v1proxy/RedTower/docs/booklets/README.md

# The assembly booklets

<!-- generated by greenhouse/booklet/make_gallery.py: do not edit -->

Every page of the five assembly booklets, 121 pages in build order. Click a page to read it full size in its booklet's page-by-page view; each booklet's PDF is the one to print.

| | booklet | what it builds | pages |
|---|---|---|---|
| 1 | [Frame Rev A](#1--frame-rev-a) | The cabinet: 4040 extrusion, the trays, the base pan and the drains. | 26 pages, 21 steps |
| 2 | [Gantry Rev E](#2--gantry-rev-e) | The X/Z gantry on the bench, its wiring, then into the cabinet with the arm. | 33 pages, 27 steps |
| 3 | [Enclosure Rev A](#3--enclosure-rev-a) | Polycarbonate panels, the fans and the four doors, on the finished cabinet. | 26 pages, 18 steps |
| 4 | [Harvest Rev B](#4--harvest-rev-b) | Where the cuts go: the dead-leaf tray in the base and the feeder on the right panel. | 18 pages, 11 steps |
| 5 | [Herb Snip Rev A](#5--herb-snip-rev-a) | The arm's printed cut-and-hold tool: print it, build it, put it on the arm. | 18 pages, 12 steps |

## 1 · Frame Rev A

The cabinet: 4040 extrusion, the trays, the base pan and the drains. 26 pages, 21 steps.

[Page by page](frame.md) · [PDF](../../greenhouse/frame/Maag_Frame_Assembly_Instructions_RevA.pdf) · [Guide](../../greenhouse/frame/FRAME_ASSEMBLY.md)

<table>
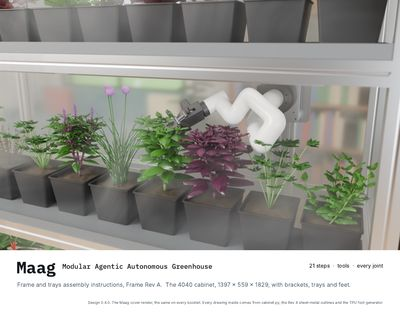
[picture p27: docs/booklets/frame/t01.jpg]
Frame Rev A, page 1: Cover
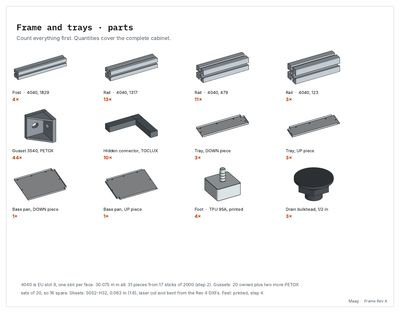
[picture p28: docs/booklets/frame/t02.jpg]
Frame Rev A, page 2: Frame and trays · parts
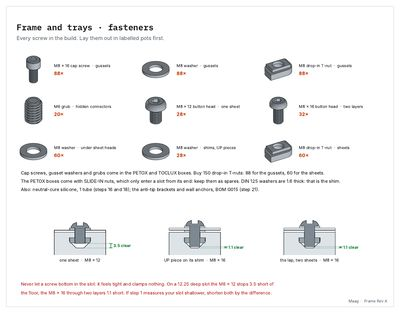
[picture p29: docs/booklets/frame/t03.jpg]
Frame Rev A, page 3: Frame and trays · fasteners
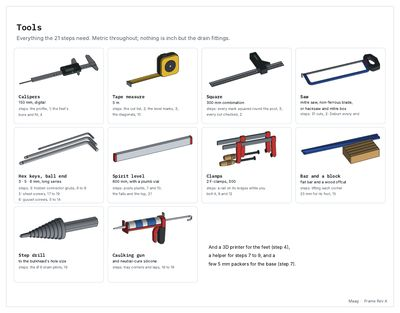
[picture p30: docs/booklets/frame/t04.jpg]
Frame Rev A, page 4: Tools
<tr><td align="center" valign="top"><br><sub>1 · Cover</sub></td><td align="center" valign="top"><br><sub>2 · Frame and trays · parts</sub></td><td align="center" valign="top"><br><sub>3 · Frame and trays · fasteners</sub></td><td align="center" valign="top"><br><sub>4 · Tools</sub></td></tr>
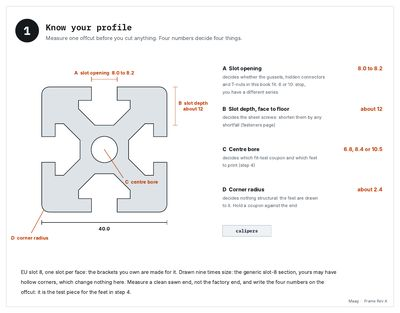
[picture p31: docs/booklets/frame/t06.jpg]
Frame Rev A, page 6: Know your profile
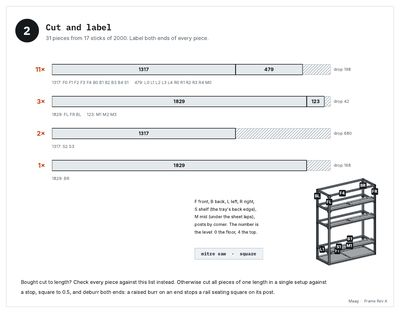
[picture p32: docs/booklets/frame/t07.jpg]
Frame Rev A, page 7: Cut and label
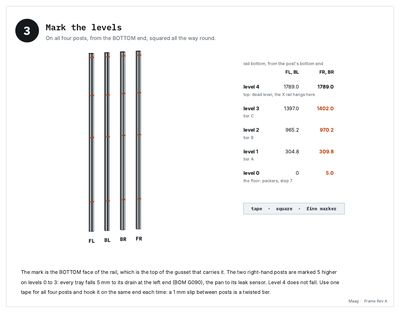
[picture p33: docs/booklets/frame/t08.jpg]
Frame Rev A, page 8: Mark the levels
<tr><td align="center" valign="top"><a href="frame.md#5--every-joint-and-what-holds-it">Frame Rev A, page 5: Every joint, and what holds it</a><br><sub>5 · Every joint, and what holds it</sub></td><td align="center" valign="top"><br><sub>6 · step 1: Know your profile</sub></td><td align="center" valign="top"><br><sub>7 · step 2: Cut and label</sub></td><td align="center" valign="top"><br><sub>8 · step 3: Mark the levels</sub></td></tr>
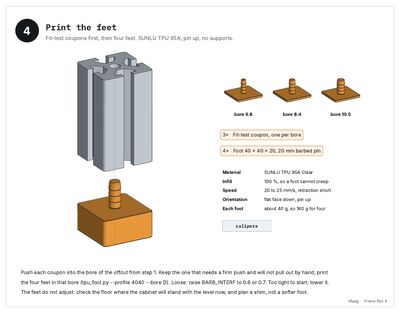
[picture p34: docs/booklets/frame/t09.jpg]
Frame Rev A, page 9: Print the feet
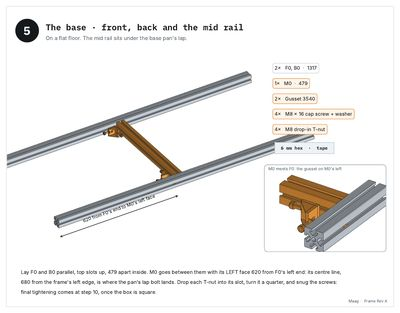
[picture p35: docs/booklets/frame/t10.jpg]
Frame Rev A, page 10: The base · front, back and the mid rail
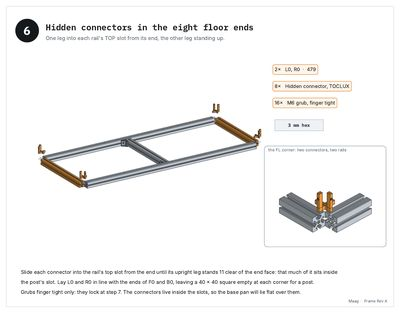
[picture p36: docs/booklets/frame/t11.jpg]
Frame Rev A, page 11: Hidden connectors in the eight floor ends
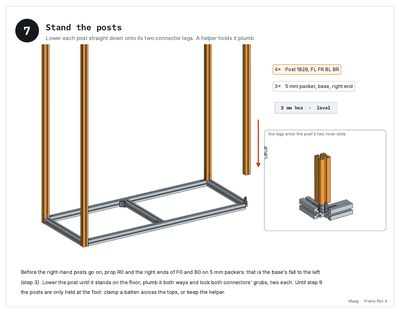
[picture p37: docs/booklets/frame/t12.jpg]
Frame Rev A, page 12: Stand the posts
<tr><td align="center" valign="top"><br><sub>9 · step 4: Print the feet</sub></td><td align="center" valign="top"><br><sub>10 · step 5: The base · front, back and the mid rail</sub></td><td align="center" valign="top"><br><sub>11 · step 6: Hidden connectors in the eight floor ends</sub></td><td align="center" valign="top"><br><sub>12 · step 7: Stand the posts</sub></td></tr>
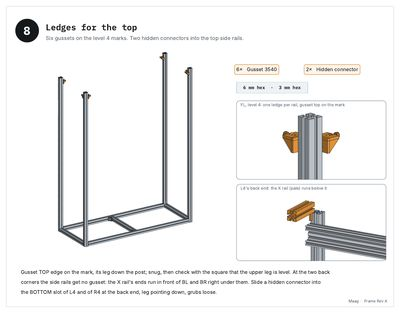
[picture p38: docs/booklets/frame/t13.jpg]
Frame Rev A, page 13: Ledges for the top
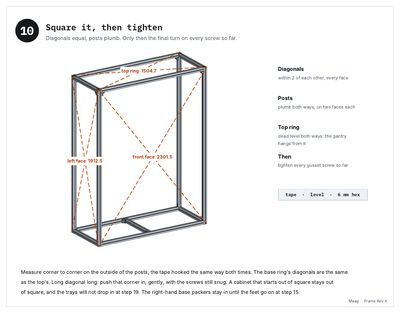
[picture p39: docs/booklets/frame/t15.jpg]
Frame Rev A, page 15: Square it, then tighten
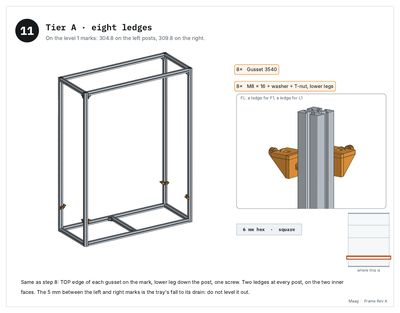
[picture p40: docs/booklets/frame/t16.jpg]
Frame Rev A, page 16: Tier A · eight ledges
<tr><td align="center" valign="top"><br><sub>13 · step 8: Ledges for the top</sub></td><td align="center" valign="top"><a href="frame.md#14--step-9--the-top-ring">Frame Rev A, page 14: The top ring</a><br><sub>14 · step 9: The top ring</sub></td><td align="center" valign="top"><br><sub>15 · step 10: Square it, then tighten</sub></td><td align="center" valign="top"><br><sub>16 · step 11: Tier A · eight ledges</sub></td></tr>
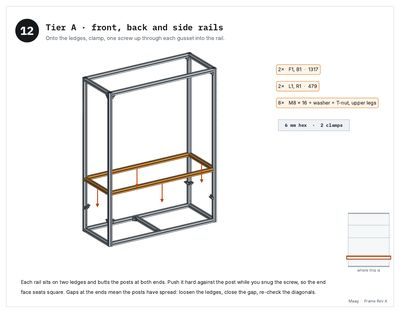
[picture p41: docs/booklets/frame/t17.jpg]
Frame Rev A, page 17: Tier A · front, back and side rails
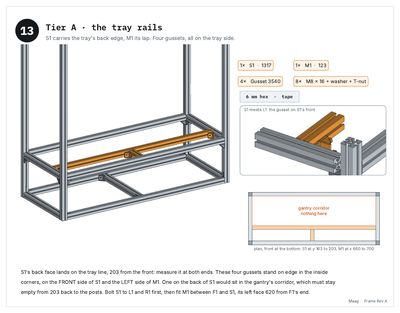
[picture p42: docs/booklets/frame/t18.jpg]
Frame Rev A, page 18: Tier A · the tray rails
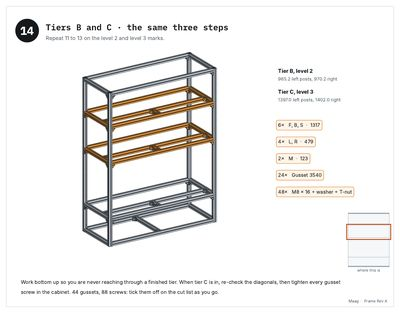
[picture p43: docs/booklets/frame/t19.jpg]
Frame Rev A, page 19: Tiers B and C · the same three steps
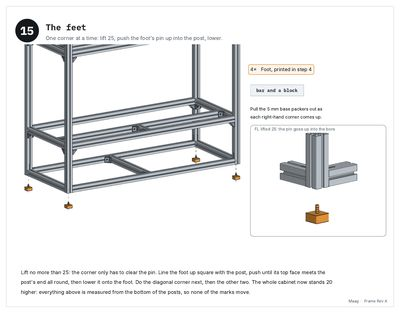
[picture p44: docs/booklets/frame/t20.jpg]
Frame Rev A, page 20: The feet
<tr><td align="center" valign="top"><br><sub>17 · step 12: Tier A · front, back and side rails</sub></td><td align="center" valign="top"><br><sub>18 · step 13: Tier A · the tray rails</sub></td><td align="center" valign="top"><br><sub>19 · step 14: Tiers B and C · the same three steps</sub></td><td align="center" valign="top"><br><sub>20 · step 15: The feet</sub></td></tr>
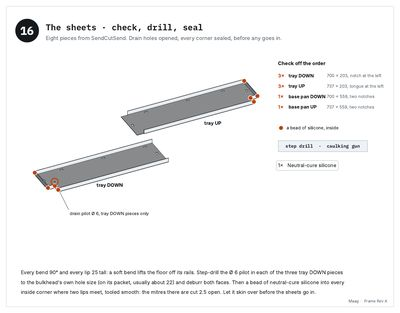
[picture p45: docs/booklets/frame/t21.jpg]
Frame Rev A, page 21: The sheets · check, drill, seal
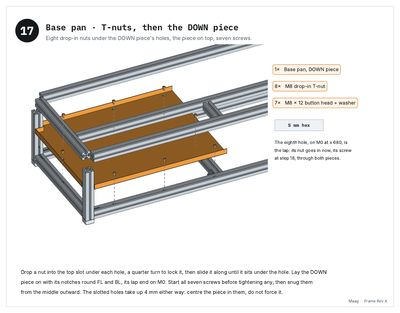
[picture p46: docs/booklets/frame/t22.jpg]
Frame Rev A, page 22: Base pan · T-nuts, then the DOWN piece
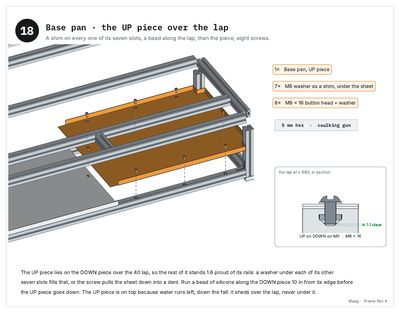
[picture p47: docs/booklets/frame/t23.jpg]
Frame Rev A, page 23: Base pan · the UP piece over the lap
<tr><td align="center" valign="top"><br><sub>21 · step 16: The sheets · check, drill, seal</sub></td><td align="center" valign="top"><br><sub>22 · step 17: Base pan · T-nuts, then the DOWN piece</sub></td><td align="center" valign="top"><br><sub>23 · step 18: Base pan · the UP piece over the lap</sub></td><td align="center" valign="top"><a href="frame.md#24--step-19--trays--the-same-three-times">Frame Rev A, page 24: Trays · the same, three times</a><br><sub>24 · step 19: Trays · the same, three times</sub></td></tr>
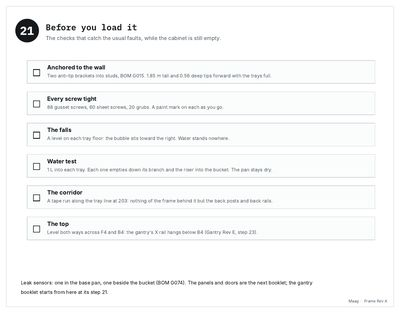
[picture p48: docs/booklets/frame/t26.jpg]
Frame Rev A, page 26: Before you load it
<tr><td align="center" valign="top"><a href="frame.md#25--step-20--drains--one-riser-on-the-fl-post">Frame Rev A, page 25: Drains · one riser on the FL post</a><br><sub>25 · step 20: Drains · one riser on the FL post</sub></td><td align="center" valign="top"><br><sub>26 · step 21: Before you load it</sub></td></tr>
</table>

## 2 · Gantry Rev E

The X/Z gantry on the bench, its wiring, then into the cabinet with the arm. 33 pages, 27 steps.

[Page by page](gantry.md) · [PDF](../../greenhouse/gantry/Gantry_Assembly_Instructions_RevE.pdf) · [Guide](../../greenhouse/gantry/GANTRY_ASSEMBLY.md)

<table>
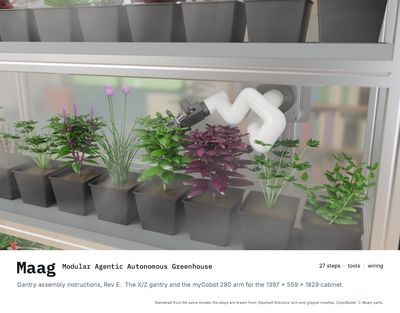
[picture p49: docs/booklets/gantry/t01.jpg]
Gantry Rev E, page 1: Cover
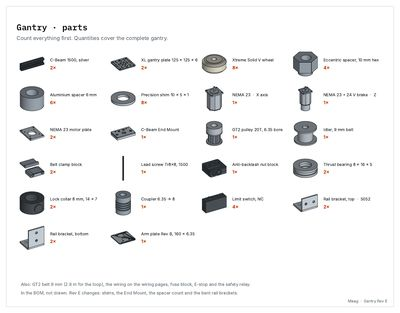
[picture p50: docs/booklets/gantry/t02.jpg]
Gantry Rev E, page 2: Gantry · parts
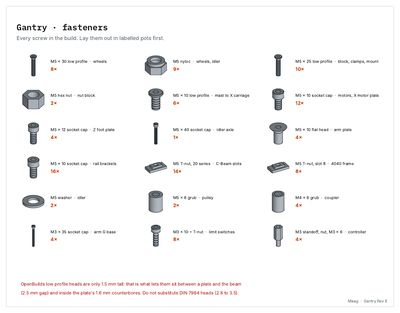
[picture p51: docs/booklets/gantry/t03.jpg]
Gantry Rev E, page 3: Gantry · fasteners
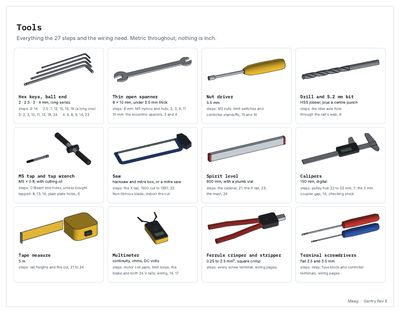
[picture p52: docs/booklets/gantry/t04.jpg]
Gantry Rev E, page 4: Tools
<tr><td align="center" valign="top"><br><sub>1 · Cover</sub></td><td align="center" valign="top"><br><sub>2 · Gantry · parts</sub></td><td align="center" valign="top"><br><sub>3 · Gantry · fasteners</sub></td><td align="center" valign="top"><br><sub>4 · Tools</sub></td></tr>
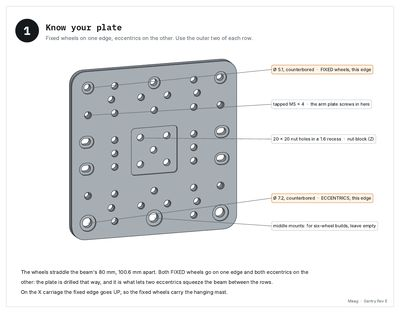
[picture p53: docs/booklets/gantry/t05.jpg]
Gantry Rev E, page 5: Know your plate
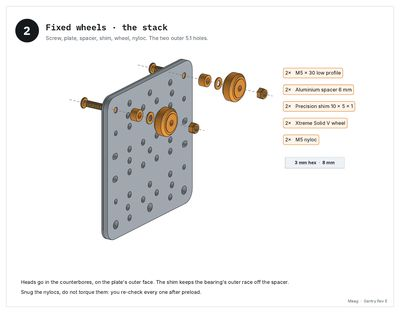
[picture p54: docs/booklets/gantry/t06.jpg]
Gantry Rev E, page 6: Fixed wheels · the stack
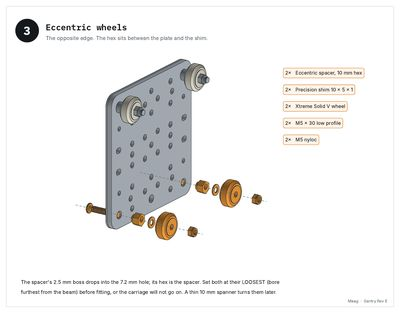
[picture p55: docs/booklets/gantry/t07.jpg]
Gantry Rev E, page 7: Eccentric wheels
<tr><td align="center" valign="top"><br><sub>5 · step 1: Know your plate</sub></td><td align="center" valign="top"><br><sub>6 · step 2: Fixed wheels · the stack</sub></td><td align="center" valign="top"><br><sub>7 · step 3: Eccentric wheels</sub></td><td align="center" valign="top"><a href="gantry.md#8--step-4--onto-the-rail-then-set-the-preload">Gantry Rev E, page 8: Onto the rail, then set the preload</a><br><sub>8 · step 4: Onto the rail, then set the preload</sub></td></tr>
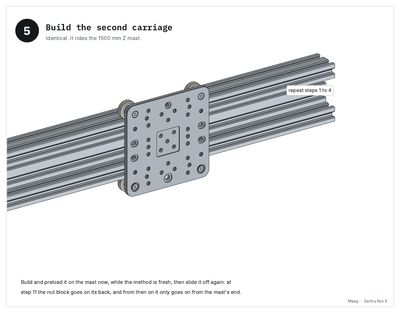
[picture p56: docs/booklets/gantry/t09.jpg]
Gantry Rev E, page 9: Build the second carriage
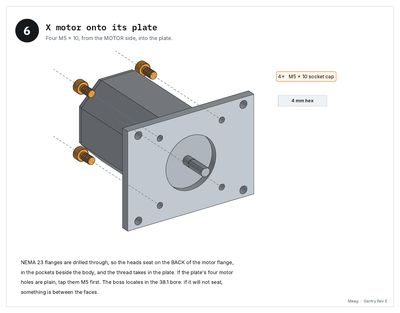
[picture p57: docs/booklets/gantry/t10.jpg]
Gantry Rev E, page 10: X motor onto its plate
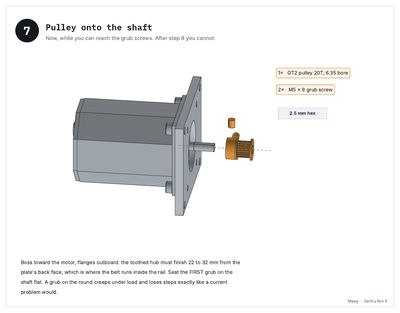
[picture p58: docs/booklets/gantry/t11.jpg]
Gantry Rev E, page 11: Pulley onto the shaft
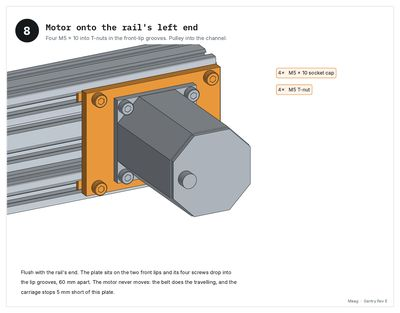
[picture p59: docs/booklets/gantry/t12.jpg]
Gantry Rev E, page 12: Motor onto the rail's left end
<tr><td align="center" valign="top"><br><sub>9 · step 5: Build the second carriage</sub></td><td align="center" valign="top"><br><sub>10 · step 6: X motor onto its plate</sub></td><td align="center" valign="top"><br><sub>11 · step 7: Pulley onto the shaft</sub></td><td align="center" valign="top"><br><sub>12 · step 8: Motor onto the rail's left end</sub></td></tr>
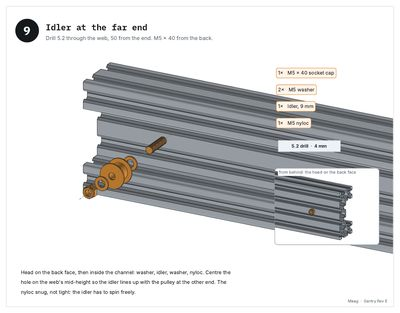
[picture p60: docs/booklets/gantry/t13.jpg]
Gantry Rev E, page 13: Idler at the far end
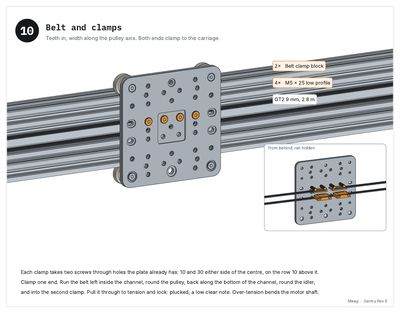
[picture p61: docs/booklets/gantry/t14.jpg]
Gantry Rev E, page 14: Belt and clamps
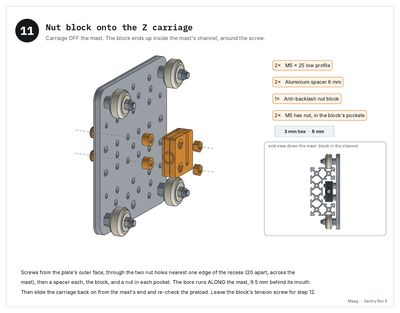
[picture p62: docs/booklets/gantry/t15.jpg]
Gantry Rev E, page 15: Nut block onto the Z carriage
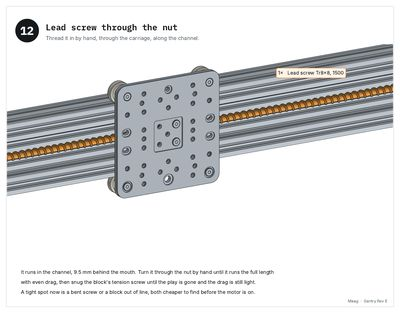
[picture p63: docs/booklets/gantry/t16.jpg]
Gantry Rev E, page 16: Lead screw through the nut
<tr><td align="center" valign="top"><br><sub>13 · step 9: Idler at the far end</sub></td><td align="center" valign="top"><br><sub>14 · step 10: Belt and clamps</sub></td><td align="center" valign="top"><br><sub>15 · step 11: Nut block onto the Z carriage</sub></td><td align="center" valign="top"><br><sub>16 · step 12: Lead screw through the nut</sub></td></tr>
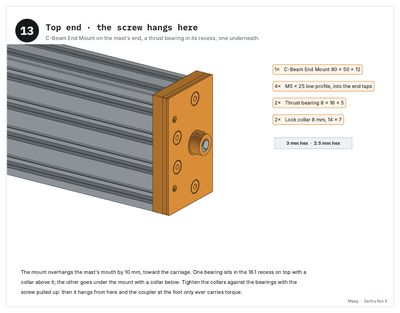
[picture p64: docs/booklets/gantry/t17.jpg]
Gantry Rev E, page 17: Top end · the screw hangs here
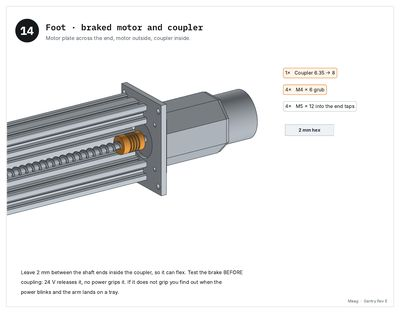
[picture p65: docs/booklets/gantry/t18.jpg]
Gantry Rev E, page 18: Foot · braked motor and coupler
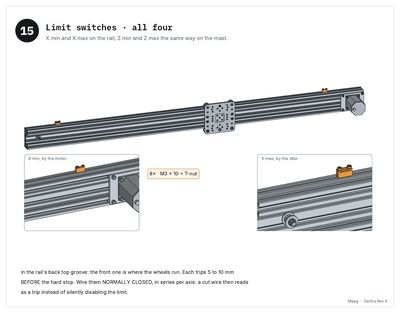
[picture p66: docs/booklets/gantry/t19.jpg]
Gantry Rev E, page 19: Limit switches · all four
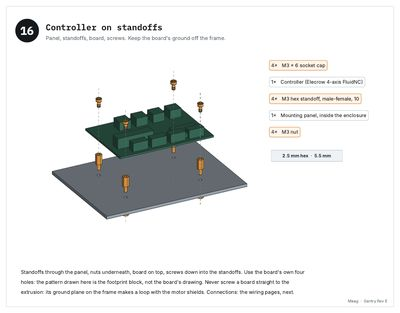
[picture p67: docs/booklets/gantry/t20.jpg]
Gantry Rev E, page 20: Controller on standoffs
<tr><td align="center" valign="top"><br><sub>17 · step 13: Top end · the screw hangs here</sub></td><td align="center" valign="top"><br><sub>18 · step 14: Foot · braked motor and coupler</sub></td><td align="center" valign="top"><br><sub>19 · step 15: Limit switches · all four</sub></td><td align="center" valign="top"><br><sub>20 · step 16: Controller on standoffs</sub></td></tr>
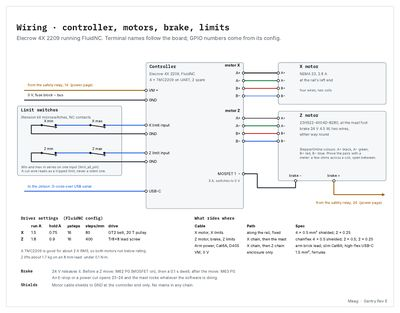
[picture p68: docs/booklets/gantry/t22.jpg]
Gantry Rev E, page 22: Wiring · controller, motors, brake, limits
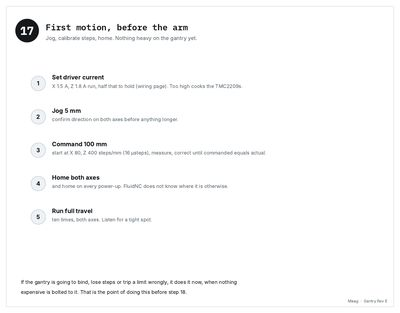
[picture p69: docs/booklets/gantry/t23.jpg]
Gantry Rev E, page 23: First motion, before the arm
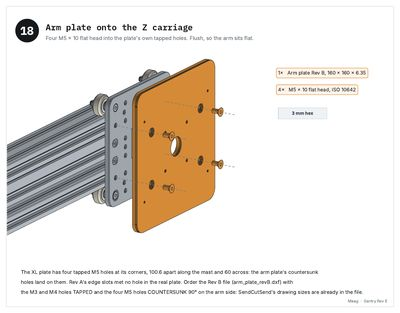
[picture p70: docs/booklets/gantry/t24.jpg]
Gantry Rev E, page 24: Arm plate onto the Z carriage
<tr><td align="center" valign="top"><a href="gantry.md#21--wiring--power-and-the-safety-relay">Gantry Rev E, page 21: Wiring · power and the safety relay</a><br><sub>21 · Wiring · power and the safety relay</sub></td><td align="center" valign="top"><br><sub>22 · Wiring · controller, motors, brake, limits</sub></td><td align="center" valign="top"><br><sub>23 · step 17: First motion, before the arm</sub></td><td align="center" valign="top"><br><sub>24 · step 18: Arm plate onto the Z carriage</sub></td></tr>
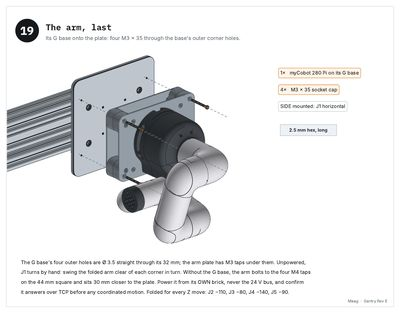
[picture p71: docs/booklets/gantry/t25.jpg]
Gantry Rev E, page 25: The arm, last
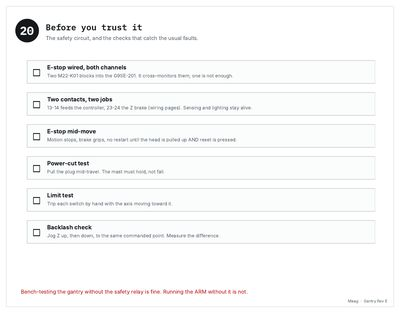
[picture p72: docs/booklets/gantry/t26.jpg]
Gantry Rev E, page 26: Before you trust it
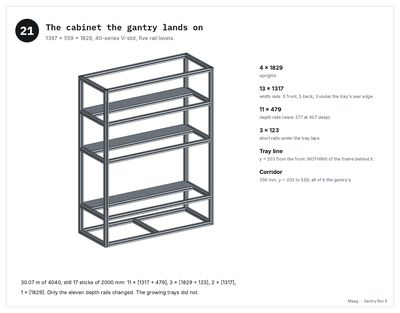
[picture p73: docs/booklets/gantry/t27.jpg]
Gantry Rev E, page 27: The cabinet the gantry lands on
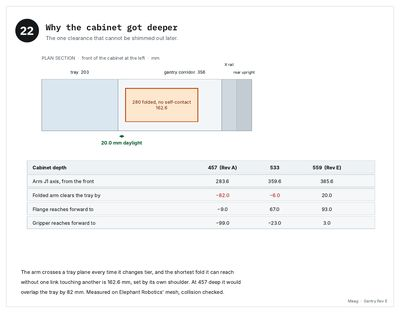
[picture p74: docs/booklets/gantry/t28.jpg]
Gantry Rev E, page 28: Why the cabinet got deeper
<tr><td align="center" valign="top"><br><sub>25 · step 19: The arm, last</sub></td><td align="center" valign="top"><br><sub>26 · step 20: Before you trust it</sub></td><td align="center" valign="top"><br><sub>27 · step 21: The cabinet the gantry lands on</sub></td><td align="center" valign="top"><br><sub>28 · step 22: Why the cabinet got deeper</sub></td></tr>
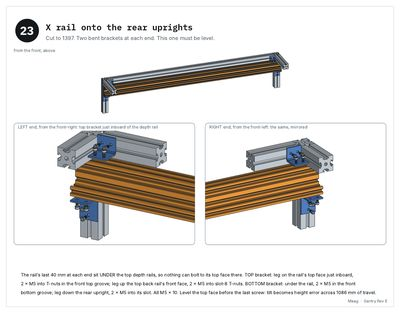
[picture p75: docs/booklets/gantry/t29.jpg]
Gantry Rev E, page 29: X rail onto the rear uprights
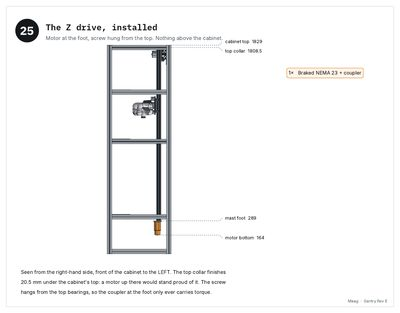
[picture p76: docs/booklets/gantry/t31.jpg]
Gantry Rev E, page 31: The Z drive, installed
<tr><td align="center" valign="top"><br><sub>29 · step 23: X rail onto the rear uprights</sub></td><td align="center" valign="top"><a href="gantry.md#30--step-24--hang-the-z-mast">Gantry Rev E, page 30: Hang the Z mast</a><br><sub>30 · step 24: Hang the Z mast</sub></td><td align="center" valign="top"><br><sub>31 · step 25: The Z drive, installed</sub></td><td align="center" valign="top"><a href="gantry.md#32--step-26--z-carriage-arm-plate-arm">Gantry Rev E, page 32: Z carriage, arm plate, arm</a><br><sub>32 · step 26: Z carriage, arm plate, arm</sub></td></tr>
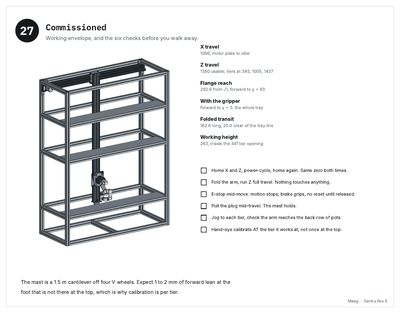
[picture p77: docs/booklets/gantry/t33.jpg]
Gantry Rev E, page 33: Commissioned
<tr><td align="center" valign="top"><br><sub>33 · step 27: Commissioned</sub></td></tr>
</table>

## 3 · Enclosure Rev A

Polycarbonate panels, the fans and the four doors, on the finished cabinet. 26 pages, 18 steps.

[Page by page](enclosure.md) · [PDF](../../greenhouse/enclosure/Maag_Enclosure_Assembly_Instructions_RevA.pdf) · [Guide](../../greenhouse/enclosure/ENCLOSURE.md)

<table>
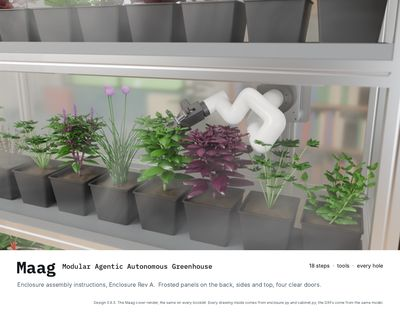
[picture p78: docs/booklets/enclosure/t01.jpg]
Enclosure Rev A, page 1: Cover
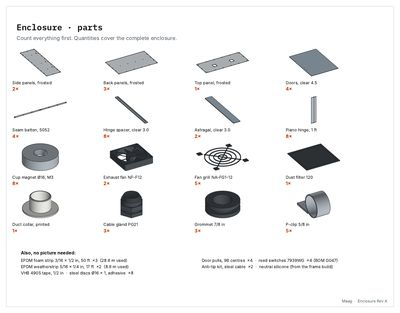
[picture p79: docs/booklets/enclosure/t03.jpg]
Enclosure Rev A, page 3: Enclosure · parts
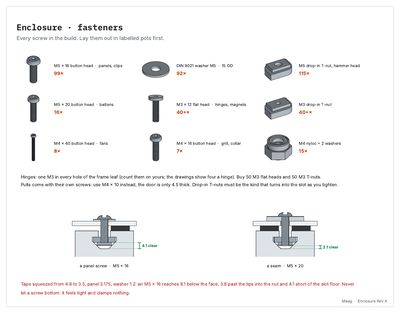
[picture p80: docs/booklets/enclosure/t04.jpg]
Enclosure Rev A, page 4: Enclosure · fasteners
<tr><td align="center" valign="top"><br><sub>1 · Cover</sub></td><td align="center" valign="top"><a href="enclosure.md#2--the-enclosure--what-goes-where">Enclosure Rev A, page 2: The enclosure · what goes where</a><br><sub>2 · The enclosure · what goes where</sub></td><td align="center" valign="top"><br><sub>3 · Enclosure · parts</sub></td><td align="center" valign="top"><br><sub>4 · Enclosure · fasteners</sub></td></tr>
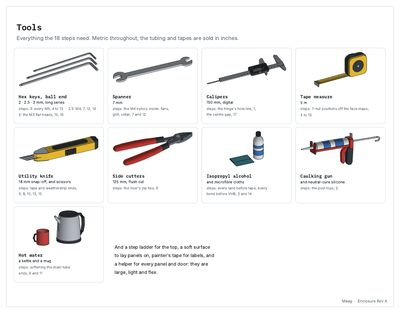
[picture p81: docs/booklets/enclosure/t05.jpg]
Enclosure Rev A, page 5: Tools
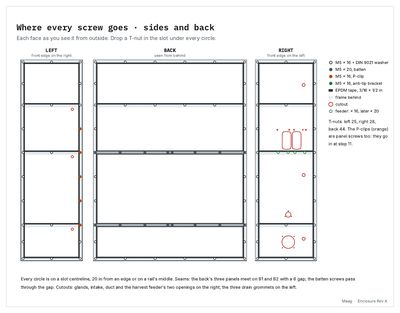
[picture p82: docs/booklets/enclosure/t06.jpg]
Enclosure Rev A, page 6: Where every screw goes · sides and back
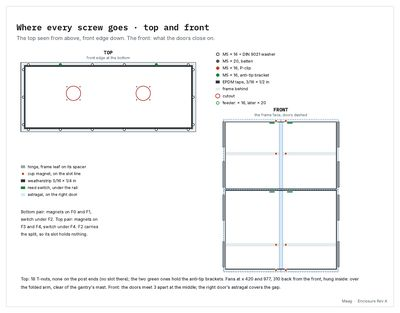
[picture p83: docs/booklets/enclosure/t07.jpg]
Enclosure Rev A, page 7: Where every screw goes · top and front
<tr><td align="center" valign="top"><br><sub>5 · Tools</sub></td><td align="center" valign="top"><br><sub>6 · Where every screw goes · sides and back</sub></td><td align="center" valign="top"><br><sub>7 · Where every screw goes · top and front</sub></td><td align="center" valign="top"><a href="enclosure.md#8--how-it-closes--the-door-in-section">Enclosure Rev A, page 8: How it closes · the door, in section</a><br><sub>8 · How it closes · the door, in section</sub></td></tr>
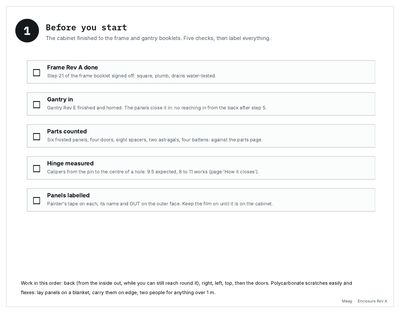
[picture p84: docs/booklets/enclosure/t09.jpg]
Enclosure Rev A, page 9: Before you start
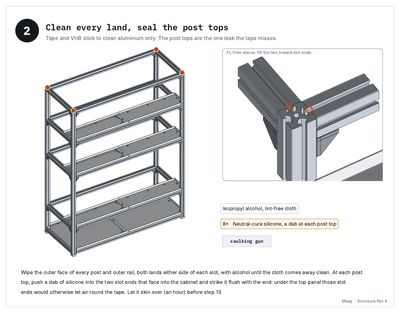
[picture p85: docs/booklets/enclosure/t10.jpg]
Enclosure Rev A, page 10: Clean every land, seal the post tops
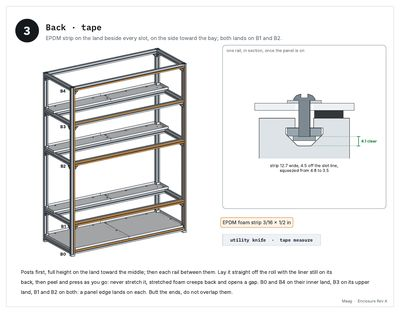
[picture p86: docs/booklets/enclosure/t11.jpg]
Enclosure Rev A, page 11: Back · tape
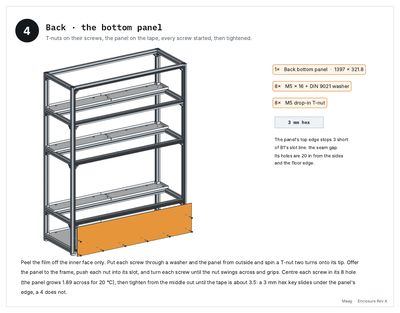
[picture p87: docs/booklets/enclosure/t12.jpg]
Enclosure Rev A, page 12: Back · the bottom panel
<tr><td align="center" valign="top"><br><sub>9 · step 1: Before you start</sub></td><td align="center" valign="top"><br><sub>10 · step 2: Clean every land, seal the post tops</sub></td><td align="center" valign="top"><br><sub>11 · step 3: Back · tape</sub></td><td align="center" valign="top"><br><sub>12 · step 4: Back · the bottom panel</sub></td></tr>
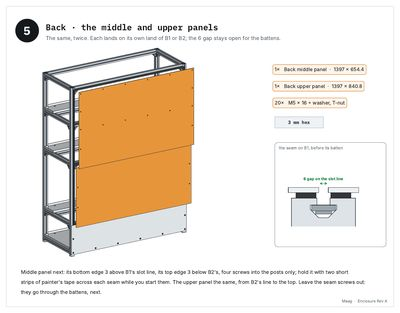
[picture p88: docs/booklets/enclosure/t13.jpg]
Enclosure Rev A, page 13: Back · the middle and upper panels
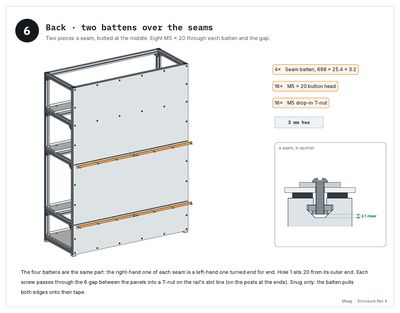
[picture p89: docs/booklets/enclosure/t14.jpg]
Enclosure Rev A, page 14: Back · two battens over the seams
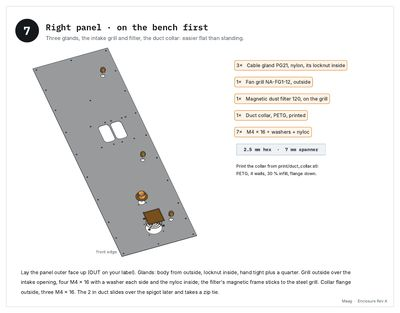
[picture p90: docs/booklets/enclosure/t15.jpg]
Enclosure Rev A, page 15: Right panel · on the bench first
<tr><td align="center" valign="top"><br><sub>13 · step 5: Back · the middle and upper panels</sub></td><td align="center" valign="top"><br><sub>14 · step 6: Back · two battens over the seams</sub></td><td align="center" valign="top"><br><sub>15 · step 7: Right panel · on the bench first</sub></td><td align="center" valign="top"><a href="enclosure.md#16--step-8--right-panel--tape-then-the-panel">Enclosure Rev A, page 16: Right panel · tape, then the panel</a><br><sub>16 · step 8: Right panel · tape, then the panel</sub></td></tr>
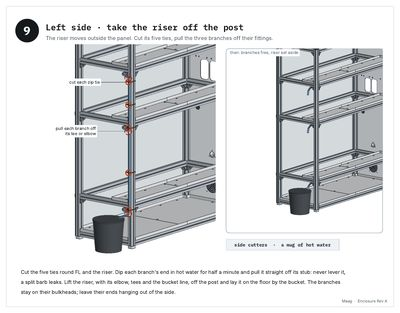
[picture p91: docs/booklets/enclosure/t17.jpg]
Enclosure Rev A, page 17: Left side · take the riser off the post
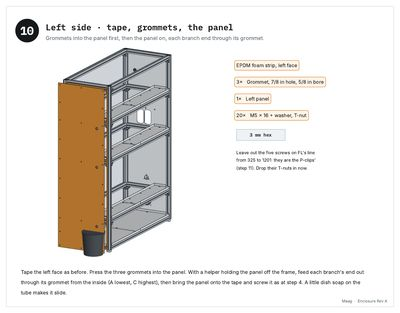
[picture p92: docs/booklets/enclosure/t18.jpg]
Enclosure Rev A, page 18: Left side · tape, grommets, the panel
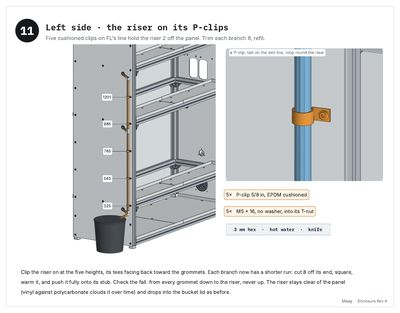
[picture p93: docs/booklets/enclosure/t19.jpg]
Enclosure Rev A, page 19: Left side · the riser on its P-clips
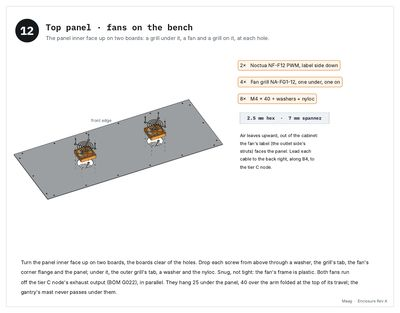
[picture p94: docs/booklets/enclosure/t20.jpg]
Enclosure Rev A, page 20: Top panel · fans on the bench
<tr><td align="center" valign="top"><br><sub>17 · step 9: Left side · take the riser off the post</sub></td><td align="center" valign="top"><br><sub>18 · step 10: Left side · tape, grommets, the panel</sub></td><td align="center" valign="top"><br><sub>19 · step 11: Left side · the riser on its P-clips</sub></td><td align="center" valign="top"><br><sub>20 · step 12: Top panel · fans on the bench</sub></td></tr>
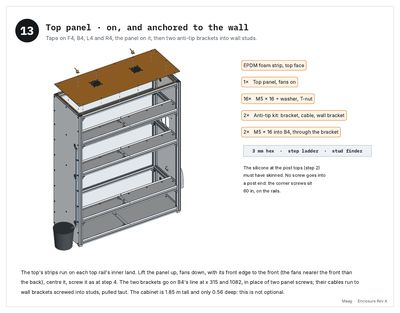
[picture p95: docs/booklets/enclosure/t21.jpg]
Enclosure Rev A, page 21: Top panel · on, and anchored to the wall
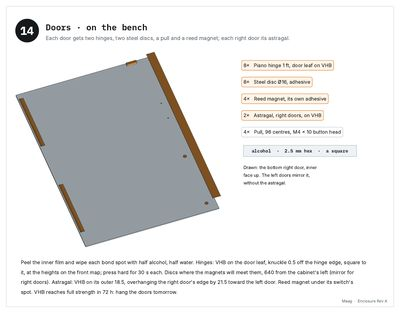
[picture p96: docs/booklets/enclosure/t22.jpg]
Enclosure Rev A, page 22: Doors · on the bench
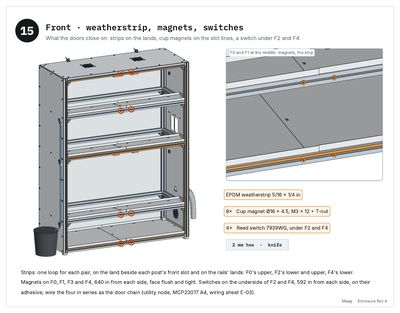
[picture p97: docs/booklets/enclosure/t23.jpg]
Enclosure Rev A, page 23: Front · weatherstrip, magnets, switches
<tr><td align="center" valign="top"><br><sub>21 · step 13: Top panel · on, and anchored to the wall</sub></td><td align="center" valign="top"><br><sub>22 · step 14: Doors · on the bench</sub></td><td align="center" valign="top"><br><sub>23 · step 15: Front · weatherstrip, magnets, switches</sub></td><td align="center" valign="top"><a href="enclosure.md#24--step-16--front--hang-the-doors">Enclosure Rev A, page 24: Front · hang the doors</a><br><sub>24 · step 16: Front · hang the doors</sub></td></tr>
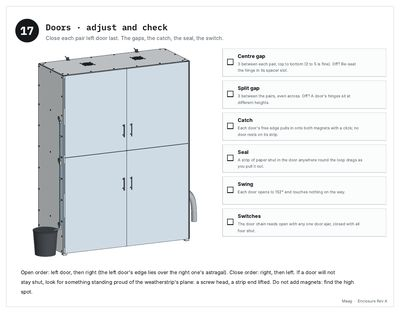
[picture p98: docs/booklets/enclosure/t25.jpg]
Enclosure Rev A, page 25: Doors · adjust and check
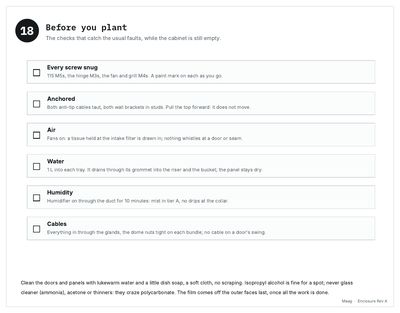
[picture p99: docs/booklets/enclosure/t26.jpg]
Enclosure Rev A, page 26: Before you plant
<tr><td align="center" valign="top"><br><sub>25 · step 17: Doors · adjust and check</sub></td><td align="center" valign="top"><br><sub>26 · step 18: Before you plant</sub></td></tr>
</table>

## 4 · Harvest Rev B

Where the cuts go: the dead-leaf tray in the base and the feeder on the right panel. 18 pages, 11 steps.

[Page by page](harvest.md) · [PDF](../../greenhouse/harvest/Maag_Harvest_Assembly_Instructions_RevB.pdf) · [Guide](../../greenhouse/harvest/HARVEST.md)

<table>
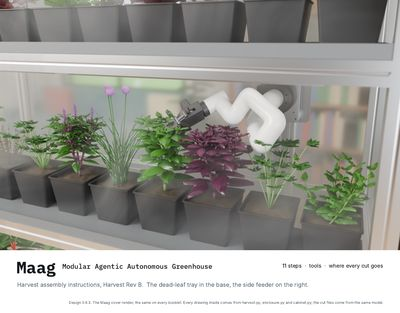
[picture p100: docs/booklets/harvest/t01.jpg]
Harvest Rev B, page 1: Cover
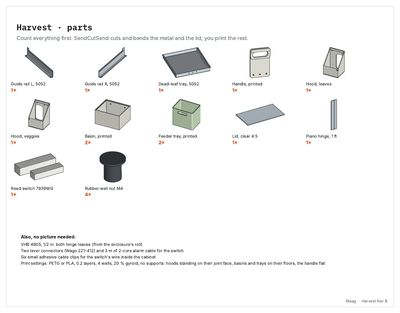
[picture p101: docs/booklets/harvest/t04.jpg]
Harvest Rev B, page 4: Harvest · parts
<tr><td align="center" valign="top"><br><sub>1 · Cover</sub></td><td align="center" valign="top"><a href="harvest.md#2--harvest--where-every-cut-goes">Harvest Rev B, page 2: Harvest · where every cut goes</a><br><sub>2 · Harvest · where every cut goes</sub></td><td align="center" valign="top"><a href="harvest.md#3--how-the-arm-drops">Harvest Rev B, page 3: How the arm drops</a><br><sub>3 · How the arm drops</sub></td><td align="center" valign="top"><br><sub>4 · Harvest · parts</sub></td></tr>
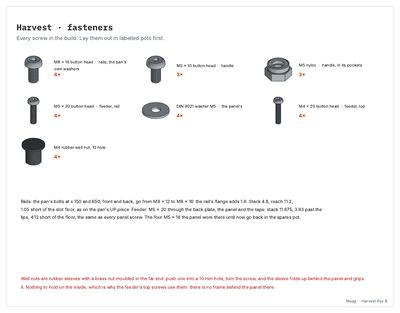
[picture p102: docs/booklets/harvest/t05.jpg]
Harvest Rev B, page 5: Harvest · fasteners
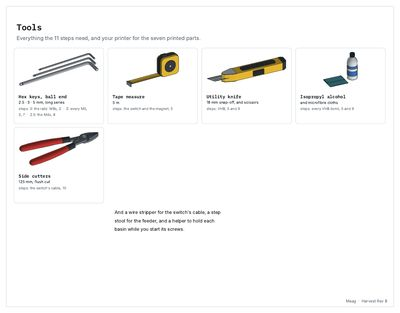
[picture p103: docs/booklets/harvest/t06.jpg]
Harvest Rev B, page 6: Tools
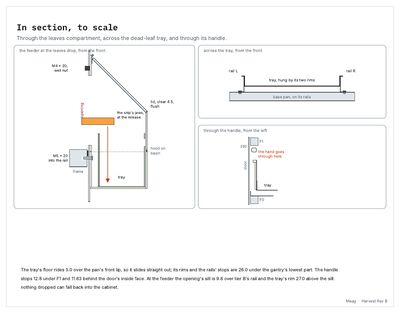
[picture p104: docs/booklets/harvest/t07.jpg]
Harvest Rev B, page 7: In section, to scale
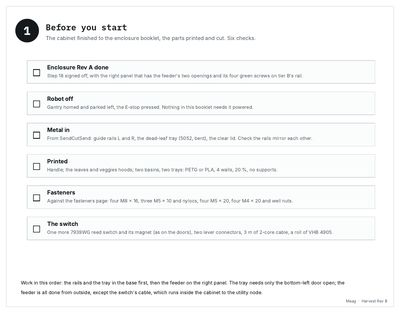
[picture p105: docs/booklets/harvest/t08.jpg]
Harvest Rev B, page 8: Before you start
<tr><td align="center" valign="top"><br><sub>5 · Harvest · fasteners</sub></td><td align="center" valign="top"><br><sub>6 · Tools</sub></td><td align="center" valign="top"><br><sub>7 · In section, to scale</sub></td><td align="center" valign="top"><br><sub>8 · step 1: Before you start</sub></td></tr>
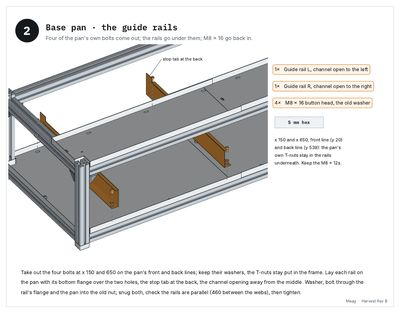
[picture p106: docs/booklets/harvest/t09.jpg]
Harvest Rev B, page 9: Base pan · the guide rails
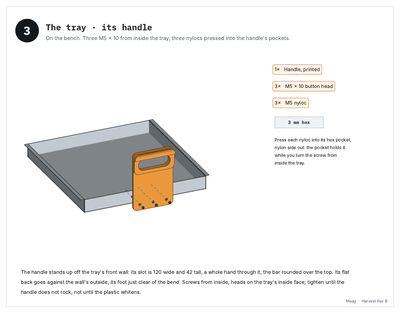
[picture p107: docs/booklets/harvest/t10.jpg]
Harvest Rev B, page 10: The tray · its handle
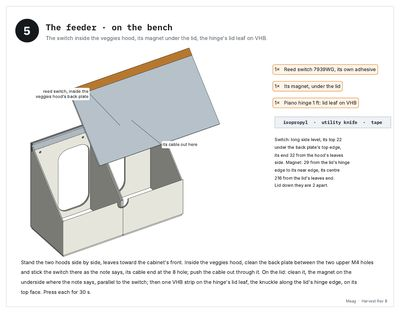
[picture p108: docs/booklets/harvest/t12.jpg]
Harvest Rev B, page 12: The feeder · on the bench
<tr><td align="center" valign="top"><br><sub>9 · step 2: Base pan · the guide rails</sub></td><td align="center" valign="top"><br><sub>10 · step 3: The tray · its handle</sub></td><td align="center" valign="top"><a href="harvest.md#11--step-4--the-tray--slide-it-in">Harvest Rev B, page 11: The tray · slide it in</a><br><sub>11 · step 4: The tray · slide it in</sub></td><td align="center" valign="top"><br><sub>12 · step 5: The feeder · on the bench</sub></td></tr>
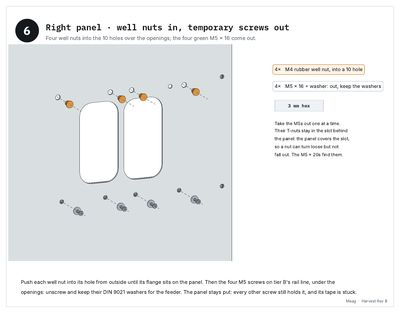
[picture p109: docs/booklets/harvest/t13.jpg]
Harvest Rev B, page 13: Right panel · well nuts in, temporary screws out
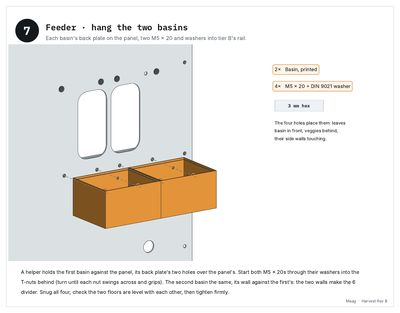
[picture p110: docs/booklets/harvest/t14.jpg]
Harvest Rev B, page 14: Feeder · hang the two basins
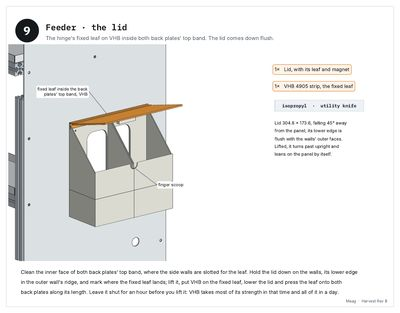
[picture p111: docs/booklets/harvest/t16.jpg]
Harvest Rev B, page 16: Feeder · the lid
<tr><td align="center" valign="top"><br><sub>13 · step 6: Right panel · well nuts in, temporary screws out</sub></td><td align="center" valign="top"><br><sub>14 · step 7: Feeder · hang the two basins</sub></td><td align="center" valign="top"><a href="harvest.md#15--step-8--feeder--the-two-hoods">Harvest Rev B, page 15: Feeder · the two hoods</a><br><sub>15 · step 8: Feeder · the two hoods</sub></td><td align="center" valign="top"><br><sub>16 · step 9: Feeder · the lid</sub></td></tr>
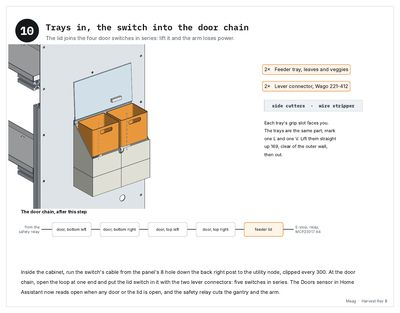
[picture p112: docs/booklets/harvest/t17.jpg]
Harvest Rev B, page 17: Trays in, the switch into the door chain
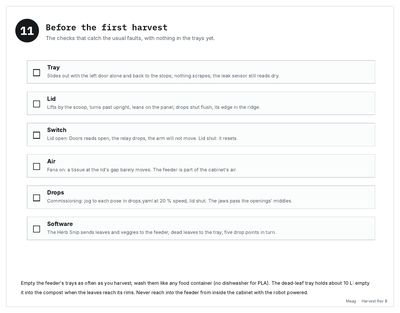
[picture p113: docs/booklets/harvest/t18.jpg]
Harvest Rev B, page 18: Before the first harvest
<tr><td align="center" valign="top"><br><sub>17 · step 10: Trays in, the switch into the door chain</sub></td><td align="center" valign="top"><br><sub>18 · step 11: Before the first harvest</sub></td></tr>
</table>

## 5 · Herb Snip Rev A

The arm's printed cut-and-hold tool: print it, build it, put it on the arm. 18 pages, 12 steps.

[Page by page](snip.md) · [PDF](../../greenhouse/snip/Maag_Herb_Snip_Assembly_Instructions_RevA.pdf) · [Guide](../../greenhouse/snip/HERB_SNIP.md)

<table>
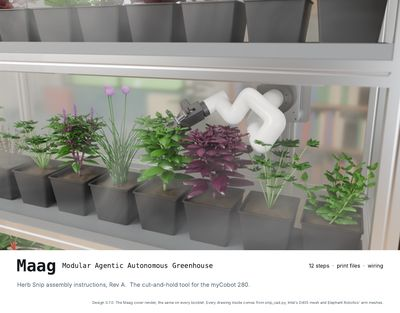
[picture p114: docs/booklets/snip/t01.jpg]
Herb Snip Rev A, page 1: Cover
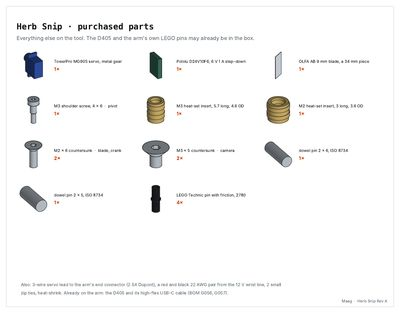
[picture p115: docs/booklets/snip/t04.jpg]
Herb Snip Rev A, page 4: Herb Snip · purchased parts
<tr><td align="center" valign="top"><br><sub>1 · Cover</sub></td><td align="center" valign="top"><a href="snip.md#2--how-the-herb-snip-works">Herb Snip Rev A, page 2: How the Herb Snip works</a><br><sub>2 · How the Herb Snip works</sub></td><td align="center" valign="top"><a href="snip.md#3--herb-snip--printed-parts">Herb Snip Rev A, page 3: Herb Snip · printed parts</a><br><sub>3 · Herb Snip · printed parts</sub></td><td align="center" valign="top"><br><sub>4 · Herb Snip · purchased parts</sub></td></tr>
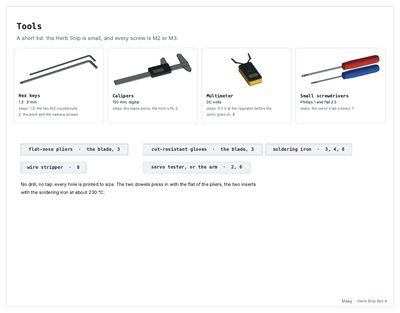
[picture p116: docs/booklets/snip/t05.jpg]
Herb Snip Rev A, page 5: Tools
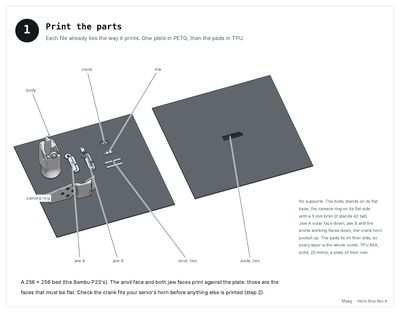
[picture p117: docs/booklets/snip/t06.jpg]
Herb Snip Rev A, page 6: Print the parts
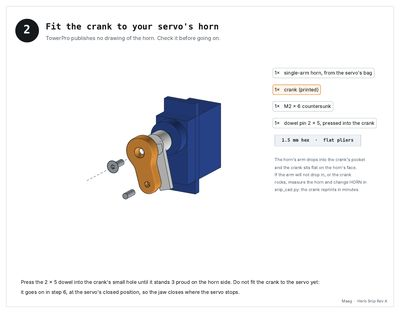
[picture p118: docs/booklets/snip/t07.jpg]
Herb Snip Rev A, page 7: Fit the crank to your servo's horn
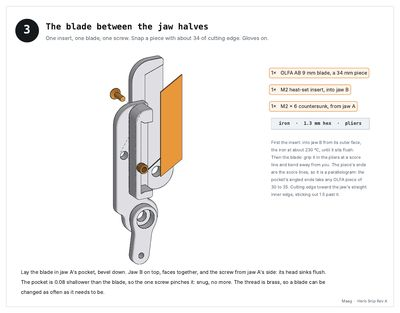
[picture p119: docs/booklets/snip/t08.jpg]
Herb Snip Rev A, page 8: The blade between the jaw halves
<tr><td align="center" valign="top"><br><sub>5 · Tools</sub></td><td align="center" valign="top"><br><sub>6 · step 1: Print the parts</sub></td><td align="center" valign="top"><br><sub>7 · step 2: Fit the crank to your servo's horn</sub></td><td align="center" valign="top"><br><sub>8 · step 3: The blade between the jaw halves</sub></td></tr>
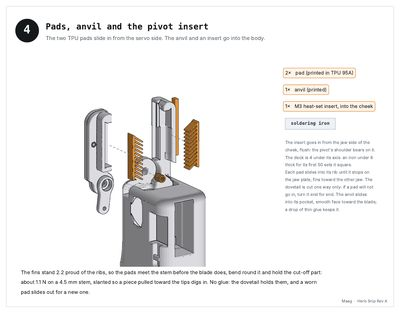
[picture p120: docs/booklets/snip/t09.jpg]
Herb Snip Rev A, page 9: Pads, anvil and the pivot insert
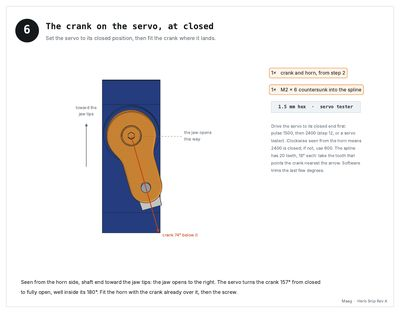
[picture p121: docs/booklets/snip/t11.jpg]
Herb Snip Rev A, page 11: The crank on the servo, at closed
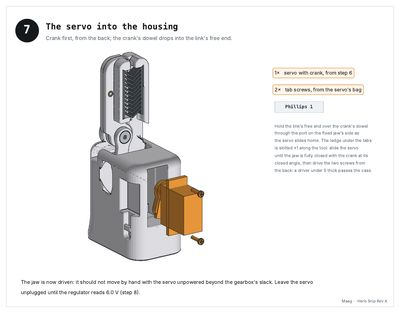
[picture p122: docs/booklets/snip/t12.jpg]
Herb Snip Rev A, page 12: The servo into the housing
<tr><td align="center" valign="top"><br><sub>9 · step 4: Pads, anvil and the pivot insert</sub></td><td align="center" valign="top"><a href="snip.md#10--step-5--the-jaw-on-its-pivot-and-the-link">Herb Snip Rev A, page 10: The jaw on its pivot, and the link</a><br><sub>10 · step 5: The jaw on its pivot, and the link</sub></td><td align="center" valign="top"><br><sub>11 · step 6: The crank on the servo, at closed</sub></td><td align="center" valign="top"><br><sub>12 · step 7: The servo into the housing</sub></td></tr>
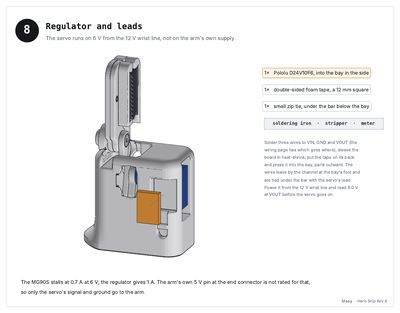
[picture p123: docs/booklets/snip/t13.jpg]
Herb Snip Rev A, page 13: Regulator and leads
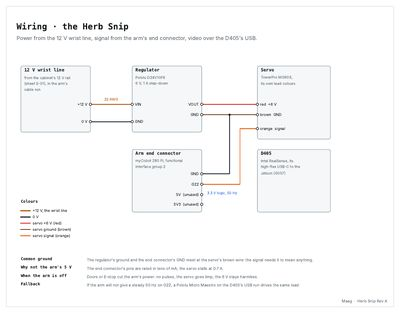
[picture p124: docs/booklets/snip/t14.jpg]
Herb Snip Rev A, page 14: Wiring · the Herb Snip
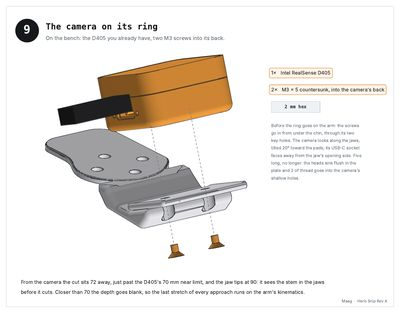
[picture p125: docs/booklets/snip/t15.jpg]
Herb Snip Rev A, page 15: The camera on its ring
<tr><td align="center" valign="top"><br><sub>13 · step 8: Regulator and leads</sub></td><td align="center" valign="top"><br><sub>14 · Wiring · the Herb Snip</sub></td><td align="center" valign="top"><br><sub>15 · step 9: The camera on its ring</sub></td><td align="center" valign="top"><a href="snip.md#16--step-10--onto-the-arm">Herb Snip Rev A, page 16: Onto the arm</a><br><sub>16 · step 10: Onto the arm</sub></td></tr>
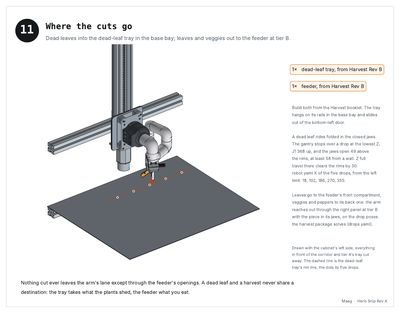
[picture p126: docs/booklets/snip/t17.jpg]
Herb Snip Rev A, page 17: Where the cuts go
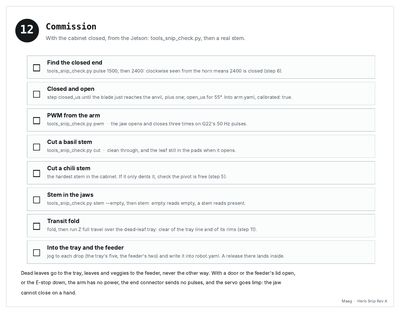
[picture p127: docs/booklets/snip/t18.jpg]
Herb Snip Rev A, page 18: Commission
<tr><td align="center" valign="top"><br><sub>17 · step 11: Where the cuts go</sub></td><td align="center" valign="top"><br><sub>18 · step 12: Commission</sub></td></tr>
</table>
