v1proxy/RedTower/docs/07-home-assistant.md

# Home Assistant: the interface and the controls

The whole greenhouse is driven from one view inside Home Assistant: the Greenhouse panel.
It shows every module, sensor and plant. Every button on it that moves something is a
request to the same safety governor an agent has to ask; the others set the authority, the
kill switch, which modules run, and the plant records. This chapter explains that control
system, then the interface section by section, then how to install it.

The Greenhouse panel at desktop width, on simulated data

*The panel at 1320 px, running on its own simulated data (`demo: true`). Click for the full page.*

**Download:** [the latest release](https://github.com/v1proxy/RedTower/releases/latest) carries
`maag-homeassistant-<version>.zip` (the card, both packages, the view, the broker files) and
`greenhouse-panel.js` on its own. To look before you build anything, [try it with simulated
data](#try-it-with-simulated-data): one file and a dashboard view, five minutes.

Contents

1. [The control system](#the-control-system)
2. [The interface, section by section](#the-interface-section-by-section)
3. [What every control sends](#what-every-control-sends)
4. [What the panel reads](#what-the-panel-reads)
5. [Install](#install)
6. [Check it](#check-it)
7. [Known issues and what is not verified](#known-issues-and-what-is-not-verified)
8. [Regenerating the pictures and the bundle](#regenerating-the-pictures-and-the-bundle)

---

## The control system

The control system: who asks, what the safety governor checks, the three verdicts, and who acts

Three machines, one broker:

| | runs | does |
|---|---|---|
| **Home Assistant** (a Yellow on the reference build) | the panel, two packages, the Mosquitto broker | shows everything, takes your requests, mirrors the ESPHome nodes to MQTT, turns approved commands into ESPHome actions, watches the agents |
| **Jetson Orin Nano Super** | the module stack in Docker: core, drivers, services, agents | decides. The safety governor is the only module that publishes an actuator command |
| **Four ESP32 nodes** (three tiers and a utility node) | ESPHome | measures, switches, and refuses on its own: the pump and valves are not on the API at all |

### One path to every actuator

Anything that wants something to move, you included, sends a request, and only the safety
governor (`greenhouse/jetson/gh/core/safety.py`) publishes under `greenhouse/actuator/`. Once the
broker's access list is installed, no driver, service or agent can publish there even if its
code tried; only the four core services and Home Assistant can.

- **You** ask on `greenhouse/safety/request/ui`. With the access list, only the interface may
  write that topic, so the governor knows a request is yours from the topic, never from what
  the message claims.
- **Services** (climate, irrigation, motion) and **agents** (the environment agent, the plant
  tender) ask on `greenhouse/safety/request`, and each may only ask for the actuators its
  manifest lists.

One exception, kept for when the Jetson is down: Home Assistant's own watering rule in
`greenhouse.yaml` calls the utility node directly. The node's own refusals still apply to it.
See the [watering fallback](#around-the-path) and its [known issue](#known-issues-and-what-is-not-verified).

The governor checks, in the order the code runs, and stops at the first failure:

1. **Defined.** The action must have a limit in
   [`limits.yaml`](../greenhouse/jetson/config/limits.yaml). One without is always denied.
2. **Who.** A module must be enabled and allowed this actuator in its manifest.
3. **Kill switch.** On: every agent request is denied.
4. **Authority ceiling.** See the table below.
5. **Approval policy.** Per action: `never`, `agent` (an agent's request waits for you unless
   the ceiling is Agent autonomous) or `always` (any module's request waits, at every level).
   Your own requests never wait.
6. **Tend grant.** The arm's approach, cut and release, asked by a module, need a live
   approved tend task for that plant.
7. **Limits.** Minimum, maximum and the total per rolling hour.
8. **Interlocks.** Door, E-stop, water, arm stowed, gantry still. `UNKNOWN` is not `OK`. Only
   checked for what would run now: a proposal meets them when you approve it.
9. **Plant record.** Work at a plant needs a type you confirmed, and a plant not marked dead.

Then one of three verdicts, each logged and shown in the panel:

- **Approved:** published on `greenhouse/actuator/<name>/set` and counted against its hourly limit.
- **Proposed:** waits in the panel's approval queue, with a phone notification. Approve, and it
  goes back through every check as your own request, because the door may have opened since.
  Reject it, or leave it 24 hours, and it is denied. The queue is held in the governor's
  memory: a restart of the Jetson's core empties it without a verdict, and the agent asks again.
- **Denied:** nothing moves. The reason shows as the panel's **Last request** line.

Who acts on an approved command depends on what it is. Lights, fans, the humidifier and
watering go to Home Assistant's actuator bridge (an automation in `greenhouse_jetson.yaml`),
which calls the ESPHome action on the node. The node still refuses water with a wet tray, the
reservoir float down, the leak lockout latched or the E-stop open, and its valves are normally
closed, so a dead node waters nothing. The gantry and the arm are driven by their own drivers
on the Jetson, and each refuses to move unless the other is safe: the gantry never travels with
the arm out, the arm never moves on a moving carriage.

### The authority ceiling

One selector, five levels, owned by the supervisor and kept across restarts. A module can sit
below the ceiling (disabled), never above it.

| level | services (climate, irrigation, motion) | agents | your buttons |
|---|---|---|---|
| **Off** | stopped, with the drivers | stopped | only turning things off |
| **Manual** | running, but every request they make is denied except turning things off | paused | allowed, inside the limits |
| **Auto** | run the greenhouse | paused | allowed |
| **Agent proposes** | run | run. Watering, light level and photoperiod, fan duty, exhaust, humidifier and the VPD target wait for your approval | allowed |
| **Agent autonomous** | run | act inside the limits without asking | allowed |

At every level a cut waits for you: `robot.tend` is `approval: always`. An approved tend task
grants exactly one approach, one cut and one release at that plant, for 15 minutes.

Turning the lights off, stopping the water and switching the humidifier off (`safe_off` in
`limits.yaml`) work at every level, Off included: they go to Home Assistant's actuator bridge.
At Off the drivers are stopped with everything else above the core, so the gantry and the arm
are already still. The ESPHome failsafes hold whatever the ceiling is.

### The kill switch

`switch.greenhouse_kill`. On, the supervisor stops every agent container and the governor
denies any agent request still in flight. The deterministic services keep running the
greenhouse. It is one entity: the panel's button, the supervisor and the watchdog all read the
same one.

It stops agents, not you. A proposal that was already in the queue can still be approved, and
approving it runs it as your own request; a tend task approved that way is carried out by the
motion service. Reject what is in the queue if you want nothing to happen.

### Around the path

- **Supervisor.** Owns the enable state of every module, the authority and the kill switch;
  starts and stops containers to match; publishes one status per module. A module whose
  dependency is down reads Degraded with what it is waiting on.
- **HA bridge.** Announces about 220 entities by MQTT discovery, under the device Greenhouse.
  A new module appears without editing a dashboard.
- **Mirror.** Home Assistant copies every node state to `greenhouse/ha/<entity>/state`, and
  resyncs every five minutes. The Jetson's ESPHome link turns those into the interlocks.
- **Watchdog.** Runs in Home Assistant, so it still fires when the Jetson itself is dead. At
  Agent proposes or autonomous, with the kill switch off, an enabled agent or LLM gateway that
  is not running, faulted, offline or degraded, or an environment agent with no cycle in 45
  minutes, raises `binary_sensor.greenhouse_agent_problem` after two minutes. You get one
  notification naming the cause, another at seven minutes past every hour while it lasts, and
  one when it has been clear for two minutes. The LLM gateway reads faulted when it cannot
  reach the Claude API, has no key, or has used its daily token budget. Disabling a module an
  agent depends on makes that agent degraded, and that does raise an alert.
- **Watering fallback.** If the irrigation module is down for 10 minutes while it is enabled
  and the ceiling is Auto or above, Home Assistant turns on its own threshold rule
  (`input_boolean.gh_auto_water`) and tells you. It turns it off again once irrigation has
  read Running for two minutes. That rule calls the node directly, not through the governor.

---

## The interface, section by section

One custom card, `custom:greenhouse-panel`, shown as a panel view. No build step, no
dependencies, no network calls of its own. It renders the mockup's palette (dark ground,
green accent) at four target sizes, and when a part of the system does not exist yet, it says
so in place rather than hiding.

### Header and kill switch

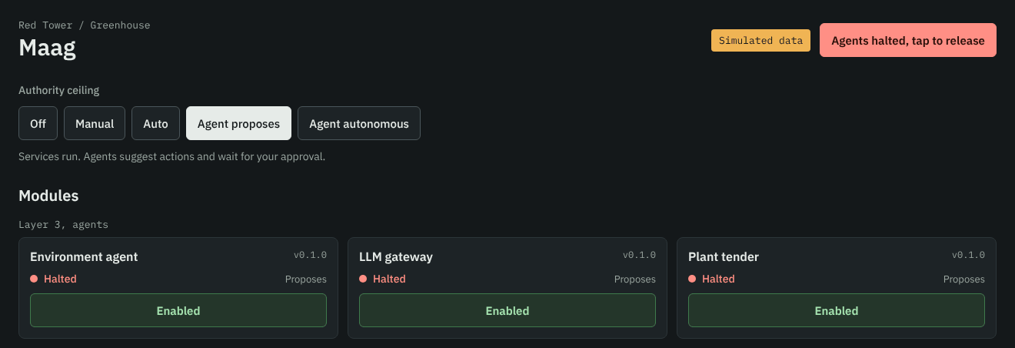
[picture p128: docs/interface/panel-kill.png]
The kill switch on: every agent halted


The kill switch sits top right, red-outlined. Tapped, it fills red and reads **Agents halted,
tap to release**; the three agent tiles turn to Halted at once. If the Jetson stops answering,
a red banner under the header says so and every module reads Offline; the ESPHome
nodes keep the lights, fans and their own limits running.

### Authority ceiling

Five buttons, the current level filled. The line under them says what that level means in one
sentence. The level is `select.greenhouse_authority`, so it can also be set from an automation.

### Modules

One tile per module, grouped by layer: agents, services, drivers, core. Each tile shows its
status, its mode (Off, Manual, Auto, Proposes, Autonomous, Paused), a one-line detail (the VPD
against target, today's token count, what a degraded module waits on) and, except on the
core, its version.

| status | colour | means |
|---|---|---|
| Running | green | up and doing its job |
| Stub, no hardware | blue | running on its simulated backend, counted as present by its dependents |
| Degraded | amber | running, but a dependency is down: the detail names it |
| Disabled | red tile | switched off by you |
| Halted | red | an agent, stopped by the kill switch |
| Fault, Offline | red | reported a fault, or no heartbeat for 30 s |
| Paused | grey | an agent below Agent proposes |
| Stopped | grey | authority is Off |
| Not built yet | grey | defined, not installed |

The button under each tile enables or disables that module (`switch.greenhouse_<module>_enabled`).
The core four have no switch: they read **Always on**.

### Environment

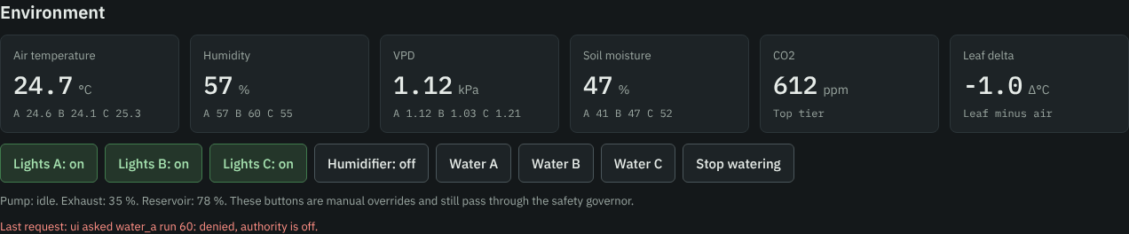
[picture p129: docs/interface/panel-denied.png]
The environment section, with a watering request the governor denied at authority Off


Air temperature, humidity, VPD and soil moisture as the mean of the three tiers with each
tier underneath, CO2 from the top tier, and the leaf delta (canopy minus air, from the IR
sensors). Below them, the manual overrides: lights per tier, humidifier, watering per zone and
stop. They are requests like any other and pass the governor; the line under them shows the
latest decision. Above, at authority Off, a watering request was denied with its reason.

### Power

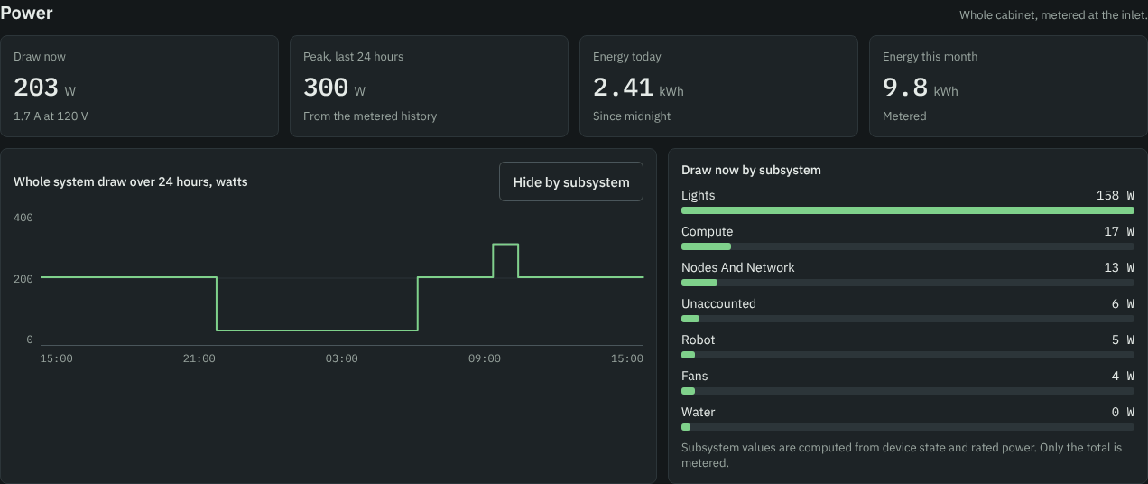
[picture p130: docs/interface/panel-power.png]
Power: draw now, 24 hour peak, energy today and this month, and the 24 hour line with the subsystem breakdown open


Draw now and the 24 hour peak from the PZEM-004T meter at the cabinet inlet, energy today and
this month from utility meters on that meter's energy count. The single green line is the last
24 hours of metered draw at full width. **Show by subsystem** opens the breakdown beside it;
those values are computed from device state times rated power, only the total is metered, and
an **unaccounted** line shows the difference. The Energy dashboard reads the same meter.

### Plants and the plant card

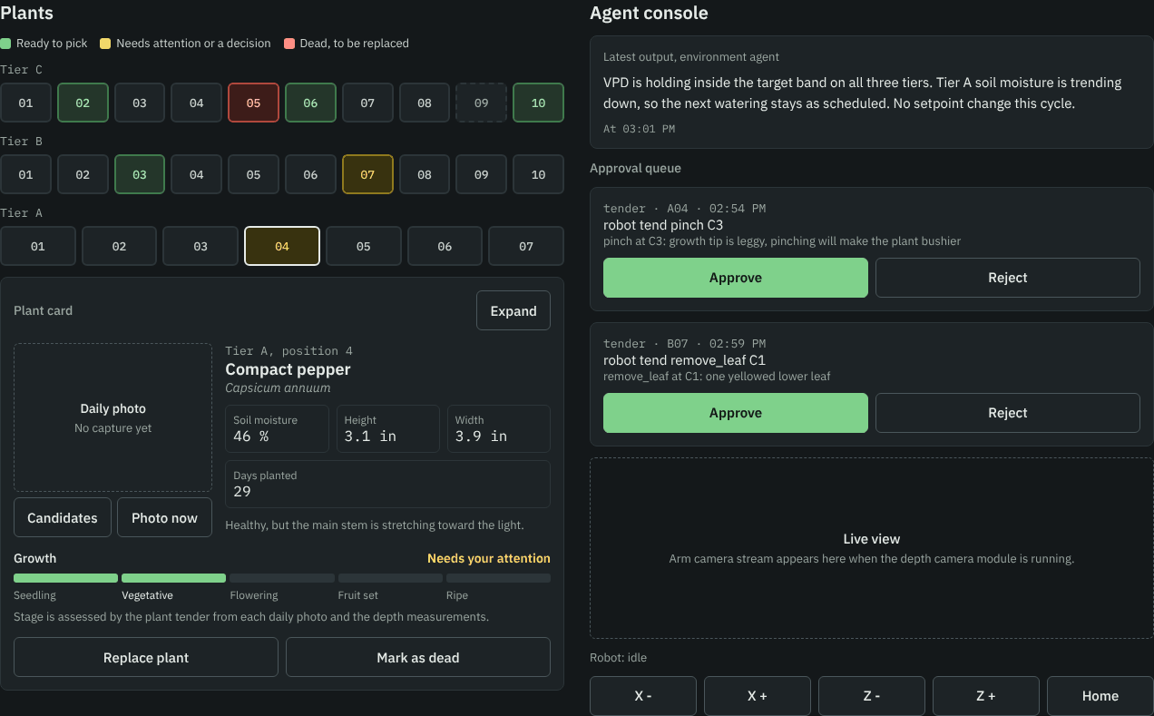
[picture p131: docs/interface/panel-plants-console.png]
The plants grid with tier A position 4 selected, and the agent console with two proposals waiting


27 positions in three tiers, top tier first: green is ready to pick, yellow needs your
attention or a decision, red is dead and to be replaced, a dashed cell is empty. Tap a cell to
open its card: the daily photo from the arm camera (or its candidate overlay), common and
scientific name, soil moisture, height and width from the depth camera (inches or centimetres
following your Home Assistant unit system), days planted, and the milestone growth bar the
plant tender assesses from each day's photo.

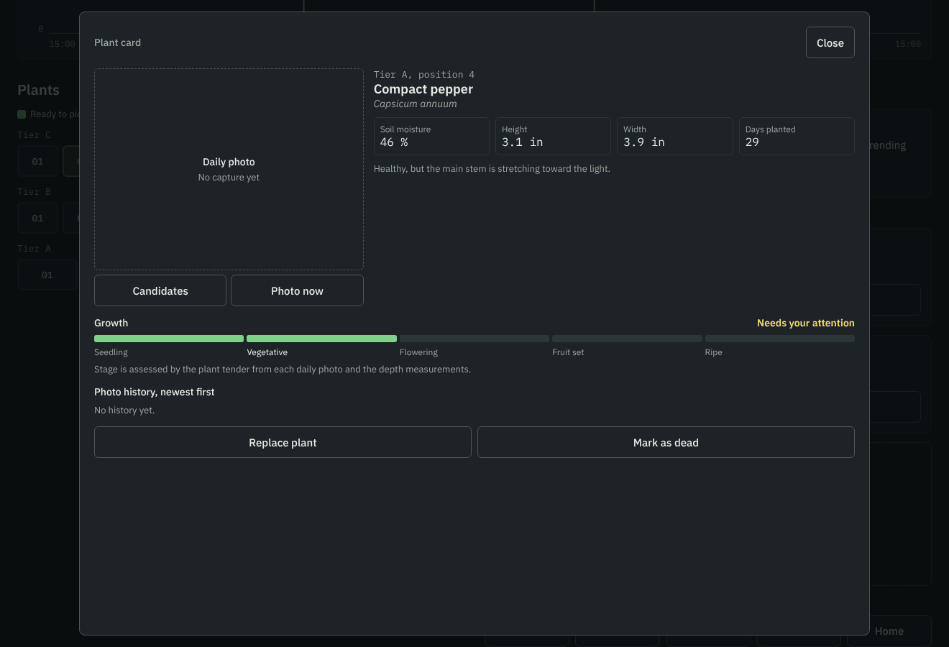
[picture p132: docs/interface/panel-plant-overlay.png]
The plant card expanded to near full screen


**Expand** opens the card nearly full screen with the photo history. **Replace plant** asks for
the new type: your entry is the record, the camera only ever suggests one, and the tender
will not work on a position without a type you confirmed. **Mark as dead** turns the cell red.
**Photo now** asks the motion service for a fresh photo of that plant; motion then asks the
governor for every move as a service, so it works at Auto and above, and only for a living
plant with a confirmed type while the robot is idle.

### Agent console

The environment agent's latest output in plain words with the actions it took and their
verdicts, then the approval queue: each proposal with who asked, which plant, what and why,
and **Approve** or **Reject**. Below, the arm camera's live view, and the gantry's jog and
**Home** buttons. Home goes through the governor and its interlocks (door, E-stop, arm
stowed). The jog buttons are drawn but the gantry driver does not carry out jogs yet: see
[known issues](#known-issues-and-what-is-not-verified).

### Four sizes

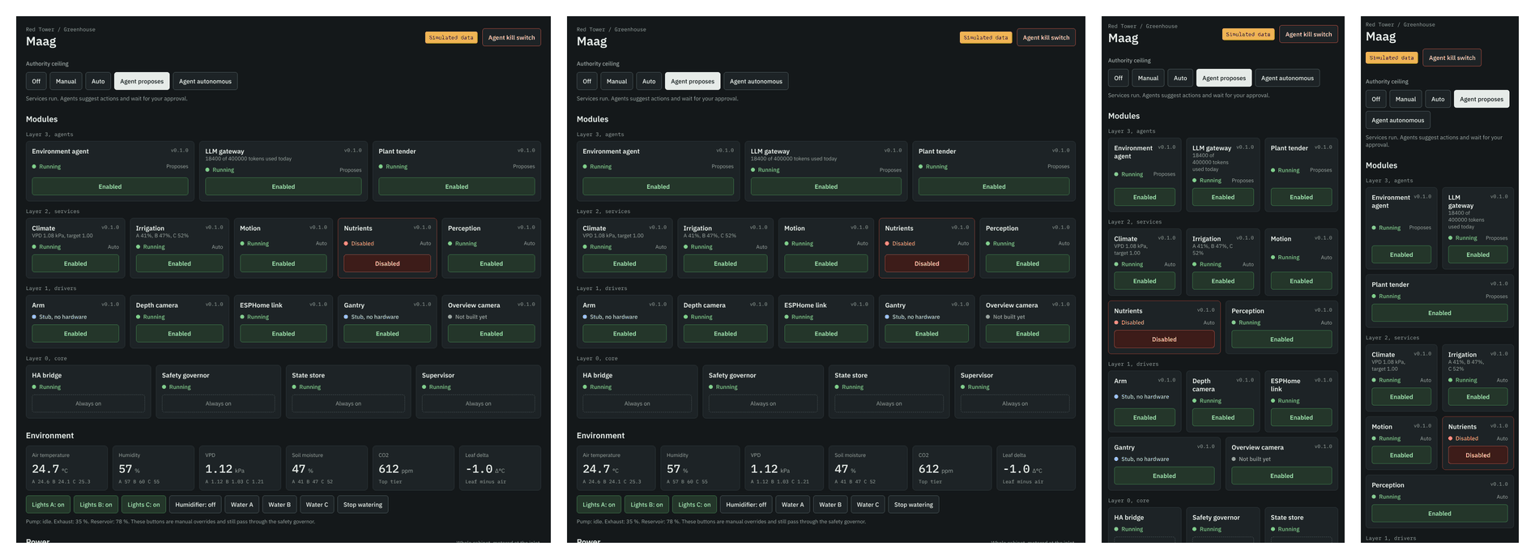
[picture p133: docs/interface/panel-sizes.png]
The panel at 1320, 1280, 600 and 390 px


Desktop 1320, a 10 in tablet at 1280 landscape, a 7 in tablet at 600 portrait, a phone at 390.
Full pages: [1320](interface/panel-desktop-1320.png) · [1280](interface/panel-tablet-1280.png) ·
[600](interface/panel-tablet-600.png) · [390](interface/panel-mobile-390.png). Every control is
at least 44 px tall, so it can be hit with a thumb.

---

## What every control sends

The panel never calls an ESPHome service and never publishes an actuator topic.

| control | sends | who decides |
|---|---|---|
| Kill switch | `switch.toggle` on `switch.greenhouse_kill` | supervisor |
| Authority buttons | `select.select_option` on `select.greenhouse_authority` | supervisor |
| Module Enabled / Disabled | `switch.toggle` on `switch.greenhouse_<module>_enabled` | supervisor |
| Lights A, B, C | `greenhouse/safety/request/ui`: `light_<tier>` `off` or `schedule_on` | governor |
| Humidifier | `humidifier` `on` for 5 min, or `off` | governor |
| Water A, B, C | `water_<tier>` `run` for `input_number.gh_run_<tier>` seconds (60 if missing) | governor, then the node |
| Stop watering | `water` `stop` | governor (always allowed) |
| Home | `gantry` `home` | governor, then the gantry driver |
| Jog X, Z | `gantry` `jog_x` or `jog_z` by 20 mm | governor; the driver does not jog yet |
| Approve / Reject | `greenhouse/proposal/<id>/decision`: `approve` or `reject` | governor checks again |
| Replace plant / Mark as dead | `greenhouse/store/cmd/ui`: `replace_plant` or `mark` | state store |
| Photo now | `greenhouse/motion/cmd`: `visit` the position | motion, which asks the governor for every move |
| Plant cell, Expand, Candidates, Show by subsystem | nothing: view only | |

---

## What the panel reads

From the Jetson's MQTT discovery, from the ESPHome nodes, and from the two packages (the
energy and subsystem sensors, the watering run times). Anything missing renders as `--` or as
an empty placeholder, never as an error.

| section | entities |
|---|---|
| header, authority, modules | `binary_sensor.greenhouse_supervisor_alive`, `select.greenhouse_authority`, `switch.greenhouse_kill`, every `sensor.greenhouse_<module>_status` and `switch.greenhouse_<module>_enabled` |
| environment | `sensor.greenhouse_tier_<a,b,c>_{air_temperature, air_humidity, vpd, median_moisture, canopy_temperature}`, `sensor.greenhouse_tier_c_co2`, `light.greenhouse_tier_<t>_grow_light`, `switch.greenhouse_utility_humidifier`, `binary_sensor.greenhouse_utility_watering_active`, `fan.greenhouse_tier_c_exhaust_fans`, `sensor.greenhouse_utility_reservoir_level`, `sensor.greenhouse_last_decision`, `input_number.gh_run_<tier>` |
| power | `sensor.greenhouse_utility_cabinet_{power, current, voltage}`, `sensor.greenhouse_energy_today`, `sensor.greenhouse_energy_this_month`, every `sensor.greenhouse_power_<subsystem>`, and the history of the cabinet power |
| plants | `sensor.greenhouse_plant_<position>`, `sensor.greenhouse_observation_<position>`, `sensor.greenhouse_tier_<t>_<position>_moisture`, `camera.greenhouse_{photo, annotated, history}_<position>`, `sensor.greenhouse_tender_output` |
| console | `sensor.greenhouse_envagent_output`, `sensor.greenhouse_proposals`, `camera.greenhouse_live_d405`, `binary_sensor.greenhouse_robot_busy` |

Module tiles come from whatever `sensor.greenhouse_<module>_status` entities exist, so a module
you add to the Jetson appears in the panel by itself, as long as its name is lowercase letters
and digits only: the card does not match a name with an underscore.

---

## Install

You need Home Assistant 2024.8 or newer (the packages use the `action:` key). For live data you
also need the MQTT integration on a Mosquitto broker, the Jetson stack
([Jetson bring-up](08-arm.md#jetson-bring-up)) and the ESPHome nodes ([firmware](06-firmware.md)).
For a look, you need none of that.

### Try it with simulated data

1. Copy `greenhouse-panel.js` into `config/www/greenhouse/` (create the folder).
2. Settings, Dashboards, the three dots, **Resources**, **Add resource**:
   `/local/greenhouse/greenhouse-panel.js?v=0.10.1`, type **JavaScript module**.
3. Open any dashboard, **Edit**, the three dots, **Raw configuration editor**, and paste
   [`dashboard_view.yaml`](../greenhouse/ha/dashboard_view.yaml) under `views:`. Save.

The view opens with an amber **Simulated data** tag. Every button works: switch the authority,
pull the kill switch, approve a proposal, replace a plant. Nothing leaves the browser.

### From HACS (the card only)

HACS, the three dots, **Custom repositories**: `https://github.com/v1proxy/RedTower`,
type **Dashboard**. Install **Maag greenhouse panel**. HACS downloads the card from
[`dist/`](../dist/greenhouse-panel.js) and adds the resource for you; then paste the view as
above. HACS installs only the card: the packages below are copied by hand.

### The whole Home Assistant side

From the release, unzip `maag-homeassistant-<version>.zip`. Its `config/` folder mirrors
Home Assistant's own.

1. In `configuration.yaml`, if it is not there yet:

   ```yaml
   homeassistant:
     packages: !include_dir_named packages
   ```

2. Copy `config/packages/greenhouse.yaml` and `config/packages/greenhouse_jetson.yaml` into
   your `packages/` folder. Both are needed: `greenhouse.yaml` holds the thresholds, the run
   times the Water buttons use, the fallback watering rule, the script that switches the
   humidifier off after its minutes, and the node alerts; `greenhouse_jetson.yaml` holds the
   mirror, the actuator bridge, the watchdog, the energy sensors and the agent alerts. Do not
   trim `greenhouse.yaml`: without `script.gh_humidifier_off_after` a humidifier run lasts
   until the node's own 30 minute cap.
3. In both files replace `notify.notify` with your phone's notify service, for example
   `notify.mobile_app_<phone>`.
4. Copy `config/www/greenhouse/greenhouse-panel.js` and add the resource as above, or install
   the card from HACS.
5. Broker: create the two Jetson logins (`broker/mosquitto-setup.md`). The access list
   (`broker/mosquitto-acl.sample`) is what keeps every non-core module off the actuator topics;
   install it before the arm is live. **It has no entry for Home Assistant's own login**: add
   one first, or Home Assistant is cut off from MQTT. The bench check appends exactly this,
   for the user Home Assistant's MQTT integration logs in with (`homeassistant` on the
   Mosquitto app):

   ```
   user homeassistant
   topic readwrite #
   ```

6. Restart Home Assistant. Once the Jetson's bridge has announced itself, the device
   **Greenhouse** appears under the MQTT integration with its entities.
7. Paste the view, then delete its `demo: true` line.
8. Energy dashboard: add `sensor.greenhouse_utility_cabinet_energy` as an individual device
   and call it Greenhouse. The six `sensor.greenhouse_energy_<subsystem>` sensors are
   computed, not metered: add them only as devices whose upstream device is Greenhouse, if your
   Home Assistant offers that setting, so nothing is counted twice.

### Updating

Copy the new files over the old ones and raise `?v=` on the resource to the new version, so
every browser and the companion app load the new card. HACS does the card for you.

---

## Check it

- **On real hardware:** [`COMMISSIONING.md`](../greenhouse/COMMISSIONING.md), step 3. Pass: the
  Greenhouse view shows every module with its status and Supervisor reads Running.
- **On a bench, no hardware:** `greenhouse/jetson/tools_ha_check.py` starts the Home Assistant
  Docker image with `greenhouse_jetson.yaml`, a private Mosquitto with the access list and the
  whole stack, then checks that the configuration is valid, that every entity the package and
  the panel use exists, that an approved watering reaches the right ESPHome action, that the
  package logs no errors, and that the panel renders the real module states in headless
  Chromium. CI runs it on every push that touches `greenhouse/`, against the current stable
  Home Assistant.
- **The bundle:** `python greenhouse/ha/make_bundle.py --check` confirms the card's version, that
  `dist/` matches the source, and that every file the zip carries exists.

---

## Known issues and what is not verified

- **Two things can water after a Home Assistant restart.** `input_boolean.gh_auto_water` starts
  on at every restart (`initial: true` in `greenhouse.yaml`), and the handover that turns it off
  only fires when irrigation changes to Running. If irrigation was already running, Home
  Assistant's threshold rule and the Jetson's irrigation can both water the same zone, at most
  once an hour each, until you turn `gh_auto_water` off. The node's own refusals still hold.
  Fixing the start state and the handover is open.
- **The jog buttons do nothing yet.** The governor approves a jog from the panel, so Last
  request reads approved, but the gantry driver does not carry out `jog_x` or `jog_z`. Home
  works.
- **First-generation helpers in `greenhouse.yaml`.** The package still defines
  `input_select.gh_authority`, `input_boolean.gh_kill`, `input_boolean.gh_claude_autonomy`,
  `input_text.gh_proposal_plant` and `gh_proposal_action`, and the scripts `gh_robot_task` and
  `gh_tender_approve`, from the prototype tending scripts in `jetson/prototype/`. The stack does
  not read them and the panel does not show them. They still appear in Home Assistant's entity
  list: do not put them on a dashboard. The kill switch and the authority that count are
  `switch.greenhouse_kill` and `select.greenhouse_authority`. Taking them out is open; keep the
  rest of the package.
- **The reference build still runs the first-generation card** (the one in
  `greenhouse/homeassistant/www/`, which drives those helpers). Installing this card, step 3 of
  commissioning, is what makes the panel's kill switch the supervisor's.
- **Tested combinations.** The bench check loads `greenhouse_jetson.yaml` alone, on the current
  stable Home Assistant. Both packages together, and Home Assistant 2024.8, are not tested.
- **Tablet and phone layouts are verified in a browser at their widths** (the pictures above),
  not yet on the devices.
- **The access list is a sample.** It has run against a bench Mosquitto, not on the reference
  build's broker, and it needs the Home Assistant entry above.
- **The live view** waits on the depth camera module. Until then it shows its placeholder.
- **Fonts.** The card asks for IBM Plex Sans and IBM Plex Mono and uses the system font where
  they are not installed. The pictures were rendered with Plex installed.

---

## Regenerating the pictures and the bundle

Every picture in this chapter is generated, like the rest of the repository:

```
python greenhouse/ha/make_shots.py --fonts <folder of IBM Plex woff2>    # docs/interface/panel-*.png
python greenhouse/ha/make_control_diagram.py --fonts <Maag fonts>       # docs/interface/control-system.*
python greenhouse/ha/make_bundle.py                                     # dist/ and the release zip
```

`make_shots.py` loads the real card in headless Chromium with `demo: true`, so the pictures
are the card, not a mockup of it. The zip and `dist/greenhouse-panel.js` are attached to each
release by hand.
