v1proxy/RedTower/docs/08-gantry.md

# Module — gantry

The gantry's booklet, Gantry Rev E, can be read [page by page](booklets/gantry.md); its
guide is [`greenhouse/gantry/GANTRY_ASSEMBLY.md`](../greenhouse/gantry/GANTRY_ASSEMBLY.md).

*Chapter not yet written for the parametric design (0.1.0).*

The reference `m` build is fully documented in the generators and configs:
see `greenhouse/` and `CHANGELOG.md` for what is and is not yet derived from
`design/`. This chapter is written as part of the 0.2.0 work, when the
generators are driven by the solver rather than by their own constants.
