v1proxy/RedTower/docs/booklets/enclosure.md

# Enclosure Rev A, page by page

<!-- generated by greenhouse/booklet/make_gallery.py from greenhouse/enclosure/Maag_Enclosure_Assembly_Instructions_RevA.pdf: do not edit -->

Polycarbonate panels, the fans and the four doors, on the finished cabinet. 26 pages, 18 steps. Each page below is the PDF's own page as an image; click one for full size.

[PDF](../../greenhouse/enclosure/Maag_Enclosure_Assembly_Instructions_RevA.pdf) · [Guide](../../greenhouse/enclosure/ENCLOSURE.md) · [All booklets](README.md) · previous: [Gantry Rev E](gantry.md) · next: [Harvest Rev B](harvest.md)

<details><summary><b>Contents</b>, 26 pages</summary>

- [1 · Cover](#1--cover)
- [2 · The enclosure · what goes where](#2--the-enclosure--what-goes-where)
- [3 · Enclosure · parts](#3--enclosure--parts)
- [4 · Enclosure · fasteners](#4--enclosure--fasteners)
- [5 · Tools](#5--tools)
- [6 · Where every screw goes · sides and back](#6--where-every-screw-goes--sides-and-back)
- [7 · Where every screw goes · top and front](#7--where-every-screw-goes--top-and-front)
- [8 · How it closes · the door, in section](#8--how-it-closes--the-door-in-section)
- [9 · Step 1 · Before you start](#9--step-1--before-you-start)
- [10 · Step 2 · Clean every land, seal the post tops](#10--step-2--clean-every-land-seal-the-post-tops)
- [11 · Step 3 · Back · tape](#11--step-3--back--tape)
- [12 · Step 4 · Back · the bottom panel](#12--step-4--back--the-bottom-panel)
- [13 · Step 5 · Back · the middle and upper panels](#13--step-5--back--the-middle-and-upper-panels)
- [14 · Step 6 · Back · two battens over the seams](#14--step-6--back--two-battens-over-the-seams)
- [15 · Step 7 · Right panel · on the bench first](#15--step-7--right-panel--on-the-bench-first)
- [16 · Step 8 · Right panel · tape, then the panel](#16--step-8--right-panel--tape-then-the-panel)
- [17 · Step 9 · Left side · take the riser off the post](#17--step-9--left-side--take-the-riser-off-the-post)
- [18 · Step 10 · Left side · tape, grommets, the panel](#18--step-10--left-side--tape-grommets-the-panel)
- [19 · Step 11 · Left side · the riser on its P-clips](#19--step-11--left-side--the-riser-on-its-p-clips)
- [20 · Step 12 · Top panel · fans on the bench](#20--step-12--top-panel--fans-on-the-bench)
- [21 · Step 13 · Top panel · on, and anchored to the wall](#21--step-13--top-panel--on-and-anchored-to-the-wall)
- [22 · Step 14 · Doors · on the bench](#22--step-14--doors--on-the-bench)
- [23 · Step 15 · Front · weatherstrip, magnets, switches](#23--step-15--front--weatherstrip-magnets-switches)
- [24 · Step 16 · Front · hang the doors](#24--step-16--front--hang-the-doors)
- [25 · Step 17 · Doors · adjust and check](#25--step-17--doors--adjust-and-check)
- [26 · Step 18 · Before you plant](#26--step-18--before-you-plant)

</details>

---

### 1 · Cover

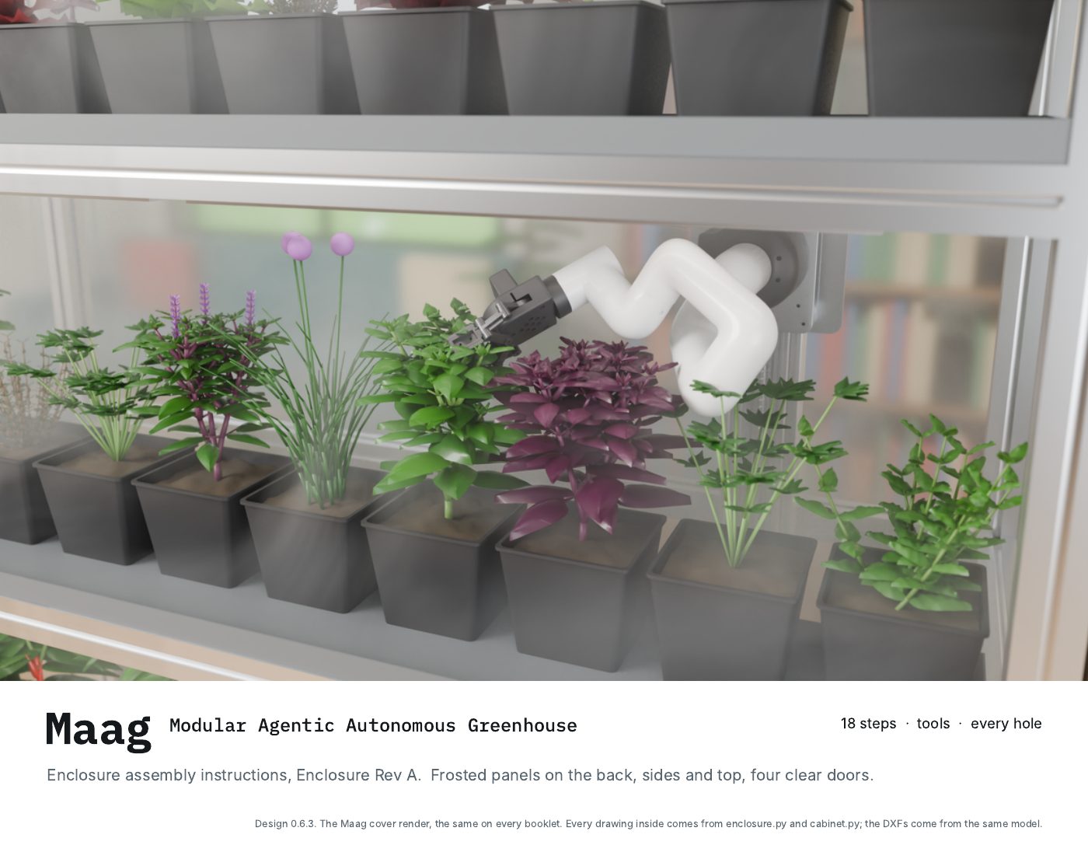
[picture p134: docs/booklets/enclosure/p01.jpg]
Enclosure Rev A, page 1: Cover


### 2 · The enclosure · what goes where

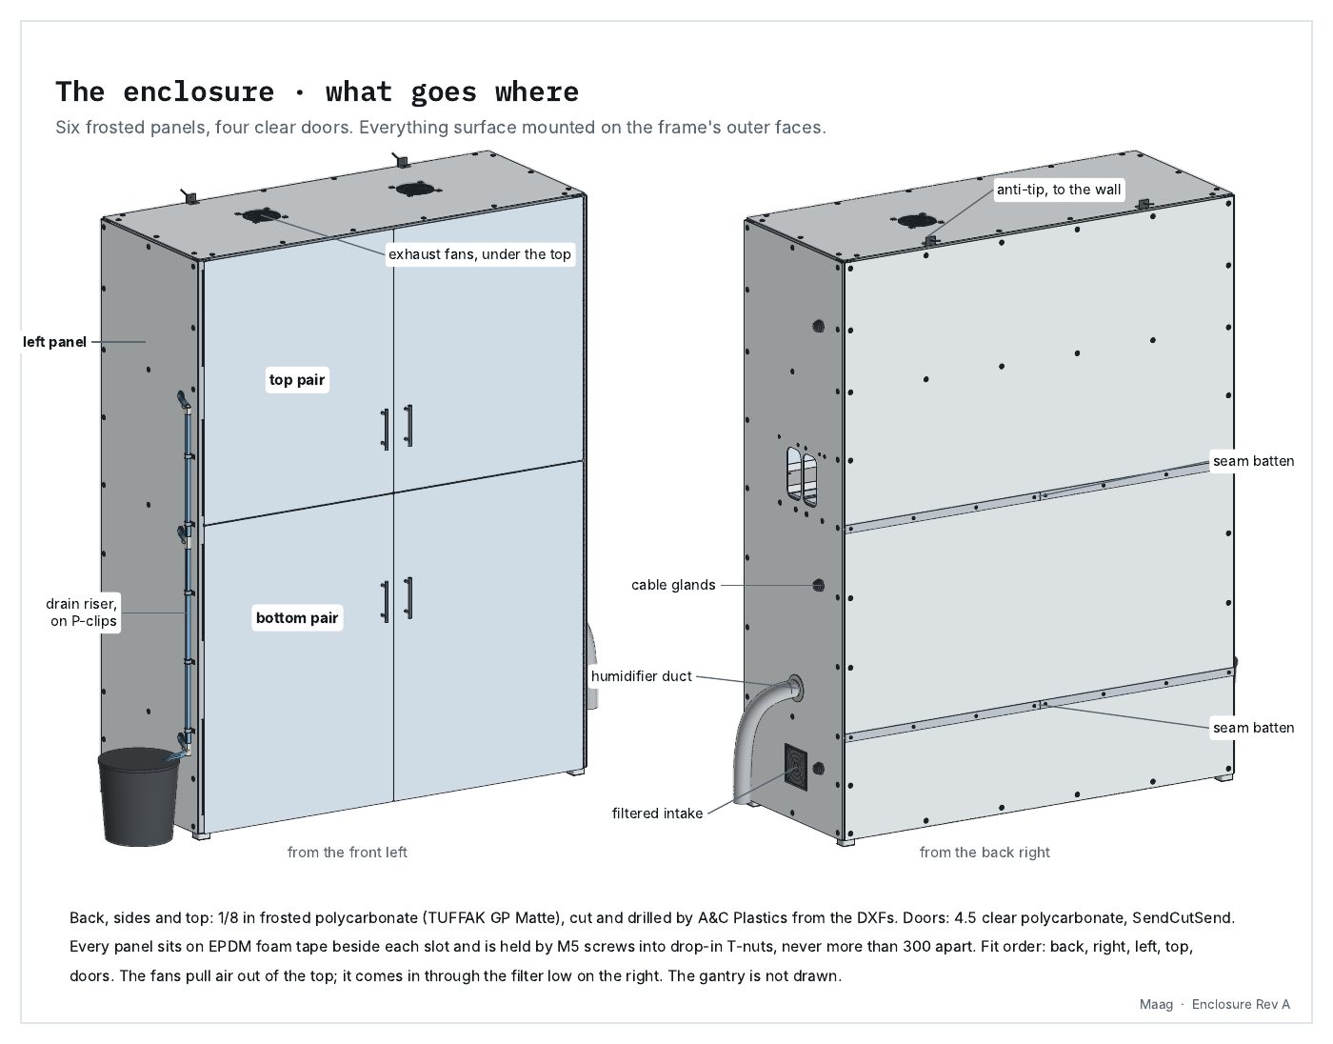
[picture p135: docs/booklets/enclosure/p02.jpg]
Enclosure Rev A, page 2: The enclosure · what goes where


### 3 · Enclosure · parts

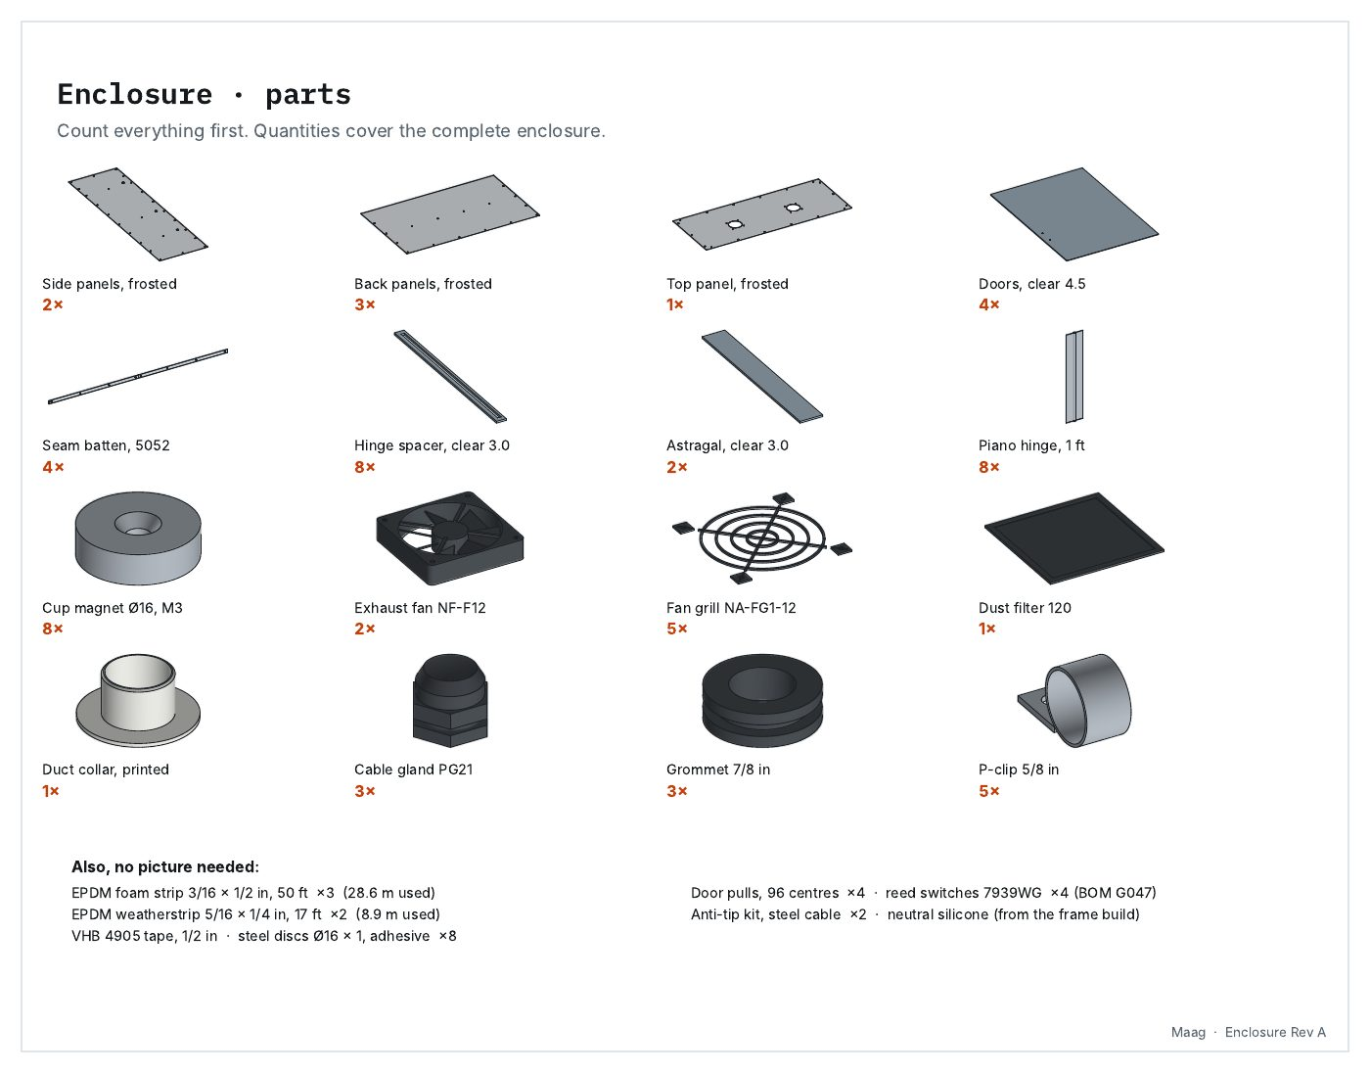
[picture p136: docs/booklets/enclosure/p03.jpg]
Enclosure Rev A, page 3: Enclosure · parts


### 4 · Enclosure · fasteners

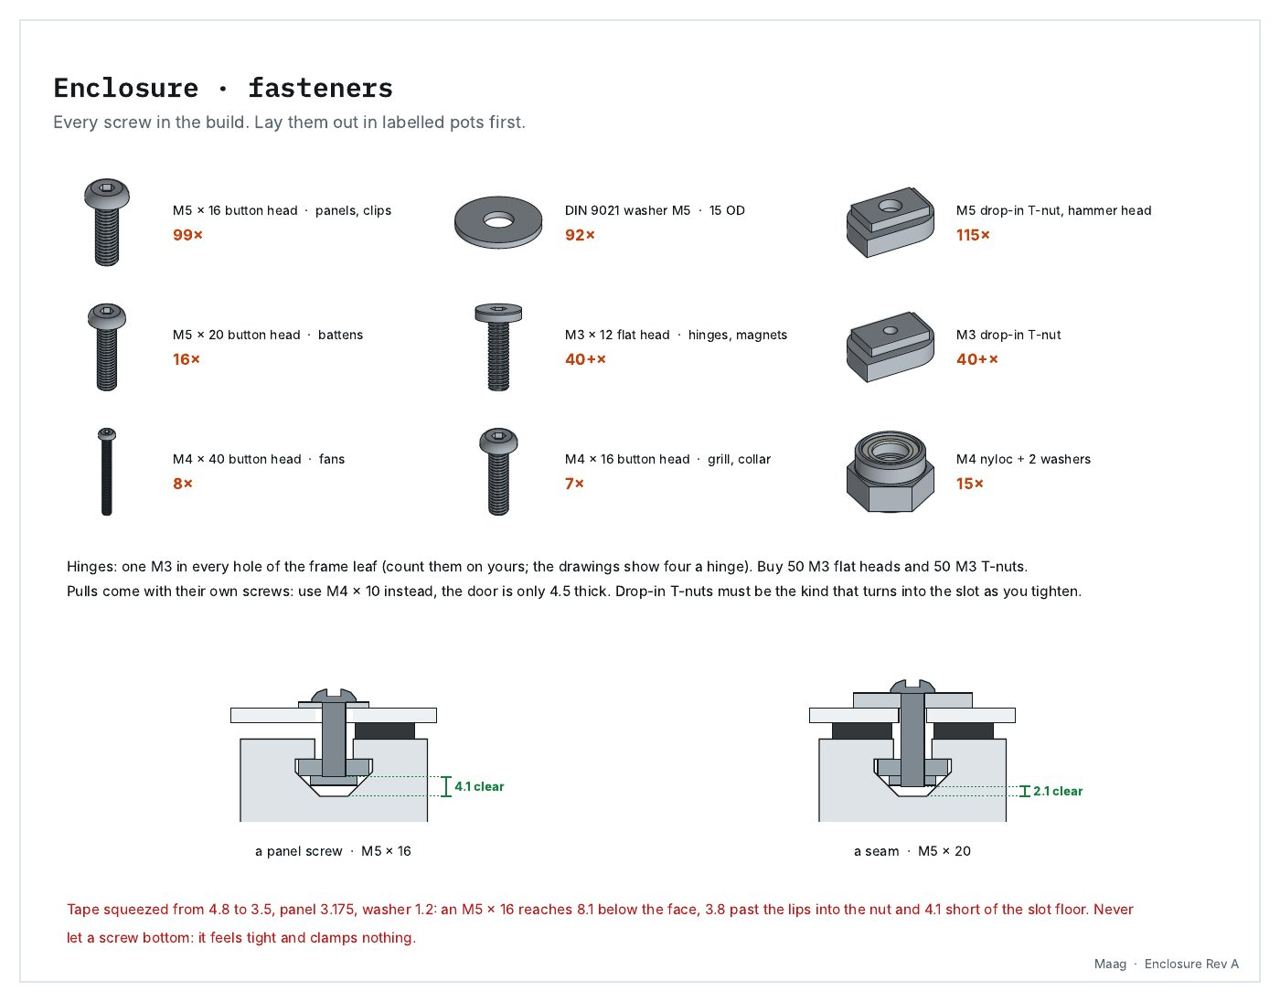
[picture p137: docs/booklets/enclosure/p04.jpg]
Enclosure Rev A, page 4: Enclosure · fasteners


### 5 · Tools

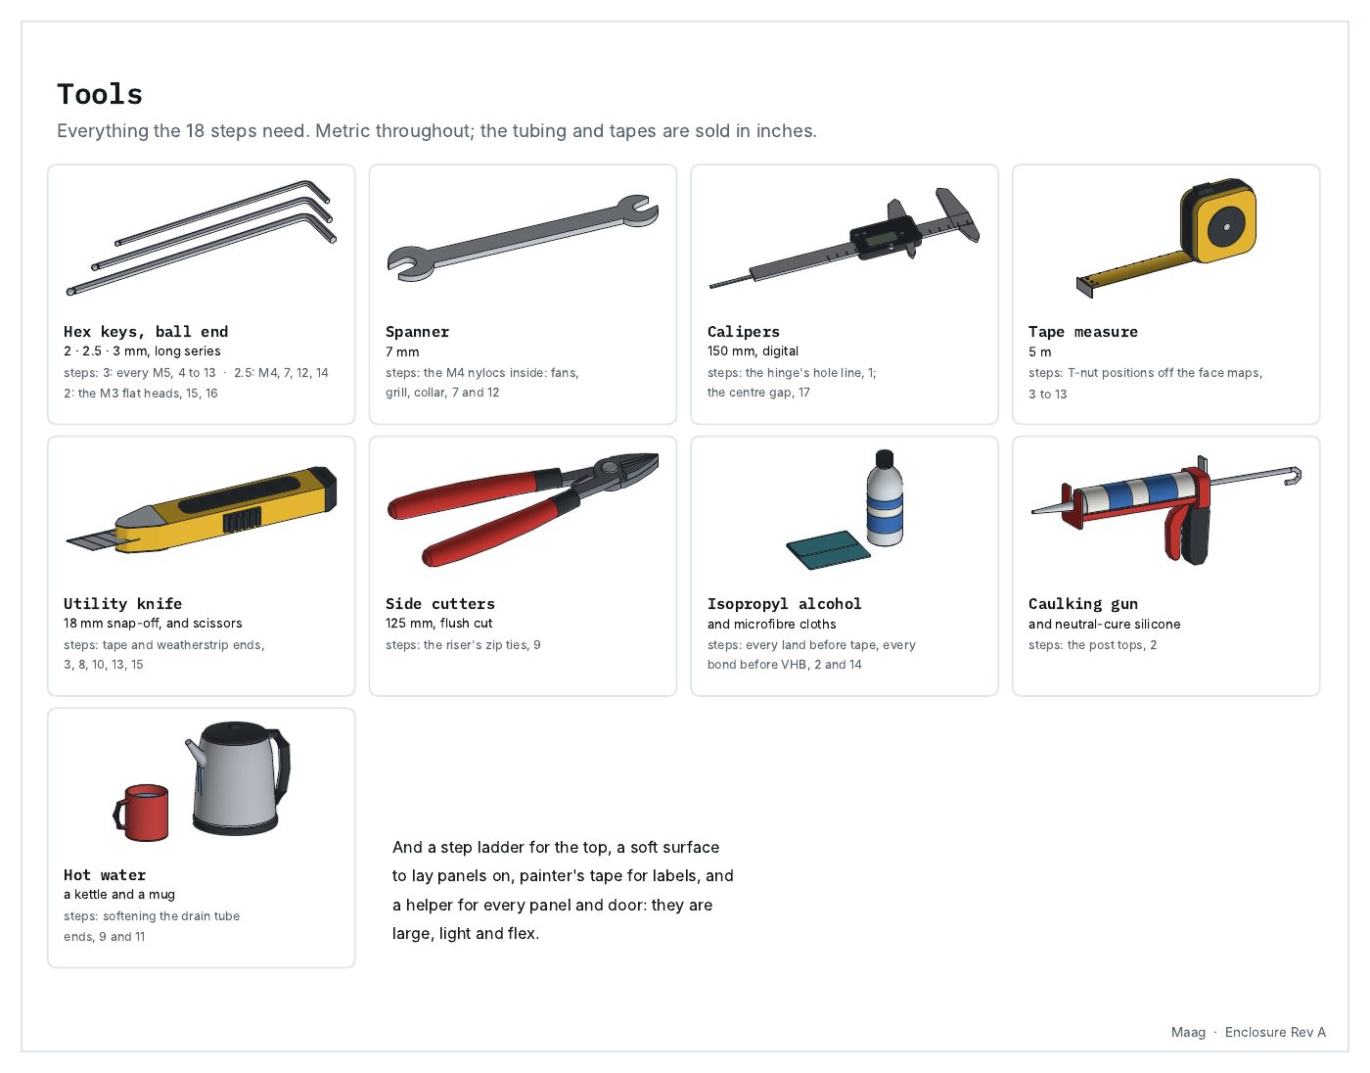
[picture p138: docs/booklets/enclosure/p05.jpg]
Enclosure Rev A, page 5: Tools


### 6 · Where every screw goes · sides and back

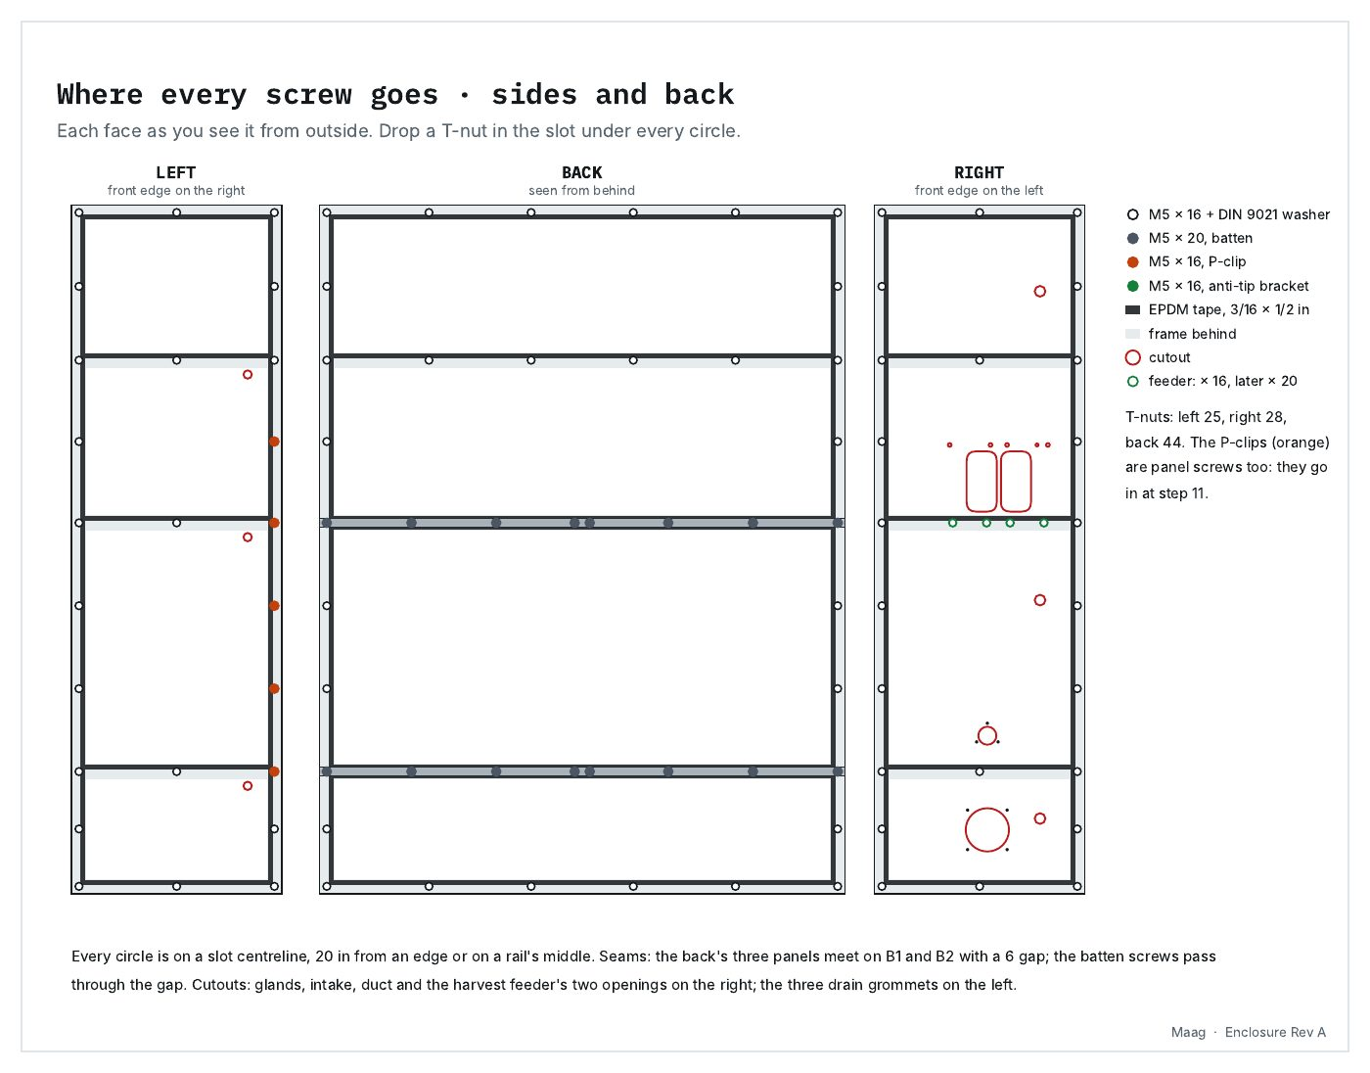
[picture p139: docs/booklets/enclosure/p06.jpg]
Enclosure Rev A, page 6: Where every screw goes · sides and back


### 7 · Where every screw goes · top and front

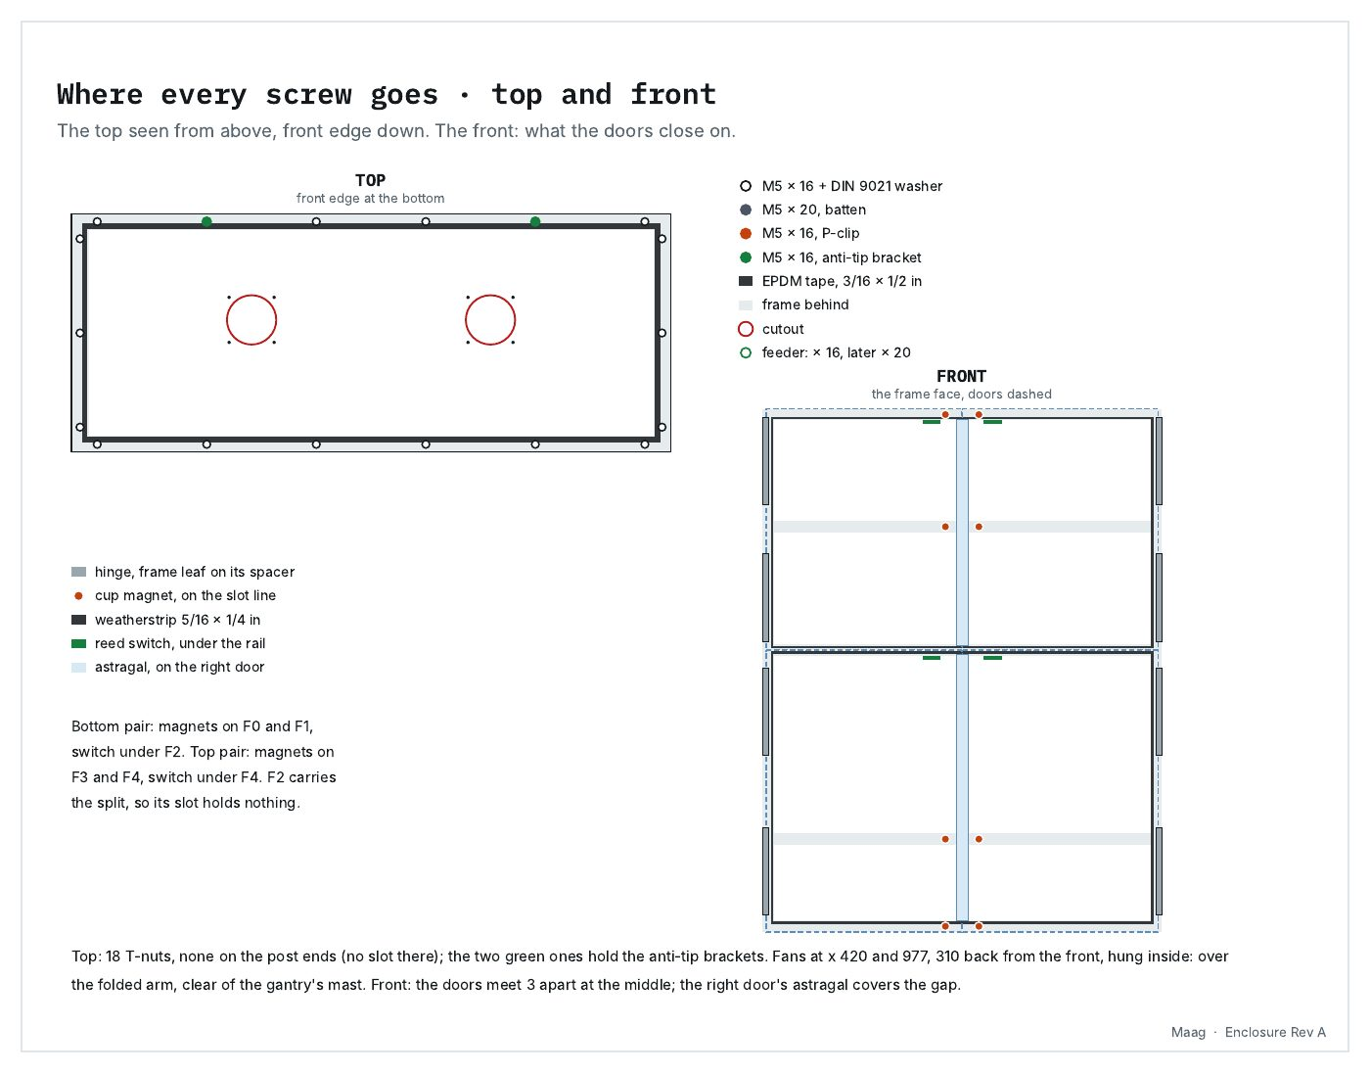
[picture p140: docs/booklets/enclosure/p07.jpg]
Enclosure Rev A, page 7: Where every screw goes · top and front


### 8 · How it closes · the door, in section

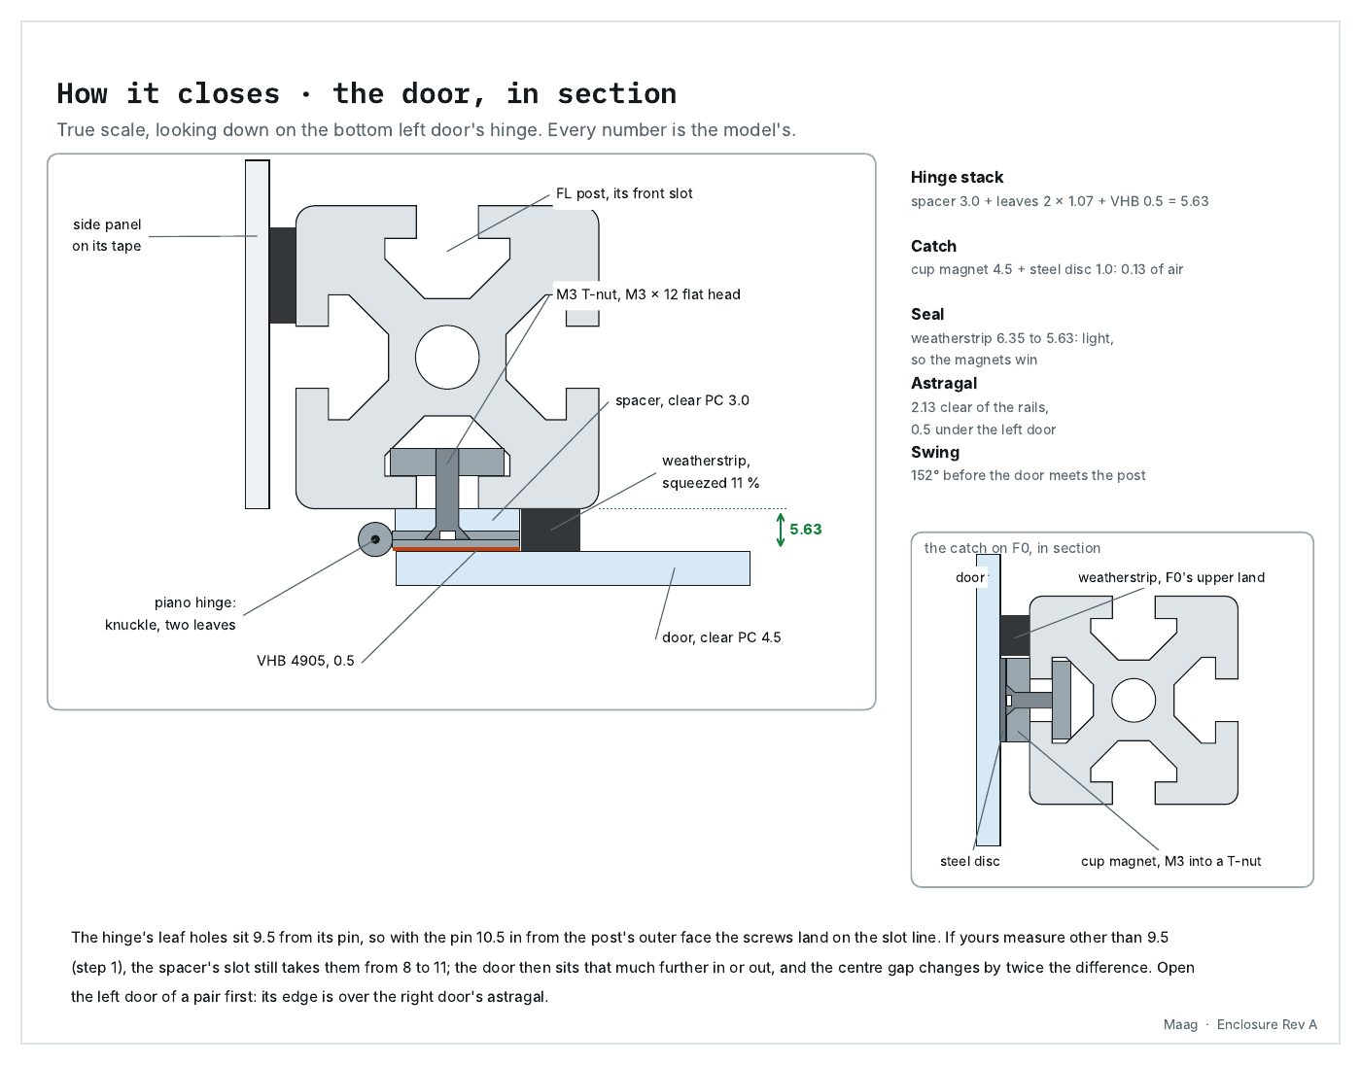
[picture p141: docs/booklets/enclosure/p08.jpg]
Enclosure Rev A, page 8: How it closes · the door, in section


### 9 · Step 1 · Before you start

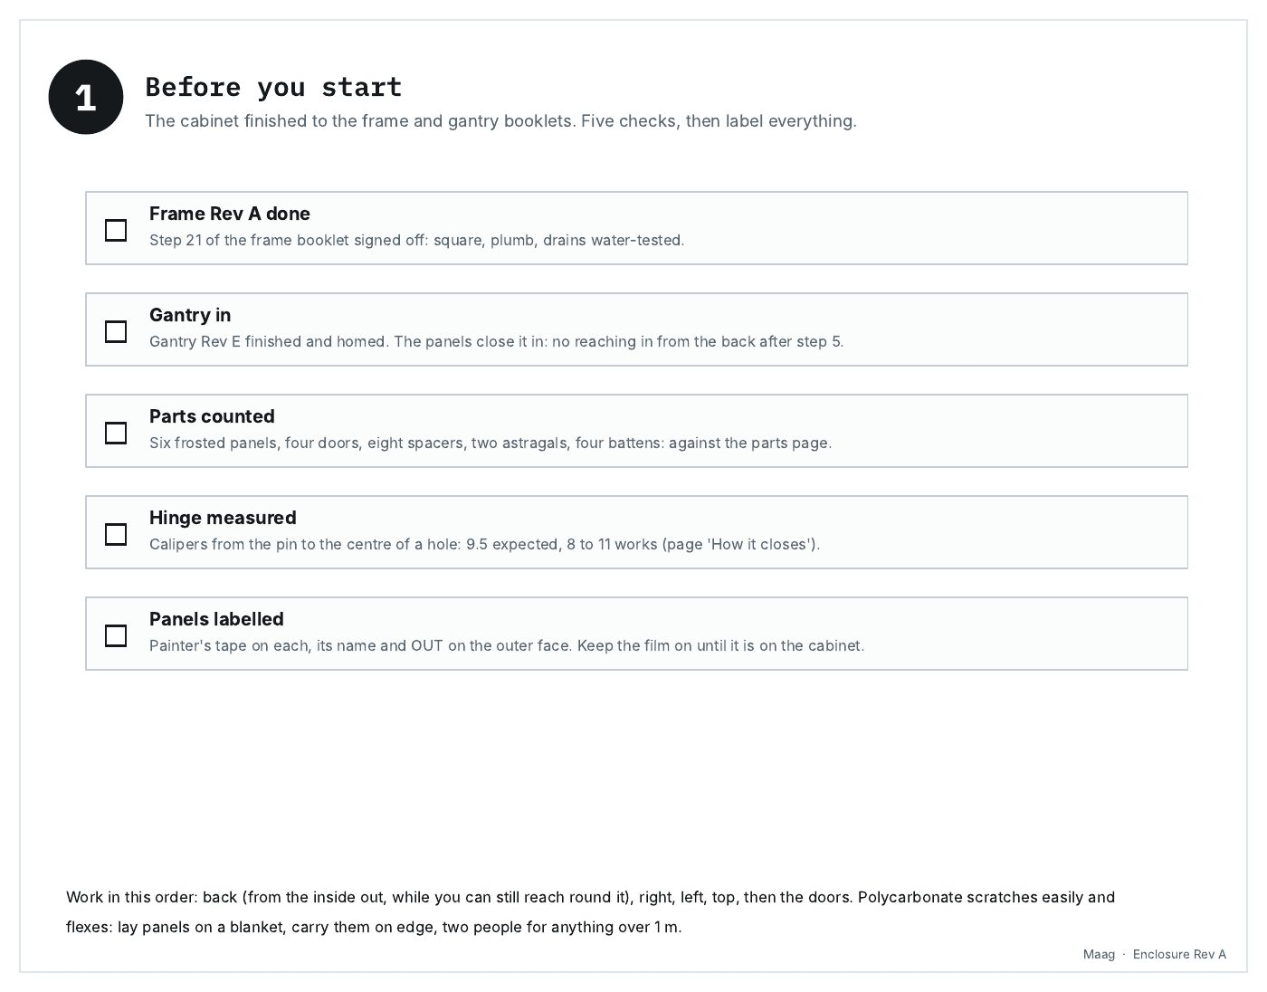
[picture p142: docs/booklets/enclosure/p09.jpg]
Enclosure Rev A, page 9: Before you start


### 10 · Step 2 · Clean every land, seal the post tops

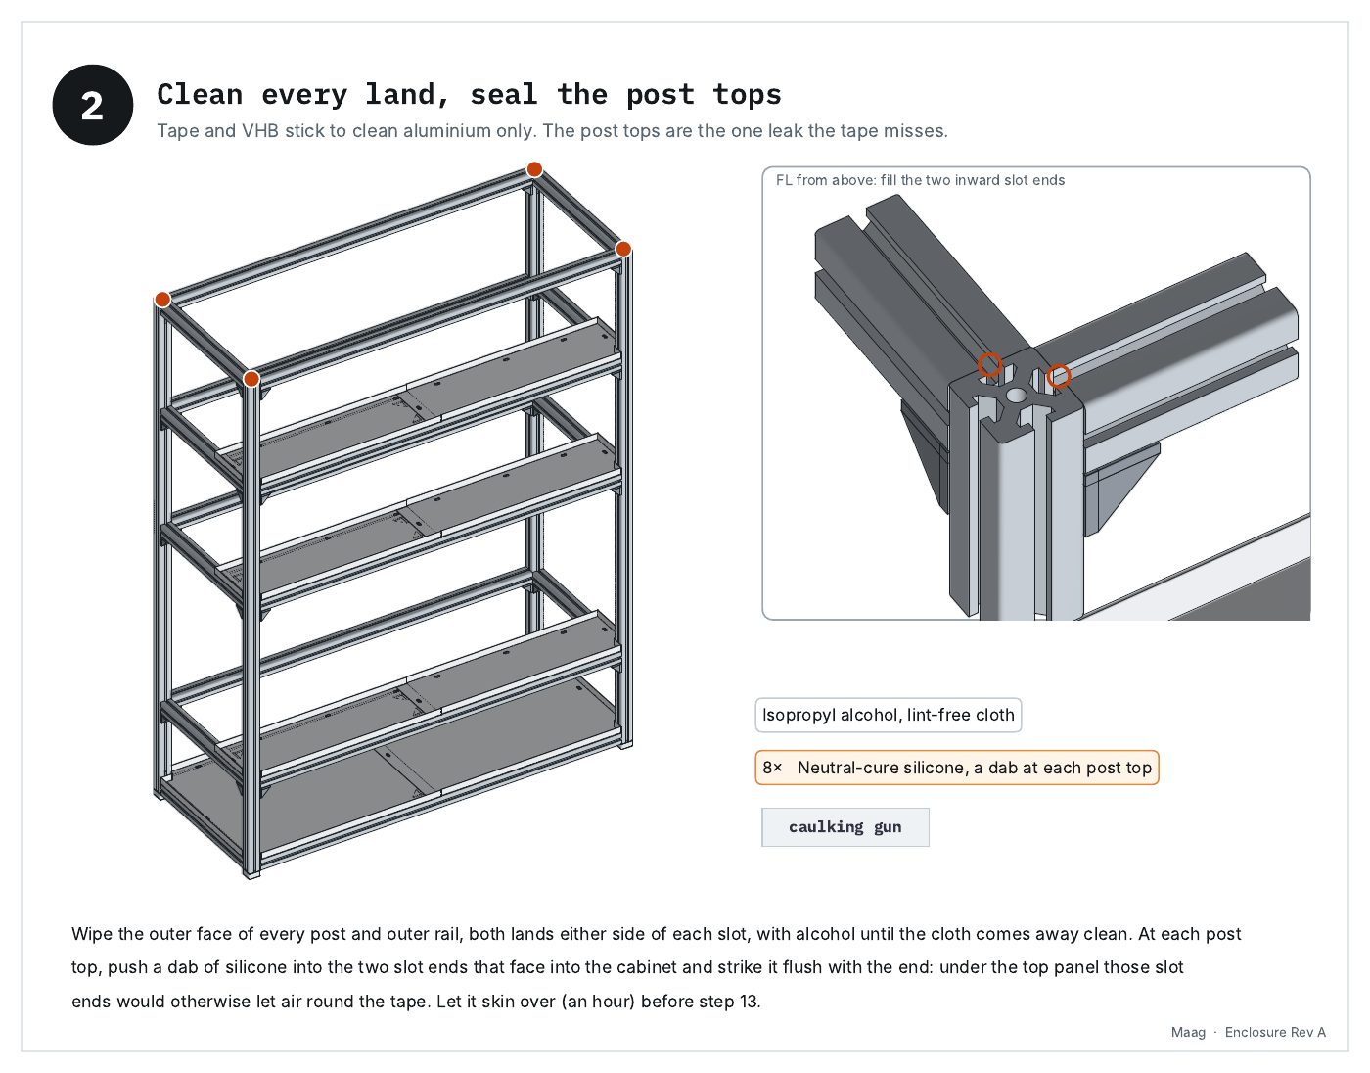
[picture p143: docs/booklets/enclosure/p10.jpg]
Enclosure Rev A, page 10: Clean every land, seal the post tops


### 11 · Step 3 · Back · tape

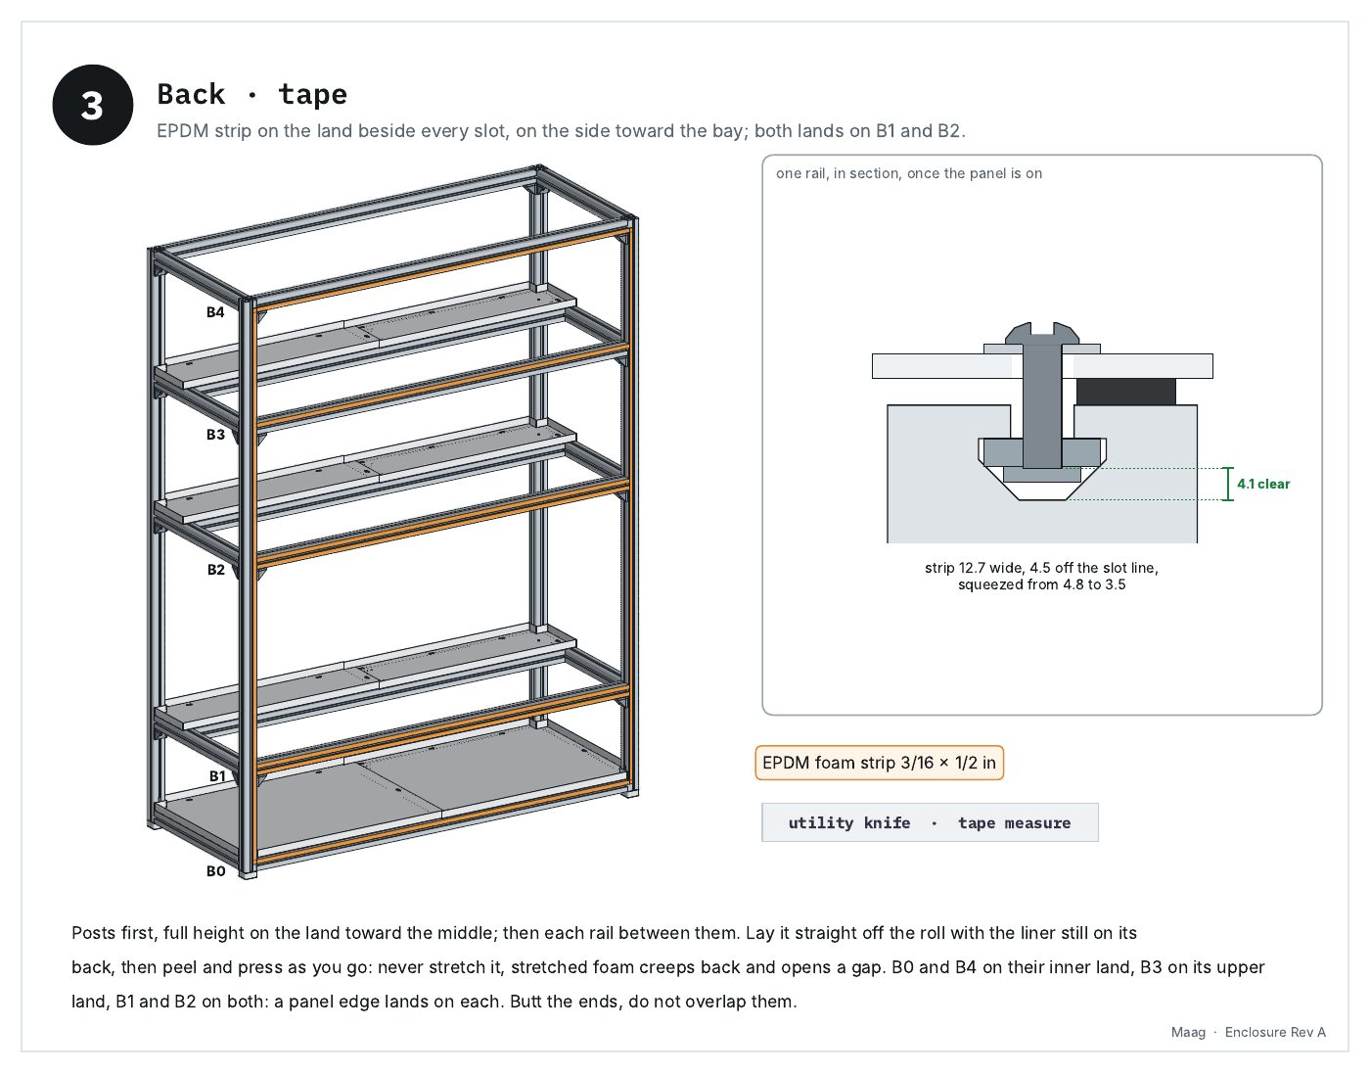
[picture p144: docs/booklets/enclosure/p11.jpg]
Enclosure Rev A, page 11: Back · tape


### 12 · Step 4 · Back · the bottom panel

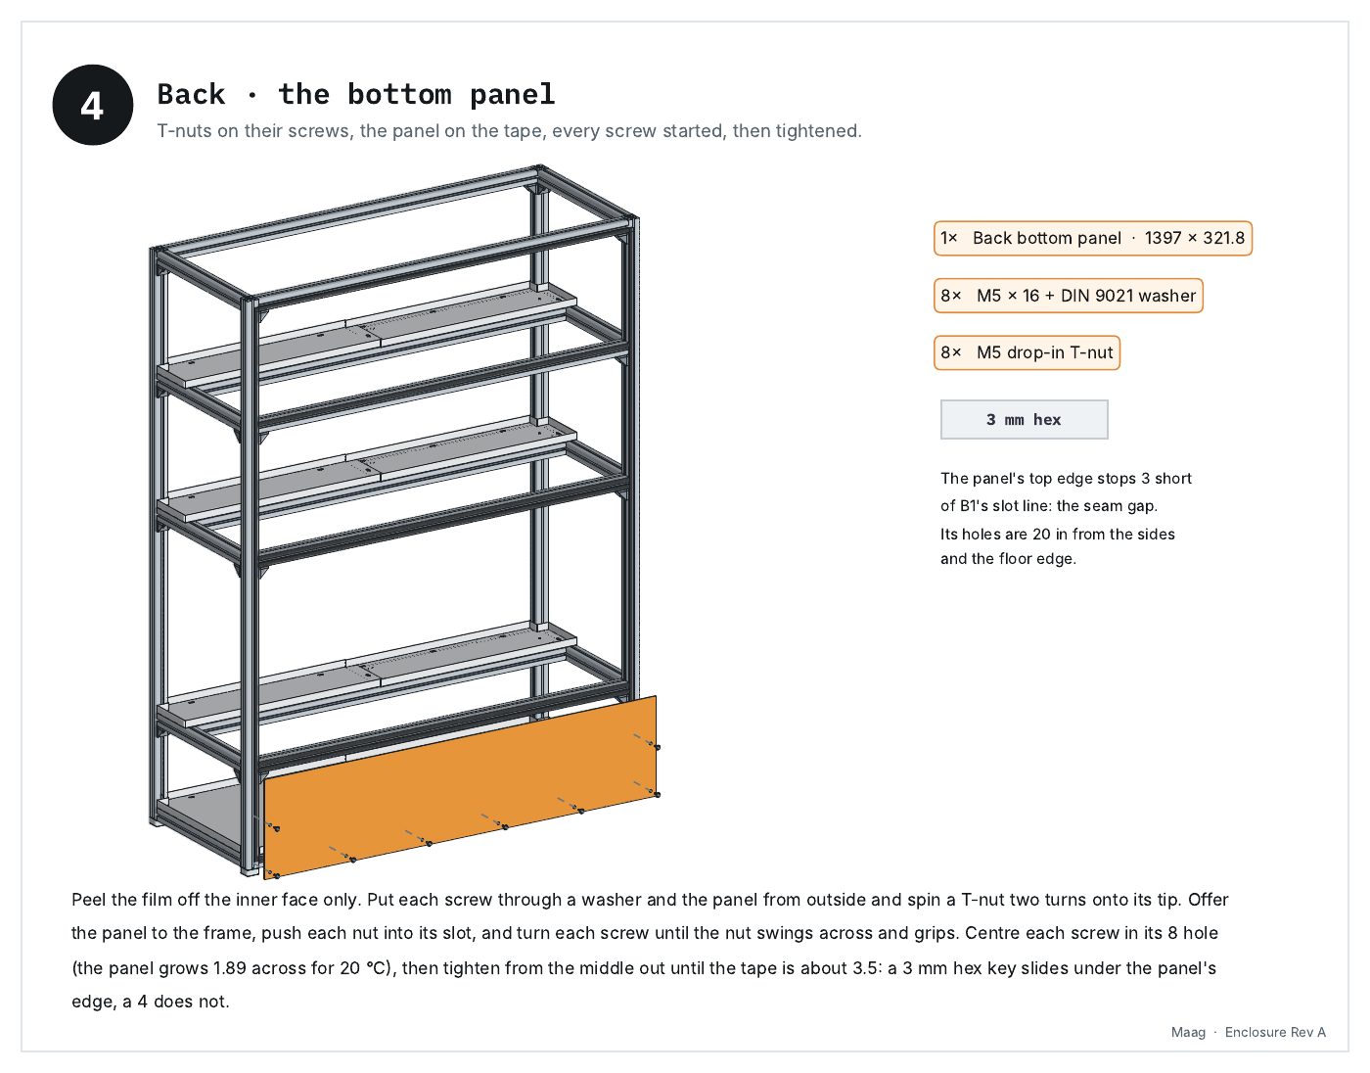
[picture p145: docs/booklets/enclosure/p12.jpg]
Enclosure Rev A, page 12: Back · the bottom panel


### 13 · Step 5 · Back · the middle and upper panels

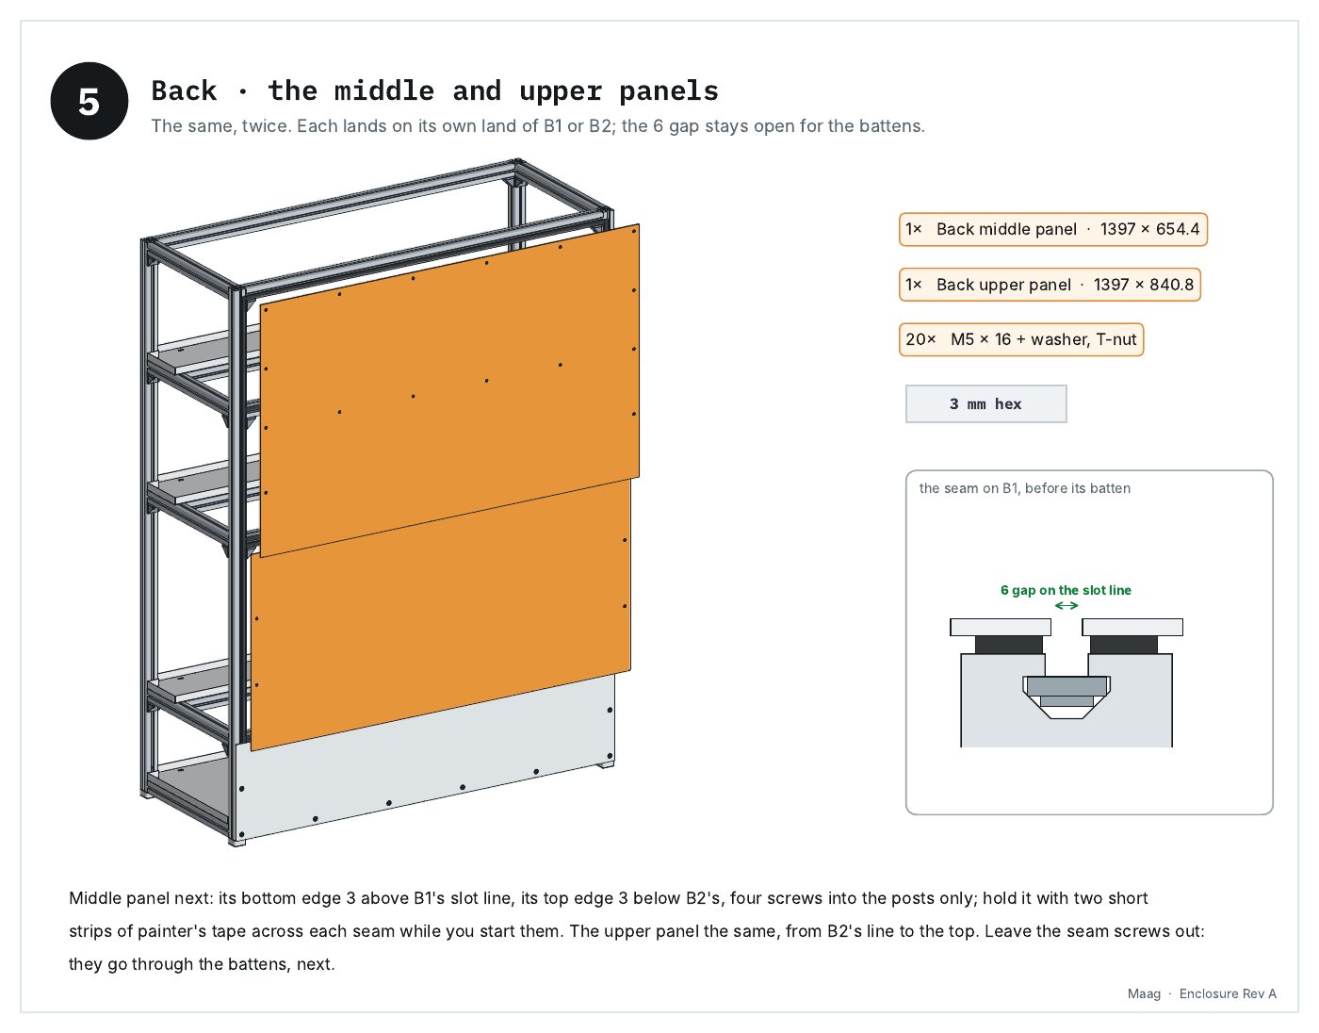
[picture p146: docs/booklets/enclosure/p13.jpg]
Enclosure Rev A, page 13: Back · the middle and upper panels


### 14 · Step 6 · Back · two battens over the seams

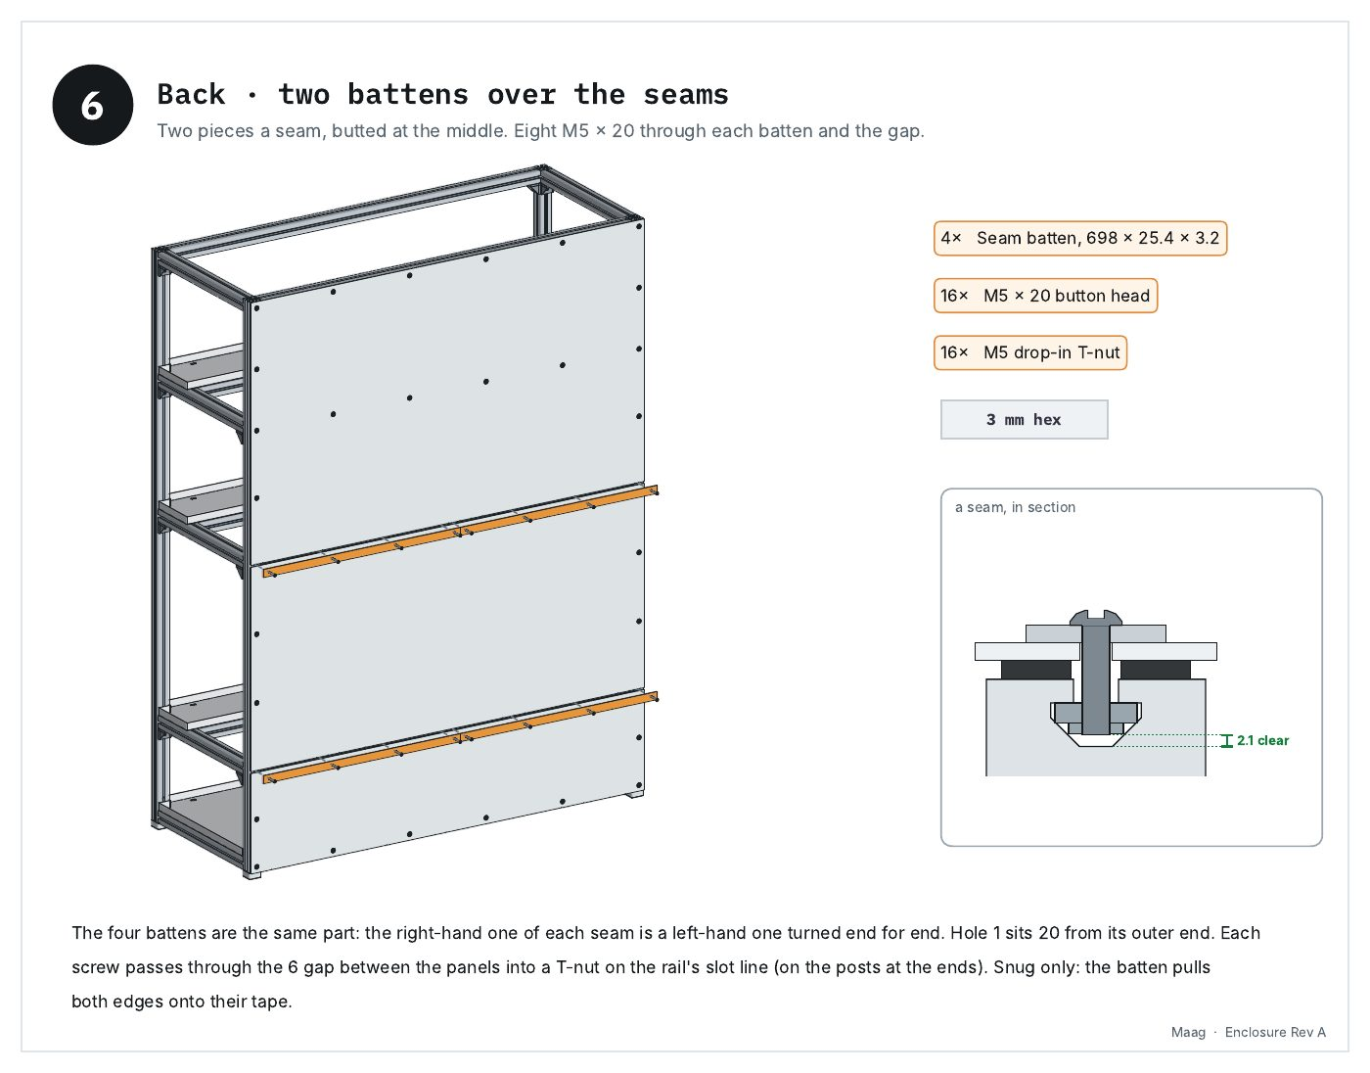
[picture p147: docs/booklets/enclosure/p14.jpg]
Enclosure Rev A, page 14: Back · two battens over the seams


### 15 · Step 7 · Right panel · on the bench first

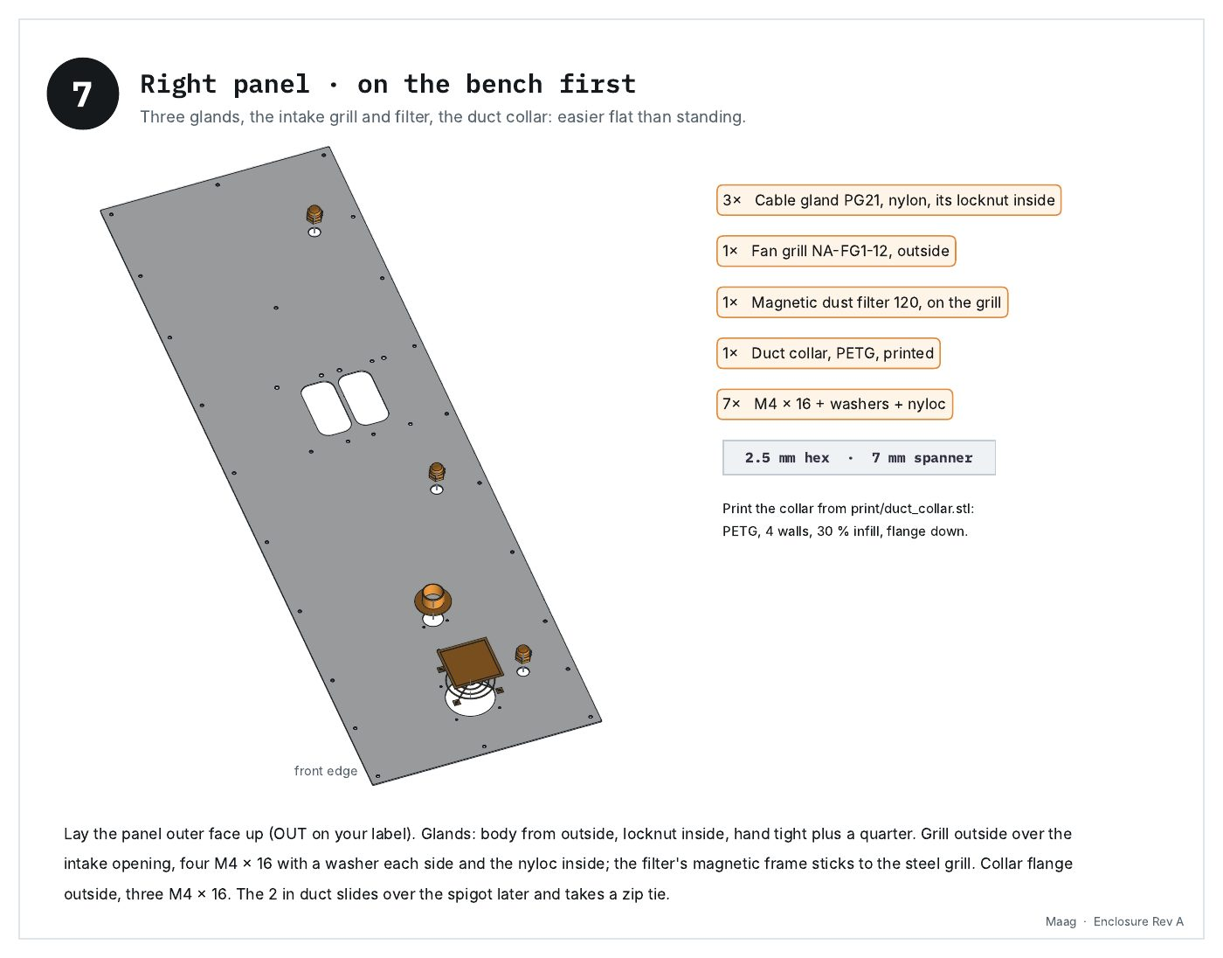
[picture p148: docs/booklets/enclosure/p15.jpg]
Enclosure Rev A, page 15: Right panel · on the bench first


### 16 · Step 8 · Right panel · tape, then the panel

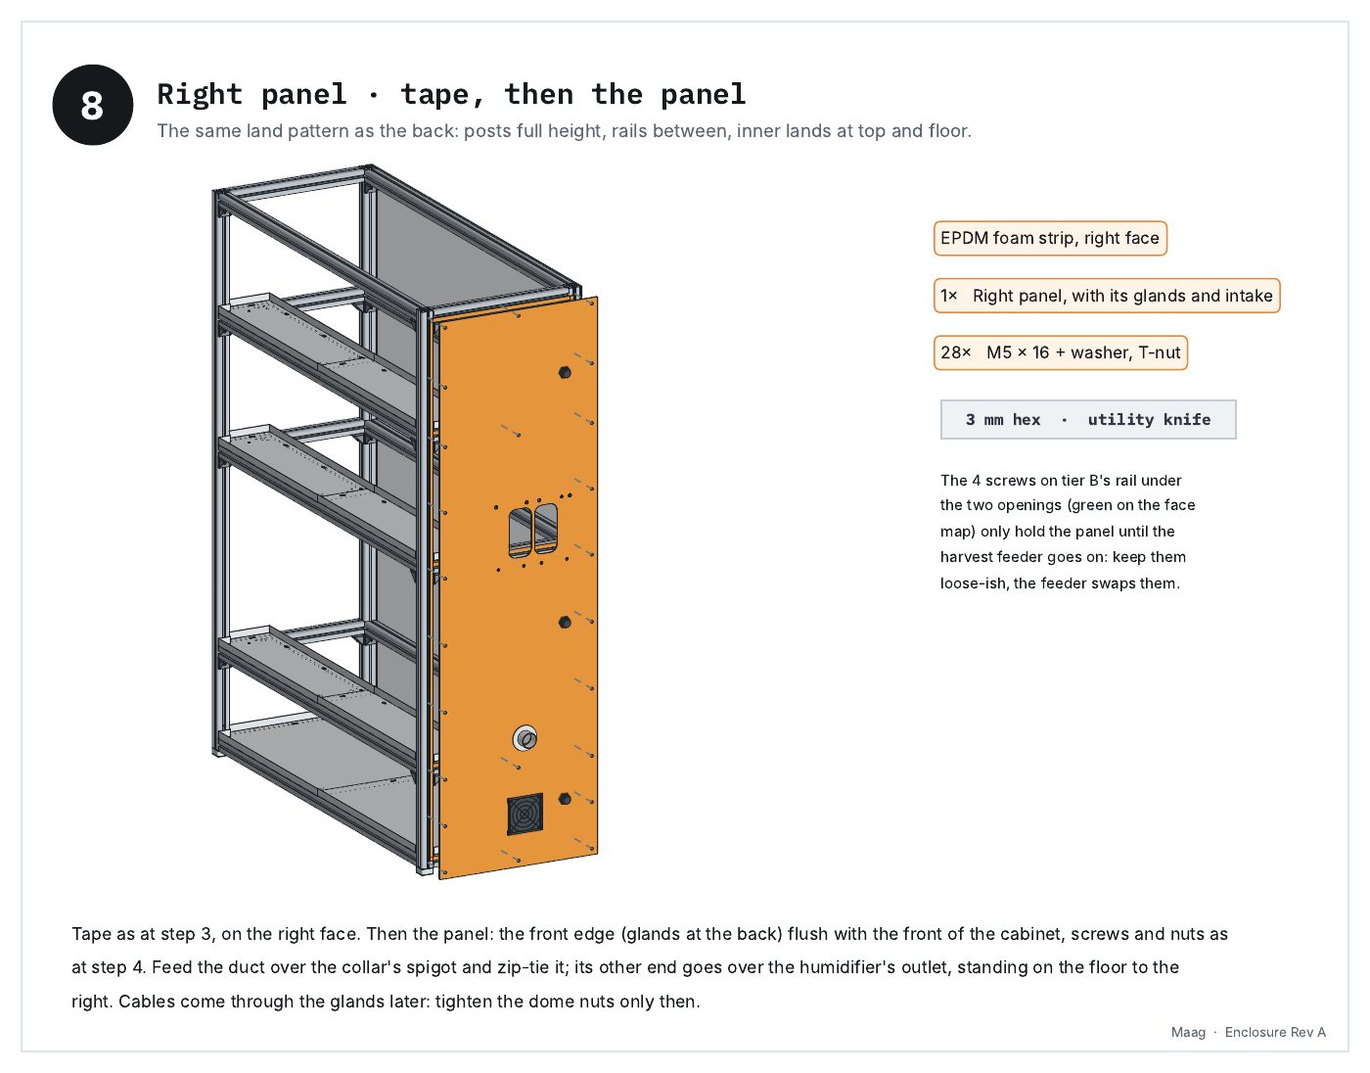
[picture p149: docs/booklets/enclosure/p16.jpg]
Enclosure Rev A, page 16: Right panel · tape, then the panel


### 17 · Step 9 · Left side · take the riser off the post

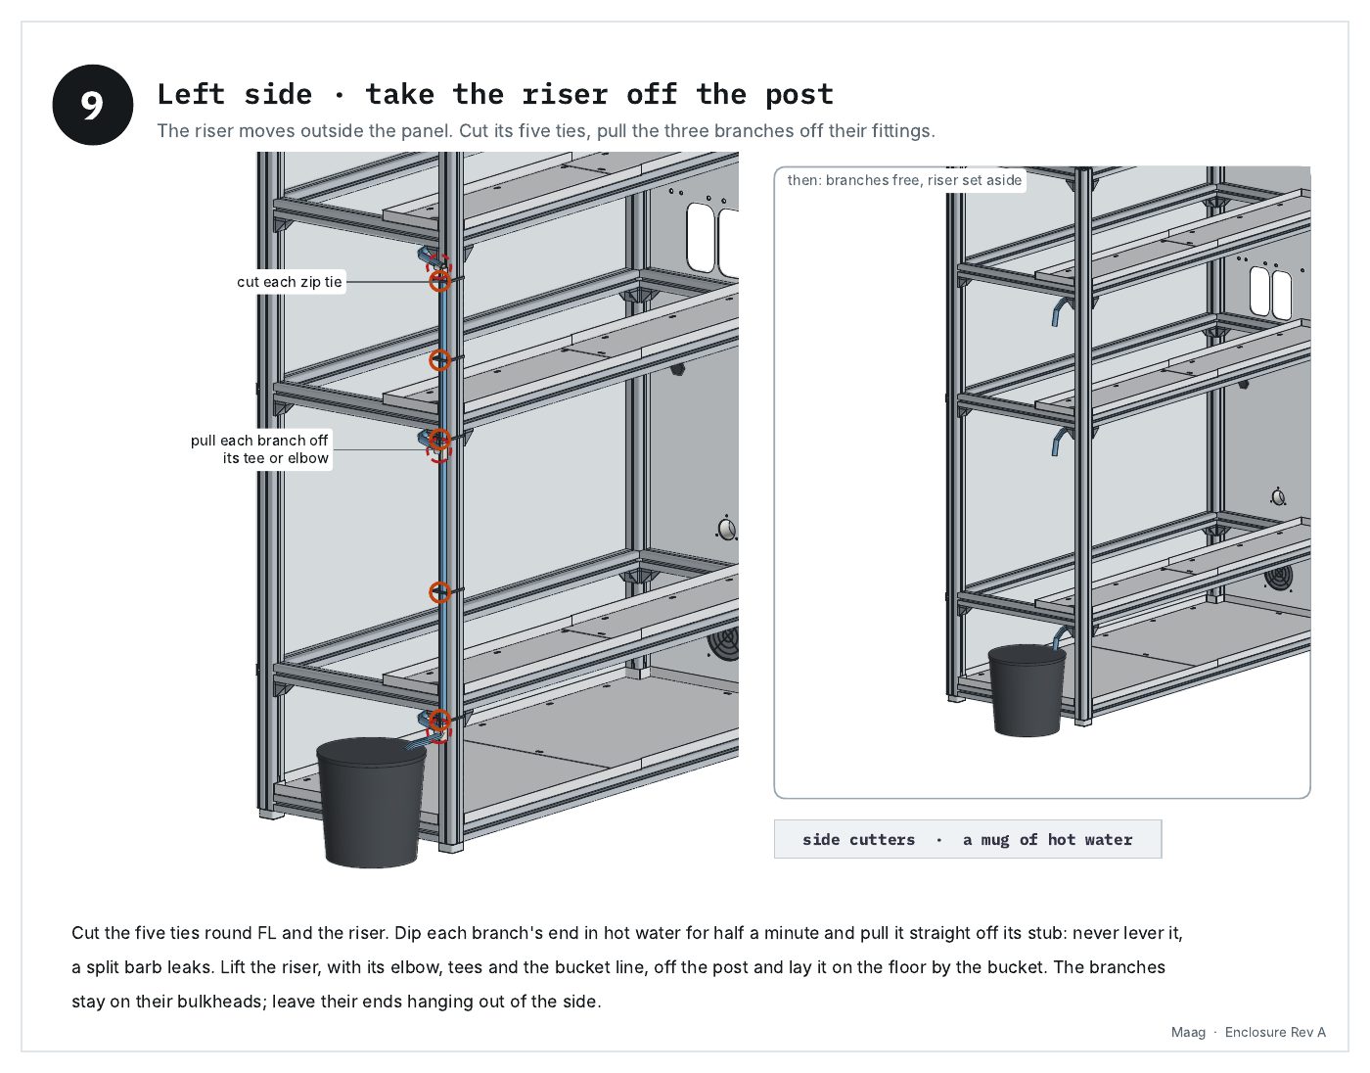
[picture p150: docs/booklets/enclosure/p17.jpg]
Enclosure Rev A, page 17: Left side · take the riser off the post


### 18 · Step 10 · Left side · tape, grommets, the panel

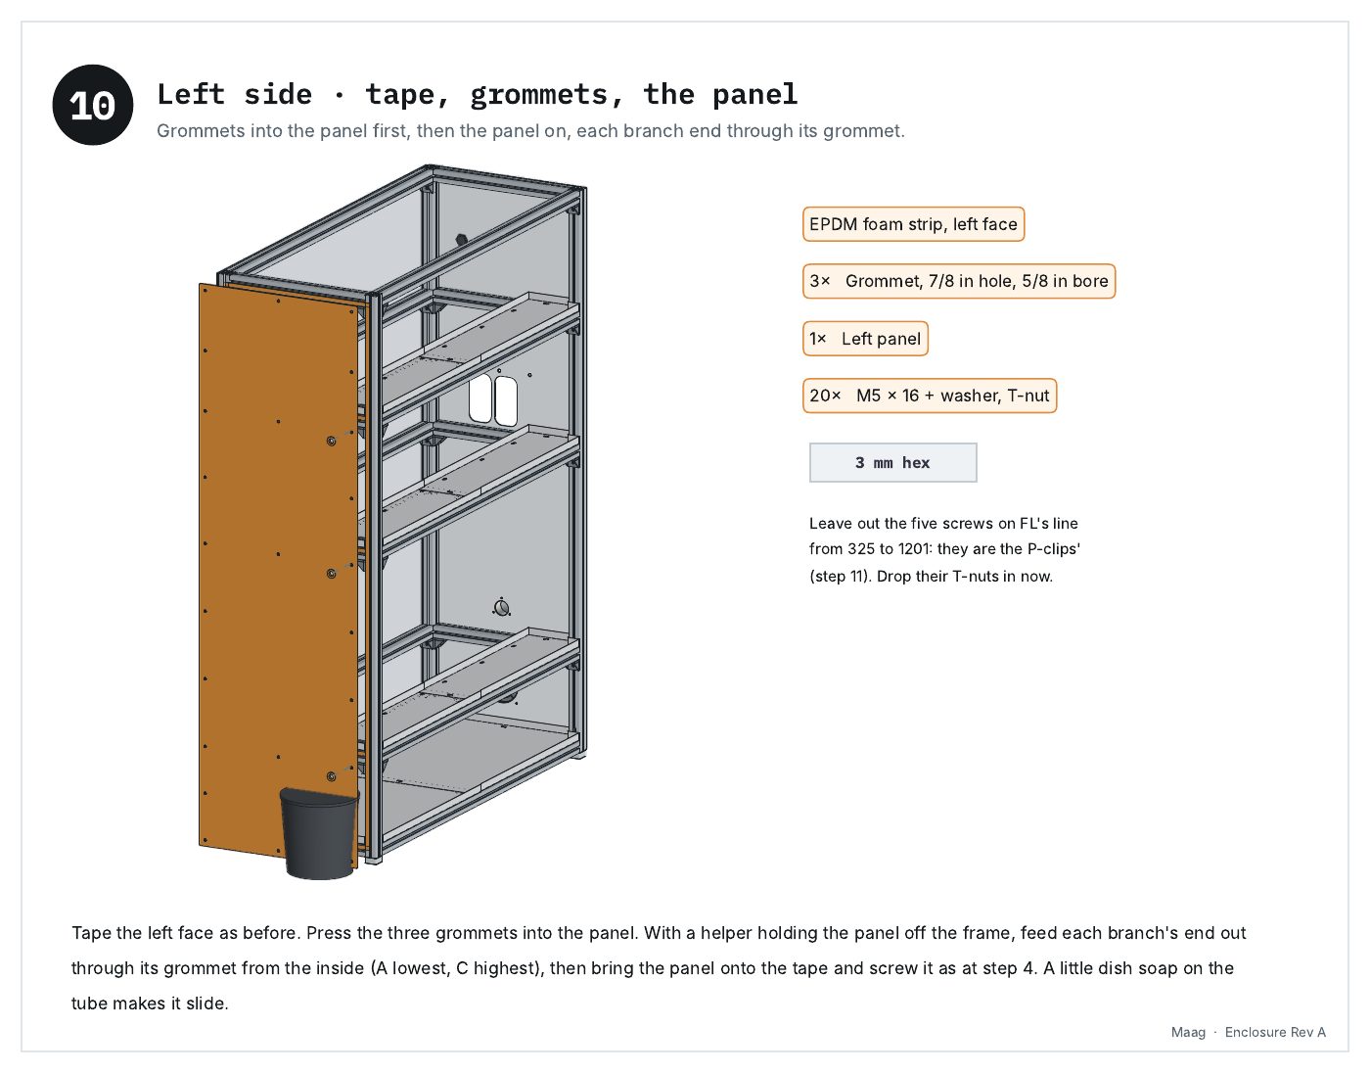
[picture p151: docs/booklets/enclosure/p18.jpg]
Enclosure Rev A, page 18: Left side · tape, grommets, the panel


### 19 · Step 11 · Left side · the riser on its P-clips

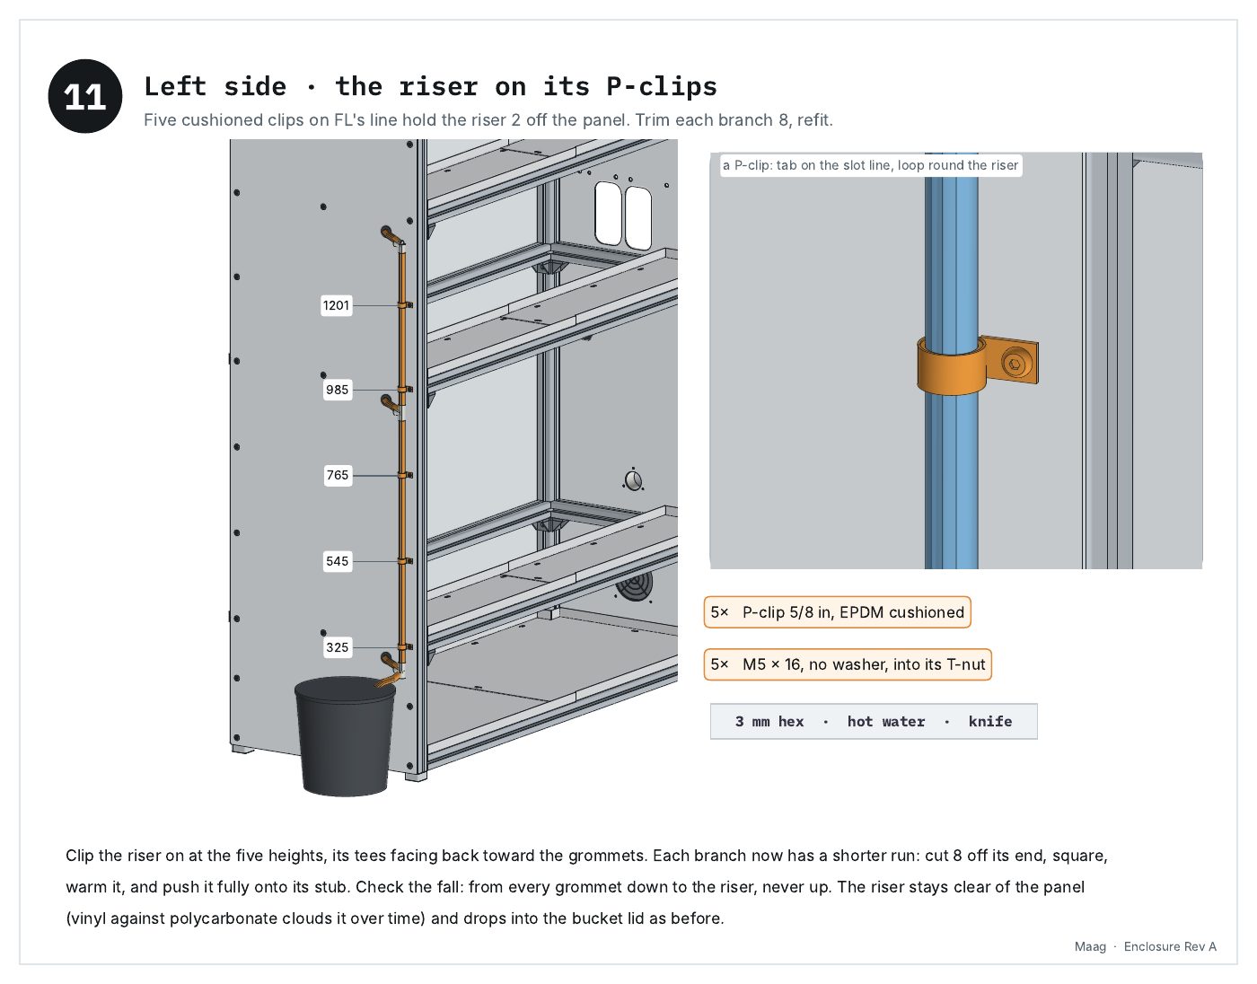
[picture p152: docs/booklets/enclosure/p19.jpg]
Enclosure Rev A, page 19: Left side · the riser on its P-clips


### 20 · Step 12 · Top panel · fans on the bench

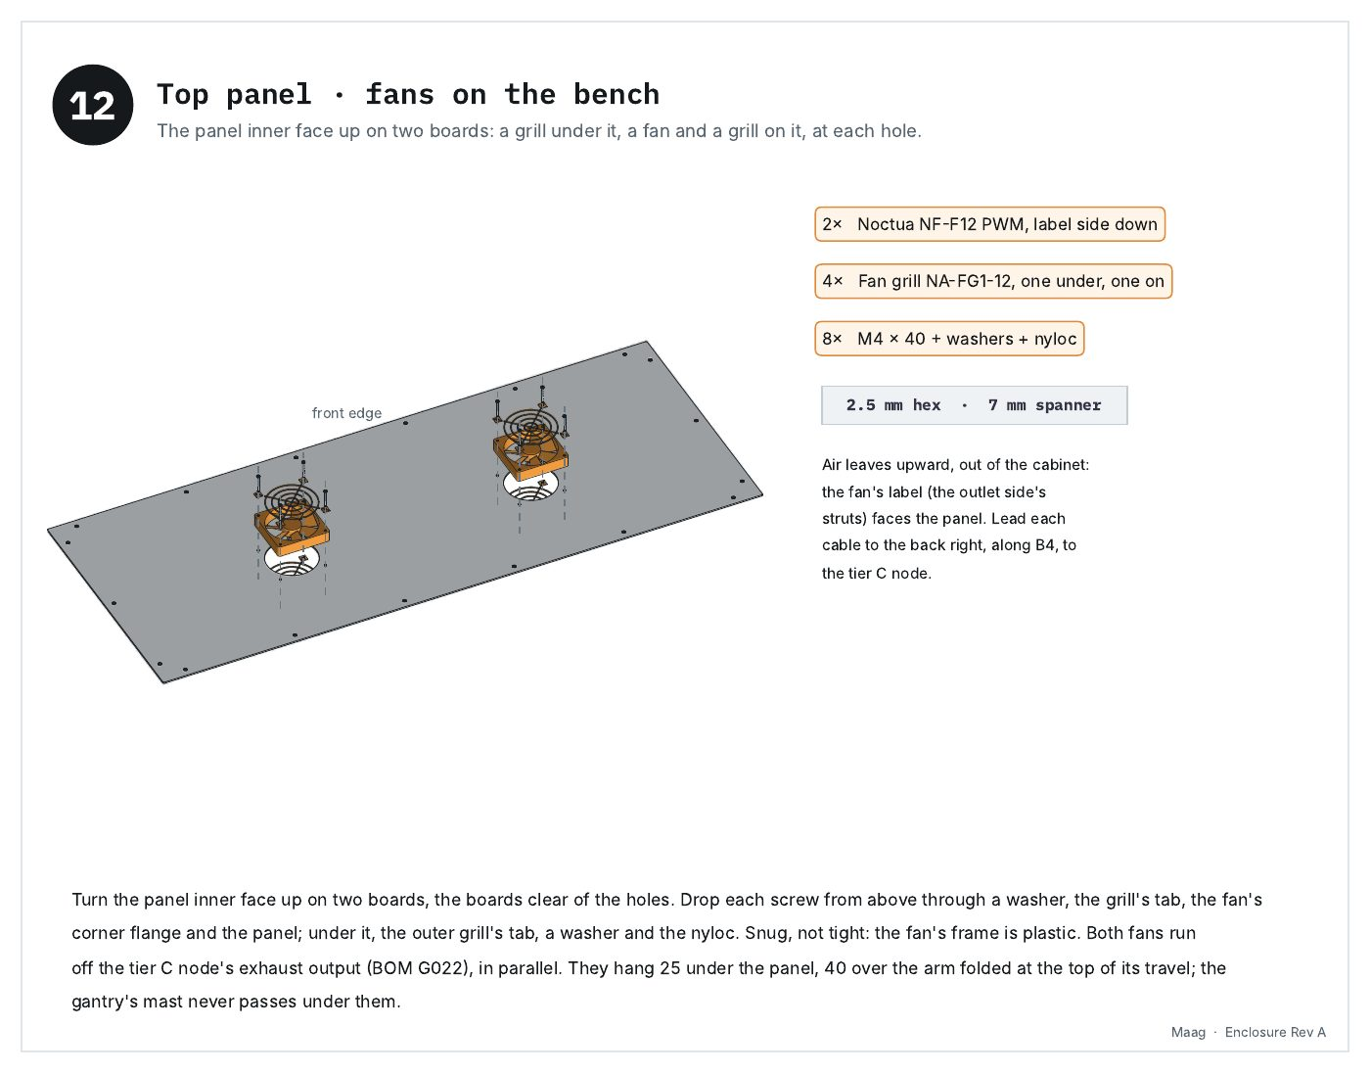
[picture p153: docs/booklets/enclosure/p20.jpg]
Enclosure Rev A, page 20: Top panel · fans on the bench


### 21 · Step 13 · Top panel · on, and anchored to the wall

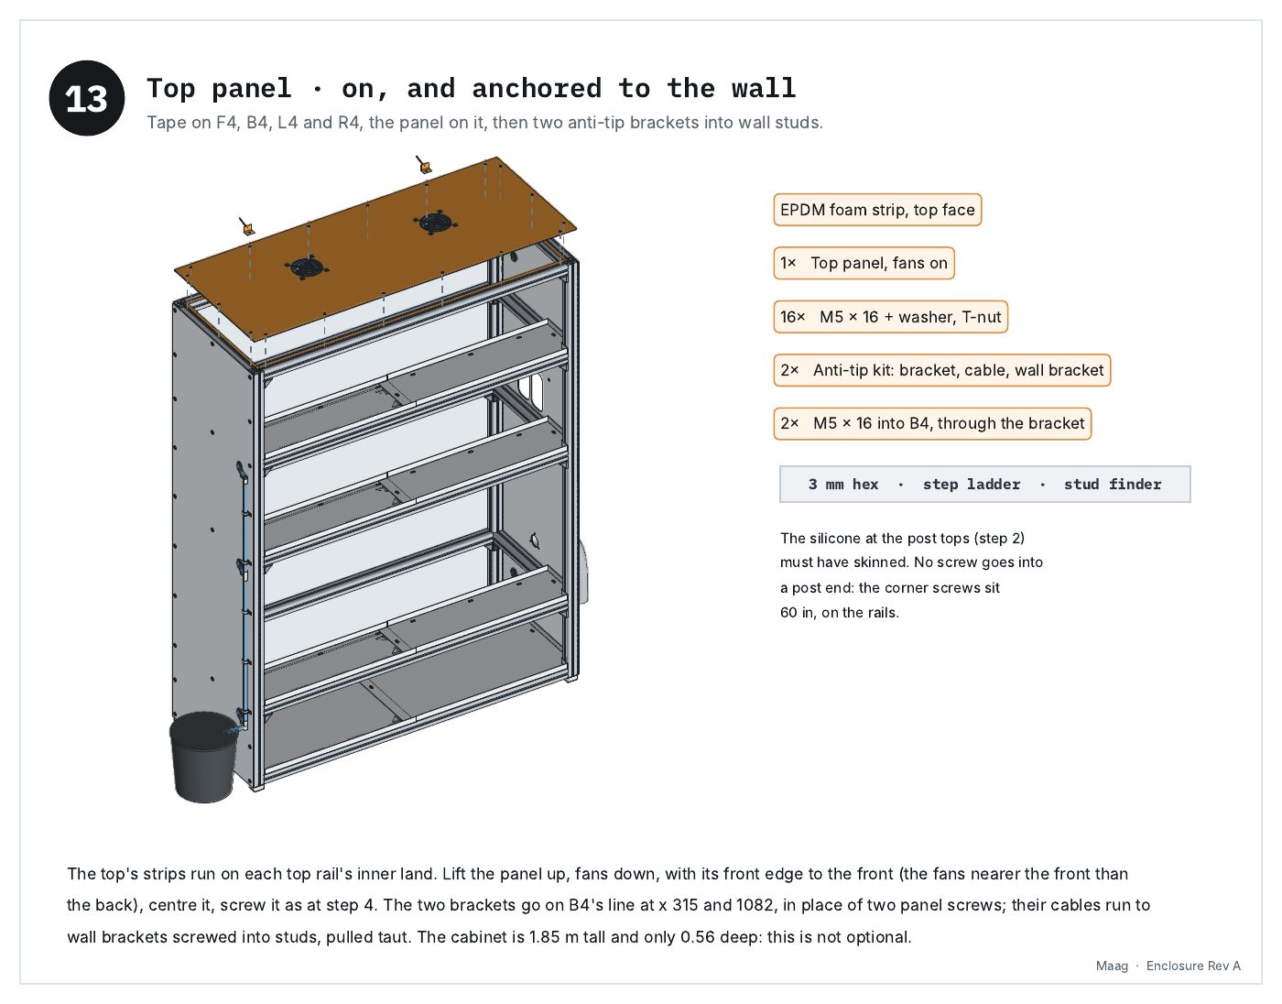
[picture p154: docs/booklets/enclosure/p21.jpg]
Enclosure Rev A, page 21: Top panel · on, and anchored to the wall


### 22 · Step 14 · Doors · on the bench

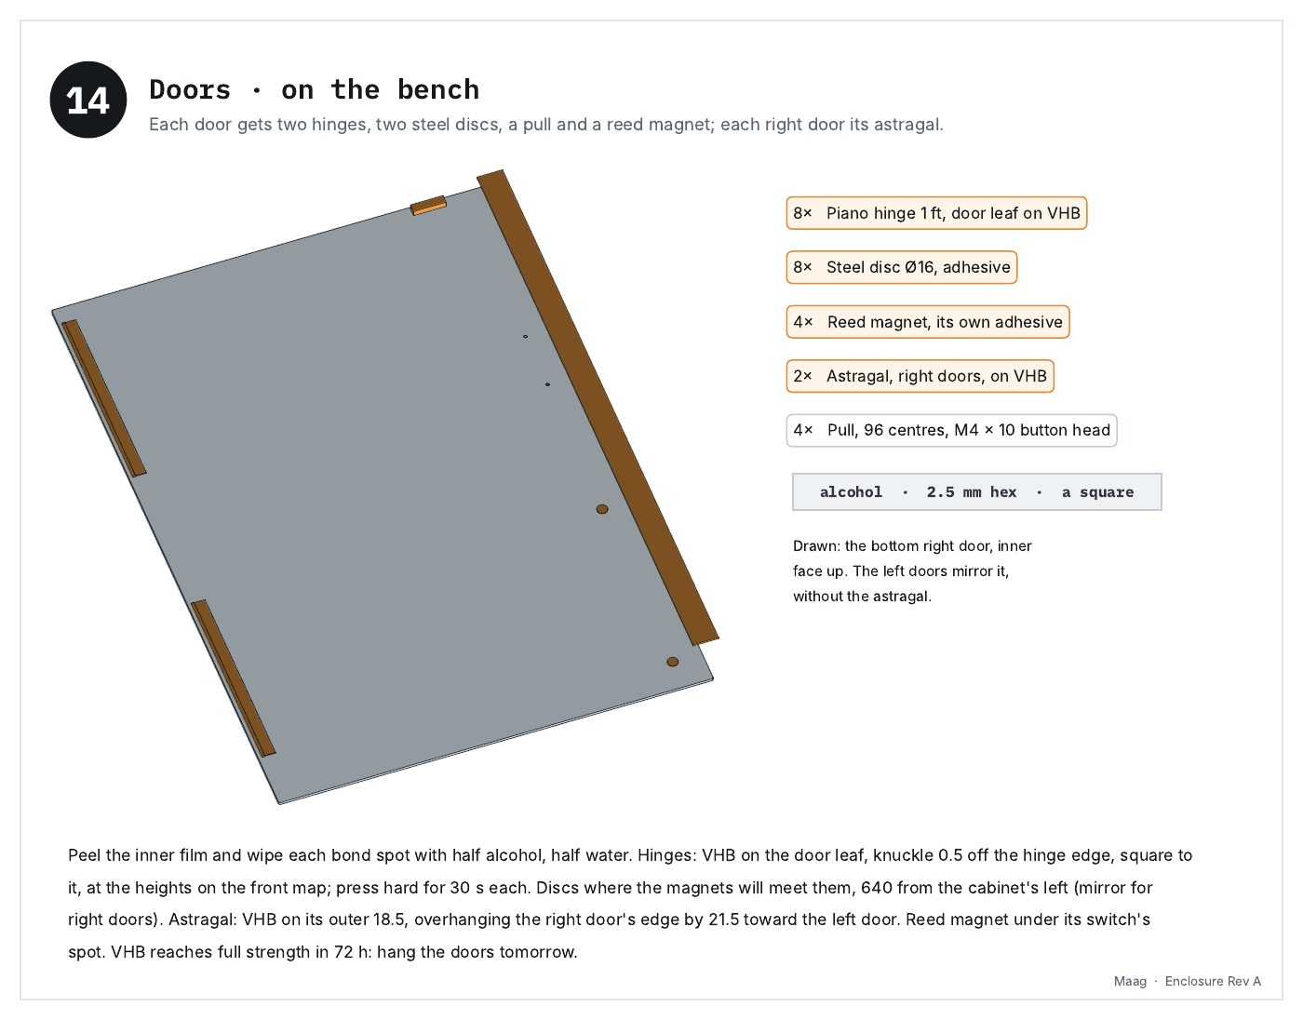
[picture p155: docs/booklets/enclosure/p22.jpg]
Enclosure Rev A, page 22: Doors · on the bench


### 23 · Step 15 · Front · weatherstrip, magnets, switches

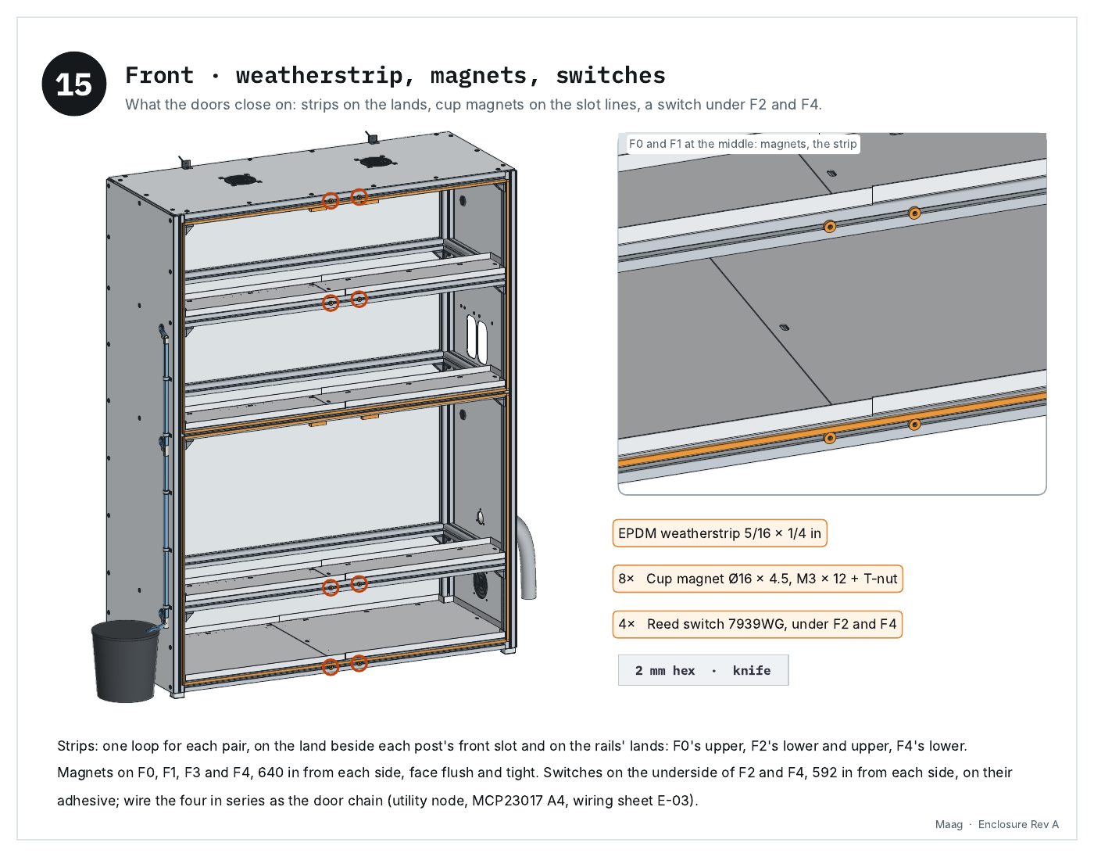
[picture p156: docs/booklets/enclosure/p23.jpg]
Enclosure Rev A, page 23: Front · weatherstrip, magnets, switches


### 24 · Step 16 · Front · hang the doors

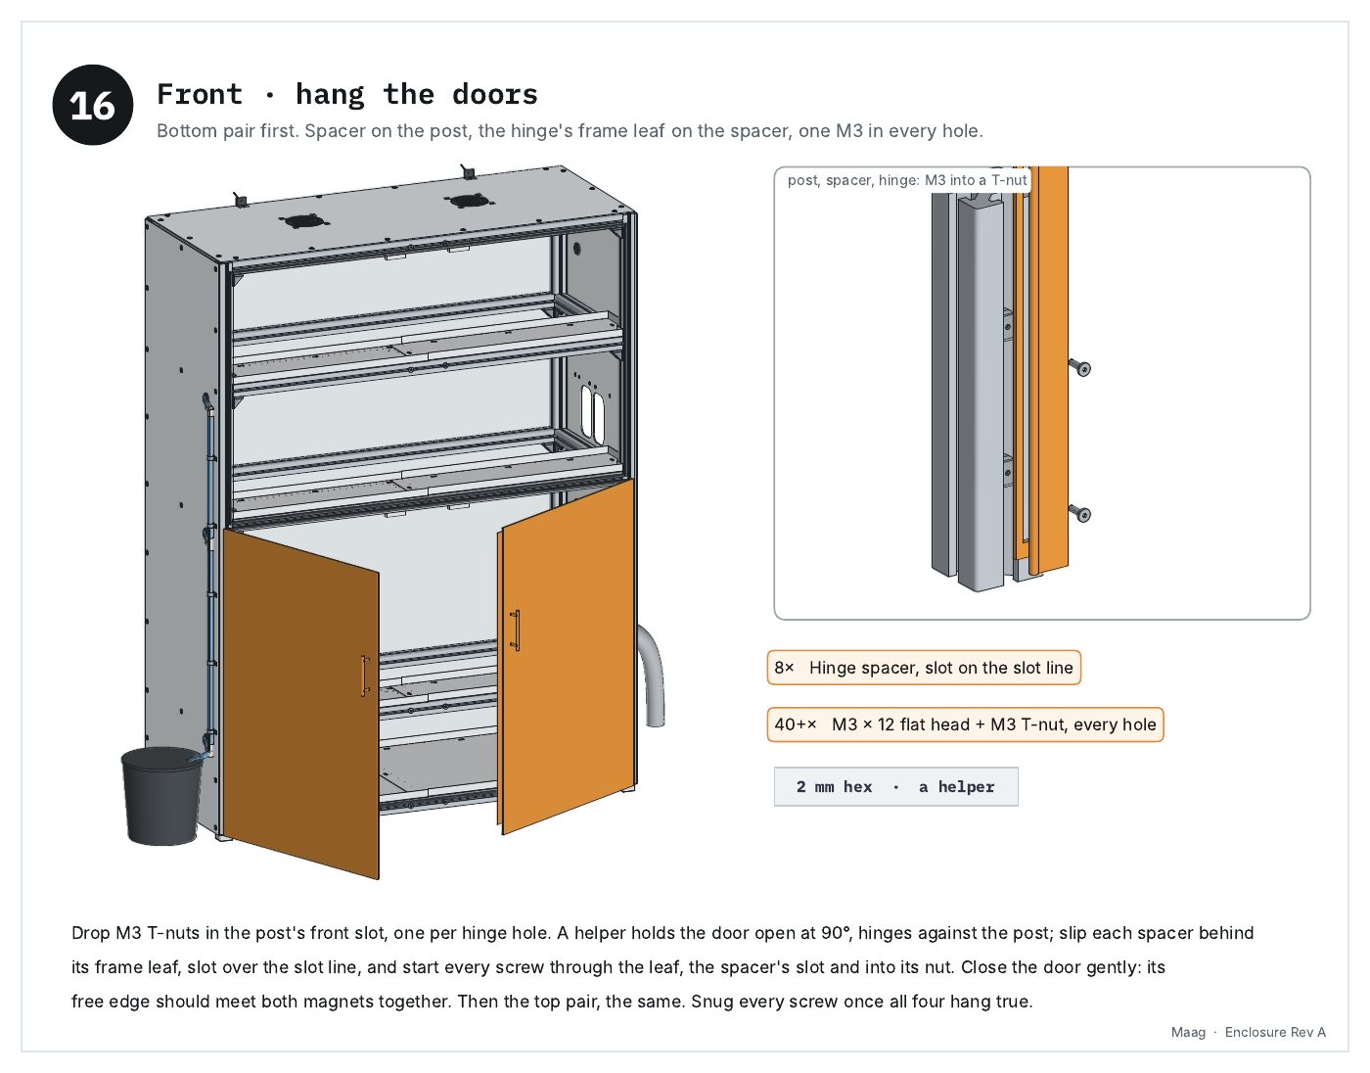
[picture p157: docs/booklets/enclosure/p24.jpg]
Enclosure Rev A, page 24: Front · hang the doors


### 25 · Step 17 · Doors · adjust and check

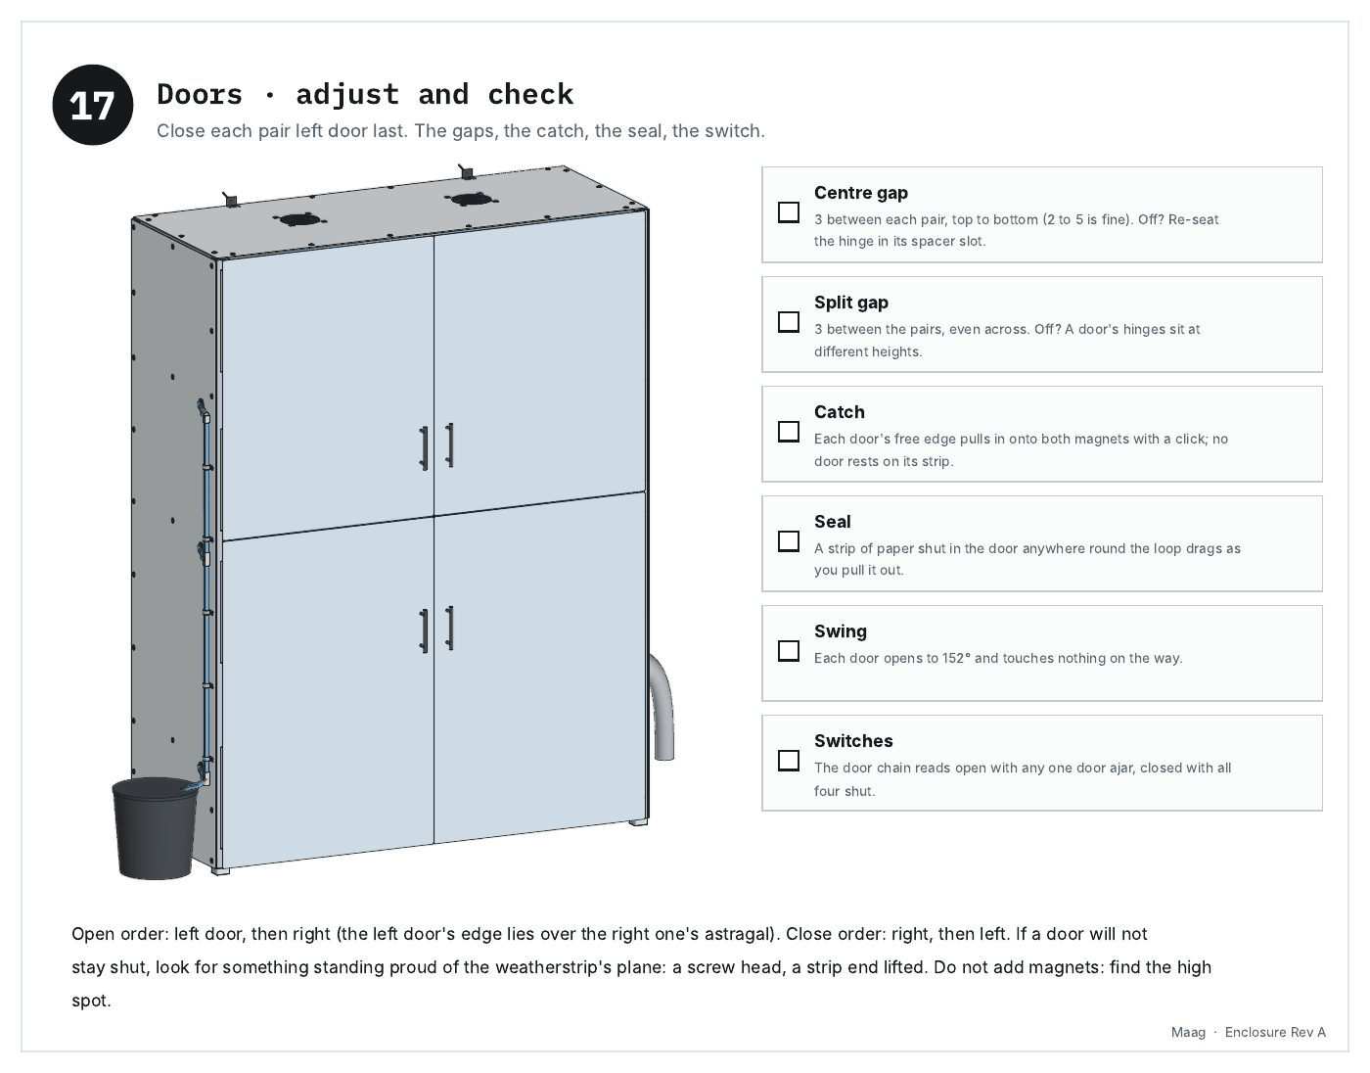
[picture p158: docs/booklets/enclosure/p25.jpg]
Enclosure Rev A, page 25: Doors · adjust and check


### 26 · Step 18 · Before you plant

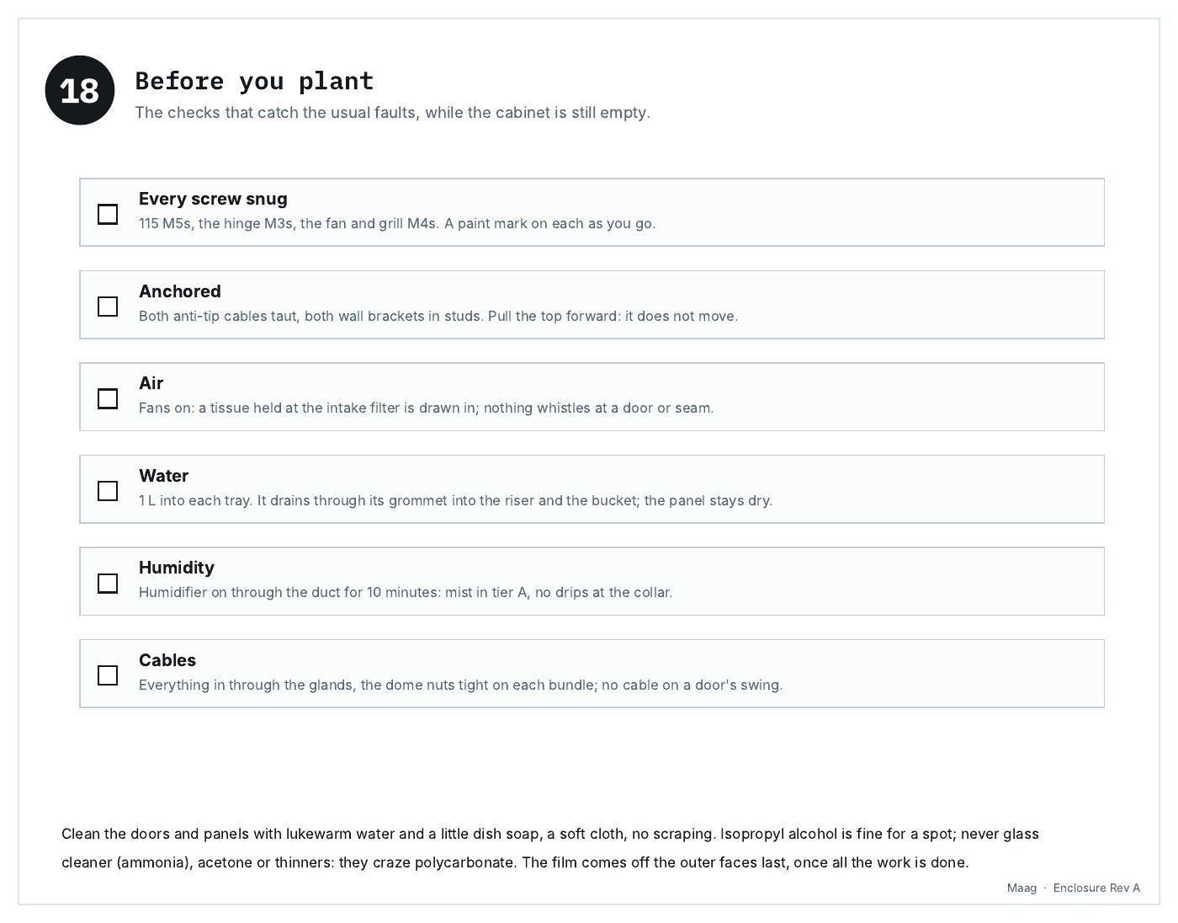
[picture p159: docs/booklets/enclosure/p26.jpg]
Enclosure Rev A, page 26: Before you plant


---

[All booklets](README.md) · previous: [Gantry Rev E](gantry.md) · next: [Harvest Rev B](harvest.md)
