v1proxy/RedTower/docs/booklets/frame.md

# Frame Rev A, page by page

<!-- generated by greenhouse/booklet/make_gallery.py from greenhouse/frame/Maag_Frame_Assembly_Instructions_RevA.pdf: do not edit -->

The cabinet: 4040 extrusion, the trays, the base pan and the drains. 26 pages, 21 steps. Each page below is the PDF's own page as an image; click one for full size.

[PDF](../../greenhouse/frame/Maag_Frame_Assembly_Instructions_RevA.pdf) · [Guide](../../greenhouse/frame/FRAME_ASSEMBLY.md) · [All booklets](README.md) · next: [Gantry Rev E](gantry.md)

<details><summary><b>Contents</b>, 26 pages</summary>

- [1 · Cover](#1--cover)
- [2 · Frame and trays · parts](#2--frame-and-trays--parts)
- [3 · Frame and trays · fasteners](#3--frame-and-trays--fasteners)
- [4 · Tools](#4--tools)
- [5 · Every joint, and what holds it](#5--every-joint-and-what-holds-it)
- [6 · Step 1 · Know your profile](#6--step-1--know-your-profile)
- [7 · Step 2 · Cut and label](#7--step-2--cut-and-label)
- [8 · Step 3 · Mark the levels](#8--step-3--mark-the-levels)
- [9 · Step 4 · Print the feet](#9--step-4--print-the-feet)
- [10 · Step 5 · The base · front, back and the mid rail](#10--step-5--the-base--front-back-and-the-mid-rail)
- [11 · Step 6 · Hidden connectors in the eight floor ends](#11--step-6--hidden-connectors-in-the-eight-floor-ends)
- [12 · Step 7 · Stand the posts](#12--step-7--stand-the-posts)
- [13 · Step 8 · Ledges for the top](#13--step-8--ledges-for-the-top)
- [14 · Step 9 · The top ring](#14--step-9--the-top-ring)
- [15 · Step 10 · Square it, then tighten](#15--step-10--square-it-then-tighten)
- [16 · Step 11 · Tier A · eight ledges](#16--step-11--tier-a--eight-ledges)
- [17 · Step 12 · Tier A · front, back and side rails](#17--step-12--tier-a--front-back-and-side-rails)
- [18 · Step 13 · Tier A · the tray rails](#18--step-13--tier-a--the-tray-rails)
- [19 · Step 14 · Tiers B and C · the same three steps](#19--step-14--tiers-b-and-c--the-same-three-steps)
- [20 · Step 15 · The feet](#20--step-15--the-feet)
- [21 · Step 16 · The sheets · check, drill, seal](#21--step-16--the-sheets--check-drill-seal)
- [22 · Step 17 · Base pan · T-nuts, then the DOWN piece](#22--step-17--base-pan--t-nuts-then-the-down-piece)
- [23 · Step 18 · Base pan · the UP piece over the lap](#23--step-18--base-pan--the-up-piece-over-the-lap)
- [24 · Step 19 · Trays · the same, three times](#24--step-19--trays--the-same-three-times)
- [25 · Step 20 · Drains · one riser on the FL post](#25--step-20--drains--one-riser-on-the-fl-post)
- [26 · Step 21 · Before you load it](#26--step-21--before-you-load-it)

</details>

---

### 1 · Cover

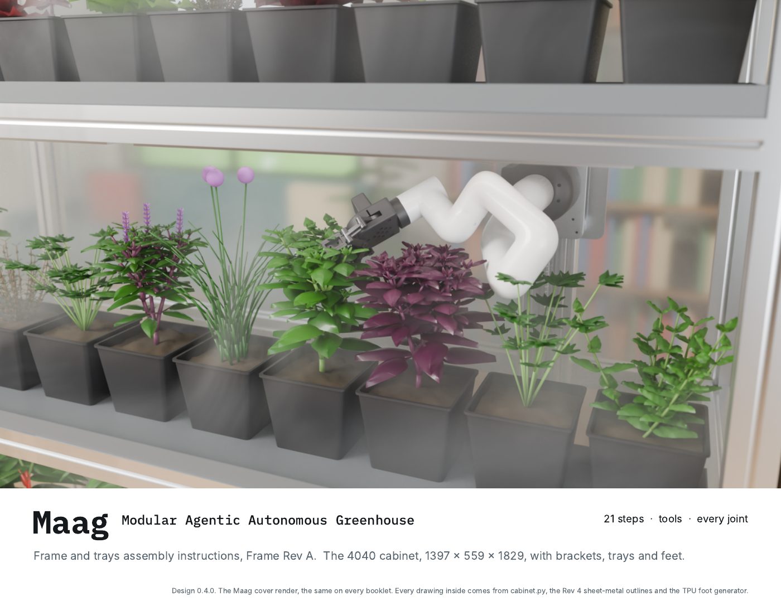
[picture p160: docs/booklets/frame/p01.jpg]
Frame Rev A, page 1: Cover


### 2 · Frame and trays · parts

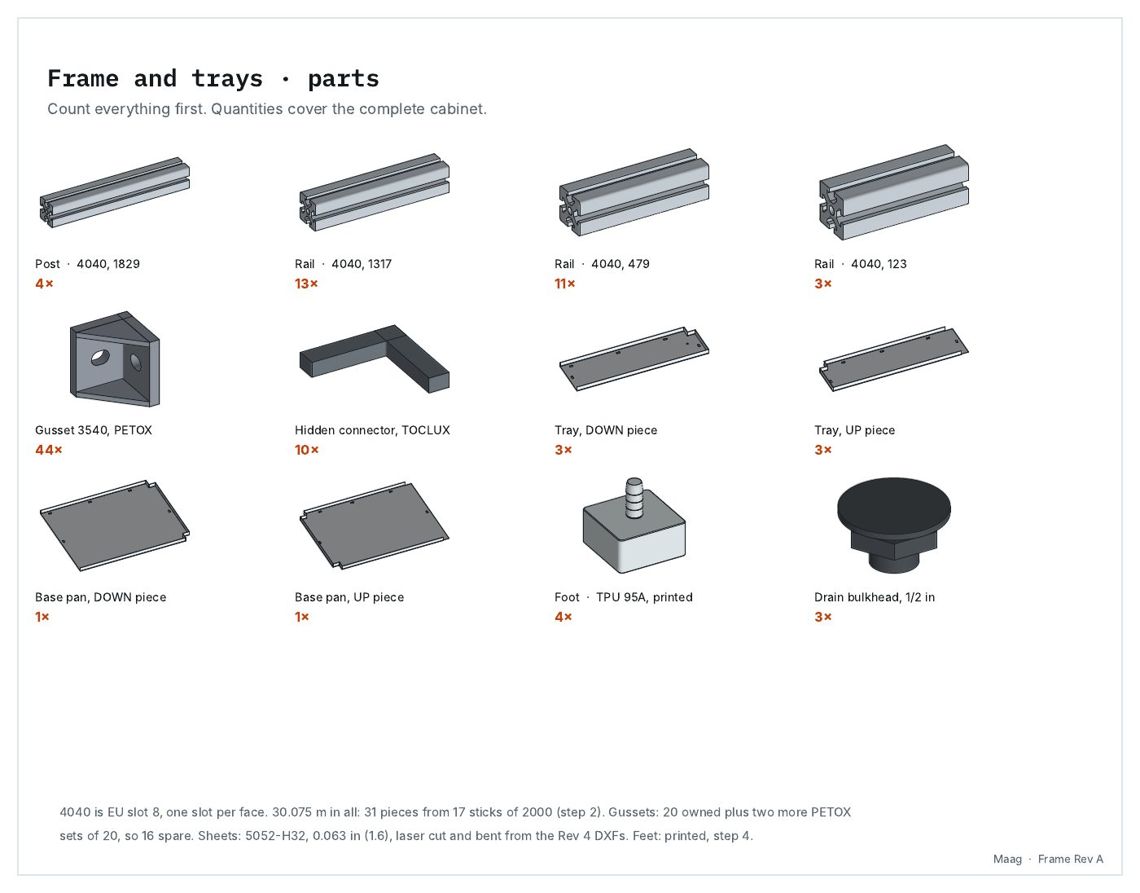
[picture p161: docs/booklets/frame/p02.jpg]
Frame Rev A, page 2: Frame and trays · parts


### 3 · Frame and trays · fasteners

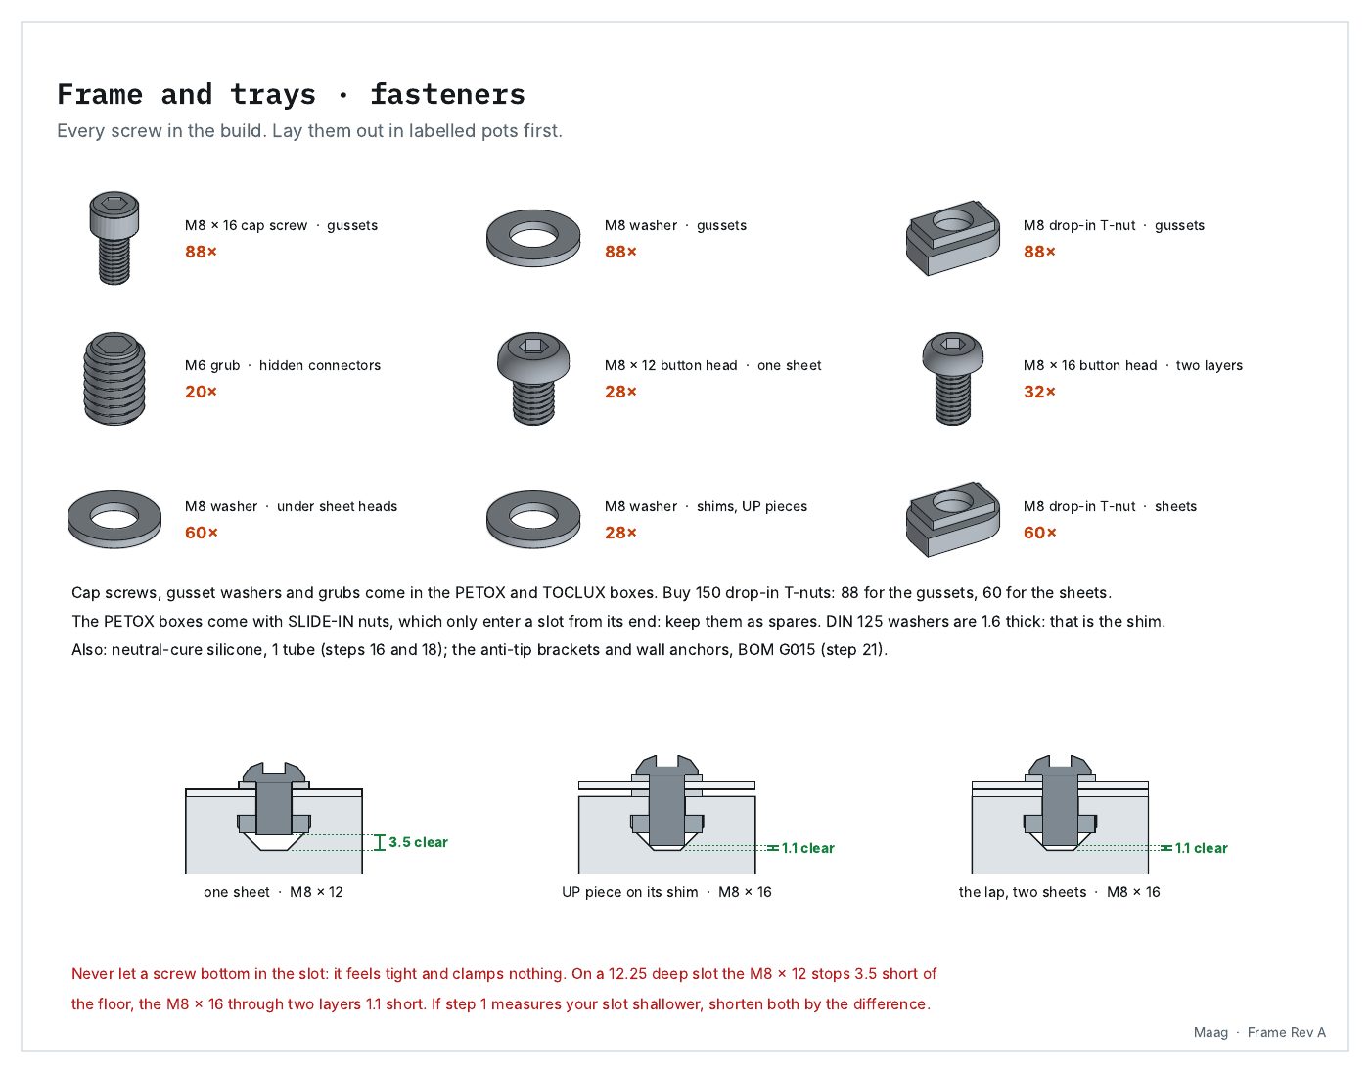
[picture p162: docs/booklets/frame/p03.jpg]
Frame Rev A, page 3: Frame and trays · fasteners


### 4 · Tools

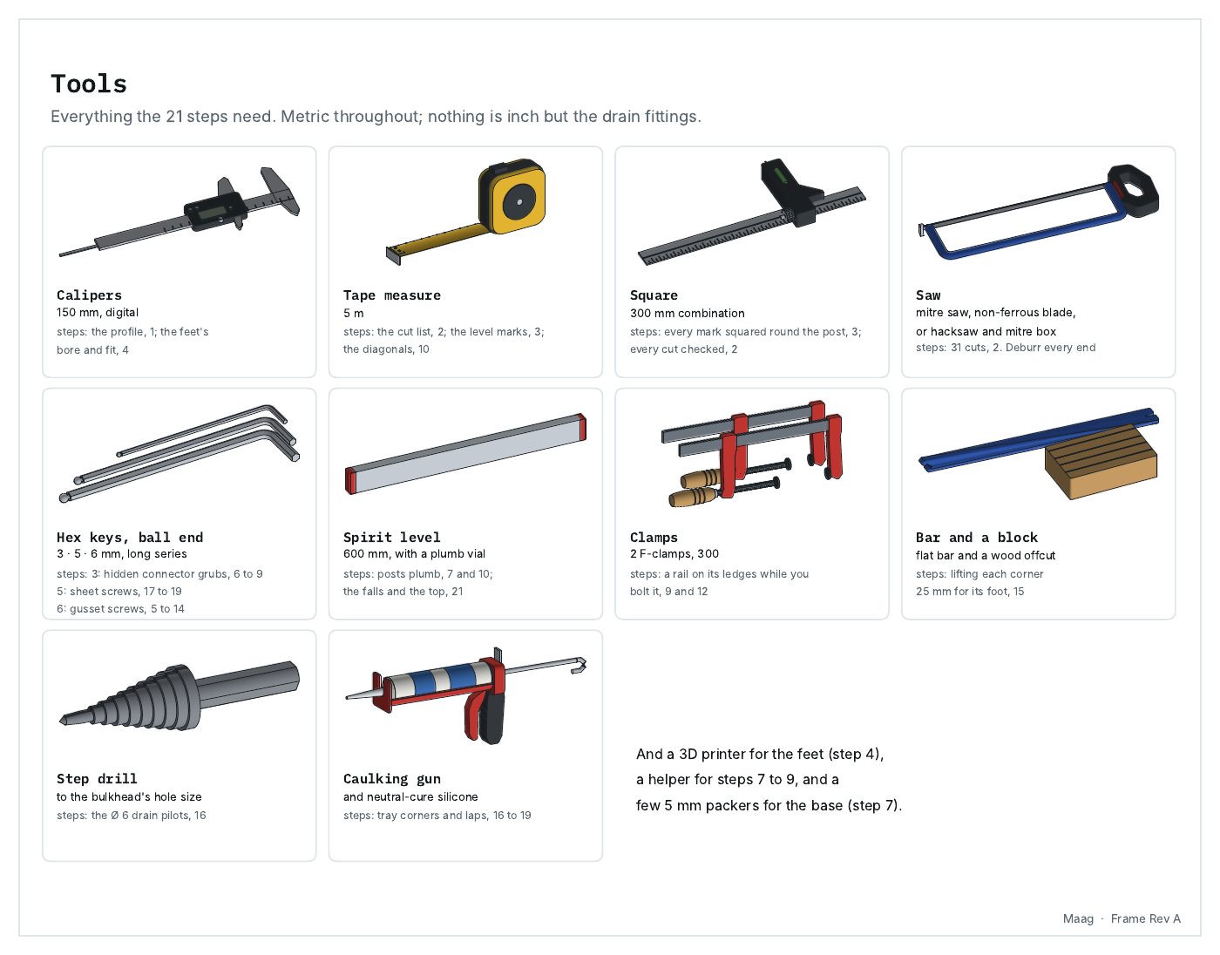
[picture p163: docs/booklets/frame/p04.jpg]
Frame Rev A, page 4: Tools


### 5 · Every joint, and what holds it

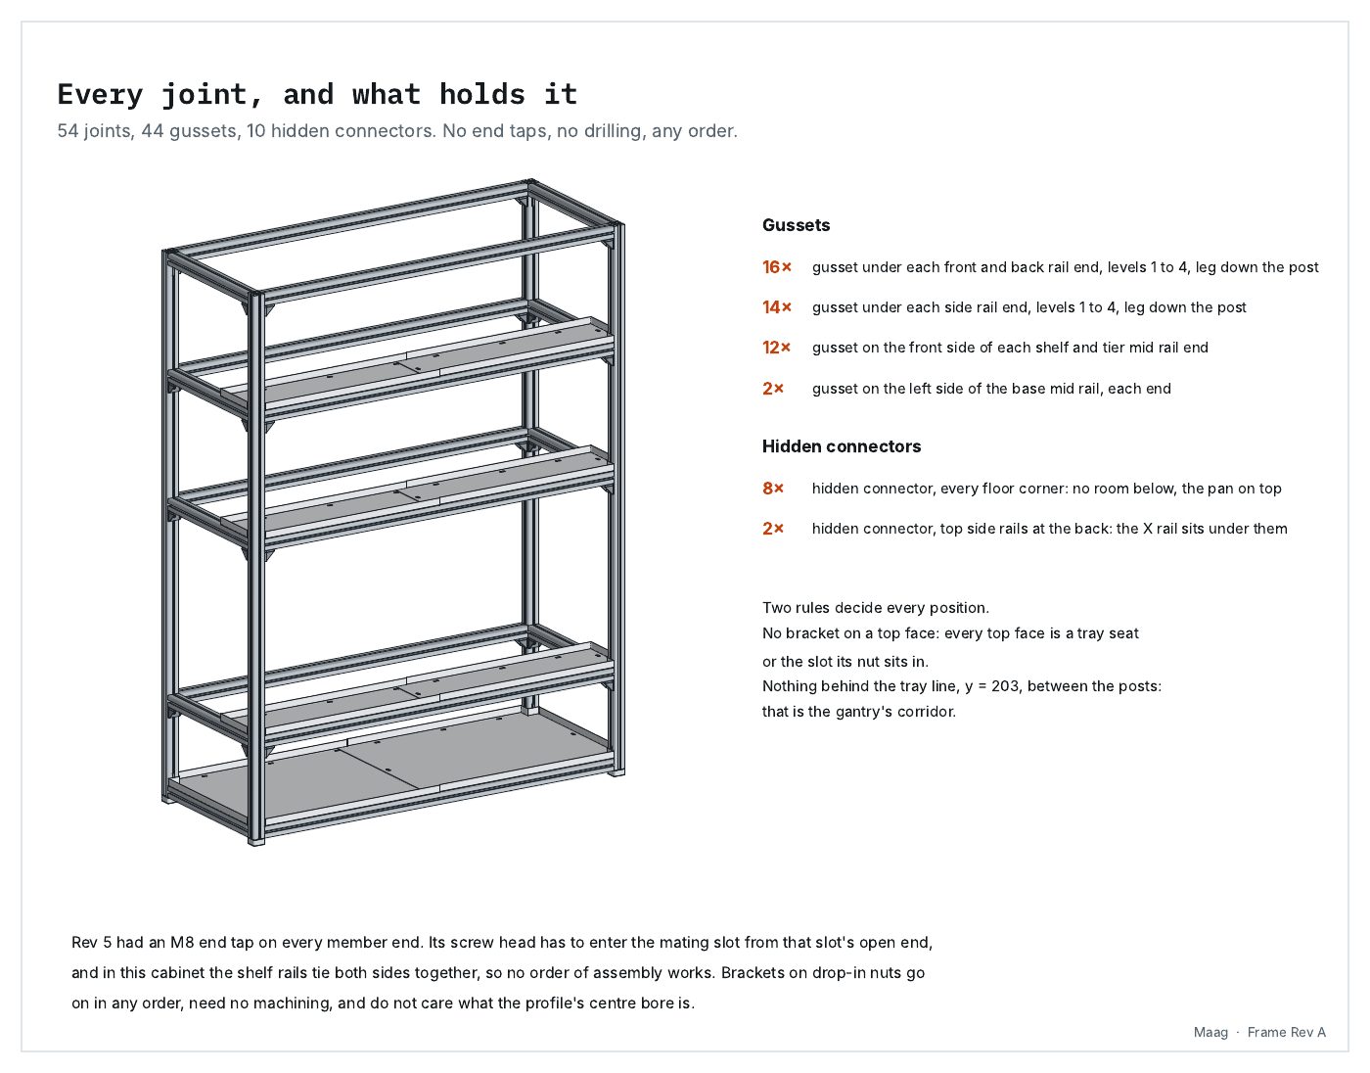
[picture p164: docs/booklets/frame/p05.jpg]
Frame Rev A, page 5: Every joint, and what holds it


### 6 · Step 1 · Know your profile

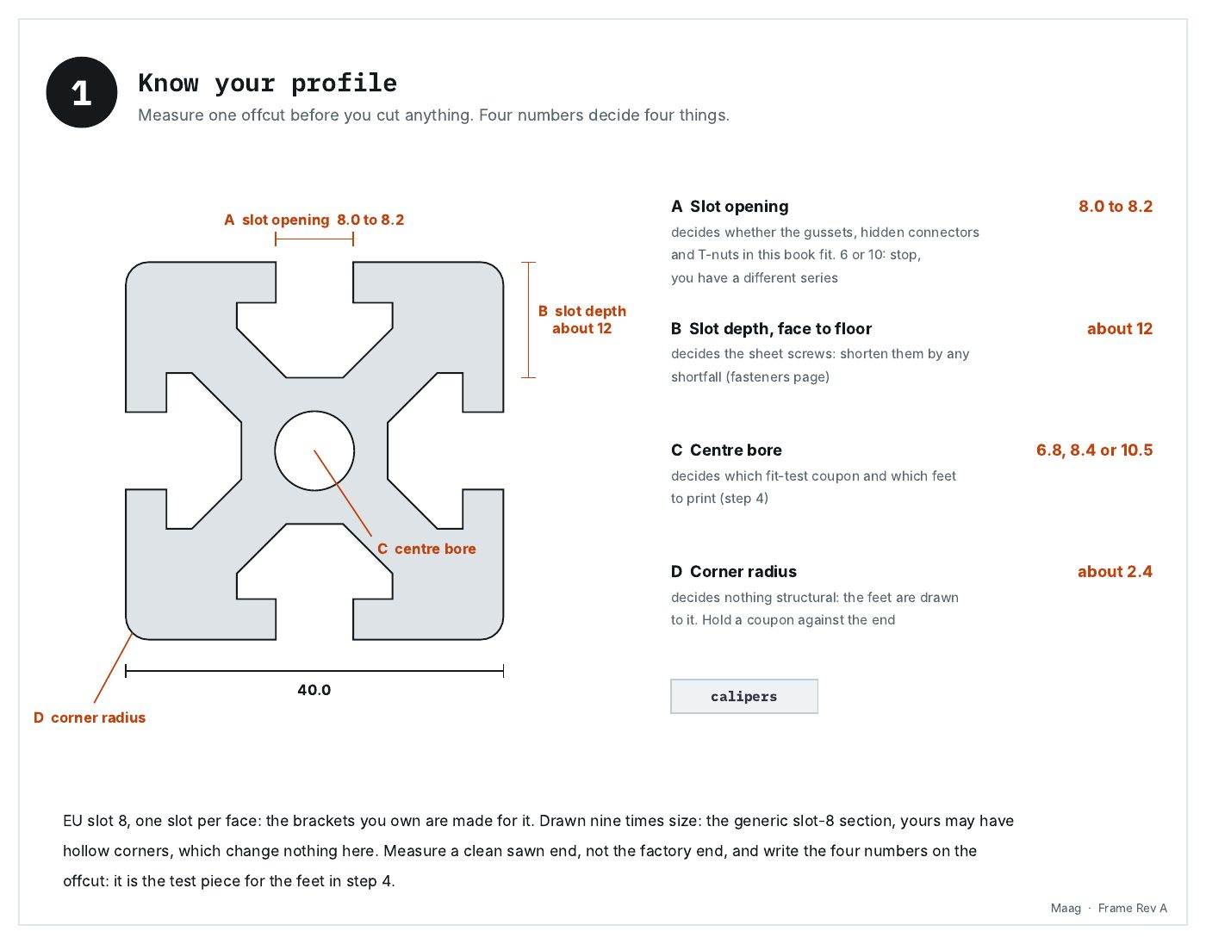
[picture p165: docs/booklets/frame/p06.jpg]
Frame Rev A, page 6: Know your profile


### 7 · Step 2 · Cut and label

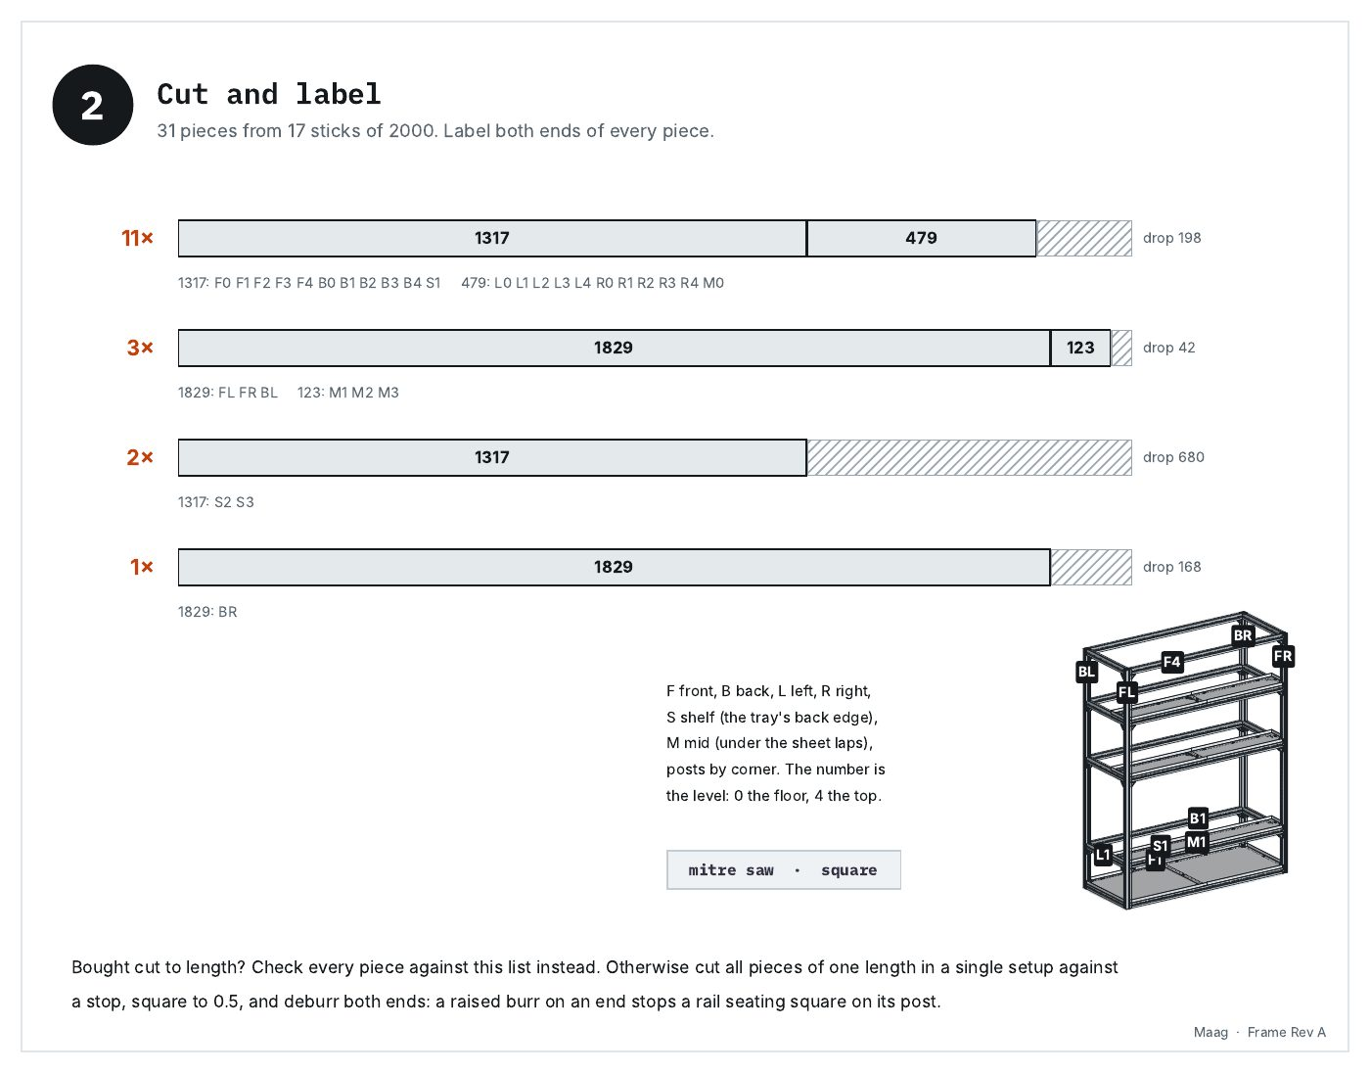
[picture p166: docs/booklets/frame/p07.jpg]
Frame Rev A, page 7: Cut and label


### 8 · Step 3 · Mark the levels

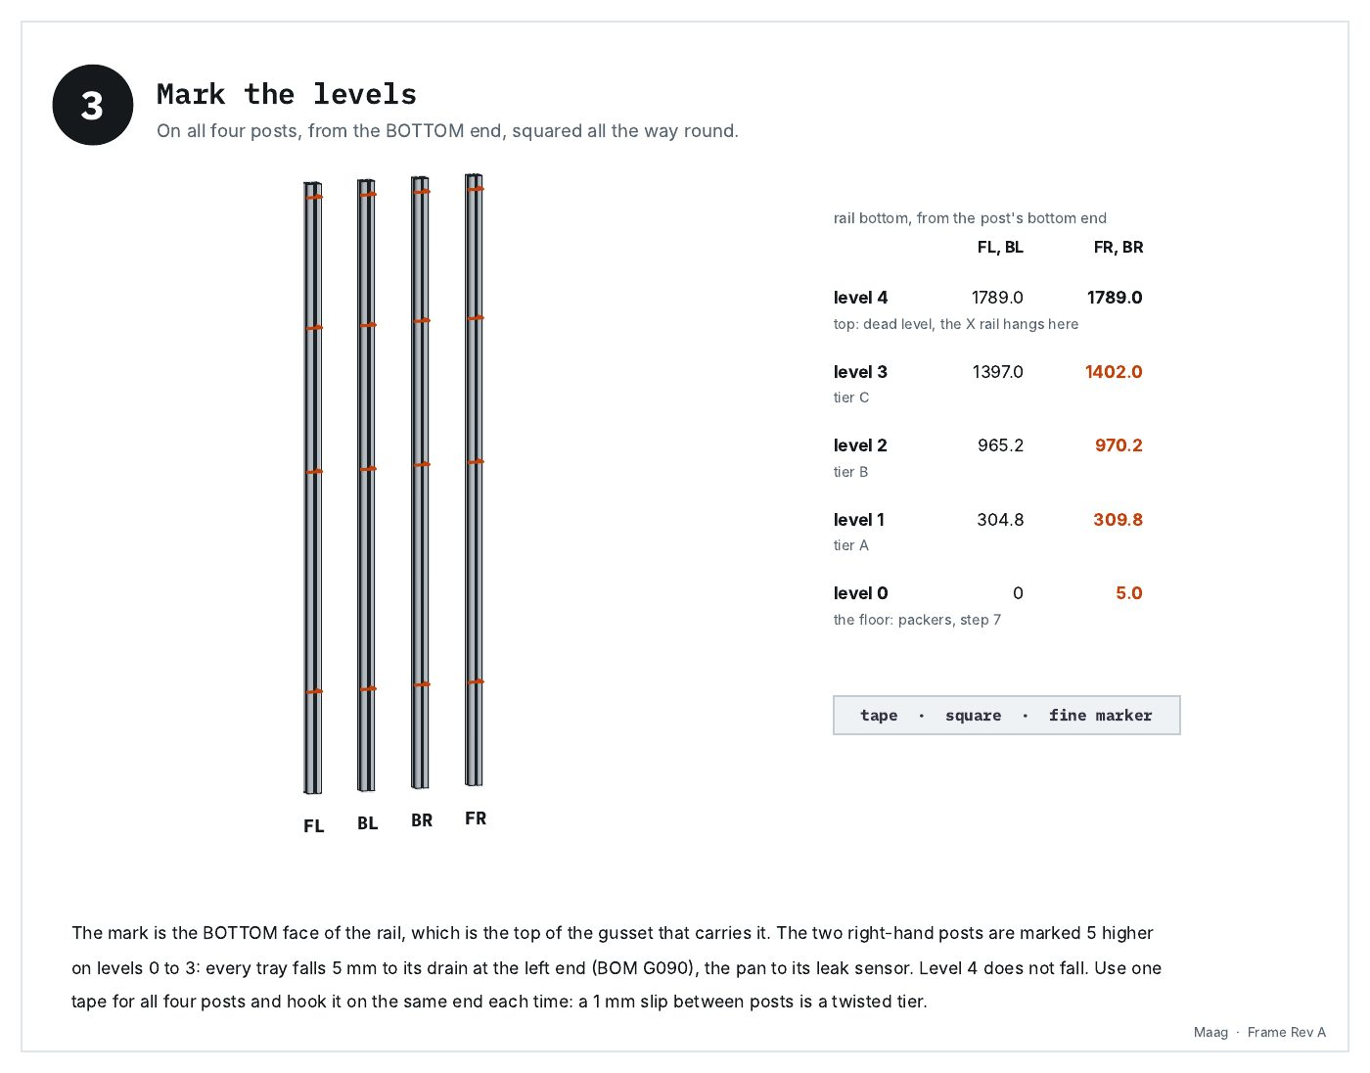
[picture p167: docs/booklets/frame/p08.jpg]
Frame Rev A, page 8: Mark the levels


### 9 · Step 4 · Print the feet

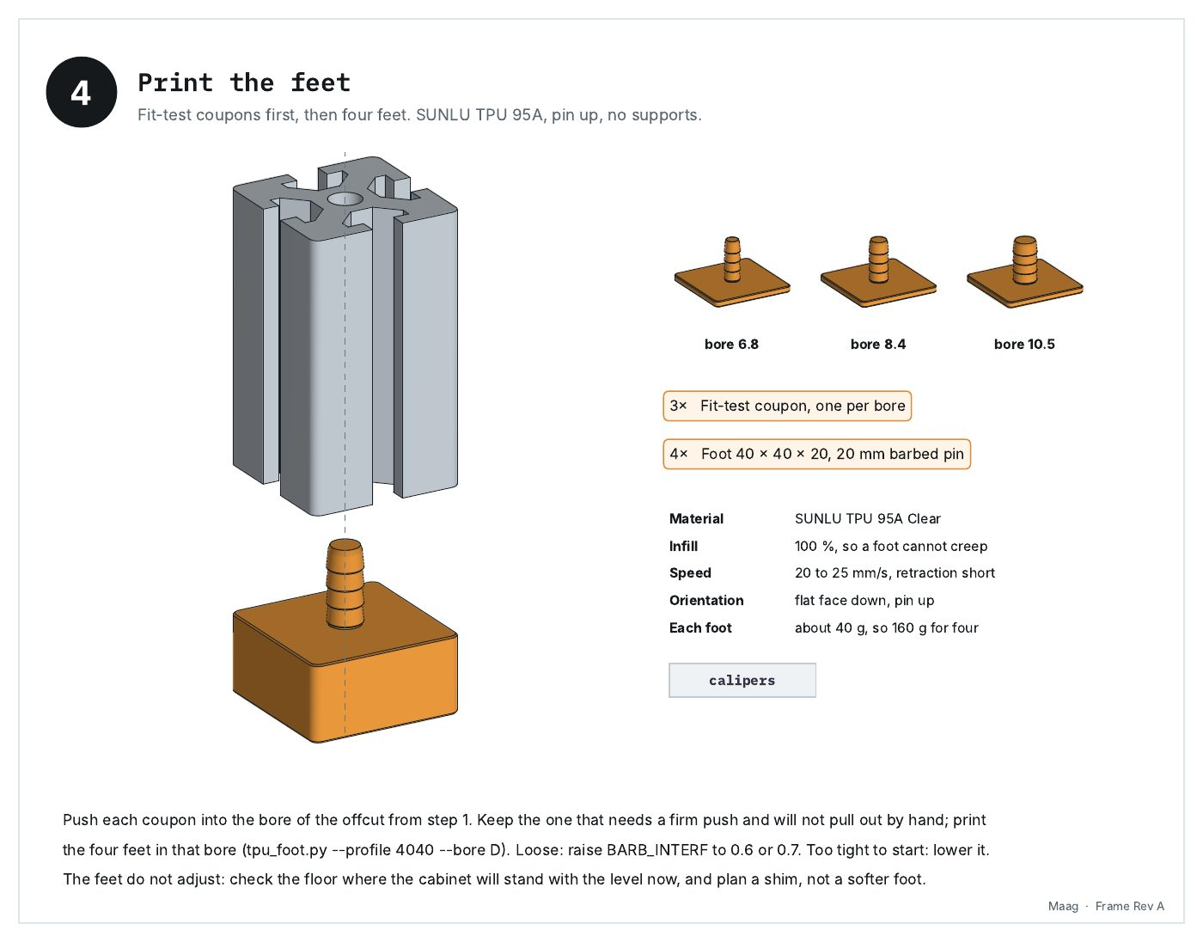
[picture p168: docs/booklets/frame/p09.jpg]
Frame Rev A, page 9: Print the feet


### 10 · Step 5 · The base · front, back and the mid rail

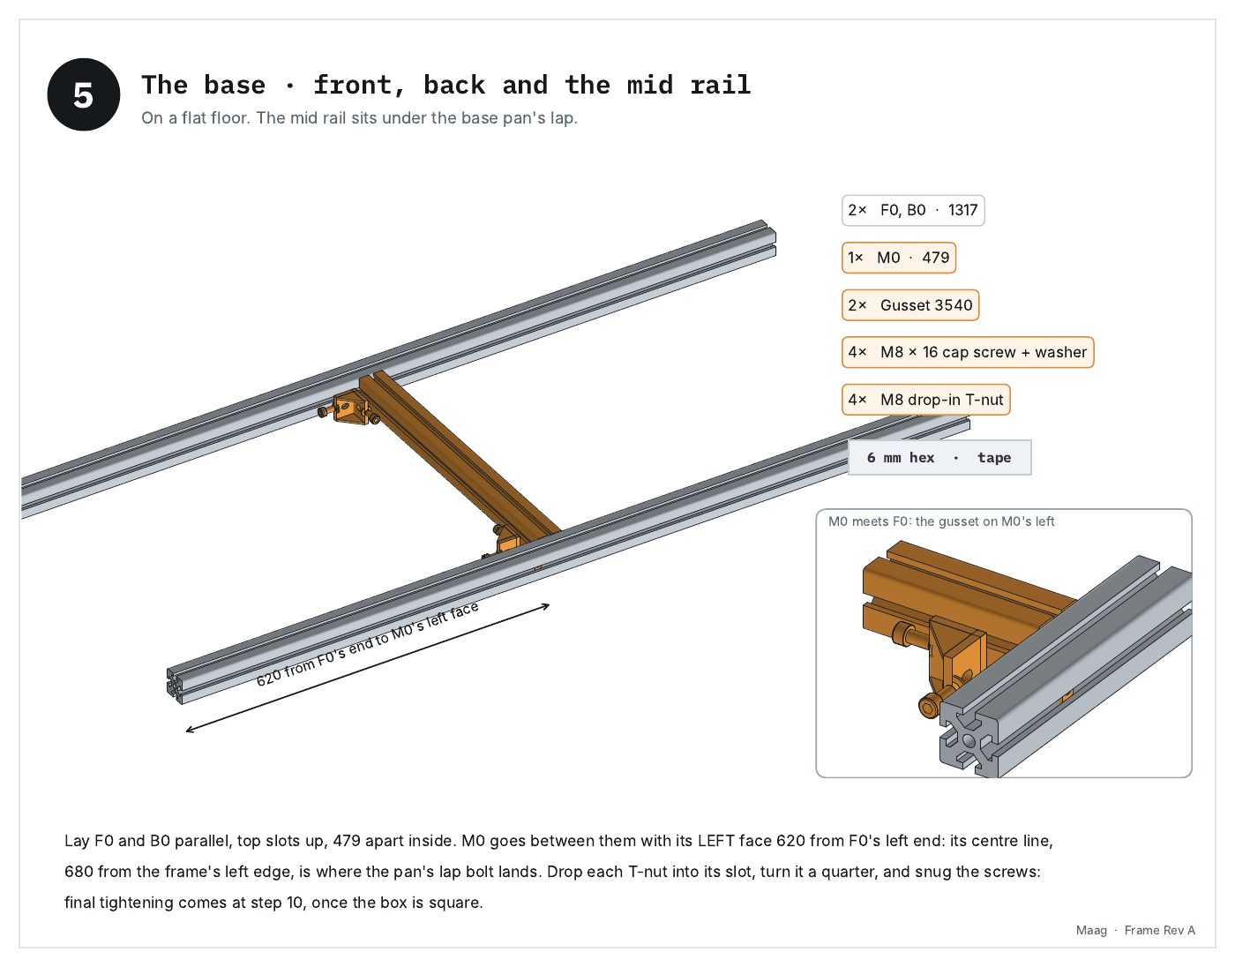
[picture p169: docs/booklets/frame/p10.jpg]
Frame Rev A, page 10: The base · front, back and the mid rail


### 11 · Step 6 · Hidden connectors in the eight floor ends

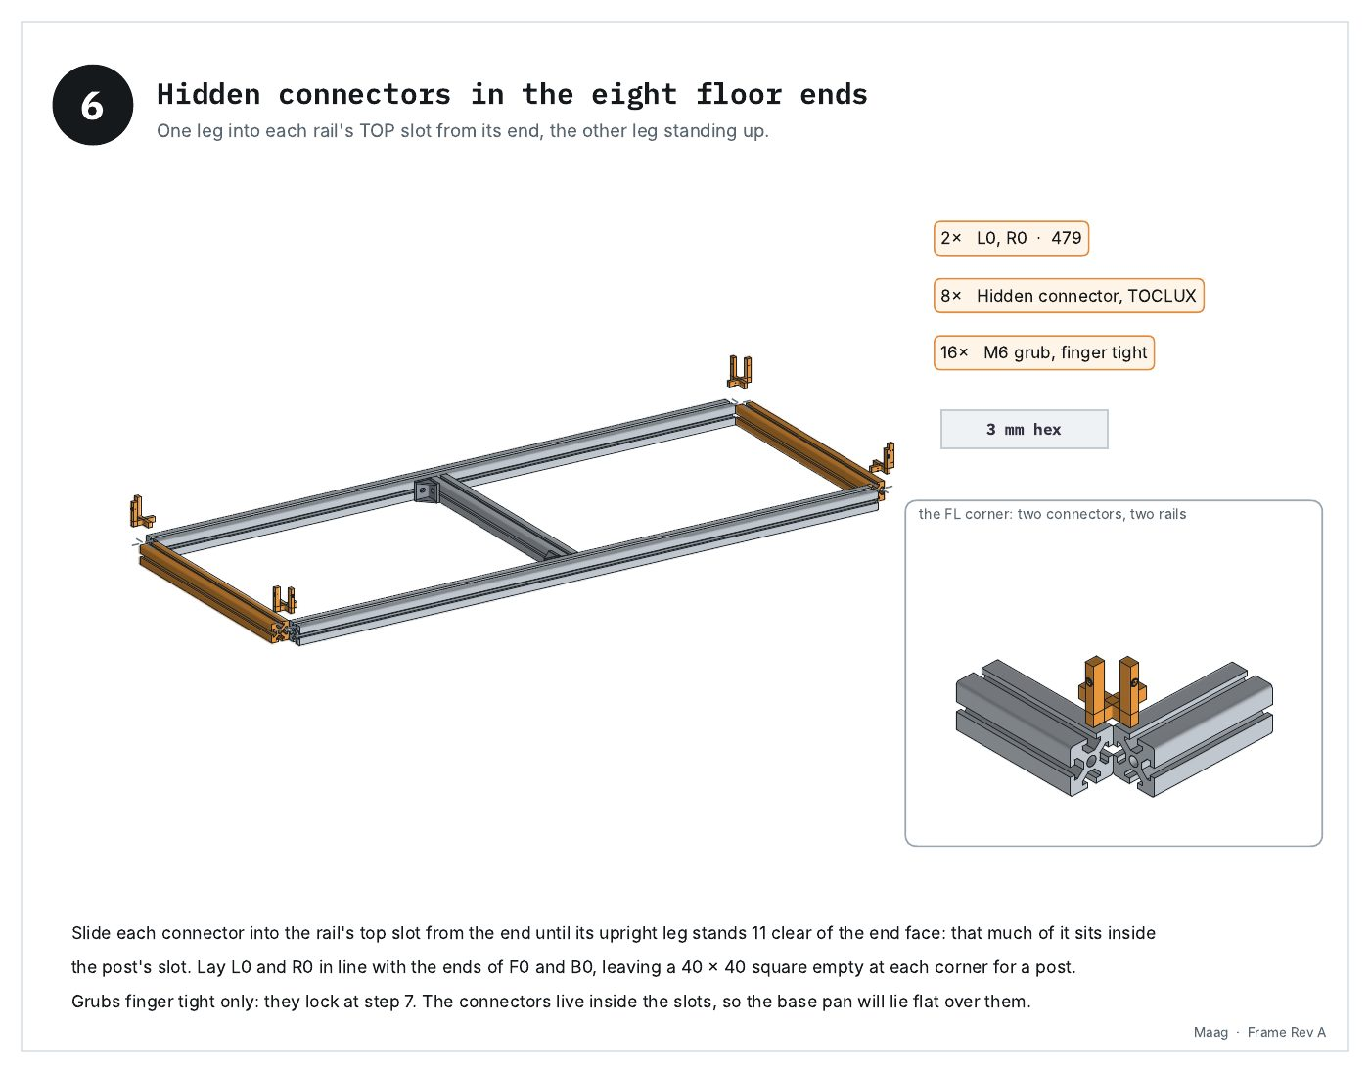
[picture p170: docs/booklets/frame/p11.jpg]
Frame Rev A, page 11: Hidden connectors in the eight floor ends


### 12 · Step 7 · Stand the posts

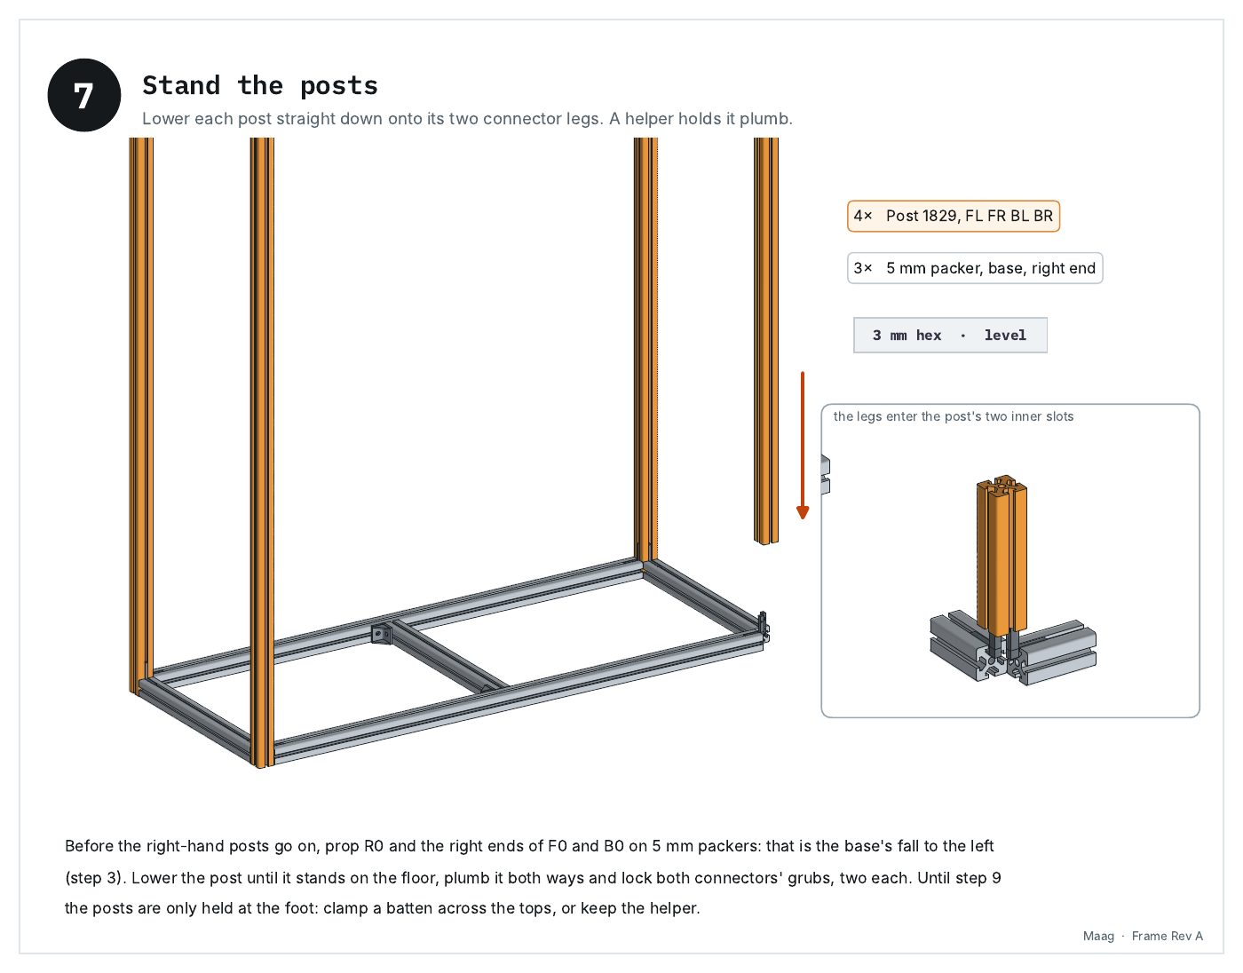
[picture p171: docs/booklets/frame/p12.jpg]
Frame Rev A, page 12: Stand the posts


### 13 · Step 8 · Ledges for the top

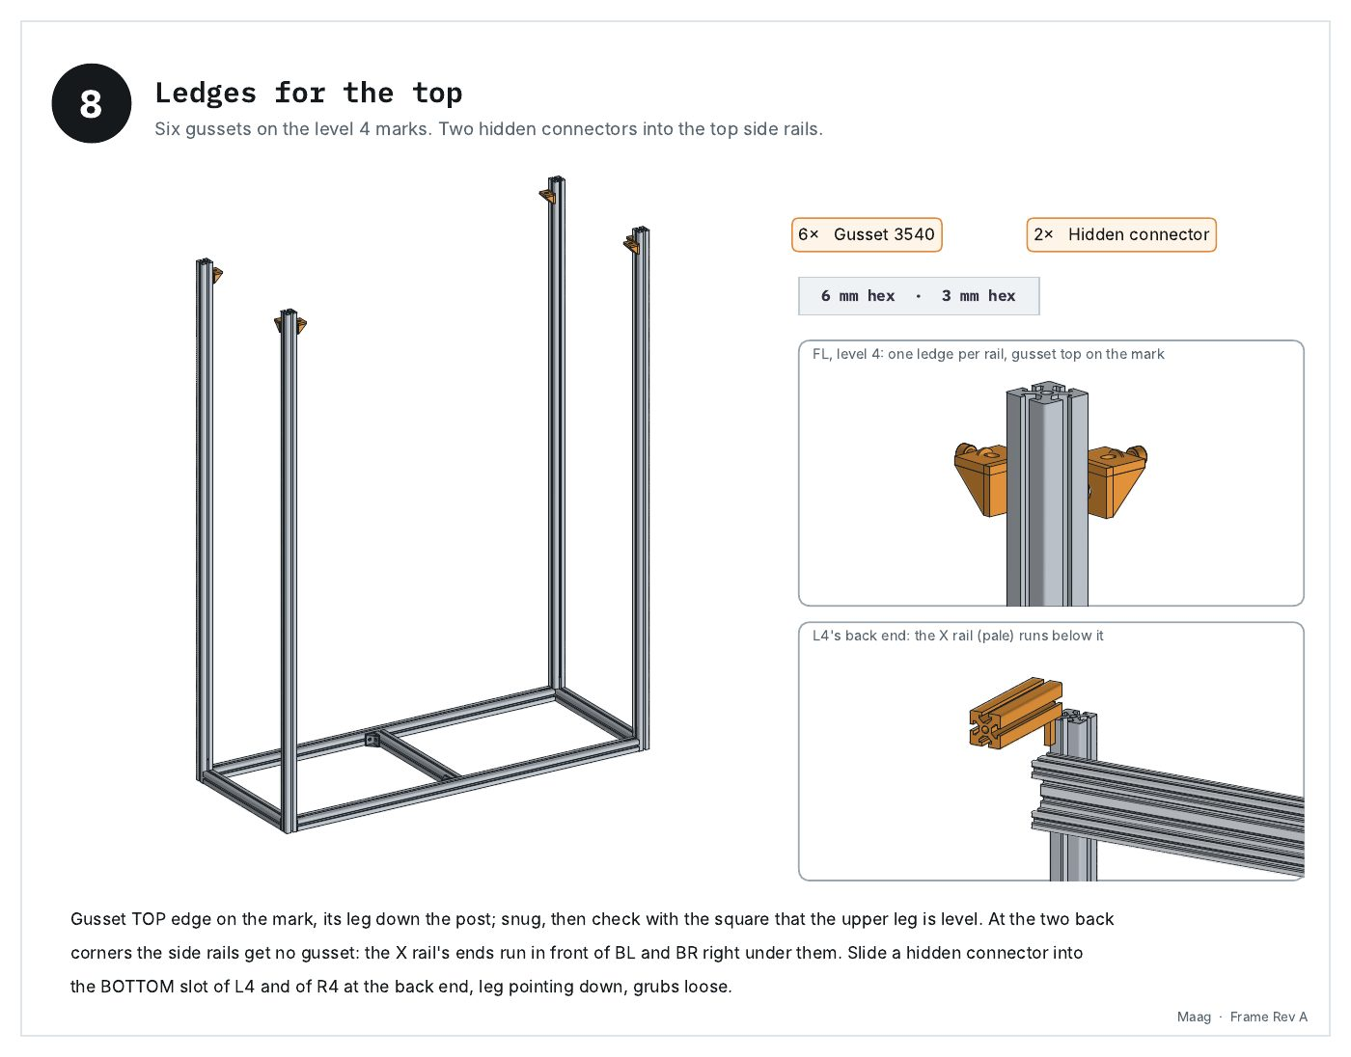
[picture p172: docs/booklets/frame/p13.jpg]
Frame Rev A, page 13: Ledges for the top


### 14 · Step 9 · The top ring

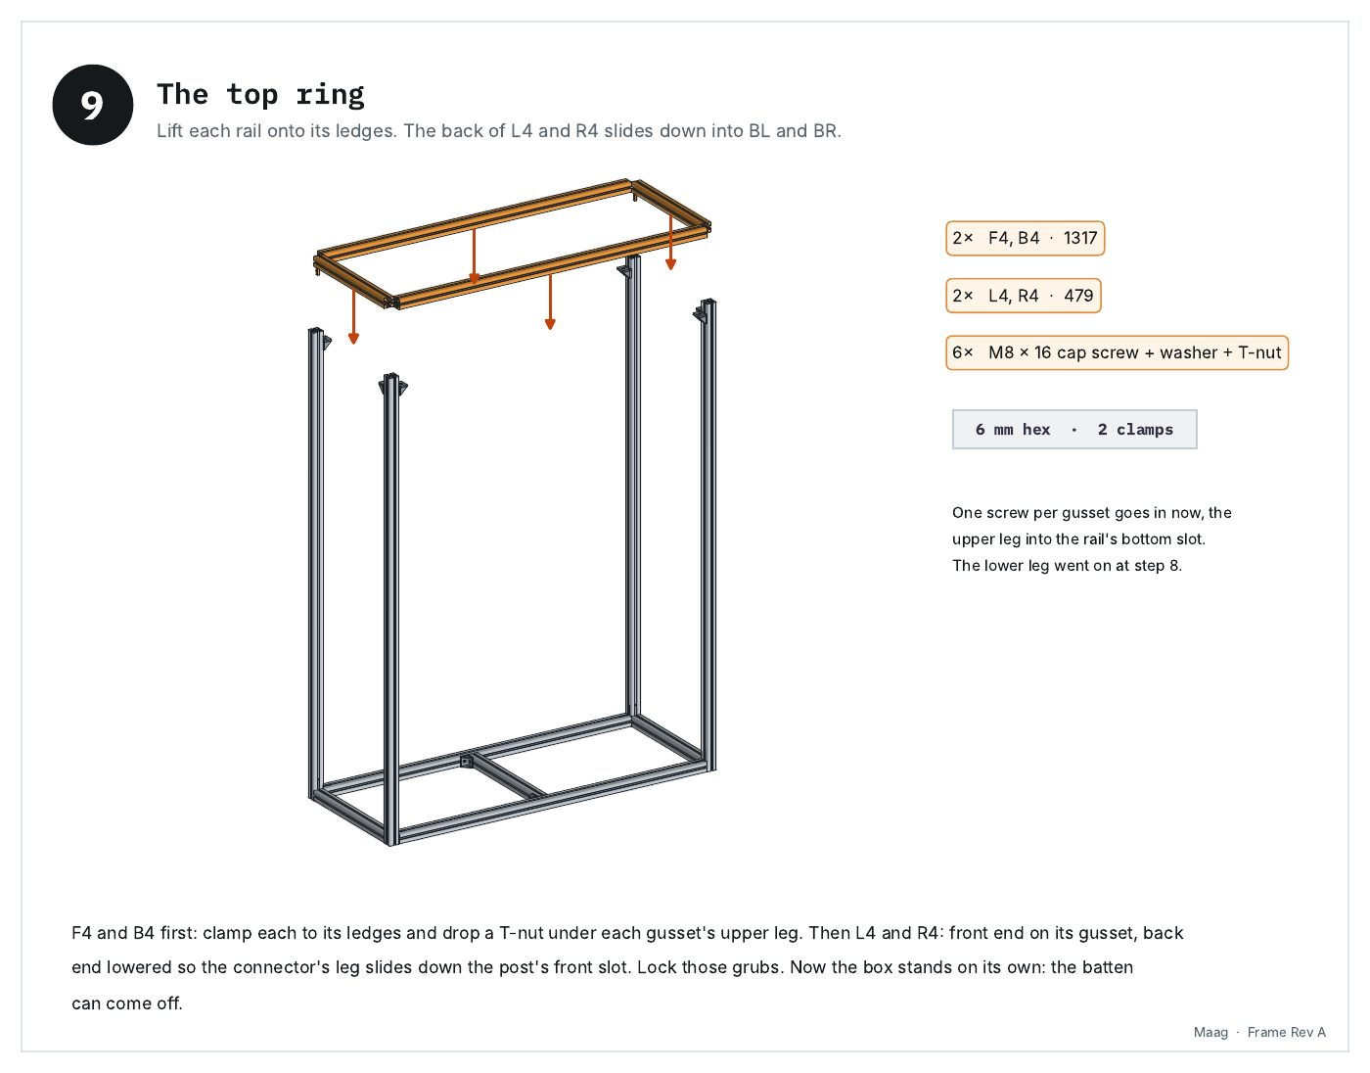
[picture p173: docs/booklets/frame/p14.jpg]
Frame Rev A, page 14: The top ring


### 15 · Step 10 · Square it, then tighten

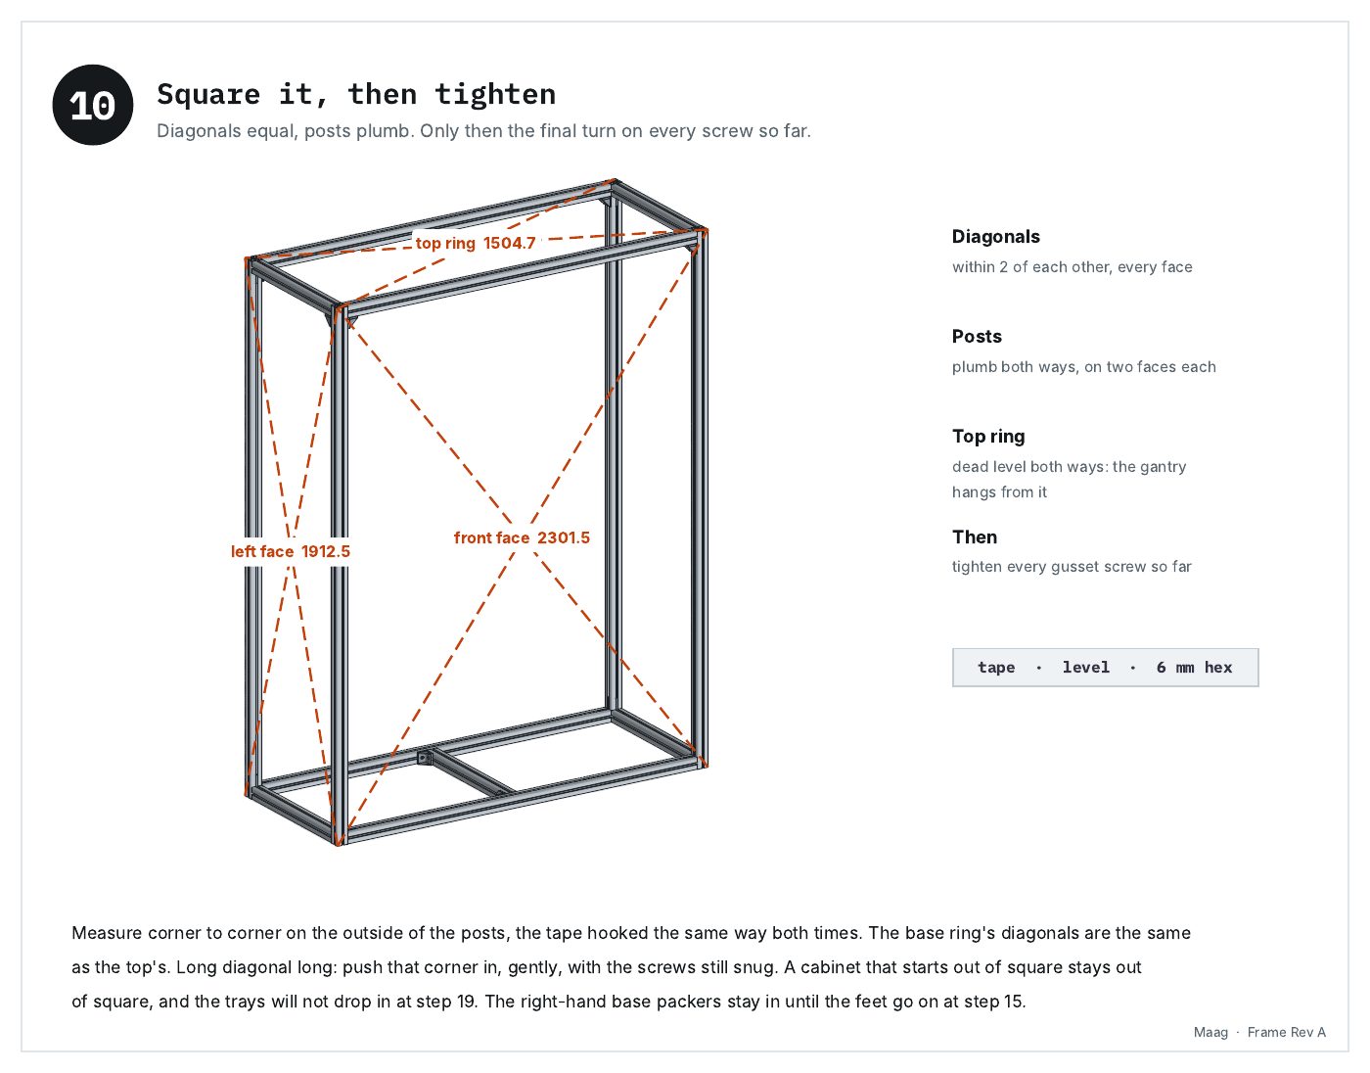
[picture p174: docs/booklets/frame/p15.jpg]
Frame Rev A, page 15: Square it, then tighten


### 16 · Step 11 · Tier A · eight ledges

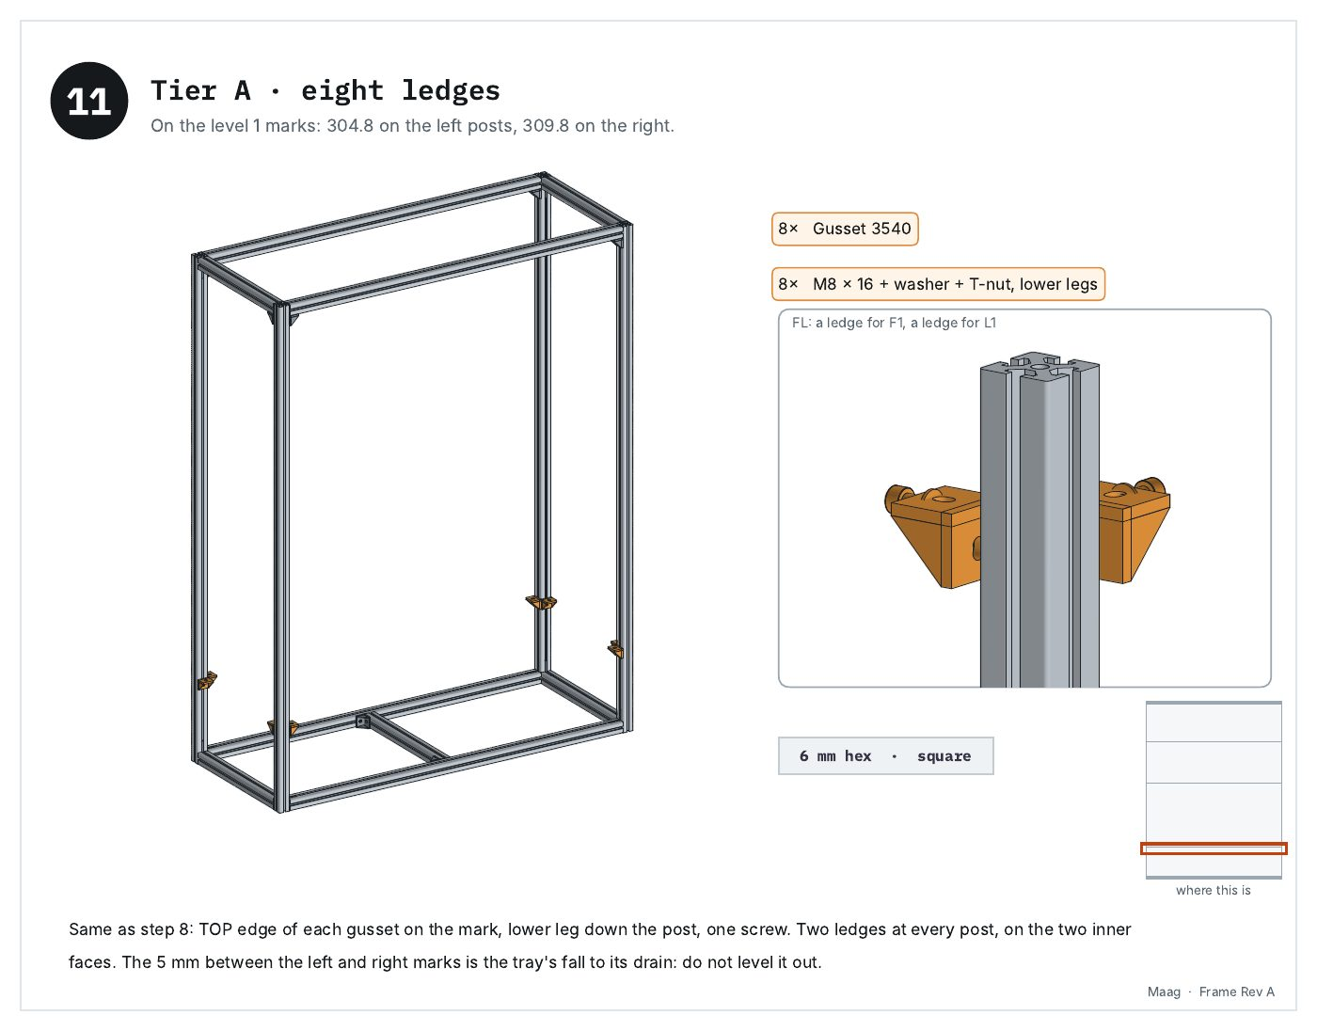
[picture p175: docs/booklets/frame/p16.jpg]
Frame Rev A, page 16: Tier A · eight ledges


### 17 · Step 12 · Tier A · front, back and side rails

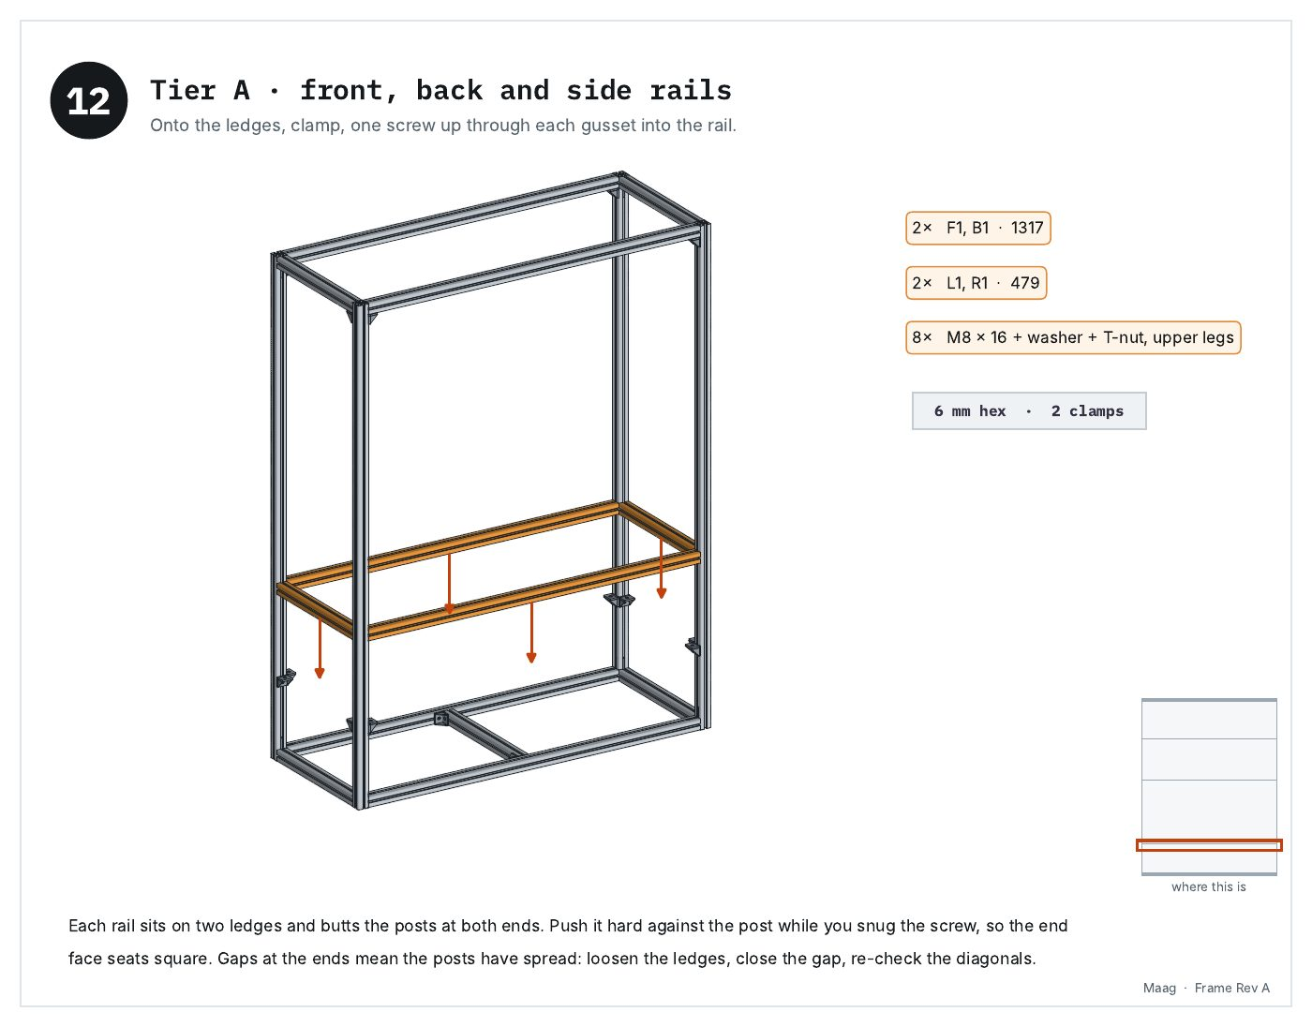
[picture p176: docs/booklets/frame/p17.jpg]
Frame Rev A, page 17: Tier A · front, back and side rails


### 18 · Step 13 · Tier A · the tray rails

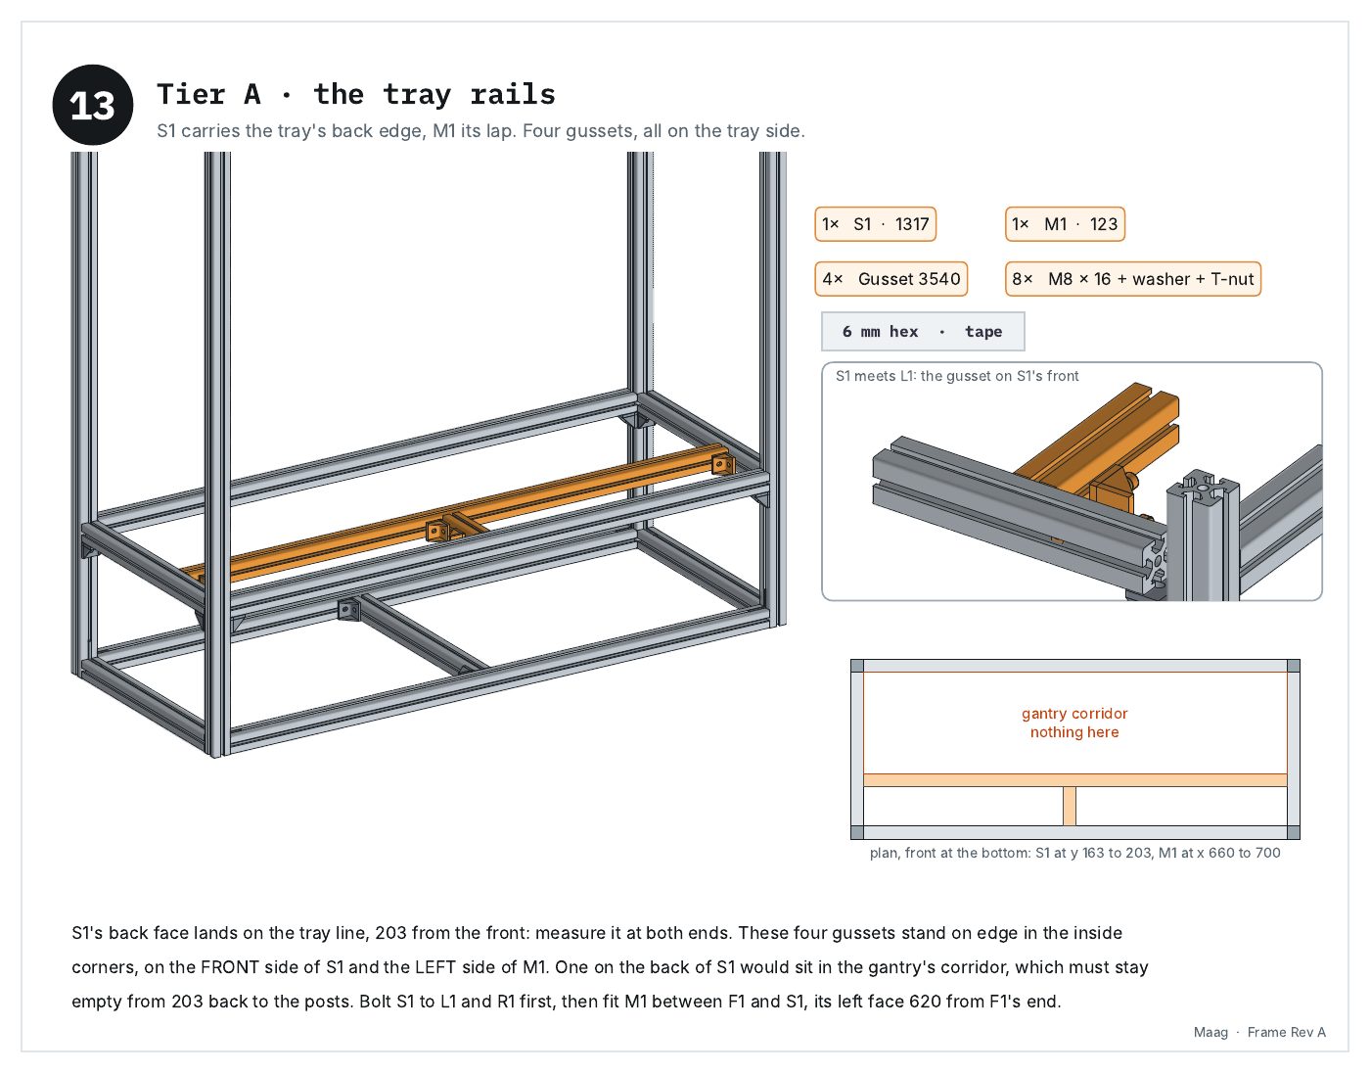
[picture p177: docs/booklets/frame/p18.jpg]
Frame Rev A, page 18: Tier A · the tray rails


### 19 · Step 14 · Tiers B and C · the same three steps

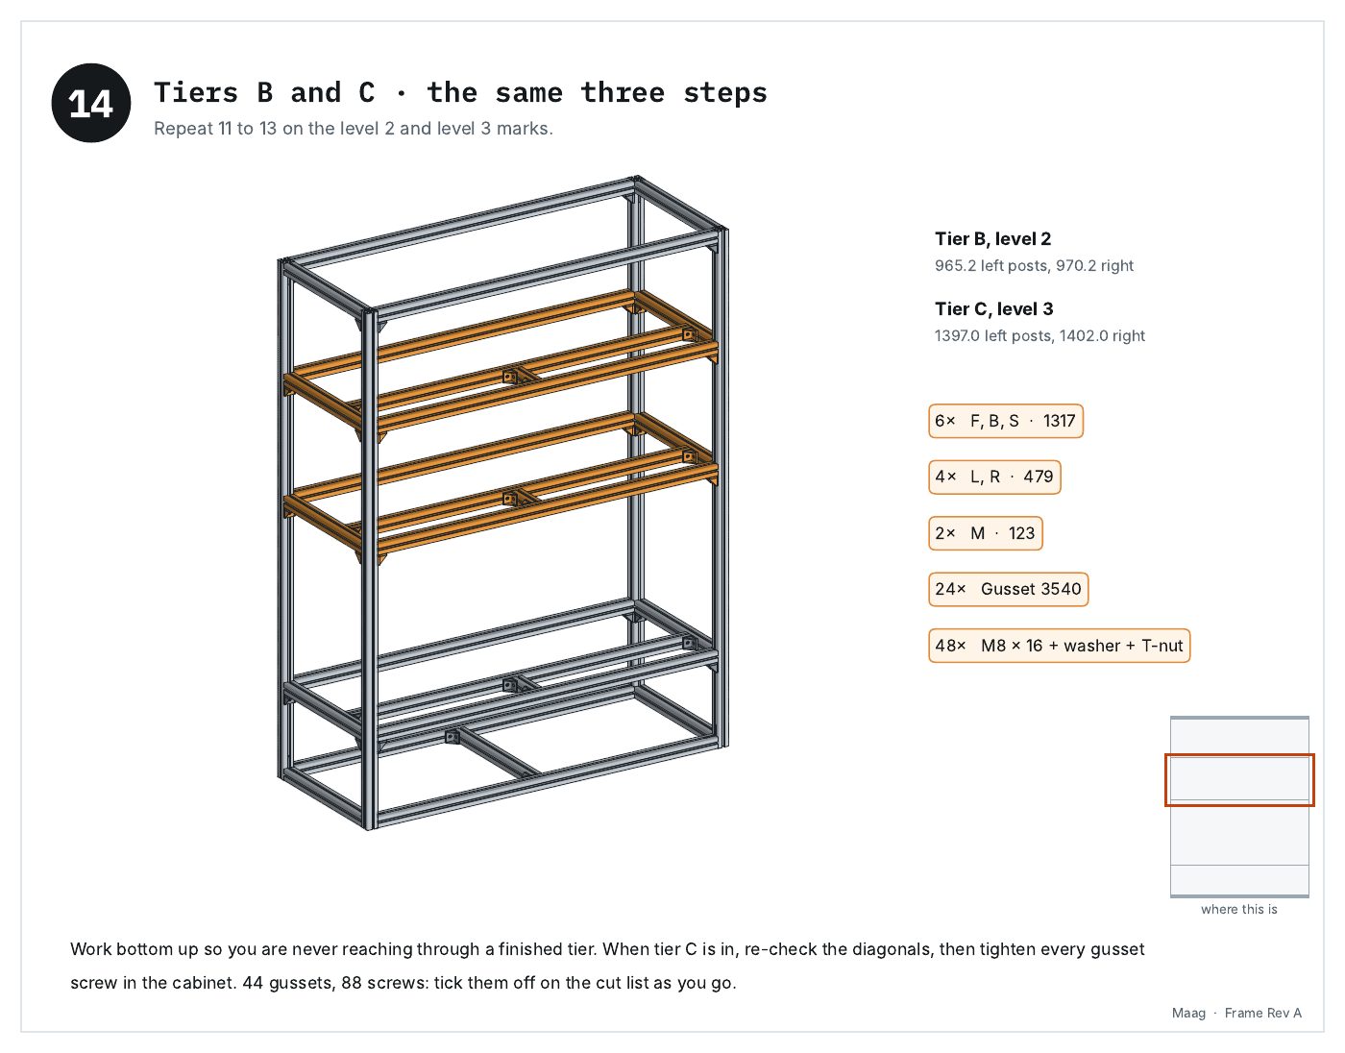
[picture p178: docs/booklets/frame/p19.jpg]
Frame Rev A, page 19: Tiers B and C · the same three steps


### 20 · Step 15 · The feet

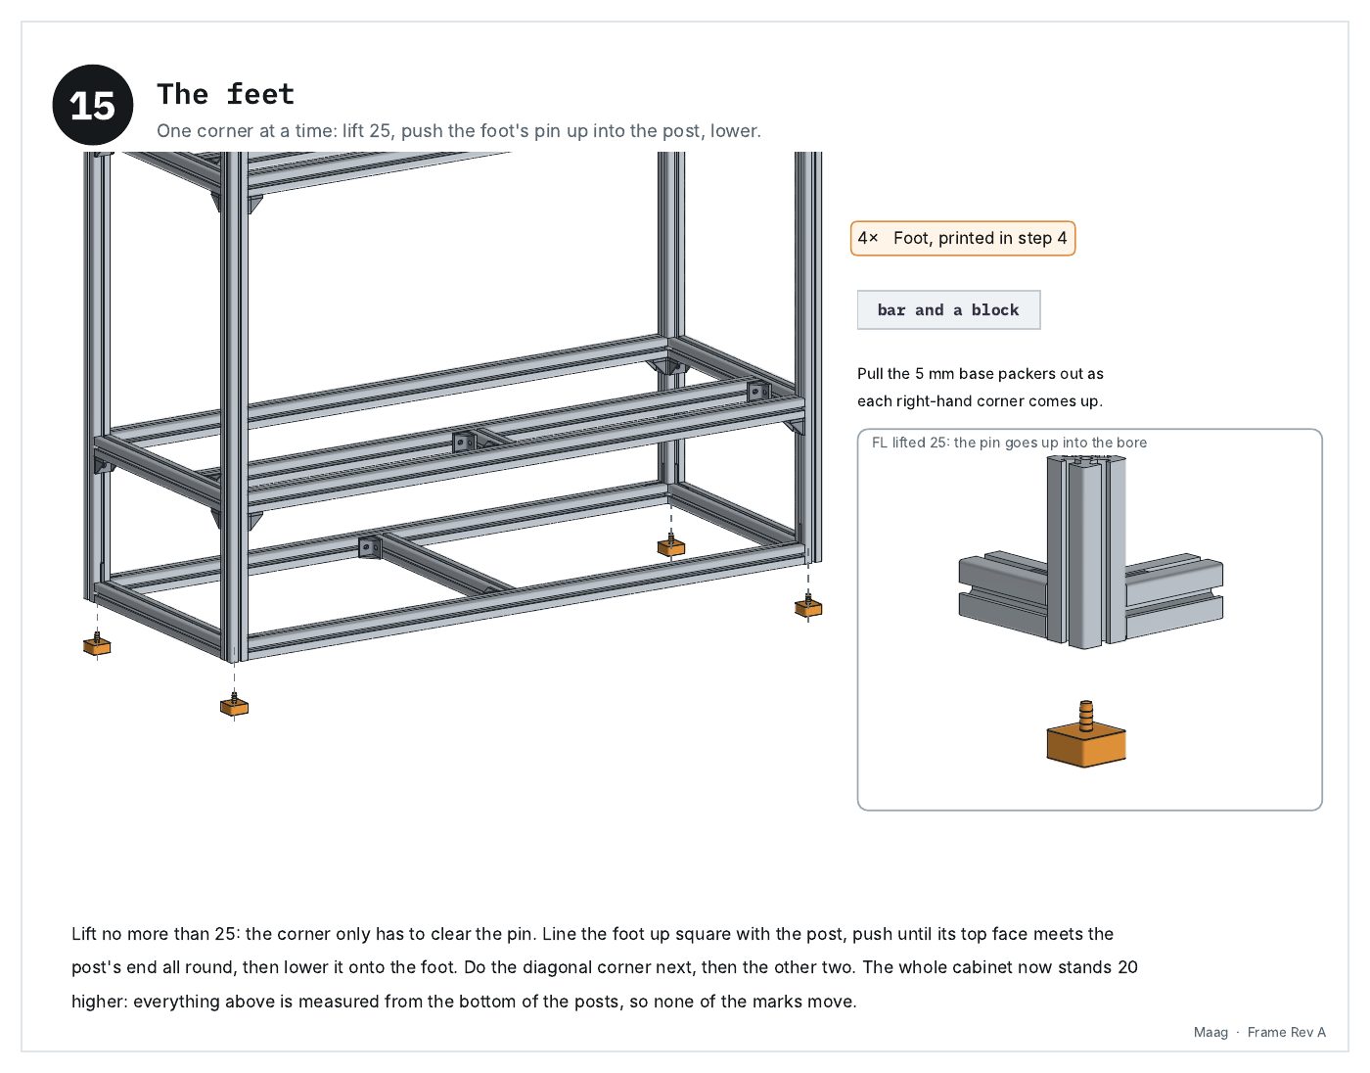
[picture p179: docs/booklets/frame/p20.jpg]
Frame Rev A, page 20: The feet


### 21 · Step 16 · The sheets · check, drill, seal

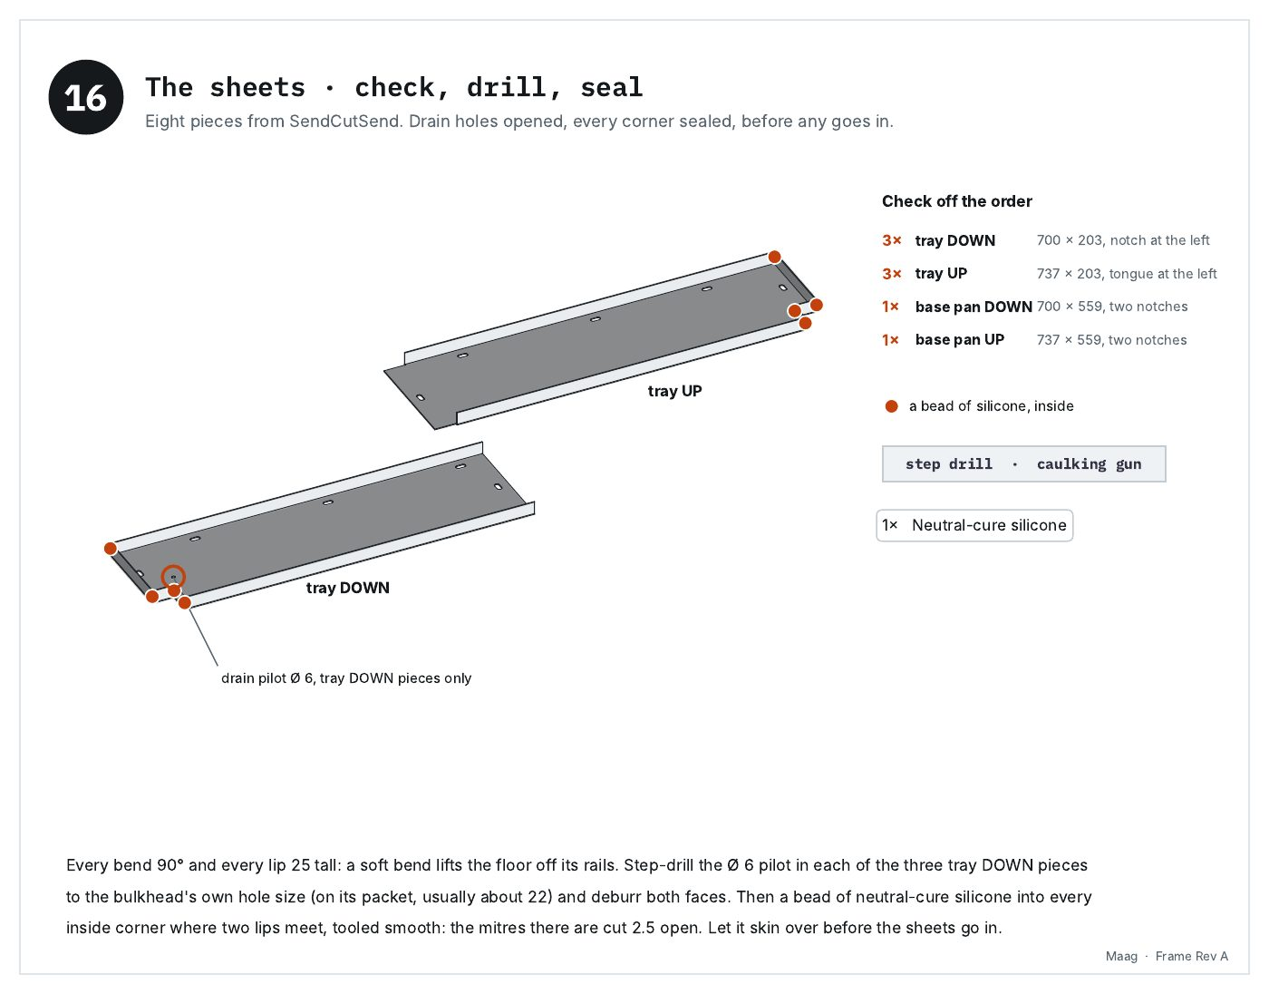
[picture p180: docs/booklets/frame/p21.jpg]
Frame Rev A, page 21: The sheets · check, drill, seal


### 22 · Step 17 · Base pan · T-nuts, then the DOWN piece

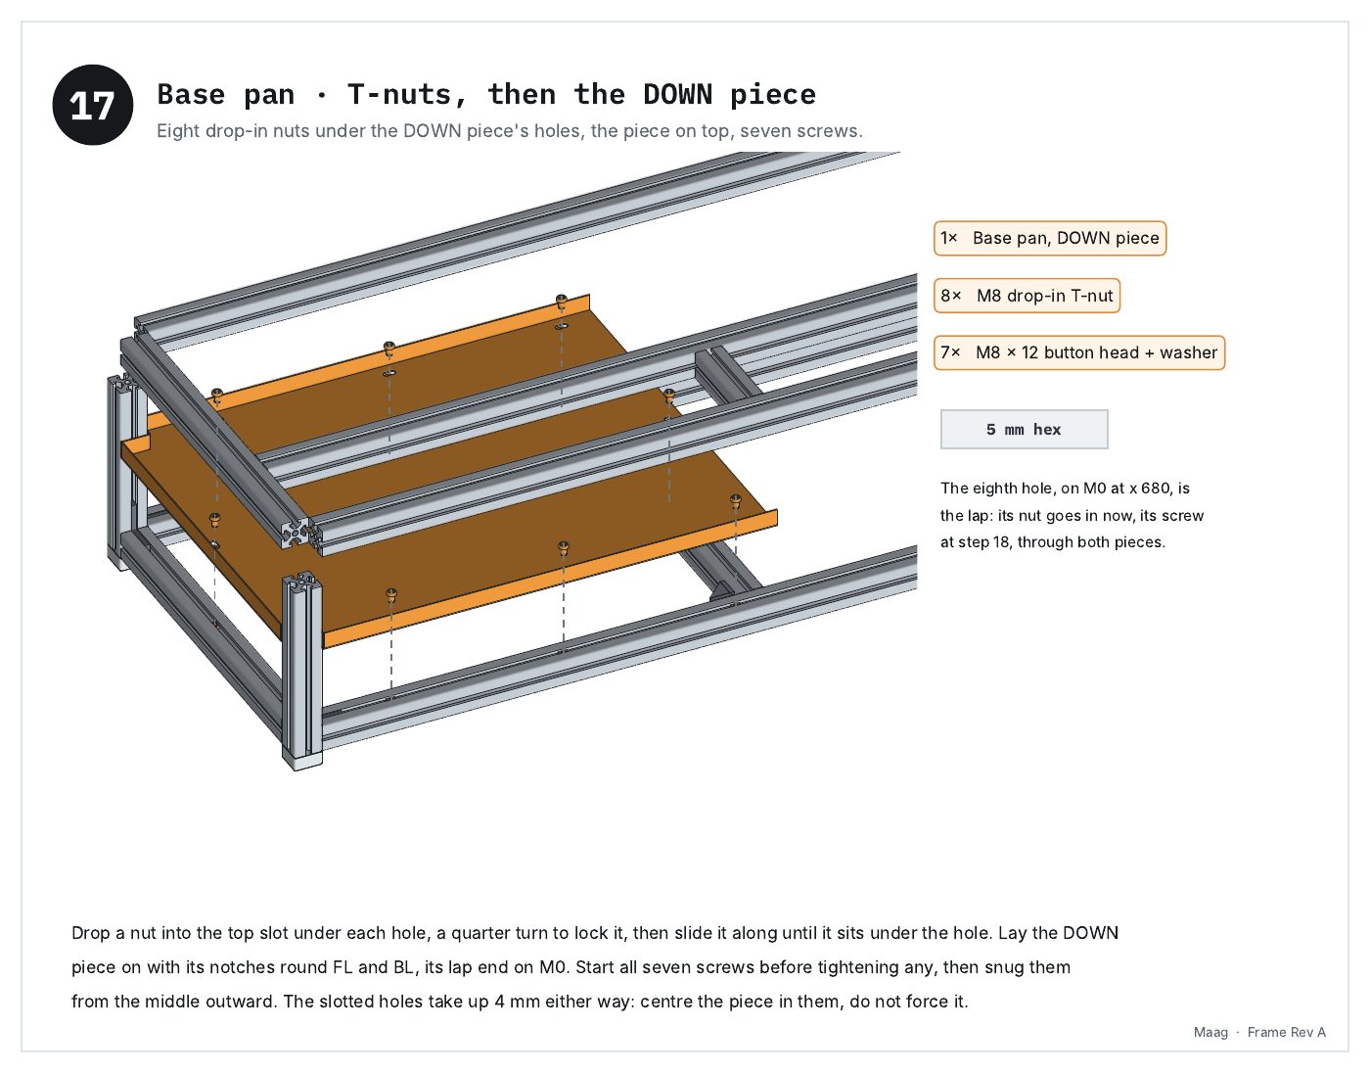
[picture p181: docs/booklets/frame/p22.jpg]
Frame Rev A, page 22: Base pan · T-nuts, then the DOWN piece


### 23 · Step 18 · Base pan · the UP piece over the lap

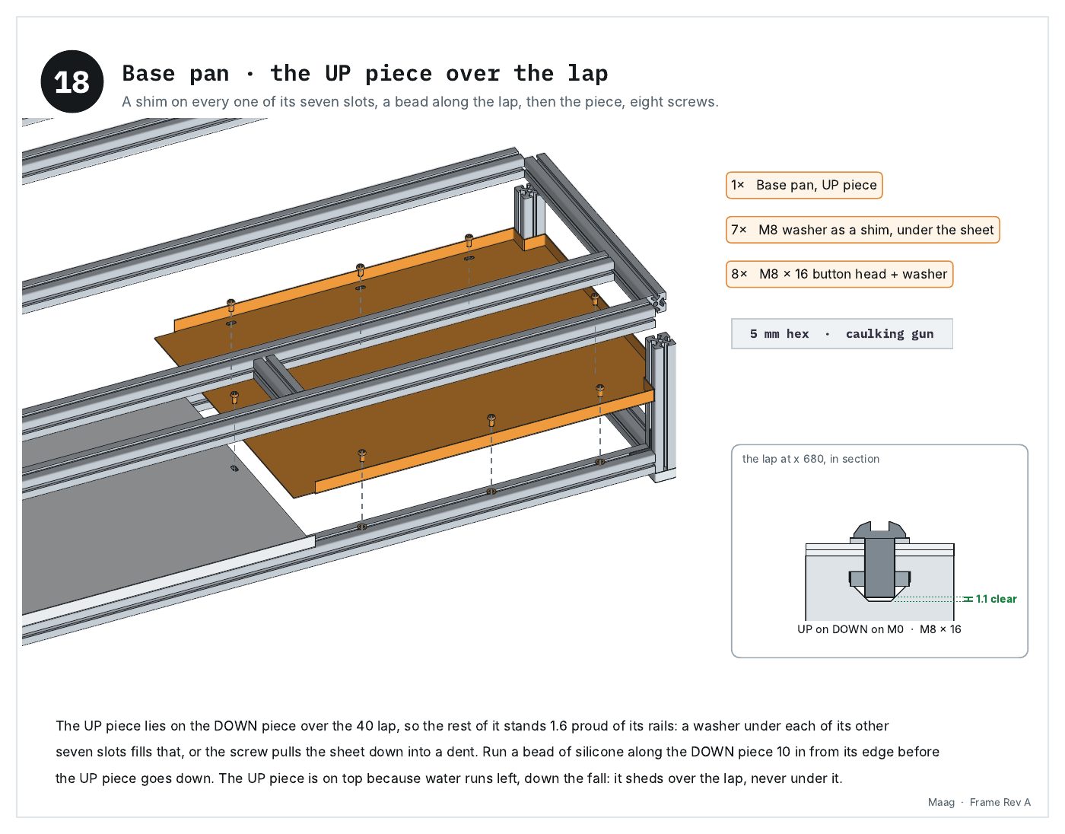
[picture p182: docs/booklets/frame/p23.jpg]
Frame Rev A, page 23: Base pan · the UP piece over the lap


### 24 · Step 19 · Trays · the same, three times

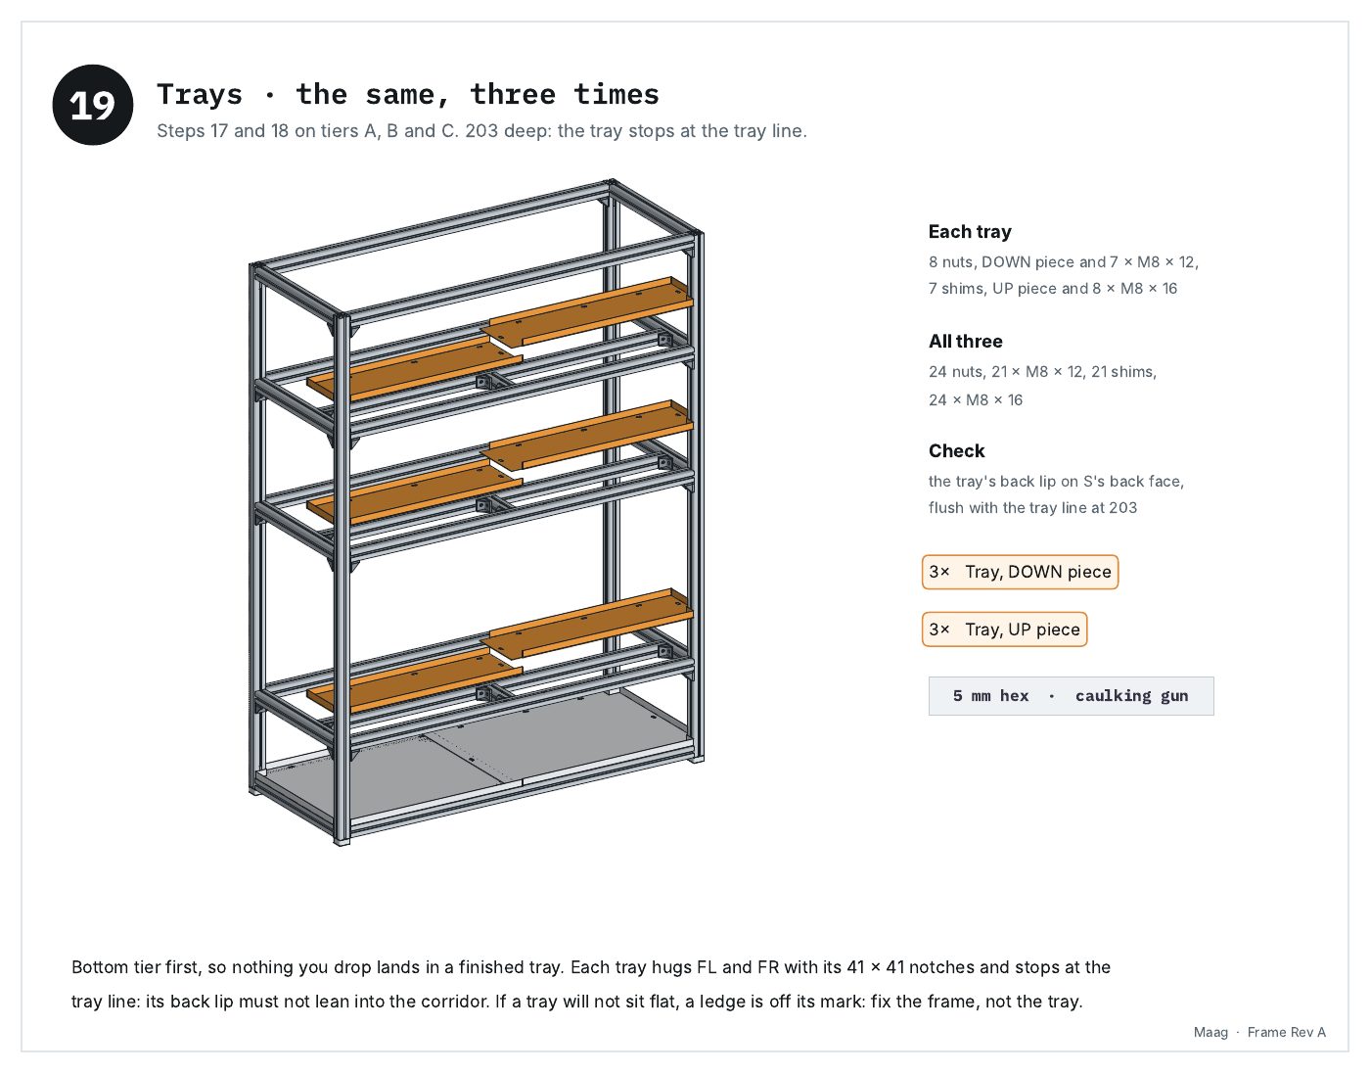
[picture p183: docs/booklets/frame/p24.jpg]
Frame Rev A, page 24: Trays · the same, three times


### 25 · Step 20 · Drains · one riser on the FL post

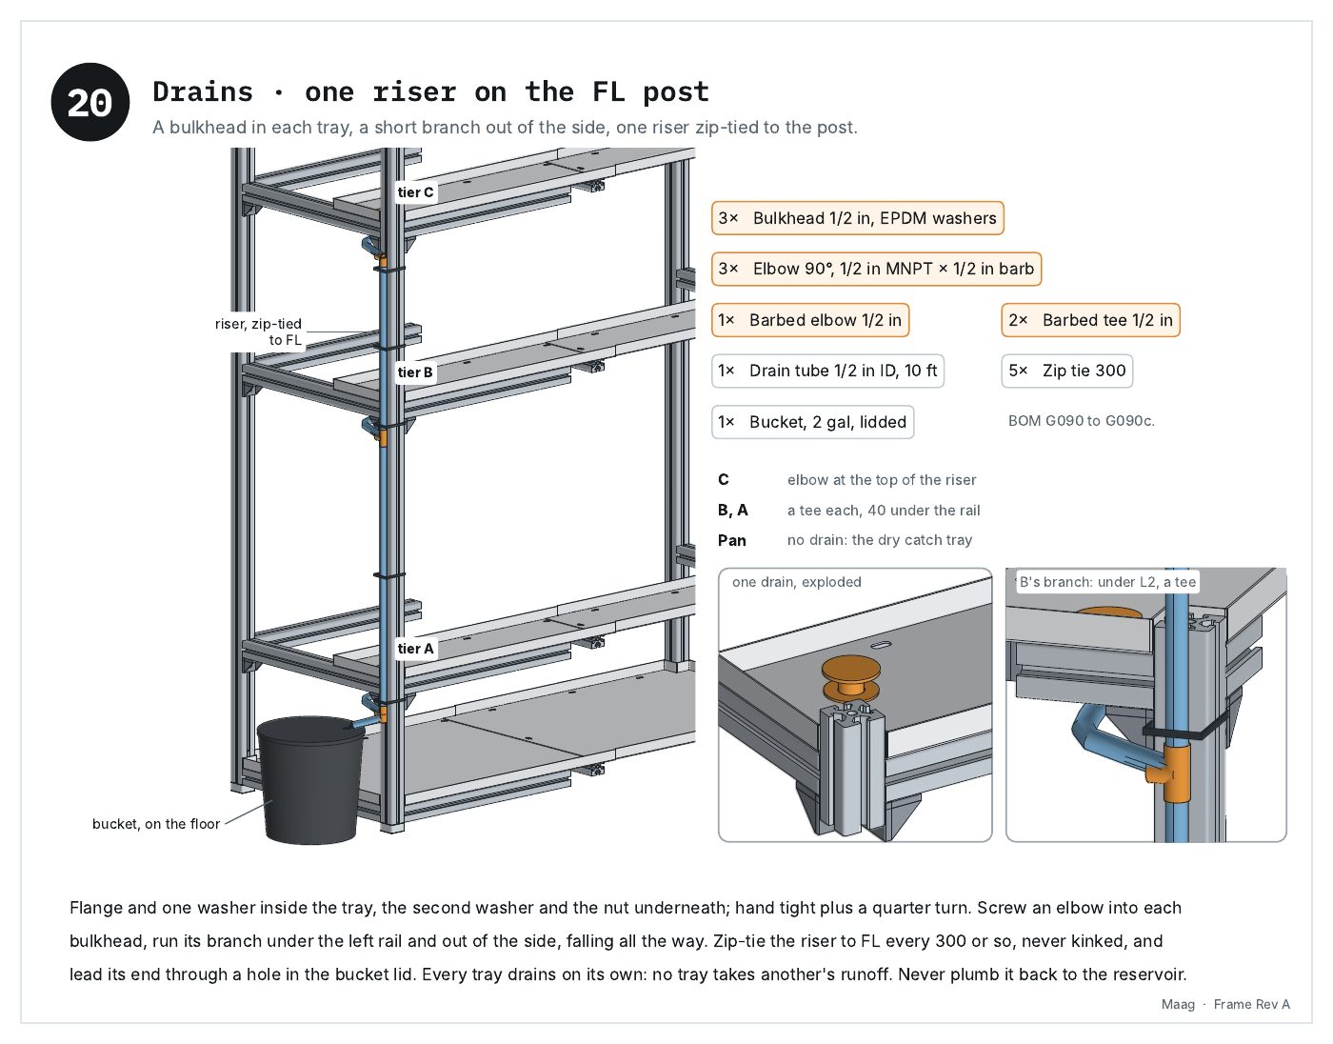
[picture p184: docs/booklets/frame/p25.jpg]
Frame Rev A, page 25: Drains · one riser on the FL post


### 26 · Step 21 · Before you load it

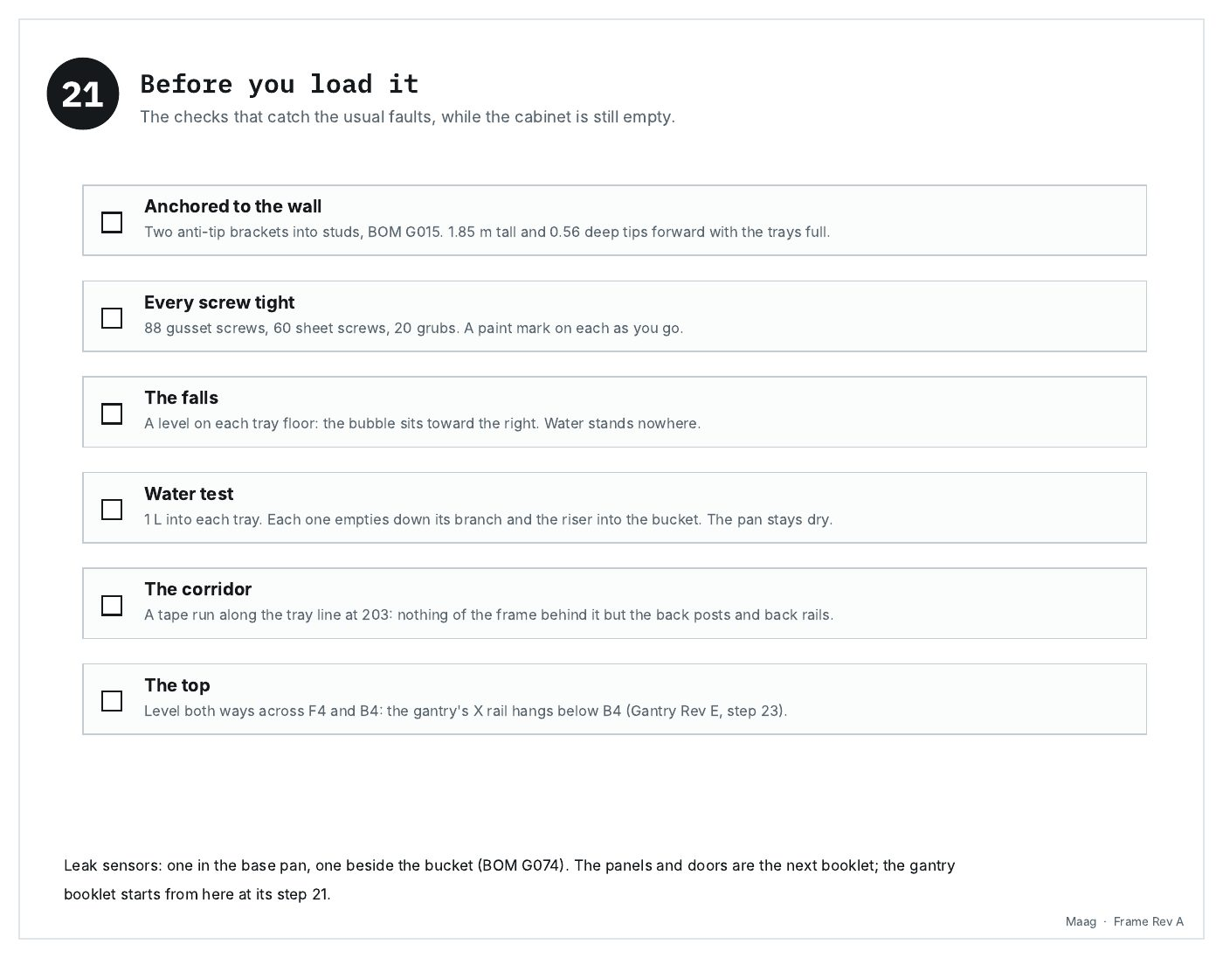
[picture p185: docs/booklets/frame/p26.jpg]
Frame Rev A, page 26: Before you load it


---

[All booklets](README.md) · next: [Gantry Rev E](gantry.md)
