v1proxy/RedTower/docs/booklets/gantry.md

# Gantry Rev E, page by page

<!-- generated by greenhouse/booklet/make_gallery.py from greenhouse/gantry/Gantry_Assembly_Instructions_RevE.pdf: do not edit -->

The X/Z gantry on the bench, its wiring, then into the cabinet with the arm. 33 pages, 27 steps. Each page below is the PDF's own page as an image; click one for full size.

[PDF](../../greenhouse/gantry/Gantry_Assembly_Instructions_RevE.pdf) · [Guide](../../greenhouse/gantry/GANTRY_ASSEMBLY.md) · [All booklets](README.md) · previous: [Frame Rev A](frame.md) · next: [Enclosure Rev A](enclosure.md)

<details><summary><b>Contents</b>, 33 pages</summary>

- [1 · Cover](#1--cover)
- [2 · Gantry · parts](#2--gantry--parts)
- [3 · Gantry · fasteners](#3--gantry--fasteners)
- [4 · Tools](#4--tools)
- [5 · Step 1 · Know your plate](#5--step-1--know-your-plate)
- [6 · Step 2 · Fixed wheels · the stack](#6--step-2--fixed-wheels--the-stack)
- [7 · Step 3 · Eccentric wheels](#7--step-3--eccentric-wheels)
- [8 · Step 4 · Onto the rail, then set the preload](#8--step-4--onto-the-rail-then-set-the-preload)
- [9 · Step 5 · Build the second carriage](#9--step-5--build-the-second-carriage)
- [10 · Step 6 · X motor onto its plate](#10--step-6--x-motor-onto-its-plate)
- [11 · Step 7 · Pulley onto the shaft](#11--step-7--pulley-onto-the-shaft)
- [12 · Step 8 · Motor onto the rail's left end](#12--step-8--motor-onto-the-rails-left-end)
- [13 · Step 9 · Idler at the far end](#13--step-9--idler-at-the-far-end)
- [14 · Step 10 · Belt and clamps](#14--step-10--belt-and-clamps)
- [15 · Step 11 · Nut block onto the Z carriage](#15--step-11--nut-block-onto-the-z-carriage)
- [16 · Step 12 · Lead screw through the nut](#16--step-12--lead-screw-through-the-nut)
- [17 · Step 13 · Top end · the screw hangs here](#17--step-13--top-end--the-screw-hangs-here)
- [18 · Step 14 · Foot · braked motor and coupler](#18--step-14--foot--braked-motor-and-coupler)
- [19 · Step 15 · Limit switches · all four](#19--step-15--limit-switches--all-four)
- [20 · Step 16 · Controller on standoffs](#20--step-16--controller-on-standoffs)
- [21 · Wiring · power and the safety relay](#21--wiring--power-and-the-safety-relay)
- [22 · Wiring · controller, motors, brake, limits](#22--wiring--controller-motors-brake-limits)
- [23 · Step 17 · First motion, before the arm](#23--step-17--first-motion-before-the-arm)
- [24 · Step 18 · Arm plate onto the Z carriage](#24--step-18--arm-plate-onto-the-z-carriage)
- [25 · Step 19 · The arm, last](#25--step-19--the-arm-last)
- [26 · Step 20 · Before you trust it](#26--step-20--before-you-trust-it)
- [27 · Step 21 · The cabinet the gantry lands on](#27--step-21--the-cabinet-the-gantry-lands-on)
- [28 · Step 22 · Why the cabinet got deeper](#28--step-22--why-the-cabinet-got-deeper)
- [29 · Step 23 · X rail onto the rear uprights](#29--step-23--x-rail-onto-the-rear-uprights)
- [30 · Step 24 · Hang the Z mast](#30--step-24--hang-the-z-mast)
- [31 · Step 25 · The Z drive, installed](#31--step-25--the-z-drive-installed)
- [32 · Step 26 · Z carriage, arm plate, arm](#32--step-26--z-carriage-arm-plate-arm)
- [33 · Step 27 · Commissioned](#33--step-27--commissioned)

</details>

---

### 1 · Cover

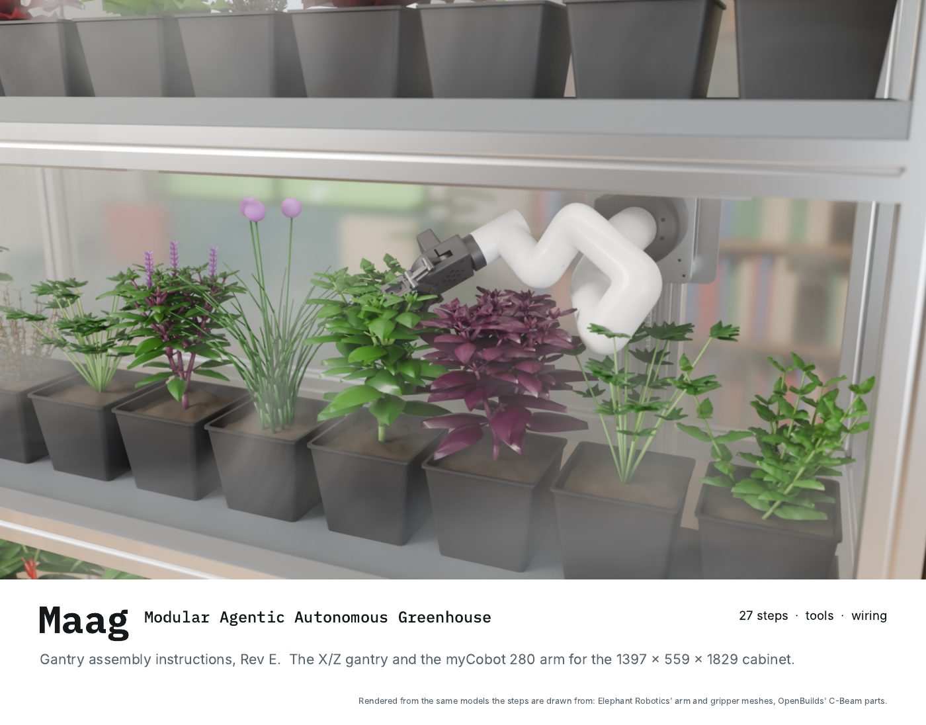
[picture p186: docs/booklets/gantry/p01.jpg]
Gantry Rev E, page 1: Cover


### 2 · Gantry · parts

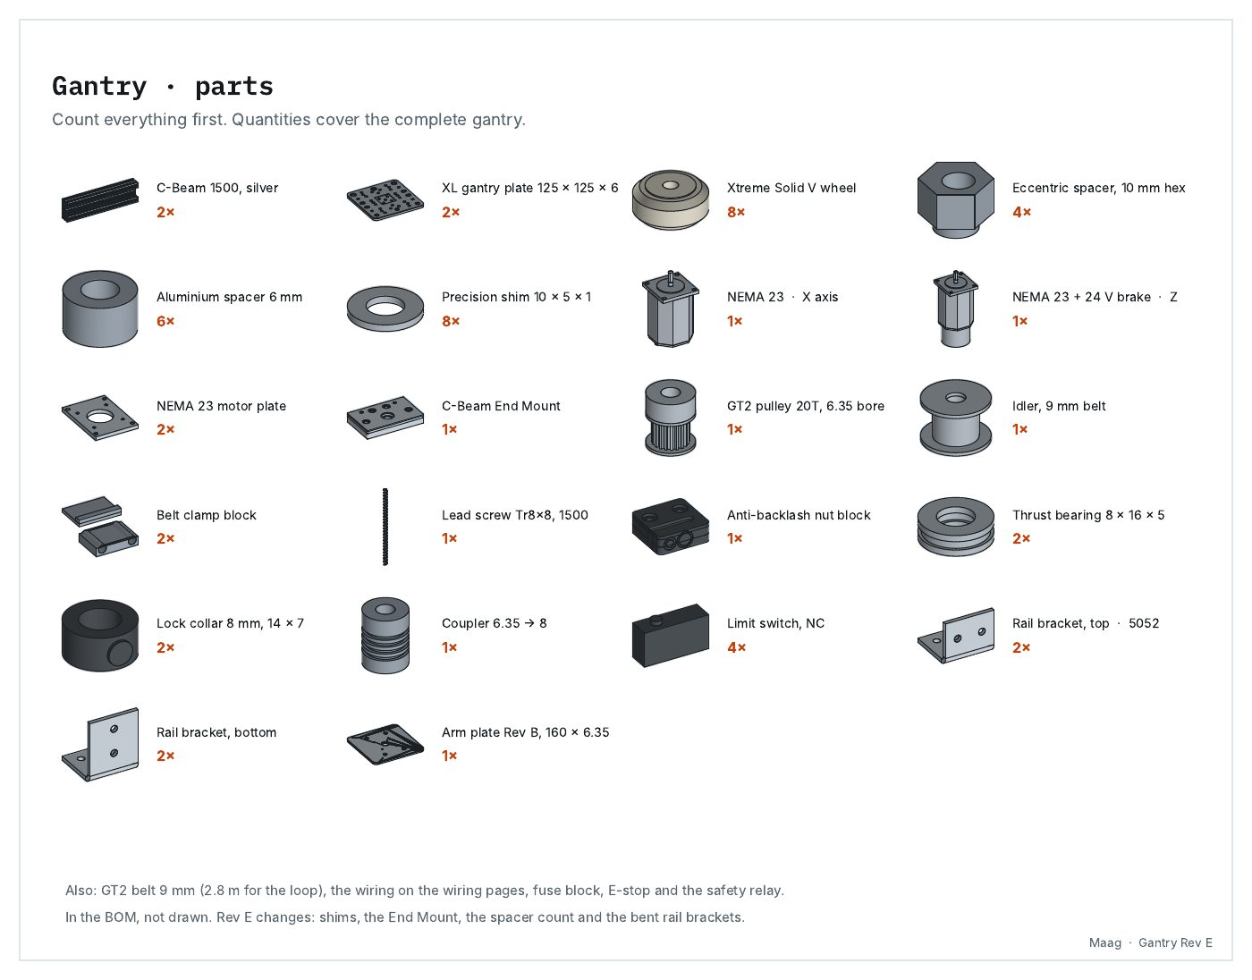
[picture p187: docs/booklets/gantry/p02.jpg]
Gantry Rev E, page 2: Gantry · parts


### 3 · Gantry · fasteners

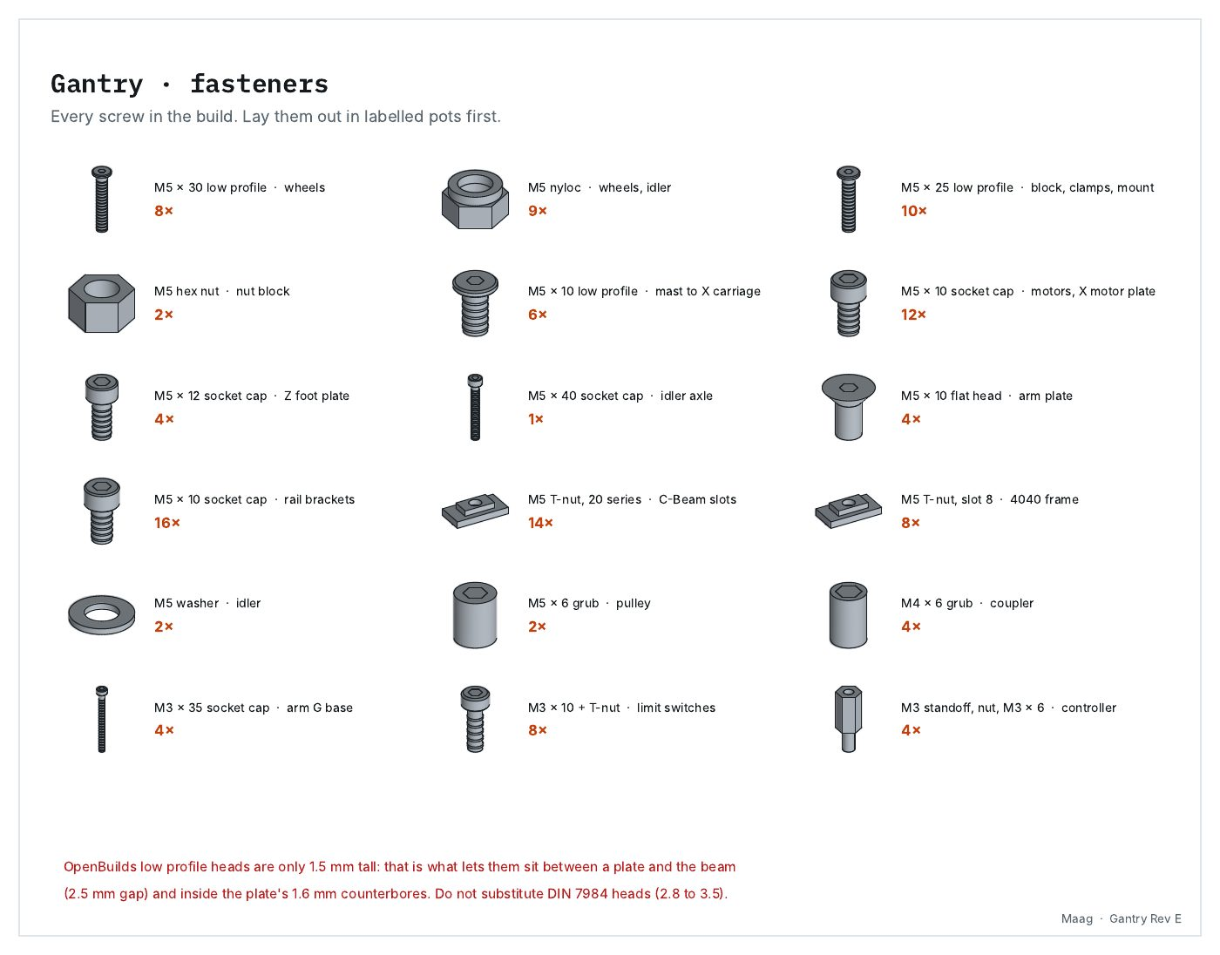
[picture p188: docs/booklets/gantry/p03.jpg]
Gantry Rev E, page 3: Gantry · fasteners


### 4 · Tools

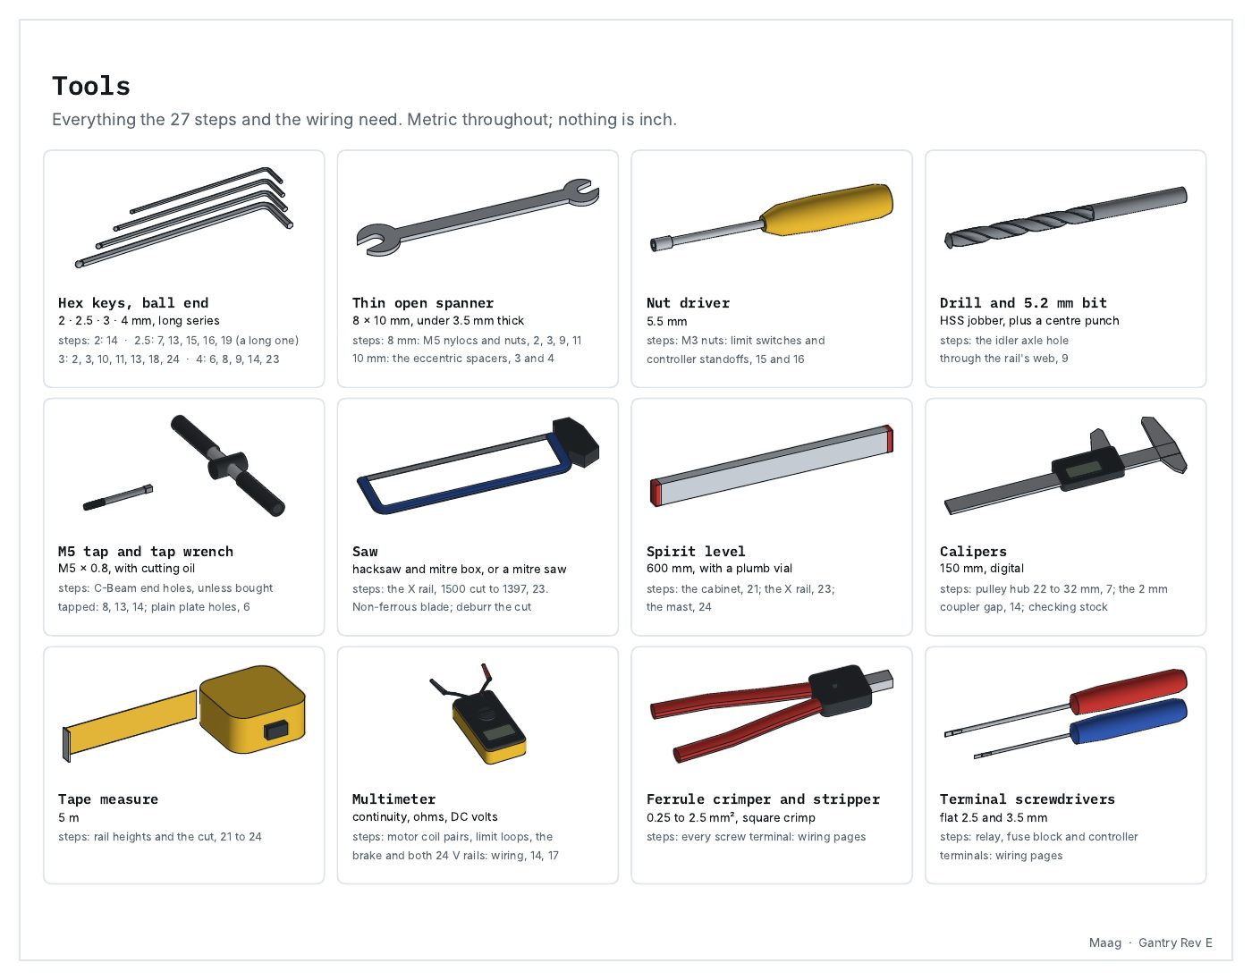
[picture p189: docs/booklets/gantry/p04.jpg]
Gantry Rev E, page 4: Tools


### 5 · Step 1 · Know your plate

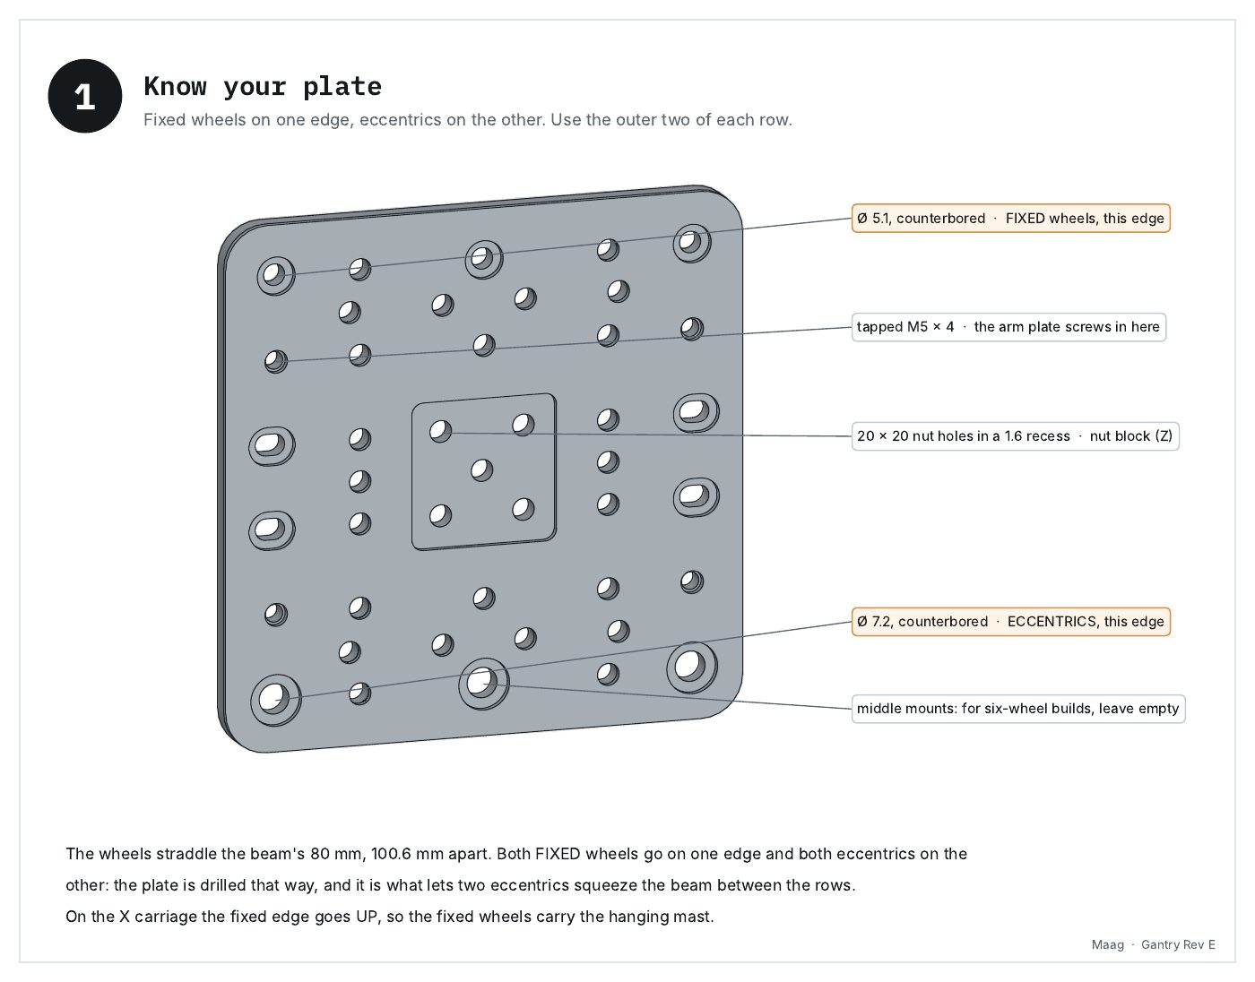
[picture p190: docs/booklets/gantry/p05.jpg]
Gantry Rev E, page 5: Know your plate


### 6 · Step 2 · Fixed wheels · the stack

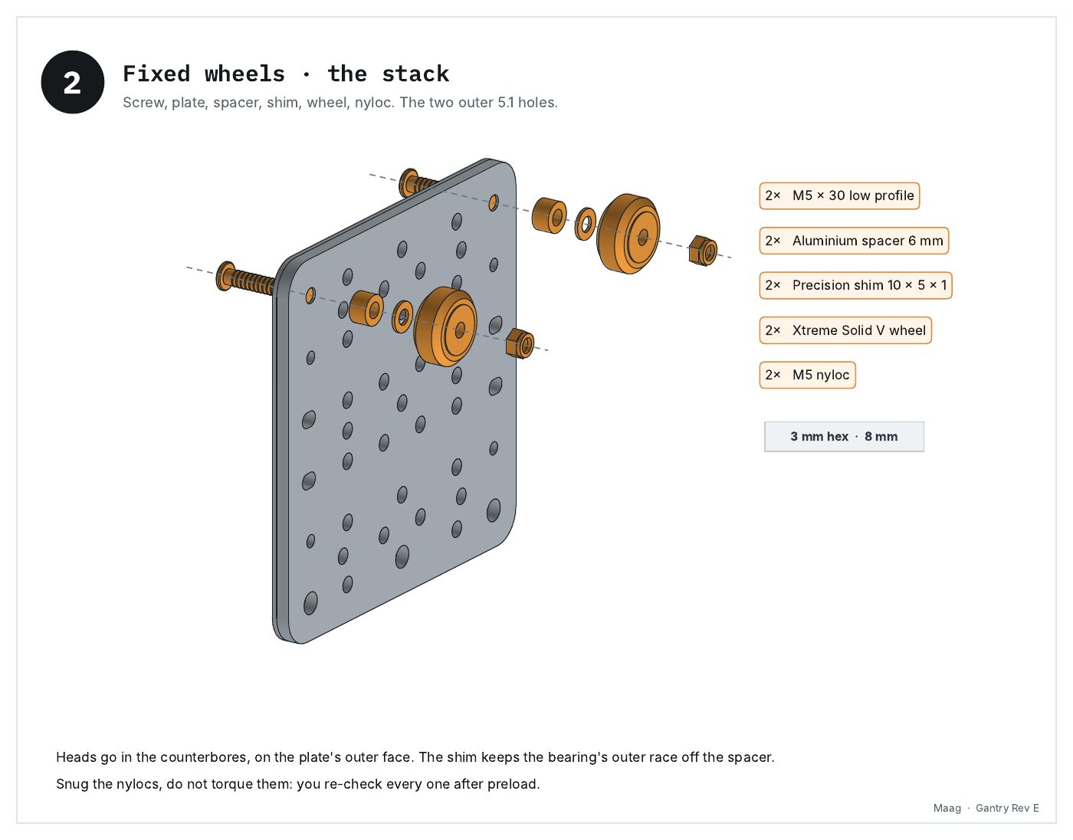
[picture p191: docs/booklets/gantry/p06.jpg]
Gantry Rev E, page 6: Fixed wheels · the stack


### 7 · Step 3 · Eccentric wheels

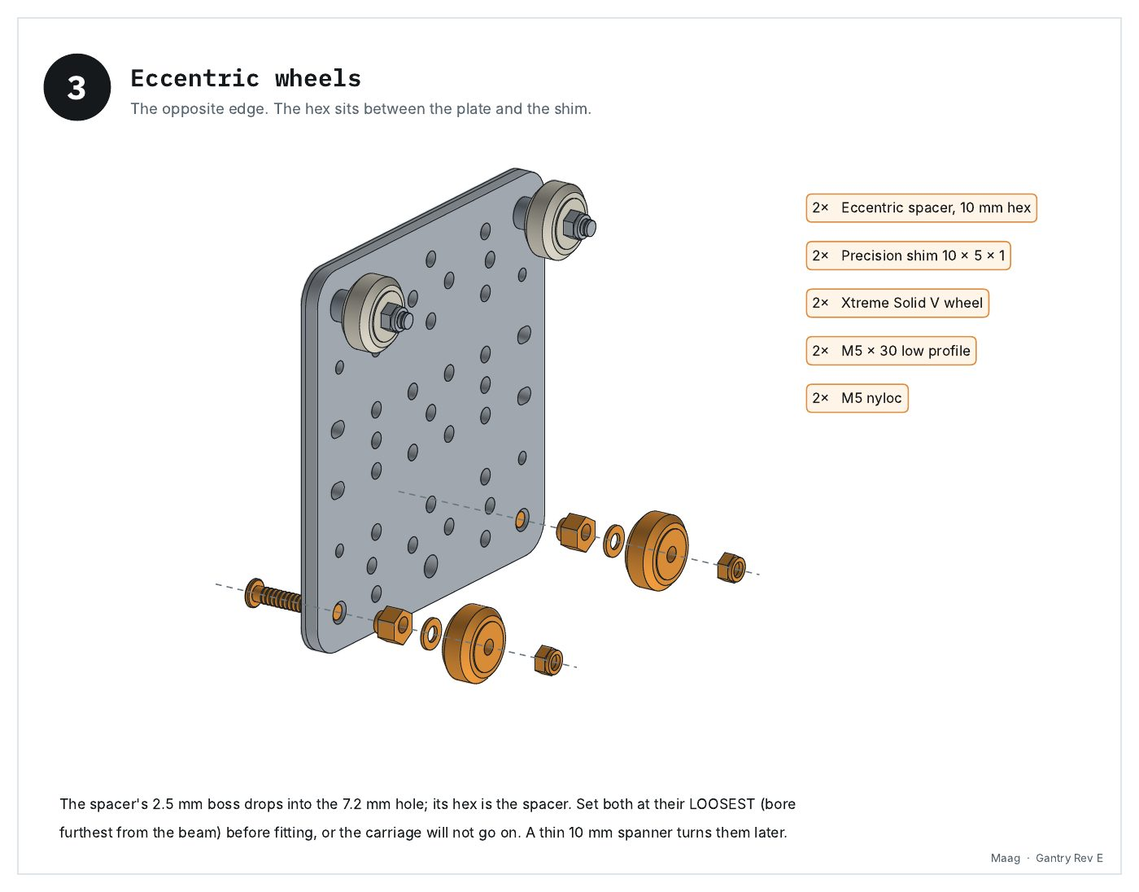
[picture p192: docs/booklets/gantry/p07.jpg]
Gantry Rev E, page 7: Eccentric wheels


### 8 · Step 4 · Onto the rail, then set the preload

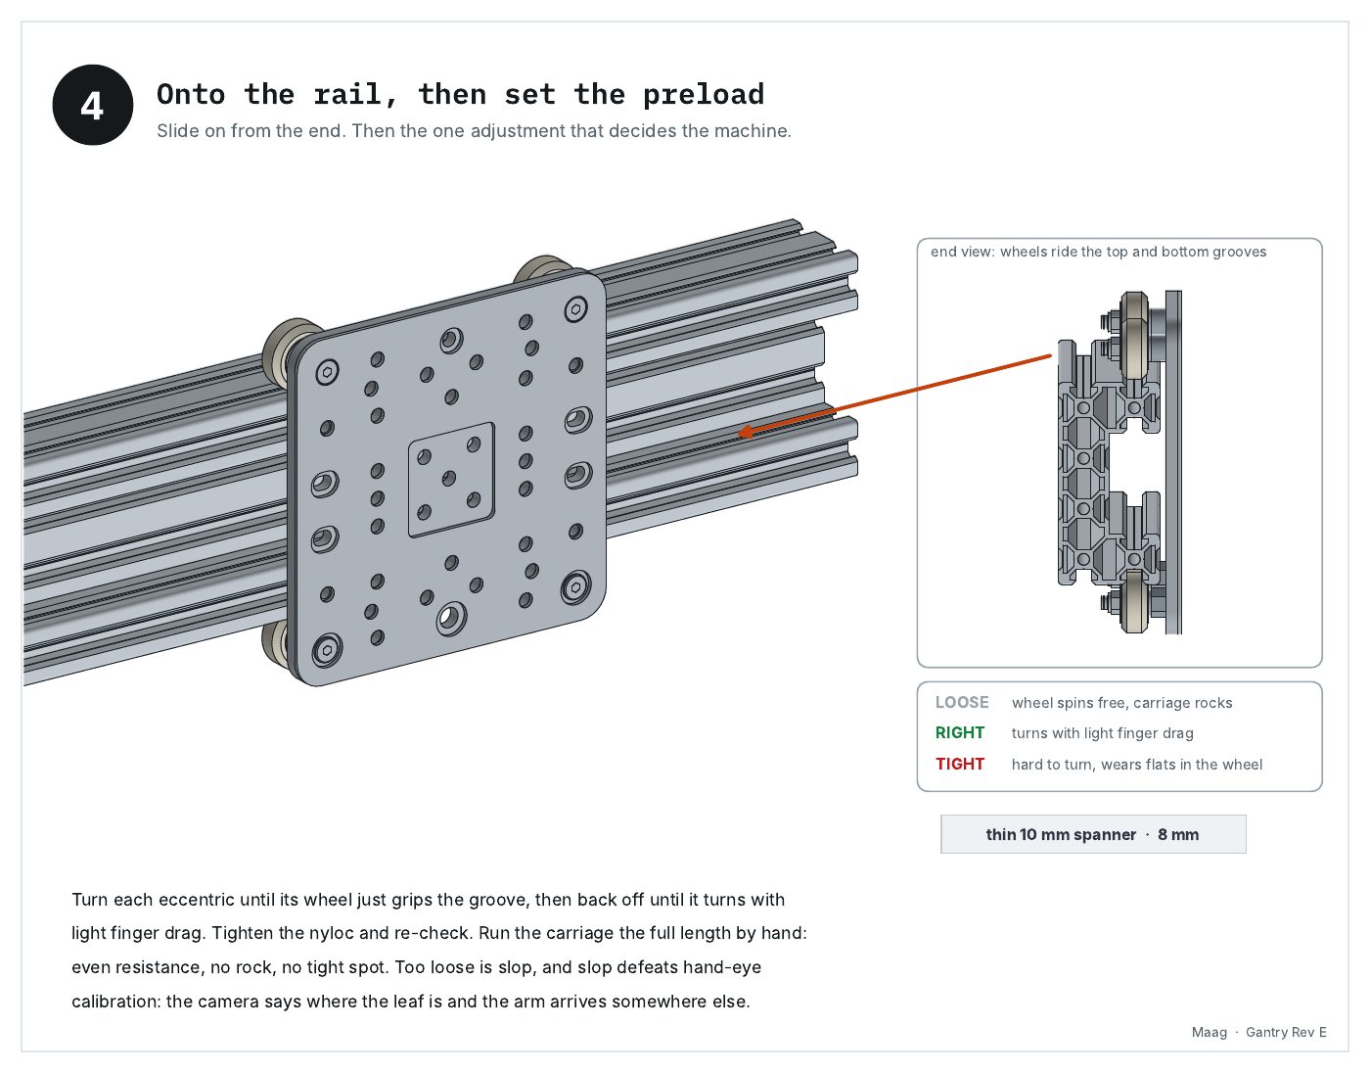
[picture p193: docs/booklets/gantry/p08.jpg]
Gantry Rev E, page 8: Onto the rail, then set the preload


### 9 · Step 5 · Build the second carriage

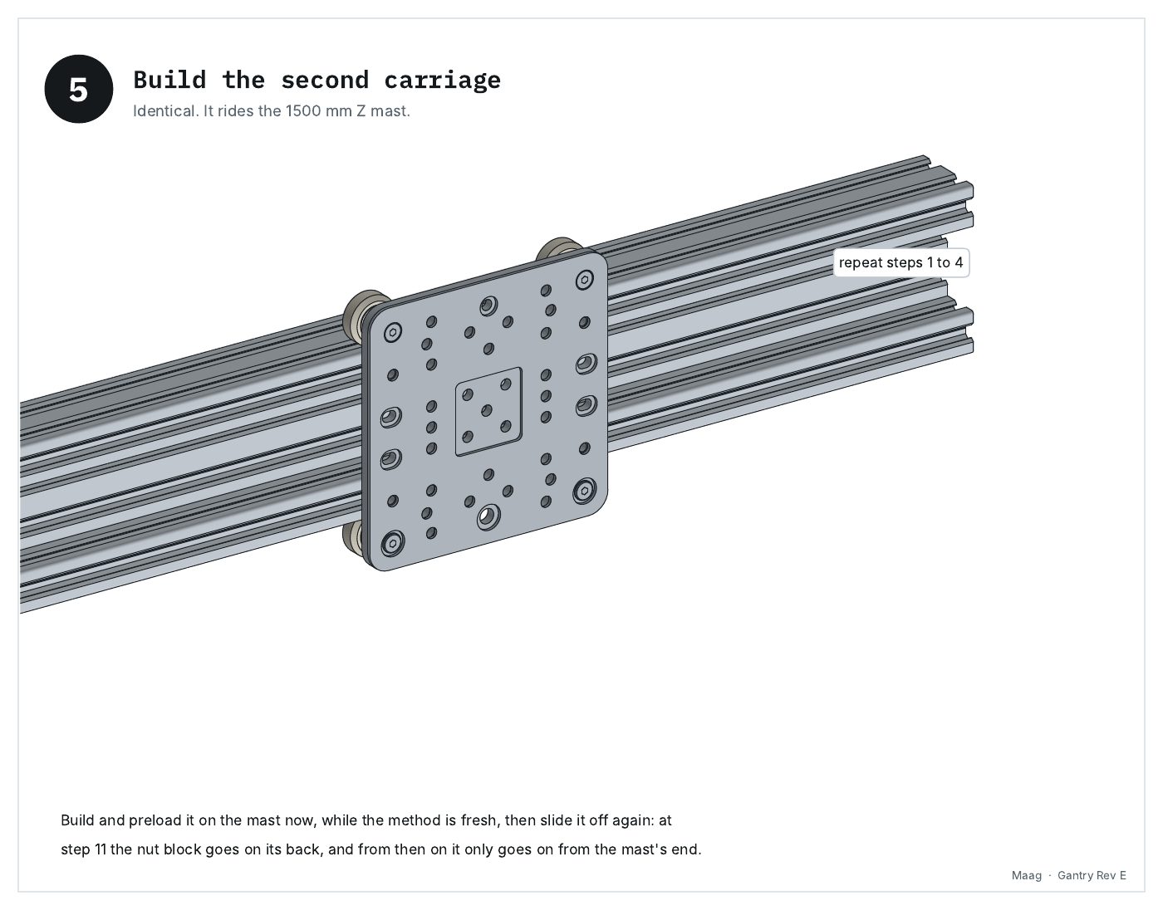
[picture p194: docs/booklets/gantry/p09.jpg]
Gantry Rev E, page 9: Build the second carriage


### 10 · Step 6 · X motor onto its plate

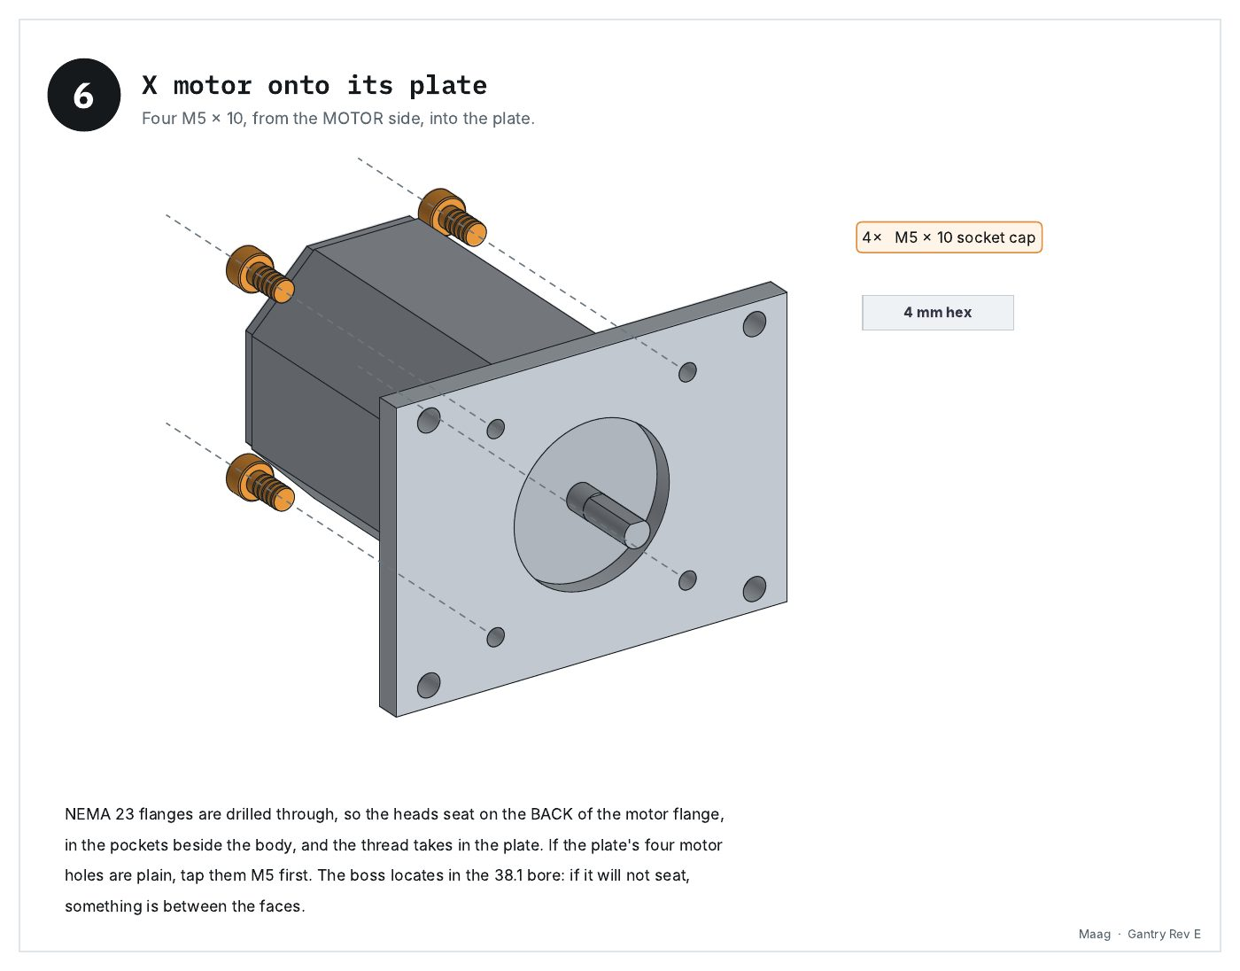
[picture p195: docs/booklets/gantry/p10.jpg]
Gantry Rev E, page 10: X motor onto its plate


### 11 · Step 7 · Pulley onto the shaft

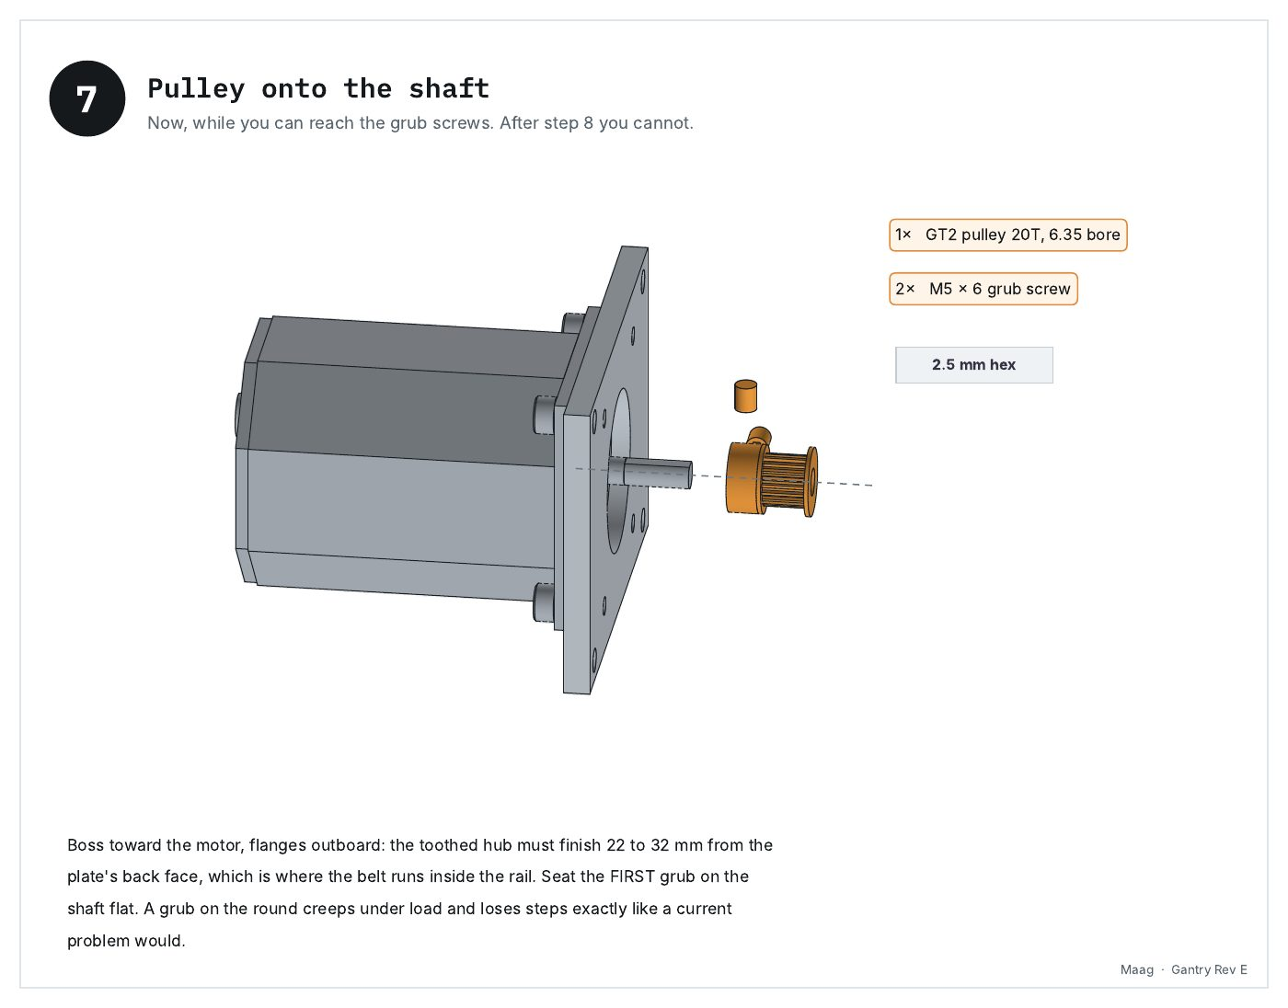
[picture p196: docs/booklets/gantry/p11.jpg]
Gantry Rev E, page 11: Pulley onto the shaft


### 12 · Step 8 · Motor onto the rail's left end

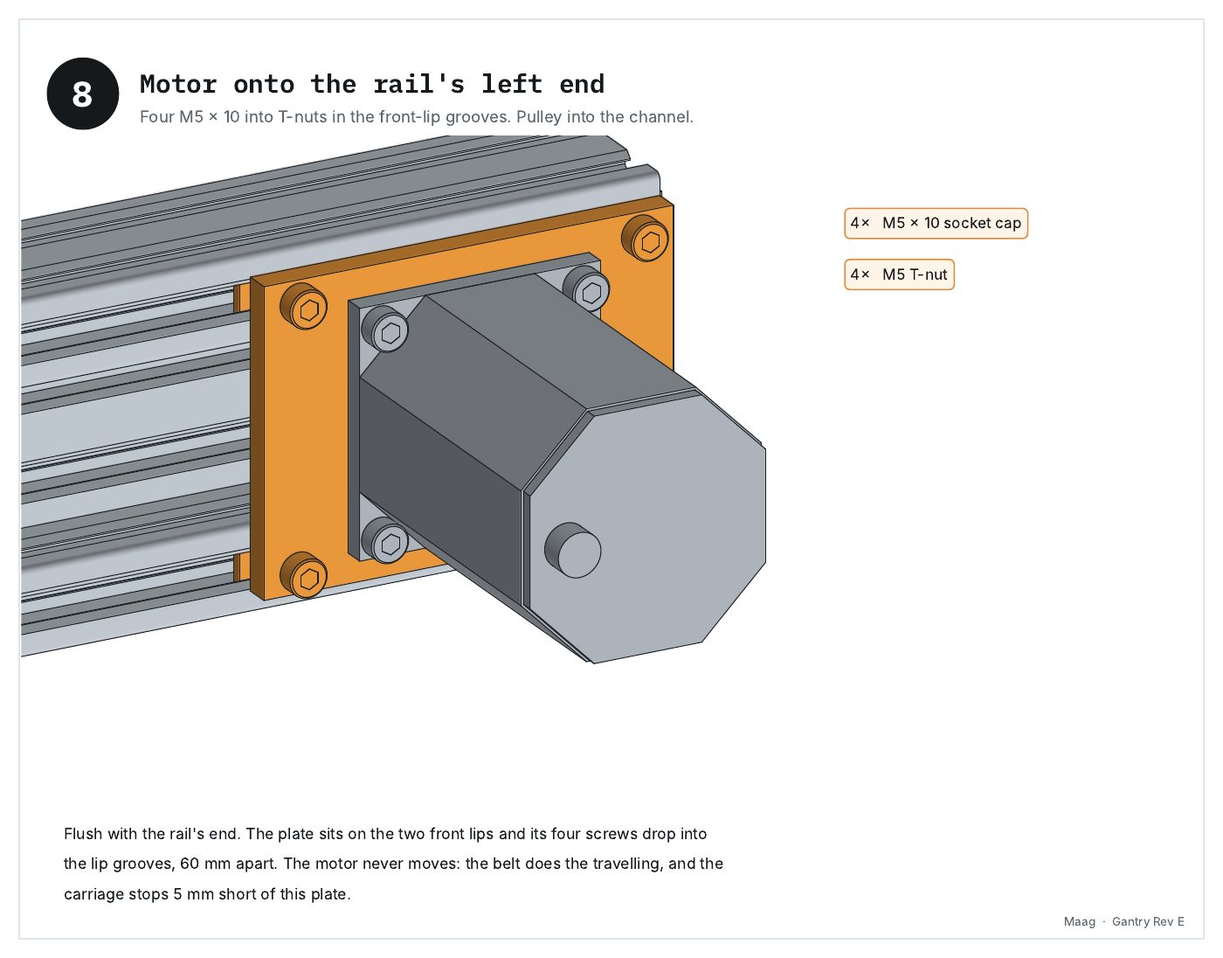
[picture p197: docs/booklets/gantry/p12.jpg]
Gantry Rev E, page 12: Motor onto the rail's left end


### 13 · Step 9 · Idler at the far end

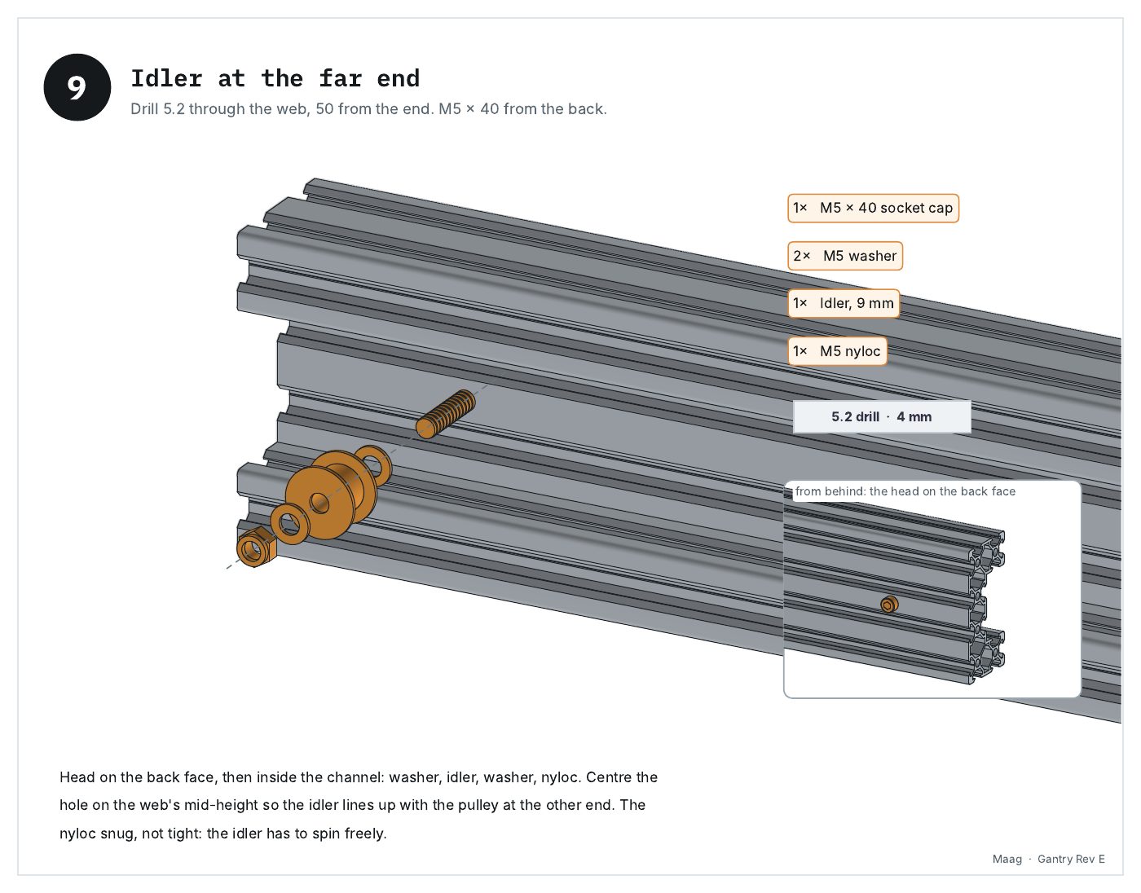
[picture p198: docs/booklets/gantry/p13.jpg]
Gantry Rev E, page 13: Idler at the far end


### 14 · Step 10 · Belt and clamps

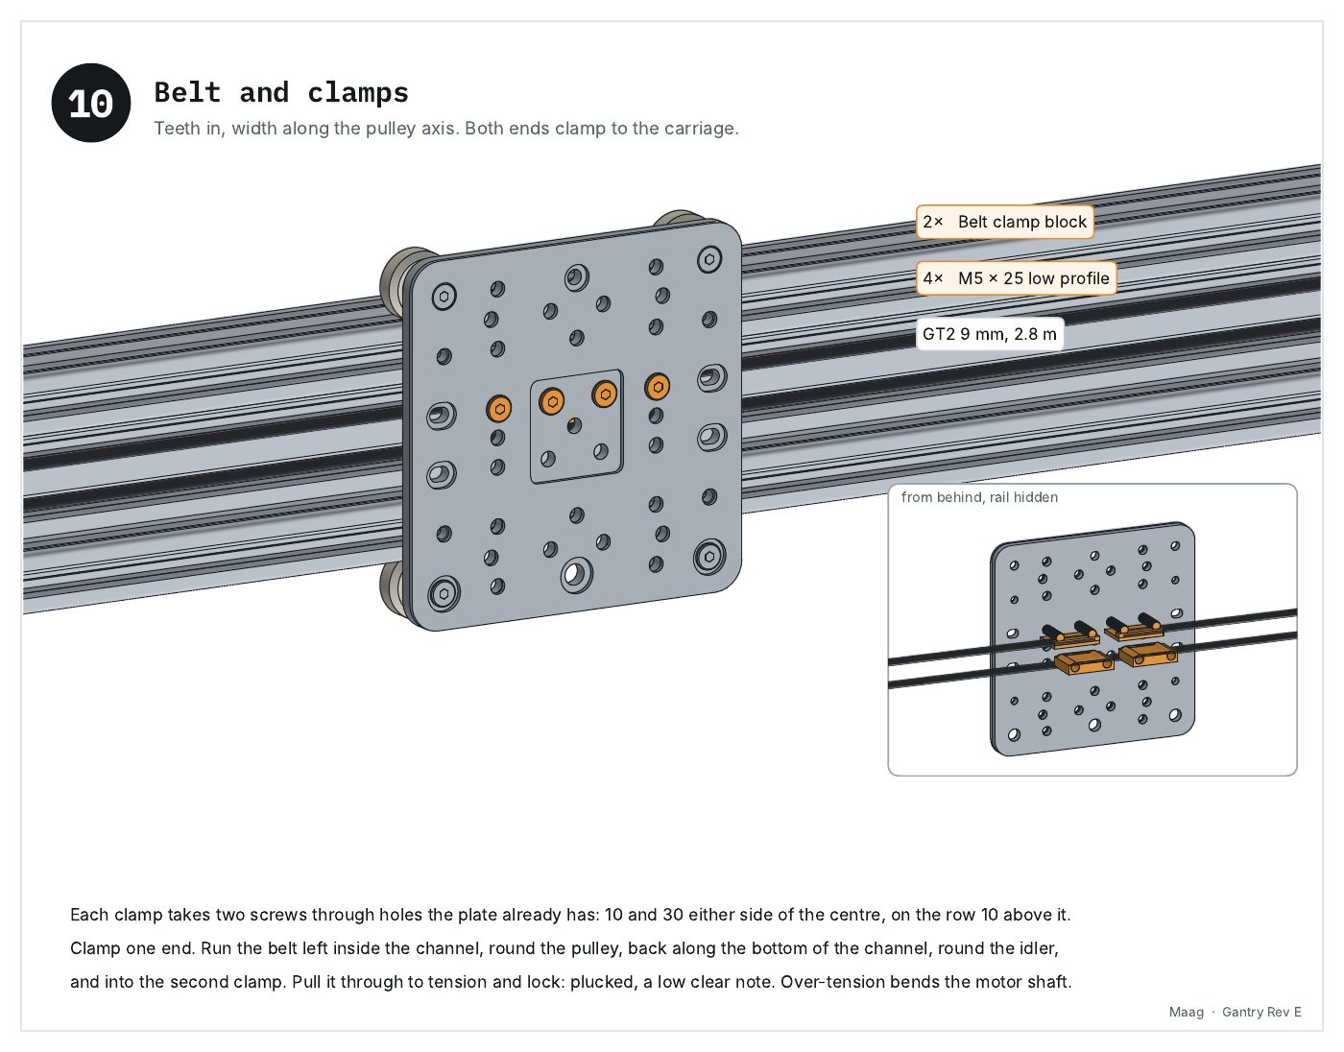
[picture p199: docs/booklets/gantry/p14.jpg]
Gantry Rev E, page 14: Belt and clamps


### 15 · Step 11 · Nut block onto the Z carriage

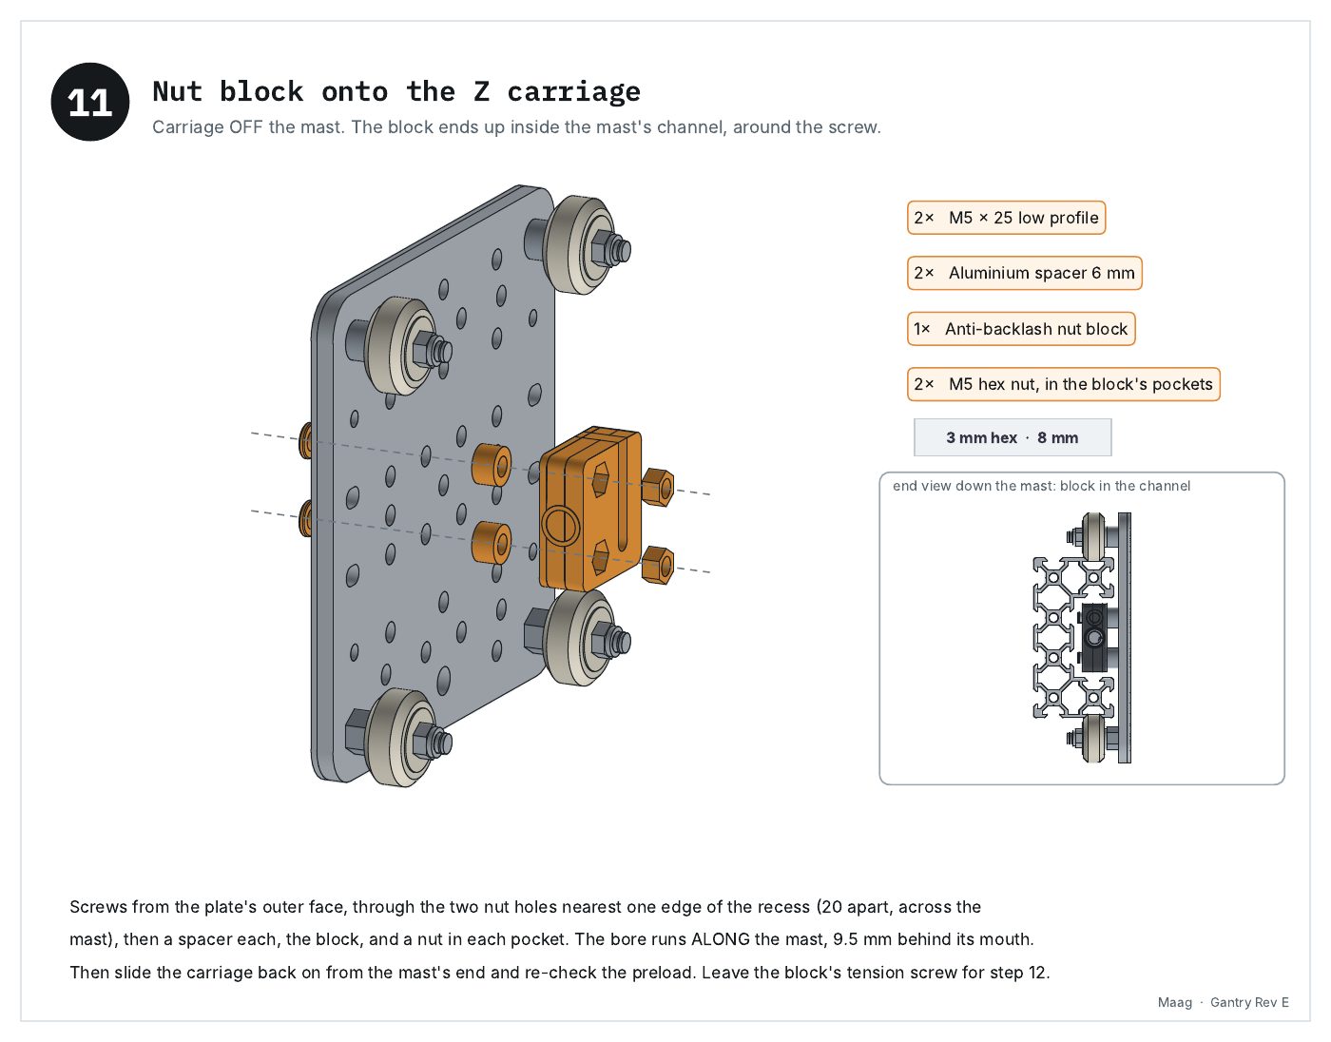
[picture p200: docs/booklets/gantry/p15.jpg]
Gantry Rev E, page 15: Nut block onto the Z carriage


### 16 · Step 12 · Lead screw through the nut

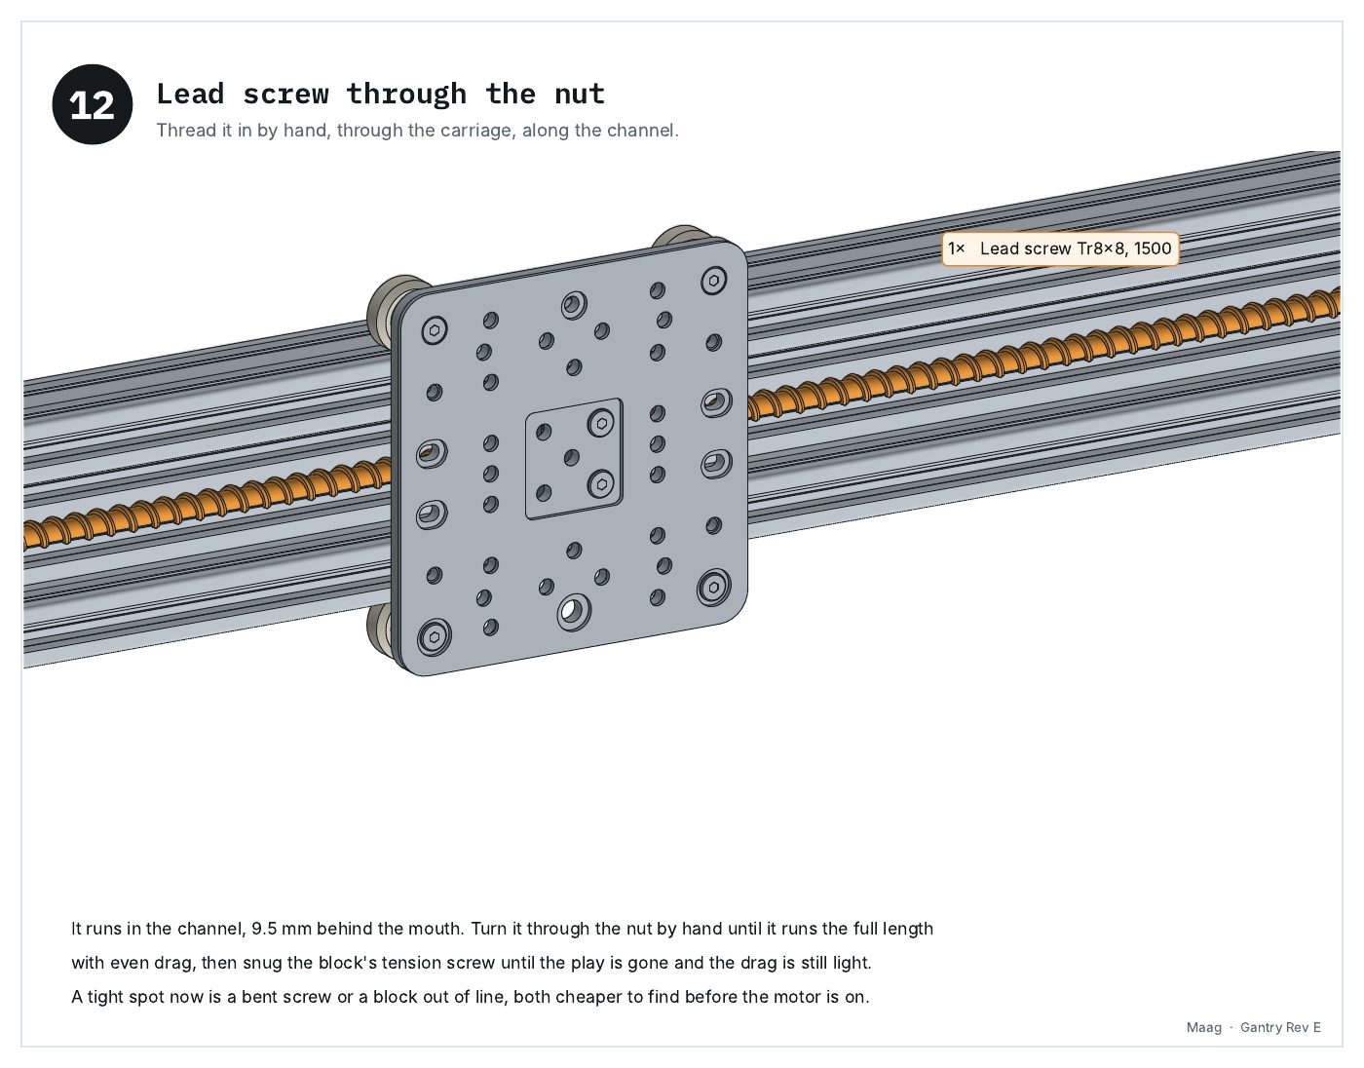
[picture p201: docs/booklets/gantry/p16.jpg]
Gantry Rev E, page 16: Lead screw through the nut


### 17 · Step 13 · Top end · the screw hangs here

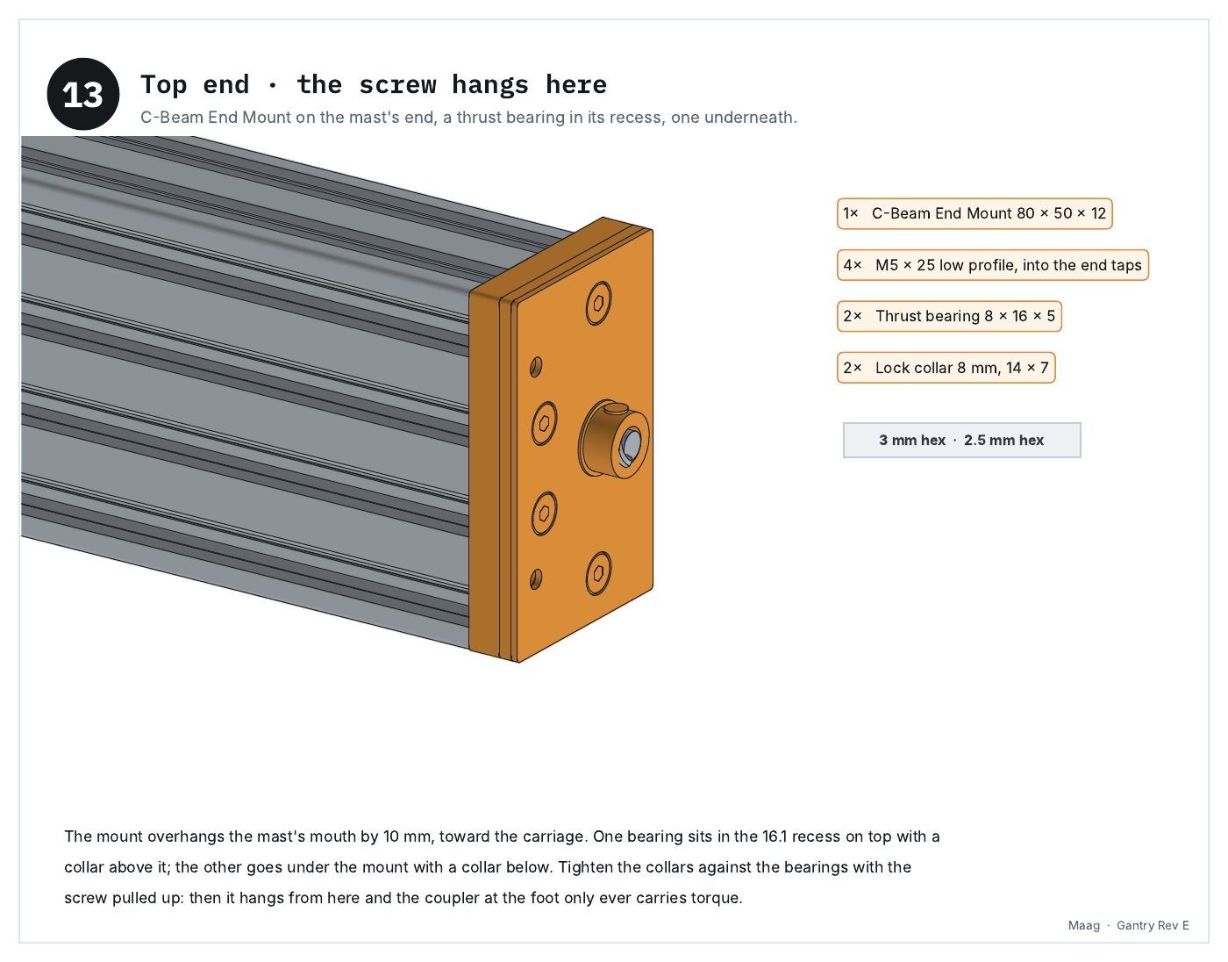
[picture p202: docs/booklets/gantry/p17.jpg]
Gantry Rev E, page 17: Top end · the screw hangs here


### 18 · Step 14 · Foot · braked motor and coupler

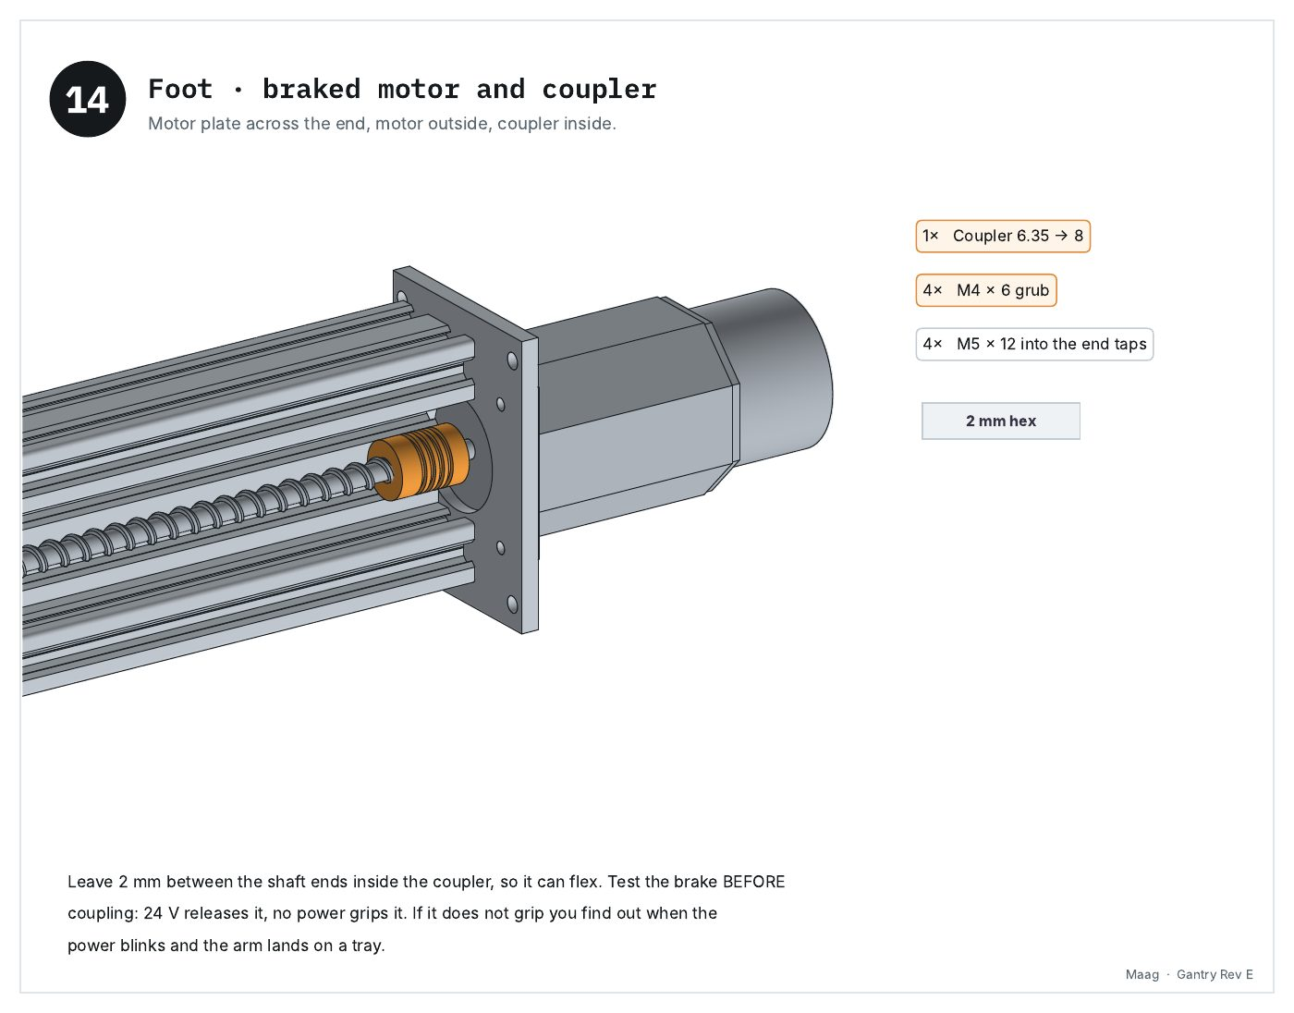
[picture p203: docs/booklets/gantry/p18.jpg]
Gantry Rev E, page 18: Foot · braked motor and coupler


### 19 · Step 15 · Limit switches · all four

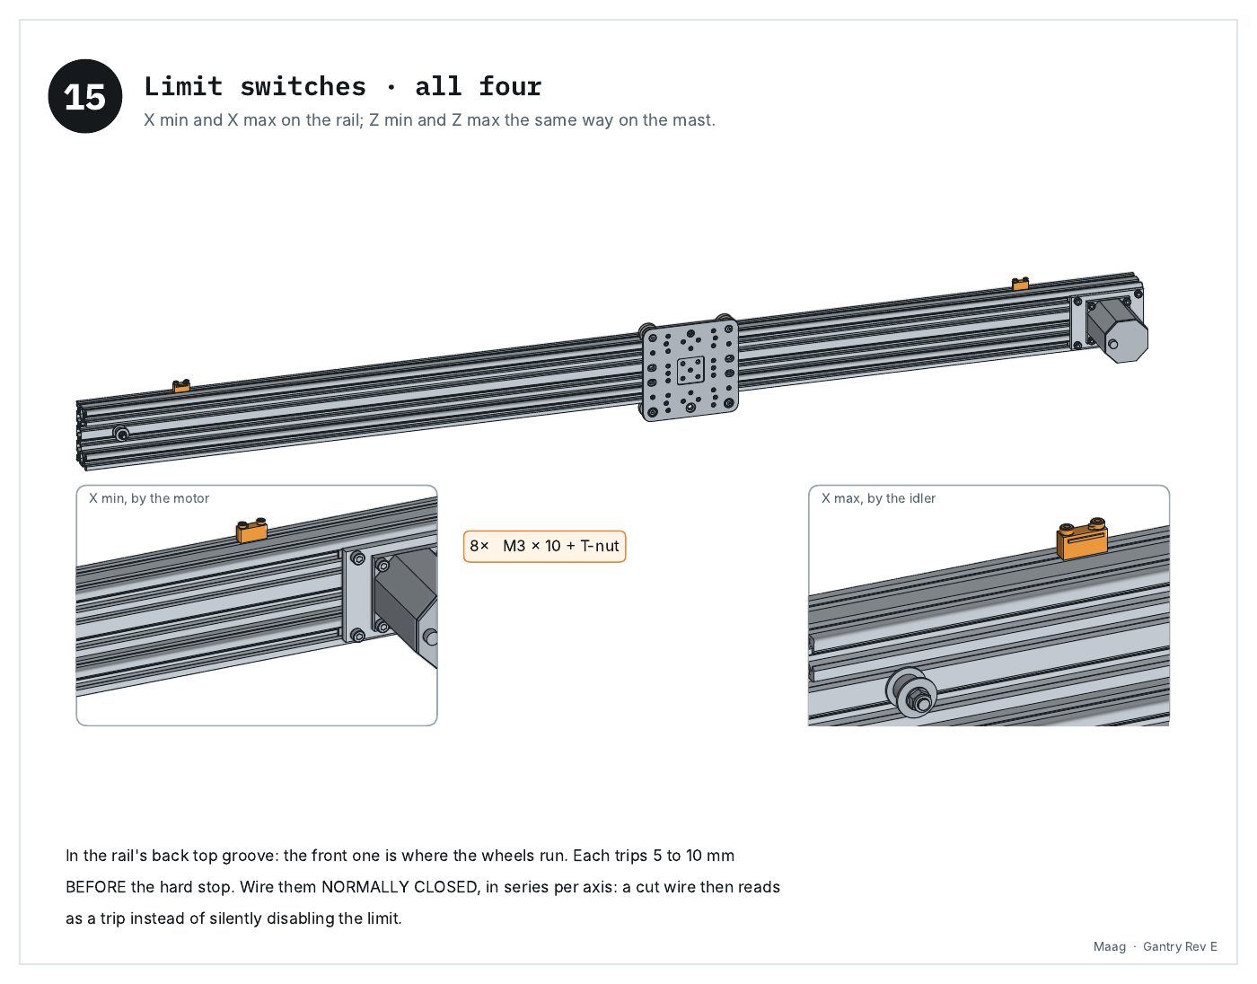
[picture p204: docs/booklets/gantry/p19.jpg]
Gantry Rev E, page 19: Limit switches · all four


### 20 · Step 16 · Controller on standoffs

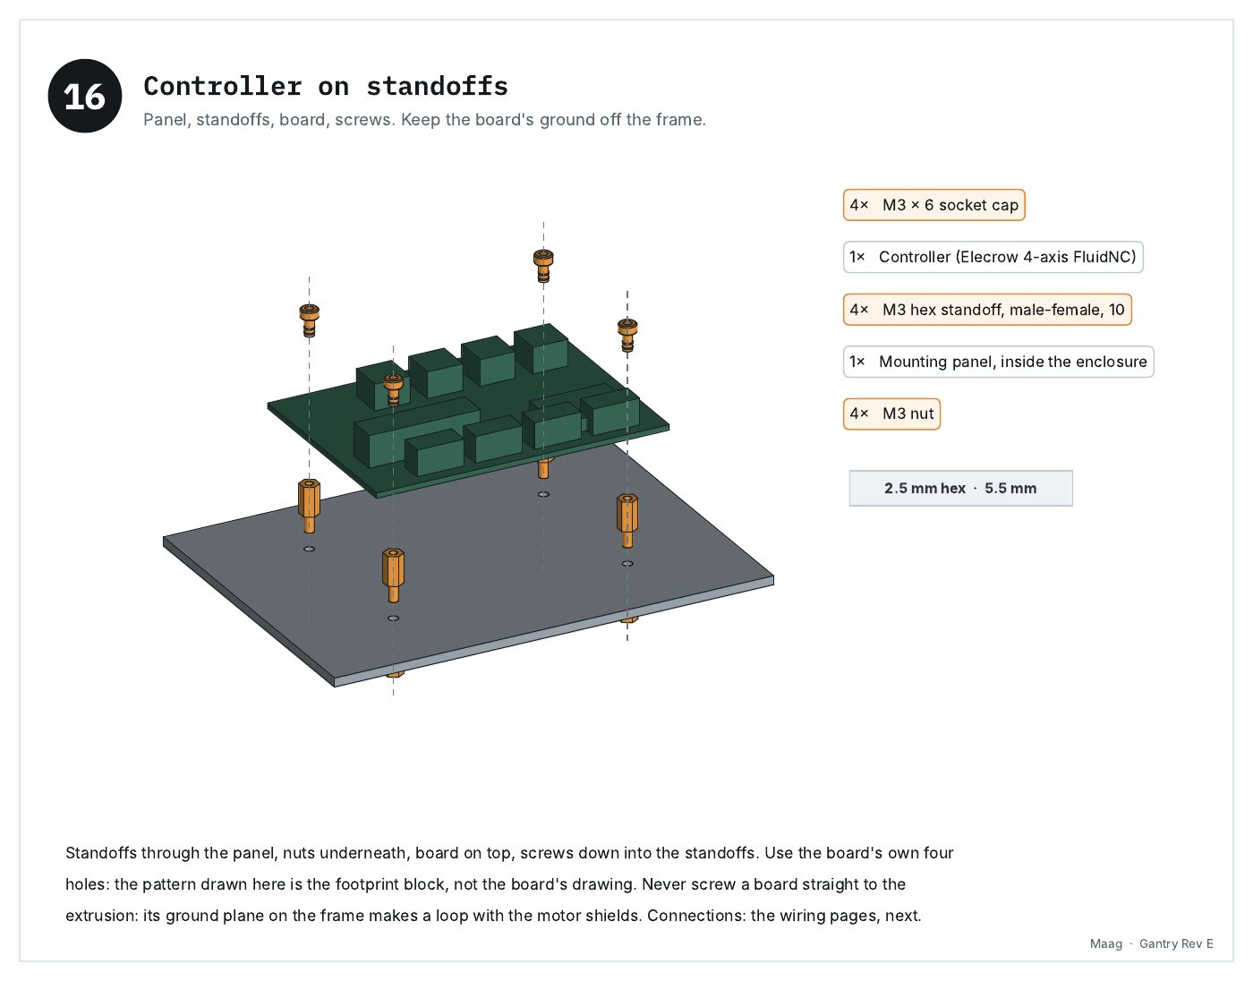
[picture p205: docs/booklets/gantry/p20.jpg]
Gantry Rev E, page 20: Controller on standoffs


### 21 · Wiring · power and the safety relay

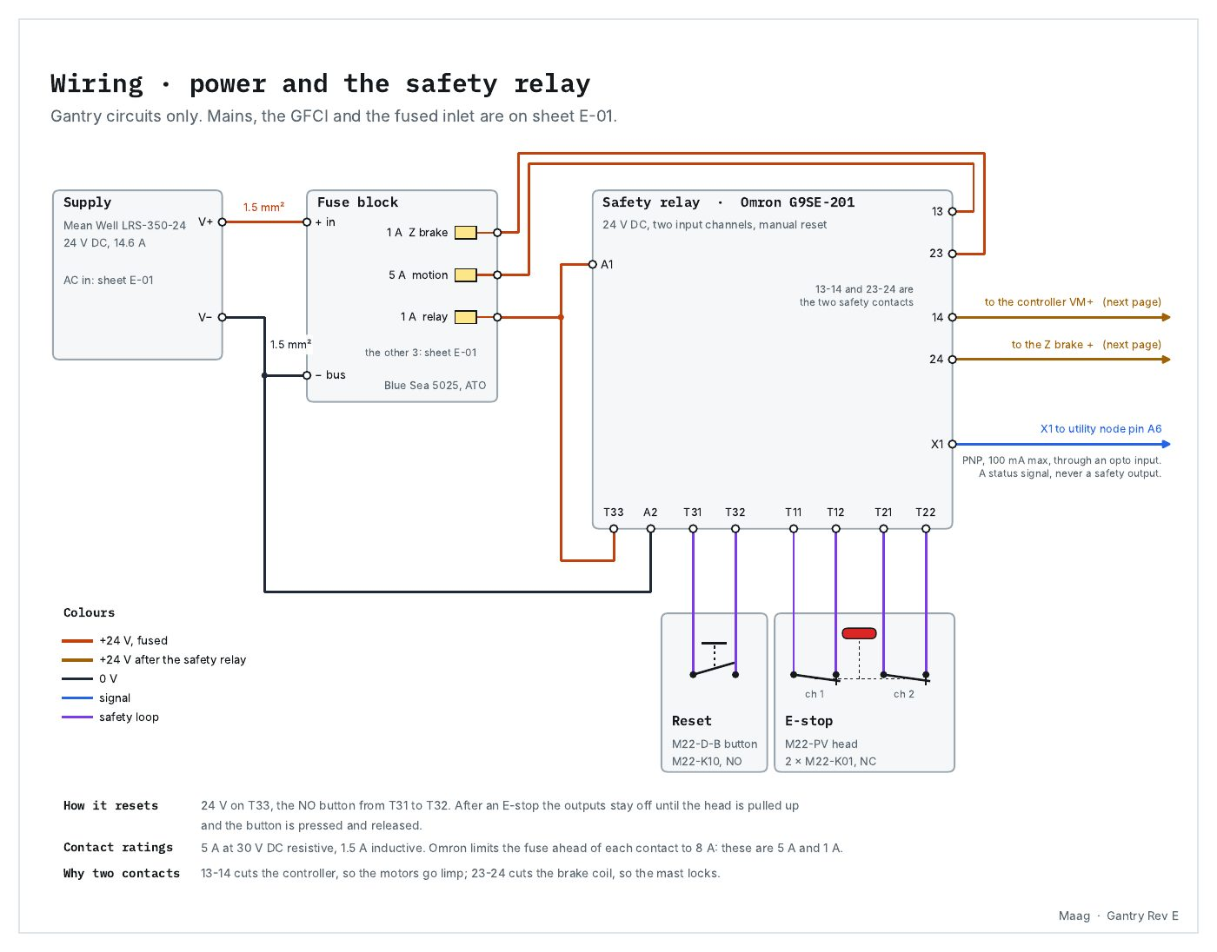
[picture p206: docs/booklets/gantry/p21.jpg]
Gantry Rev E, page 21: Wiring · power and the safety relay


### 22 · Wiring · controller, motors, brake, limits

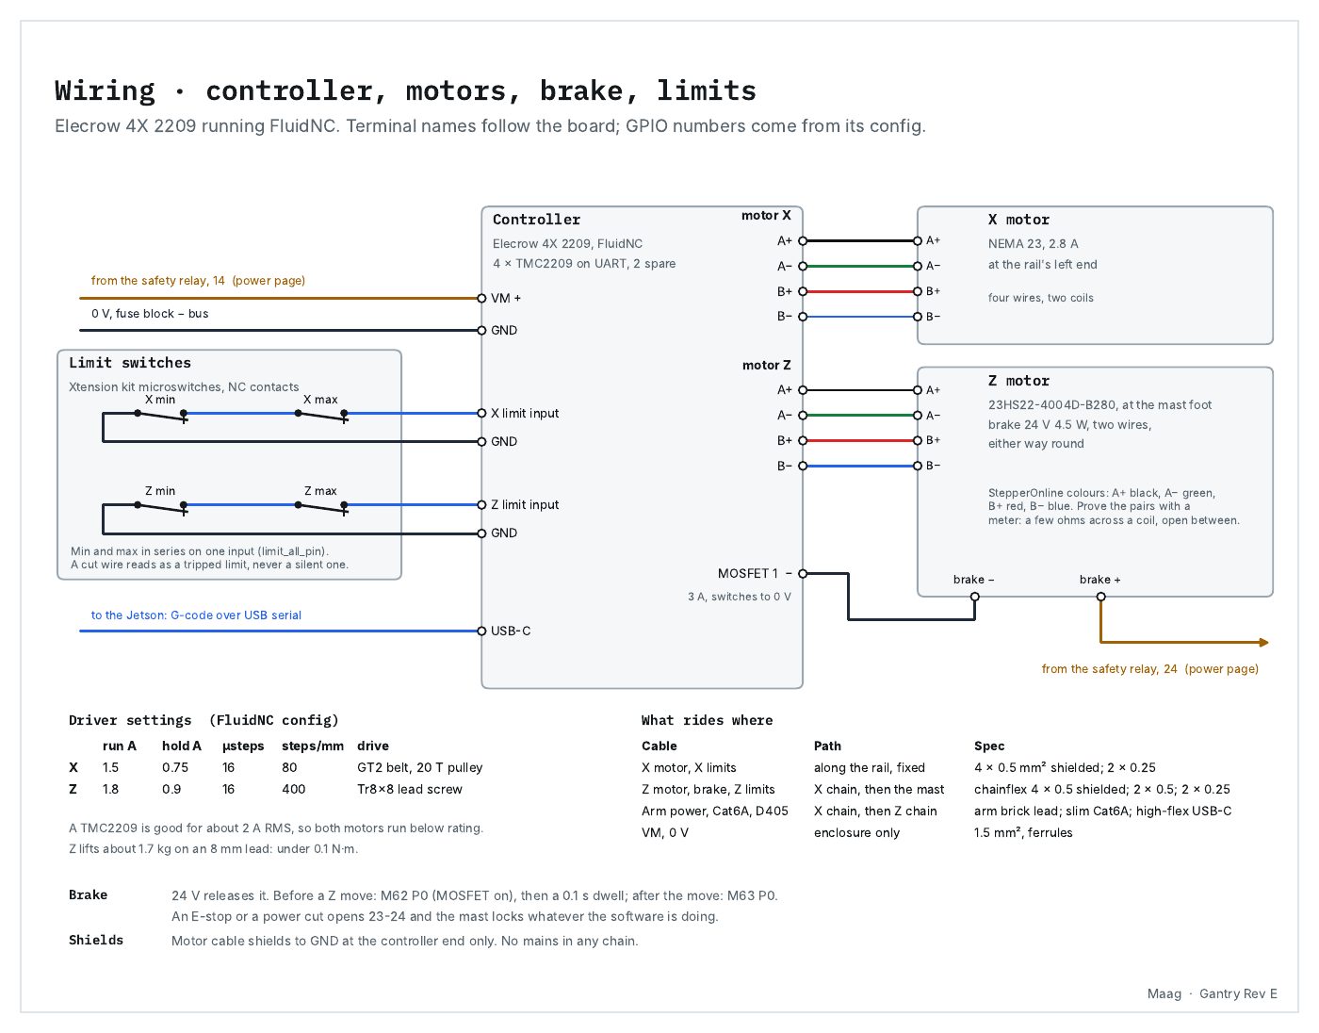
[picture p207: docs/booklets/gantry/p22.jpg]
Gantry Rev E, page 22: Wiring · controller, motors, brake, limits


### 23 · Step 17 · First motion, before the arm

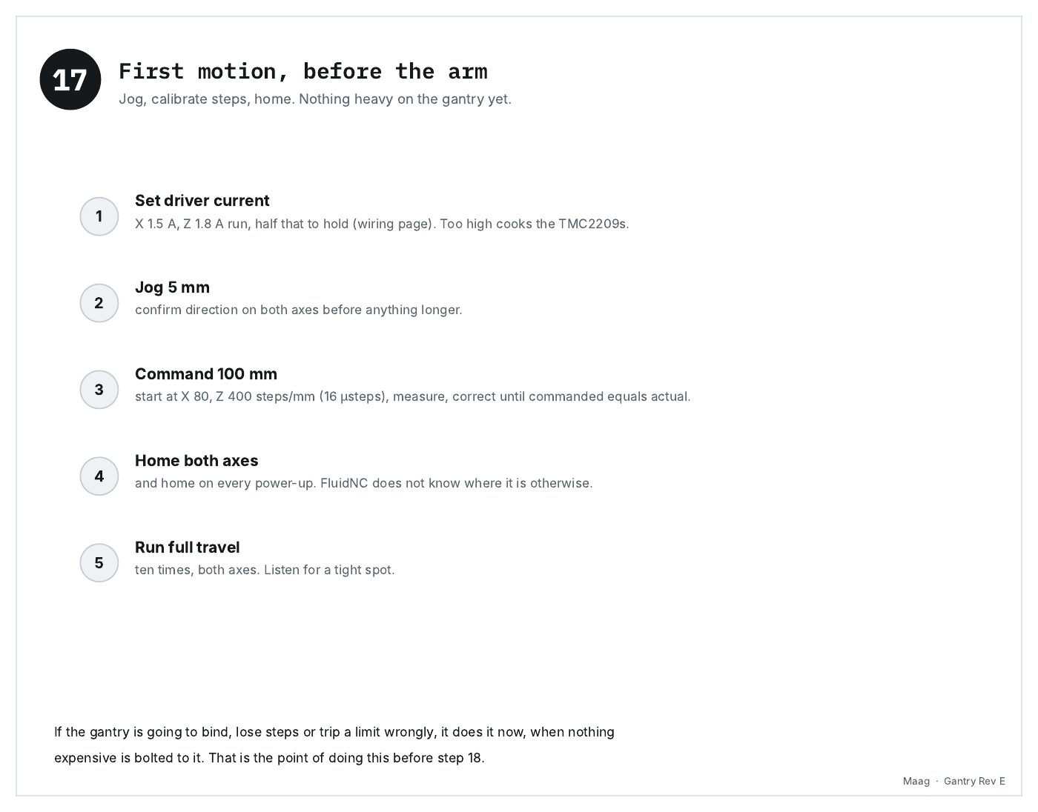
[picture p208: docs/booklets/gantry/p23.jpg]
Gantry Rev E, page 23: First motion, before the arm


### 24 · Step 18 · Arm plate onto the Z carriage

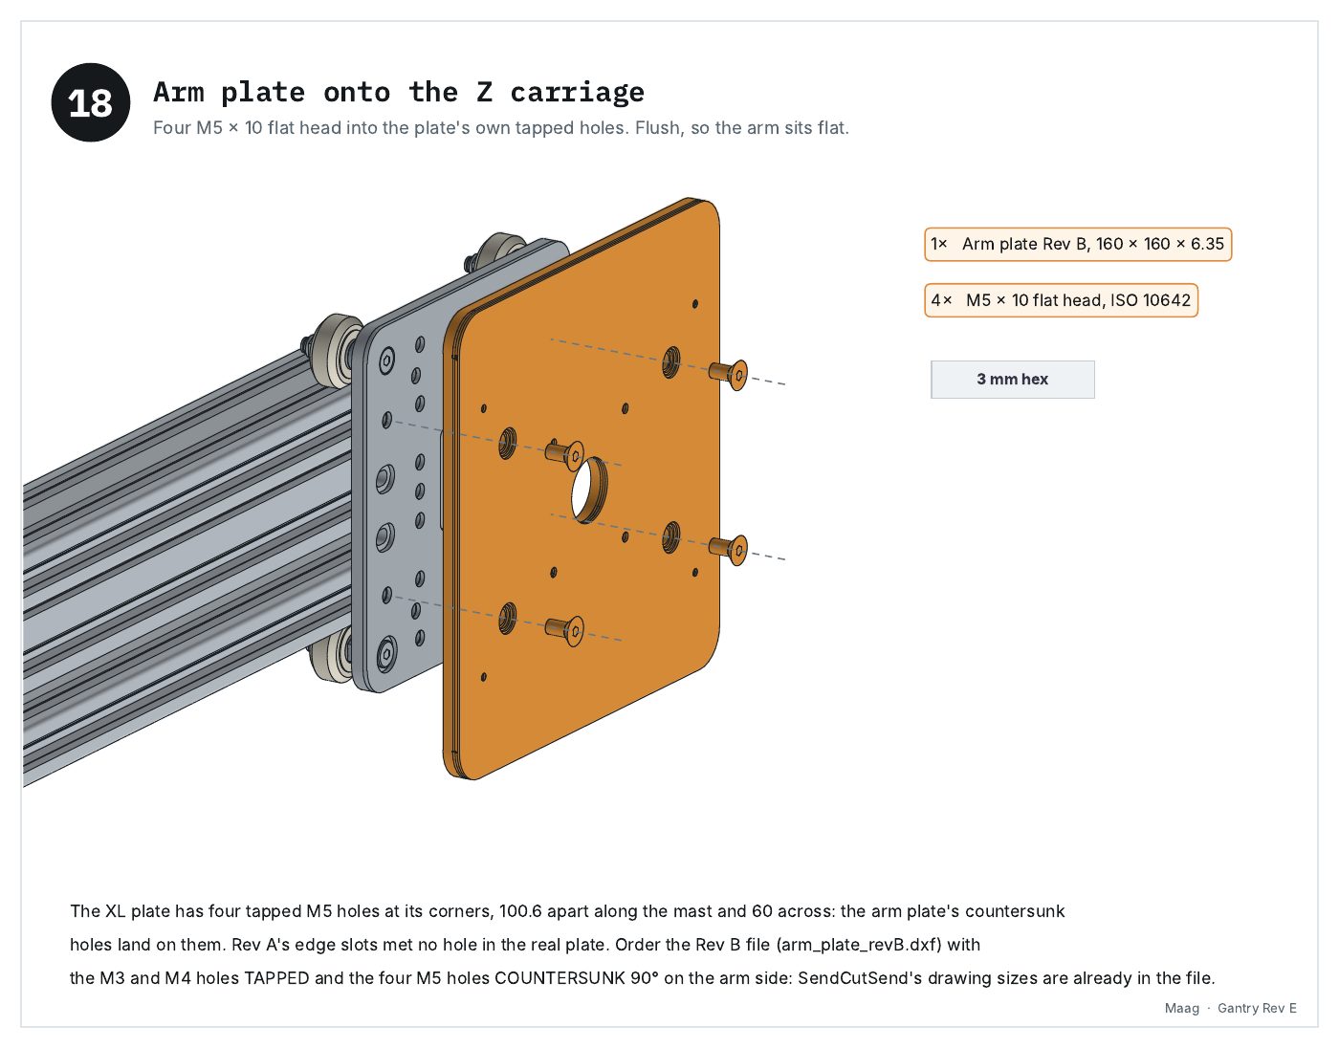
[picture p209: docs/booklets/gantry/p24.jpg]
Gantry Rev E, page 24: Arm plate onto the Z carriage


### 25 · Step 19 · The arm, last

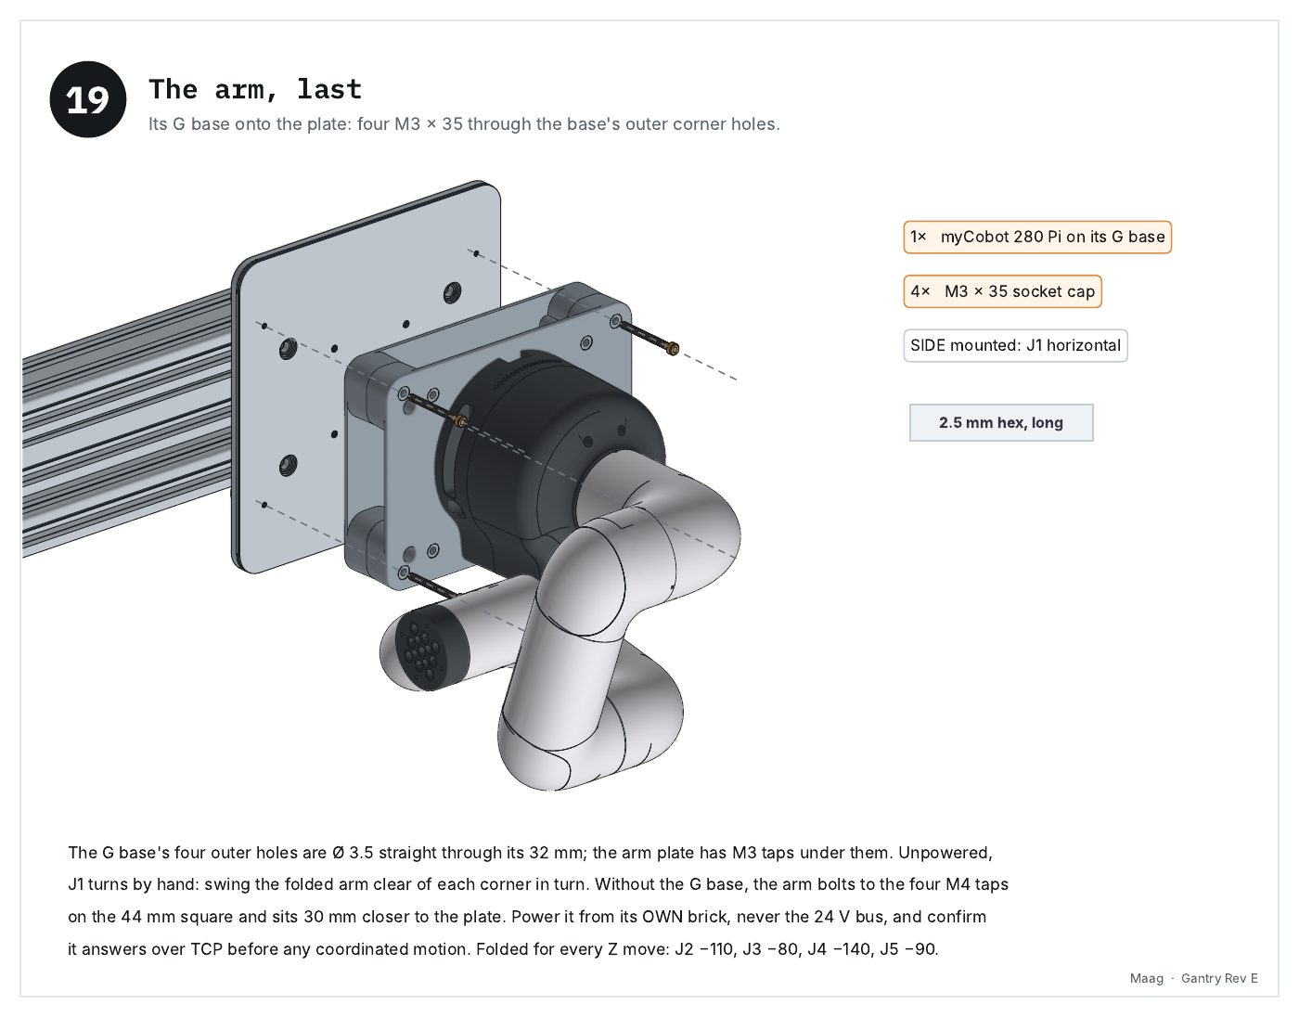
[picture p210: docs/booklets/gantry/p25.jpg]
Gantry Rev E, page 25: The arm, last


### 26 · Step 20 · Before you trust it

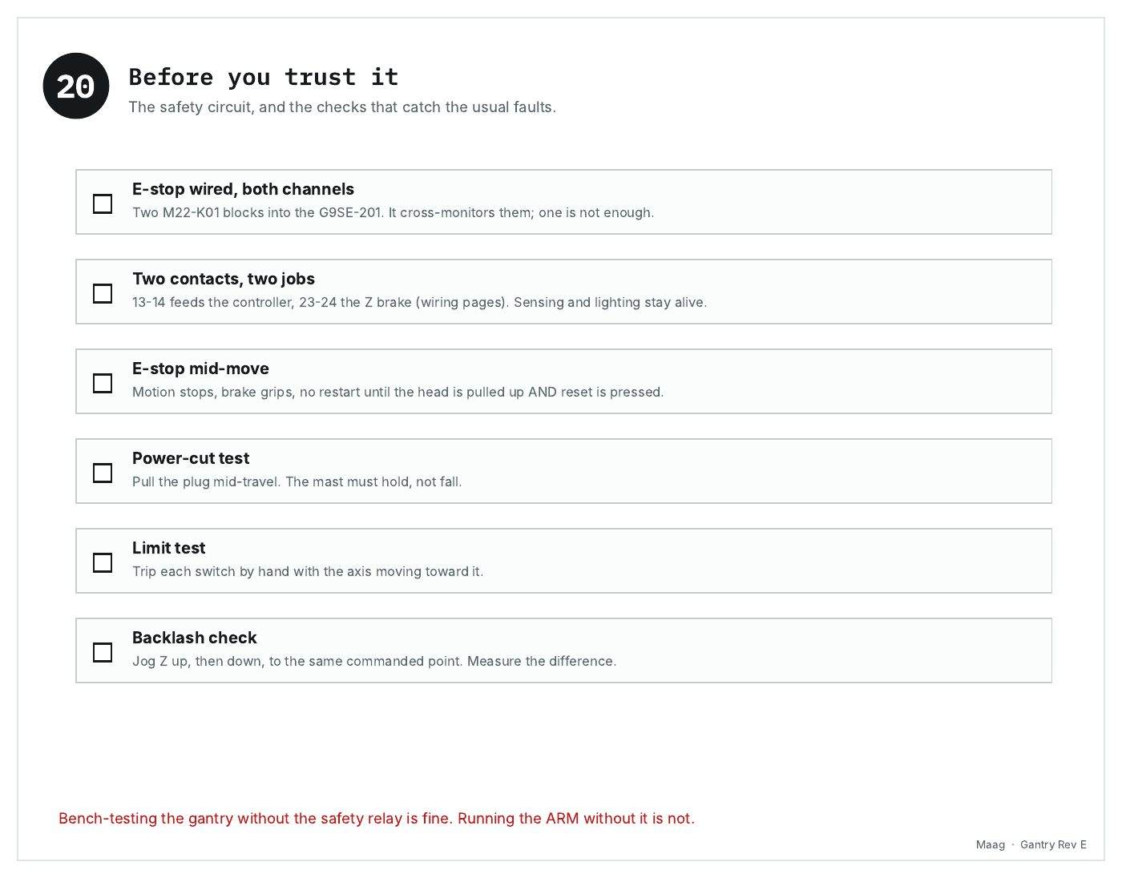
[picture p211: docs/booklets/gantry/p26.jpg]
Gantry Rev E, page 26: Before you trust it


### 27 · Step 21 · The cabinet the gantry lands on

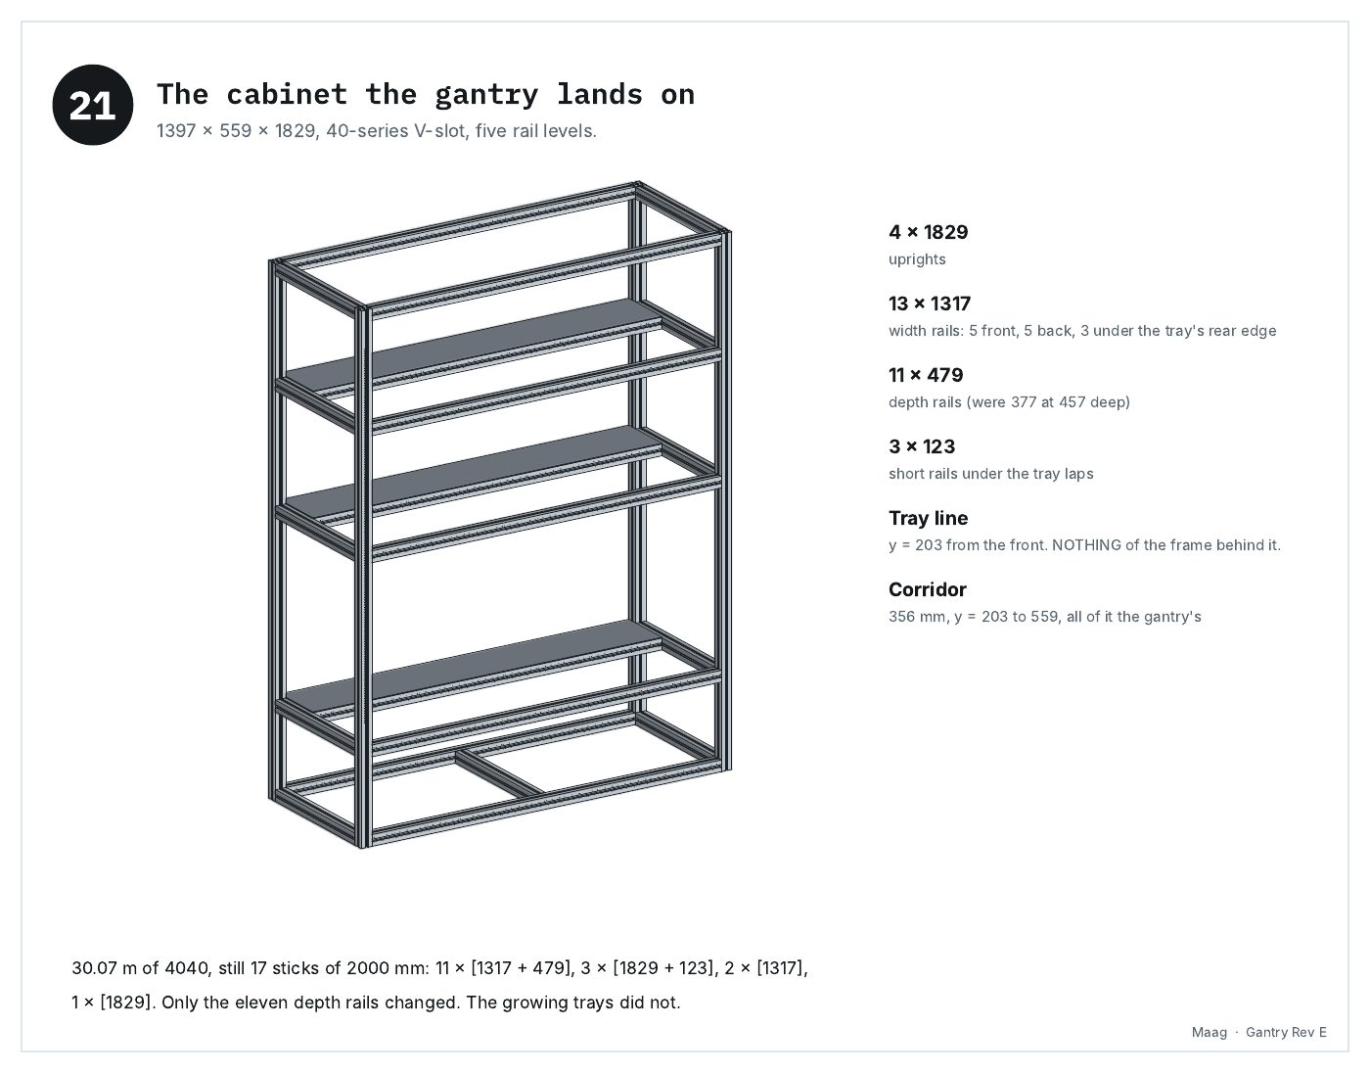
[picture p212: docs/booklets/gantry/p27.jpg]
Gantry Rev E, page 27: The cabinet the gantry lands on


### 28 · Step 22 · Why the cabinet got deeper

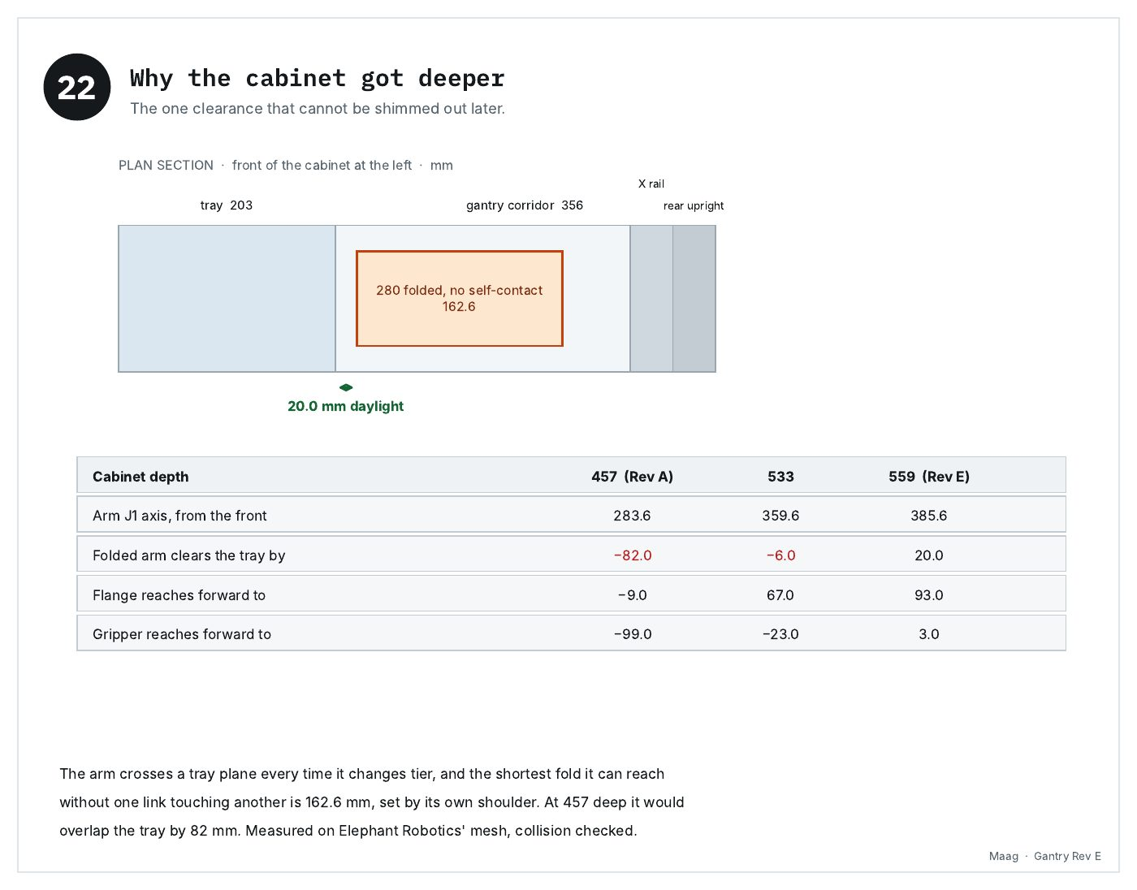
[picture p213: docs/booklets/gantry/p28.jpg]
Gantry Rev E, page 28: Why the cabinet got deeper


### 29 · Step 23 · X rail onto the rear uprights

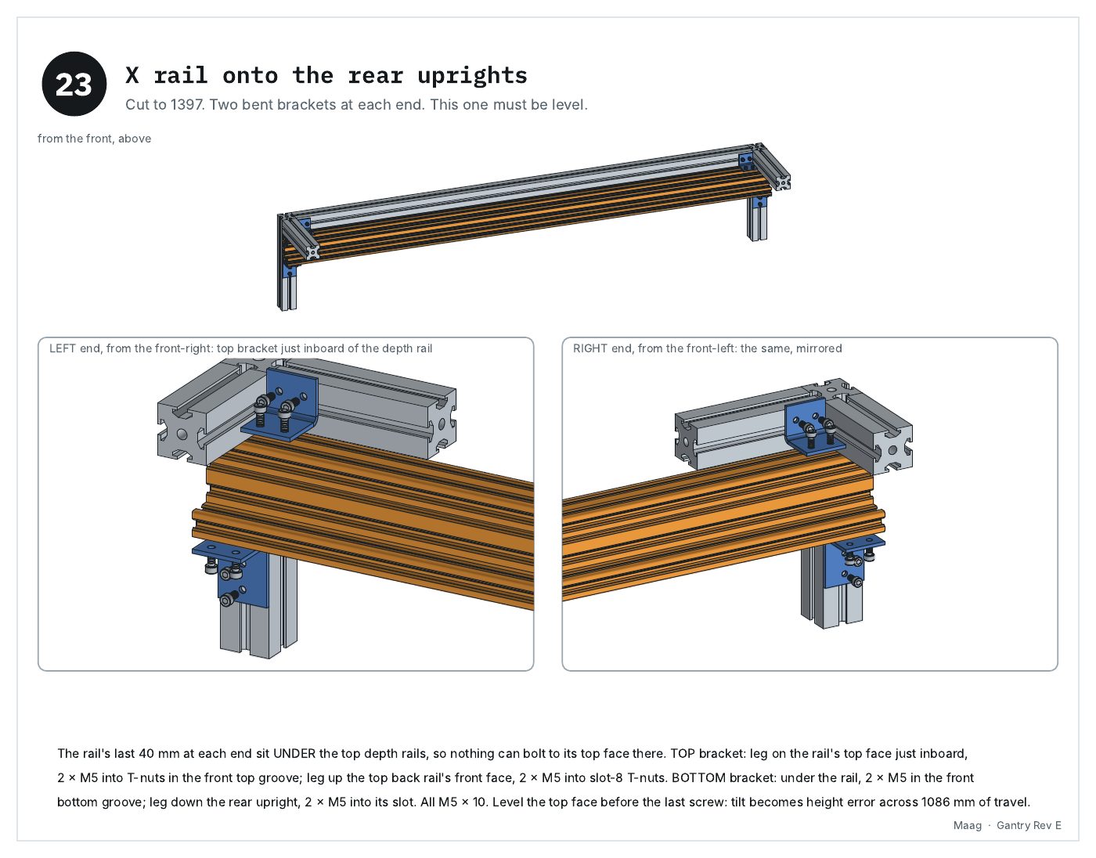
[picture p214: docs/booklets/gantry/p29.jpg]
Gantry Rev E, page 29: X rail onto the rear uprights


### 30 · Step 24 · Hang the Z mast

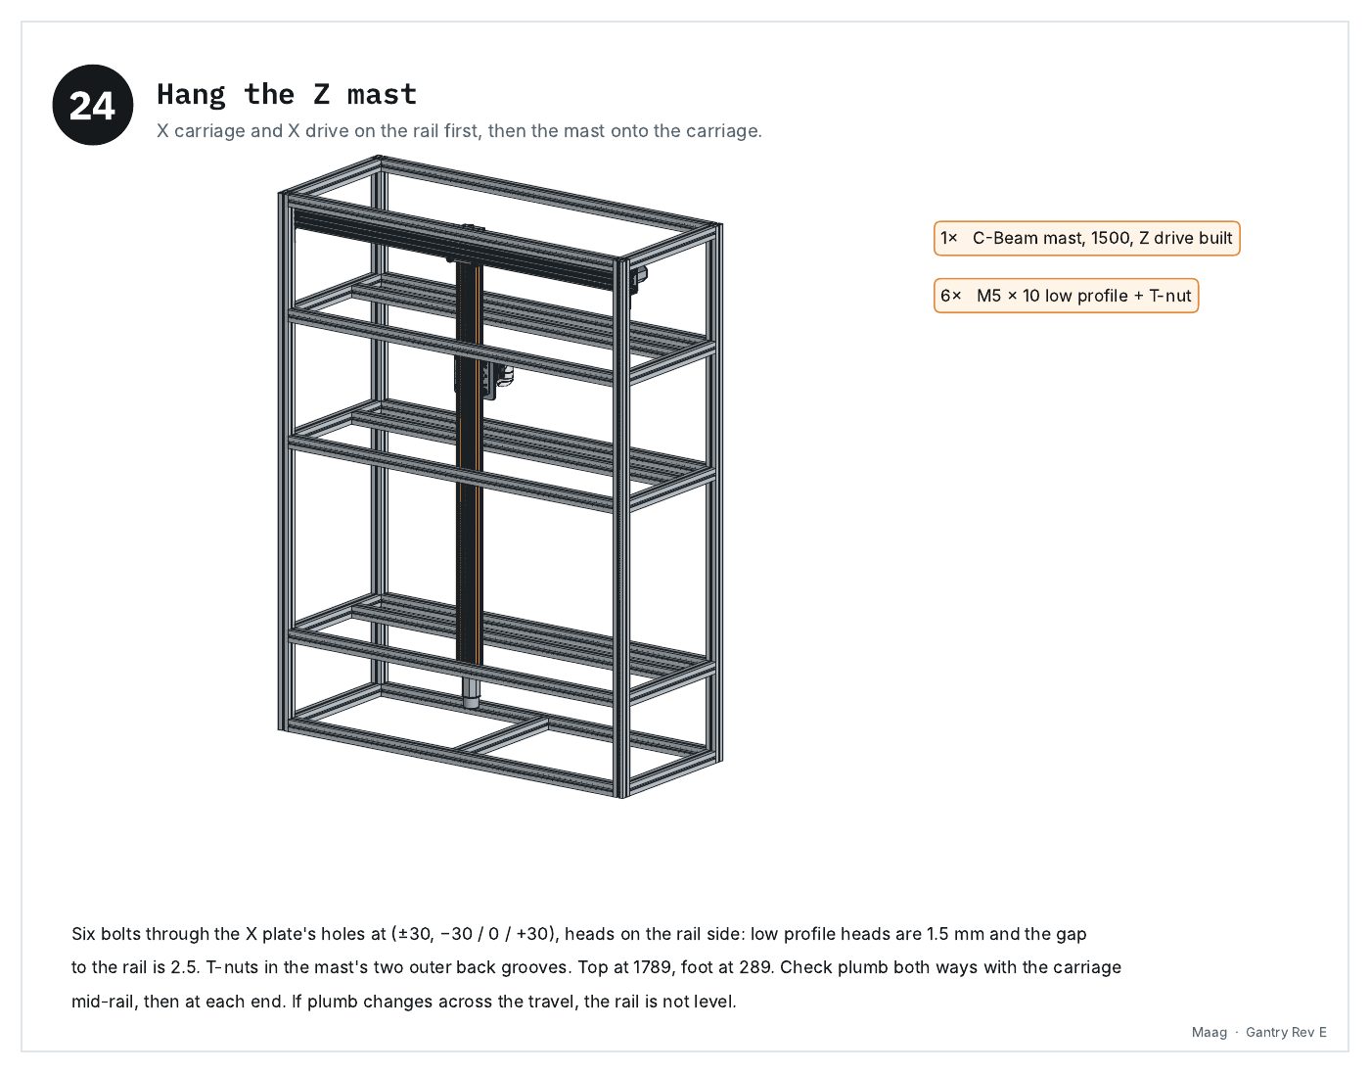
[picture p215: docs/booklets/gantry/p30.jpg]
Gantry Rev E, page 30: Hang the Z mast


### 31 · Step 25 · The Z drive, installed

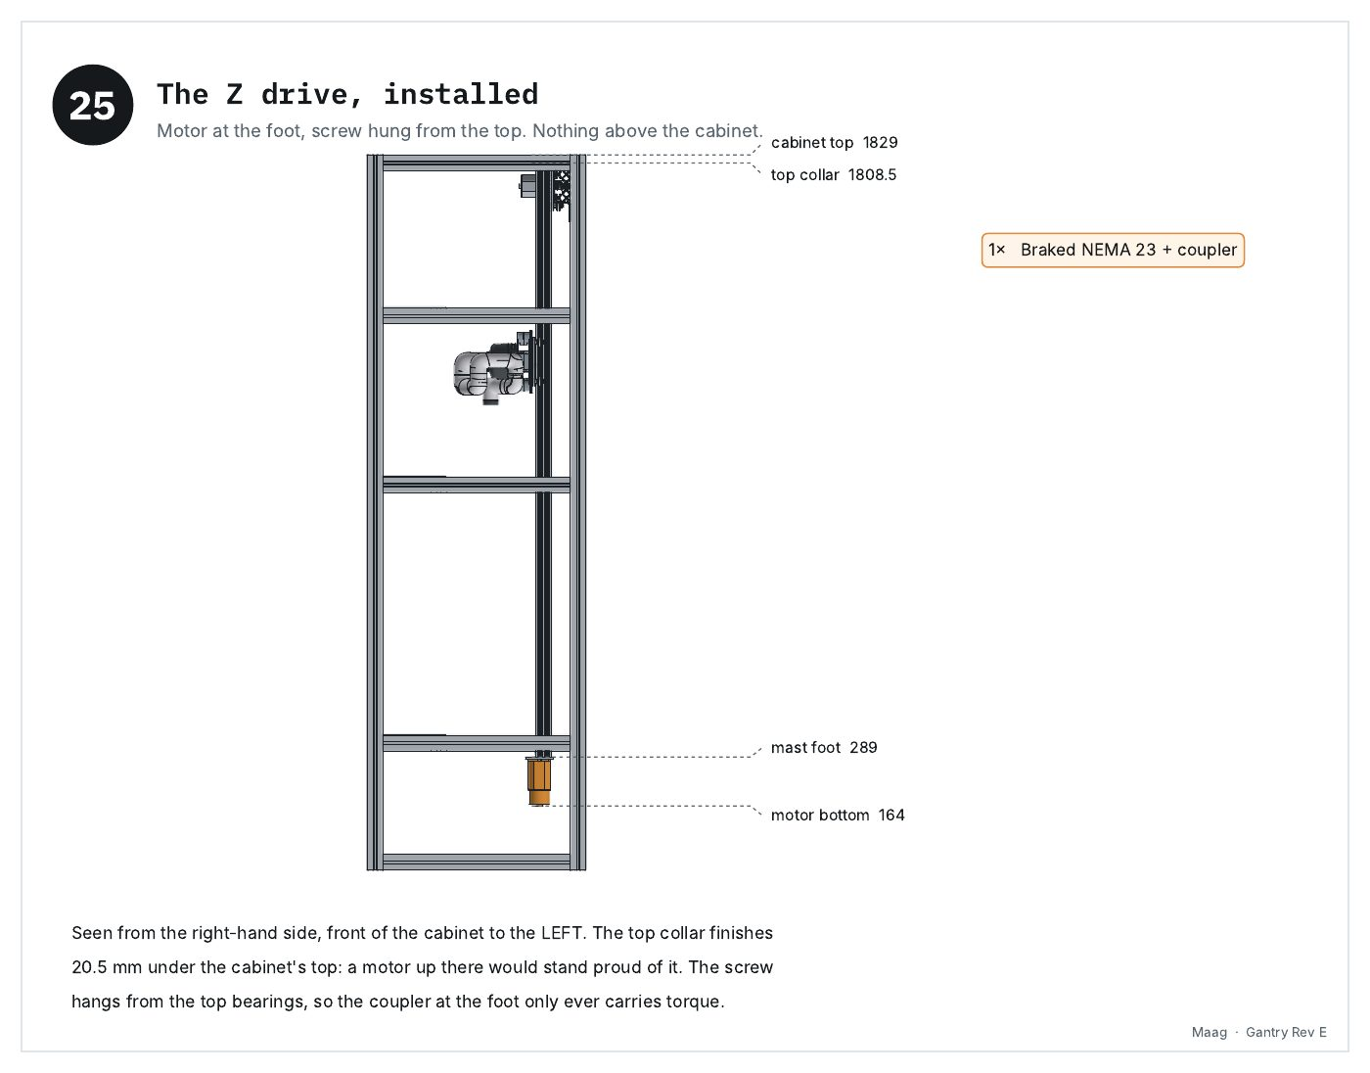
[picture p216: docs/booklets/gantry/p31.jpg]
Gantry Rev E, page 31: The Z drive, installed


### 32 · Step 26 · Z carriage, arm plate, arm

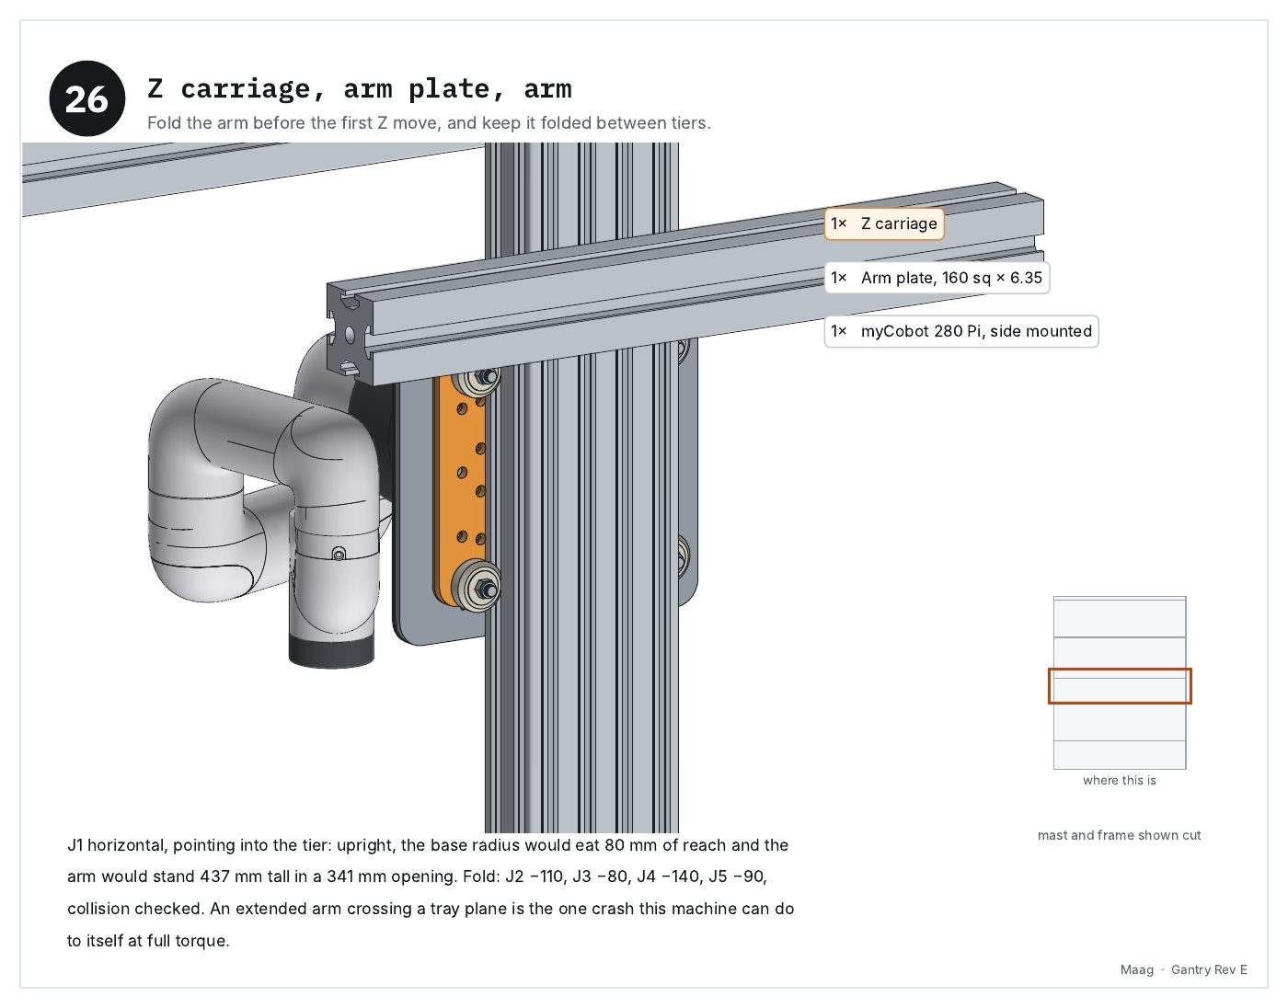
[picture p217: docs/booklets/gantry/p32.jpg]
Gantry Rev E, page 32: Z carriage, arm plate, arm


### 33 · Step 27 · Commissioned

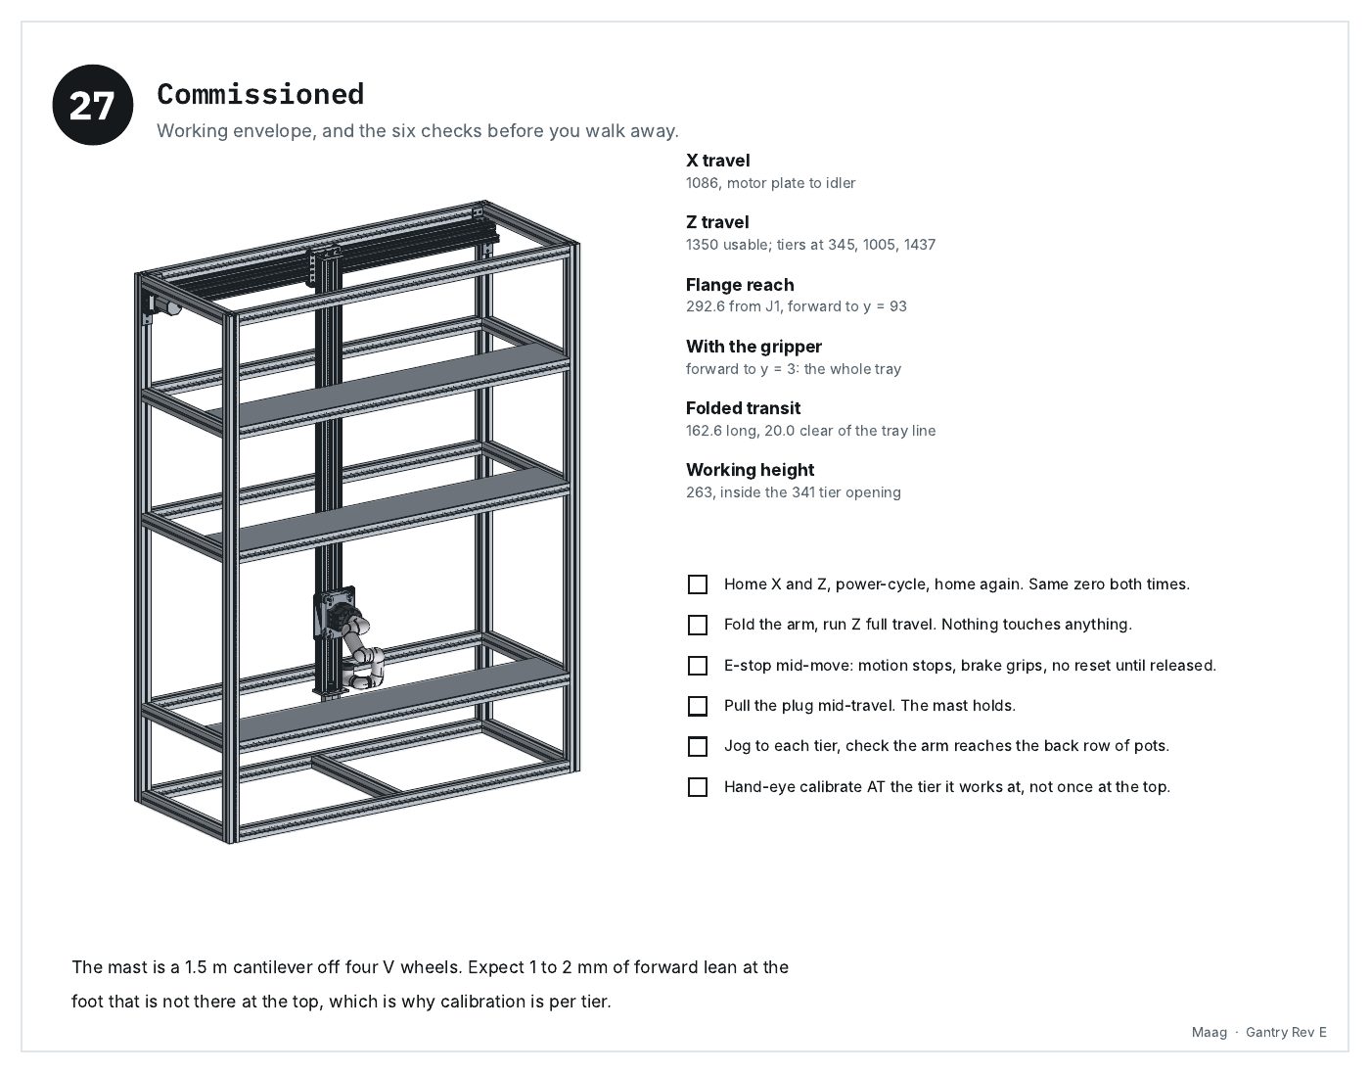
[picture p218: docs/booklets/gantry/p33.jpg]
Gantry Rev E, page 33: Commissioned


---

[All booklets](README.md) · previous: [Frame Rev A](frame.md) · next: [Enclosure Rev A](enclosure.md)
