v1proxy/RedTower/docs/booklets/harvest.md

# Harvest Rev B, page by page

<!-- generated by greenhouse/booklet/make_gallery.py from greenhouse/harvest/Maag_Harvest_Assembly_Instructions_RevB.pdf: do not edit -->

Where the cuts go: the dead-leaf tray in the base and the feeder on the right panel. 18 pages, 11 steps. Each page below is the PDF's own page as an image; click one for full size.

[PDF](../../greenhouse/harvest/Maag_Harvest_Assembly_Instructions_RevB.pdf) · [Guide](../../greenhouse/harvest/HARVEST.md) · [All booklets](README.md) · previous: [Enclosure Rev A](enclosure.md) · next: [Herb Snip Rev A](snip.md)

<details><summary><b>Contents</b>, 18 pages</summary>

- [1 · Cover](#1--cover)
- [2 · Harvest · where every cut goes](#2--harvest--where-every-cut-goes)
- [3 · How the arm drops](#3--how-the-arm-drops)
- [4 · Harvest · parts](#4--harvest--parts)
- [5 · Harvest · fasteners](#5--harvest--fasteners)
- [6 · Tools](#6--tools)
- [7 · In section, to scale](#7--in-section-to-scale)
- [8 · Step 1 · Before you start](#8--step-1--before-you-start)
- [9 · Step 2 · Base pan · the guide rails](#9--step-2--base-pan--the-guide-rails)
- [10 · Step 3 · The tray · its handle](#10--step-3--the-tray--its-handle)
- [11 · Step 4 · The tray · slide it in](#11--step-4--the-tray--slide-it-in)
- [12 · Step 5 · The feeder · on the bench](#12--step-5--the-feeder--on-the-bench)
- [13 · Step 6 · Right panel · well nuts in, temporary screws out](#13--step-6--right-panel--well-nuts-in-temporary-screws-out)
- [14 · Step 7 · Feeder · hang the two basins](#14--step-7--feeder--hang-the-two-basins)
- [15 · Step 8 · Feeder · the two hoods](#15--step-8--feeder--the-two-hoods)
- [16 · Step 9 · Feeder · the lid](#16--step-9--feeder--the-lid)
- [17 · Step 10 · Trays in, the switch into the door chain](#17--step-10--trays-in-the-switch-into-the-door-chain)
- [18 · Step 11 · Before the first harvest](#18--step-11--before-the-first-harvest)

</details>

---

### 1 · Cover

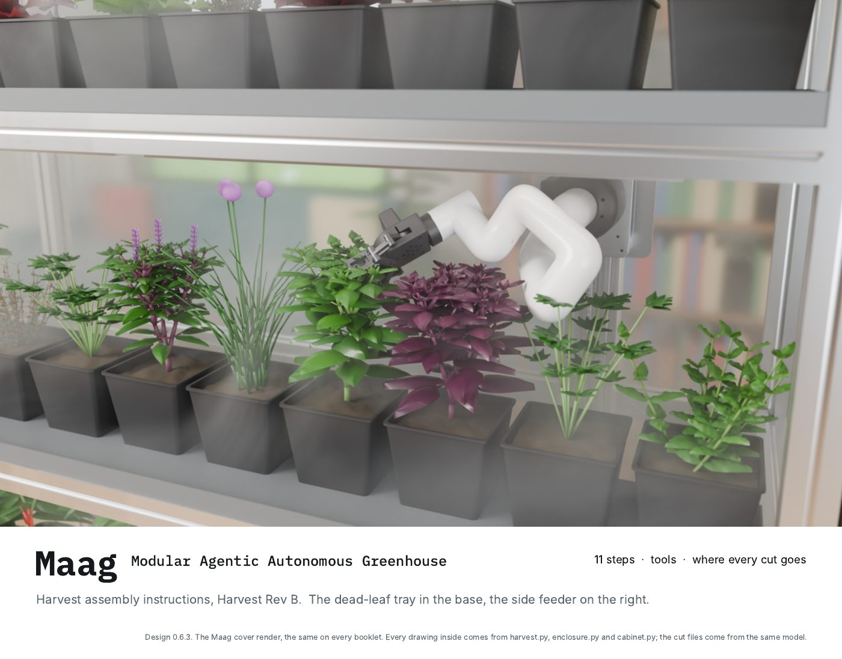
[picture p219: docs/booklets/harvest/p01.jpg]
Harvest Rev B, page 1: Cover


### 2 · Harvest · where every cut goes

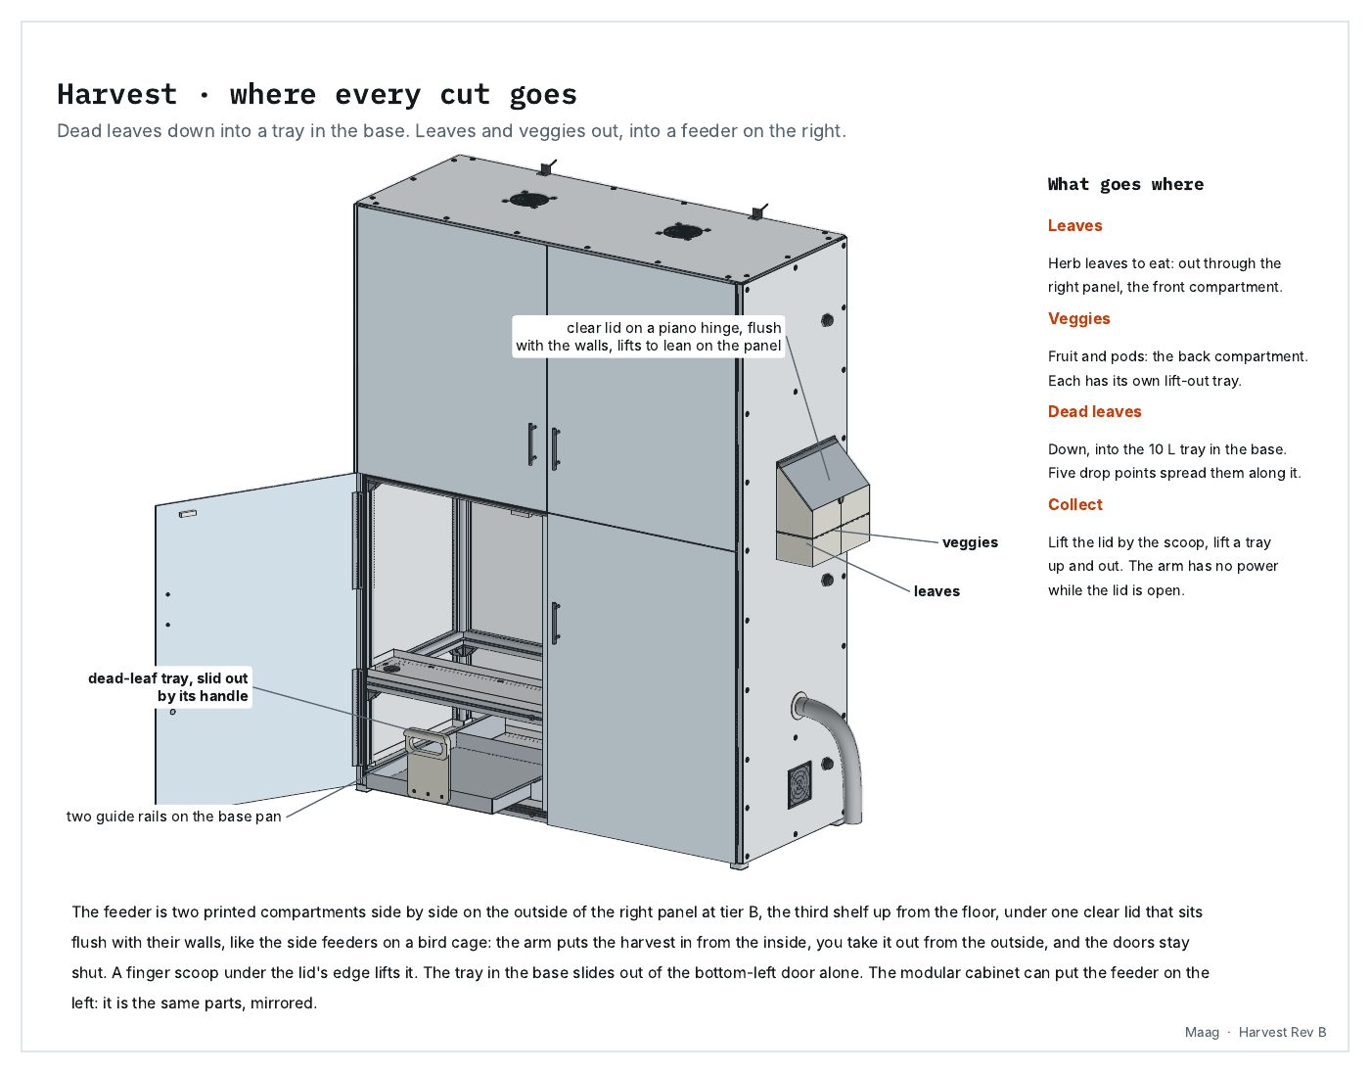
[picture p220: docs/booklets/harvest/p02.jpg]
Harvest Rev B, page 2: Harvest · where every cut goes


### 3 · How the arm drops

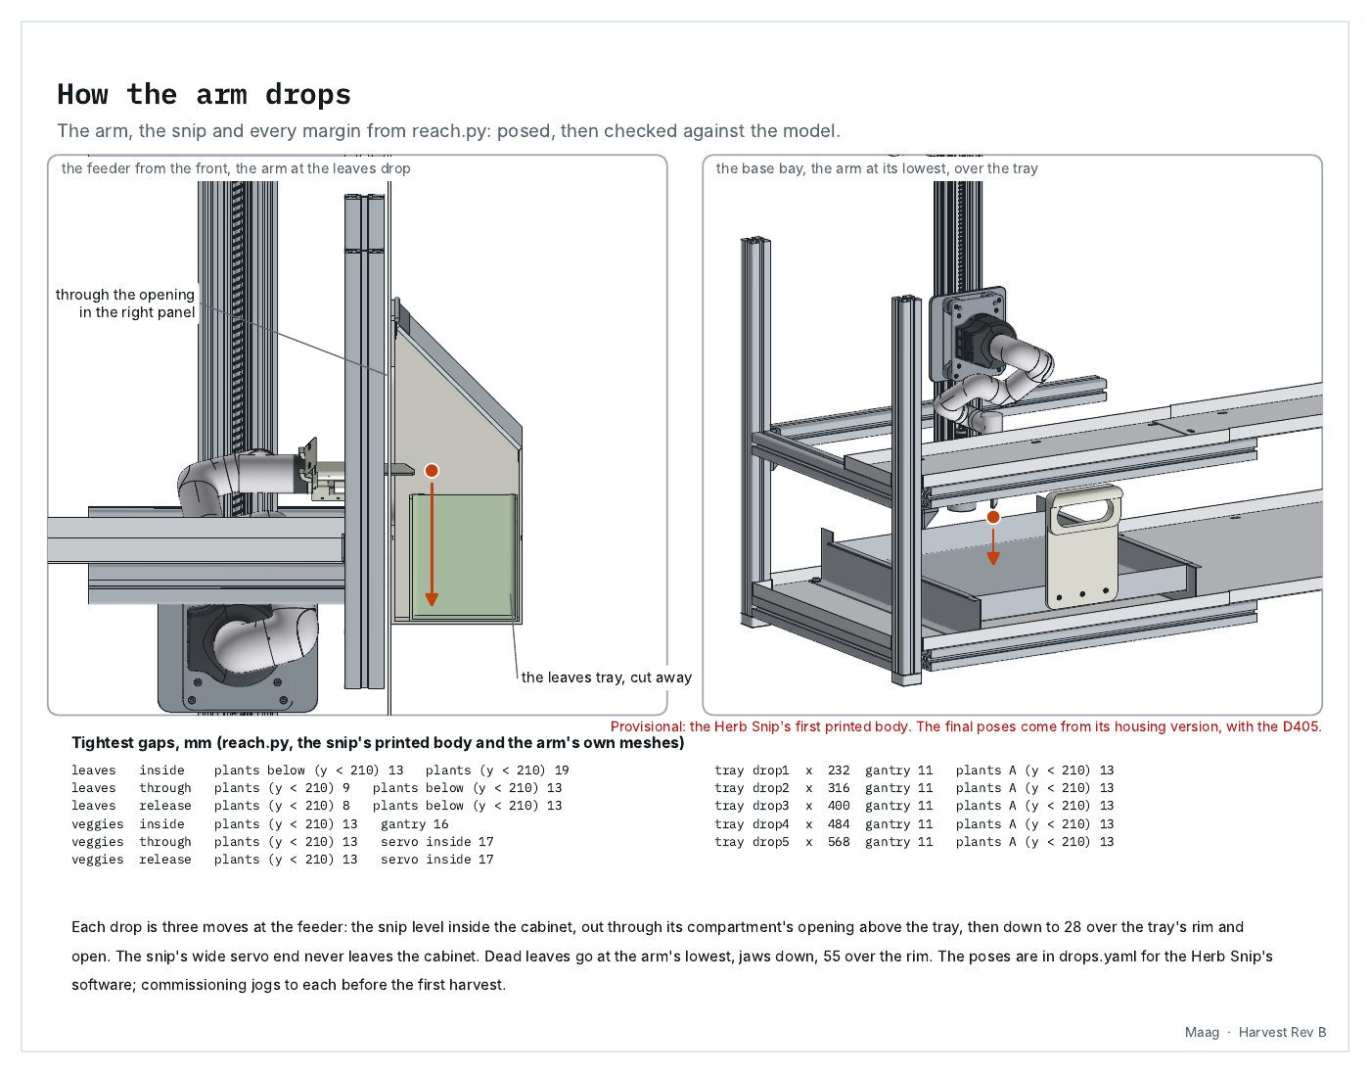
[picture p221: docs/booklets/harvest/p03.jpg]
Harvest Rev B, page 3: How the arm drops


### 4 · Harvest · parts

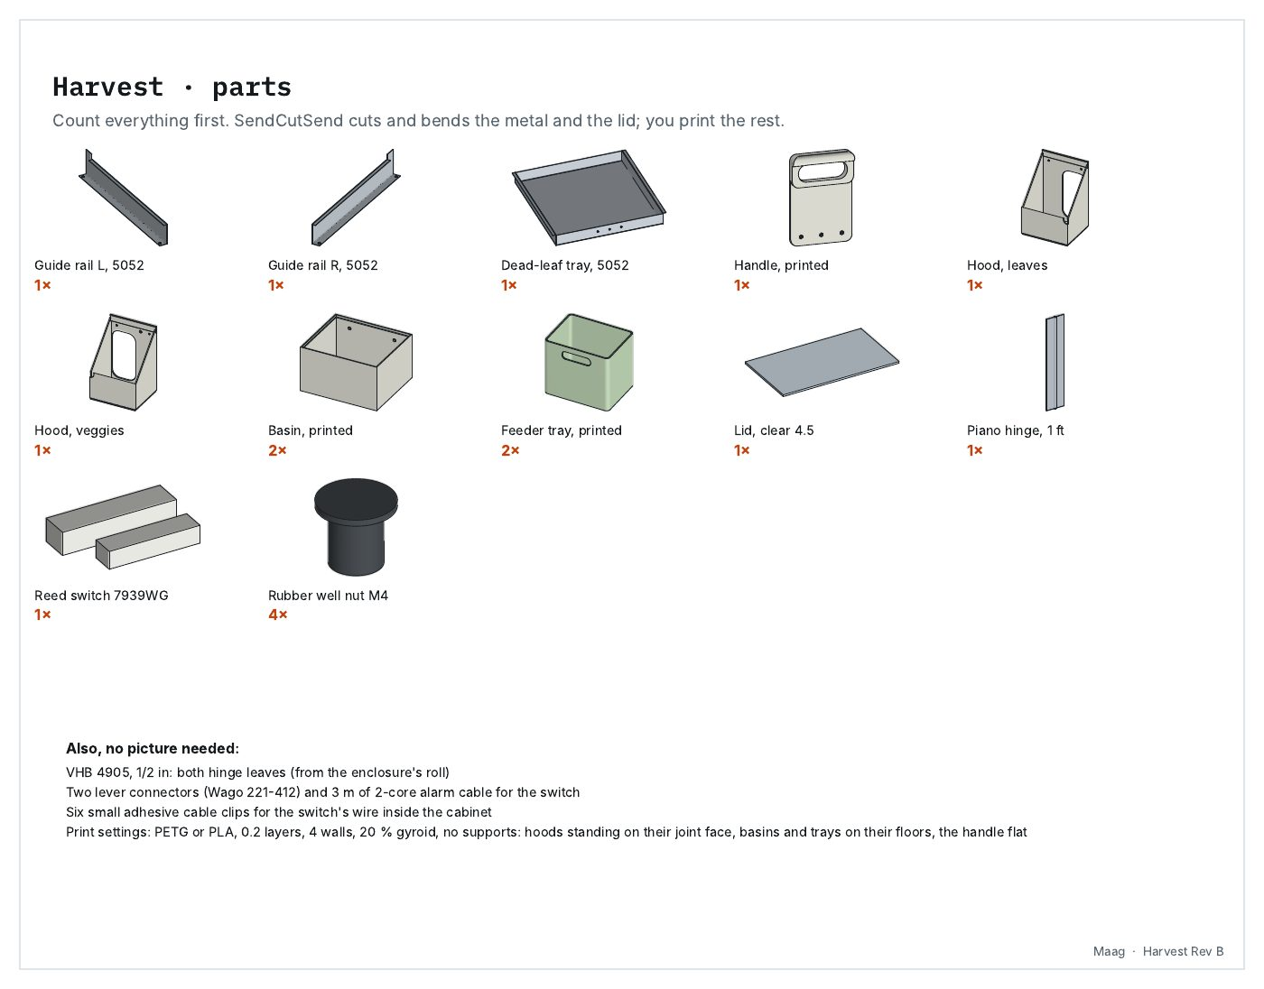
[picture p222: docs/booklets/harvest/p04.jpg]
Harvest Rev B, page 4: Harvest · parts


### 5 · Harvest · fasteners

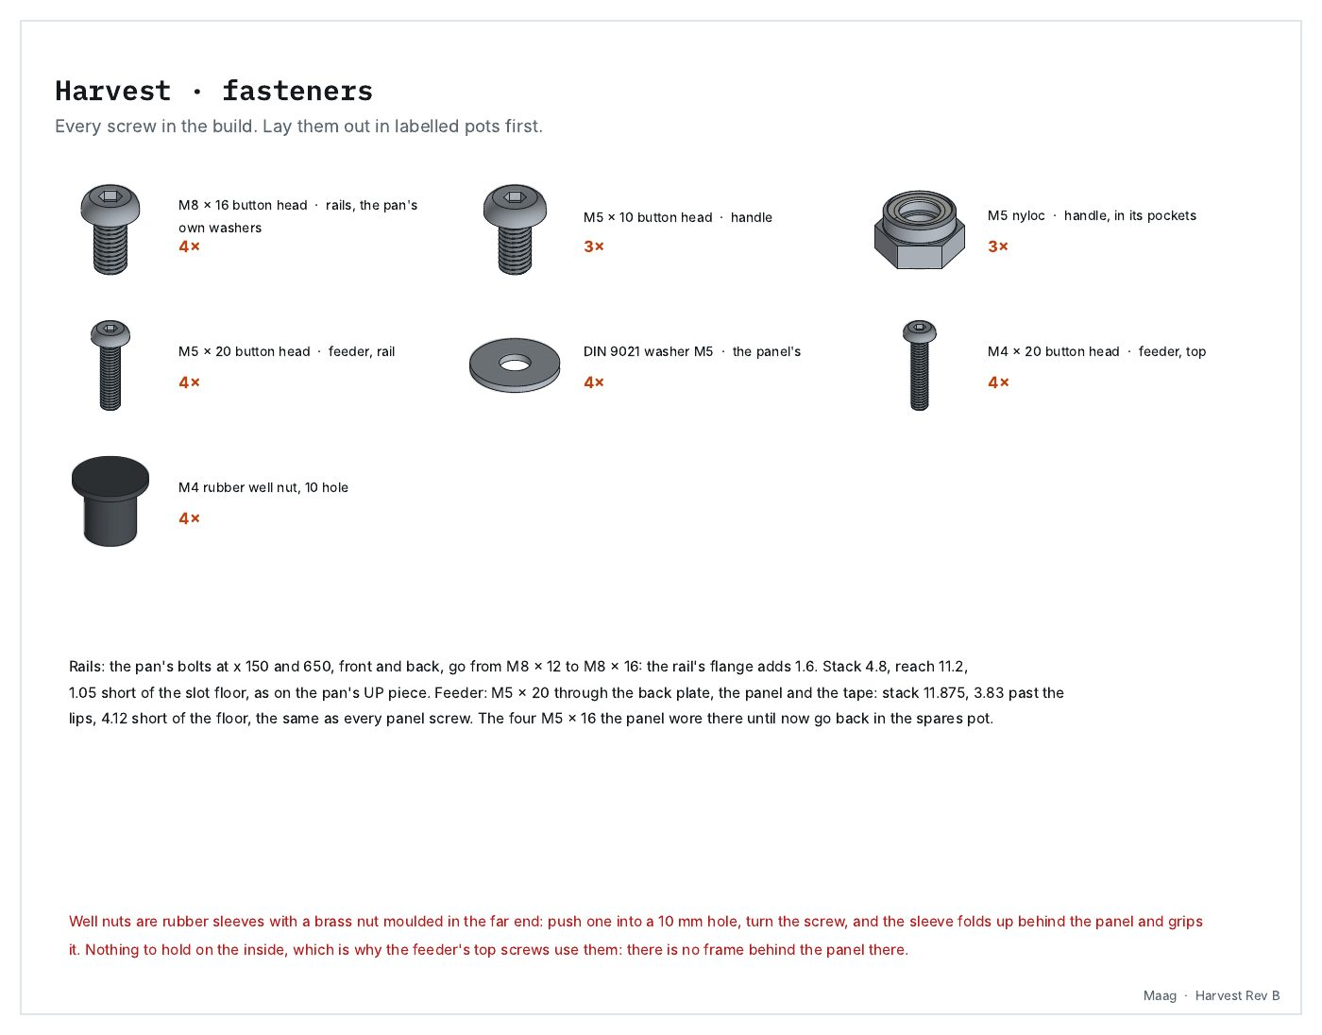
[picture p223: docs/booklets/harvest/p05.jpg]
Harvest Rev B, page 5: Harvest · fasteners


### 6 · Tools

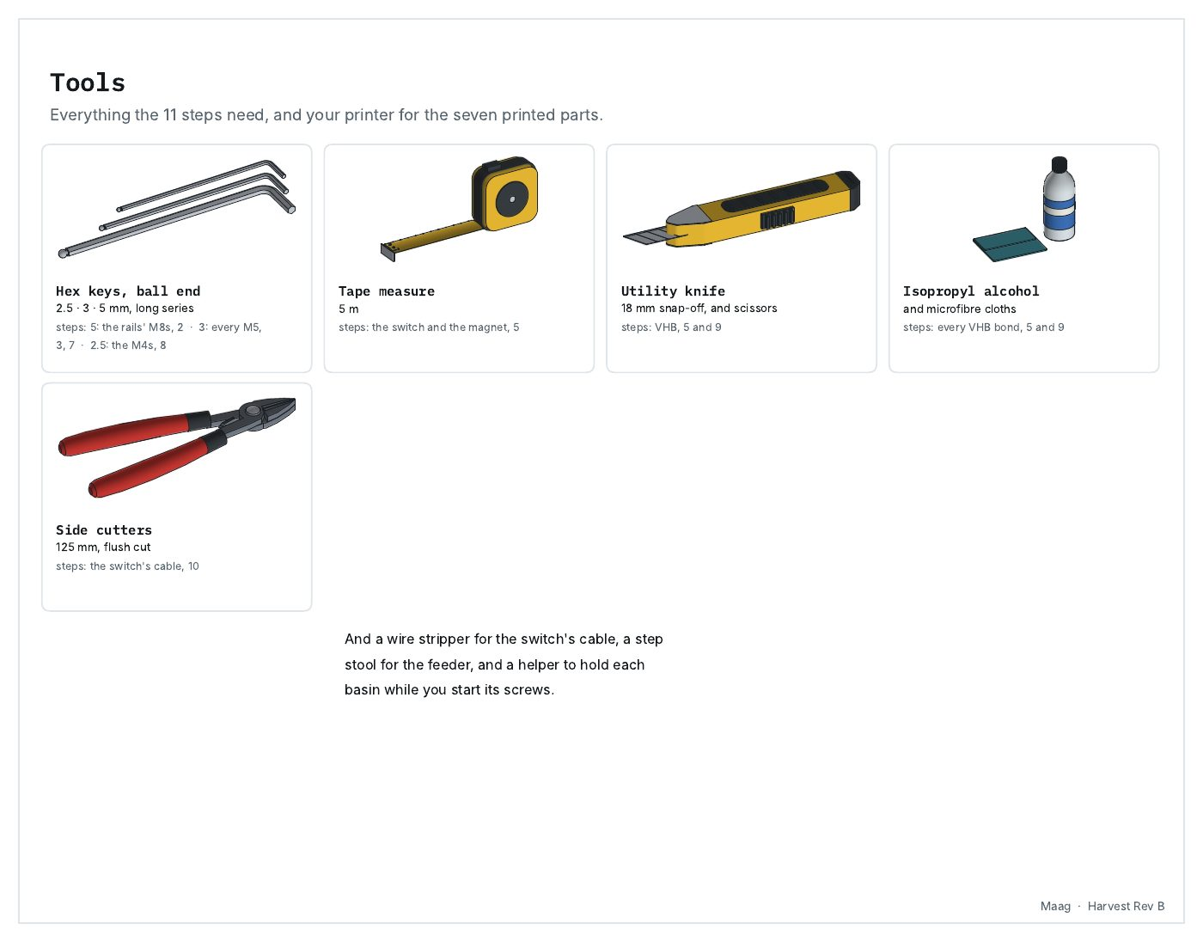
[picture p224: docs/booklets/harvest/p06.jpg]
Harvest Rev B, page 6: Tools


### 7 · In section, to scale

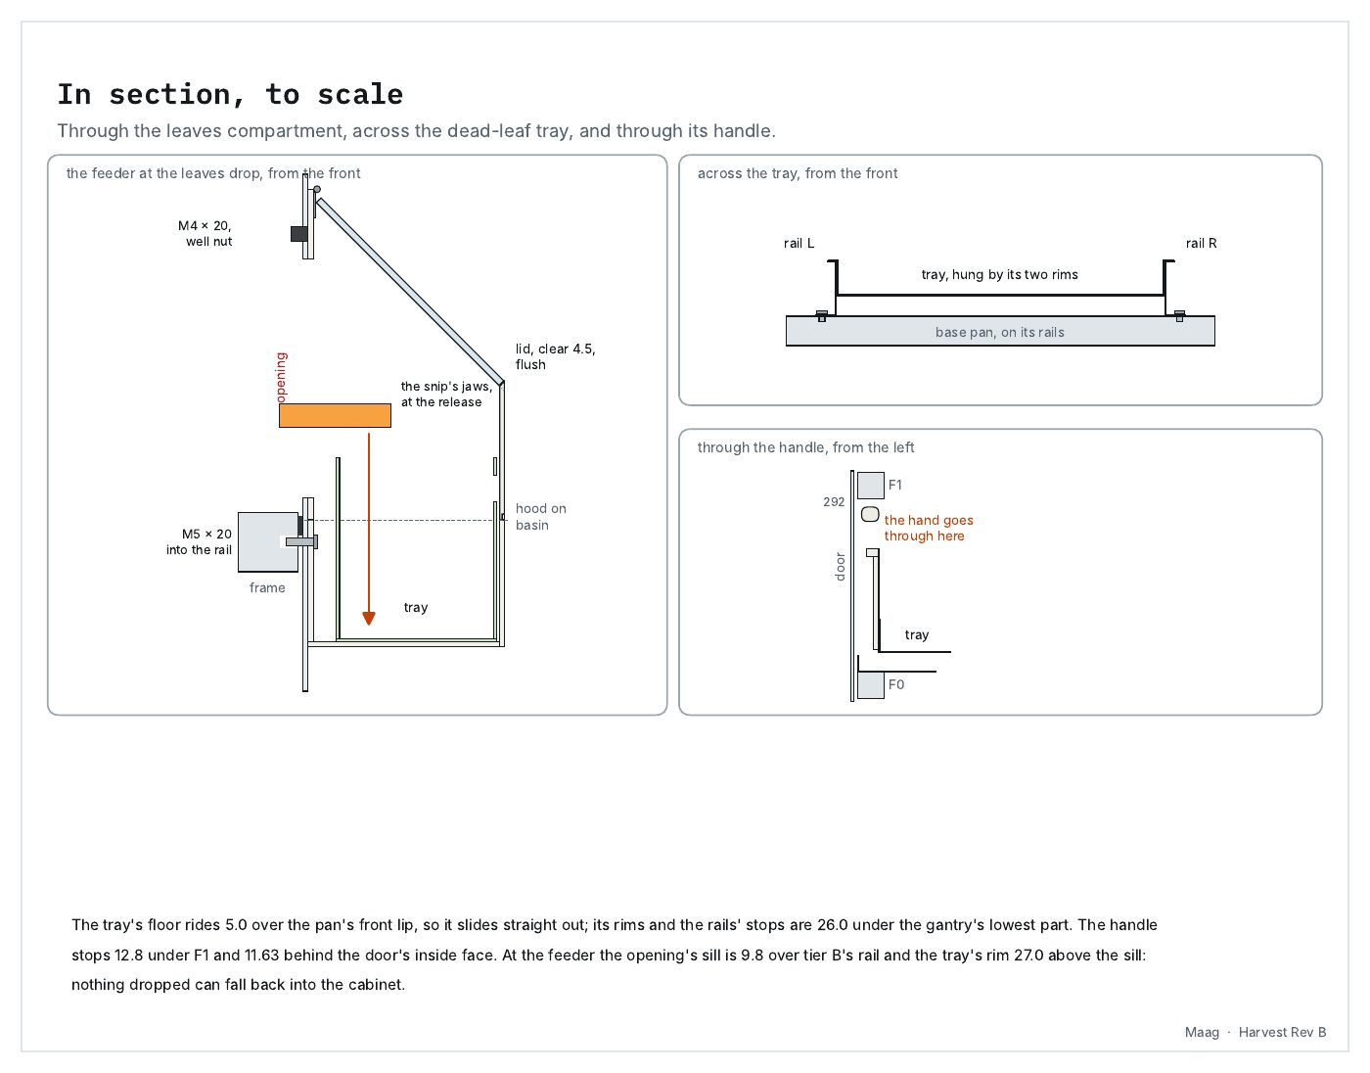
[picture p225: docs/booklets/harvest/p07.jpg]
Harvest Rev B, page 7: In section, to scale


### 8 · Step 1 · Before you start

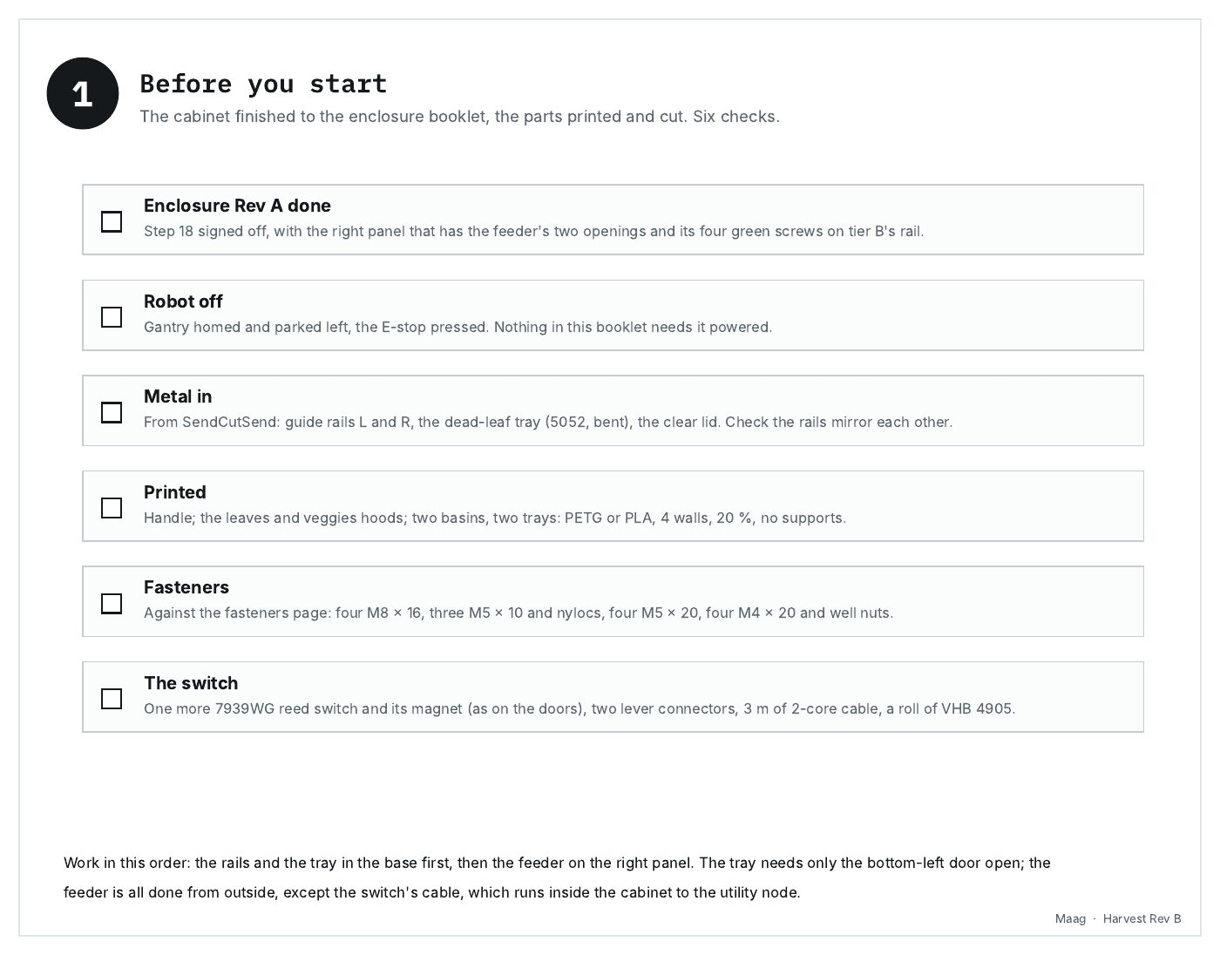
[picture p226: docs/booklets/harvest/p08.jpg]
Harvest Rev B, page 8: Before you start


### 9 · Step 2 · Base pan · the guide rails

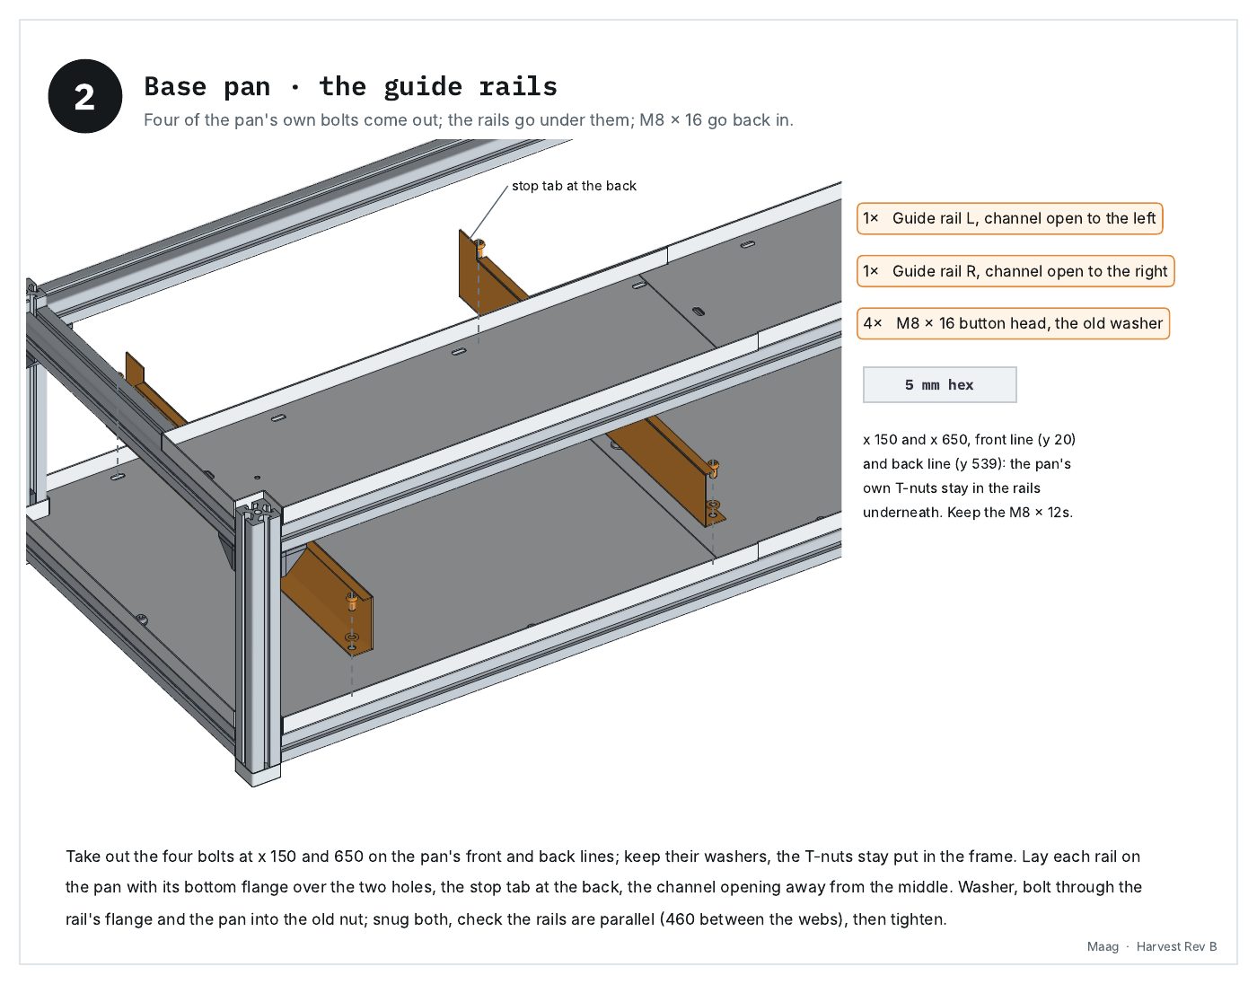
[picture p227: docs/booklets/harvest/p09.jpg]
Harvest Rev B, page 9: Base pan · the guide rails


### 10 · Step 3 · The tray · its handle

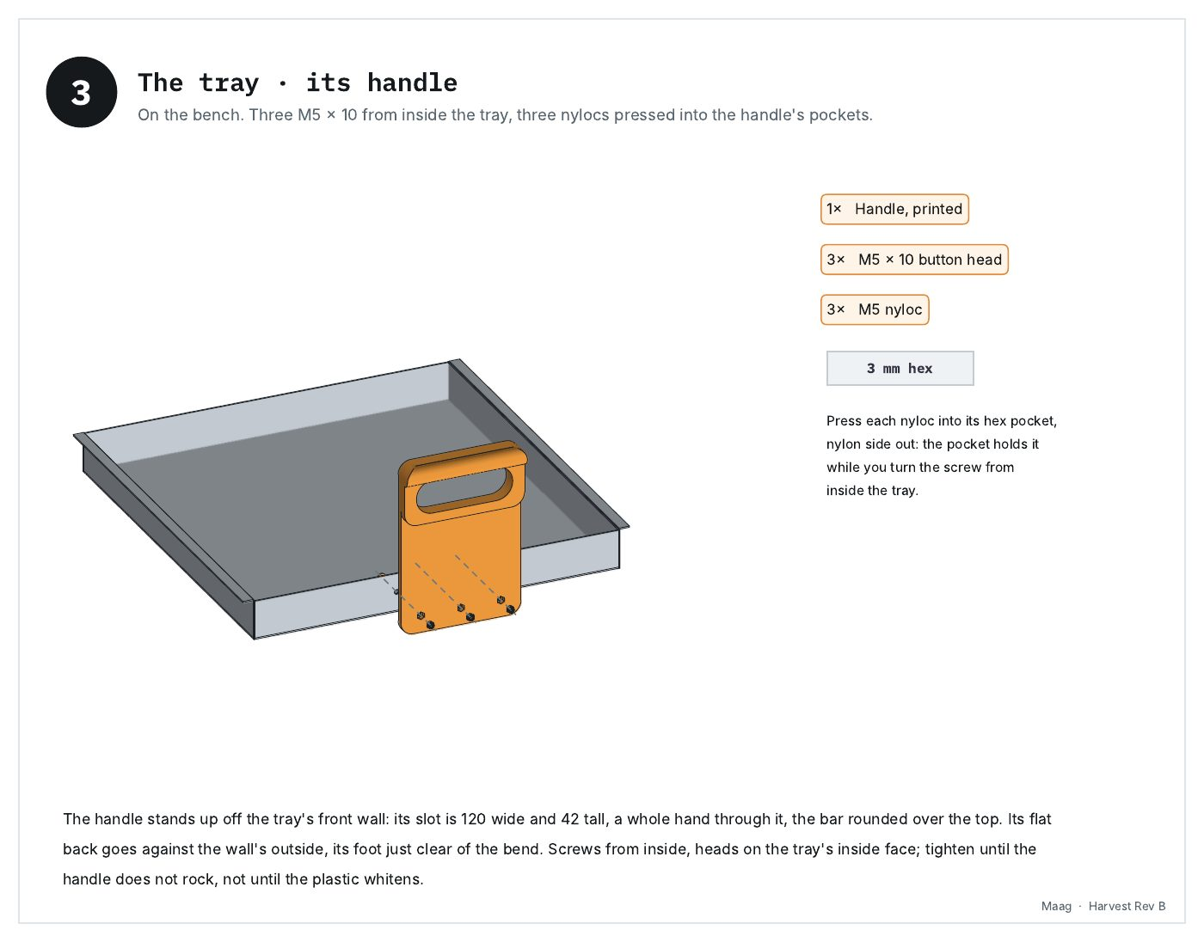
[picture p228: docs/booklets/harvest/p10.jpg]
Harvest Rev B, page 10: The tray · its handle


### 11 · Step 4 · The tray · slide it in

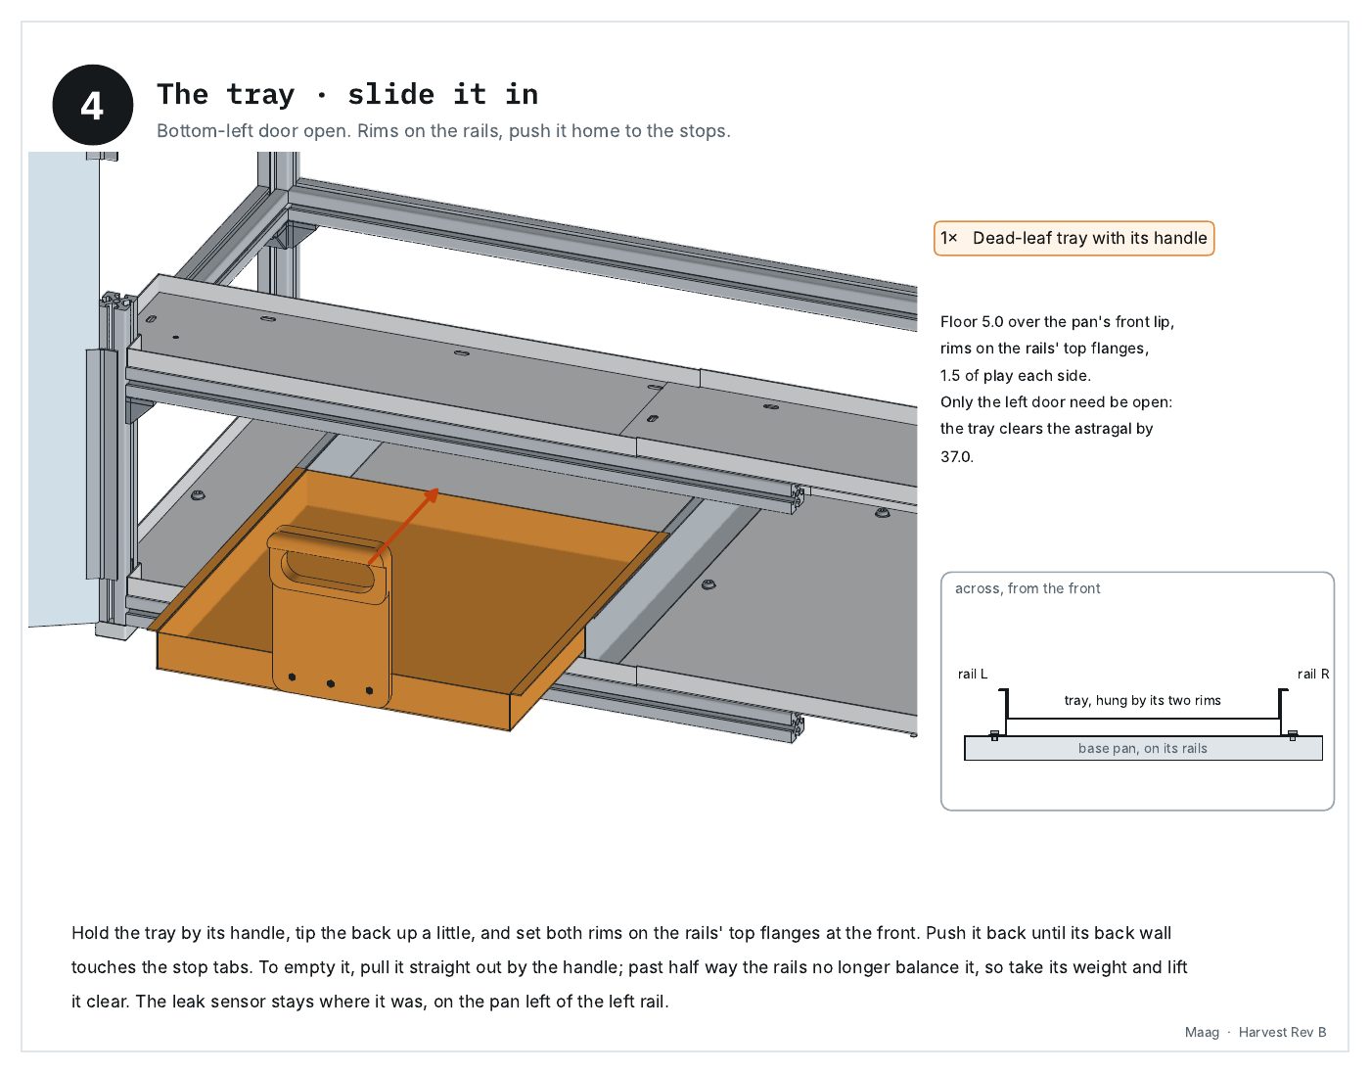
[picture p229: docs/booklets/harvest/p11.jpg]
Harvest Rev B, page 11: The tray · slide it in


### 12 · Step 5 · The feeder · on the bench

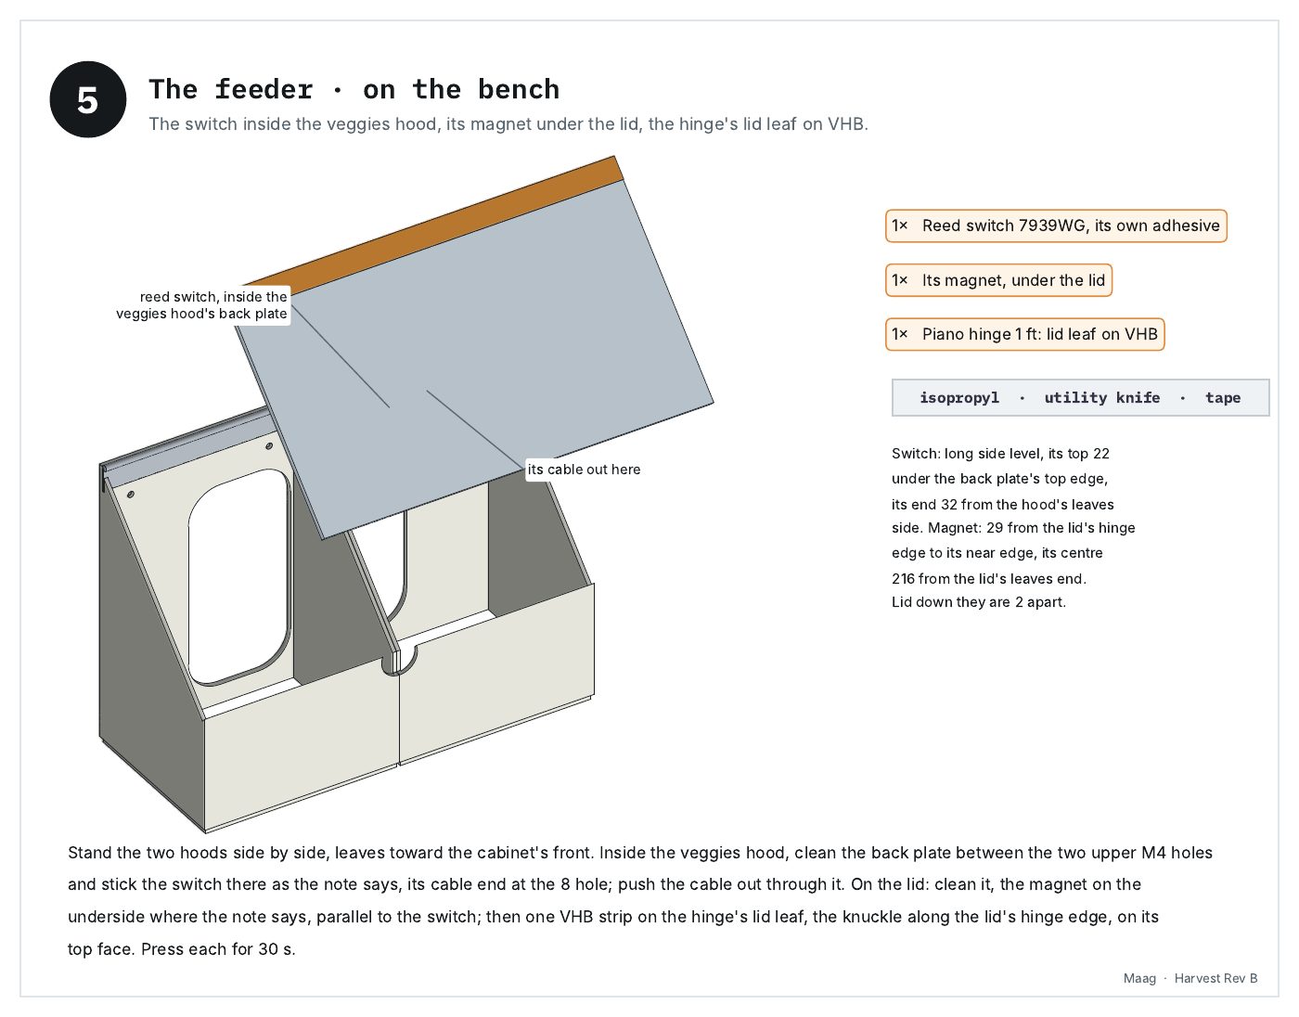
[picture p230: docs/booklets/harvest/p12.jpg]
Harvest Rev B, page 12: The feeder · on the bench


### 13 · Step 6 · Right panel · well nuts in, temporary screws out

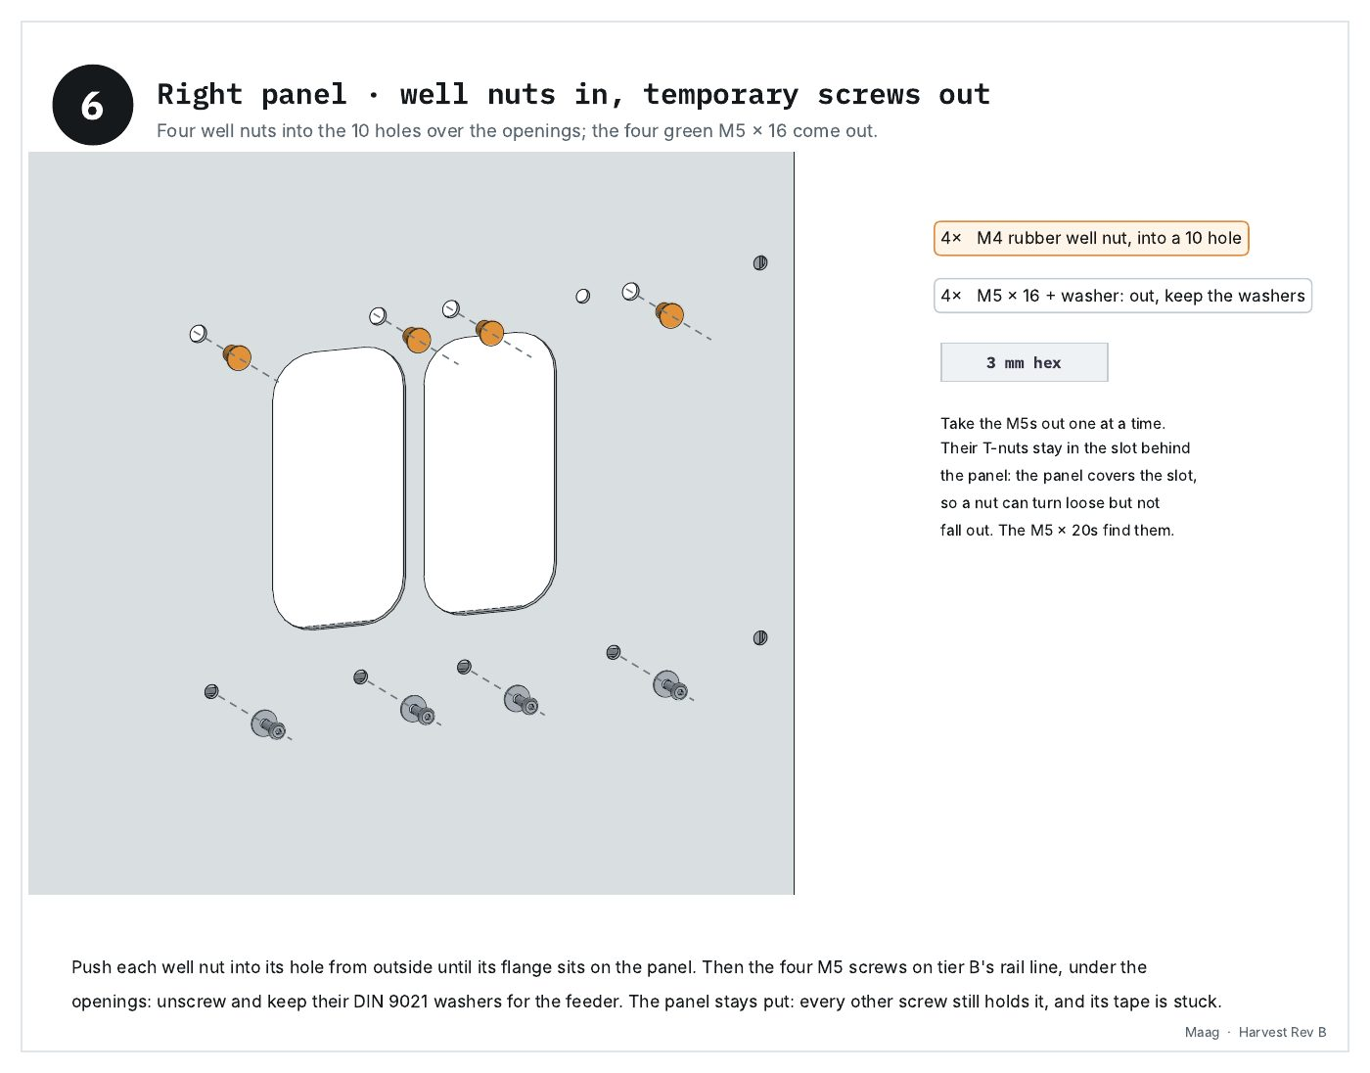
[picture p231: docs/booklets/harvest/p13.jpg]
Harvest Rev B, page 13: Right panel · well nuts in, temporary screws out


### 14 · Step 7 · Feeder · hang the two basins

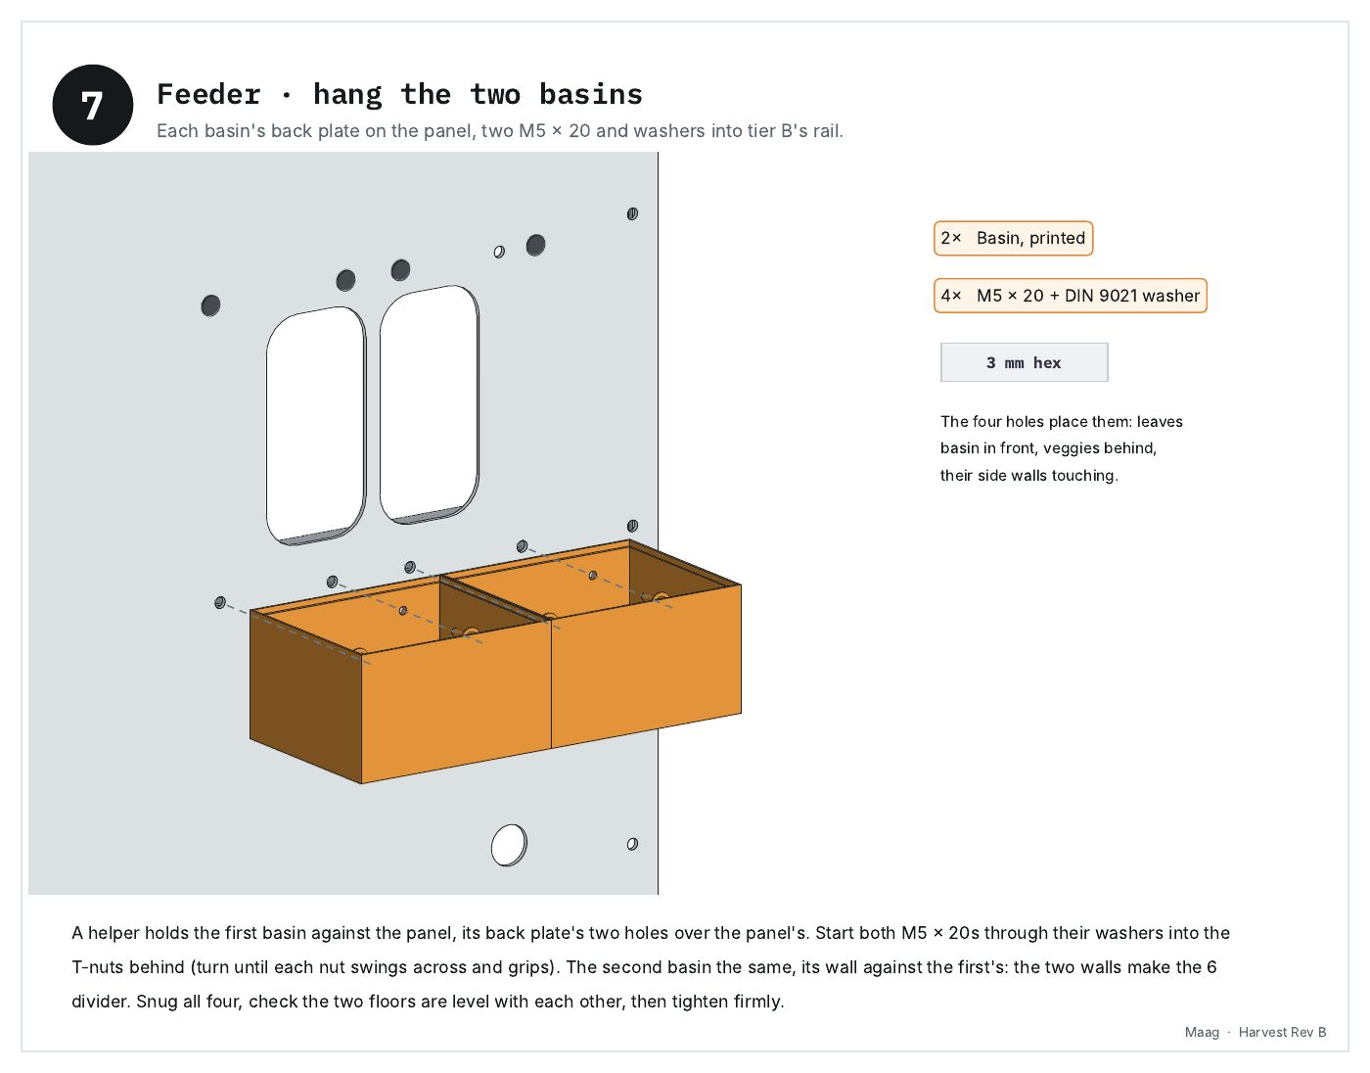
[picture p232: docs/booklets/harvest/p14.jpg]
Harvest Rev B, page 14: Feeder · hang the two basins


### 15 · Step 8 · Feeder · the two hoods

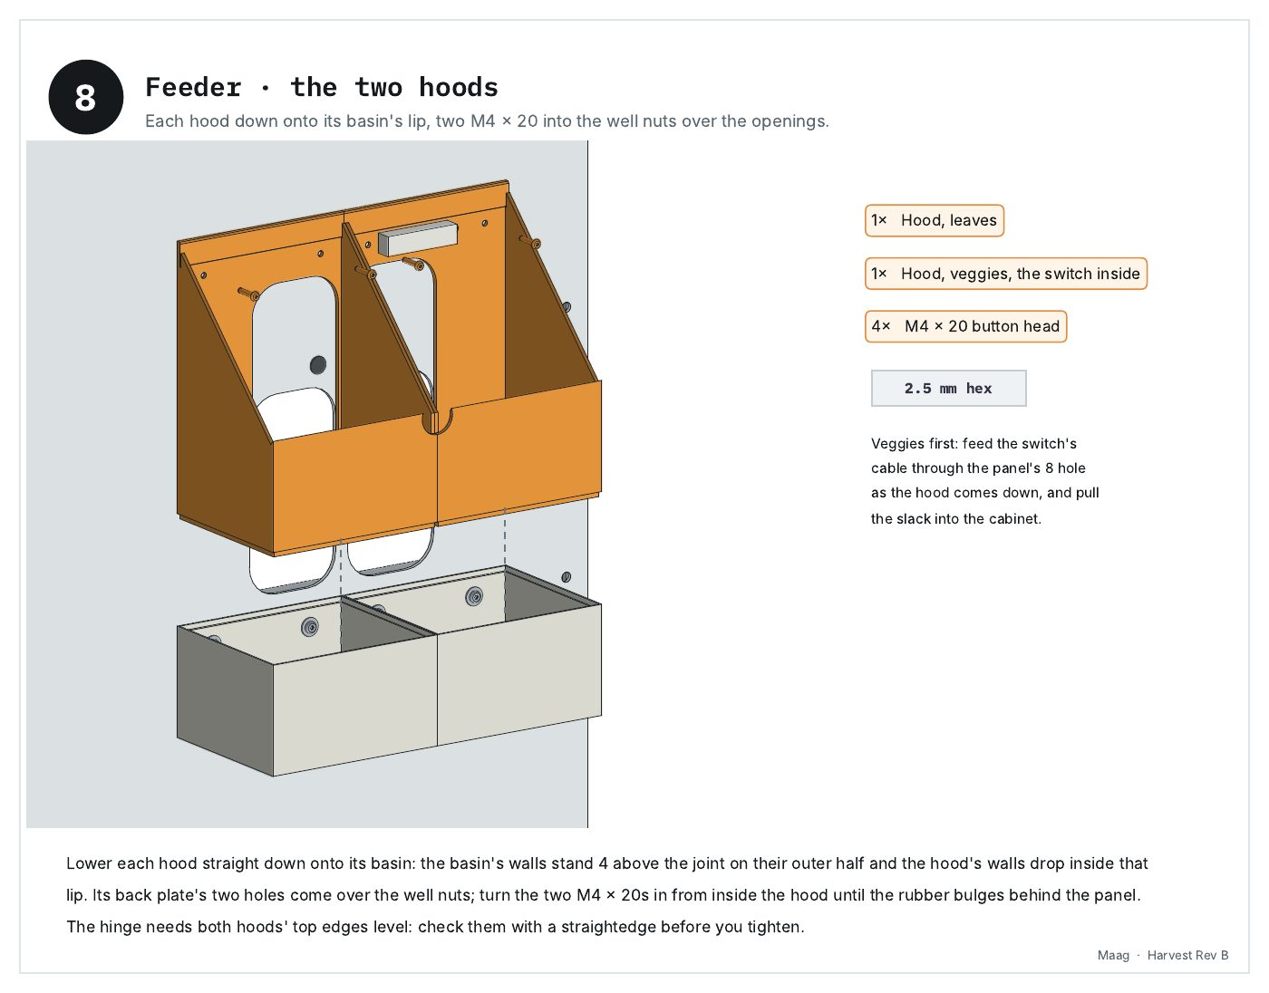
[picture p233: docs/booklets/harvest/p15.jpg]
Harvest Rev B, page 15: Feeder · the two hoods


### 16 · Step 9 · Feeder · the lid

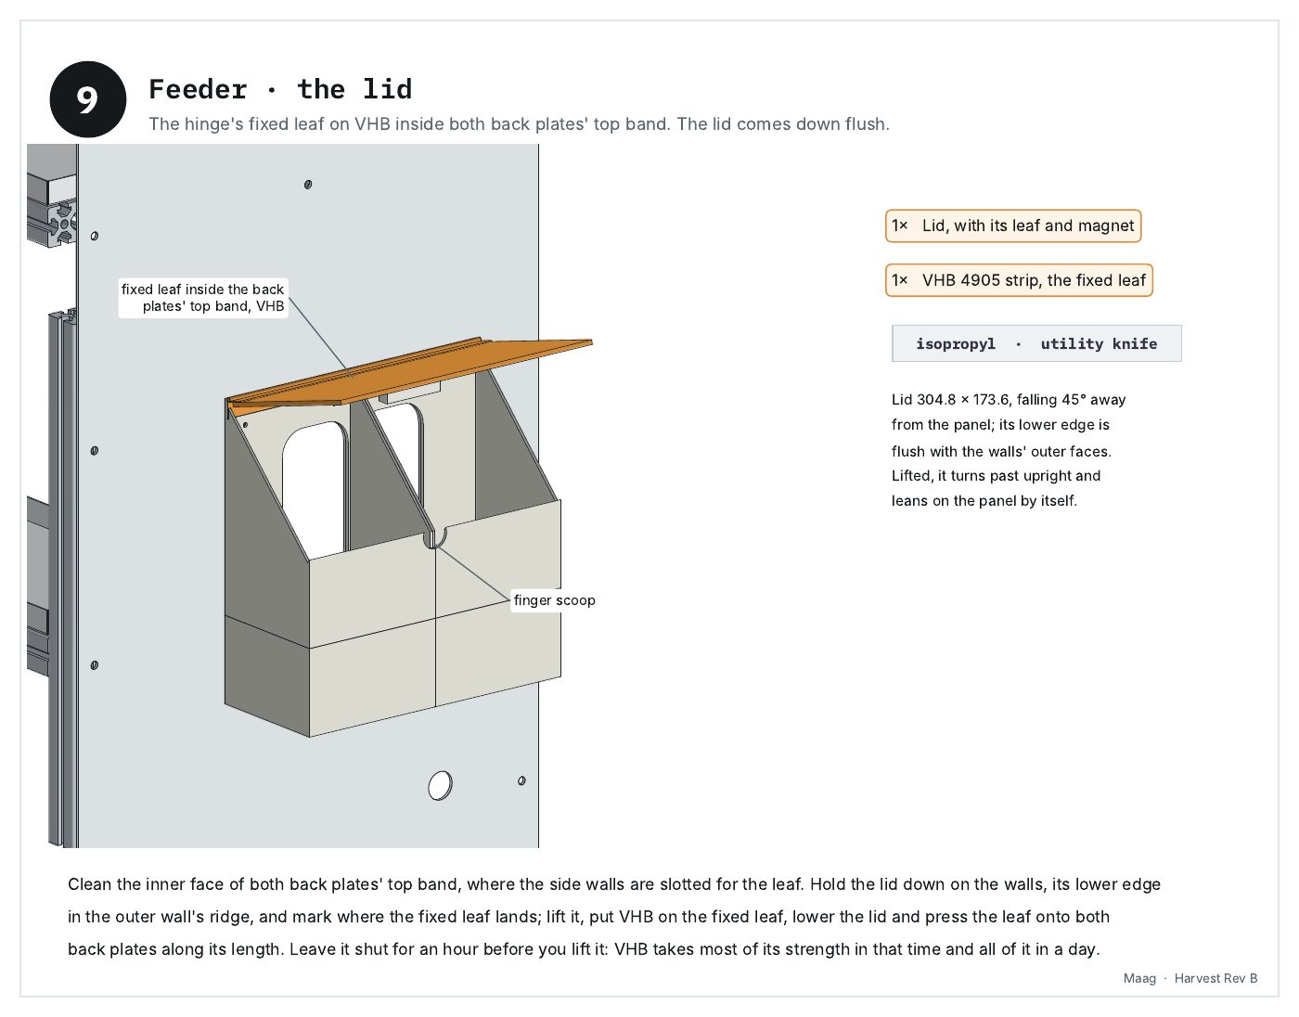
[picture p234: docs/booklets/harvest/p16.jpg]
Harvest Rev B, page 16: Feeder · the lid


### 17 · Step 10 · Trays in, the switch into the door chain

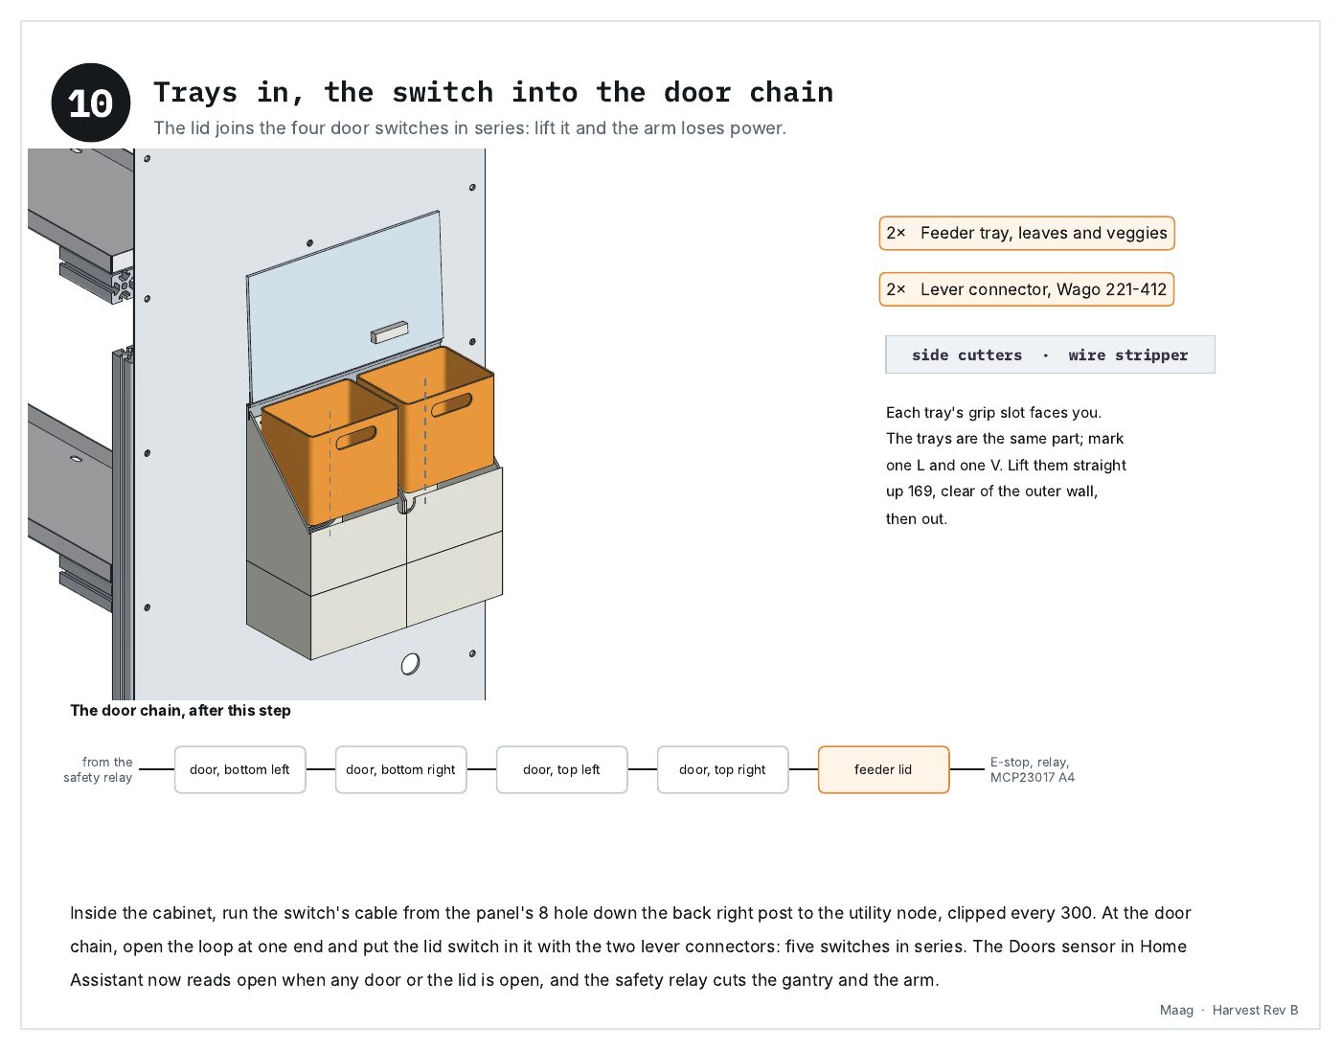
[picture p235: docs/booklets/harvest/p17.jpg]
Harvest Rev B, page 17: Trays in, the switch into the door chain


### 18 · Step 11 · Before the first harvest

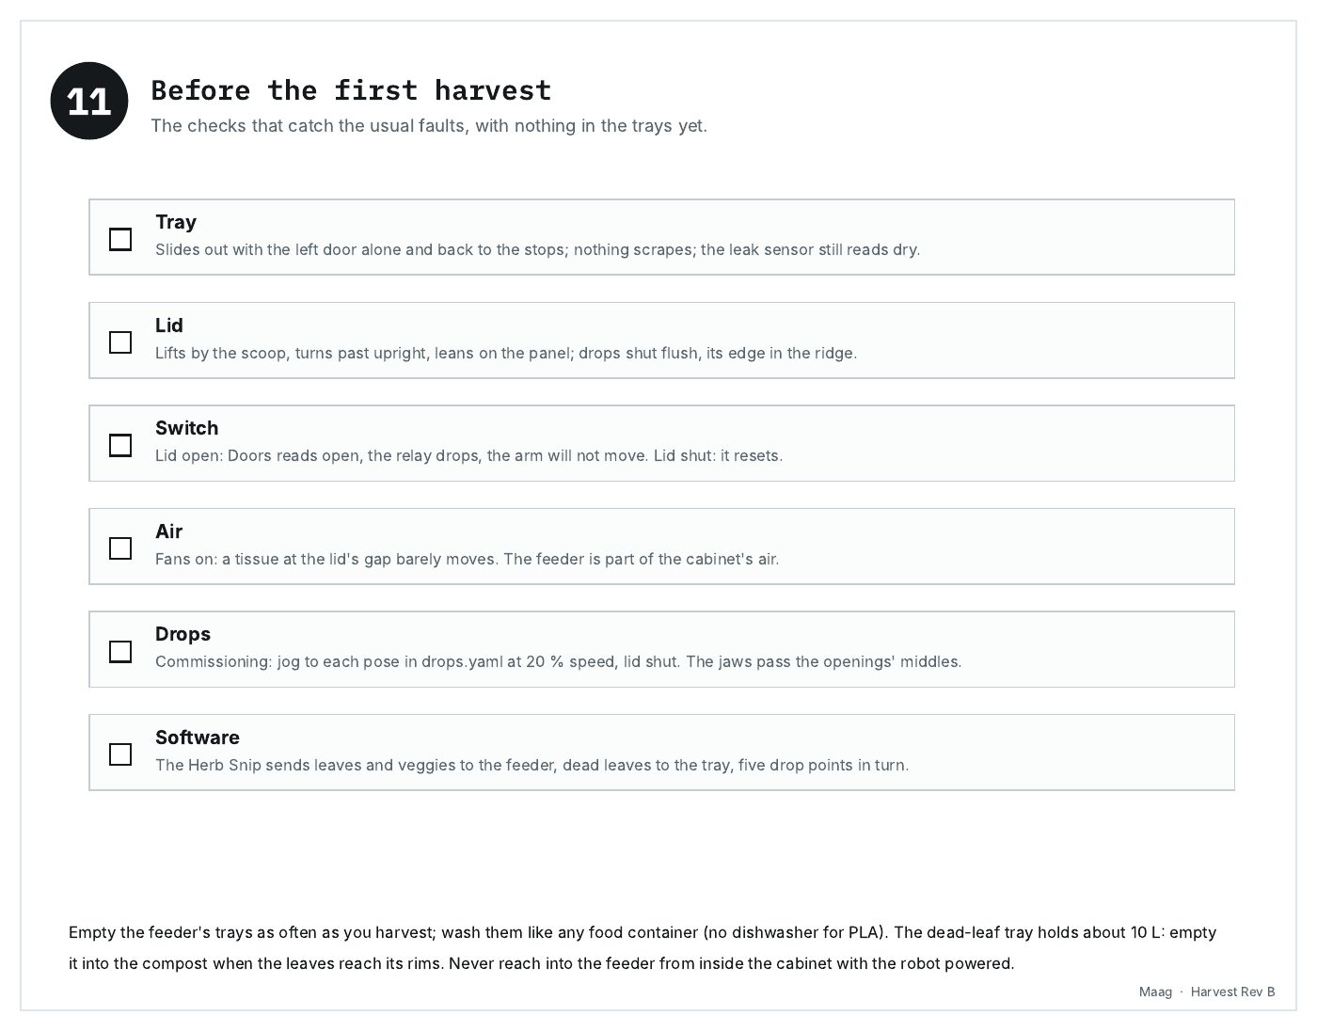
[picture p236: docs/booklets/harvest/p18.jpg]
Harvest Rev B, page 18: Before the first harvest


---

[All booklets](README.md) · previous: [Enclosure Rev A](enclosure.md) · next: [Herb Snip Rev A](snip.md)
