v1proxy/RedTower/docs/booklets/snip.md

# Herb Snip Rev A, page by page

<!-- generated by greenhouse/booklet/make_gallery.py from greenhouse/snip/Maag_Herb_Snip_Assembly_Instructions_RevA.pdf: do not edit -->

The arm's printed cut-and-hold tool: print it, build it, put it on the arm. 18 pages, 12 steps. Each page below is the PDF's own page as an image; click one for full size.

[PDF](../../greenhouse/snip/Maag_Herb_Snip_Assembly_Instructions_RevA.pdf) · [Guide](../../greenhouse/snip/HERB_SNIP.md) · [All booklets](README.md) · previous: [Harvest Rev B](harvest.md)

<details><summary><b>Contents</b>, 18 pages</summary>

- [1 · Cover](#1--cover)
- [2 · How the Herb Snip works](#2--how-the-herb-snip-works)
- [3 · Herb Snip · printed parts](#3--herb-snip--printed-parts)
- [4 · Herb Snip · purchased parts](#4--herb-snip--purchased-parts)
- [5 · Tools](#5--tools)
- [6 · Step 1 · Print the parts](#6--step-1--print-the-parts)
- [7 · Step 2 · Fit the crank to your servo's horn](#7--step-2--fit-the-crank-to-your-servos-horn)
- [8 · Step 3 · The blade between the jaw halves](#8--step-3--the-blade-between-the-jaw-halves)
- [9 · Step 4 · Pads, anvil and the pivot insert](#9--step-4--pads-anvil-and-the-pivot-insert)
- [10 · Step 5 · The jaw on its pivot, and the link](#10--step-5--the-jaw-on-its-pivot-and-the-link)
- [11 · Step 6 · The crank on the servo, at closed](#11--step-6--the-crank-on-the-servo-at-closed)
- [12 · Step 7 · The servo into the housing](#12--step-7--the-servo-into-the-housing)
- [13 · Step 8 · Regulator and leads](#13--step-8--regulator-and-leads)
- [14 · Wiring · the Herb Snip](#14--wiring--the-herb-snip)
- [15 · Step 9 · The camera on its ring](#15--step-9--the-camera-on-its-ring)
- [16 · Step 10 · Onto the arm](#16--step-10--onto-the-arm)
- [17 · Step 11 · Where the cuts go](#17--step-11--where-the-cuts-go)
- [18 · Step 12 · Commission](#18--step-12--commission)

</details>

---

### 1 · Cover

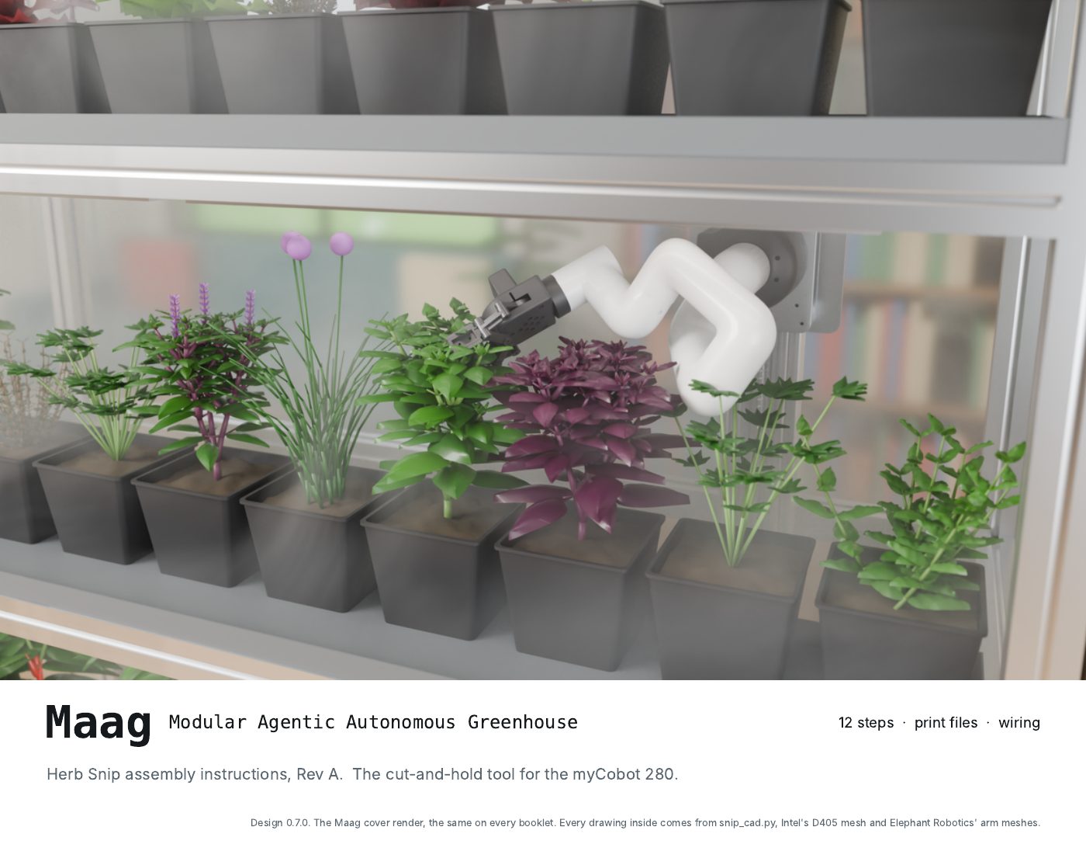
[picture p237: docs/booklets/snip/p01.jpg]
Herb Snip Rev A, page 1: Cover


### 2 · How the Herb Snip works

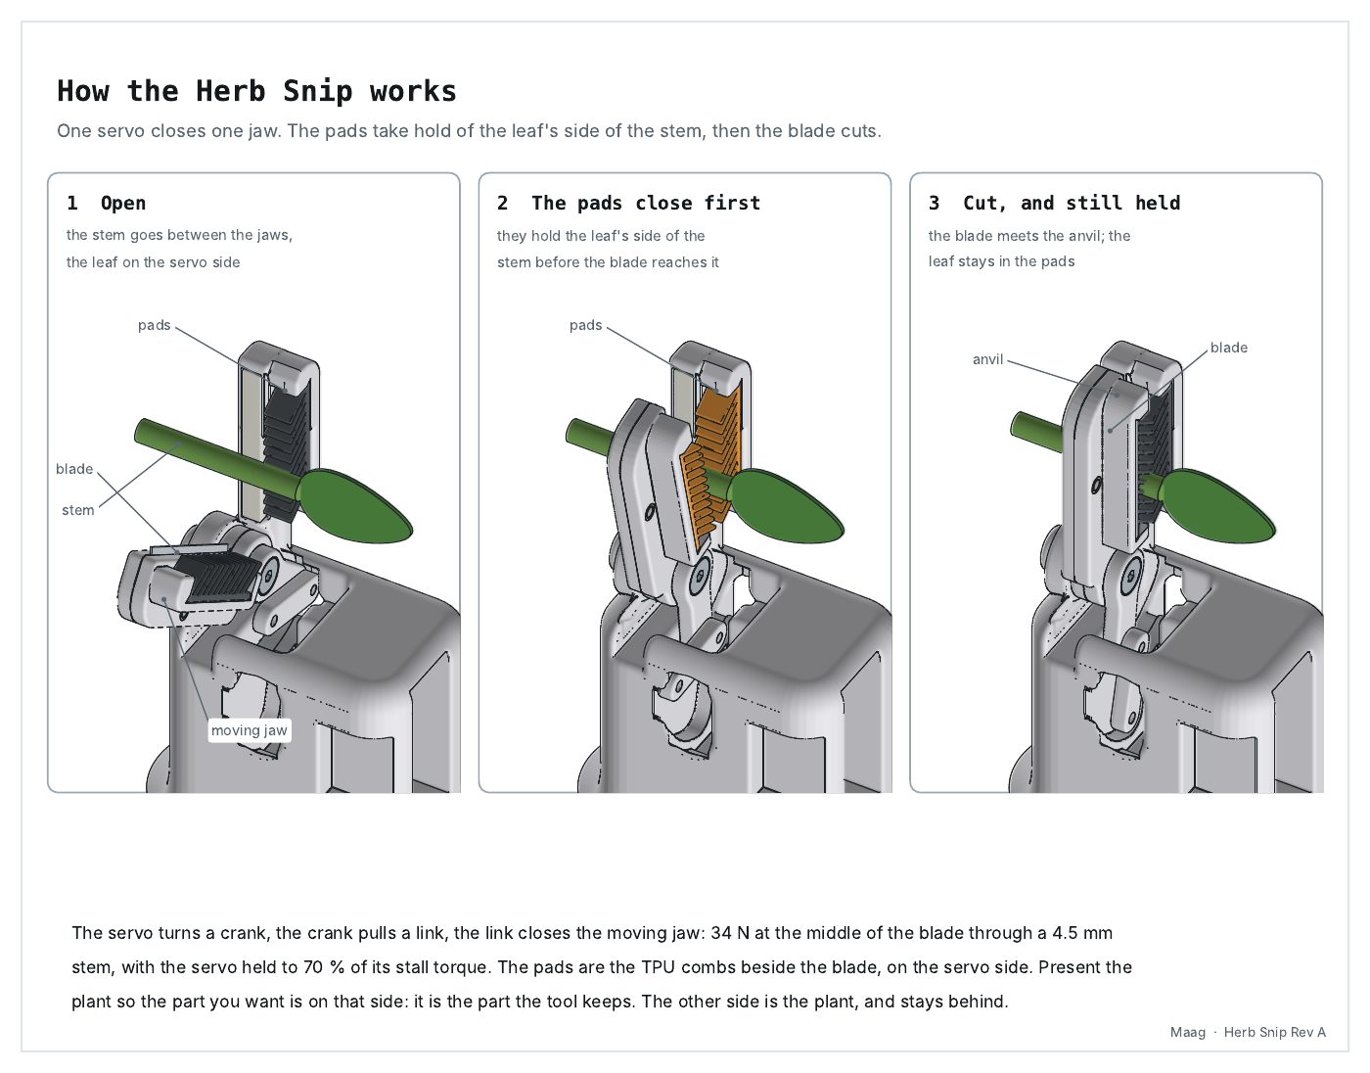
[picture p238: docs/booklets/snip/p02.jpg]
Herb Snip Rev A, page 2: How the Herb Snip works


### 3 · Herb Snip · printed parts

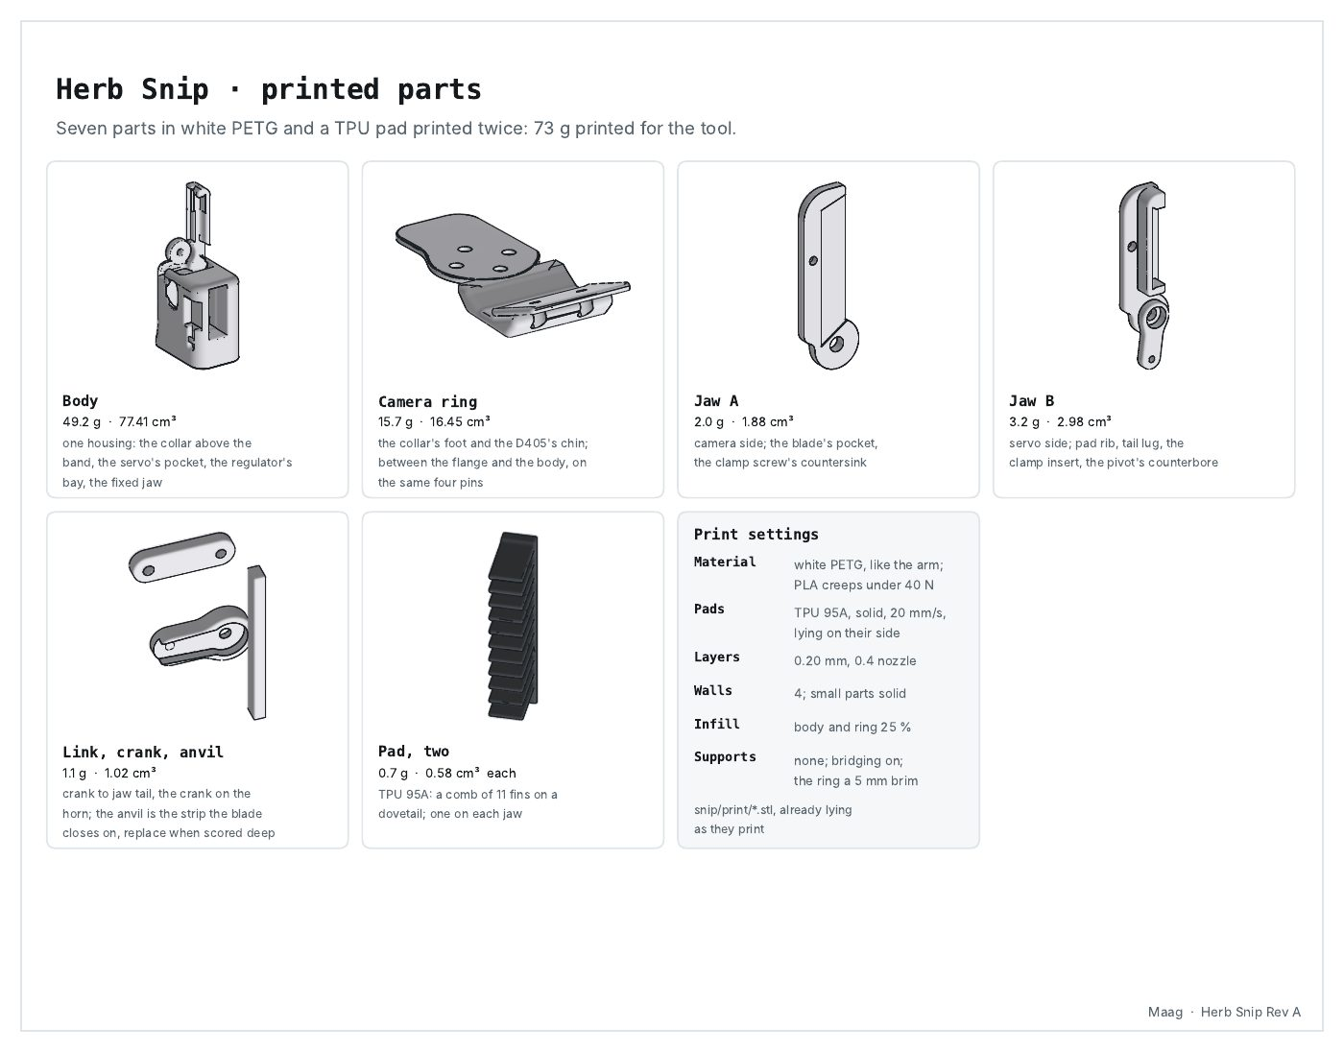
[picture p239: docs/booklets/snip/p03.jpg]
Herb Snip Rev A, page 3: Herb Snip · printed parts


### 4 · Herb Snip · purchased parts

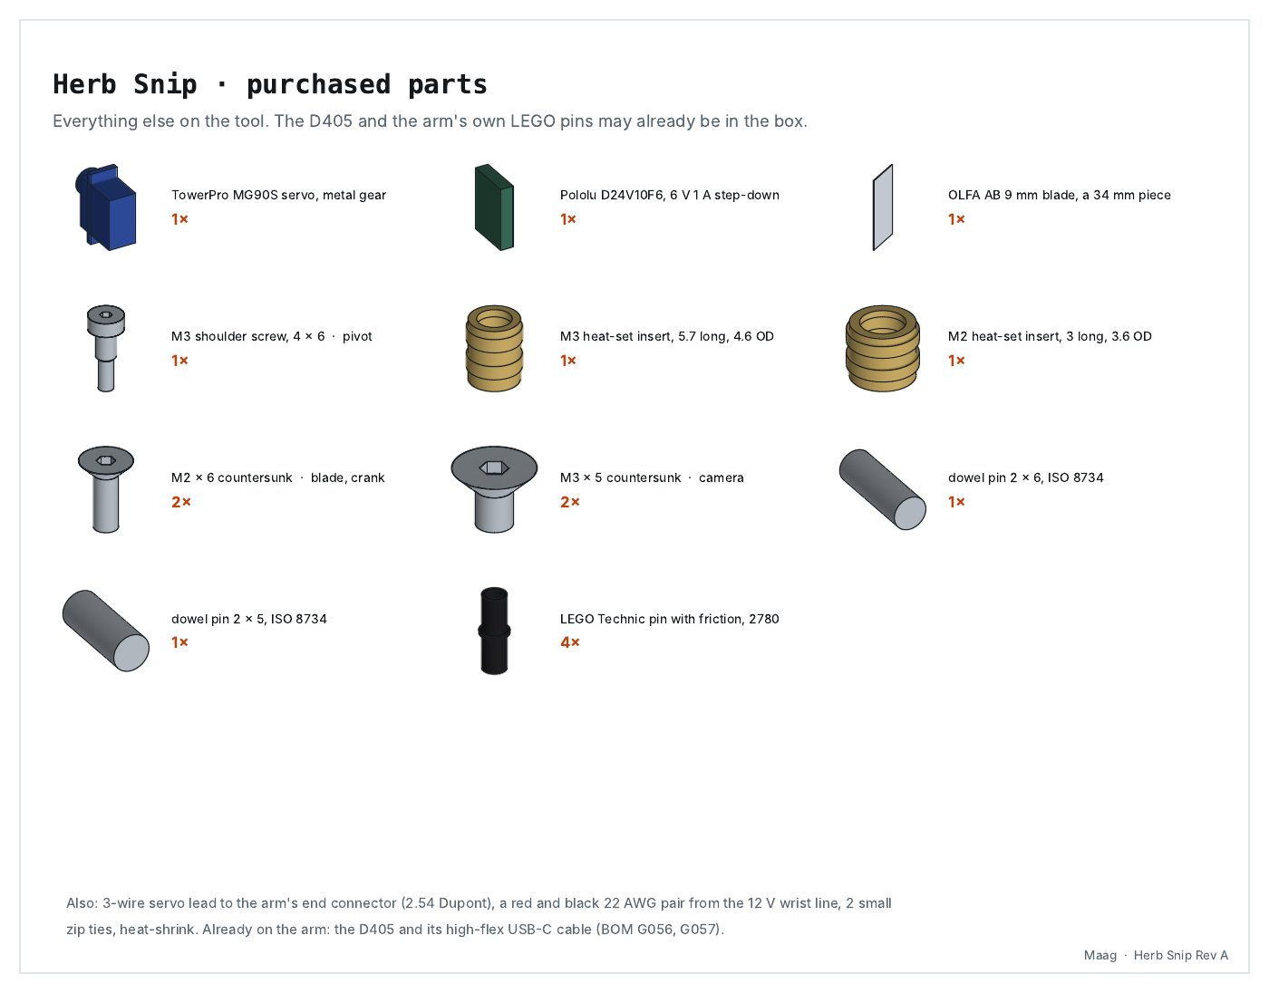
[picture p240: docs/booklets/snip/p04.jpg]
Herb Snip Rev A, page 4: Herb Snip · purchased parts


### 5 · Tools

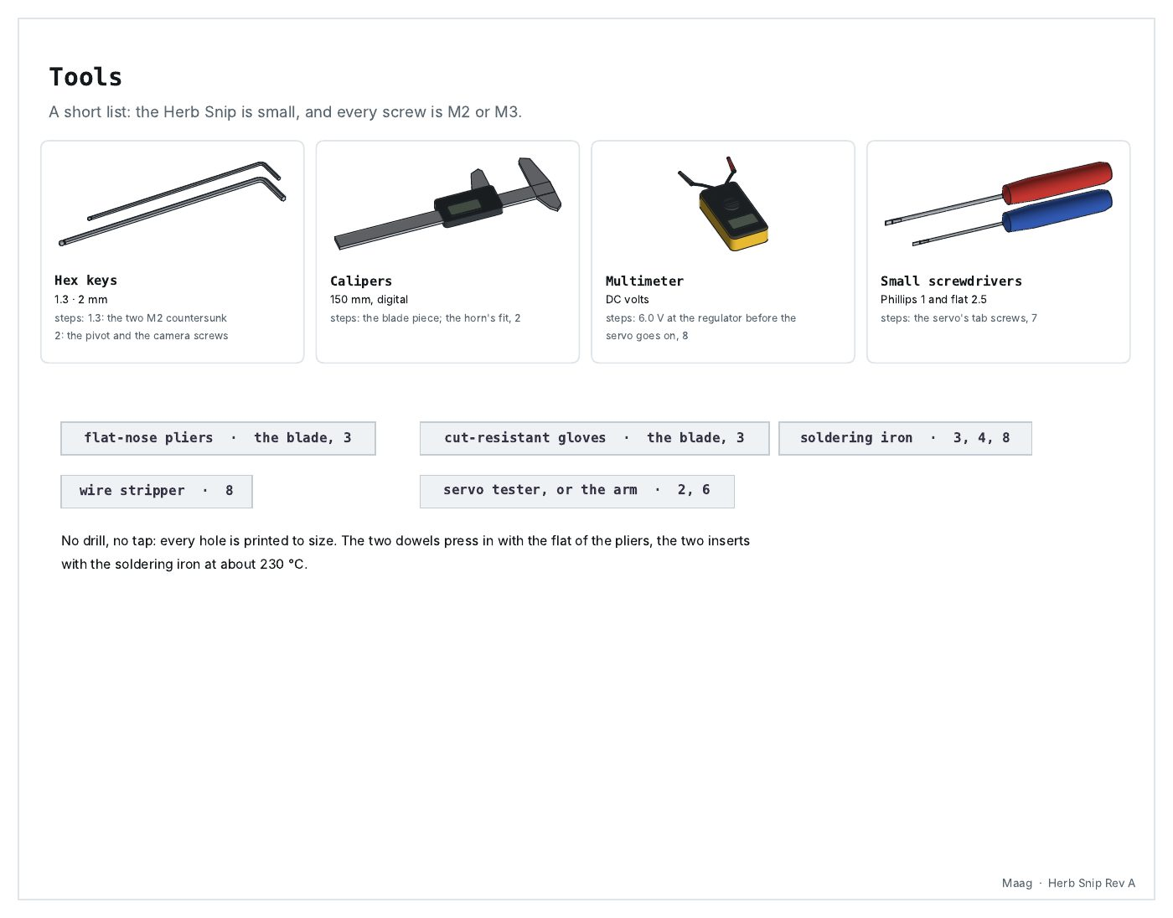
[picture p241: docs/booklets/snip/p05.jpg]
Herb Snip Rev A, page 5: Tools


### 6 · Step 1 · Print the parts

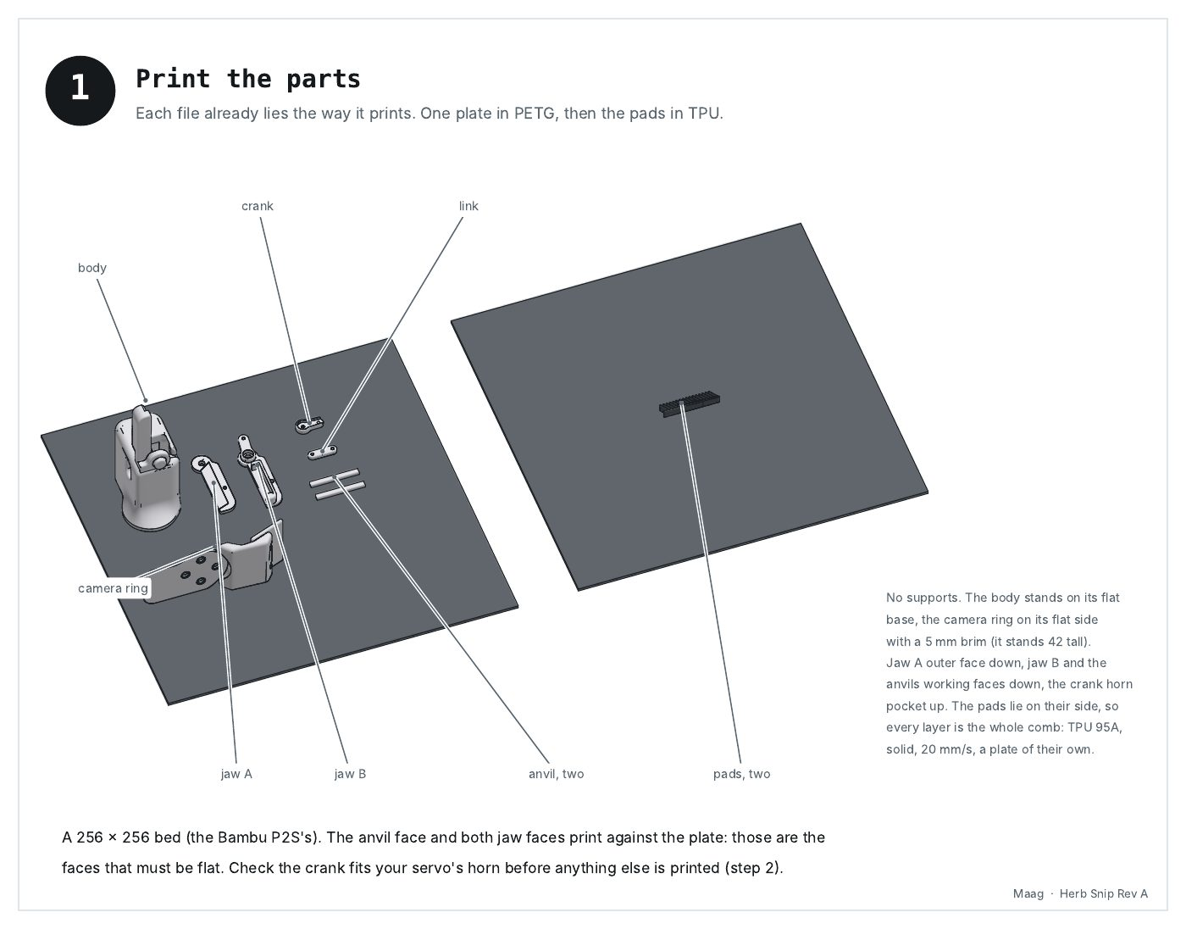
[picture p242: docs/booklets/snip/p06.jpg]
Herb Snip Rev A, page 6: Print the parts


### 7 · Step 2 · Fit the crank to your servo's horn

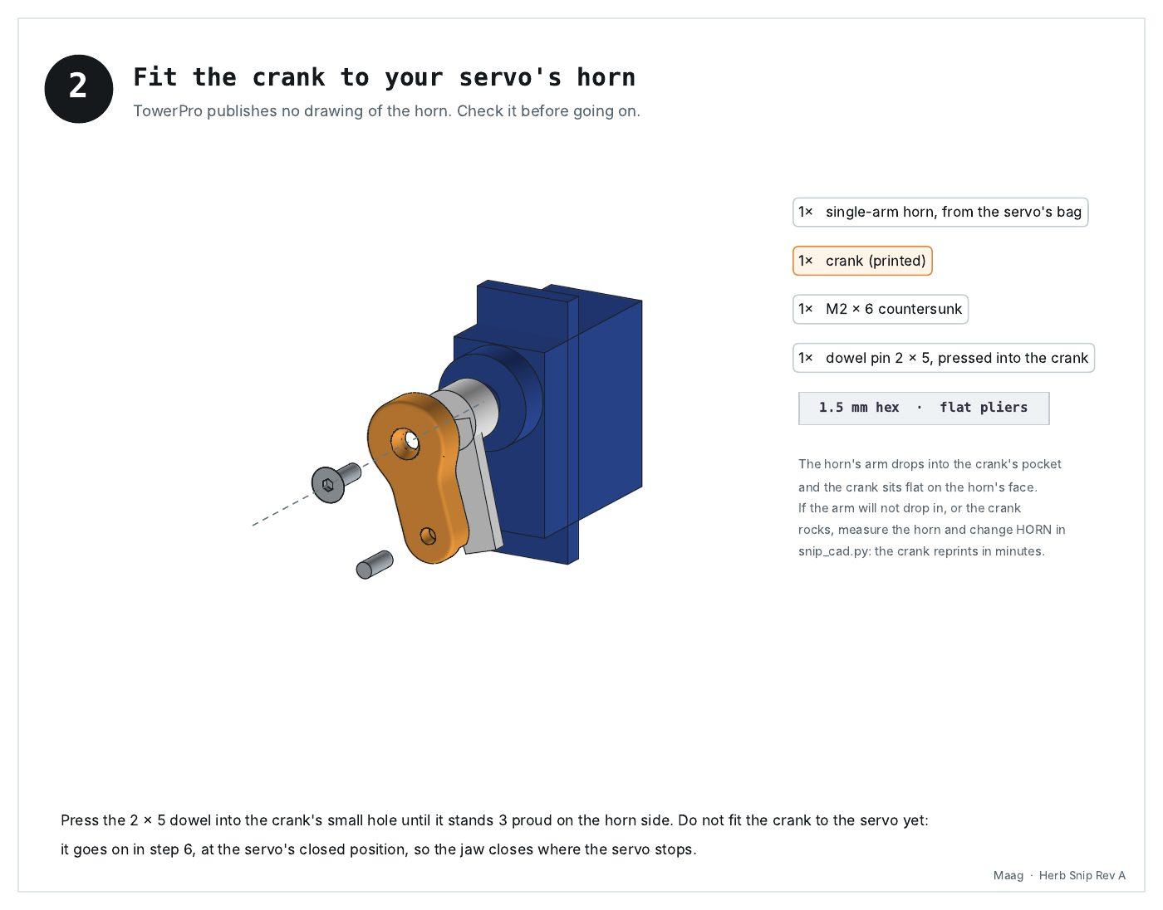
[picture p243: docs/booklets/snip/p07.jpg]
Herb Snip Rev A, page 7: Fit the crank to your servo's horn


### 8 · Step 3 · The blade between the jaw halves

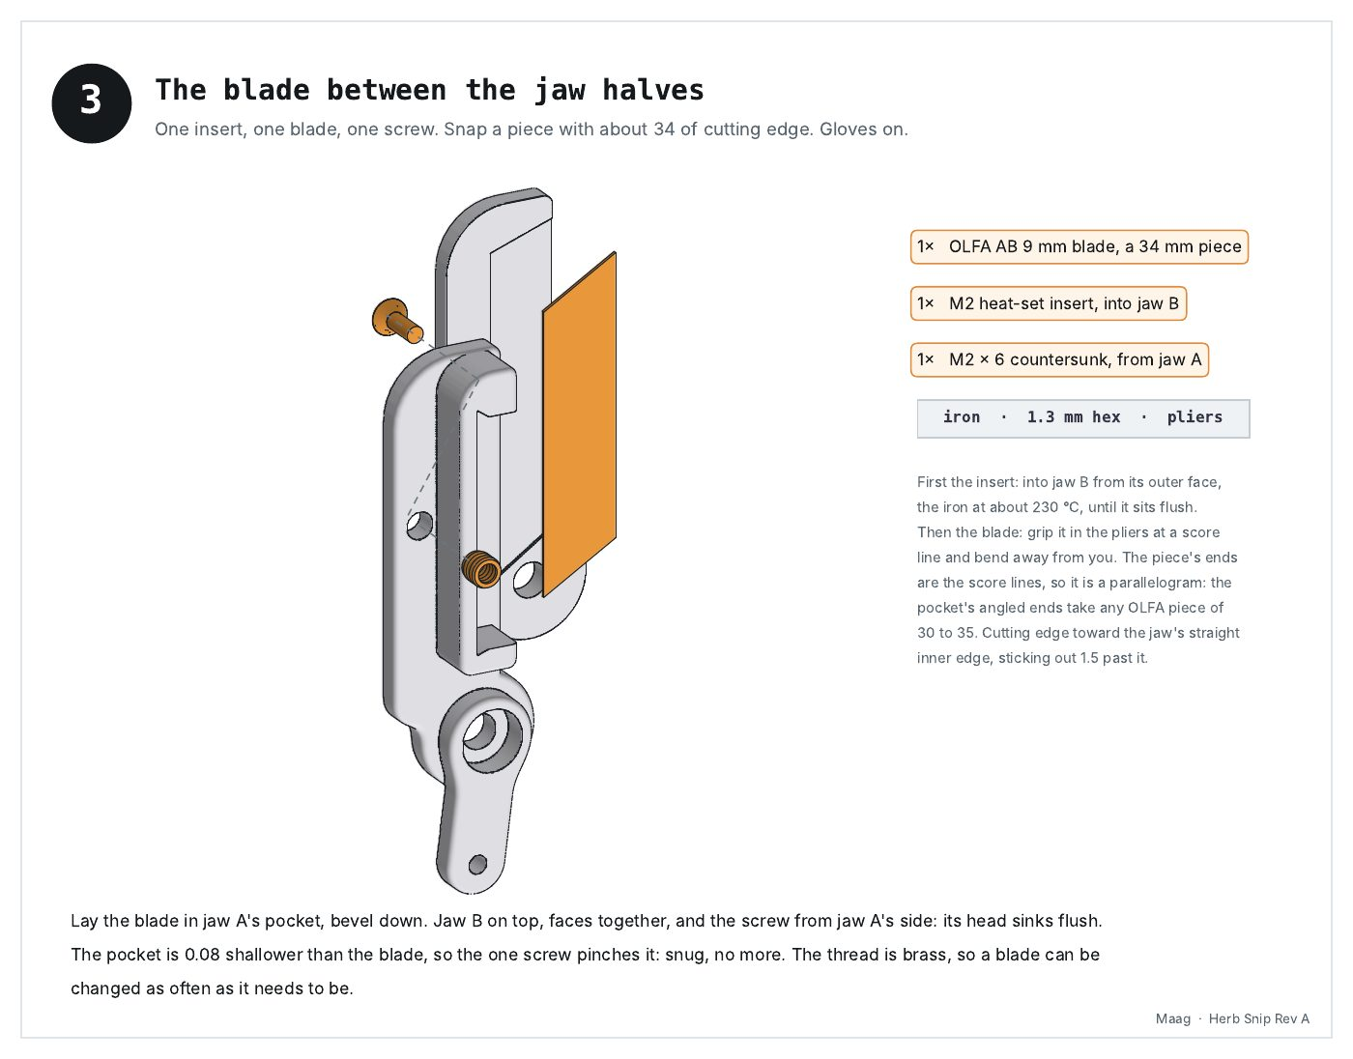
[picture p244: docs/booklets/snip/p08.jpg]
Herb Snip Rev A, page 8: The blade between the jaw halves


### 9 · Step 4 · Pads, anvil and the pivot insert

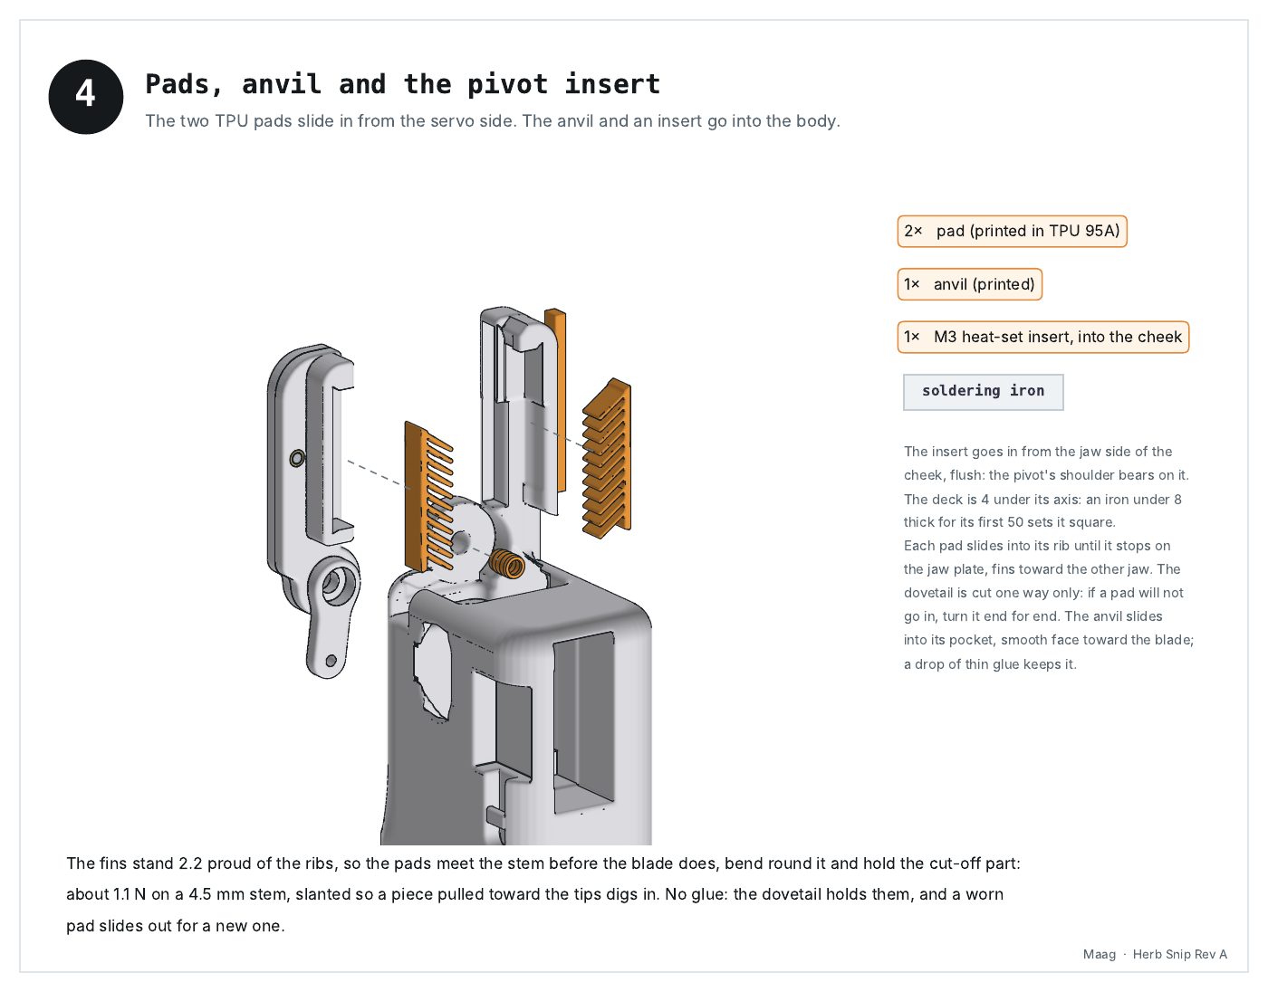
[picture p245: docs/booklets/snip/p09.jpg]
Herb Snip Rev A, page 9: Pads, anvil and the pivot insert


### 10 · Step 5 · The jaw on its pivot, and the link

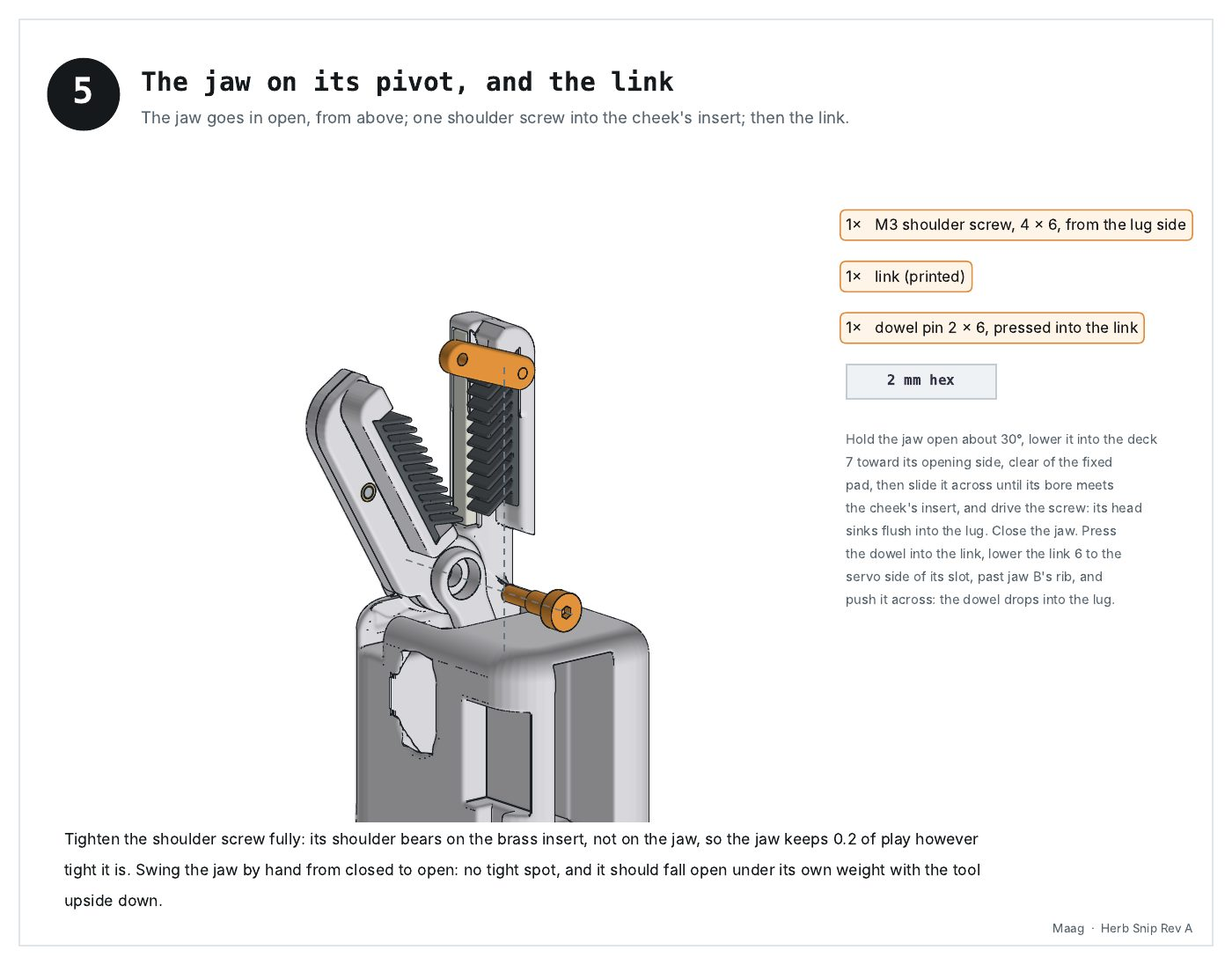
[picture p246: docs/booklets/snip/p10.jpg]
Herb Snip Rev A, page 10: The jaw on its pivot, and the link


### 11 · Step 6 · The crank on the servo, at closed

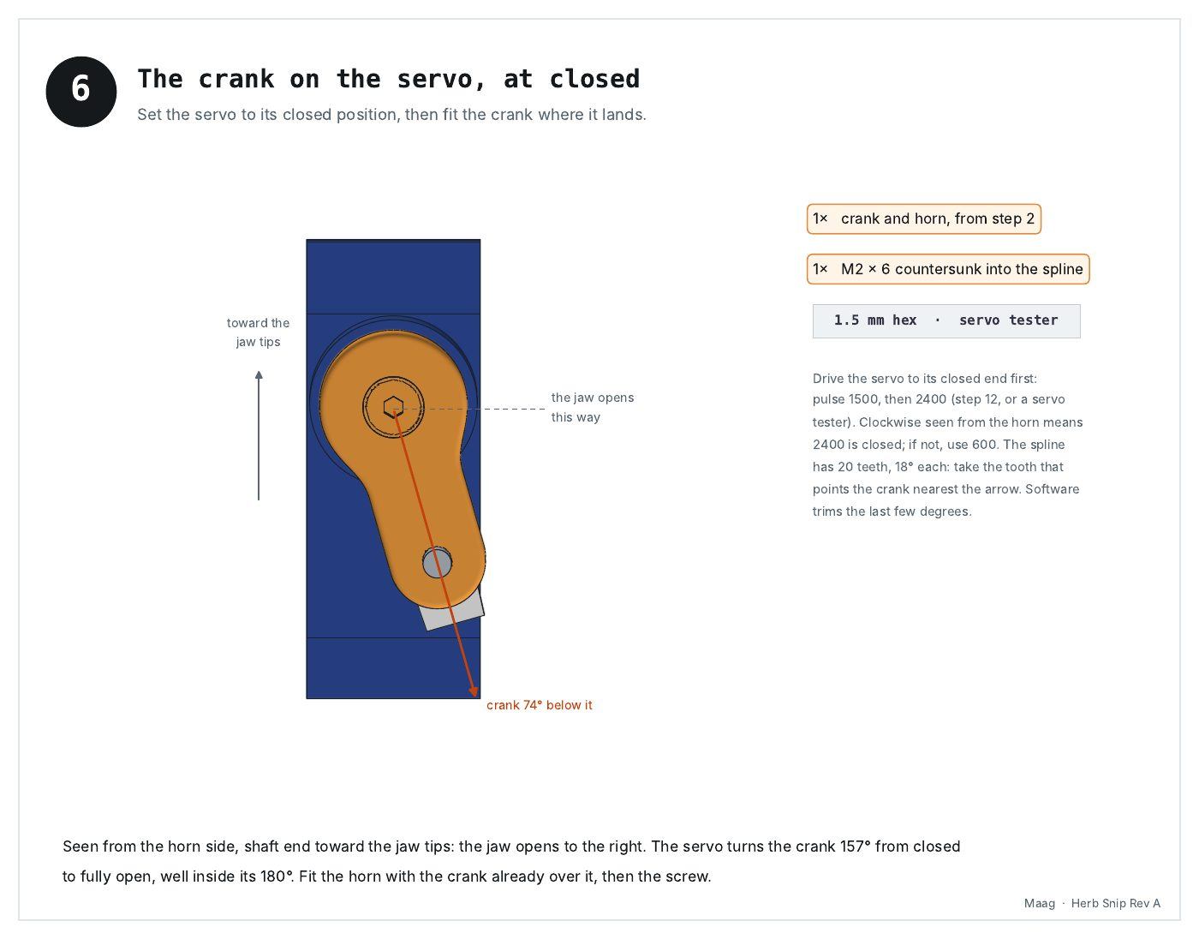
[picture p247: docs/booklets/snip/p11.jpg]
Herb Snip Rev A, page 11: The crank on the servo, at closed


### 12 · Step 7 · The servo into the housing

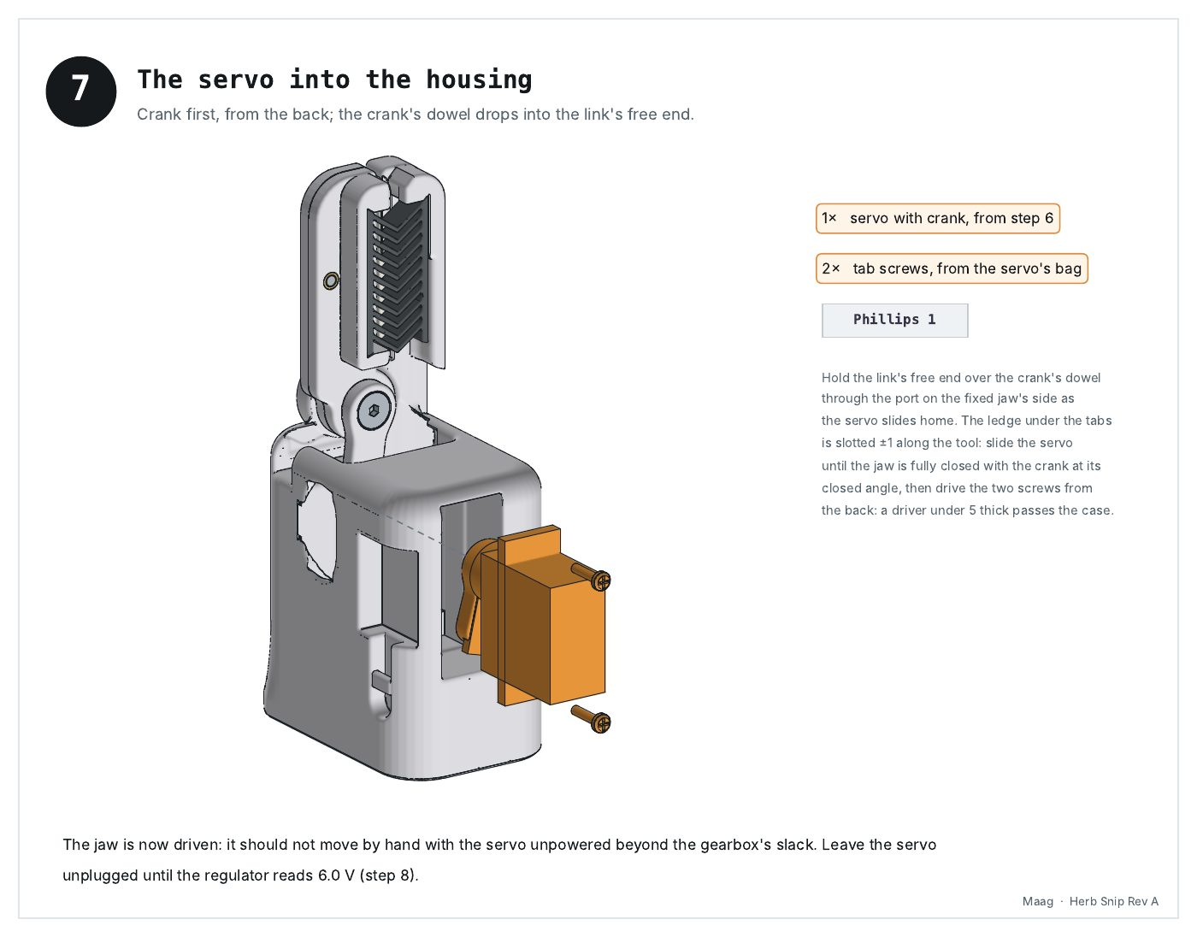
[picture p248: docs/booklets/snip/p12.jpg]
Herb Snip Rev A, page 12: The servo into the housing


### 13 · Step 8 · Regulator and leads

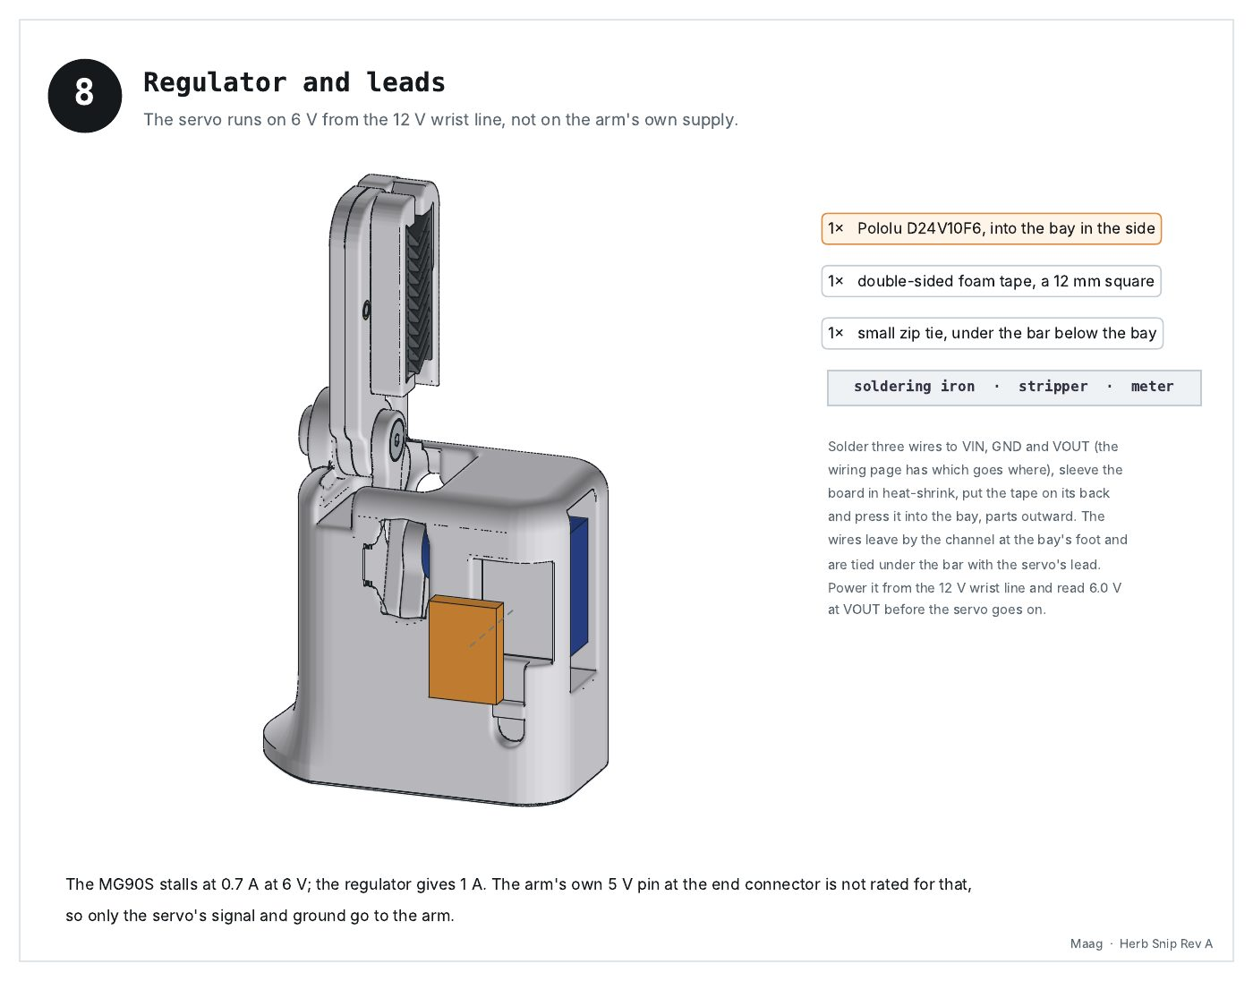
[picture p249: docs/booklets/snip/p13.jpg]
Herb Snip Rev A, page 13: Regulator and leads


### 14 · Wiring · the Herb Snip

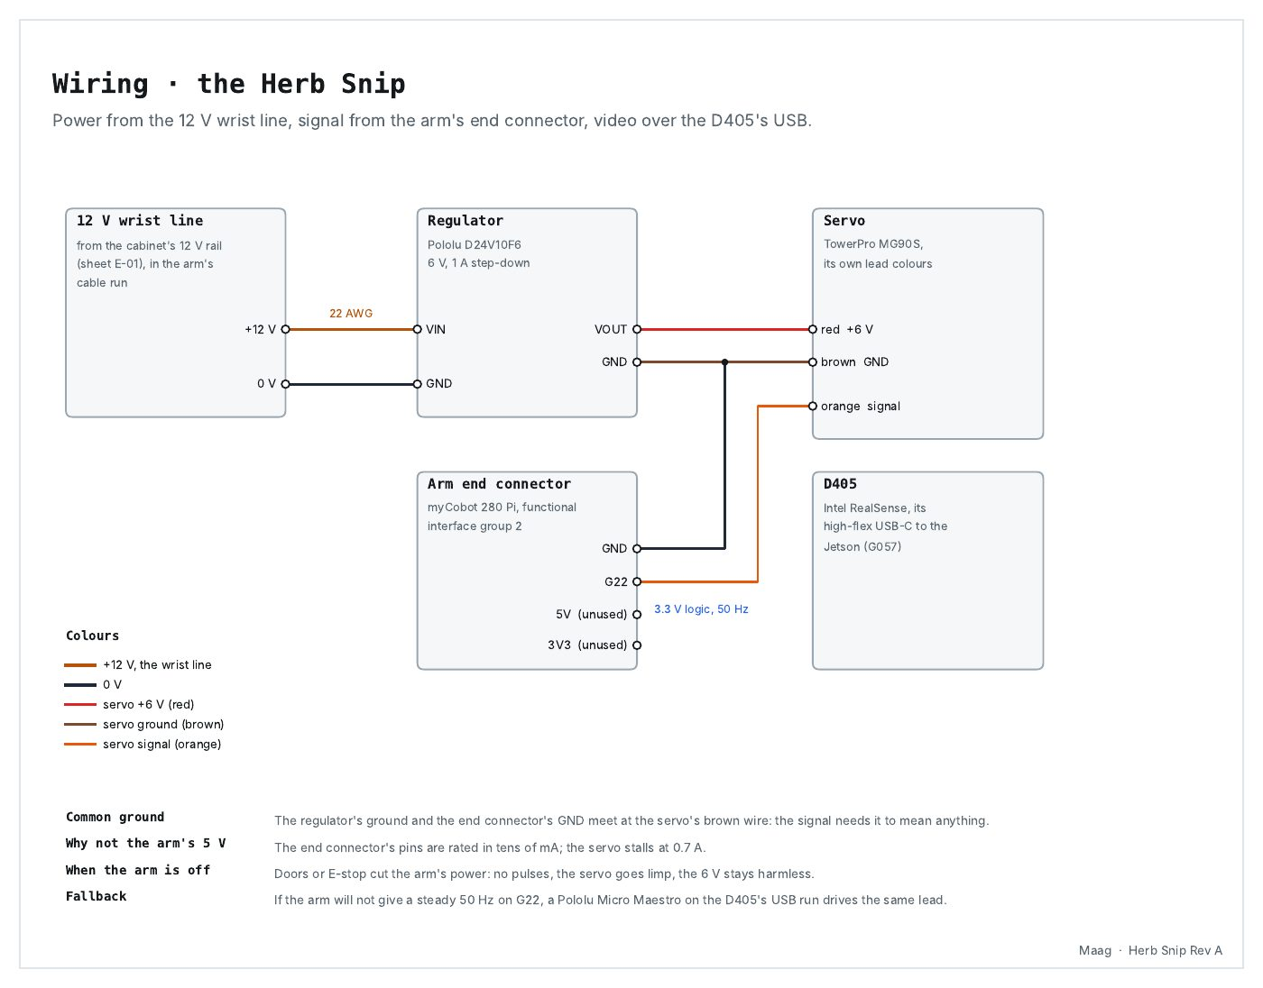
[picture p250: docs/booklets/snip/p14.jpg]
Herb Snip Rev A, page 14: Wiring · the Herb Snip


### 15 · Step 9 · The camera on its ring

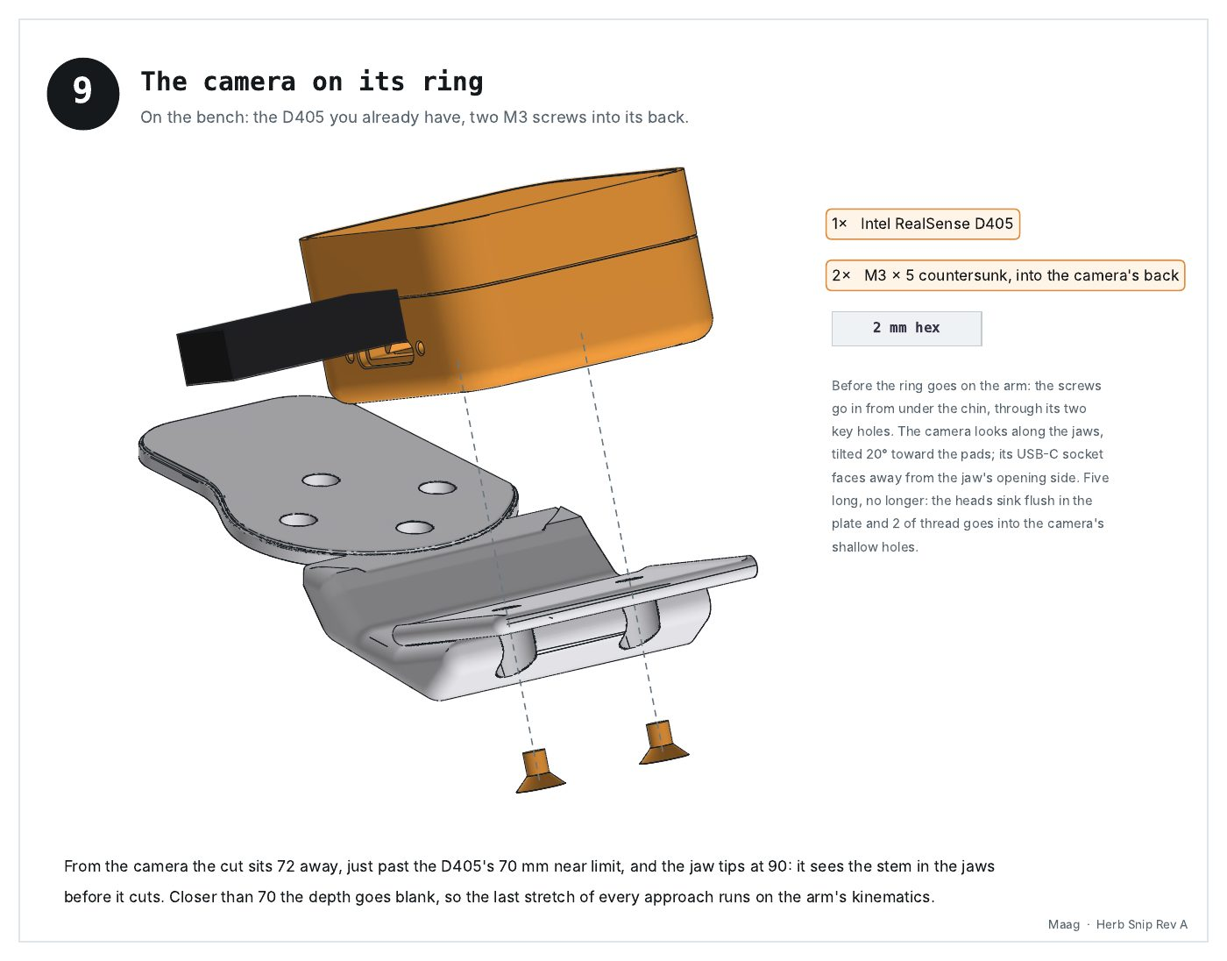
[picture p251: docs/booklets/snip/p15.jpg]
Herb Snip Rev A, page 15: The camera on its ring


### 16 · Step 10 · Onto the arm

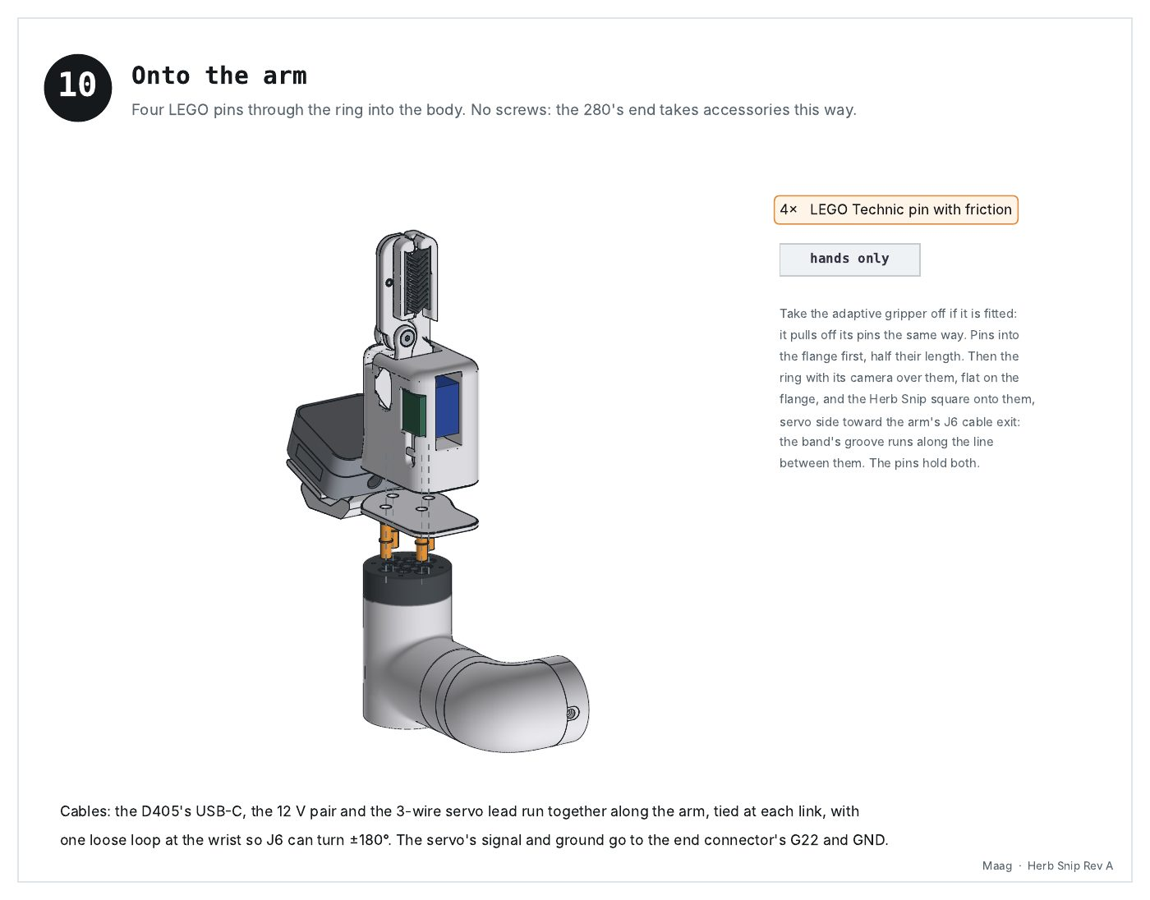
[picture p252: docs/booklets/snip/p16.jpg]
Herb Snip Rev A, page 16: Onto the arm


### 17 · Step 11 · Where the cuts go

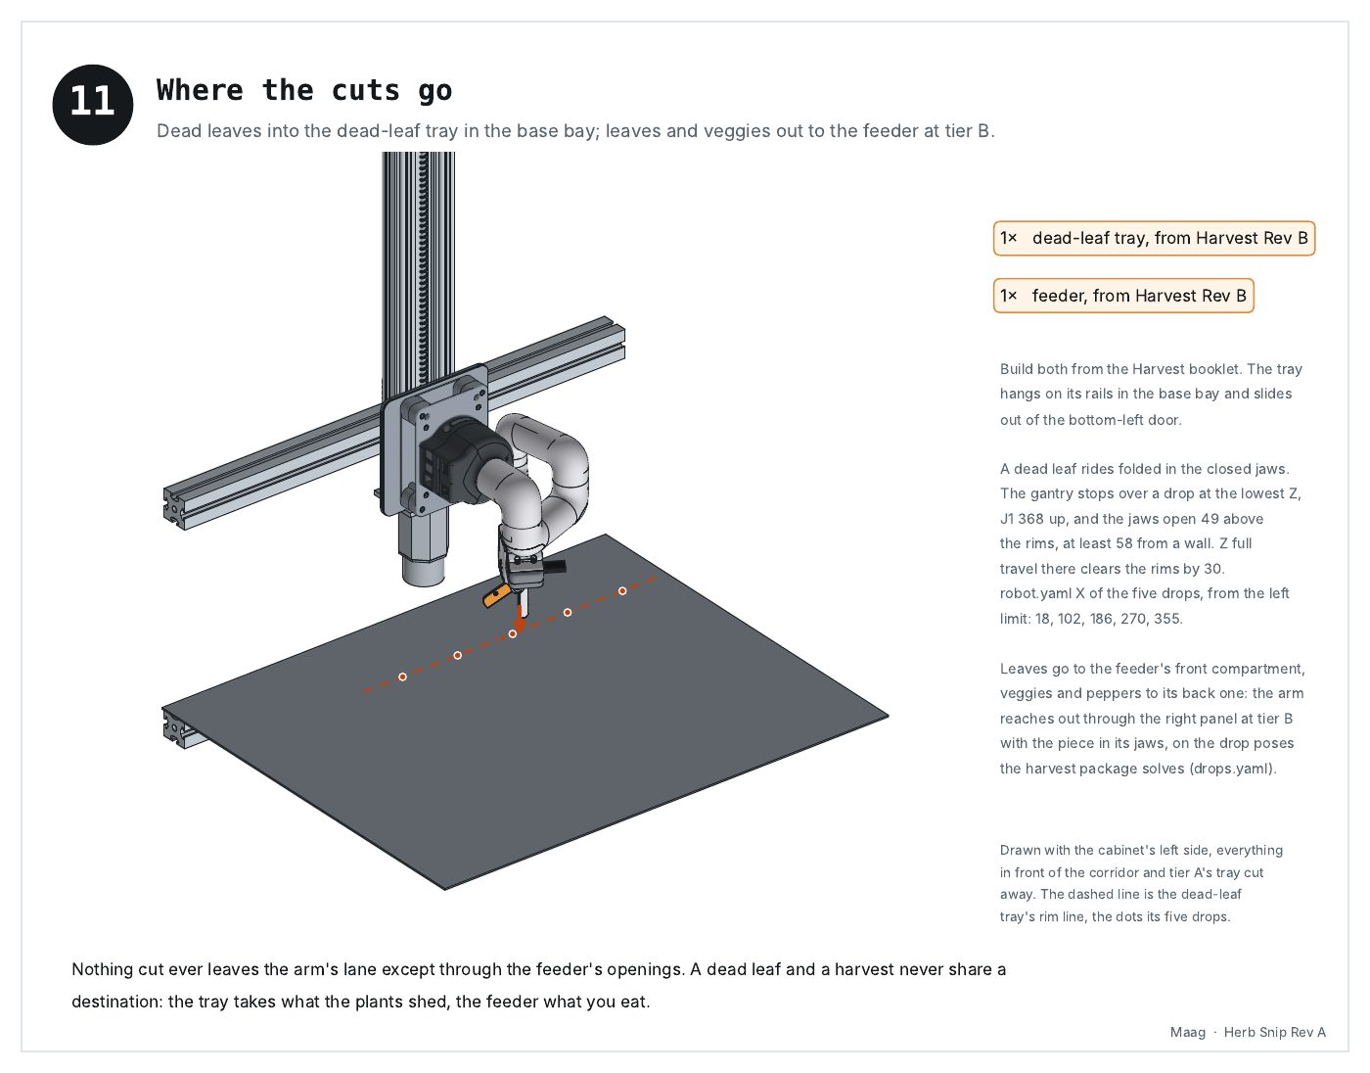
[picture p253: docs/booklets/snip/p17.jpg]
Herb Snip Rev A, page 17: Where the cuts go


### 18 · Step 12 · Commission

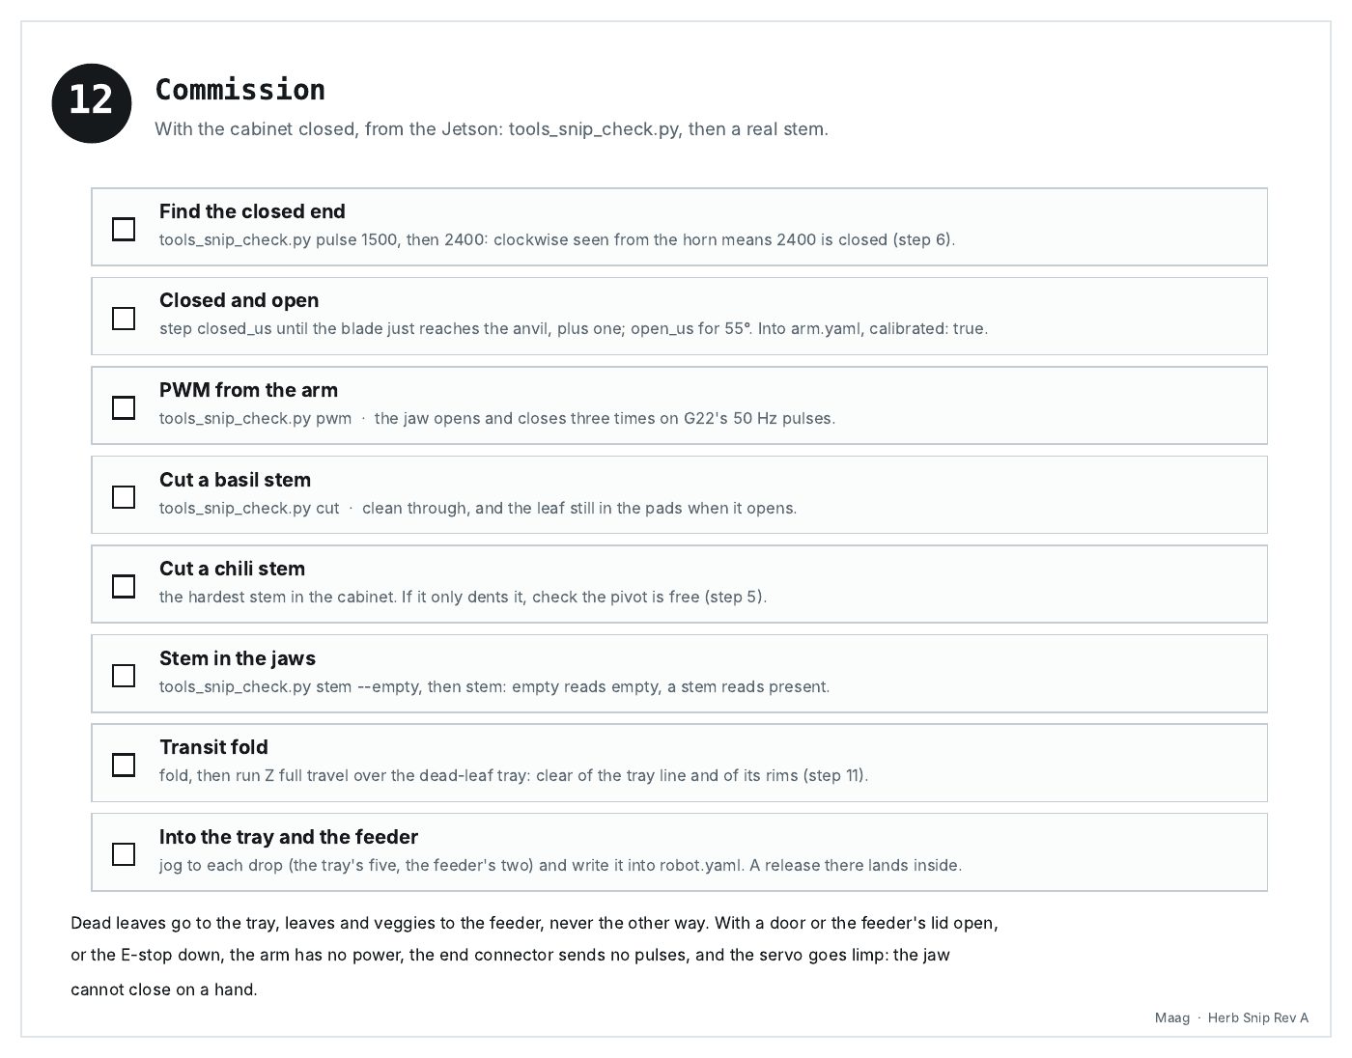
[picture p254: docs/booklets/snip/p18.jpg]
Herb Snip Rev A, page 18: Commission


---

[All booklets](README.md) · previous: [Harvest Rev B](harvest.md)
