v1proxy/RedTower/docs/interface/panel-desktop-1320.png

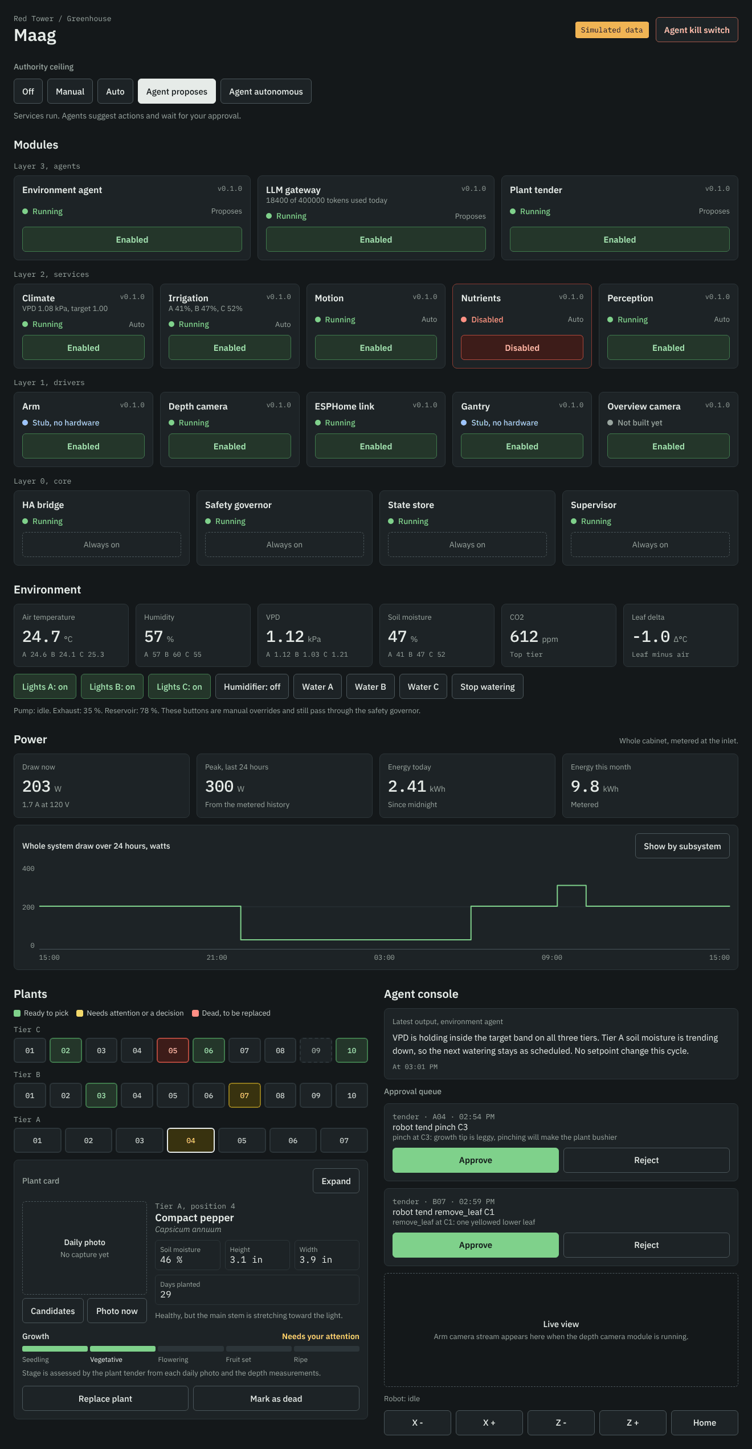
docs/interface/panel-desktop-1320.png
