v1proxy/RedTower/docs/interface/panel-mobile-390.png

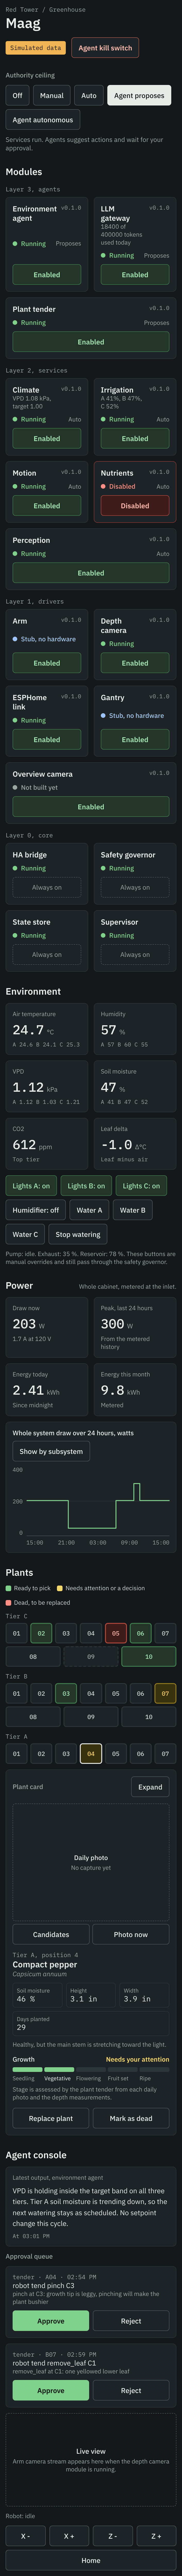
docs/interface/panel-mobile-390.png
