v1proxy/RedTower/docs/interface/panel-tablet-600.png

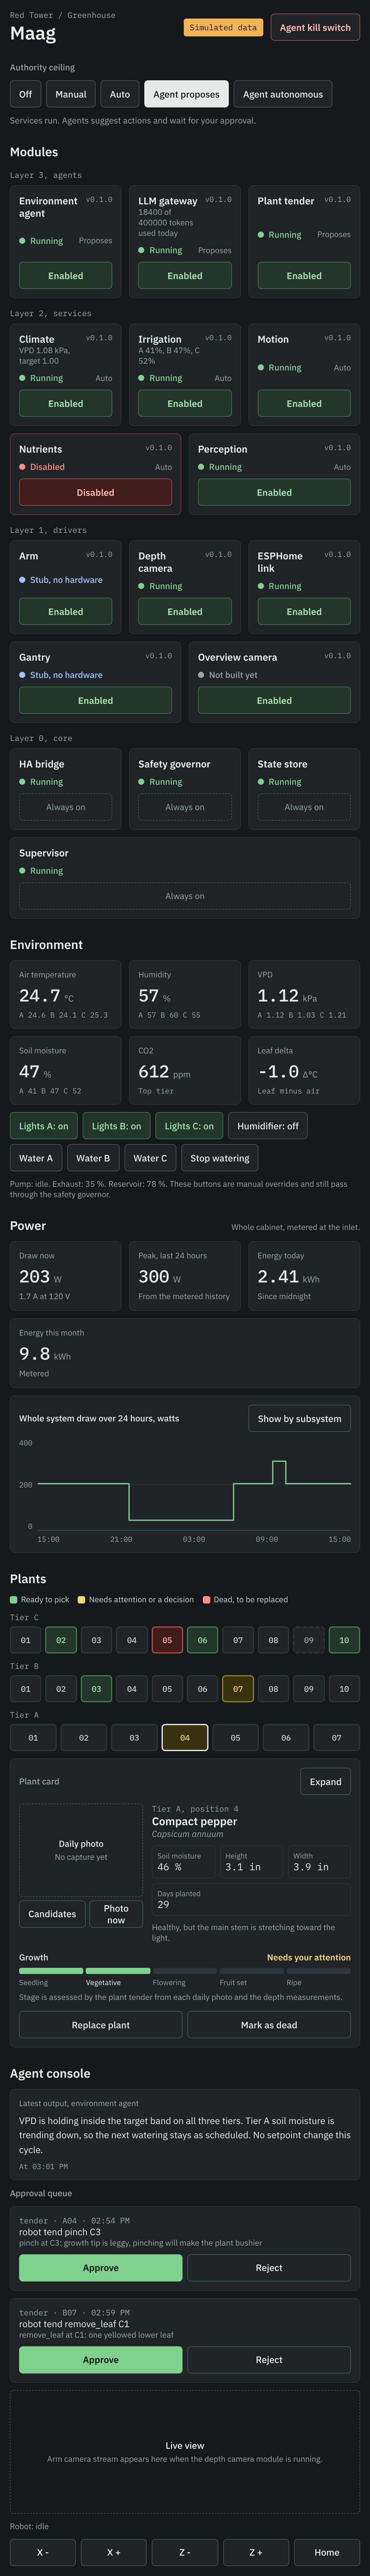
docs/interface/panel-tablet-600.png
