v1proxy/RedTower/greenhouse/drawings/arm_plate_gantry_mount.png

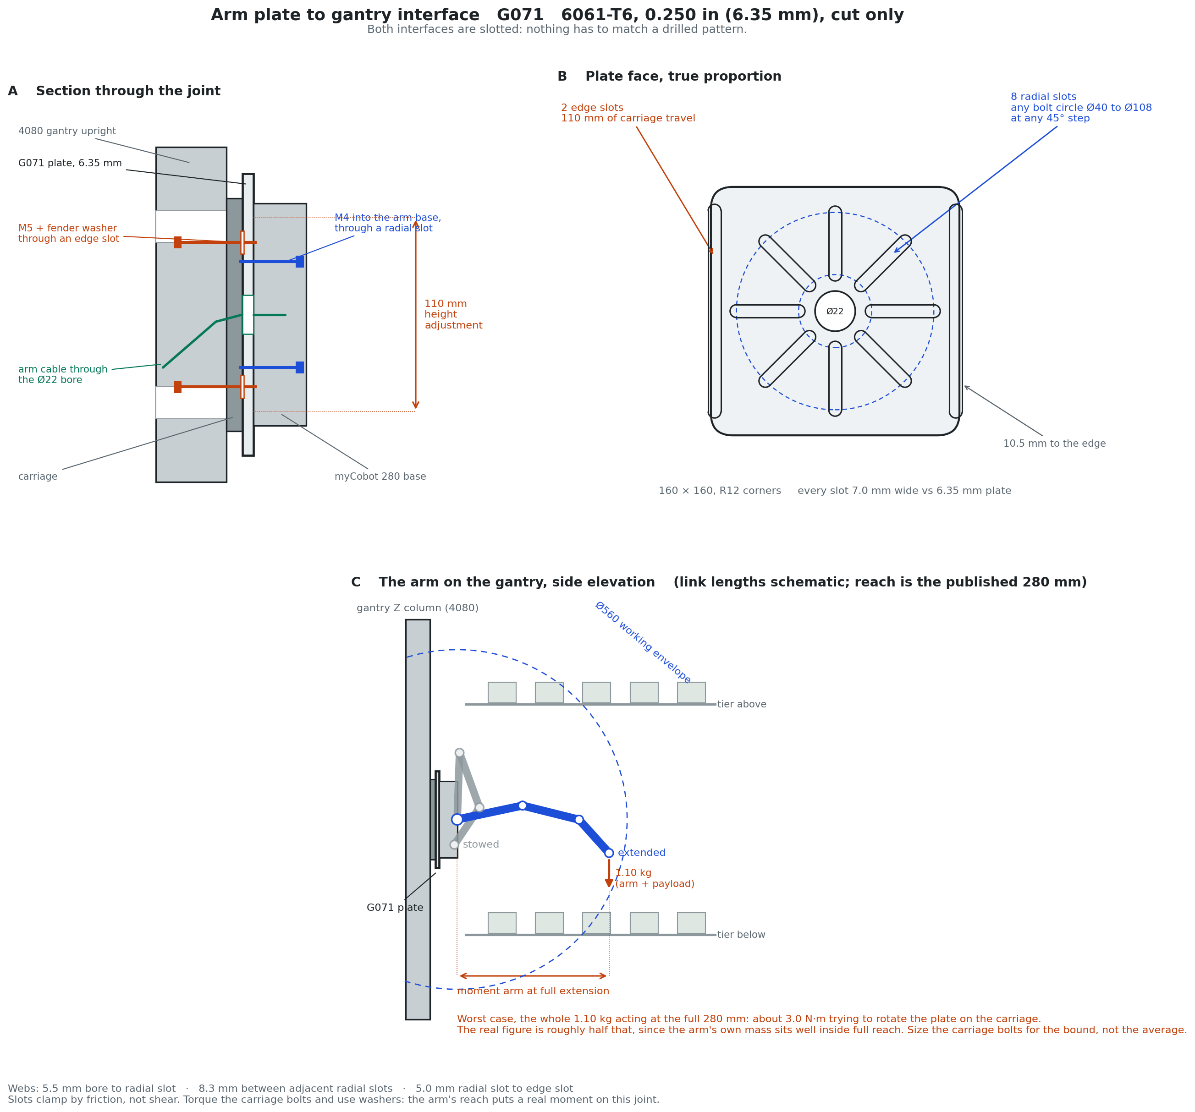
greenhouse/drawings/arm_plate_gantry_mount.png
