v1proxy/RedTower/greenhouse/drawings/bracket_tables_rev5.png

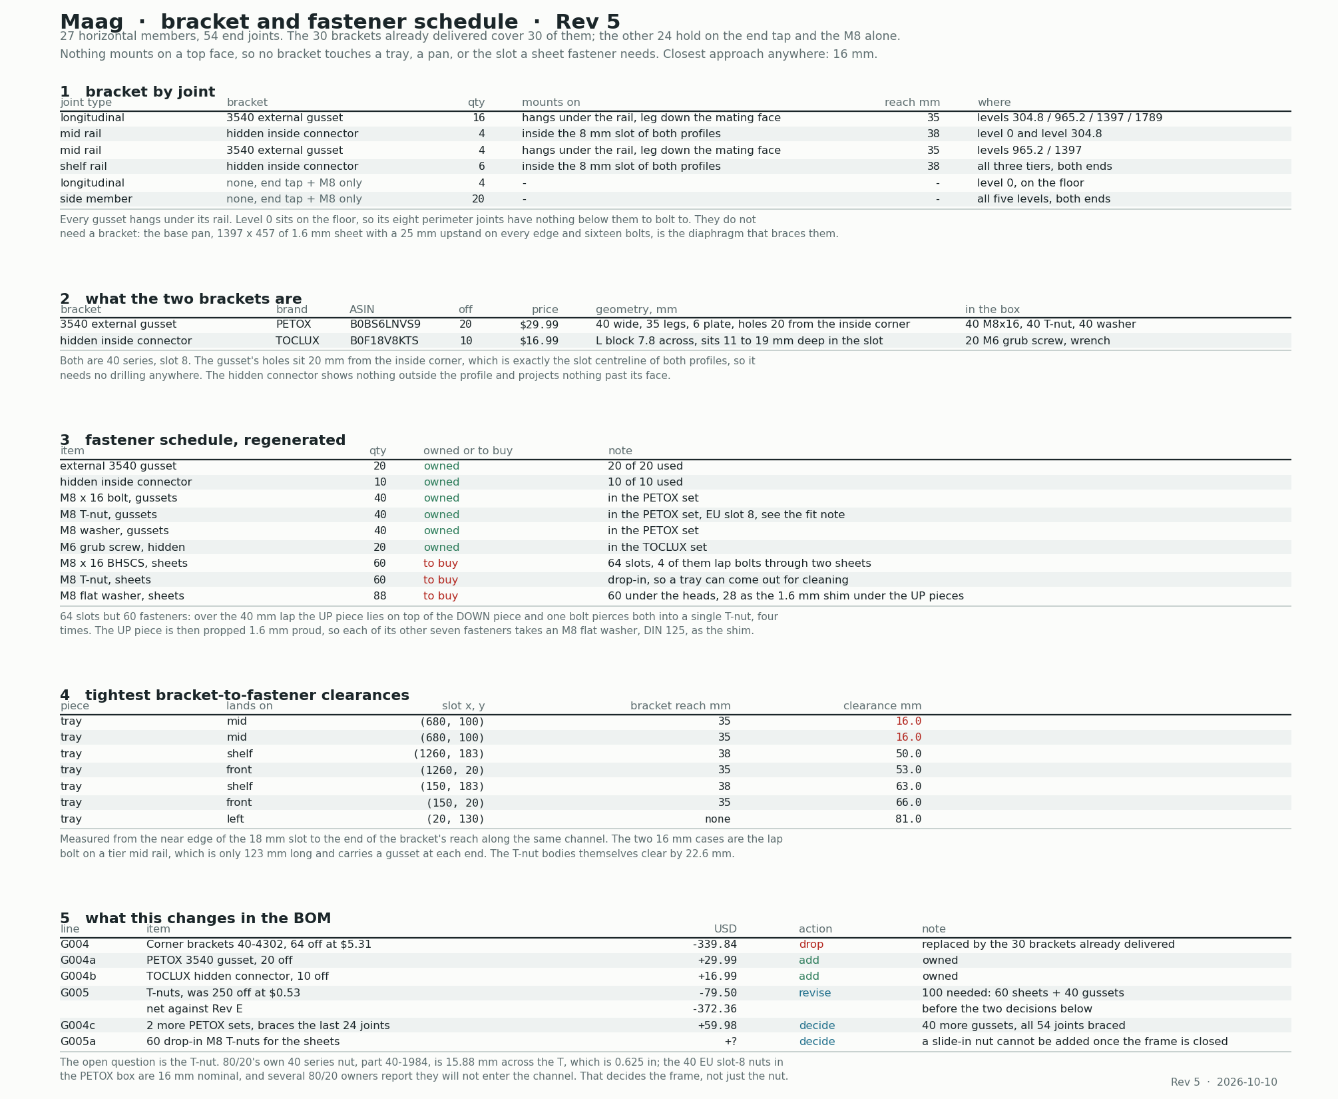
greenhouse/drawings/bracket_tables_rev5.png
