v1proxy/RedTower/greenhouse/drawings/greenhouse_section.png

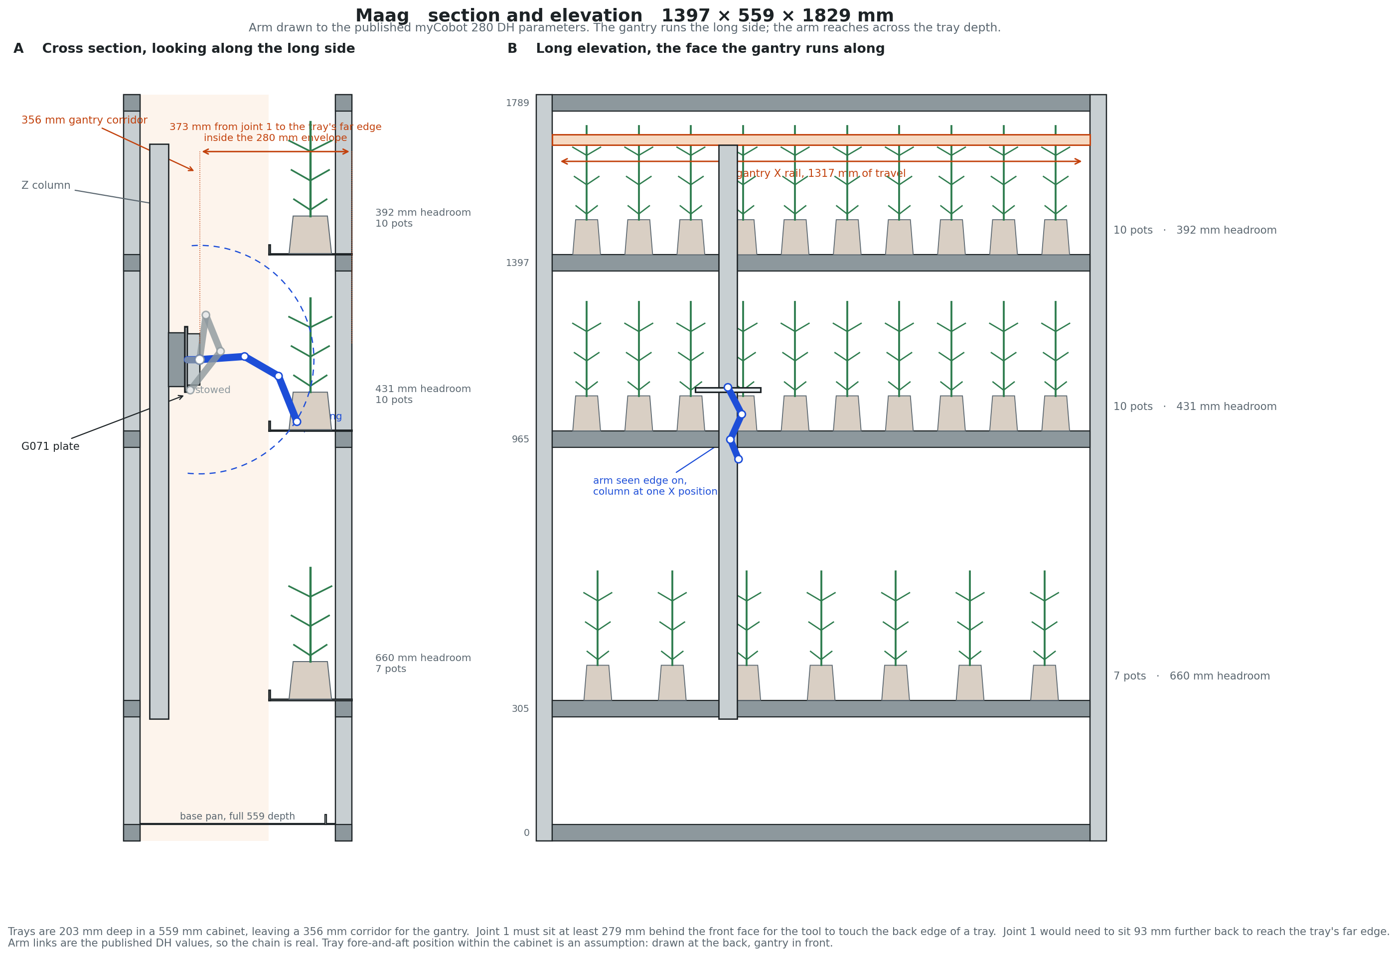
greenhouse/drawings/greenhouse_section.png
