v1proxy/RedTower/greenhouse/drawings/mycobot280_ga.png

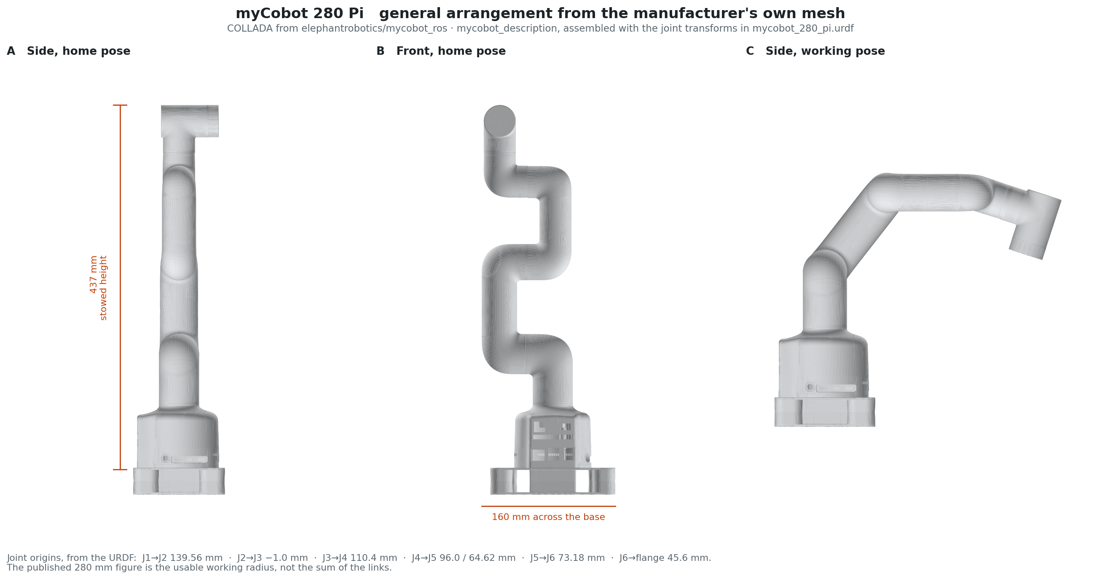
greenhouse/drawings/mycobot280_ga.png
