v1proxy/RedTower/greenhouse/drawings/slot_schedule.png

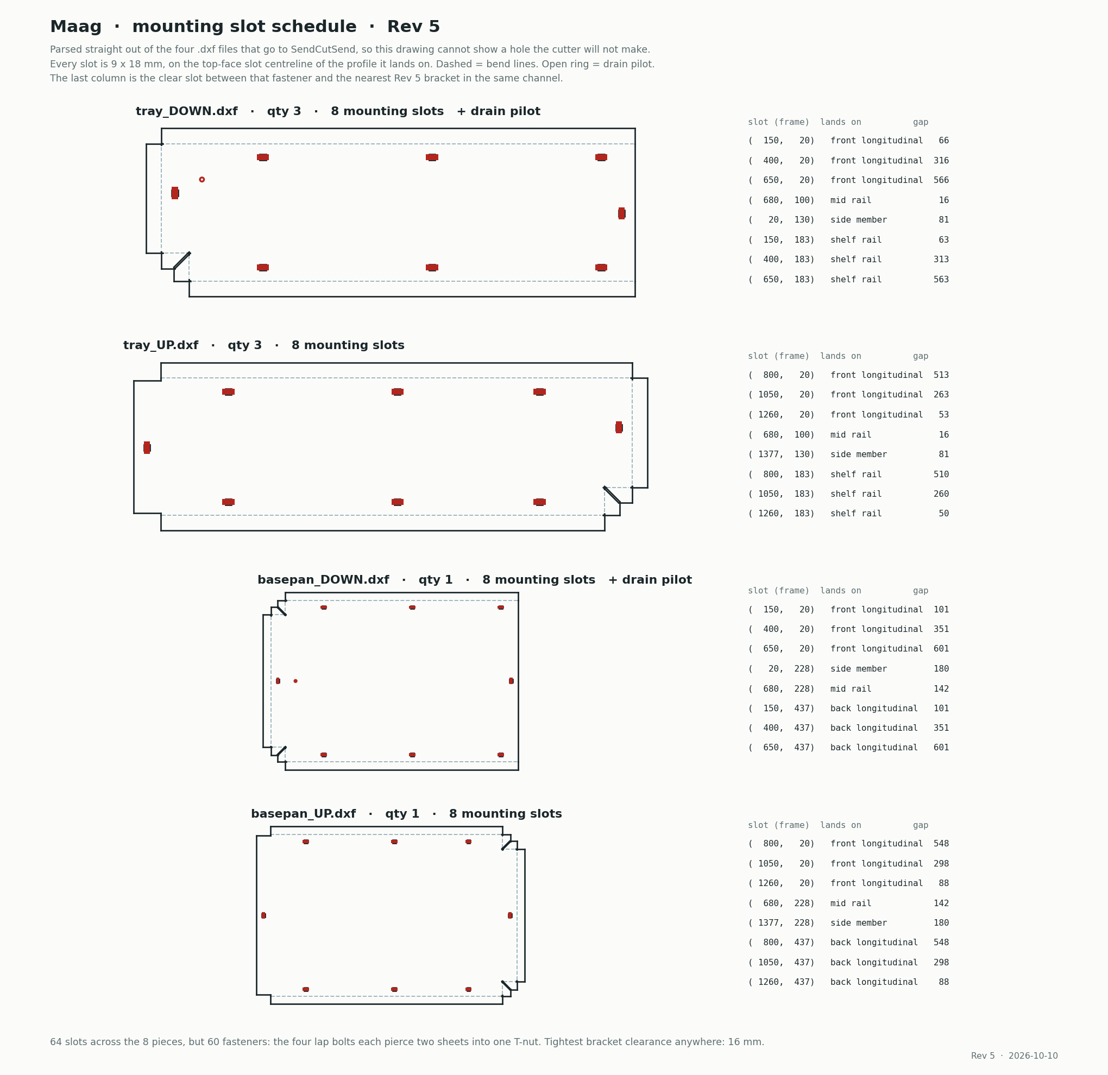
greenhouse/drawings/slot_schedule.png
