v1proxy/RedTower/greenhouse/drawings/tray_axonometric.png

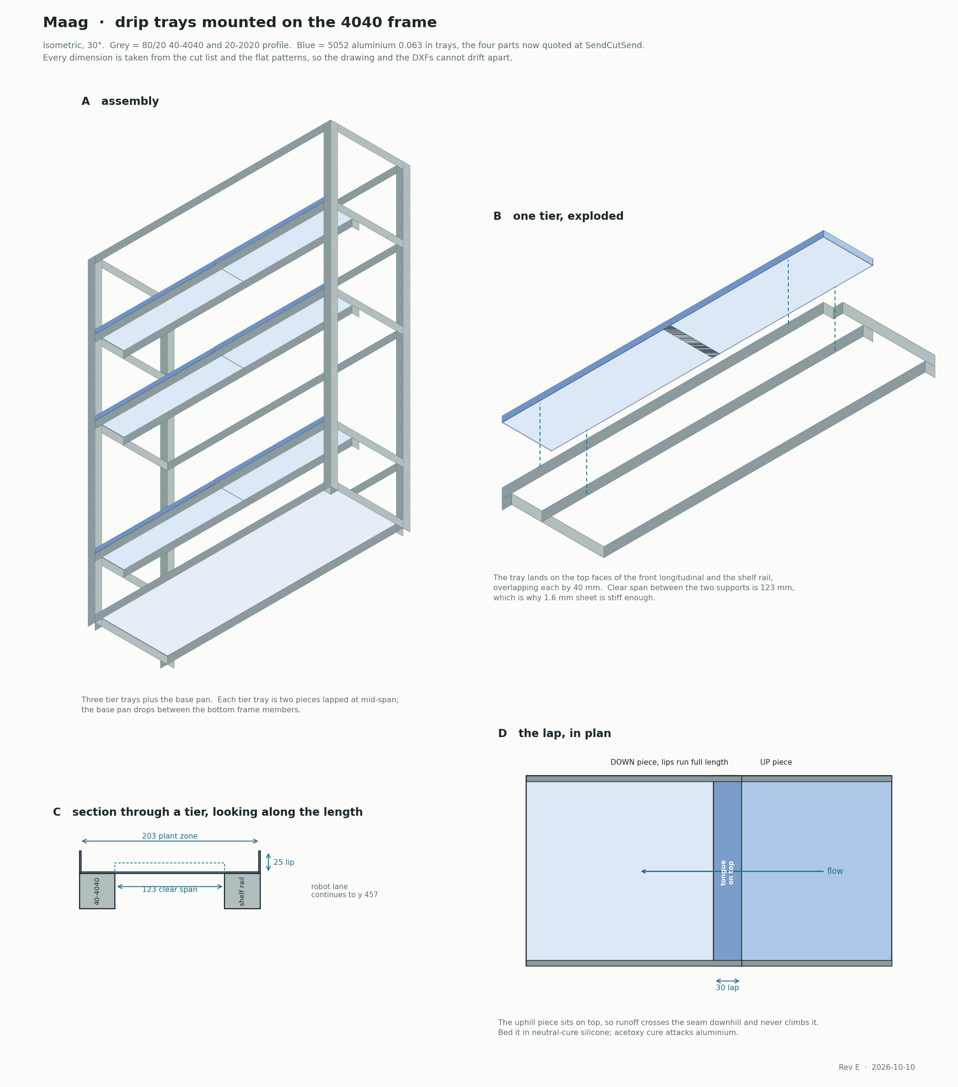
greenhouse/drawings/tray_axonometric.png
