v1proxy/RedTower/greenhouse/drawings/tray_axonometric_rev2.png

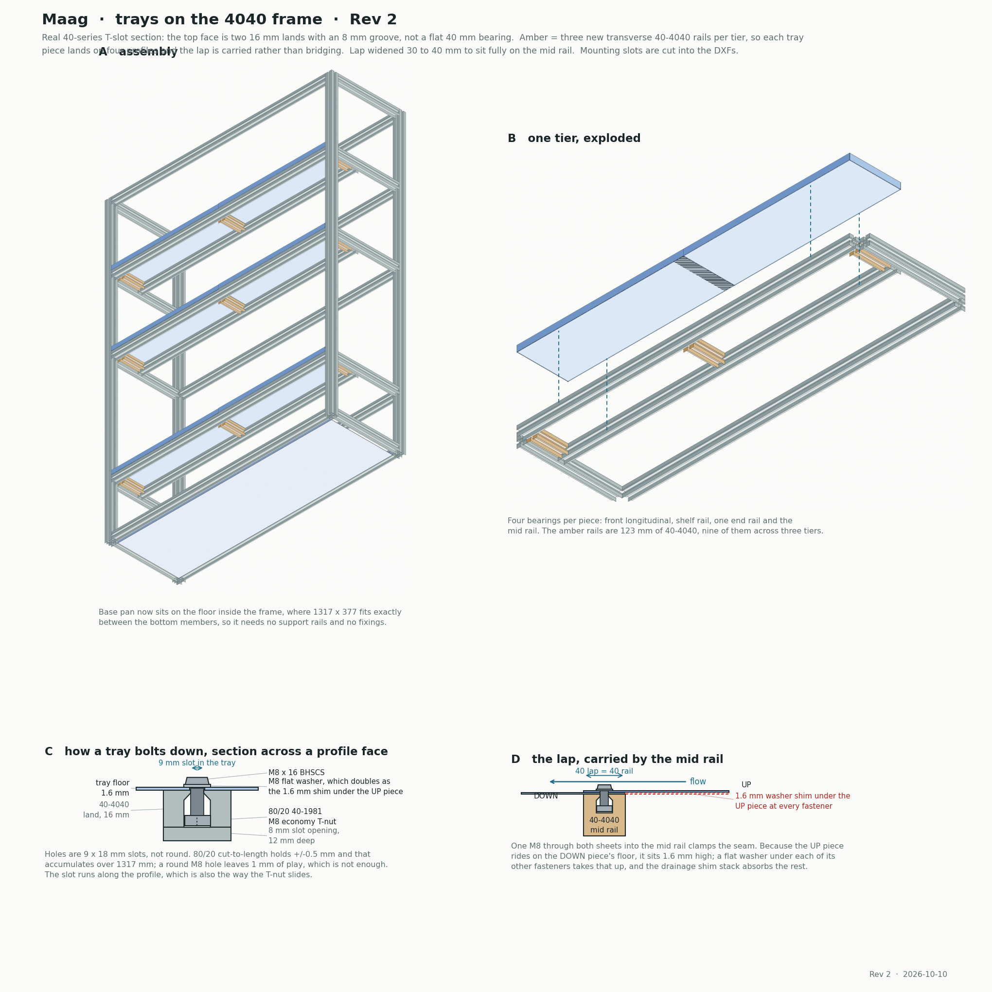
greenhouse/drawings/tray_axonometric_rev2.png
