v1proxy/RedTower/greenhouse/drawings/tray_axonometric_rev3.png

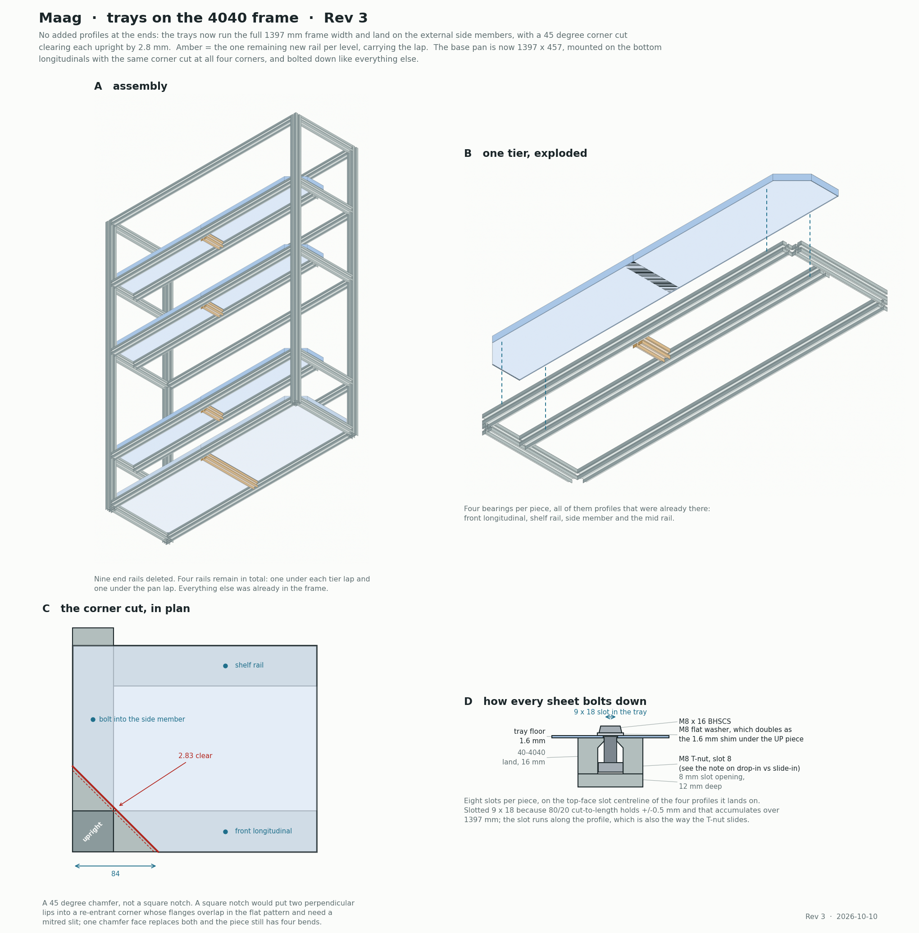
greenhouse/drawings/tray_axonometric_rev3.png
