v1proxy/RedTower/greenhouse/drawings/tray_axonometric_rev5.png

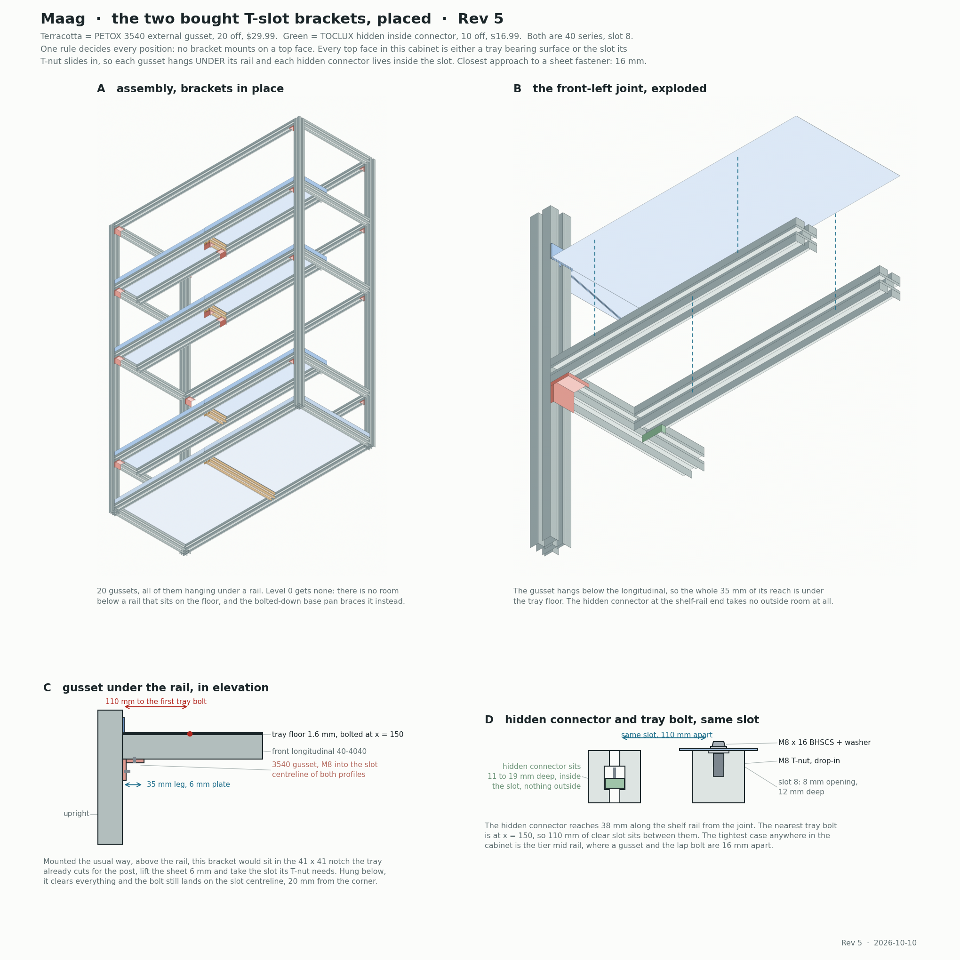
greenhouse/drawings/tray_axonometric_rev5.png
