v1proxy/RedTower/greenhouse/model/tower_views.png

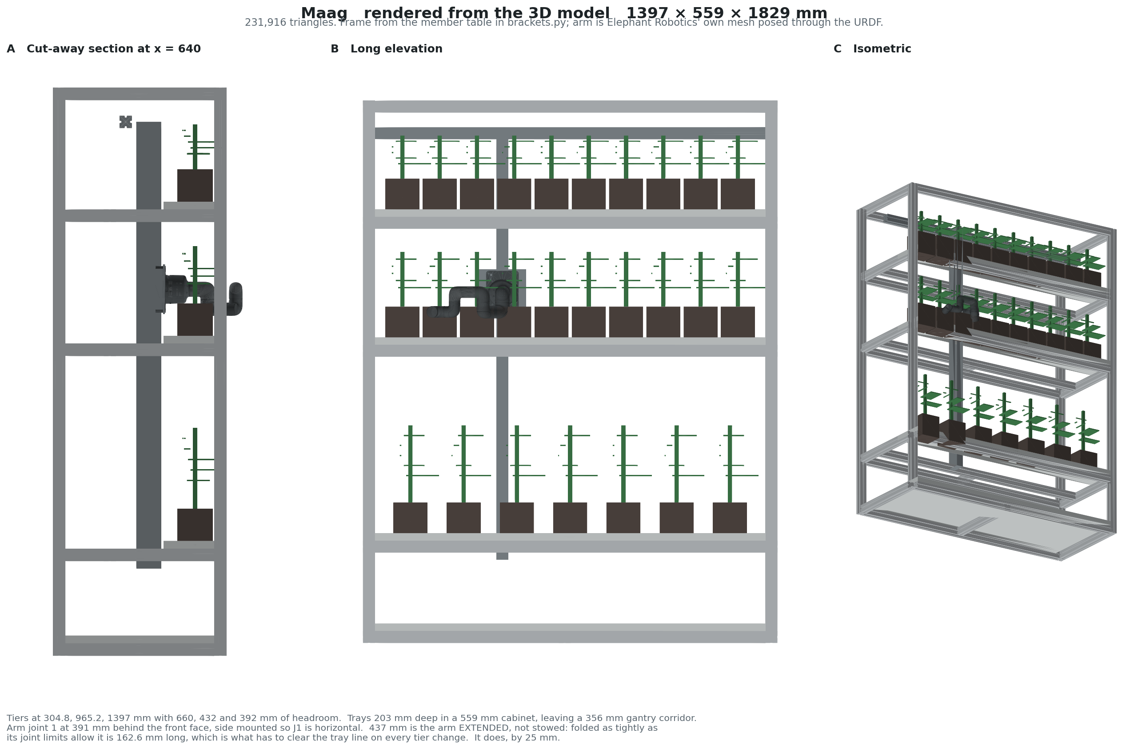
greenhouse/model/tower_views.png
