v1proxy/RedTower/greenhouse/sendcutsend/flat_patterns.png

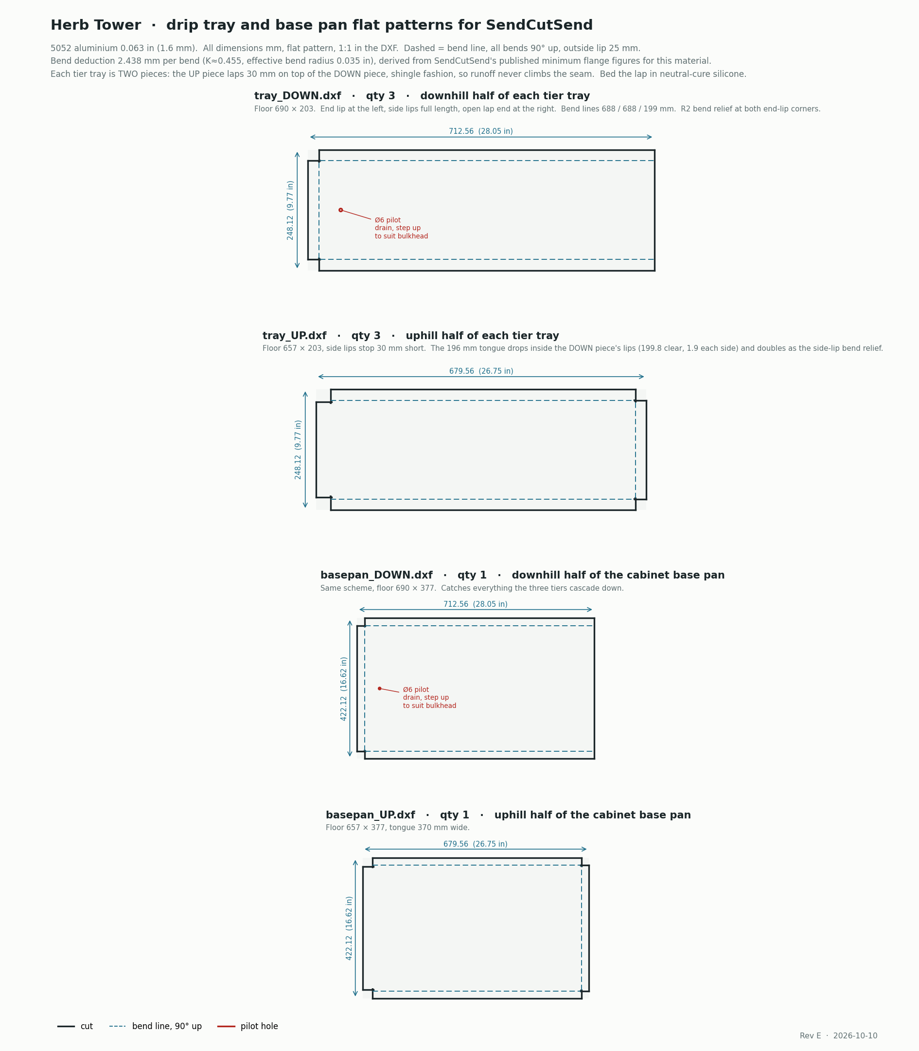
greenhouse/sendcutsend/flat_patterns.png
