v1proxy/RedTower/greenhouse/snip/Maag_Herb_Snip_BOM_RevA.xlsx

Sheet: Herb Snip BOM
MAAG · HERB SNIP BOM · Herb Snip Rev A
Generated 2026-10-21. Scope: the cut-and-hold tool for the myCobot 280, through to commissioning; the dead-leaf tray and the feeder are on the Harvest Rev B buy list. The arm, the D405 and the 12 V rail are in the gantry and greenhouse BOMs.
REPLACES the adaptive gripper (gantry BOM R02, $129.99). Print the crank first and check it against your servo's horn before printing anything else.
Ref | Group | Item | Mfr / Part | Supplier | Link | Qty | Unit | Unit $ | Ext $ | Status | Notes
PRINTED
P01 | Printed | Body | print/snip_body.stl | your printer |  | 1 | pc | $1.08 | $1.08 | Printed | 49.2 g white PETG, like the arm (plus about 10 % for purge and skirt). One housing: the collar above the band, the servo's pocket, the regulator's bay, the fixed jaw. Stands on its flat base: no supports. 4 walls, 25 % gyroid, bridging on for the servo pocket's roof.
P10 | Printed | Camera ring | print/snip_camera_ring.stl | your printer |  | 1 | pc | $0.35 | $0.35 | Printed | 15.7 g white PETG, like the arm (plus about 10 % for purge and skirt). The collar's foot below the band and the D405's chin, one piece, between the flange and the body on the same four LEGO pins. Prints lying on its flat side (the collar's, the chin's and the plate's, one plane): no supports, a 5 mm brim, since it stands 42 tall. 4 walls, 25 % gyroid.
P02 | Printed | Jaw A | print/snip_jaw_A.stl | your printer |  | 1 | pc | $0.04 | $0.04 | Printed | 2.0 g white PETG, like the arm (plus about 10 % for purge and skirt). Camera side half of the moving jaw: the blade's pocket and the clamp screw's countersink. Outer face down.
P03 | Printed | Jaw B | print/snip_jaw_B.stl | your printer |  | 1 | pc | $0.07 | $0.07 | Printed | 3.2 g white PETG, like the arm (plus about 10 % for purge and skirt). Servo side half: the pad rib, the tail lug with the pivot's counterbore, the clamp insert's hole. Jaw face down.
P04 | Printed | Link | print/snip_link.stl | your printer |  | 1 | pc | $0.01 | $0.01 | Printed | 0.4 g white PETG, like the arm (plus about 10 % for purge and skirt). Crank to jaw tail.
P05 | Printed | Crank | print/snip_crank.stl | your printer |  | 1 | pc | $0.01 | $0.01 | Printed | 0.4 g white PETG, like the arm (plus about 10 % for purge and skirt). Fits the servo's single-arm horn: print it FIRST and fit-check it (booklet step 2). TowerPro publishes no drawing of the horn.
P06 | Printed | Anvil | print/snip_anvil.stl | your printer |  | 2 | pc | $0.01 | $0.02 | Printed | 0.3 g white PETG, like the arm (plus about 10 % for purge and skirt). The strip the blade closes on. A wear part: one fitted, one spare.
P09 | Printed | Pad | print/snip_pad_TPU_x2.stl | your printer |  | 4 | pc | $0.03 | $0.12 | Printed | 0.7 g TPU 95A, solid (plus about 10 % for purge and skirt). One on each jaw: a comb of 11 fins on a one-way dovetail, sliding into the rib from the servo side. Print lying on its side, solid, about 20 mm/s. A wear part: two fitted, two spare.
 |  |  |  |  |  |  |  | Printed subtotal | $1.70
MECHANISM
M01 | Mechanism | Micro servo, metal gear, 180 deg | TowerPro MG90S | Waveshare | open (https://www.waveshare.com/MG90S-Servo.htm) | 2 | pc | $2.59 | $5.18 | Verified | ONE IS FITTED, ONE IS THE SPARE: a servo held stalled for long can strip. 2.8 kg cm at 6 V on the listing; the design assumes only 0.15 N m (1.5 kg cm) and still cuts at 34 N. Comes with the single-arm horn the crank fits.
M02 | Mechanism | Snap-off blades, 9 mm, 10 pack | OLFA AB-10B | Toolup | open (https://toolup.com/products/olfa-ab10b-standard-blades-10-pk) | 1 | pack | $4.92 | $4.92 | Verified | One 34 mm piece is the blade (booklet step 3). The pack is years of spares: snap a fresh piece when stems start to crush instead of cut.
M03 | Mechanism | TPU 95A filament, 1.75 mm | any maker | any |  | 0 | spool | $0.00 | $0.00 | To source | For the pads (P09): about 3 g for four. Any 95A TPU; a softer one holds a little less. Priced in P09.
M04 | Mechanism | Dowel pin, 2 x 6, hardened | ISO 8734 | any |  | 1 | pc | $0.50 | $0.50 | To source | Link to jaw B's lug.
M05 | Mechanism | Dowel pin, 2 x 5, hardened | ISO 8734 | any |  | 1 | pc | $0.50 | $0.50 | To source | Crank to link. A small pack of 2 mm pins covers both.
M06 | Mechanism | LEGO Technic pin with friction | LEGO 2780 | BrickOwl or Pick a Brick | open (https://www.brickowl.com/catalog/33899-38) | 4 | pc | $0.10 | $0.40 | To source | How the tool goes on the 280's flange, no screws: the same pins the adaptive gripper used. If you already have the gripper's, use those.
 |  |  |  |  |  |  |  | Mechanism subtotal | $11.50
FASTENERS
F01 | Fasteners | Shoulder screw, 4 mm shoulder x 6, M3, A2 | ISO 7379 pattern; e.g. ELESA+GANTER ISO 7379-4-M3-6-NI | TME, or any | open (https://www.tme.eu/dk/en/katalog/shoulder-screws_113391/params/b532_thread/p1448207_m3/) | 1 | pc | $3.00 | $3.00 | To source | The jaw pivot, from the lug side: head 7 x 3 flush in jaw B's counterbore, 2 mm hex. Tighten fully: the shoulder's end bears on the cheek's insert, so the jaw keeps 0.2 of play. Shoulder 6 exactly; the cheek's blind bore takes a thread up to 7 long.
F02 | Fasteners | Heat-set insert, M3 x 5.7, 4.6 OD | CNC Kitchen M3 Standard (or Ruthex, same size) | 3DJake | open (https://www.3djake.com/cnc-kitchen/threaded-inserts-m3-standard) | 1 | pc | $0.11 | $0.11 | Verified | Into the cheek from the jaw side, flush (booklet step 4). $11.21 per 100 on the listing.
F03 | Fasteners | Heat-set insert, M2 x 3, 3.6 OD | CNC Kitchen M2 Standard | 3DJake | open (https://www.3djake.com/cnc-kitchen/threaded-inserts-m3-standard) | 1 | pc | $0.12 | $0.12 | Estimate | Into jaw B from its outer face, flush, for the blade clamp (booklet step 3). Hole 3.2.
F04 | Fasteners | M2 x 6 countersunk socket, A2 | ISO 10642 | any |  | 2 | pc | $0.20 | $0.40 | To source | ONE is the blade clamp, flush in jaw A, into jaw B's insert. ONE is the crank into the servo's spline: countersunk because the link swings 0.4 mm from the shaft axis. The screw in the servo's bag does NOT fit there. 1.3 mm hex.
F05 | Fasteners | M3 x 5 countersunk socket, A2 | ISO 10642 | any |  | 2 | pc | $0.15 | $0.30 | To source | The D405 onto its bracket, heads flush in the plate, 2 of thread in the camera. Five long, no longer: the camera's threads are shallow. 2 mm hex.
 |  |  |  |  |  |  |  | Fasteners subtotal | $3.93
ELECTRONICS
E01 | Electronics | Step-down regulator, 6 V 1 A | Pololu D24V10F6 (#2832) | Pololu | open (https://www.pololu.com/product/2832) | 1 | pc | $12.95 | $12.95 | Verified | 12 V wrist line in, 6 V to the servo. The arm's own 5 V pin is rated in tens of mA and the servo stalls at 0.7 A, so the servo never runs from the arm.
E02 | Electronics | ALTERNATE: 6-channel USB servo controller | Pololu Micro Maestro (#1350) | Pololu | open (https://www.pololu.com/product/1350) | 0 | pc | $24.95 | $0.00 | Estimate | ONLY IF the end connector's G22 will not give a steady 50 Hz (commissioning, step 12). It drives the same servo lead from a USB port on the Jetson.
 |  |  |  |  |  |  |  | Electronics subtotal | $12.95
WIRING
W01 | Wiring | Servo extension lead, 3-pin, 1 m | JR / Futaba style | any |  | 1 | pc | $3.00 | $3.00 | To source | From the servo along the arm to the end connector: signal to G22, ground to GND. The red wire goes to the regulator, not to the arm.
W02 | Wiring | Silicone wire, 22 AWG, red and black, 2 m each | any | any |  | 1 | set | $6.00 | $6.00 | To source | The 12 V wrist line from the cabinet's 12 V rail (sheet E-01), along the arm with the D405's USB cable.
W03 | Wiring | Heat-shrink, small zip ties, double-sided foam tape | any | any |  | 1 | set | $6.00 | $6.00 | To source | Sleeve the regulator and stick it into its bay with a 12 mm square of the tape; tie the leads under the bar below the bay, and the three cables at each link with one loose loop at the wrist for J6's +/-180 deg.
 |  |  |  |  |  |  |  | Wiring subtotal | $15.00
NOT BOUGHT
X01 | Not bought | Adaptive gripper (gantry BOM R02) | Elephant Robotics |  | open (https://americas.shop.elephantrobotics.com/collections/end-effectors/products/adaptive-gripper) | 0 | pc | $129.99 | $0.00 | Verified | NO LONGER NEEDED. The Herb Snip cuts and holds in one closing, so a second tool and a tool change are not needed. Gantry BOM Rev D carries it at quantity 0.
X02 | Not bought | RealSense D405 | Intel |  |  | 0 | pc | $0.00 | $0.00 | Owned | Already in the greenhouse BOM (G056) and on the bench. It moves onto the Herb Snip's bracket.
 |  |  |  |  |  |  |  | Not bought subtotal | $0.00
 |  |  |  |  |  |  |  | HERB SNIP TOTAL | $45.08
WHAT IT CAN DO
Cut a stem up to a chili's and hold the cut piece: the pads close a moment before the blade, so a leaf or a tip rides in the closed jaws to the feeder, a dead leaf to the dead-leaf tray. 34 N at the cut point with the servo derated to 0.15 N m.
Pick a pepper by cutting its stem. It does not grip a loose object presented side-on: the pads are on one side of the blade only.
On the flange: 95.9 g of tool and 58 g of D405, 153.9 g of the 280's 250 g payload, 96 g left for what it carries.
Every printed part lies on a flat face: no supports. The camera ring wants a 5 mm brim (it stands 42 tall).
THINGS THAT WILL BITE
The crank must fit the horn in YOUR servo's bag. Print it first (step 2); if it rocks, change HORN in snip_cad.py and reprint the crank, a few minutes.
Fit the crank with the servo at its closed end (step 6), or the jaw closes in mid-air and the servo pushes against nothing at the far end of its travel.
The end connector's PWM has 256 steps in 20 ms: 78 us, about 7 degrees of servo a step. Open and closed are all it needs; tools_snip_check.py finds the two pulses.
The servo runs from its own 6 V regulator on the 12 V wrist line, never from the arm: the arm's pins are rated in tens of mA.
Doors, the feeder's lid and the E-stop cut the arm's power: no pulses, the servo goes limp, the jaw can be pushed open by hand.
Setting the pivot insert: the deck is 4 under its axis, so the iron must be under 8 thick for its first 50. The servo's tab screws want a driver under 5 thick.

Sheet: Summary
HERB SNIP BOM SUMMARY
Group | Subtotal
Printed | $1.70
Mechanism | $11.50
Fasteners | $3.93
Electronics | $12.95
Wiring | $15.00
Not bought | $0.00
TOTAL | $45.08
Against the adaptive gripper it replaces ($129.99), the Herb Snip saves $84.91 and adds a cutter.
