v1proxy/RedTower/greenhouse/enclosure/acplastics/panel_right.dxf

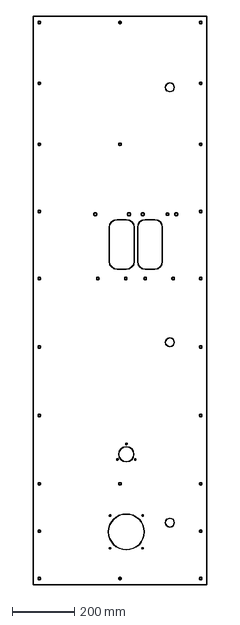
[picture p269: CAD file, 2026-10-21]
greenhouse/enclosure/acplastics/panel_right.dxf
559.0 x 1829.0 mm
