v1proxy/RedTower/greenhouse/enclosure/print/duct_collar.stl

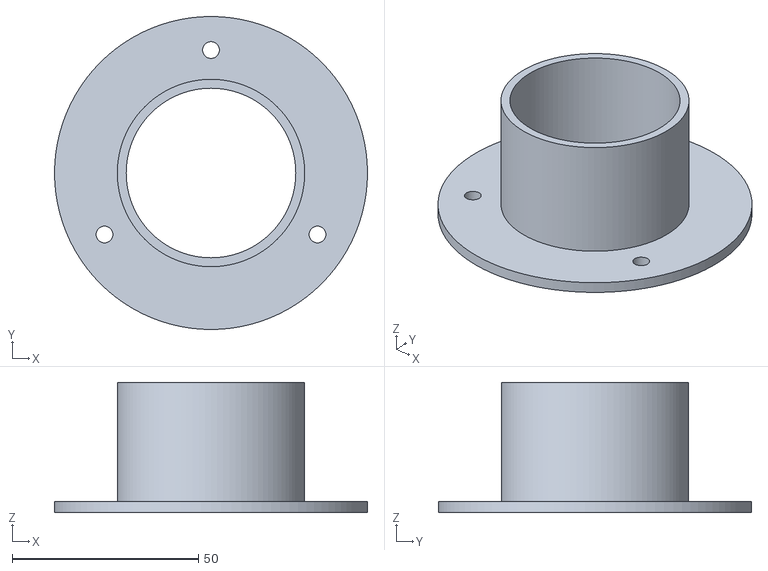
[picture p270: CAD file, 2026-10-21]
greenhouse/enclosure/print/duct_collar.stl
84.0 x 84.0 x 35.0
