v1proxy/RedTower/greenhouse/enclosure/sendcutsend/hinge_spacer.dxf

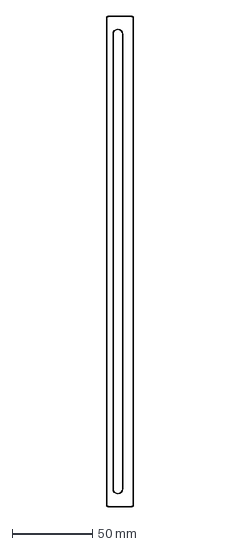
[picture p271: CAD file, 2026-10-21]
greenhouse/enclosure/sendcutsend/hinge_spacer.dxf
16.5 x 304.8 mm
