v1proxy/RedTower/greenhouse/harvest/print/feeder_hood_leaves.stl

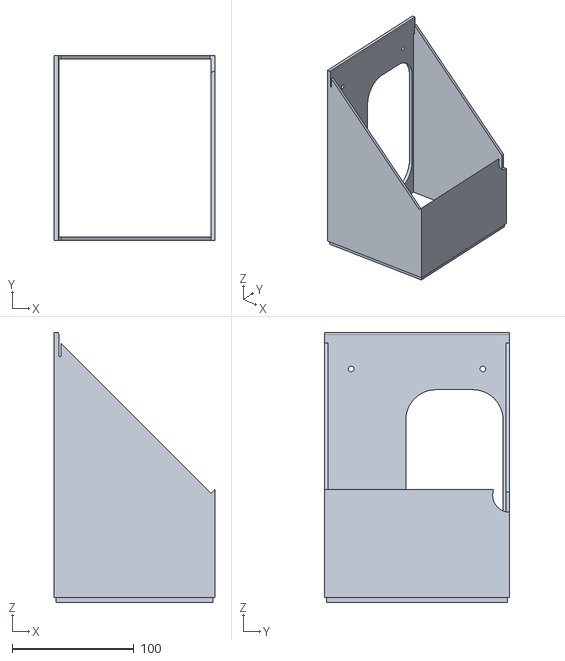
[picture p272: CAD file, 2026-10-21]
greenhouse/harvest/print/feeder_hood_leaves.stl
132.0 x 152.4 x 222.0
