v1proxy/RedTower/greenhouse/harvest/sendcutsend/feeder_lid.dxf

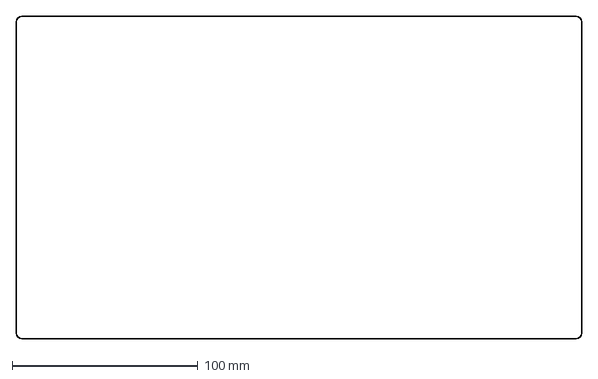
[picture p273: CAD file, 2026-10-21]
greenhouse/harvest/sendcutsend/feeder_lid.dxf
304.8 x 173.6 mm
