v1proxy/RedTower/greenhouse/sendcutsend/basepan_UP.dxf

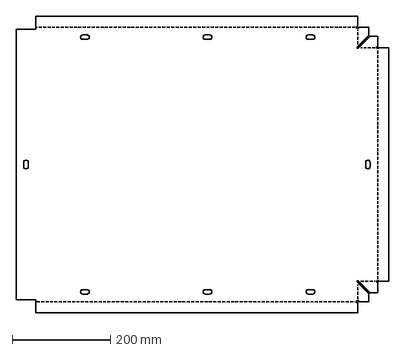
[picture p274: CAD file, 2026-10-21]
greenhouse/sendcutsend/basepan_UP.dxf
759.6 x 604.1 mm
