v1proxy/RedTower/greenhouse/snip/print/snip_body.stl

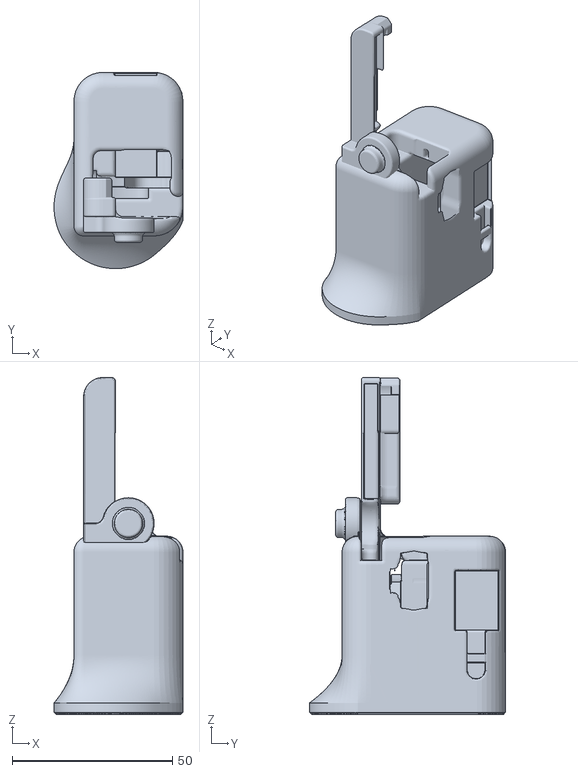
[picture p275: CAD file, 2026-10-21]
greenhouse/snip/print/snip_body.stl
40.2 x 61.2 x 105.1
