v1proxy/RedTower/greenhouse/enclosure/acplastics/panel_top.dxf

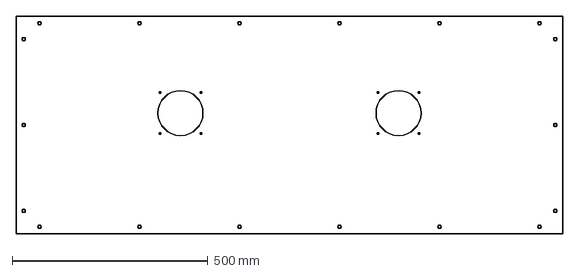
[picture p276: CAD file, 2026-10-21]
greenhouse/enclosure/acplastics/panel_top.dxf
1397.0 x 555.0 mm
