v1proxy/RedTower/greenhouse/enclosure/sendcutsend/astragal_bottom.dxf

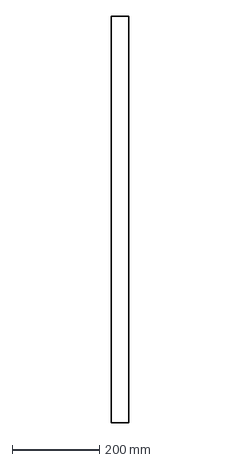
[picture p277: CAD file, 2026-10-21]
greenhouse/enclosure/sendcutsend/astragal_bottom.dxf
40.0 x 933.4 mm
