v1proxy/RedTower/greenhouse/harvest/print/feeder_tray.stl

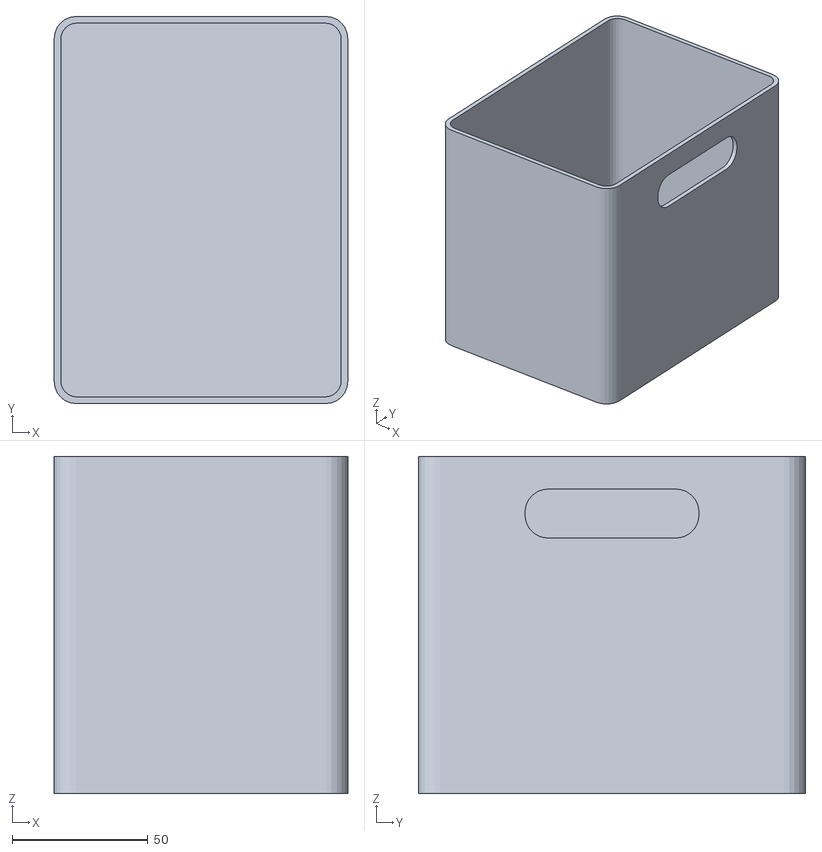
[picture p278: CAD file, 2026-10-21]
greenhouse/harvest/print/feeder_tray.stl
108.0 x 142.4 x 124.0
