v1proxy/RedTower/greenhouse/harvest/sendcutsend/guide_rail_R.dxf

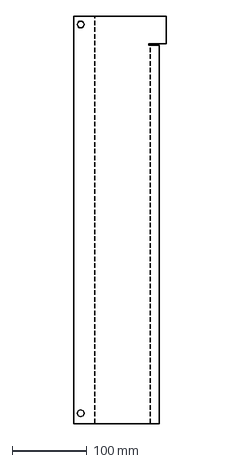
[picture p279: CAD file, 2026-10-21]
greenhouse/harvest/sendcutsend/guide_rail_R.dxf
123.0 x 544.0 mm
