v1proxy/RedTower/greenhouse/sendcutsend/tray_DOWN.dxf

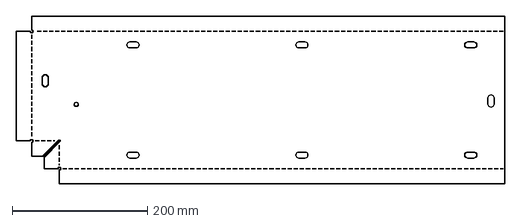
[picture p280: CAD file, 2026-10-21]
greenhouse/sendcutsend/tray_DOWN.dxf
722.6 x 248.1 mm
