v1proxy/RedTower/greenhouse/snip/print/snip_pad_TPU_x2.stl

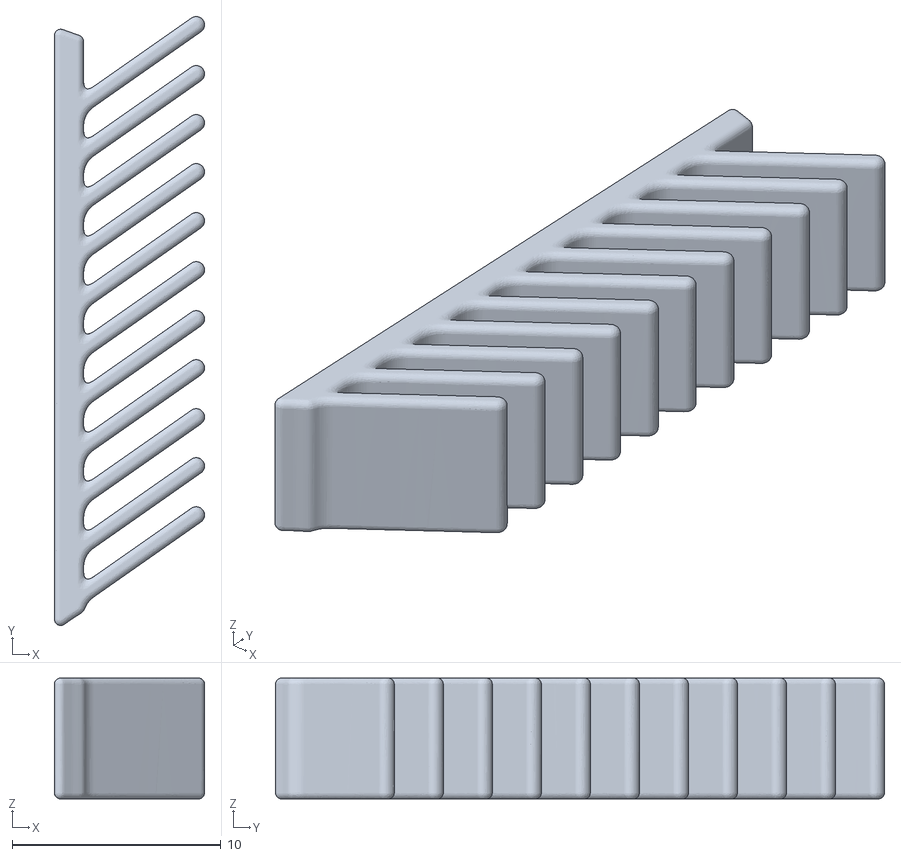
[picture p281: CAD file, 2026-10-21]
greenhouse/snip/print/snip_pad_TPU_x2.stl
7.20 x 29.2 x 5.80
