v1proxy/RedTower/greenhouse/enclosure/acplastics/panel_back_upper.dxf

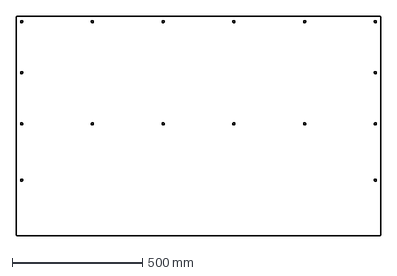
[picture p282: CAD file, 2026-10-21]
greenhouse/enclosure/acplastics/panel_back_upper.dxf
1397.0 x 840.8 mm
