v1proxy/RedTower/greenhouse/enclosure/sendcutsend/door_bottom_L.dxf

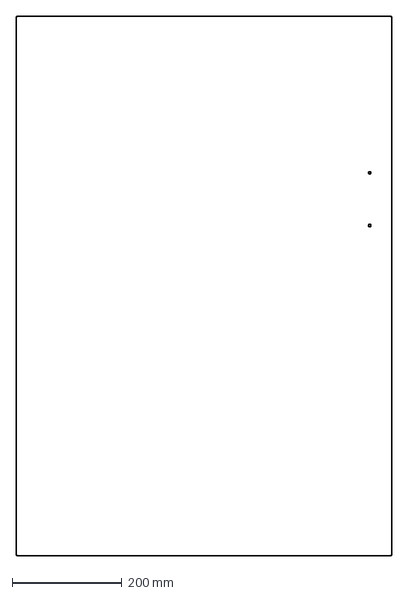
[picture p283: CAD file, 2026-10-21]
greenhouse/enclosure/sendcutsend/door_bottom_L.dxf
683.7 x 983.7 mm
