v1proxy/RedTower/greenhouse/harvest/sendcutsend/guide_rail_L.dxf

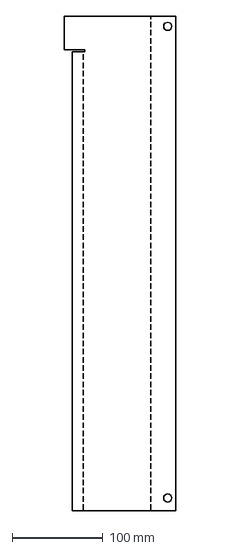
[picture p284: CAD file, 2026-10-21]
greenhouse/harvest/sendcutsend/guide_rail_L.dxf
123.0 x 544.0 mm
