v1proxy/RedTower/greenhouse/sendcutsend/tray_UP.dxf

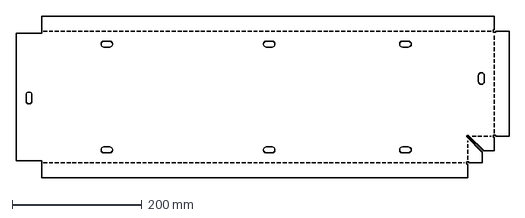
[picture p285: CAD file, 2026-10-21]
greenhouse/sendcutsend/tray_UP.dxf
759.6 x 248.1 mm
