v1proxy/RedTower/greenhouse/snip/print/snip_camera_ring.stl

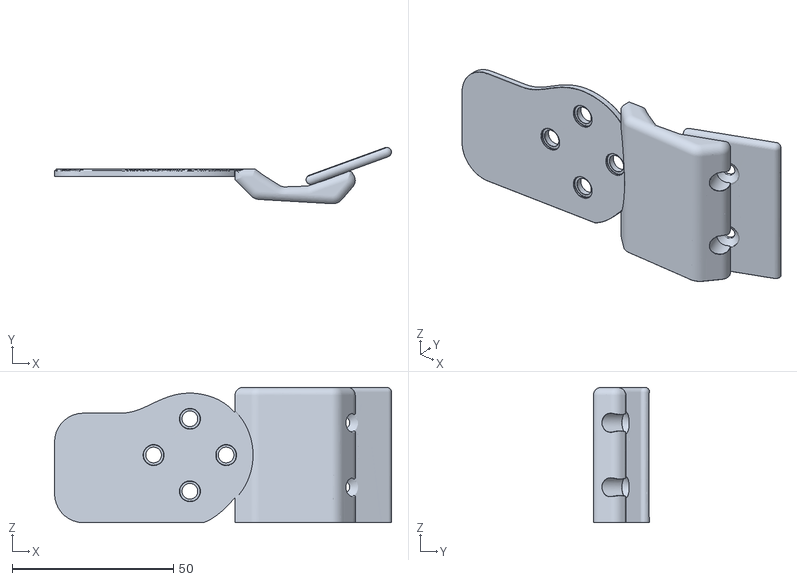
[picture p286: CAD file, 2026-10-21]
greenhouse/snip/print/snip_camera_ring.stl
104.6 x 17.5 x 42.0
