v1proxy/RedTower/greenhouse/enclosure/acplastics/panel_back_bottom.dxf

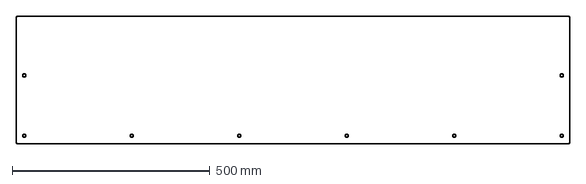
[picture p287: CAD file, 2026-10-21]
greenhouse/enclosure/acplastics/panel_back_bottom.dxf
1397.0 x 321.8 mm
