v1proxy/RedTower/greenhouse/enclosure/sendcutsend/astragal_top.dxf

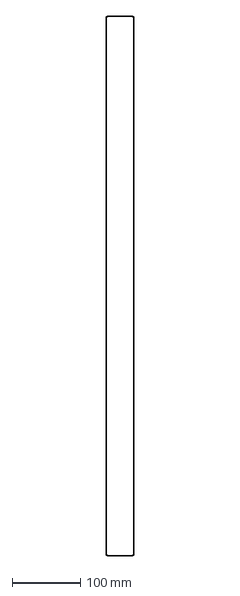
[picture p288: CAD file, 2026-10-21]
greenhouse/enclosure/sendcutsend/astragal_top.dxf
40.0 x 789.6 mm
