v1proxy/RedTower/greenhouse/harvest/print/feeder_basin.stl

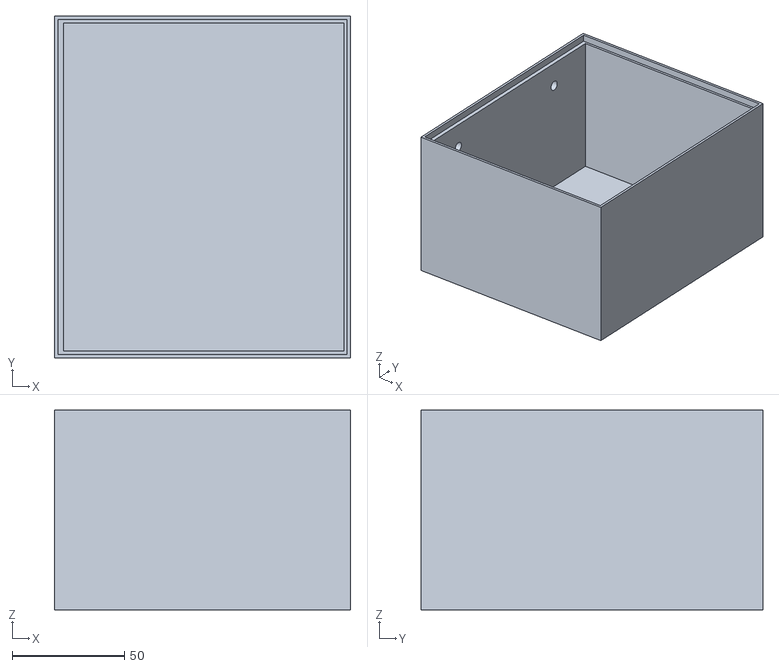
[picture p289: CAD file, 2026-10-21]
greenhouse/harvest/print/feeder_basin.stl
132.0 x 152.4 x 89.0
