v1proxy/RedTower/greenhouse/harvest/sendcutsend/deadleaf_tray.dxf

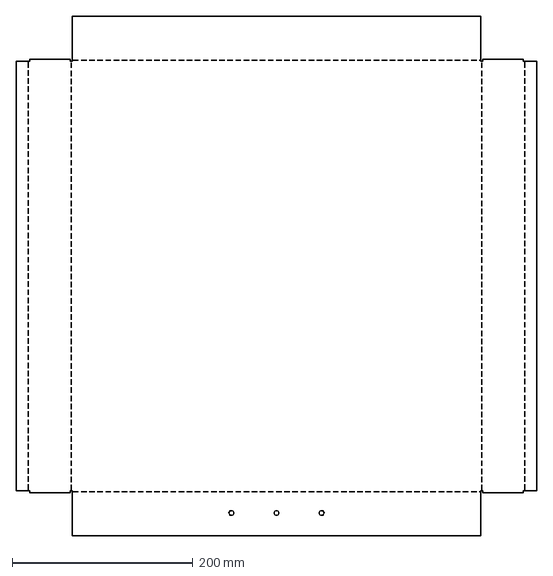
[picture p290: CAD file, 2026-10-21]
greenhouse/harvest/sendcutsend/deadleaf_tray.dxf
576.4 x 575.1 mm
