v1proxy/RedTower/greenhouse/sendcutsend/basepan_DOWN.dxf

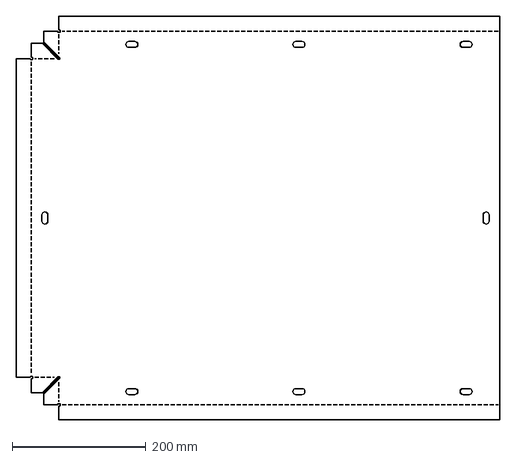
[picture p291: CAD file, 2026-10-21]
greenhouse/sendcutsend/basepan_DOWN.dxf
722.6 x 604.1 mm
