v1proxy/RedTower/greenhouse/snip/print/snip_jaw_A.stl

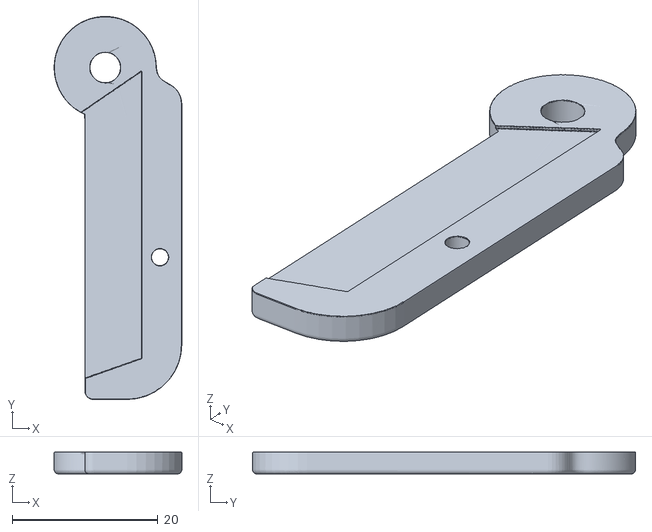
[picture p292: CAD file, 2026-10-21]
greenhouse/snip/print/snip_jaw_A.stl
17.5 x 52.5 x 3.00
