v1proxy/RedTower/greenhouse/enclosure/acplastics/panel_left.dxf

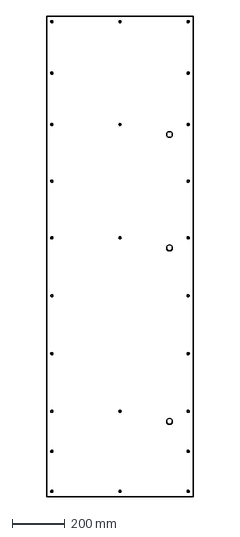
[picture p293: CAD file, 2026-10-21]
greenhouse/enclosure/acplastics/panel_left.dxf
559.0 x 1829.0 mm
