v1proxy/RedTower/greenhouse/enclosure/sendcutsend/door_top_L.dxf

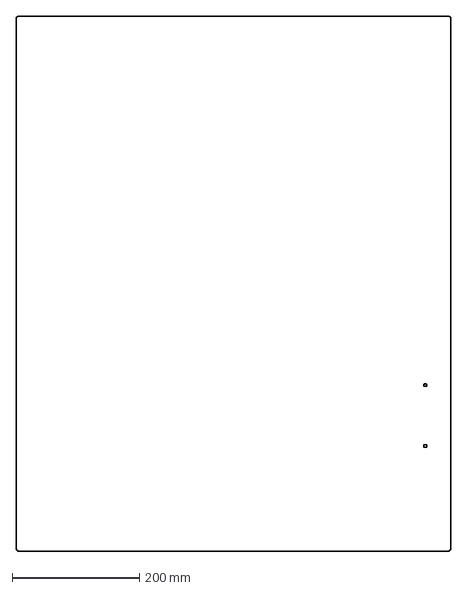
[picture p294: CAD file, 2026-10-21]
greenhouse/enclosure/sendcutsend/door_top_L.dxf
683.7 x 842.3 mm
