v1proxy/RedTower/greenhouse/harvest/print/deadleaf_handle.stl

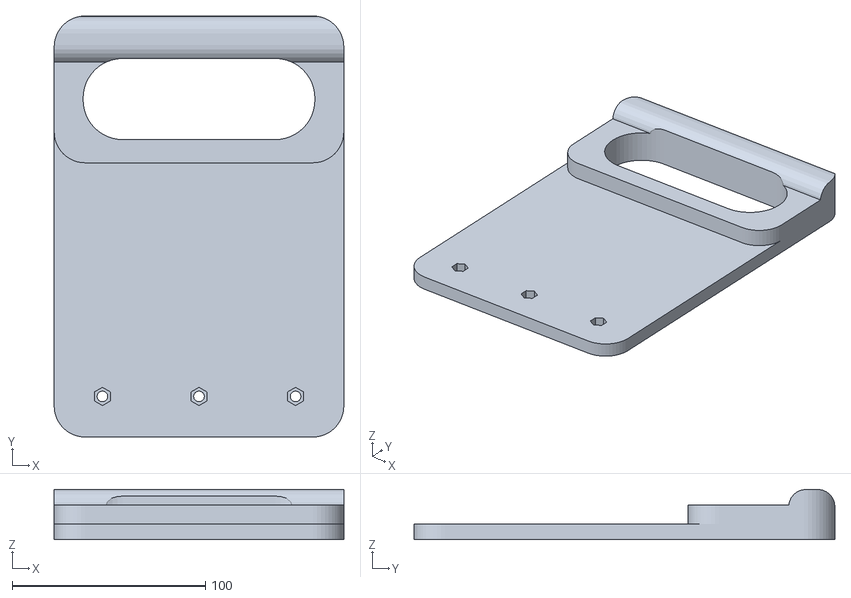
[picture p295: CAD file, 2026-10-21]
greenhouse/harvest/print/deadleaf_handle.stl
150.0 x 218.0 x 26.0
