v1proxy/RedTower/greenhouse/snip/print/snip_jaw_B.stl

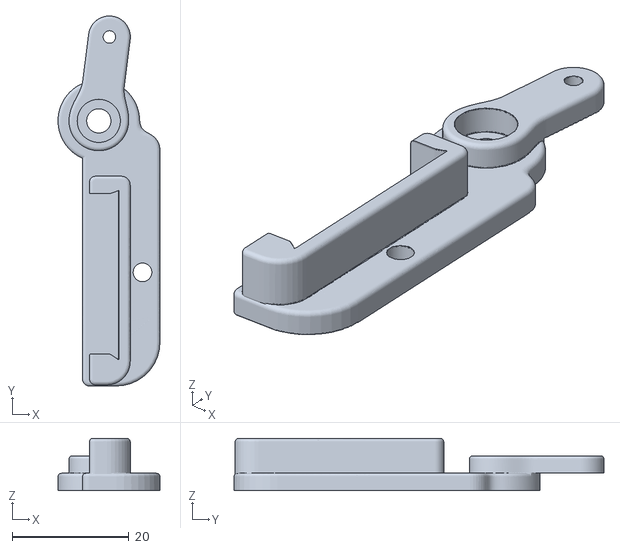
[picture p297: CAD file, 2026-10-21]
greenhouse/snip/print/snip_jaw_B.stl
17.5 x 63.5 x 9.00
