v1proxy/RedTower/greenhouse/enclosure/acplastics/panel_back_middle.dxf

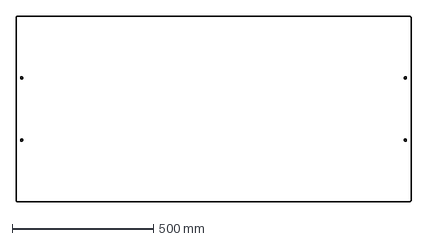
[picture p298: CAD file, 2026-10-21]
greenhouse/enclosure/acplastics/panel_back_middle.dxf
1397.0 x 654.4 mm
