v1proxy/RedTower/greenhouse/sendcutsend/rail_bracket_bottom_bends.dxf

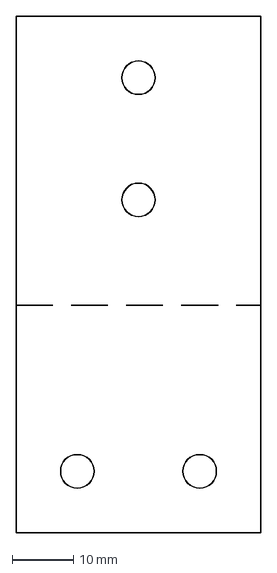
[picture p300: CAD file, 2026-10-21]
greenhouse/sendcutsend/rail_bracket_bottom_bends.dxf
40.0 x 84.4 mm
