v1proxy/RedTower/greenhouse/snip/print/snip_link.stl

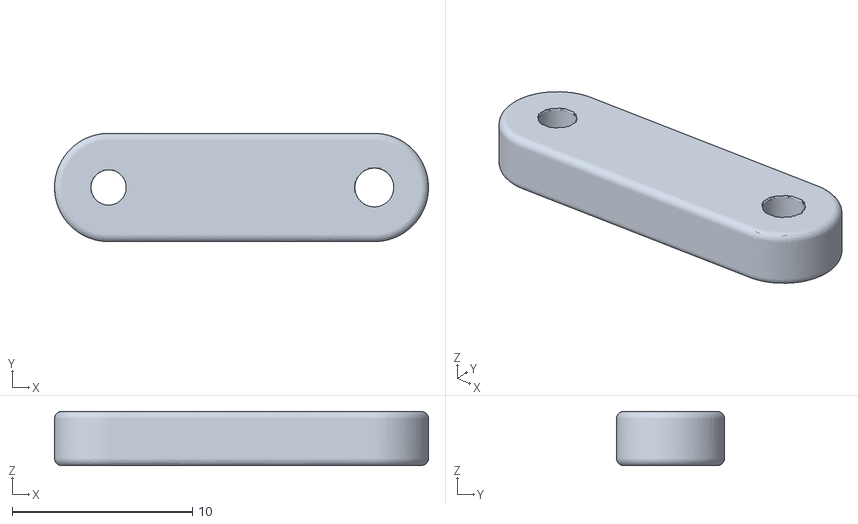
[picture p301: CAD file, 2026-10-21]
greenhouse/snip/print/snip_link.stl
20.7 x 6.00 x 3.00
