v1proxy/RedTower/greenhouse/enclosure/sendcutsend/seam_batten.dxf

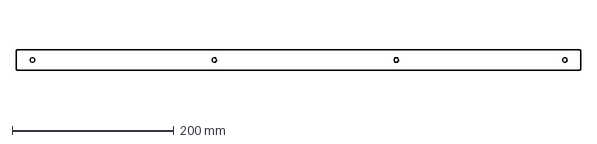
[picture p302: CAD file, 2026-10-21]
greenhouse/enclosure/sendcutsend/seam_batten.dxf
698.0 x 25.4 mm
