v1proxy/RedTower/greenhouse/snip/print/snip_crank.stl

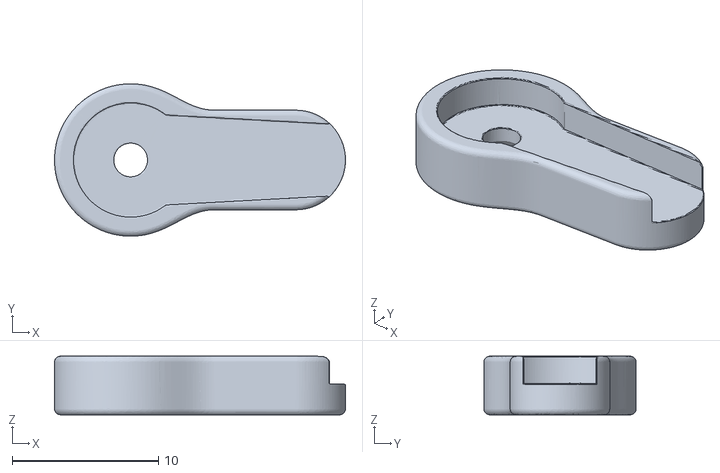
[picture p304: CAD file, 2026-10-21]
greenhouse/snip/print/snip_crank.stl
19.9 x 10.4 x 4.00
