v1proxy/RedTower/greenhouse/enclosure/sendcutsend/door_top_R.dxf

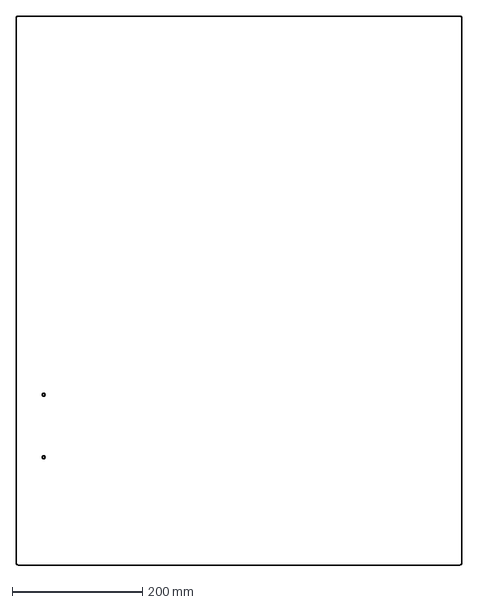
[picture p305: CAD file, 2026-10-21]
greenhouse/enclosure/sendcutsend/door_top_R.dxf
683.7 x 842.3 mm
