v1proxy/RedTower/greenhouse/sendcutsend/arm_plate_revB.dxf

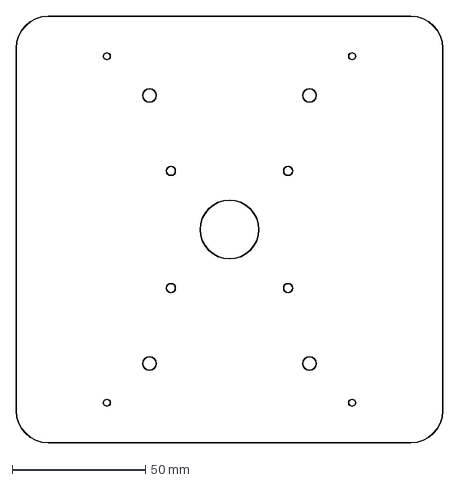
[picture p306: CAD file, 2026-10-21]
greenhouse/sendcutsend/arm_plate_revB.dxf
160.0 x 160.0 mm
