v1proxy/RedTower/greenhouse/snip/print/snip_anvil.stl

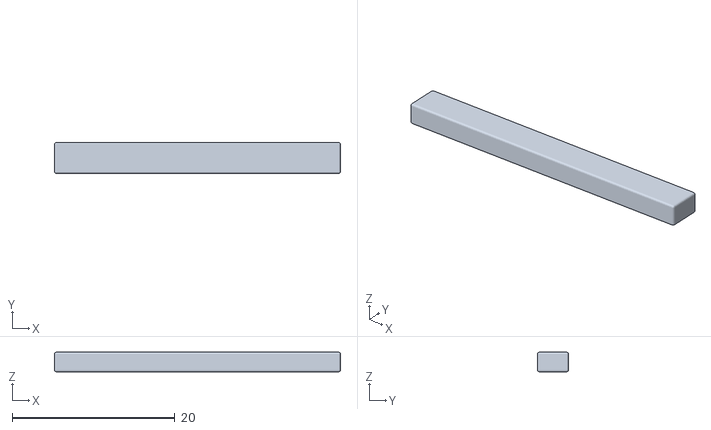
[picture p307: CAD file, 2026-10-21]
greenhouse/snip/print/snip_anvil.stl
35.2 x 3.80 x 2.40
