v1proxy/RedTower/greenhouse/sendcutsend/rail_bracket_top_bends.dxf

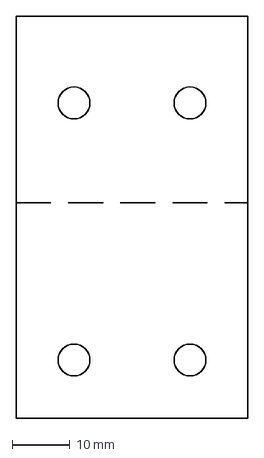
[picture p308: CAD file, 2026-10-21]
greenhouse/sendcutsend/rail_bracket_top_bends.dxf
40.0 x 69.4 mm
