v1proxy/RedTower/(list of files, cad)

Other CAD files:
greenhouse/harvest/print/feeder_hood_veggies.stl
