v1proxy/RedTower/greenhouse/harvest/Maag_Harvest_Assembly_Instructions_RevB.pdf

### Maag Modular Agentic Autonomous Greenhouse

Harvest assembly instructions, Harvest Rev B. The dead-leaf tray in the base, the side feeder on the right.

11 steps · tools · where every cut goes

Design 0.6.3. The Maag cover render, the same on every booklet. Every drawing inside comes from harvest.py, enclosure.py and cabinet.py; the cut files come from the same model.

## What goes where

Leaves

Herb leaves to eat: out through the

right panel, the front compartment.

Veggies

Fruit and pods: the back compartment.

Each has its own lift-out tray.

Dead leaves

Down, into the 10 L tray in the base.

Five drop points spread them along it.

Collect

Lift the lid by the scoop, lift a tray

up and out. The arm has no power

while the lid is open.

# Harvest · where every cut goes

Dead leaves down into a tray in the base. Leaves and veggies out, into a feeder on the right.

Maag · Harvest Rev B

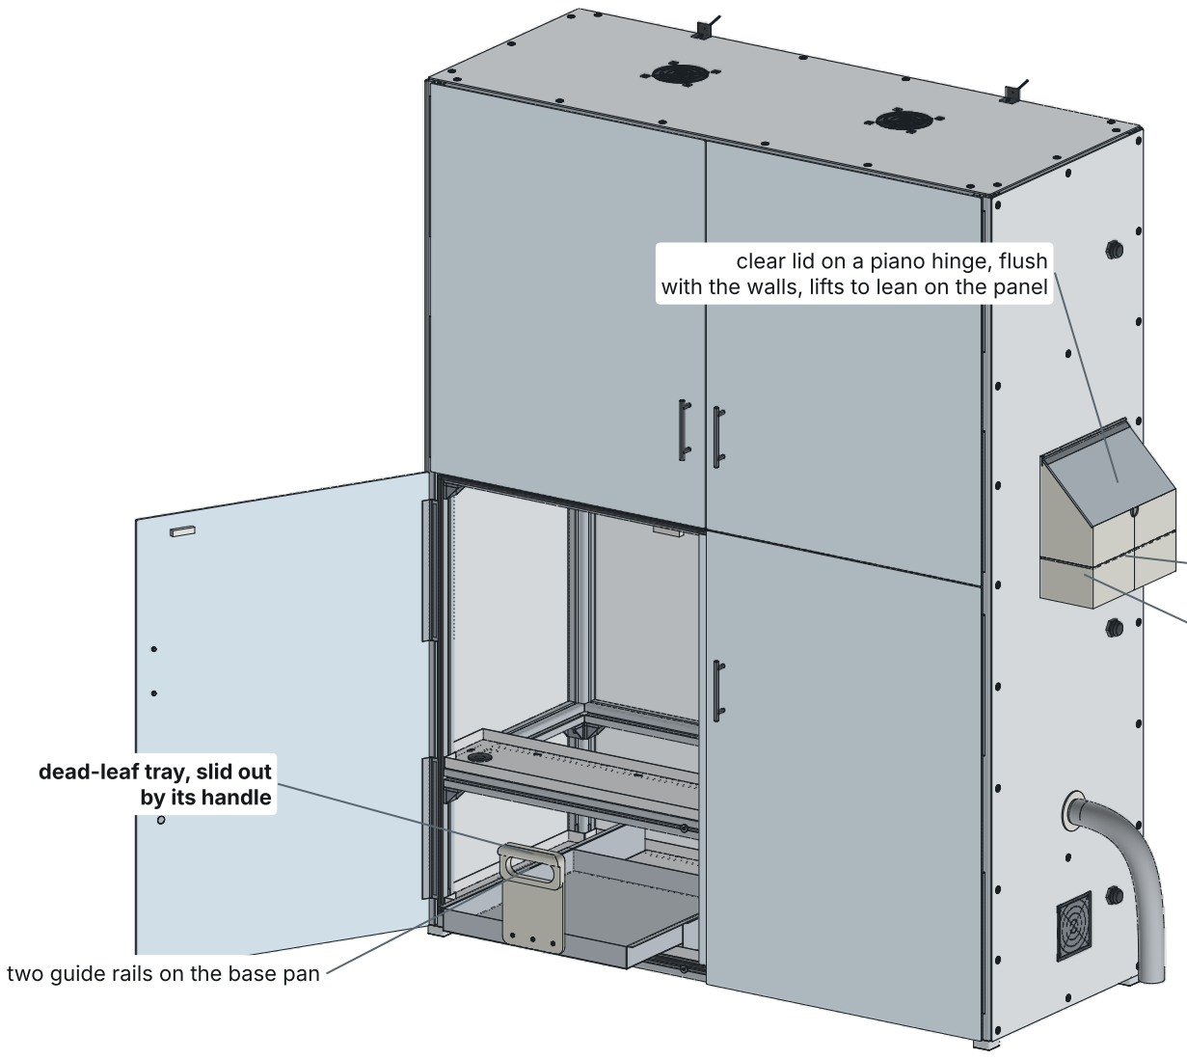
[picture p353: figure]
clear lid on a piano hinge, flush; dead-leaf tray, slid out by its handle; two guide rails on the base pan

The feeder is two printed compartments side by side on the outside of the right panel at tier B, the third shelf up from the floor, under one clear lid that sits

flush with their walls, like the side feeders on a bird cage: the arm puts the harvest in from the inside, you take it out from the outside, and the doors stay

shut. A finger scoop under the lid's edge lifts it. The tray in the base slides out of the bottom-left door alone. The modular cabinet can put the feeder on the

left: it is the same parts, mirrored.

leaves

veggies

with the walls, lifts to lean on the panel

Tightest gaps, mm (reach.py, the snip's printed body and the arm's own meshes)

leaves | inside | plants | below (y < 210) | 13 | plants (y < 210) 19
leaves | through | plants | (y < 210) 9 | plants below (y < 210) 13
leaves | release | plants | (y < 210) 8 | plants below (y < 210) 13
veggies | inside | plants | (y < 210) 13 | gantry 16
veggies | through | plants | (y < 210) 13 | servo inside 17
veggies | release | plants | (y < 210) 13 | servo inside 17
tray drop1 | x | 232 | gantry 11 | plants A (y < 210) 13
tray drop2 | x | 316 | gantry 11 | plants A (y < 210) 13
tray drop3 | x | 400 | gantry 11 | plants A (y < 210) 13
tray drop4 | x | 484 | gantry 11 | plants A (y < 210) 13
tray drop5 | x | 568 | gantry 11 | plants A (y < 210) 13

# How the arm drops

The arm, the snip and every margin from reach.py: posed, then checked against the model.

Each drop is three moves at the feeder: the snip level inside the cabinet, out through its compartment's opening above the tray, then down to 28 over the tray's rim and

open. The snip's wide servo end never leaves the cabinet. Dead leaves go at the arm's lowest, jaws down, 55 over the rim. The poses are in drops.yaml for the Herb Snip's

software; commissioning jogs to each before the first harvest.

through the opening
in the right panel

the leaves tray, cut away

the feeder from the front, the arm at the leaves drop | the base bay, the arm at its lowest, over the tray

Provisional: the Herb Snip's first printed body. The final poses come from its housing version, with the D405.

Guide rail L, 5052
1×

Guide rail R, 5052
1×

Dead-leaf tray, 5052
1×

Handle, printed
1×

Hood, leaves
1×

Hood, veggies
1×

Basin, printed
2×

Feeder tray, printed
2×

Lid, clear 4.5
1×

Piano hinge, 1 ft
1×

Reed switch 7939WG
1×

Rubber well nut M4
4×

Also, no picture needed:

VHB 4905, 1/2 in: both hinge leaves (from the enclosure's roll)
Two lever connectors (Wago 221-412) and 3 m of 2-core alarm cable for the switch

Six small adhesive cable clips for the switch's wire inside the cabinet
Print settings: PETG or PLA, 0.2 layers, 4 walls, 20 % gyroid, no supports: hoods standing on their joint face, basins and trays on their floors, the handle flat

# Harvest · parts

Count everything first. SendCutSend cuts and bends the metal and the lid; you print the rest.

M8 × 16 button head · rails, the pan's own washers
4×

M5 × 10 button head · handle

3×

M5 nyloc · handle, in its pockets

3×

M5 × 20 button head · feeder, rail

4×

DIN 9021 washer M5 · the panel's

4×

M4 × 20 button head · feeder, top

4×

M4 rubber well nut, 10 hole

4×

# Harvest · fasteners

Every screw in the build. Lay them out in labelled pots first.

Rails: the pan's bolts at x 150 and 650, front and back, go from M8 × 12 to M8 × 16: the rail's flange adds 1.6. Stack 4.8, reach 11.2,

1.05 short of the slot floor, as on the pan's UP piece. Feeder: M5 × 20 through the back plate, the panel and the tape: stack 11.875, 3.83 past the

lips, 4.12 short of the floor, the same as every panel screw. The four M5 × 16 the panel wore there until now go back in the spares pot.

Well nuts are rubber sleeves with a brass nut moulded in the far end: push one into a 10 mm hole, turn the screw, and the sleeve folds up behind the panel and grips

it. Nothing to hold on the inside, which is why the feeder's top screws use them: there is no frame behind the panel there.

# Tools

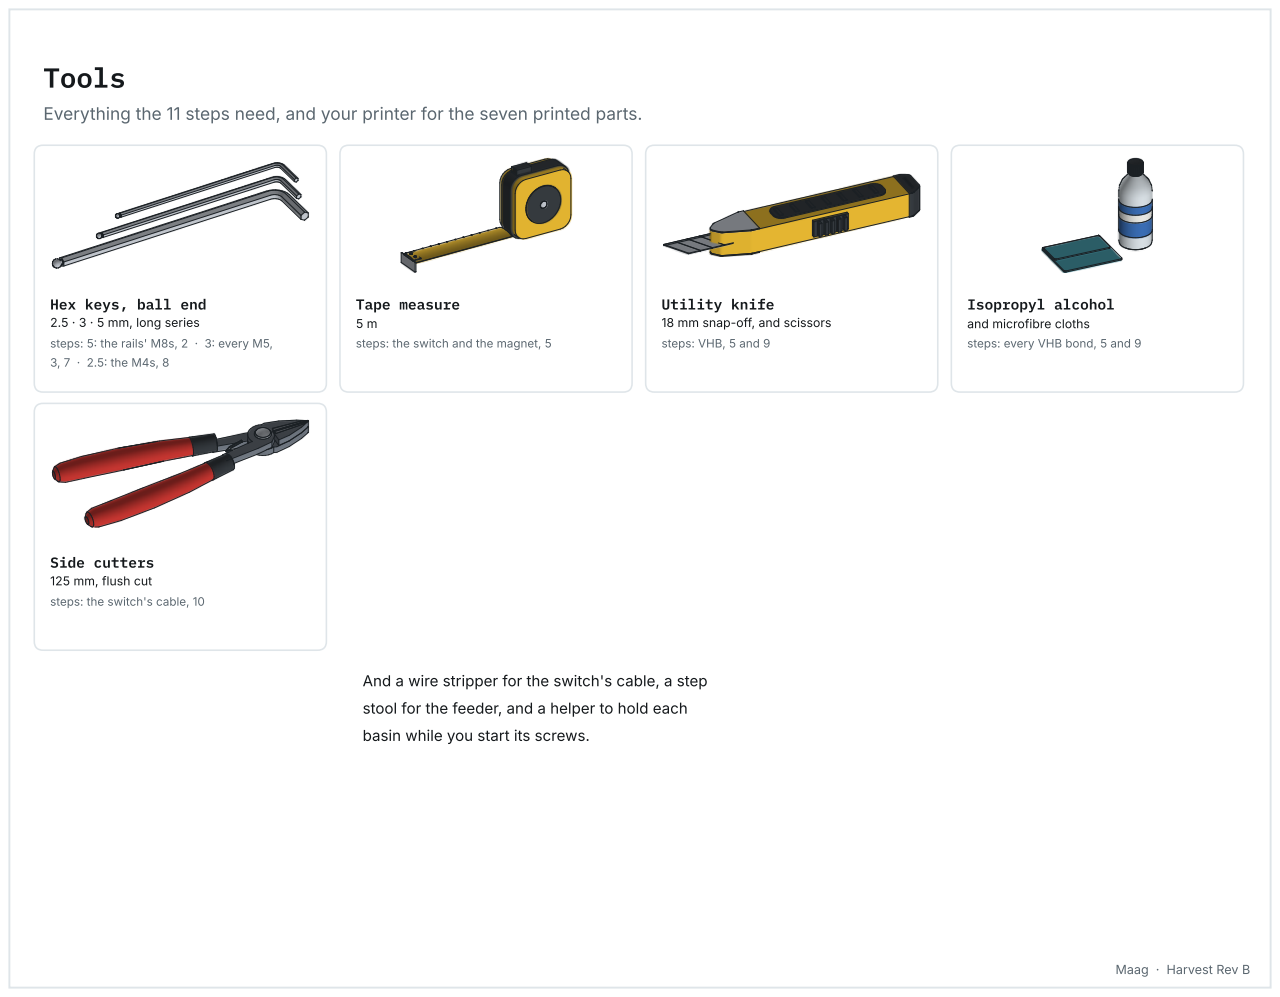
[picture p354: page 6]
Tape measure; Utility knife; Isopropyl alcohol; Side cutters

Everything the 11 steps need, and your printer for the seven printed parts.

Hex keys, ball end

2.5 · 3 · 5 mm, long series
steps: 5: the rails' M8s, 2 · 3: every M5,
3, 7 · 2.5: the M4s, 8

steps: the switch and the magnet, 5

18 mm snap-off, and scissors

and microfibre cloths
steps: every VHB bond, 5 and 9

steps: VHB, 5 and 9

125 mm, flush cut

steps: the switch's cable, 10

And a wire stripper for the switch's cable, a step

stool for the feeder, and a helper to hold each

basin while you start its screws.

# In section, to scale

Through the leaves compartment, across the dead-leaf tray, and through its handle.

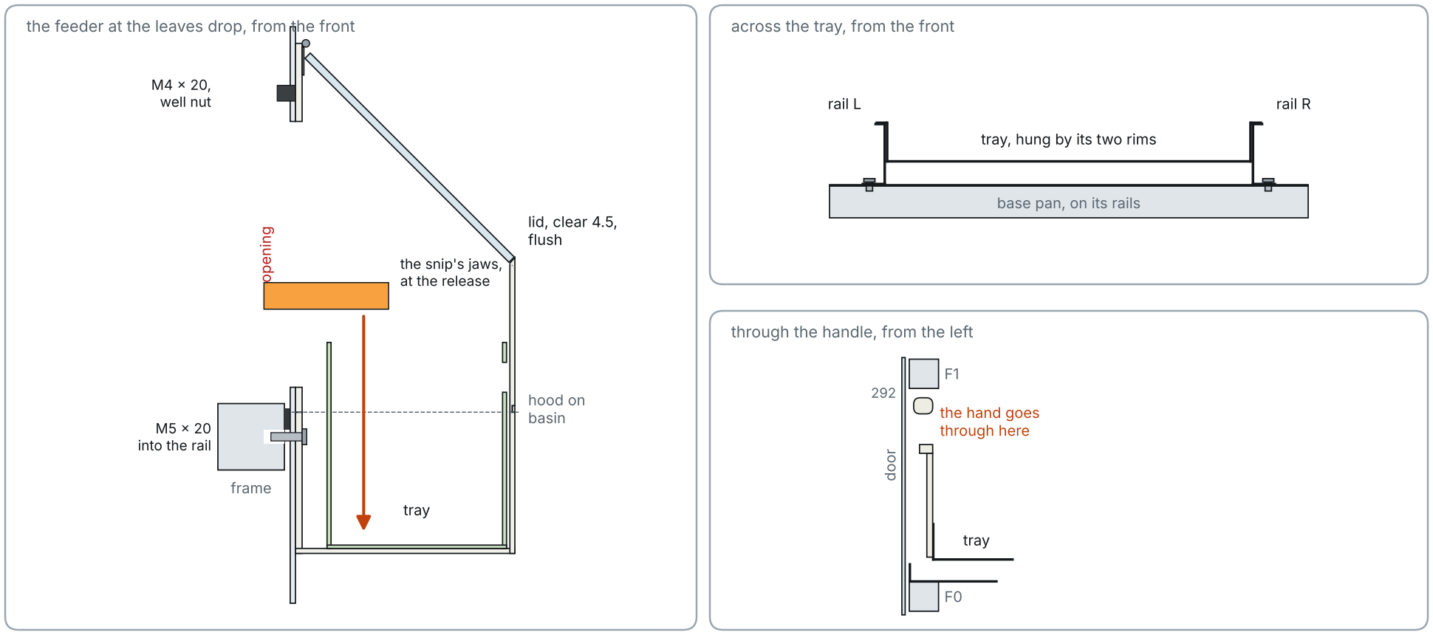
[picture p355: figure]
the snip's jaws, at the release; frame; lid, clear 4.5, flush; hood on basin; opening; tray; M5 × 20 into the rail; M4 × 20, well nut; tray, hung by its two rims; rail L; rail R; base pan, on its rails; the hand goes through here; door; through the handle, from the left

The tray's floor rides 5.0 over the pan's front lip, so it slides straight out; its rims and the rails' stops are 26.0 under the gantry's lowest part. The handle

stops 12.8 under F1 and 11.63 behind the door's inside face. At the feeder the opening's sill is 9.8 over tier B's rail and the tray's rim 27.0 above the sill:

nothing dropped can fall back into the cabinet.

the feeder at the leaves drop, from the front | across the tray, from the front

Enclosure Rev A done

Step 18 signed off, with the right panel that has the feeder's two openings and its four green screws on tier B's rail.

Robot off

Gantry homed and parked left, the E-stop pressed. Nothing in this booklet needs it powered.

Metal in
From SendCutSend: guide rails L and R, the dead-leaf tray (5052, bent), the clear lid. Check the rails mirror each other.

Printed

Handle; the leaves and veggies hoods; two basins, two trays: PETG or PLA, 4 walls, 20 %, no supports.

Fasteners

Against the fasteners page: four M8 × 16, three M5 × 10 and nylocs, four M5 × 20, four M4 × 20 and well nuts.

The switch

One more 7939WG reed switch and its magnet (as on the doors), two lever connectors, 3 m of 2-core cable, a roll of VHB 4905.

1

# Before you start

The cabinet finished to the enclosure booklet, the parts printed and cut. Six checks.

Work in this order: the rails and the tray in the base first, then the feeder on the right panel. The tray needs only the bottom-left door open; the

feeder is all done from outside, except the switch's cable, which runs inside the cabinet to the utility node.

1× Guide rail L, channel open to the left

1× Guide rail R, channel open to the right

4× M8 × 16 button head, the old washer

## 5 mm hex

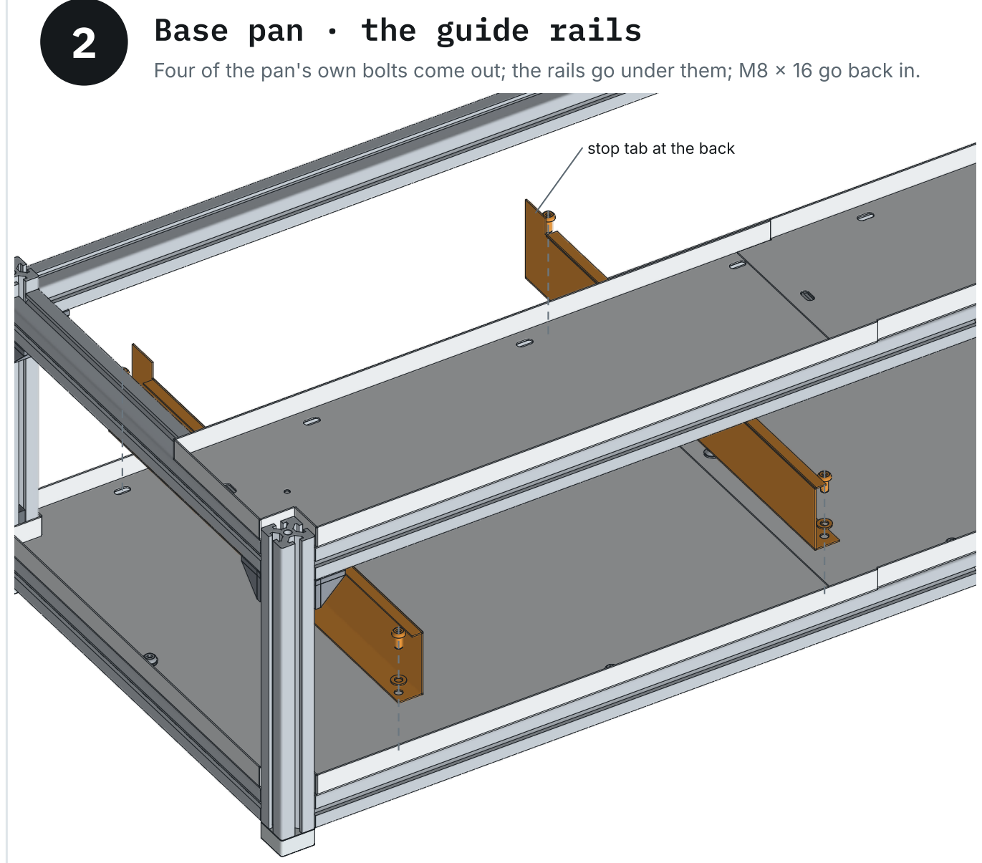
[picture p356: figure]
Base pan · the guide rails; stop tab at the back

Four of the pan's own bolts come out; the rails go under them; M8 × 16 go back in.

x 150 and x 650, front line (y 20)

and back line (y 539): the pan's

own T-nuts stay in the rails

underneath. Keep the M8 × 12s.

Take out the four bolts at x 150 and 650 on the pan's front and back lines; keep their washers, the T-nuts stay put in the frame. Lay each rail on

the pan with its bottom flange over the two holes, the stop tab at the back, the channel opening away from the middle. Washer, bolt through the rail's flange and the pan into the old nut; snug both, check the rails are parallel (460 between the webs), then tighten.

1× Handle, printed

3× M5 × 10 button head

3× M5 nyloc

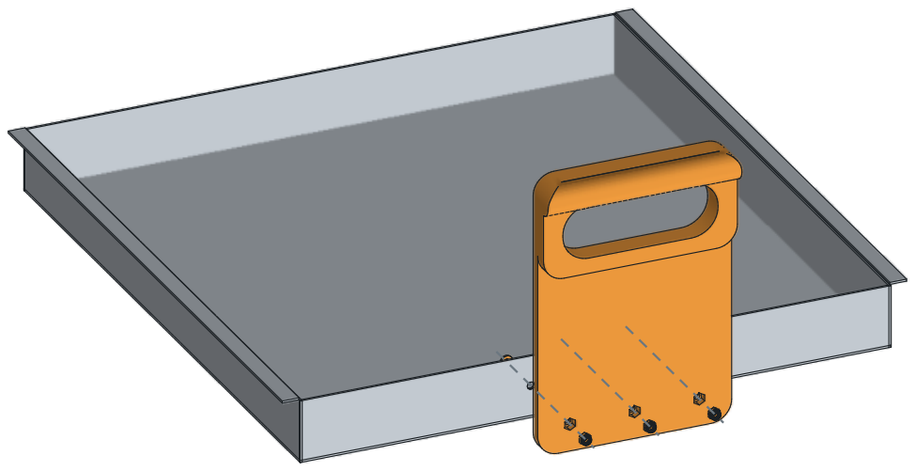
[picture p357: figure]

## 3 mm hex

3

# The tray · its handle

On the bench. Three M5 × 10 from inside the tray, three nylocs pressed into the handle's pockets.

Press each nyloc into its hex pocket,

nylon side out: the pocket holds it

while you turn the screw from

inside the tray.

The handle stands up off the tray's front wall: its slot is 120 wide and 42 tall, a whole hand through it, the bar rounded over the top. Its flat

back goes against the wall's outside, its foot just clear of the bend. Screws from inside, heads on the tray's inside face; tighten until the

handle does not rock, not until the plastic whitens.

4

# The tray · slide it in

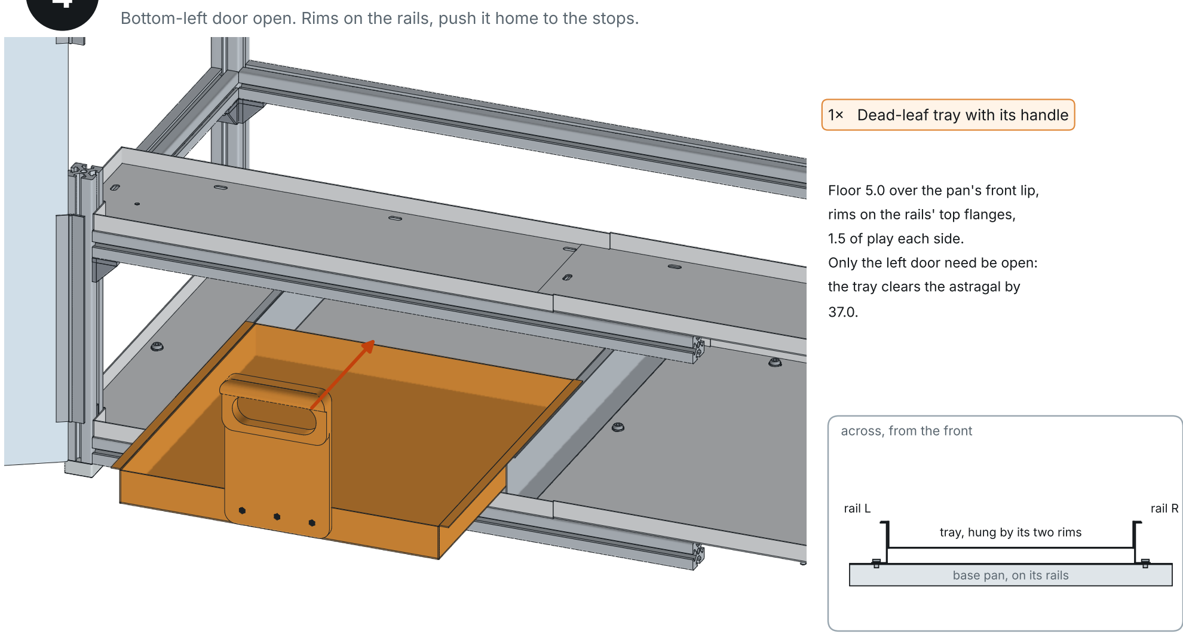
[picture p358: figure]
tray, hung by its two rims; rail L; rail R; base pan, on its rails; 1× Dead-leaf tray with its handle; Floor 5.0 over the pan's front lip,; rims on the rails' top flanges,; 1.5 of play each side.; Only the left door need be open:; the tray clears the astragal by; across, from the front

Bottom-left door open. Rims on the rails, push it home to the stops.

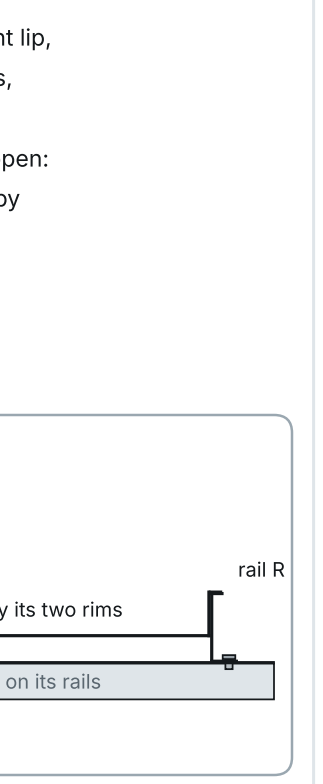
[picture p359: figure]

Hold the tray by its handle, tip the back up a little, and set both rims on the rails' top flanges at the front. Push it back until its back wall

touches the stop tabs. To empty it, pull it straight out by the handle; past half way the rails no longer balance it, so take its weight and lift

it clear. The leak sensor stays where it was, on the pan left of the left rail.

1× Reed switch 7939WG, its own adhesive

1× Its magnet, under the lid

1× Piano hinge 1 ft: lid leaf on VHB

## isopropyl · utility knife · tape

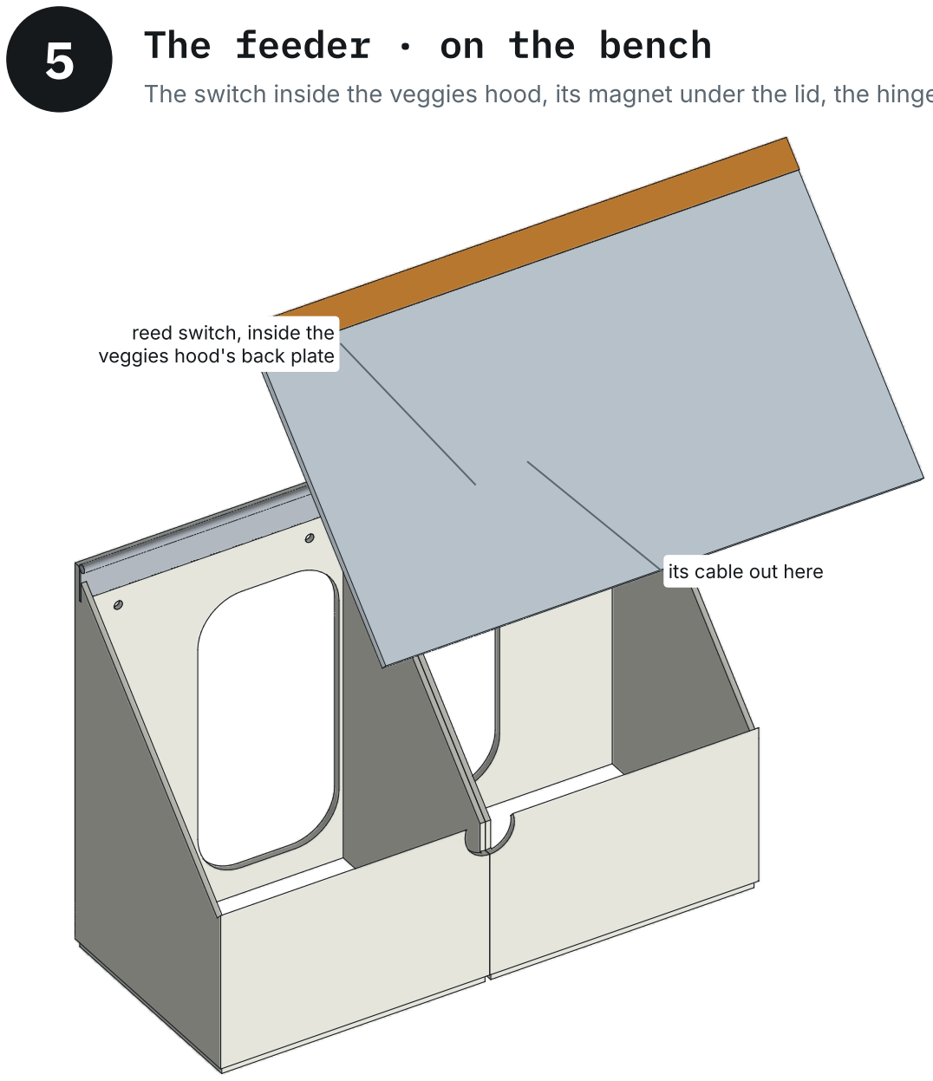
[picture p360: figure]
The feeder · on the bench; reed switch, inside the veggies hood's back plate; its cable out here

The switch inside the veggies hood, its magnet under the lid, the hinge's lid leaf on VHB.

Switch: long side level, its top 22

under the back plate's top edge,

its end 32 from the hood's leaves

side. Magnet: 29 from the lid's hinge

edge to its near edge, its centre

216 from the lid's leaves end.

Lid down they are 2 apart.

Stand the two hoods side by side, leaves toward the cabinet's front. Inside the veggies hood, clean the back plate between the two upper M4 holes

and stick the switch there as the note says, its cable end at the 8 hole; push the cable out through it. On the lid: clean it, the magnet on the

underside where the note says, parallel to the switch; then one VHB strip on the hinge's lid leaf, the knuckle along the lid's hinge edge, on its

top face. Press each for 30 s.

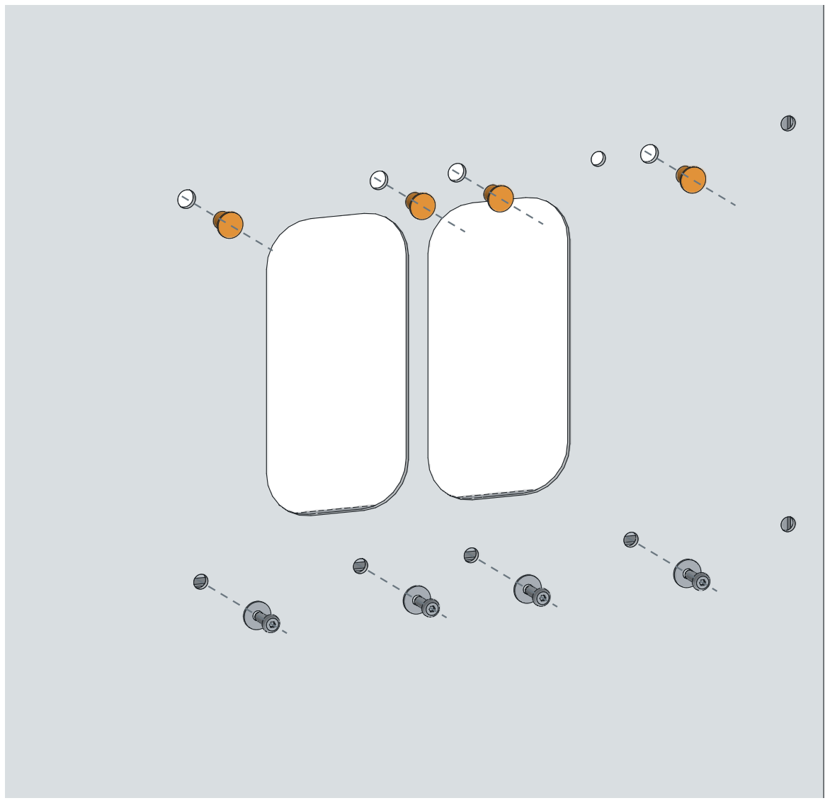
[picture p361: figure]

4× M4 rubber well nut, into a 10 hole

4× M5 × 16 + washer: out, keep the washers

## 3 mm hex

6

# Right panel · well nuts in, temporary screws out

Four well nuts into the 10 holes over the openings; the four green M5 × 16 come out.

Take the M5s out one at a time.

Their T-nuts stay in the slot behind

the panel: the panel covers the slot,

so a nut can turn loose but not

fall out. The M5 × 20s find them.

Push each well nut into its hole from outside until its flange sits on the panel. Then the four M5 screws on tier B's rail line, under the

openings: unscrew and keep their DIN 9021 washers for the feeder. The panel stays put: every other screw still holds it, and its tape is stuck.

2× Basin, printed

4× M5 × 20 + DIN 9021 washer

## 3 mm hex

7

# Feeder · hang the two basins

Each basin's back plate on the panel, two M5 × 20 and washers into tier B's rail.

The four holes place them: leaves

basin in front, veggies behind,

their side walls touching.

A helper holds the first basin against the panel, its back plate's two holes over the panel's. Start both M5 × 20s through their washers into the

T-nuts behind (turn until each nut swings across and grips). The second basin the same, its wall against the first's: the two walls make the 6

divider. Snug all four, check the two floors are level with each other, then tighten firmly.

1× Hood, leaves

1× Hood, veggies, the switch inside

4× M4 × 20 button head

## 2.5 mm hex

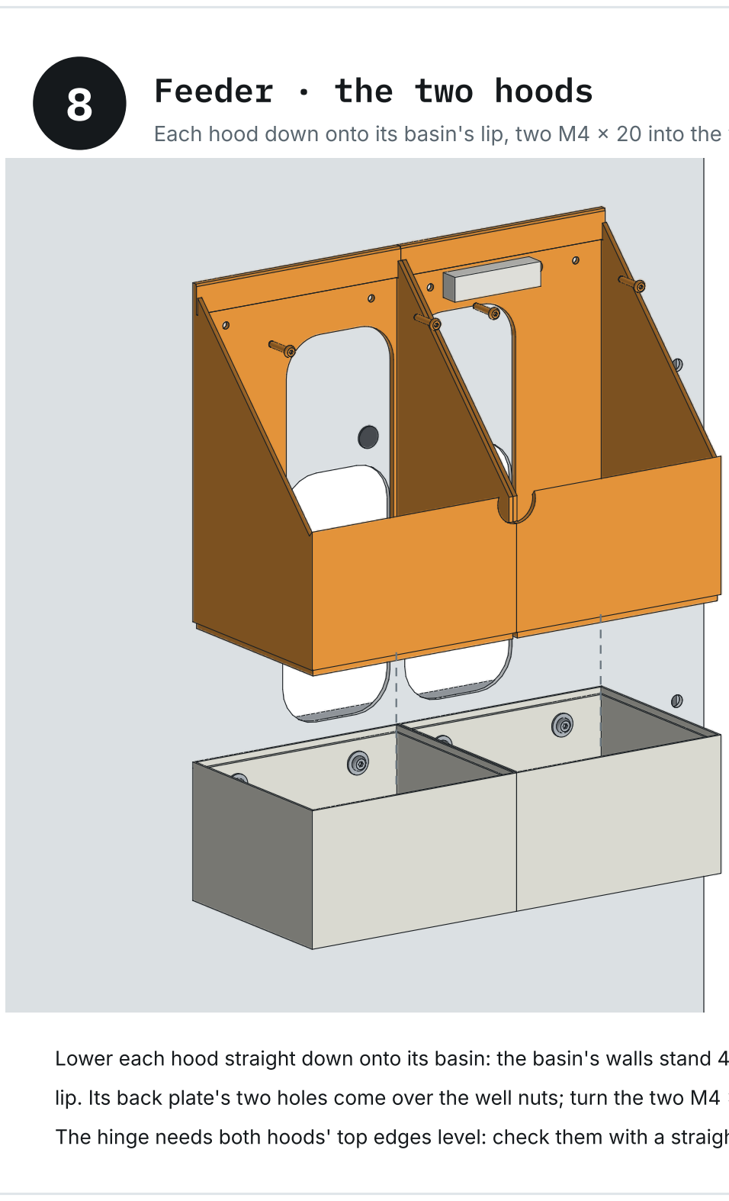
[picture p362: figure]
Feeder · the two hoods

Each hood down onto its basin's lip, two M4 × 20 into the well nuts over the openings.

Veggies first: feed the switch's

cable through the panel's 8 hole

as the hood comes down, and pull

the slack into the cabinet.

Lower each hood straight down onto its basin: the basin's walls stand 4 above the joint on their outer half and the hood's walls drop inside that

lip. Its back plate's two holes come over the well nuts; turn the two M4 × 20s in from inside the hood until the rubber bulges behind the panel.

The hinge needs both hoods' top edges level: check them with a straightedge before you tighten.

1× Lid, with its leaf and magnet

1× VHB 4905 strip, the fixed leaf

## isopropyl · utility knife

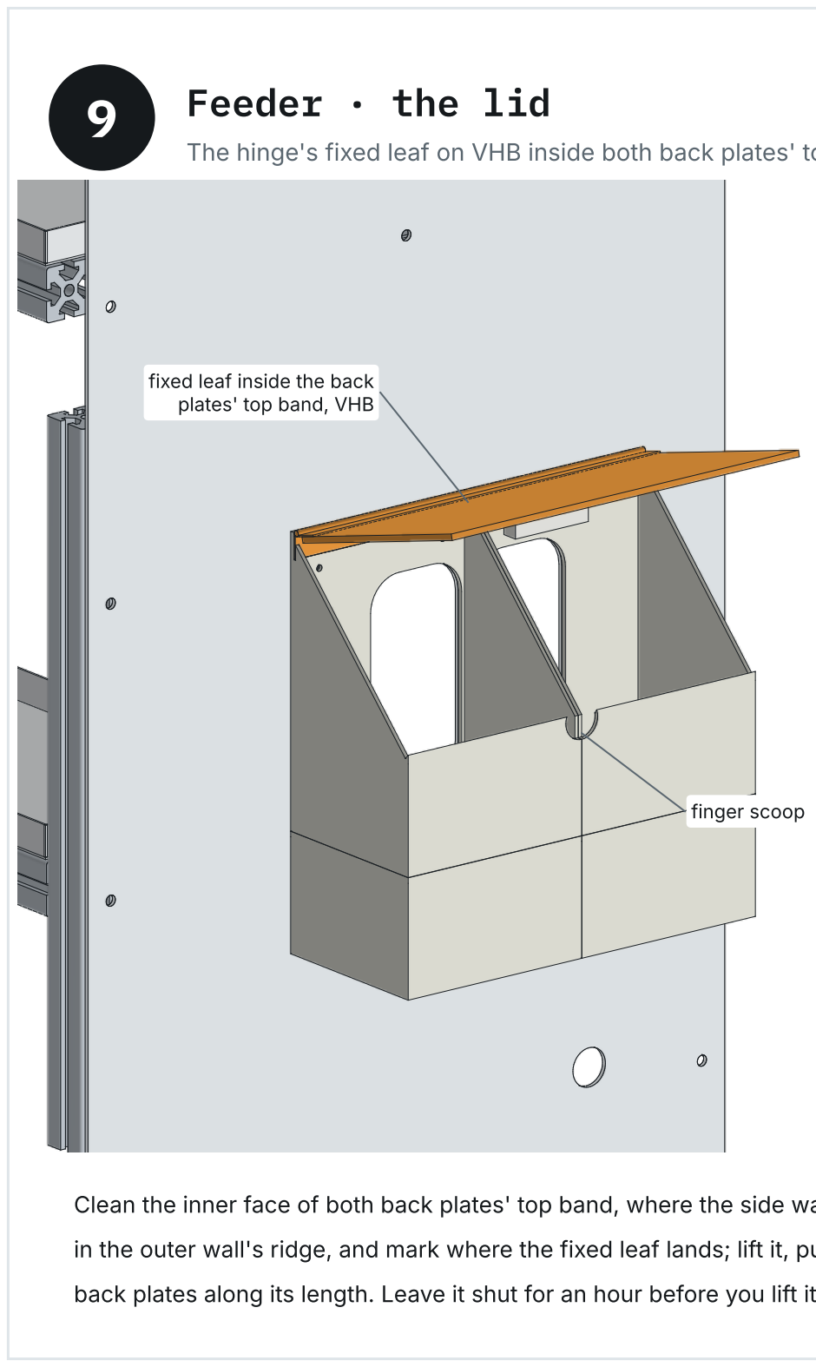
[picture p363: figure]
Feeder · the lid; fixed leaf inside the back plates' top band, VHB; finger scoop

The hinge's fixed leaf on VHB inside both back plates' top band. The lid comes down flush.

Lid 304.8 × 173.6, falling 45° away

from the panel; its lower edge is

flush with the walls' outer faces.

Lifted, it turns past upright and

leans on the panel by itself.

Clean the inner face of both back plates' top band, where the side walls are slotted for the leaf. Hold the lid down on the walls, its lower edge

in the outer wall's ridge, and mark where the fixed leaf lands; lift it, put VHB on the fixed leaf, lower the lid and press the leaf onto both

back plates along its length. Leave it shut for an hour before you lift it: VHB takes most of its strength in that time and all of it in a day.

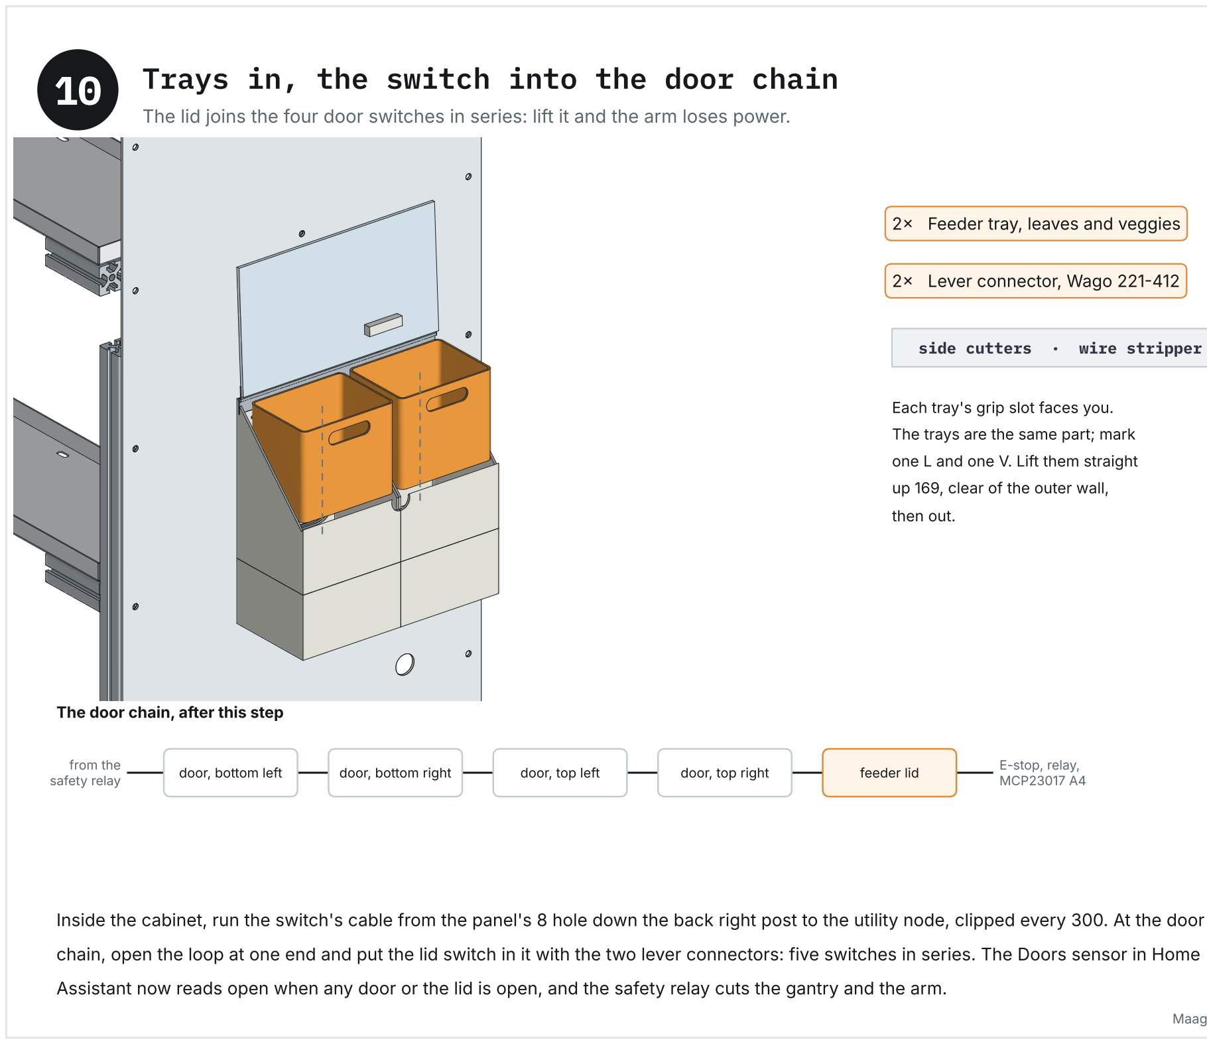
[picture p364: figure]
from the safety relay; E-stop, relay, MCP23017 A4; The door chain, after this step; door, bottom left; door, bottom right; door, top left; door, top right; feeder lid; 2× Feeder tray, leaves and veggies; 2× Lever connector, Wago 221-412; side cutters · wire stripper; Each tray's grip slot faces you.; The trays are the same part; mark; one L and one V. Lift them straight; up 169, clear of the outer wall,; then out.

# 10 Trays in, the switch into the door chain

The lid joins the four door switches in series: lift it and the arm loses power.

Inside the cabinet, run the switch's cable from the panel's 8 hole down the back right post to the utility node, clipped every 300. At the door

chain, open the loop at one end and put the lid switch in it with the two lever connectors: five switches in series. The Doors sensor in Home

Assistant now reads open when any door or the lid is open, and the safety relay cuts the gantry and the arm.

Tray

Slides out with the left door alone and back to the stops; nothing scrapes; the leak sensor still reads dry.

Lid

Lifts by the scoop, turns past upright, leans on the panel; drops shut flush, its edge in the ridge.

Switch

Lid open: Doors reads open, the relay drops, the arm will not move. Lid shut: it resets.

Air

Fans on: a tissue at the lid's gap barely moves. The feeder is part of the cabinet's air.

Drops

Commissioning: jog to each pose in drops.yaml at 20 % speed, lid shut. The jaws pass the openings' middles.

Software

The Herb Snip sends leaves and veggies to the feeder, dead leaves to the tray, five drop points in turn.

# 11 Before the first harvest

The checks that catch the usual faults, with nothing in the trays yet.

Empty the feeder's trays as often as you harvest; wash them like any food container (no dishwasher for PLA). The dead-leaf tray holds about 10 L: empty

it into the compost when the leaves reach its rims. Never reach into the feeder from inside the cabinet with the robot powered.
