v1proxy/RedTower/greenhouse/drawings/wiring_E01_power.png

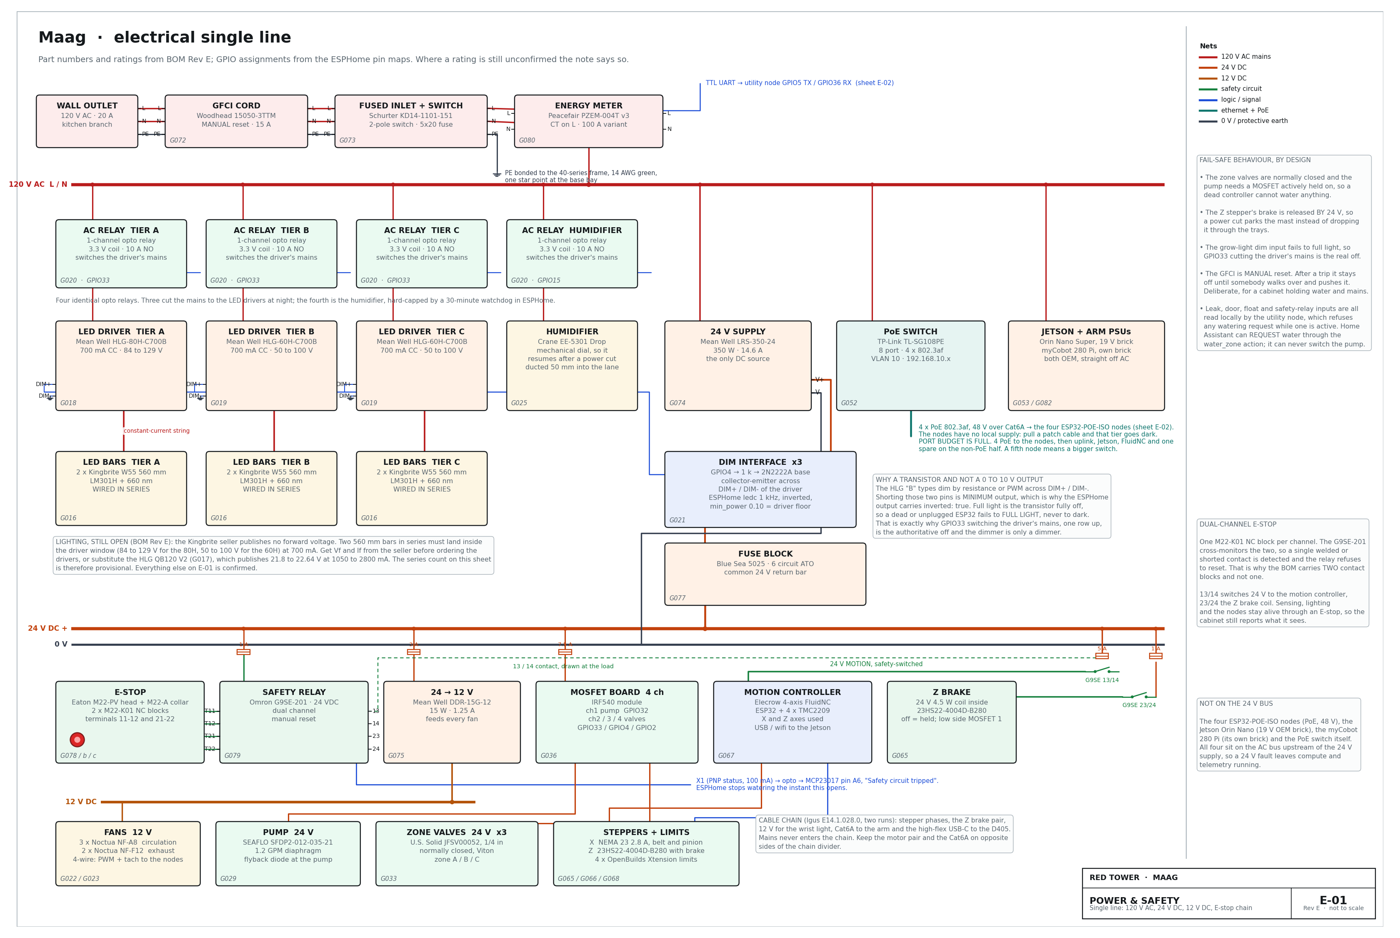
greenhouse/drawings/wiring_E01_power.png
