v1proxy/RedTower/greenhouse/drawings/wiring_E02_network.png

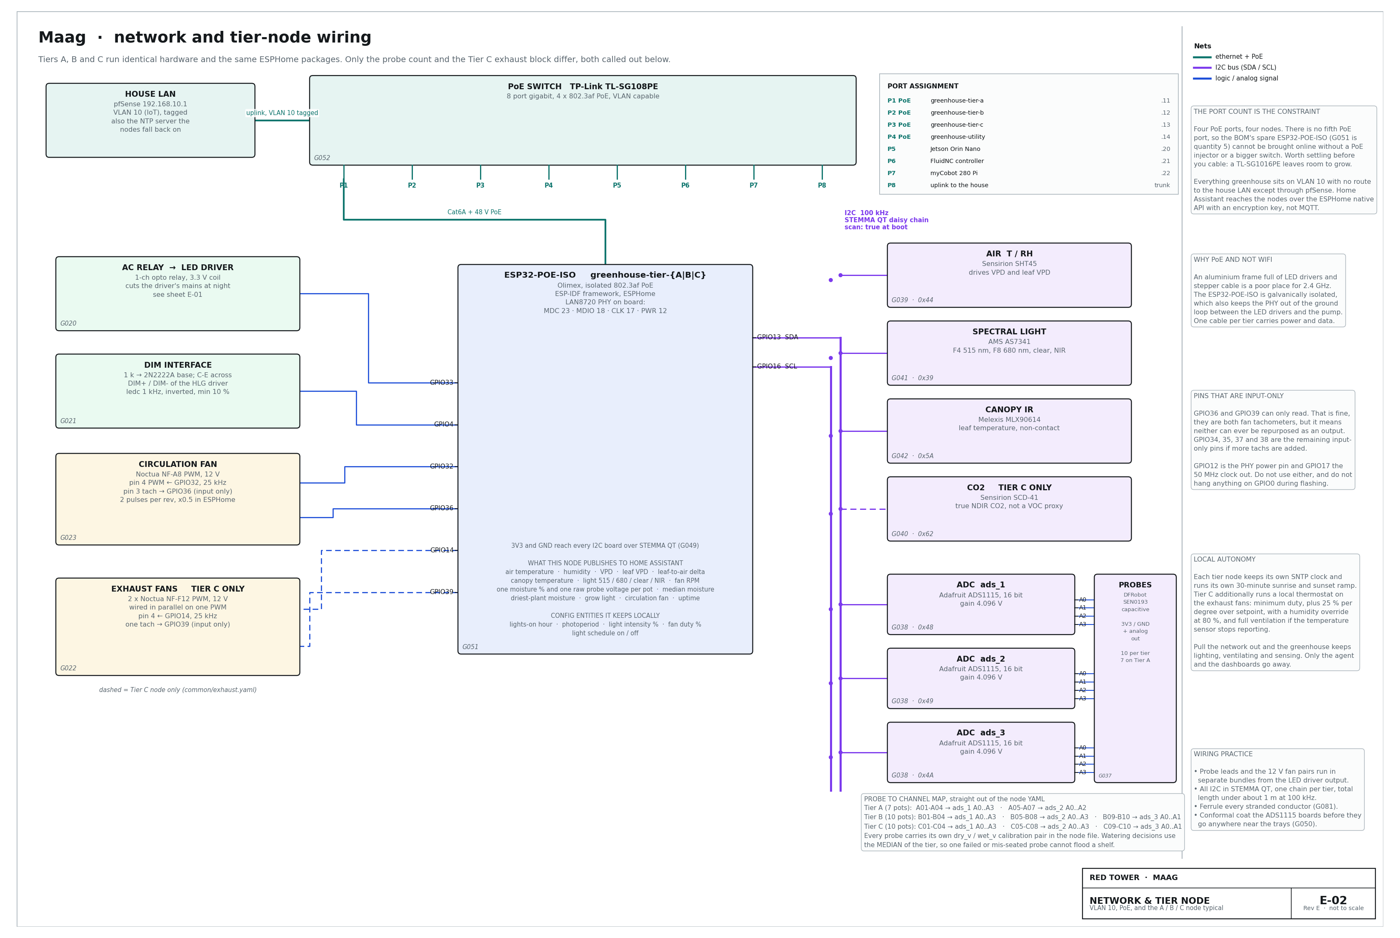
greenhouse/drawings/wiring_E02_network.png
