v1proxy/RedTower/greenhouse/drawings/wiring_E03_utility.png

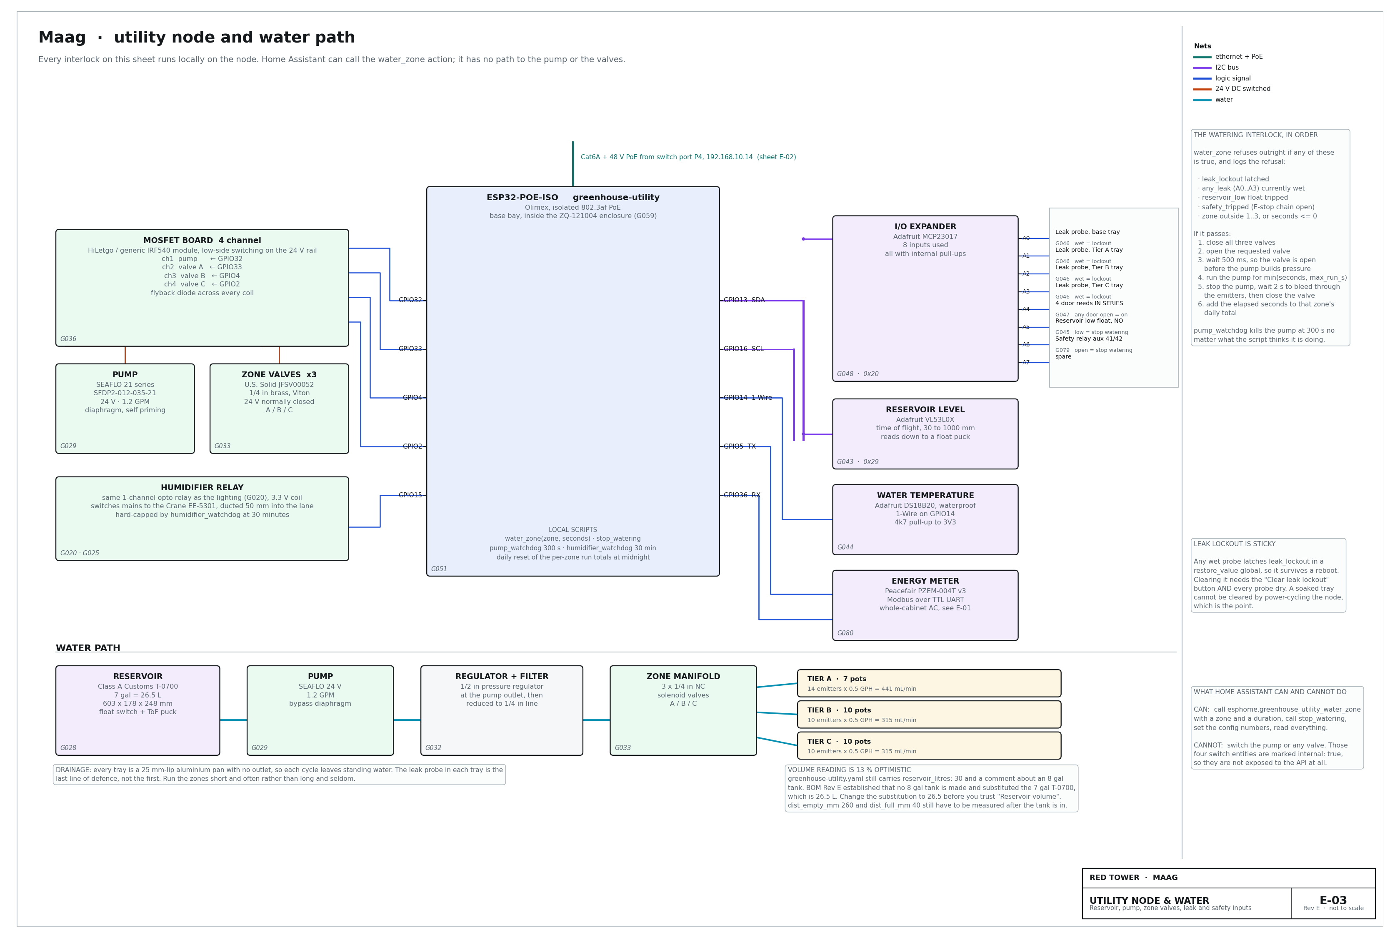
greenhouse/drawings/wiring_E03_utility.png
