v1proxy/RedTower/greenhouse/drawings/wiring_E04_motion.png

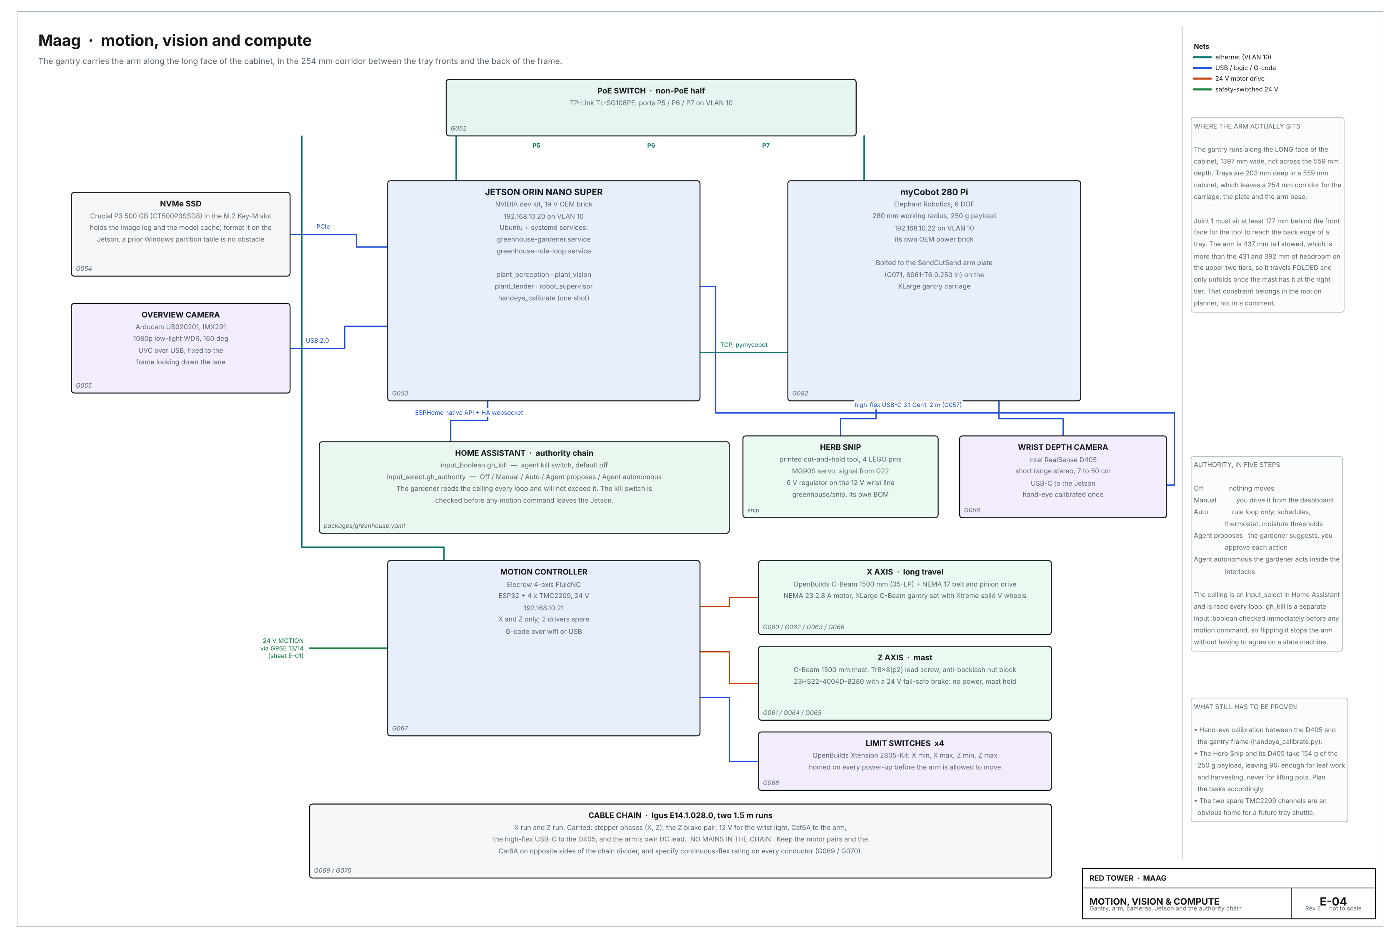
greenhouse/drawings/wiring_E04_motion.png
