v1proxy/RedTower/CHANGELOG.md

# Changelog

This repository is a buildable design, so it is versioned like one. The version
in `VERSION` describes the *design*, not the code, and every generated artifact
is stamped with it.

- **MAJOR**: a change that makes an already-built unit wrong: a frame dimension,
  a pin reassignment, a part that is not a drop-in for the one it replaces.
- **MINOR**: a new module, a new size preset, a new capability. Existing builds
  stay valid.
- **PATCH**: corrections, better documentation, a part substitution that is a
  genuine drop-in, generator fixes that change no output.

Anyone who built against an older version should be able to read down to their
version and see exactly what would have to change.

## 0.10.1 – 2026-10-26

**The floor buttons in the dashboard's own style.** A refinement of the 3D card from 0.10.0;
nothing on a built unit changes.

### Changed

- `house/floorplan/card/ui_patch.js`: the floor buttons are tiles like the rest of the
  dashboard: square dark tiles with a 1 px border, an icon over an uppercase caption, a red
  border and icon while the floor is shown, grey while it is hidden, and icons only when the
  card is small or narrow. The black strip behind them is gone, so the weather carries on
  between the buttons. The new `levelsPatch` also upgrades a card that is already patched.
  New card options: `level_names` and `level_icons` (by level), `level_all_name`,
  `level_all_icon`.
- `card_config.json`: Ground, Second, Third and Roof, with the matching floor icons.
- `house/floorplan/README.md`: the new buttons, their options and a figure
  (`docs/house/floor-tiles.png`); the resource query is `?v=11`.
- `VERSION`, the panel card's `CARD_VERSION` and its resource query are 0.10.1. The greenhouse
  card itself is unchanged.

## 0.10.0 – 2026-10-26

**The house in its weather.** The 3D floor plan now lives in the real sky: the weather outside
is animated around the house, the sun's light comes in from where the sun really is, and after
dark the windows light up while someone is home. Turning a floor off also clears its tiles from
the dashboard. A new capability on the house dashboard; nothing on a built unit changes.

### Added

- `house/floorplan/card/fx_patch.js`, a third patch for the card, applied by `build_card.js`
  after the other two:
  - **Floor filter.** Dashboard cards in the same grid as the 3D card that carry
    `variables: { rt_floor: N }` hide while level N is hidden in the 3D view, so turning a
    floor off also removes its tiles underneath.
  - **Weather** from any weather entity (`weather_entity`, default `weather.forecast_home`;
    `weather: "no"` turns it off), at 30 fps: rain slanted by the wind, downpour, snow, hail,
    storms with lightning, clouds, fog, wind streaks, and stars by night.
  - **A sky behind the house.** The scene background is cleared and painted on a canvas behind
    the model, so stars, clouds and lightning bolts always stay behind the building, while
    rain, snow, hail, fog and the lightning flash fall in front of it.
  - **Sunlight.** The sun always stays just outside the frame and moves around its edge through
    the day, placed from `sun.sun` azimuth and elevation relative to the camera. Only its light
    comes in, as a soft wash and a glow from that edge: no rays, streaks or flares. Its colour
    shifts slightly, cool white at dawn, warm white at midday, light peach at sunset, and a
    cloud in front of it dims it.
  - **Lit windows.** After sunset, while someone is home, every window glows warm as if the
    lights were on (`presence_entity`, default `zone.home`; `window_lights: "no"` turns it off).
- `docs/house/3d-sky.png`: night with someone home, and sunset.

### Changed

- `ui_patch.js`: the floor buttons are in the dashboard's red; hidden floors dim to 30 %.
- `card_config.json`: the weather entity is set, and the temperature labels show a proper
  degree sign (it had been saved with a broken encoding).
- `house/floorplan/README.md`: the third patch, its options and the new figure; the resource
  query is `?v=10`.
- `VERSION`, the panel card's `CARD_VERSION` and its resource query are 0.10.0. The greenhouse
  card itself is unchanged.

## 0.9.0 – 2026-10-25

**The house in 3D.** Red Tower itself on the dashboard: an axonometric 3D floor plan in Home
Assistant, built from the house's Revit model in Blender, with floors that peel away, live room
labels, the furniture rebuilt from photos, the exterior coloured as built, and the car in the
garage with its charge level. A new capability beside the greenhouse; nothing on a built unit
changes.

### Added

- `house/floorplan/README.md`: the method end to end. Reading floors, ceilings and rooms out of a
  33,976-object Revit export; cutting it into levels 4 ft above each floor with capped section
  cuts; the naming rules the card depends on; materials that read well under the card's flat
  light; furniture from photos with the makers' dimensions; deploying and configuring the card;
  the gotchas, each with its cause.
- `house/floorplan/blender/`: every script, headless. `build_ha.py` (palette, level cuts, numpy
  joins, bindable rooms, light anchors, status strips, vacuum pucks), `finalize.py`, the
  repaints, `furnish_bedroom.py`, `furnish_living.py` (bookcases, L sofa, Flos Arco, TV),
  `furnish_car.py` (a Polestar 2 from its published size), the analysis tools, and
  `rebuild_all.ps1` / `rebuild_all.sh` for the whole chain.
- `repaint5.py`: exterior trims selected by geometry, since the export has no family names.
  Parapet, coping, entry door, awning, downspouts and roof scuppers red; every window frame
  aluminium; wall faces seen from outside take the nearest cladding colour, found with
  sky-visibility rays after splitting the walls at the roof planes.
- `house/floorplan/card/`: two patches for the HACS `floor3dpro-card` and `build_card.js`, which
  applies both. `axo_patch.js`: orthographic camera (`ortho_half_height`), level buttons highest
  first, renamed elements so it runs beside the HACS card, and a fix for labels and room planes
  collapsing into one corner whenever the card is rebuilt (its model cache shared geometry
  between clones). `ui_patch.js`: labels at four times the resolution on a rounded box that fits
  the text, true white text, 40 px floor buttons with hidden floors dimmed.
- `house/floorplan/card/card_config.json`: the card as configured at Red Tower, and
  `house/floorplan/preview/`: the card rendered headless to check a model before uploading it.
- The car: shown in the garage while the charger is connected, with battery and charging power
  on its label, through the Polestar API integration (HACS). The guide covers the install, the
  sign-in and the bindings; the dashboard has a Polestar row (battery, range, charging, full at).
- `docs/house/`: the screenshots. README: a section, The house in 3D, and `house/` in the layout.

### Changed

- `VERSION`, the panel card's `CARD_VERSION` and its resource query are 0.9.0. The greenhouse
  card itself is unchanged.

### Not included

- The house model and the GLB built from it stay out of the repository. The scripts take your
  own model as input.

## 0.8.0 – 2026-10-24

**The interface and the controls: explained, pictured and packaged.** How the greenhouse is
controlled, what every part of the Greenhouse panel does and how to install it, in one
chapter, and the Home Assistant side as a download. A new capability: the interface can be
installed from a release or from HACS. Nothing on a built unit changes.

### Added

- `docs/07-home-assistant.md`, written and checked line by line against the code. The control
  system: one path to every actuator, the safety governor's nine checks in the order the code
  runs them, the three verdicts, who acts on an approved command, the authority ceiling level
  by level, the kill switch, the supervisor, the bridge, the mirror, the watchdog and the
  watering fallback. Then the panel section by section, what
  every control sends, every entity it reads, three ways to install it, how to check it, and
  what is not verified yet.
- `docs/interface/`: the control system diagram (SVG and PNG, house style) and screenshots of
  the real card on its simulated data at the four target sizes (1320, 1280, 600 and 390 px),
  with close-ups of the kill switch, a denied request, power, the plants and console, and the
  expanded plant card. Generated by `greenhouse/ha/make_control_diagram.py` and
  `greenhouse/ha/make_shots.py`, which runs the card itself in headless Chromium.
- **Download:** `greenhouse/ha/make_bundle.py` builds `maag-homeassistant-<version>.zip`, the
  card, both packages, the view, the broker setup and the access list in Home Assistant's own
  folder layout, and copies the card to `dist/greenhouse-panel.js`. Both are attached to the
  release.
- **HACS:** `hacs.json`. Add this repository as a custom Dashboard repository and HACS installs
  the card from `dist/`. The packages are still copied by hand.
- README: a section, The interface and the controls.
- CI: `make_bundle.py --check` (the card's version, the `dist/` copy, every file the zip
  carries).

### Changed

- **The card no longer asks Google for fonts.** It imported IBM Plex from Google Fonts inside
  its shadow root, where Chromium ignores `@font-face`: in Chrome, Edge and the Home Assistant
  app on Android it sent a request to Google on every load and still drew in the system font.
  It now makes no network calls of its own and uses IBM Plex where the device has it
  installed. Nothing changes on screen in those browsers.
- The card carries its version, `CARD_VERSION`, and logs it in the browser console.
- `ha/dashboard_view.yaml` works on any dashboard; the resource carries `?v=` so an update
  reaches every browser.
- `greenhouse/README.md` and the README's layout: `ha/` is the interface; `homeassistant/` is the
  first-generation package that is still installed beside it. The first-generation card is
  marked superseded in its header.
- `COMMISSIONING.md` step 3 points at the guide and the release zip.
- `ha/mosquitto-setup.md`: the access list sample has no entry for Home Assistant's own login,
  and installed as it is it would cut Home Assistant off from MQTT. It now says to add one,
  as the bench check does.

### Found while writing it

- **Two things can water after a Home Assistant restart.** `input_boolean.gh_auto_water` starts
  on at every restart (`initial: true`), and the handover that turns it off fires only when
  irrigation changes to Running. If irrigation was already running, Home Assistant's threshold
  rule and the Jetson's irrigation can both water a zone, each at most once an hour, until
  `gh_auto_water` is turned off. That rule also calls the node directly, outside the governor.
  The node's own refusals still hold. Documented; the fix is open.
- **The jog buttons do nothing yet.** The governor approves `jog_x` and `jog_z` from the panel,
  but the gantry driver does not carry them out. Home works.
- **The kill switch stops agents, not you.** A proposal already queued can still be approved,
  and then runs as your own request. Documented.
- **The approval queue lives in the governor's memory.** A restart of the core empties it.
  Documented.
- **Photo now works at Auto and above only**, because motion asks for each move as a service.
  Documented.

### Open

- The double watering after a restart, and the jog in the gantry driver (above).
- `homeassistant/packages/greenhouse.yaml` still defines the first-generation helpers
  (`input_select.gh_authority`, `input_boolean.gh_kill`, `input_boolean.gh_claude_autonomy`,
  the proposal text helpers, `script.gh_robot_task`, `script.gh_tender_approve`). The stack does
  not read them and the panel does not show them. Taking them out is open.
- The reference build's Home Assistant still runs the first-generation card, which drives
  those helpers instead of the supervisor's kill switch. Installing this card (commissioning
  step 3) closes that, and must happen before any agent is started.
- Tablet and phone layouts are checked in a browser at their widths, not yet on the devices.
- The bench check loads `greenhouse_jetson.yaml` alone, on the current stable Home Assistant:
  both packages together, and Home Assistant 2024.8, are untested.
- The broker access list is still not applied on the reference build.

## 0.7.1 – 2026-10-24

**The booklets, readable on GitHub.** Documentation only: no part, dimension or pin
changes, nothing to do on a built unit.

- `greenhouse/booklet/make_gallery.py` renders every page of the five assembly booklets
  from their PDFs (121 pages) into `docs/booklets/`: each page 1400 px wide and as a
  thumbnail. Page titles and step numbers come from the PDFs' own text.
- `docs/booklets/README.md`: every page of every booklet, in build order, as thumbnails.
  A page opens full size in its booklet's page-by-page view, `docs/booklets/<booklet>.md`,
  which also links the PDF and the module's guide.
- The README opens with the shared cover render and has a new section, **Assembly
  booklets**: four pages from each booklet, each linked to its page.
- Each module's guide (`FRAME_ASSEMBLY.md`, `GANTRY_ASSEMBLY.md`, `ENCLOSURE.md`,
  `HARVEST.md`, `HERB_SNIP.md`) opens with the same four pages and a link to all of them;
  `docs/03-frame-assembly.md`, `docs/08-gantry.md` and `docs/08-arm.md` link the views.
- The blocks it writes sit between `<!-- booklet... -->` markers. Rerun it after rebuilding
  any booklet; a booklet whose PDF has not changed is not rendered again.

## 0.7.0 – 2026-10-21

**The Herb Snip: the arm's tool.** One printed end effector that cuts a stem and
holds what it cut in the same closing. A TowerPro MG90S drives a blade jaw through a
four-bar linkage onto an anvil; printed TPU pads close a moment before the blade, so the
cut leaf or tip stays in the jaws. It goes on the 280's flange with four LEGO pins and
replaces the adaptive gripper. A new module, so existing builds stay valid. See
`greenhouse/snip/HERB_SNIP.md`.

### The tool

- 34 N at the cut with the servo derated to 0.15 N m; 55° of opening, 21 across the jaws
  at the cut zone; the servo turns 157° for it.
- An OLFA 9 mm snap-off blade, a 34 mm piece, in a pocket that takes every snap angle from
  52° to 68°; a printed anvil, a wear part.
- The D405 rides on the tool, tilted 20°: the cut zone is 72 from it, past its 70 near limit,
  so it sees the stem in the jaws before it cuts.
- The pads are TPU 95A, one part printed twice: a comb of 11 fins slanted toward the jaw
  root on a one-way dovetail that slides into each rib. About 1.1 N of hold on a 4.5 mm
  stem; at most 2.0 N of the servo's force, on a 6 mm stem, at the end of the cut.
- Every fastener sits flush: a shoulder screw for the pivot, head in a counterbore, shoulder
  on a heat-set insert in the cheek (no "snug, then back off"); one countersunk M2 into a
  second insert clamps the blade, where three socket heads were; two countersunk M3 hold
  the camera. Changing a blade is two screws into brass.
- The body is one housing from the flange up: a round collar with a band, a waist into a
  rounded housing that encloses the servo, the regulator and the linkage, and a deck the jaws
  stand on. The mechanism moves in a cavity cut to its swept shapes; a porthole shows the link,
  a window lets the horn past the wall. One edge radius on every small part, and jaws that
  close into one beak.
- The collar splits at its band into the body and a camera ring: the ring is the collar's
  foot and the D405's chin in one piece, on the same four pins between the flange and the
  body. The body stands on a flat base and the ring on its flat side: nothing needs supports.
- 95.9 g of tool; with the D405, 153.9 g of the 280's 250 g payload.
- Power from a Pololu D24V10F6 (6 V) on the 12 V wrist line, never from the arm; signal as
  50 Hz PWM from the end connector's G22. Doors or E-stop cut the arm's power, the pulses
  stop and the servo goes limp.
- Every drawing is from the real model: `snip_cad.py` for the printed parts, Intel's D405
  mesh, the MG90S datasheet and Elephant's arm meshes. Interference over the jaw's whole
  travel: none. The transit fold clears the tray line with the jaws open or closed, at
  every J6 angle.

### Where the cuts go

Harvest Rev B's dead-leaf tray and feeder, not a drawer of the snip's own. A dead leaf
rides in the folded jaws; the gantry stops over one of the tray's five drops at the lowest
Z and the jaws open 49 above its rims, at least 58 from a wall; Z full travel there clears
the rims by 30. Leaves and veggies go out through the right panel into the feeder, on
drop poses Harvest Rev B solves; that arm route is the next software step. The printed
harvest drawer and its handle, drawn for this release first, are gone.

### Assembly

Every part goes into the one-piece body from outside, and the model checks each way in
against what is already fitted: the jaw open 30°, down 7 toward its opening side and
across, 0.8 off the fixed pad; the link down 6 to the servo side, past jaw B's rib; the
servo from the back. The regulator's bay leaves 0.45 round the board.

Tried first and dropped, both against the real 280 mesh: a cup on the carriage, and a bin in
pot station B01. The arm is side-mounted with its J1 axis 121 from the left side at the
carriage's left limit, so turning toward a bin there swings the tool through the side panel,
and every route forward crosses B02's plant. B01 stays a pot station.

### Software

- `gh/mods/snip.py`: pulse arithmetic, the jaw, and the D405 check that something is
  between the jaws.
- The arm driver runs actions as steps. `cut` closes the jaw and it stays closed through
  the park; `release` opens and closes it at the fold. `arm/state` carries `jaw`. The real
  arm sends the servo nothing until `arm.yaml`'s `snip` block is calibrated.
- Motion: a tend task is now approach, cut, park holding it, then `to_bin` (a harvest or a
  pinched tip) or `to_waste` (a removed leaf), `release`, home. A full drawer stops the next
  harvest. The governor grants one release with each approved cut.
- Gantry: `to_bin` and `to_waste`, to `robot.yaml`'s new `bin` and `waste` positions.
- Home Assistant: **Herb Snip jaw**, **Harvest drawer** and a **Harvest drawer emptied**
  button.
- `tools_snip_check.py` for commissioning; `prototype/robot_supervisor.py` does the same
  cut-and-hold and routing; `tests/test_snip.py` (155 tests pass).
- `arm.yaml`'s `stow` placeholder is now the model's fold, `(0, -110, -80, -140, -90, 0)`,
  the pose every clearance in the gantry booklet assumes.

### Added

- `greenhouse/snip/`: the model, the eight print files, the checks (with `access_check.py`
  for every way in and every tool's reach), a mesh decimator,
  `Maag_Herb_Snip_Assembly_Instructions_RevA.pdf` (the same cover as every Maag booklet),
  `Maag_Herb_Snip_BOM_RevA.xlsx` and its generator.
- `greenhouse/COMMISSIONING.md` section 7b, the Herb Snip.

### Changed

- **Gantry BOM Rev D**: Rev C with line R02, the adaptive gripper ($129.99), at quantity
  0. Nothing else moves. `build_gantry_bom_revD.py` replaces the Rev C generator.
- README: the design badge (it still said 0.1.3), the `arm` module line, the layout.
- **Master BOM Rev F**: G083, the adaptive gripper, at quantity 0.
- `design/params.py`: `ARM_GRIPPER` (90.0) becomes `ARM_TOOL`, 89.7, the Herb Snip's cut
  zone past the flange; the solver's reach note speaks of the tool.
- Wiring sheet E-04: the Herb Snip where the adaptive gripper was, and its payload.
- `GANTRY_ASSEMBLY.md`: the reach row with the Herb Snip.
- `harvest/HARVEST.md`: the Herb Snip as assembled is the baseline tool for `reach.py`; the
  drawer it superseded is gone, and the dead-leaf drop at the fold is recorded beside the
  poses in `drops.yaml`.

## 0.6.3 – 2026-10-21

**The feeder without its skirt, and the humidifier duct drawn smooth.** Nothing
built changes: the feeder and the panels have not been made yet.

### Changed

- **Feeder: the sloped skirt under the floor is gone.** Each compartment is two
  prints again, the basin and the hood; `feeder_skirt.stl` and step 9 (the
  skirts) are removed, and the booklet is 11 steps. Seven prints, 1.55 L if
  solid. The tier A gland stays at 780: at 900 it would touch the basin's floor.

### Fixed

- **Tubes and ducts no longer twist.** `kit3d.tube` picked each ring's frame
  afresh from a reference axis, so where a path's tangent crossed that axis the
  frame flipped and the tube between two rings wrung itself into a ribbon: the
  humidifier duct's bend on the right panel. Ring frames are now carried along
  the path by parallel transport. Every tube in every booklet (drain lines,
  cables, the duct) draws the same or better.
- **The duct follows one smooth bend**: straight off the collar's spigot, a
  48-point curve, then down beside the panel, in place of five straight runs.

## 0.6.2 – 2026-10-21

**The arm plate drawn as one solid.** A drawing fix, nothing to build differently.

### Fixed

- `gantry/parts.py` `arm_plate()`: the plate's four countersinks were modelled as
  four stacked layers, and the faces between the layers showed through the line
  drawings as dark streaks beside the arm. It is now one closed solid
  (manifold3d) with true 90° countersinks, the same holes and the same 6.35
  thickness; without manifold3d it falls back to the layers. The harvest
  booklet's "How the arm drops" page is redrawn; the gantry booklet picks it up at
  its next build. The SendCutSend DXF (`arm_plate_revB.dxf`) is a separate
  drawing and does not change.

## 0.6.1 – 2026-10-21

**Harvest Rev B: the side feeder reshaped, and the exhaust fans inside.** The
feeder is taller and shallower, its lid steeper and flush with the walls, and a
sloped panel closes the shape underneath. The booklet is now
`Maag_Harvest_Assembly_Instructions_RevB.pdf`, 12 steps. Nothing built changes:
neither the feeder nor the panels have been made yet.

### Changed

- **Feeder, taller and shallower**: 132 deep (was 170), 307 from the skirt's foot
  to the hinge (was 250 tall). The lid falls 45° (was 30°) and is 173.6 long; its
  lower edge sits flush with the walls' outer faces, against a small ridge on the
  outer wall, and a 28 × 14 finger scoop in the outer wall at the divider lifts it.
- **A sloped skirt underneath**, for looks: a hollow printed wedge per
  compartment, taped under the floor, its slope running from the outer wall back
  down 65 to the panel.
- **Each compartment prints in three parts** (it no longer fits the bed in one):
  a basin (floor, rail screws), a hood (the arm's opening, the well nuts, the
  hinge) that drops into the basin's 1.5 × 4 lip, and the skirt. Print files:
  `feeder_hood_leaves.stl`, `feeder_hood_veggies.stl`, `feeder_basin.stl`,
  `feeder_skirt.stl`, `feeder_tray.stl` (two of each but the hoods). All
  watertight.
- **Trays 124 tall** (was 66), 108 × 142.4, 1.7 L each, with a grip slot under
  the rim; they lift straight up 169 and out.
- **The lid switch moves to the veggies hood's back plate**, under the hinge,
  out of the trays' lift; its magnet on the lid's underside, 2 apart when shut.
  The panel's cable hole moves with it, to (432, 1192).
- **Exhaust fans inside**, hung under the top panel at y 310 (was outside at
  y 340), a grill under each fan and one on the panel over it. Their lowest
  point is 39.9 over the arm folded at the top of its travel; nothing on the
  gantry passes under them. M4 × 40 from inside, 2.0 past the nylocs. Two more
  grill packs on the buy list. Enclosure booklet step 12 redrawn.
- **Tier A cable gland** on the right panel down from 900 to 780, clear of the
  skirt.
- **The arm is drawn from its own CAD**, undecimated, as in the gantry booklet:
  the harvest booklet's arm pages had used a 1.5 mm vertex-clustered copy.
  `reach.py` now prefers Elephant's .dae meshes when they are on disk.
- **Drop poses re-solved** for the new feeder (`reach.py`: pooled random starts,
  the through leg 30 over the release, the reed switch, its magnet and the M4
  heads as obstacles): every pose clears by 8.1 or more. **Provisional**: solved
  with the Herb Snip's first printed body, without its D405. The housing version
  replaces it in 0.6.2, and `drops.yaml` says so in its header.
- **New checks** in `harvest.py`: the lid and the hinge's leaf against the
  printed parts (0), the lid's flush (0.35), the trays' lift past the switch
  (2.0); in `enclosure.py`, `fan_clearance()`.

## 0.6.0 – 2026-10-21

**Harvest Rev A: where the Herb Snip puts what it cuts**, with its own assembly
booklet in the house style (the Maag cover, how the arm drops, parts, fasteners,
tools, sections to scale, 11 steps). Everything is generated from the new
`greenhouse/harvest/harvest.py`, built on `enclosure.py` and `cabinet.py`: the
booklet, four SendCutSend DXFs, four STLs and the arm's drop poses. See
`greenhouse/harvest/HARVEST.md`.

- **Dead-leaf tray in the base bay**, bigger: a 5052 tray 457 × 480 × 50, about
  10.5 L, that hangs by two outward rims on **two guide rails** bolted to the
  base pan with the pan's own bolts (x 150 and 650, front and back: M8 × 12
  become M8 × 16). Its floor rides 5 over the pan's front lip, so it slides
  straight out of the bottom-left door alone; a tab at the back of each rail is
  the stop.
- **A handle that stands up off the tray**, printed: a 120 × 42 slot the whole
  hand goes through and a rounded bar over it, 12.8 under F1, three M5 × 10 into
  nylocs sunk in its face.
- **Side feeder outside the right panel at tier B** (the third shelf, waist
  height), after the side feeders of a bird cage: two printed compartments,
  leaves in front and veggies behind, each with a lift-out tray, under one clear
  polycarbonate lid falling 30° on a 1 ft piano hinge. Lifted, the lid leans on
  the panel. The arm reaches in through one 80 × 160 opening per compartment; the
  snip's wide servo end stays inside the cabinet. `Feeder(side, tier)`: the
  modular cabinet's left-hand feeder is the same parts mirrored.
- **The lid is in the door chain**: a fifth reed switch in series with the four
  door switches, so lifting it cuts the gantry and the arm.
- **Drop poses solved and checked** (`greenhouse/harvest/reach.py`, written to
  `drops.yaml`): for each compartment a pose inside, one through the opening and
  the release 28 over the tray's rim; five dead-leaf drops along the tray. Every
  pose clears the frame, the panel, the tiers' plants, the gantry and the arm
  itself by 6.6 or more, with the arm's own meshes and the Herb Snip's printed
  body.
- Printed parts are real boolean solids (`greenhouse/harvest/csg.py`, on
  manifold3d), so the STLs are watertight.

### Changed

- **Enclosure, right panel**: the feeder's two openings, four Ø10 well-nut holes
  and a Ø8 cable hole at tier B; the panel's middle screw on tier B's rail line
  gives way to the feeder's four M5 holes, which hold ordinary panel screws until
  the feeder goes on. DXF, A&C drawing, face map and step 8 of the enclosure
  booklet regenerated. The panels are not yet ordered: nothing built changes.
- **ESPHome utility node**: the doors chain on MCP23017 A4 now counts the feeder
  lid too (comment only).

### Supersedes

- The Herb Snip's harvest drawer in the base bay (Herb Snip chat, branch
  `herb-snip-0.5.0`, not in this repo yet): its harvest goes to the feeder, its
  dead leaves to the tray's five drops. That branch also calls itself 0.5.0; it
  lands as the next version after this one.

## 0.5.0 – 2026-10-21

**Enclosure Rev A: the panels and doors, with their own assembly booklet** in
the house style (the Maag cover, parts, fasteners, tools, face maps, a door
section, 18 steps). Everything is generated from the new
`greenhouse/enclosure/enclosure.py`, built on `cabinet.py`: the booklet, 14 DXFs,
the panel drawing for A&C Plastics and a printed duct collar. See
`greenhouse/enclosure/ENCLOSURE.md`.

- **Back, sides and top: 1/8 in frosted polycarbonate** (TUFFAK GP Matte), six
  panels from three 48 × 96 in sheets, surface mounted on the frame's outer
  faces: EPDM foam strip on the land beside each slot, M5 × 16 and a DIN 9021
  washer through 8 mm holes (the expansion allowance) into drop-in T-nuts, no
  more than 300 apart. 112 T-nuts. The back's three panels meet over B1 and B2;
  a 5052 batten clamps each seam.
- **Four clear doors, two stacked pairs**, 4.5 polycarbonate, each on two 1 ft
  stainless piano hinges (frame leaf on a 3.0 spacer into M3 T-nuts, door leaf
  on VHB), held by cup magnets on F0, F1, F3 and F4, sealed by EPDM weatherstrip;
  an astragal on each right door. Each opens 152°. A reed switch per door feeds
  the door chain (BOM G047).
- **Air**: two NF-F12 exhaust fans outside on the top, filtered passive intake
  low on the right; the humidifier duct through a printed collar.
- **The drain riser moves off the FL post** to five P-clips outside the left
  panel, each branch through a grommet (Frame Rev A step 20's riser comes off at
  Enclosure step 9). Each branch is trimmed 8.
- **Anti-tip**: two steel cable kits through B4 into wall studs, replacing BOM
  G015 (the A34's leg cannot reach the wall past the panel and batten).
- Supersedes BOM Rev E G002, G002b, G008 to G012b and G015; BOM Rev F to follow.

### Fasteners and tools drawn as they are made (both booklets)

- **Every screw now has its hex socket, and the fasteners pages show threads.**
  New `greenhouse/booklet/hardware.py`: ISO 7380 button heads, ISO 4762 cap
  screws (knurled), ISO 10642 flat heads, ISO 4026 grubs, nuts with their bores
  and chamfers, DIN 985 nylocs with the nylon ring, hammer-head T-nuts with the
  rounded corners that let them turn into the slot. `cabinet.py`'s fastener
  builders call it, so the frame and enclosure scenes carry sockets too; the
  section drawings show the socket in each head. `kit3d.screw_m5_lp` and `nut_m5`
  draw their socket and bore for the gantry's next build.
- **The tools pages are remodelled** in `greenhouse/booklet/tools_lib.py`,
  part by part: calipers with depth rod and roller, a tape with its cupped,
  graduated blade, a combination square with its scale and vial, a hacksaw with
  a toothed blade and a closed grip, F-clamps with a toothed bar and threaded
  screw, the pry bar and a 2 × 4, the step drill's flute and three-flat shank, a
  skeleton caulking gun with its cartridge, a snap-off knife, flush cutters,
  isopropyl and a cloth, a kettle and a mug.
- Frame Rev A booklet re-rendered with both; its content is unchanged.

## 0.4.1 – 2026-10-21

**Fixed: the tray and base pan DXFs crossed themselves at every corner where two
lips meet**, and SendCutSend's checker rejected them ("unexpected entity types").
`greenhouse/sendcutsend/unfold.py` built each corner relief from two overrun cuts
that crossed at the bend intersection, and at the notches' inside corners it gave
each lip the other lip's mitre edge. Now an outside corner gets a round relief of
radius 2 centred on the bend intersection, an inside corner a 2.5 mitre slot with a
round root, and every outline is one simple closed loop (9 to 16 crossings per
part before, none now). Flat sizes, holes, drains and bend lines are unchanged.
All four sheet DXFs regenerated; SendCutSend accepts them as uploaded, 5052 H32
0.063 in with every bend 90 degrees up.

## 0.4.0 – 2026-10-20

**Frame Rev A: the first assembly booklet for the cabinet itself**, in the house
style of the gantry booklet: cover, parts, fasteners, tools, every joint, and
21 steps from measuring the profile to the water test. Generated from
`greenhouse/frame/cabinet.py`, a model of every member, bracket, sheet, screw
and foot. See `greenhouse/frame/FRAME_ASSEMBLY.md`.

### Frame hardware: a bracket on every joint, no end taps (bracket schedule Rev 6)

Rev 5 put an M8 end tap on all 54 member ends. An end-tap screw head can only
enter the mating slot from that slot's open end, and with the shelf rails tying
both sides together no order of assembly gets every head in. Rev 6 drops the
end taps (BOM G006) and brackets every joint: **44 PETOX gussets** (20 owned,
two more sets to buy) and the **10 TOCLUX hidden connectors**, moved to the
eight floor corners and the two top side rails' back ends, where a gusset has
no room. Every nut is a **drop-in** M8 slot-8 nut (buy 150). Nothing on a top
face, nothing in the gantry corridor: `cabinet.py` checks both.

### Printed TPU feet replace the levelling feet

`greenhouse/frame/tpu_foot.py`: the bedside table's 2020 foot generator with a
4040 preset, 40 × 40 × 20 with a 20 mm barbed pin into the post's centre bore,
SUNLU TPU 95A. The bore is unmeasured, so it prints fit-test coupons for 6.8,
8.4 and 10.5. Replaces BOM G007. The cabinet now stands 20 higher.

### Corrected

- **Base pan DXFs regenerated for the 559 depth.** `basepan_DOWN.dxf` and
  `basepan_UP.dxf` were still the 457-deep pan (holes at y 437) although
  `make_dxf_rev4.py` already said 559. The tray DXFs change only in the drain
  pilot (next item).
- **Drain route**: the base pan's outlet would hang 38 above the floor, below any
  bucket's rim, so "base pan to a floor bucket" could never run. Each tray now
  drains on its own, down a short branch into one riser zip-tied to the FL post,
  and the riser into a 2 gal lidded bucket (a 5 gal one is too tall). No tray
  takes another's runoff. The pan has no drain and is the dry catch tray, with
  the leak sensor. `basepan_DOWN.dxf` drops its drain pilot; the tray drain
  pilot moves from (60, 150) to (66, 95), where the bulkhead nut clears the shelf
  rail. BOM: G090 3 not 4, G090c 2 gal not 5, plus 4 elbows, 2 tees, 5 zip ties.
- **Sheet screws**: M8 × 16 through a single sheet bottoms in a 12.25 deep slot.
  Now M8 × 12 through one sheet, M8 × 16 through two layers.
- **Drain fall built in**: every tray falls 5 mm to its drain at the left end
  (BOM G090's note), and the pan to its leak sensor, by marking the right-hand
  posts 5 higher on levels 0 to 3. The top level stays dead level for the X rail.
- `greenhouse/gantry/frame.py`: the base mid rail moves from mid-span (x 678.5)
  to 660 to 700, under the pan's lap bolt; the three 123 tier mid rails are now
  drawn and counted (cut report 30.07 m, 17 sticks, as the gantry booklet's step
  21 already said). The Gantry Rev E PDF is unchanged until its next rebuild.

### Added

- `greenhouse/frame/Maag_Frame_Assembly_Instructions_RevA.pdf`: the booklet, 26
  pages, and `make_frame_booklet.py`, which draws it.
- `greenhouse/booklet/maagbook.py`: the booklet page kit, lifted from the
  gantry generator with the footer as a parameter, for every booklet after it.
- The frame booklet's cover is the gantry booklet's render
  (`greenhouse/gantry/cover/cover.png`): every Maag booklet carries the same cover.
- `.gitignore`: the frame booklet's build folder and the cover intermediates.

## 0.3.0 – 2026-10-20

**The project is now Maag, the Modular Agentic Autonomous Greenhouse.** It was
Herb Tower up to 0.2.0. Display names only: titles, drawings, BOMs, the Home
Assistant panel title and the MQTT device model. Entity IDs, hostnames, file
paths and the `greenhouse` names in code are unchanged, so nothing that is
already deployed breaks.

**Gantry Rev E. Every Rev D drawing was a mirror image, and the OpenBuilds
parts are now OpenBuilds' own geometry.** Two purchased parts change: the arm
plate (Rev A's slots fit no published pattern) and the X rail's end brackets
(cast corners cannot sit where the top depth rails already are). The cabinet,
the cut list and every pin are unchanged.

### The mirror

`kit3d.iso_matrix` was left-handed, so every Rev D page showed the assembly
reflected: what sat on the left was on the right. Fixed, and every page was
re-rendered and re-checked. Anyone who marked up Rev D should re-read Rev E.

### OpenBuilds hardware from OpenBuilds' drawings

Modelled from bd_warehouse's transcription of OpenBuilds' drawings instead of
photographs:

- **XL plate**: fixed wheels on one edge (5.1 holes, counterbored), eccentrics
  on the other (7.2); tapped M5 grid; nut recess; no centre window.
- **Wheel stack**: plate 6, spacer 6, **1 mm precision shim**, wheel 11, nyloc;
  the plate sits **2.5** off the beam, so each carriage is **8.5** deep, not
  7.115. Eccentrics are **10 mm** hex. Low profile heads are 1.5 mm.
- **Nut block** 34 × 33 × 12 on two 6 mm spacers, M5 × 25 low profile, hex nuts
  in its pockets. **C-Beam End Mount** 80 × 50 × 12 at the mast top.
- `design/params.py`: `CARR_STACK = 8.5`, `TRANSIT_CLEAR = 20.0`. J1 moves to
  385.65 from the front; the folded arm clears the tray line by **20.0**
  (was 22.8); X travel **1086**. `solve.py` still passes the 559 reference
  build, with no depth to spare.

### Purchased parts that change

- **Arm plate Rev B** (`arm_plate_revB.dxf`): tapped M3 × 4 for the G base,
  tapped M4 × 4 on the bare arm's 44 mm square, countersunk M5 × 4 into the XL
  plate's tapped holes. SendCutSend drawing sizes. Rev A should not be cut.
- **Rail brackets**, bent 5052-H32 0.125 in, TOP and BOTTOM at each end of the
  X rail (`rail_bracket_*.dxf`). Replaces four cast corner brackets.
- **Reset button** for the G9SE-201's manual reset (BOM S07). Rev D had none.

### Safety wiring

- **13-14** feeds the controller; **23-24** feeds the Z brake coil, switched on
  its low side by the controller's MOSFET output, so software releases the
  brake only for a Z move and an E-stop or power cut always sets it.
- Manual reset: 24 V on T33, the NO button from T31 to T32.
- X1 is the G9SE-201's PNP status output (100 mA, not a safety output) to the
  utility node's A6, through an opto input.
- **Sheet E-01 corrected**: it drew an aux "41/42" contact the G9SE-201 does
  not have, fed the brake from 13/14, and put a 10 A fuse ahead of 13/14, above
  both the contact's 5 A rating and Omron's 8 A fuse limit. Now 5 A ahead of
  13-14, 1 A ahead of 23-24, X1 to A6.

### Booklet

Rendered cover; parts and fasteners counted off the model; a tools page; two
wiring pages (power and safety; controller, motors, brake, limits); step 11
rebuilt around the real nut block; step 16 exploded; step 23 shows where each
bracket leg lands; step 19 mounts the arm on its G base; step 27 recentred.
Gantry BOM **Rev C**: shims, spacer count, End Mount, brackets, arm plate Rev B,
reset button and a complete, counted fastener list.

Type: titles, step numbers, wiring box headings and tool names are IBM Plex
Mono, everything else Inter. That is the Maag house style for every booklet,
sheet and deck from here on. The fonts are not in the repo: the generator reads
them from `$MAAG_FONTS` or from `greenhouse-esphome/_fonts` beside the repo,
and falls back to DejaVu Sans Mono without them.

## 0.2.0 – 2026-10-20

**The reference build changed depth: 1397 × 457 × 1829 becomes 1397 × 559 × 1829.**
Anyone who has cut extrusion to the 0.1.x cut list needs eleven new depth
members. Nothing else about an existing build is wrong.

This is the first revision drawn from the real robot. Up to 0.1.3 the myCobot
280 Pi was a cylinder with datasheet numbers attached. 0.2.0 loads Elephant
Robotics' own `mycobot_280_pi.urdf` and its eight link meshes and poses them
through the URDF chain, and four of those numbers turned out to be wrong.

### The blocking one

The arm crosses a tray plane every time it changes tier. Folded as tightly as
its joint limits allow it is **162.6 mm** long, and behind it sits 88.35 mm of
carriage stack plus the X rail and the rear upright. In a 457 mm cabinet the
folded arm **overlaps the tray by 77 mm**, so it cannot change tier at all.

At 559 it clears by 22.8 mm. The alternative, if the floor space is not
available, is to cut the trays back from 203 to 127 deep and keep 457, which
costs 37 percent of the growing area. `solve.py` now refuses the impossible
case outright instead of warning about the wrong thing.

### Gantry Rev D: the mechanics redrawn as C-Beam hardware actually works

- **Carriages.** The wheels straddle the 80 mm beam and ride the grooves on
  its top and bottom faces, 100.6 mm apart (Rev C had them on the front
  face, which a V-wheel cannot do). Stack: M5 × 30 low profile, plate,
  6 mm spacer, wheel, **nyloc**. The plate's back sits 1.115 mm off the
  beam, so each carriage adds 7.115 to the stack-up, and the transit
  clearance at 559 is **22.8 mm**, not the 25 first quoted.
- **X drive.** Motor at the X rail's left end on the front lips; GT2 belt
  inside the rail's channel, width along the pulley axis, teeth in; one
  idler at the far end on an M5 × 40 through the web; both belt ends
  clamped to the back of the X carriage. Rev C had the motor mid-rail,
  where the carriage could not pass it.
- **Z drive.** The screw hangs from a top end plate between two thrust
  bearings locked by collars; the coupler at the foot carries only torque.
- **Mast foot 309 → 289.** At 309 the top collar finished 0.5 mm under the
  cabinet's top plane.
- **X travel** is 1126 mm (163.5 to 1290), set by the motor plate and the
  idler. The arm's ±150 lateral reach still covers the whole tray width.
- `greenhouse/gantry/assy.py`: one module for the sub-assemblies, used by
  both the booklet and the cabinet model, so they cannot disagree.
- Gantry BOM Rev B ($2,186.07): C05 wheel screws 27 → 30 mm; C06 M5
  nylocs added; D02 pulley bore 8 → 6.35; D03 idlers 2 → 1; D15 mast-top
  end plate and D16 lock collars added; motor-plate motor holes tapped M5.
- `design/params.py`: `CARR_STACK = 7.115`, `ARM_SETBACK` 170.58,
  `TRANSIT_CLEAR` 22.5.

### Changed

- **Frame depth 457 → 559.** Eleven depth members 377 → 479. Uprights, width
  members, tray width, tier heights and pot count are all unchanged: still
  4 × 1829, 13 × 1317, and still 17 sticks of 2000 mm.
- **Base drip pan 1317 × 377 → 1317 × 479** (G014). It spans the full frame
  depth, so it is the one sheet-metal part the change touches. **The growing
  trays are unchanged** at 1317 × 203 (G013).
- `design/params.py`: arm constants replaced with measured ones.
  `ARM_REACH` 280 → **292.6** (flange, radial from J1), plus `ARM_GRIPPER`
  90. `ARM_STOWED_H = 437` was wrong in kind, not just in value: 437 mm is
  the arm **extended**. It is now `ARM_EXTENDED_H`, joined by `ARM_FOLD_L`
  162.6, `ARM_WORK_H` 263 and `ARM_TIGHT_Q`. New `CORRIDOR_MIN_ARM` (356)
  and `CORRIDOR_MIN_GANTRY` (160.35) replace the single 230.
- `design/solve.py`: the arm is **side mounted**, so J1 is horizontal and the
  base radius no longer eats 80 mm of reach. J1 is now derived as
  `depth − ARM_SETBACK`. The headroom-vs-stowed warning is replaced by a
  transit check that raises `DesignError`, and reach is checked against the
  gripper rather than the bare flange.
- `greenhouse/drawings/brackets.py`, `make_axo5.py`, `make_section.py`,
  `render3d.py`, `make_wiring4.py`, `greenhouse/model/tower3d.py` and
  `make_views.py`: depth propagated, and `tower3d.py`'s hand-typed
  `Y_PLATE = 150` replaced by the design rule, which had the mast sitting
  inside the tray footprint.
- Generators no longer write to hard-coded `/home/claude/...` paths; they
  write next to themselves and take the mesh directory from `$MYCOBOT_MESH`.

### Added

- `greenhouse/gantry/`: the gantry subsystem. `dae.py` (COLLADA reader),
  `arm280.py` (the URDF chain), `collide.py` (link-pair self-collision),
  `parts.py`, `assy.py`, `frame.py` (the cabinet, `clearances()`,
  `cut_report()`), `kit3d.py` (modelling and the renderer) and
  `make_steps3.py`, which generates the 29-page assembly booklet.
- `Gantry_Assembly_Instructions_RevD.pdf`, `GANTRY_ASSEMBLY.md`, and the
  gantry BOM: `build_gantry_bom_revB.py` and its spreadsheet.
- `greenhouse/build_bom_revF.py`: Rev E with the three structural lines
  corrected. It still needs `greenhouse_BOM_revC.xlsx` beside it to run.

### Fixed

- **The fold is collision checked.** The first shortest fold found,
  J2 −135 / J3 −150 / J4 −150, sits inside the joint limits and drives J4
  through the base. `greenhouse/gantry/collide.py` voxel-checks every link
  pair two or more apart in the chain on the real meshes; ranking 83,607
  poses by length and checking in order gives J2 −110 / J3 −80 / J4 −140 /
  J5 −90, confirmed on the full 226,670-face mesh. It is also 162.6 mm,
  because the length is set by the shoulder housing, so the depth decision
  stands.
- **Renderer rewritten.** Fills come from a real per-pixel z-buffer
  (vectorised scanline, smooth crease-aware shading) and every edge is
  hidden-line tested against it. The old depth-sliced
  painter's algorithm drew a slice's edges over every face in that slice,
  so anything within one slice depth (28 mm on a cabinet page) showed
  through. Neither step now depends on face winding, which matters because
  the CAD arm meshes are open shells.
- `extrude()` and `revolve()` emitted caps and walls with separate vertex
  copies, so a gantry plate was twelve disconnected open sheets and some
  rendered hollow. `weld()` joins them into closed solids.
- The arm is drawn from Elephant's full-resolution mesh. The vertex
  clustering used before left the links lumpy.
- The axonometric view matrix had world +Z pointing **down** the page. Every
  generated axonometric was vertically inverted.
- Z motor moves from the top of the mast to the foot: the mast top is at 1809
  and a 76 mm NEMA 23 above it stands 56 mm proud of the cabinet. A NEMA 23
  is also 56.4 mm square and the C-Beam channel is 20 mm deep, so it was
  never going inside the channel either.
- The X rail must be **cut to 1397**. 0.1.x said both C-Beams were used at
  their full 1500.

### Still open

- The mast is a 1500 mm cantilever off four V wheels. Expect 1 to 2 mm of
  forward lean at the bottom, so hand-eye calibration is per tier. If it
  measures worse, a second XL gantry plate ganged onto the X carriage (+$18,
  not in gantry BOM Rev A) doubles the pitch stiffness.
- `make_dxf_rev4.py` carries the new pan width but needs `ezdxf`; regenerate
  the base-pan DXF before ordering G014.
- G016, the LED bar, is still unresolved: both sourced options are dead.

## 0.1.3 – 2026-10-18

No design change. No generated output changes.

### Changed
- README: a rewritten opening. Why the project exists, an invitation to get in
  touch by email, and credit to the AutonCorp Biodome Project for the
  inspiration. The comparison with other smart-garden products is gone.

### Added
- `LICENSE`: the whole repository is MIT licensed. Build it, change it, share
  it; keep the copyright notice.
- `docs/08-arm.md`: Jetson bring-up, from the box to a running core layer.
  JetPack 7.2.1 from a USB stick, the QSPI firmware prompt that must be answered,
  the missing SSH host keys, base settings, the RealSense SDK with its new
  signing key, the Mosquitto logins, and starting the four core services.

### Found while bringing up the core layer
- The core layer runs on the reference build. Supervisor, safety governor, store
  and bridge publish about 220 entities to Home Assistant, pass all six broker
  checks against the Mosquitto app, and are back about 40 seconds after a reboot.
  The 145 unit tests pass on the Jetson.
- Home Assistant now has two authority selectors and two kill switches: the
  package's `input_select.gh_authority` and `input_boolean.gh_kill`, which the
  panel card drives, and the bridge's `select.greenhouse_authority` and
  `switch.greenhouse_kill`, which the supervisor obeys. They are not linked, and
  at the time of writing they disagree: the panel's kill switch is on, the
  supervisor's is off. Harmless while no agent container exists; it must be
  resolved before any agent is started.
- `binary_sensor.greenhouse_robot_busy` did not exist until the bridge ran, so
  "Greenhouse - zone watering" logged a warning on every evaluation. The bridge
  now provides it.

### Open
- `mosquitto-acl.sample` is not applied, so both broker users can write every
  topic.

## 0.1.2 – 2026-10-18

No design change. No generated output changes.

### Added
- `greenhouse/jetson/prototype/d405_leaf.py`: close-range depth quality on a
  real plant. Keeps the frame with the most pixels inside a working band and
  reports fill (valid pixels over the object's filled silhouette), per-pixel
  temporal noise over 15 frames, and range. Saves a depth map scaled to the
  band, a side-by-side with colour, and the raw depth.

### Found
- The D405 works at the arm's distance. On a snake plant under ordinary room
  light: 94 % fill and 0.79 mm temporal noise at 225-333 mm; 97 % fill and
  2.26 mm at 339-525 mm. Noise scales close to distance squared, as stereo
  should. October's Windows result (2 % valid) was the camera aimed at a room
  with nothing inside its range.
- Textureless surfaces such as a plain wall return no depth, because the D405
  has no IR projector. A plain cabinet back will drop out of the depth image,
  which isolates the plants rather than hurting.
## 0.1.1 – 2026-10-18

No design change. No generated output changes.

### Added
- `greenhouse/jetson/prototype/d405_fps.py`: separates the D405's real frame
  rate from Python processing cost. Streams depth and colour at 848x480 @ 30,
  reads the camera's own frame-rate and exposure metadata, then times
  `rs.align` on the same frames.

### Found while bringing up the Jetson
- First run on the Jetson Orin Nano Super (JetPack 7.2.1, Ubuntu 24.04,
  librealsense 2.59.1 from the RealSense apt repository, `pyrealsense2`
  2.59.1 wheel in a venv): the D405 enumerates at USB 3.2 and delivers a true
  30 fps with depth aligned to colour.
- The ~20 fps that `d405_check.py` reports, here and on Windows in October, is
  the script counting its own pipeline start-up, not the camera or the cable.
## 0.1.0 – 2026-10-17

First parametric release. Up to here the repository described exactly one
greenhouse, 1397 × 457 × 1829 mm, and every dimension was a constant somebody
had typed into `brackets.py`.

### Added
- `design/params.py`: one `Envelope` describing the space you have, plus five
  presets spanning 600 mm to 3000 mm of wall.
- `design/solve.py`: derives the whole design from the envelope: bay count and
  intermediate uprights, shelf levels and headroom, the pot grid, probe and ADC
  allocation, LED wattage from a PPFD target, zone flow rates, reservoir size,
  node count and switch selection, and the arm's reach geometry.
- Module system. Core is sensing, lighting and irrigation, and every size has
  it. `gantry`, `arm` and `climate` are optional; the solver enforces that `arm`
  requires `gantry`, and reports what each one costs in depth and headroom.
- Hard limits that the solver refuses to violate rather than silently produce a
  design that cannot be built: shelf span before ponding, the four ADS1115
  addresses, PoE port budget, gantry corridor, pot fit in the tray.

### Found while building it
- **The arm's reach is the binding constraint on depth.** With a 280 mm myCobot
  on a C-Beam carriage, joint 1 ends up 359 mm behind the front face in the
  reference build, and its reach stops 79 mm short of it. The pots have to sit
  against the *back* of the tray. At the reference size the margin is +3 mm. Go
  deeper than about 460 mm and the arm can no longer reach the front of its own
  pot row, which is why `l` at 560 mm deep reports a 17 mm shortfall.
- **Four PoE ports is a design limit, not a detail.** Any build with more than
  three tiers needs a bigger switch than the TL-SG108PE in the BOM.
- **Sixteen probes per tier is the ceiling.** Four ADS1115 on four addresses.
  A 3 m wall fits 22 pots per tier, so that size needs two nodes per tier or
  zone-level moisture for the surplus.

### Unresolved, carried forward
- The LED line. The Kingbrite listing in BOM Rev E (G016) now 404s, and the
  HLG QB120 V2 alternate (G017) is both unavailable as a 4-pack and electrically
  incompatible: its minimum drive current is 1050 mA and the specified drivers
  are 700 mA. See `docs/05-electrical.md`.
- `greenhouse/` still holds the hand-written reference build. The generators in
  it are not yet driven by `design/`. That is the 0.2.0 work.
