v1proxy/RedTower/greenhouse/enclosure/acplastics/Maag_Enclosure_Panels_RevA.pdf

Maag enclosure | · | frosted panels, Rev A

TUFFAK GP Matte polycarbonate, 1/8 in (3.175 mm), frosted. Three 48 × 96 in sheets, six panels. Cut to size and drill.
All dimensions mm. Hole positions from each panel's lower left corner, seen from the side that faces OUT (the DXFs are drawn the same way). Tolerances: outline ± 1, hole positions ± 0.5, holes + 0.3 / − 0. Corners R3. Keep the protective film on until install; please deburr the holes.

# Sheet A · 48 × 96 in back bottom 32¹.8 × ¹397.0

back upper

840.8 × 1397.0

spare 53 across, 1041 along

# Sheet B · 48 × 96 in back middle 654.4 × ¹397.0

top

555.0 × 1397.0

spare 7 across, 1041 along

# Sheet C · 48 × 96 in left 559.0 × ¹829.0

right

559.0 × 1829.0

spare 98 across, 609 along

Maag · Enclosure Rev A · drawn from enclosure.py

Panel | · | left | · | 559.0 × 1829.0 | · | qty 1

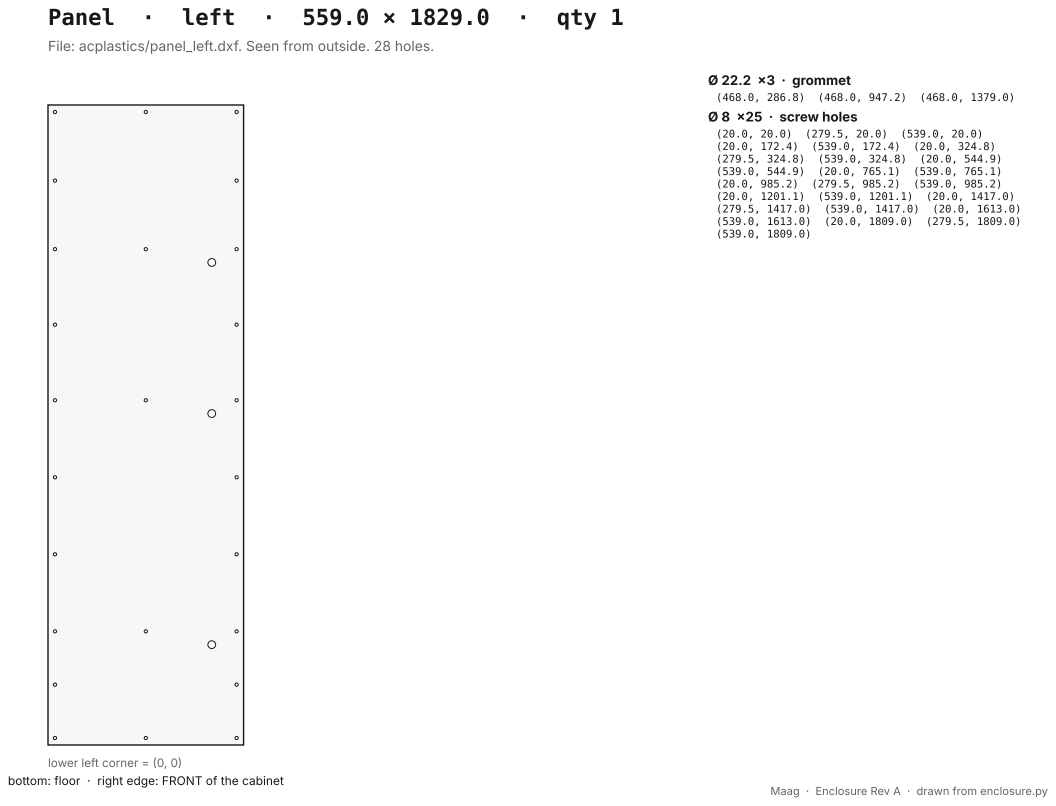
[picture p425: page 2]
Ø 22.2 ×3 · grommet (468.0, 286.8) (468.0, 947.2) (468.0, 1379.0); Ø 8 ×25 · screw holes (20.0, 20.0) (279.5, 20.0) (539.0, 20.0) (20.0, 172.4) (539.0, 172.4) (20.0, 324.8) (279.5, 324.8) (539.0, 324.8) (20.0, 544.9) (539.0, 544.9) (20.0, 765.1) (539.0, 765.1) (20.0, 985.2) (279.5, 985.2) (539.0, 985.2) (20.0, 1201.1) (539.0, 1201.1) (20.0, 1417.0) (279.5, 1417.0) (539.0, 1417.0) (20.0, 1613.0) (539.0, 1613.0) (20.0, 1809.0) (279.5, 1809.0) (539.0, 1809.0)

File: acplastics/panel_left.dxf. Seen from outside. 28 holes.

lower left corner = (0, 0)

bottom: floor · right edge: FRONT of the cabinet

Panel | · | right | · | 559.0 × 1829.0 | · | qty 1

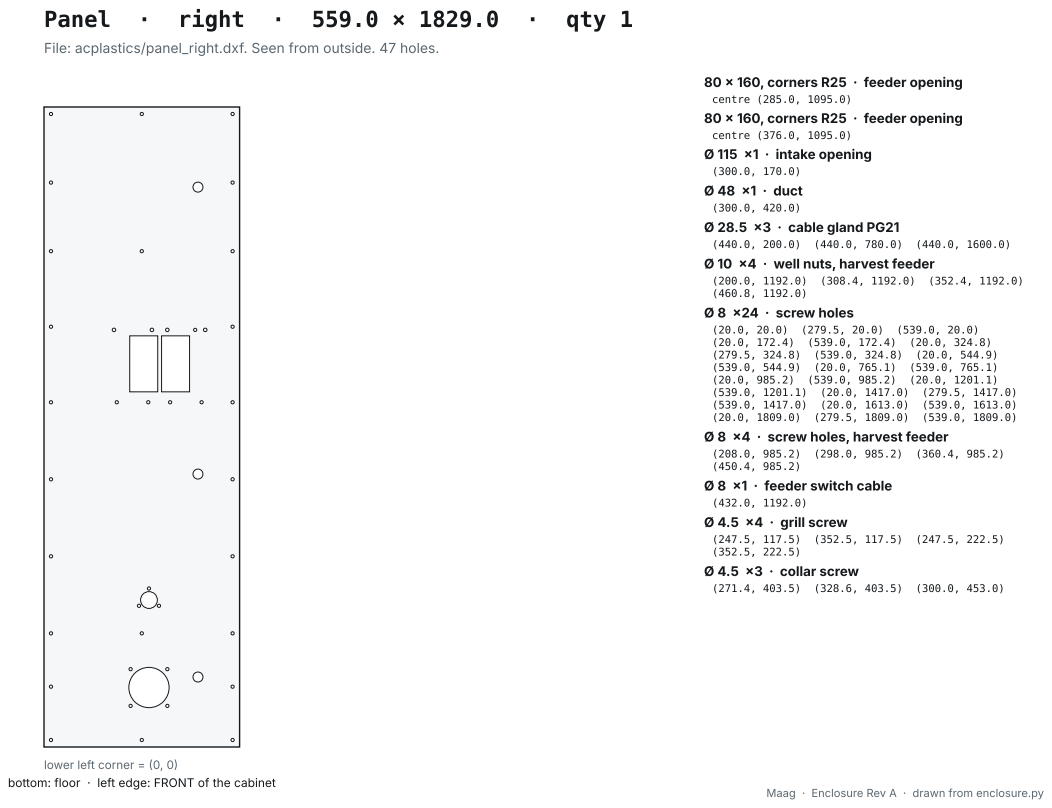
[picture p426: page 3]
80 × 160, corners R25 · feeder opening centre (285.0, 1095.0); 80 × 160, corners R25 · feeder opening centre (376.0, 1095.0); Ø 115 ×1 · intake opening (300.0, 170.0); Ø 48 ×1 · duct (300.0, 420.0); Ø 28.5 ×3 · cable gland PG21 (440.0, 200.0) (440.0, 780.0) (440.0, 1600.0); Ø 10 ×4 · well nuts, harvest feeder (200.0, 1192.0) (308.4, 1192.0) (352.4, 1192.0) (460.8, 1192.0)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

File: acplastics/panel_right.dxf. Seen from outside. 47 holes.

bottom: floor · left edge: FRONT of the cabinet

Panel | · | back bottom | · | 1397.0 × 321.8 | · | qty 1

File: acplastics/panel_back_bottom.dxf. Seen from outside. 8 holes.

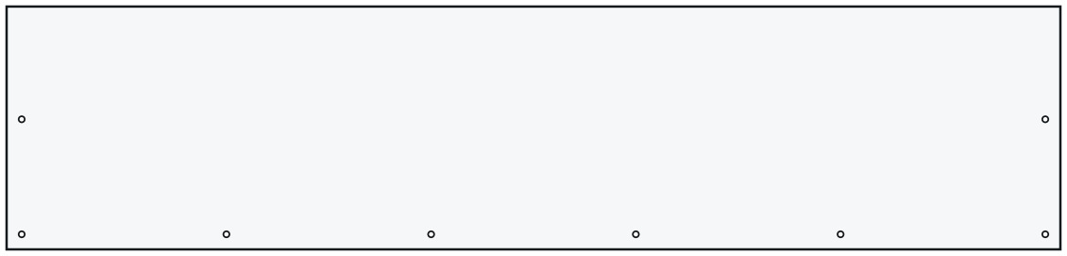
[picture p427: figure]

bottom: floor side · seen from behind the cabinet

Ø 8 ×8 · screw holes
(20.0, 20.0) (291.4, 20.0) (562.8, 20.0) (834.2, 20.0) (1105.6, 20.0) (1377.0, 20.0) (20.0, 172.4) (1377.0, 172.4)

Panel | · | back middle | · | 1397.0 × 654.4 | · | qty 1

File: acplastics/panel_back_middle.dxf. Seen from outside. 4 holes.

| | | | | | Ø 8 ×4 · screw holes (20.0, 217.1) (1377.0, 217.1) (20.0, 437.3) (1377.0, 437.3)

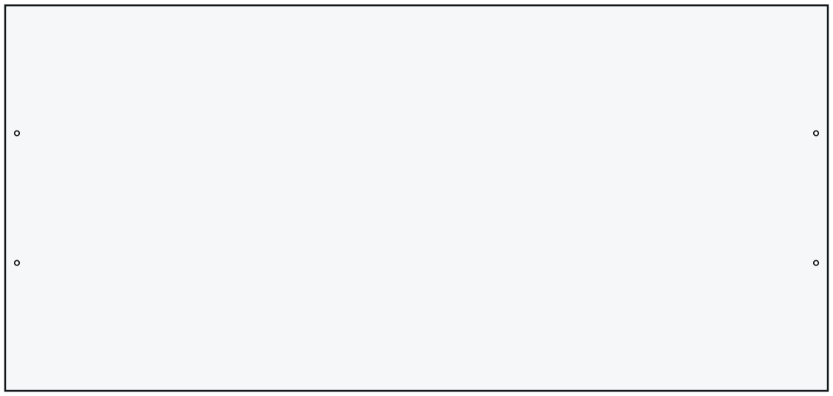
[picture p428: figure]

Panel | · | back upper | · | 1397.0 × 840.8 | · | qty 1

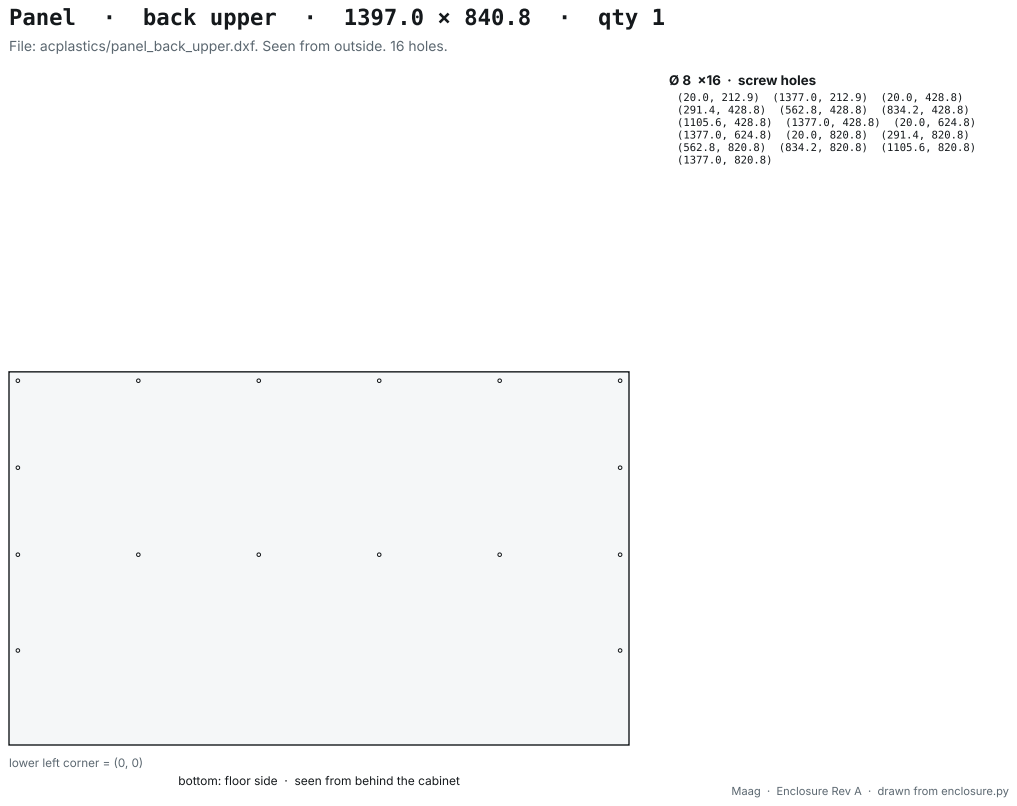
[picture p429: page 6]
Ø 8 ×16 · screw holes (20.0, 212.9) (1377.0, 212.9) (20.0, 428.8) (291.4, 428.8) (562.8, 428.8) (834.2, 428.8) (1105.6, 428.8) (1377.0, 428.8) (20.0, 624.8) (1377.0, 624.8) (20.0, 820.8) (291.4, 820.8) (562.8, 820.8) (834.2, 820.8) (1105.6, 820.8) (1377.0, 820.8)

File: acplastics/panel_back_upper.dxf. Seen from outside. 16 holes.

Panel | · | top | · | 1397.0 × 555.0 | · | qty 1

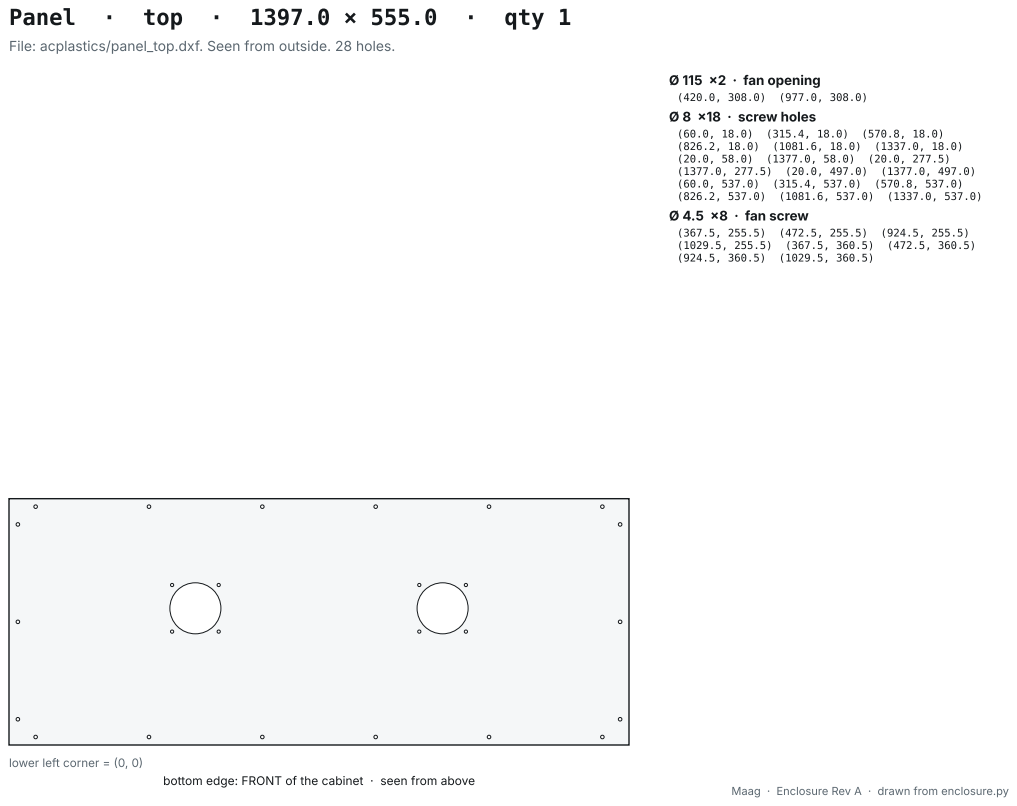
[picture p430: page 7]
Ø 115 ×2 · fan opening (420.0, 308.0) (977.0, 308.0); Ø 8 ×18 · screw holes (60.0, 18.0) (315.4, 18.0) (570.8, 18.0) (826.2, 18.0) (1081.6, 18.0) (1337.0, 18.0) (20.0, 58.0) (1377.0, 58.0) (20.0, 277.5) (1377.0, 277.5) (20.0, 497.0) (1377.0, 497.0) (60.0, 537.0) (315.4, 537.0) (570.8, 537.0) (826.2, 537.0) (1081.6, 537.0) (1337.0, 537.0); Ø 4.5 ×8 · fan screw (367.5, 255.5) (472.5, 255.5) (924.5, 255.5) (1029.5, 255.5) (367.5, 360.5) (472.5, 360.5) (924.5, 360.5) (1029.5, 360.5)

File: acplastics/panel_top.dxf. Seen from outside. 28 holes.

bottom edge: FRONT of the cabinet · seen from above
