v1proxy/RedTower/greenhouse/gantry/parts.py

"""Gantry parts modelled at real dimensions.

Rev E: the OpenBuilds parts now follow bd_warehouse's open_builds.py, which
models them from OpenBuilds' own drawings (github.com/gumyr/bd_warehouse):
  C-Beam 40 x 80 profile with its 14 T-grooves, M5 end taps and cores
  XL C-Beam gantry plate 125 x 125 x 6: wheel mounts 100.6 c/c, EXCENTRICS
    ON ONE SIDE (7.2, counterbored 12.25) and FIXED ON THE OTHER (5.1,
    counterbored 9.135), 35 x 35 centre recess, tapped M5 at (+/-50.3, +/-30)
  Xtreme Solid V wheel 23.9 x 10.2, two 625 bearings, 11 over the bearings
  Eccentric spacer: 10 mm hex, 6 cam, 7.11 boss 2.5 long, 0.79 offset
  Aluminium spacer 10 OD x 6, precision shim 10 x 5 x 1
  Anti-backlash nut block 34 x 33 x 12, two M5 on 20, hex nut pockets
  C-Beam End Mount 80 x 50 x 12 with a 16.1 x 4.5 bearing recess
  Lock collar 8 mm: 14 OD x 7
  M5 low profile screw (OpenBuilds): head 9.0 x 1.5, 3 mm hex
Other numbers:
  NEMA 23: 56.4 flange, 47.14 hole square, 38.1 boss    StepperOnline drawing
  GT2 20T: pitch dia 12.73, 2 mm pitch                  GT2 standard
  Lead screw Tr8x8(p2), 8 mm OD, 8 mm lead              BOM D10

How a C-Beam carriage goes together: the wheels STRADDLE the 80 mm beam and
ride the V-grooves on its two 40 mm faces, 10 mm behind the mouth. Stack,
outside in: low profile screw, plate 6, spacer 6 (or eccentric), shim 1,
wheel 11, nyloc. The plate's back sits 2.5 mm proud of the beam.
"""
import math
import numpy as np
from kit3d import (box, extrude, cylinder, revolve, tube, merge, mv, rot, scale,
                   circle_pts, ring, hexring, disc, Part, SEG,
                   ALU, ALU_D, STEEL, BLACKPART, POM, BRASS, PCB, ARM, HILITE)

# ------------------------------------------------------------------ C-Beam
CB_D, CB_H, CB_T = 40.0, 80.0, 20.0     # depth, height, wall
SLOT_W, SLOT_D = 6.25, 1.455            # V lip opening and the V's depth
GROOVE_BACK = 10.0                      # side-face grooves, behind the mouth

# OpenBuilds T-groove, in groove coords: gx = 10 at the surface, gy across.
_GROOVE = [(10, -4.58), (8.545, -3.125), (8.2, -3.125), (8.2, -5.5),
           (6.5607, -5.5), (3.9, -2.8393), (3.9, -0.21), (3.69, 0.0),
           (3.9, 0.21), (3.9, 2.8393), (6.5607, 5.5), (8.2, 5.5),
           (8.2, 3.125), (8.545, 3.125), (10, 4.58)]
_FLANGE_CORE = [(-2.7, 38.2), (-2.7, 36.2393), (-6.1, 32.8393), (-6.1, 27.1607),
                (-0.73934, 21.8), (2.7, 21.8), (2.7, 23.7607), (6.1, 27.1607),
                (6.1, 32.8393), (2.7, 36.2393), (2.7, 38.2)]
_WEB_CORE = [(-8.2, 2.7), (-8.2, -2.7), (-6.2393, -2.7), (-2.8393, -6.1),
             (2.8393, -6.1), (6.2393, -2.7), (8.2, -2.7), (8.2, 2.7),
             (6.2393, 2.7), (2.8393, 6.1), (-2.8393, 6.1), (-6.2393, 2.7)]


def cbeam_profile():
    """(outer, holes) of the C-Beam section in OpenBuilds' frame: X -20..20
    with the channel mouth at X = +20, Y -40..40."""
    corners = [(-20, -40), (20, -40), (20, -20), (0, -20), (0, 20), (20, 20),
               (20, 40), (-20, 40)]
    grooves = {0: [-10, 10], 1: [-30], 2: [10], 3: [-10, 10], 4: [10], 5: [30],
               6: [10, -10], 7: [30, 10, -10, -30]}
    fillet = {0, 1, 2, 5, 6, 7}           # every corner except the two at X = 0
    r = 1.5
    pts = []
    n = len(corners)
    for k in range(n):
        c0 = np.array(corners[k], float)
        c1 = np.array(corners[(k + 1) % n], float)
        t = (c1 - c0) / np.linalg.norm(c1 - c0)
        nin = np.array([-t[1], t[0]])
        # leaving corner k
        if k in fillet:
            tp = np.array(corners[k], float) - np.array(corners[k - 1], float)
            tp /= np.linalg.norm(tp)
            cen = c0 - tp * r + t * r
            a0 = math.atan2(*(c0 - tp * r - cen)[::-1])
            a1 = math.atan2(*(c0 + t * r - cen)[::-1])
            if a1 < a0:
                a1 += 2 * math.pi
            for a in np.linspace(a0, a1, 7):
                pts.append(tuple(cen + r * np.array([math.cos(a), math.sin(a)])))
        else:
            pts.append(tuple(c0))
        for gpos in grooves[k]:
            # groove centre on this edge, at coordinate gpos along it
            s0 = c0 + t * (np.dot(t, np.array([gpos, gpos]) * np.abs(t)) - np.dot(t, c0 * np.abs(t)))
            s0 = c0 + t * abs(np.dot(np.abs(t), np.array([gpos, gpos]) - c0))
            for gx, gy in _GROOVE:
                pts.append(tuple(s0 + nin * (10.0 - gx) + t * gy))
    holes = [circle_pts(2.3, SEG, x, y) for x, y in
             ((10, 30), (-10, 30), (-10, 10), (-10, -10), (-10, -30), (10, -30))]
    A = np.array(_FLANGE_CORE)
    B = A * np.array([1, -1])
    C = np.c_[20 - A[:, 1], 20 - A[:, 0]]
    D = np.c_[20 + B[:, 1], B[:, 0] - 20]
    W = np.array(_WEB_CORE) + np.array([-10.0, 0.0])
    holes += [A, B[::-1], C[::-1], D, W]
    return np.array(pts), holes


def cbeam(length):
    """C-Beam swept along +Z. Section in XY: x 0..40 deep (mouth at x = 40),
    y 0..80 tall: OpenBuilds' profile shifted by (+20, +40)."""
    outer, holes = cbeam_profile()
    sh = np.array([20.0, 40.0])
    return extrude(outer + sh, length, z0=0.0, holes=[h + sh for h in holes])


# ------------------------------------------------------------- gantry plate
PLATE, PLATE_T = 125.0, 6.0
WH_X = WH_Y = 100.6               # wheel centres, both ways, across the beam
HOLE_FIXED, HOLE_ECC = 5.1, 7.2
SPACER_T = 6.0
SHIM_T = 1.0
WHEEL_W = 11.0                    # over the two bearings' faces
TIRE_W = 10.2
WHEEL_R = 11.95                   # radius at the V ridge
# plate back to the beam's mouth: the wheel's mid-plane sits on the groove
# 10 mm behind the mouth; spacer + shim + half a wheel is 12.5 from the plate
PLATE_GAP = SPACER_T + SHIM_T + WHEEL_W / 2 - GROOVE_BACK  # 2.5
CARR_STACK = PLATE_GAP + PLATE_T                          # 8.5
TAPPED_90 = [(sx * 50.3, sy * 30.0) for sx in (-1, 1) for sy in (-1, 1)]
NUT_HOLES = [(sx * 10.0, sy * 10.0) for sx in (-1, 1) for sy in (-1, 1)]
PLAIN_HOLES = ([(x, y) for x in (-30, 0, 30) for y in (-30, 0, 30)]
               + [(sx * 10.0, sy * 40.3) for sx in (-1, 1) for sy in (-1, 1)]
               + [(sx * 32.5, sy * 40.3) for sx in (-1, 1) for sy in (-1, 1)]
               + [(sx * 30.0, sy * 10.0) for sx in (-1, 1) for sy in (-1, 1)]
               + [(sx * 30.0, sy * 50.3) for sx in (-1, 1) for sy in (-1, 1)])
ECC_MOUNTS = [(x, -50.3) for x in (-50.3, 0.0, 50.3)]     # 7.2, one side
FIXED_MOUNTS = [(x, 50.3) for x in (-50.3, 0.0, 50.3)]    # 5.1, the other


def _rrect(w, h, r, n=8, cx=0.0, cy=0.0):
    pts = []
    for (qx, qy, a0) in ((w/2 - r, -h/2 + r, -90), (w/2 - r, h/2 - r, 0),
                         (-w/2 + r, h/2 - r, 90), (-w/2 + r, -h/2 + r, 180)):
        for a in np.radians(np.linspace(a0, a0 + 90, n)):
            pts.append((cx + qx + r * math.cos(a), cy + qy + r * math.sin(a)))
    return np.array(pts)


def _slot(L, W, cx, cy, n=16):
    """Stadium slot, overall length L along x, width W."""
    r = W / 2
    pts = [(cx + (L/2 - r) + r * math.cos(a), cy + r * math.sin(a))
           for a in np.linspace(-math.pi/2, math.pi/2, n)]
    pts += [(cx - (L/2 - r) + r * math.cos(a), cy + r * math.sin(a))
            for a in np.linspace(math.pi/2, 3*math.pi/2, n)]
    return np.array(pts)
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
