v1proxy/RedTower/(commit log)

2026-10-14 Herb Tower: frame, sheet metal, node firmware and the tending agents
    The indoor greenhouse for RedTower, as built so far.
    Frame and sheet metal
    - Generic sheet-metal unfolder with bend deduction derived from SendCutSend's own
    published minimums, bend relief arcs, and mitred relief at re-entrant corners.
    - Trays and base pan split into two pieces with a 40 mm shingle lap, because the
    cabinet is 1397 mm wide and the largest bendable blank is 44 in.
    - 64 mounting slots, 9 x 18, on the top-face slot centreline of the four profiles
    each sheet lands on. Slotted rather than round because 80/20 cut-to-length holds
    +/-0.5 mm and that accumulates over 1397 mm.
    - Drawings regenerate from the m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
    [arm_plate.dxf, basepan_DOWN.dxf, basepan_UP.dxf, tray_DOWN.dxf, tray_UP.dxf]
2026-10-14 Add the Greenhouse panel card and the authority entities
    Implements the approved interface baseline (Baseline 1, mockup v7) as one
    self-contained custom Home Assistant card shown in panel mode as the
    Greenhouse view of the Red Tower dashboard: seven sections, the mockup
    palette rather than the HA theme, and dimmed "not online" states for the
    hardware that is not built yet, so the page doubles as the build checklist.
    The package gains input_select.gh_authority (the five authority levels)
    and input_boolean.gh_kill (the agent kill switch), which the ceiling
    selector and the header button drive.
    Claude-Session: https://claude.ai/code/sessio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
2026-10-18 Add the 3D model, the real arm geometry and the wiring schematic
    Brings the clone up to date with everything built since the panel card:
    the COLLADA reader and the myCobot general arrangement drawn from the
    manufacturer's own mesh, the greenhouse rebuilt as real 3D geometry driven
    by the member table, and a four-sheet wiring schematic generated from the
    BOM and the ESPHome pin maps.
    Claude-Session: https://claude.ai/code/session_011dS2vTqisRXCLJ7HfZiwdh
2026-10-18 0.1.0: make the design parametric, and version it
    design/params.py holds one Envelope describing the space you have;
    design/solve.py derives the whole design from it and refuses rather than
    quietly producing something unbuildable. Core capabilities (sensing,
    lighting, irrigation) are in every size; gantry, arm and climate are
    optional modules. Five presets span a 600 mm closet to a 3 m room wall,
    and the m preset reproduces the Red Tower build.
    README is now the guide entry point and CHANGELOG records the design
    version, including three constraints the solver surfaced and the
    unresolved LED part number.
    Claude-Session: https://claude.ai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
2026-10-18 Merge the software stack into main: one repository, both halves
    main carried the hardware design, firmware and drawings; the
    claude/zealous-curie-ac729r branch carried the containerized agent stack
    with its tests, CI and commissioning tooling. The two shared no merge base,
    which is why GitHub refused to compare them.
    Brought together with --allow-unrelated-histories. Only .gitignore and
    greenhouse/README.md collided. The thirteen loose scripts main carried in
    greenhouse/jetson/ move to greenhouse/jetson/prototype/ as the earlier
    generation of what the stack now does properly, with a warning not to run
    them alongside it. Nothing in the stack was renamed, so its compose paths,
    CI workflow and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
    [robot.yaml]
2026-10-18 0.1.1: D405 frame-rate test, first run on the Jetson
    Adds jetson/prototype/d405_fps.py, which reads the camera's own frame-rate and exposure metadata and times rs.align separately. On the Jetson (JetPack 7.2.1, librealsense 2.59.1) the D405 runs at a true 30 fps over USB 3.2; the ~20 fps d405_check.py reports is the script counting its own start-up.
    Claude-Session: https://claude.ai/code/session_01DKRAW1Ci7cnQZ4JTycPvVs
2026-10-18 0.1.2: D405 close-range depth on a real plant
    Adds jetson/prototype/d405_leaf.py. On the Jetson, a snake plant at 225-333 mm gives 94 % depth fill and 0.79 mm temporal noise; at 339-525 mm, 97 % and 2.26 mm. Settles the close-range question for the arm camera.
    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
    [d405_leaf.py]
2026-10-18 0.1.3: MIT license, README story, Jetson bring-up guide
    What's changed:
    - LICENSE: the whole repository is now MIT licensed.
    - README: rewritten opening. Why the project exists, contact by email, credit to the AutonCorp Biodome Project. No comparison with commercial products.
    - docs/08-arm.md: Jetson bring-up from the box to a running core layer (JetPack 7.2.1 ISO, QSPI prompt, SSH host keys, RealSense key, Mosquitto logins, core services).
    - CHANGELOG: core layer running on the reference build; two unlinked kill switches in Home Assistant recorded as open.
    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
2026-10-20 0.2.0: the real 280 mesh, and the cabinet depth it forced
    Up to 0.1.3 the myCobot 280 Pi was a cylinder with datasheet numbers
    attached. This revision loads Elephant Robotics' own mycobot_280_pi.urdf
    and its eight link meshes and poses them through the URDF chain. Four of
    those numbers were wrong, and one of them blocks the build.
    The arm crosses a tray plane every time it changes tier. Folded as
    tightly as it can go without one link hitting another, it is 162.6 mm
    long, not the 437 mm the BOM called "stowed" (437 is the arm EXTENDED).
    Behind it sits 60.6 mm of plate and carriage stack, the 40 mm X rail and
    the rear upright. In a 457 mm cabinet the folded arm overlaps the tray
    by 79 mm and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
    [HerbTower_Gantry_BOM_RevB.xlsx]
2026-10-21 0.3.0: Maag, and Gantry Rev E with the mirror fixed
    - The project is now Maag, the Modular Agentic Autonomous Greenhouse
    (Herb Tower up to 0.2.0). Display names only: titles, drawings,
    BOMs, the HA panel title and the MQTT device model. Entity IDs,
    hostnames and paths are unchanged. Drawings regenerated; hard-coded
    container paths in make_dxf*.py and make_slotplan.py fixed.
    - kit3d.iso_matrix was left-handed: every Rev D page was a mirror image.
    Fixed; every page re-rendered and re-checked.
    - XL plate, wheel stack (1 mm shim, plate 2.5 off the beam, 8.5 per
    carriage), 10 mm eccentrics, nut block, C-Beam End Mount and 1.5 mm
    low profile heads modelled from bd_warehouse's OpenBui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
    [HerbTower_Gantry_BOM_RevB.xlsx, Maag_Gantry_BOM_RevC.xlsx, arm_plate.dxf, arm_plate_revB.dxf, rail_bracket_bottom.dxf, rail_bracket_bottom_bends.dxf, rail_bracket_top.dxf, rail_bracket_top_bends.dxf]
2026-10-21 0.4.0: Frame Rev A, the cabinet's own assembly booklet
    - Frame Rev A (26 pages) in the Maag house style: the gantry cover,
    parts, fasteners, tools, every joint, 21 steps from measuring the
    profile to the water test. Drawn from greenhouse/frame/cabinet.py, a
    model of every member, bracket, sheet, screw, foot and drain tube that
    checks the gantry corridor, the sheet fasteners and the drain route.
    - Bracket schedule Rev 6: no end taps. A head cannot enter a slot except
    from its open end, so no assembly order worked. 44 PETOX gussets on
    drop-in M8 nuts plus 10 TOCLUX hidden connectors at the floor corners
    and the top side rails' back ends. Buy two more PETOX sets and 150
    drop-in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
    [basepan_DOWN.dxf, basepan_UP.dxf, tray_DOWN.dxf]
2026-10-21 0.4.1: sheet DXFs that SendCutSend accepts
    - unfold.py: outside-corner reliefs are a round relief of radius 2 on
    the bend intersection instead of two overrun cuts that crossed there;
    inside-corner mitres give each lip its own side of the bisector (the
    sides were swapped) and end in a round root. Every outline is now one
    simple closed loop.
    - tray_DOWN, tray_UP, basepan_DOWN, basepan_UP regenerated. Flat sizes,
    holes, drains and bend lines unchanged.
    Claude-Session: https://claude.ai/code/session_01M6DQ1Aabx5v7ZkhBgjUaoW
    [basepan_DOWN.dxf, basepan_UP.dxf, tray_DOWN.dxf, tray_UP.dxf]
2026-10-21 0.5.0: Enclosure Rev A; fasteners and tools drawn as they are made
    Frosted polycarbonate back, sides and top, surface mounted on EPDM strip with
    M5 into drop-in T-nuts; four clear doors on piano hinges, cup magnets and
    weatherstrip; fans, intake, duct collar, glands; the drain riser outside the
    left panel on P-clips. Booklet, 14 DXFs, the A&C drawing and the collar STL,
    all from greenhouse/enclosure/enclosure.py.
    Every screw now has its hex socket and the fasteners pages show threads
    (booklet/hardware.py); the tools pages are remodelled part by part
    (booklet/tools_lib.py). Frame Rev A re-rendered with both.
    Claude-Session: https://cla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
    [astragal_bottom.dxf, astragal_top.dxf, door_bottom_L.dxf, door_bottom_R.dxf, door_top_L.dxf, door_top_R.dxf, duct_collar.stl, hinge_spacer.dxf]
2026-10-21 0.6.0: Harvest Rev A, the dead-leaf tray and the side feeder
    - Dead-leaf tray in the base bay, about 10.5 L: bent 5052, hung by two
    outward rims on two guide rails bolted to the base pan with the pan's
    own bolts (M8 x 12 become M8 x 16). It slides out of the bottom-left
    door alone, its floor 5 over the pan's lip, a stop tab at the back.
    - A printed handle stands up off its front wall: a 120 x 42 slot the
    whole hand goes through, a rounded bar over it.
    - Side feeder outside the right panel at tier B: two printed modules,
    leaves and veggies, each with a lift-out tray, under one clear lid on a
    piano hinge; Feeder(side, tier) mirrors it for the left. The lid's reed
    switch joins the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
    [deadleaf_handle.stl, deadleaf_tray.dxf, feeder_lid.dxf, feeder_module_leaves.stl, feeder_module_veggies.stl, feeder_tray.stl, guide_rail_L.dxf, guide_rail_R.dxf]
2026-10-21 0.6.1: Harvest Rev B, the feeder reshaped; fans inside the top
    The side feeder is taller and shallower (132 deep, 307 from the skirt's
    foot to the hinge), under a 45 degree lid whose lower edge sits flush with
    the walls, with a finger scoop to lift it and a sloped skirt underneath.
    Each compartment prints in three parts: basin, hood, skirt. Trays 124
    tall; the lid switch moves to the veggies hood's back plate, out of the
    trays' lift.
    The exhaust fans hang inside under the top panel at y 310, a grill on
    each side: 39.9 over the arm folded at the top of its travel, nothing on
    the gantry under them. The tier A gland moves down to 780.
    The harvest booklet draws the arm from its own CAD, undeci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
    [feeder_basin.stl, feeder_hood_leaves.stl, feeder_hood_veggies.stl, feeder_lid.dxf, feeder_module_leaves.stl, feeder_module_veggies.stl, feeder_skirt.stl, feeder_tray.stl]
2026-10-21 0.6.2: the arm plate drawn as one solid
    The arm plate's countersinks were four stacked layers; the faces between
    them showed through the line drawings as dark streaks beside the arm.
    It is now one closed solid with true 90 degree countersinks (manifold3d,
    with the layers as a fallback). The harvest booklet's drop page is
    redrawn. Nothing to build differently.
    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
2026-10-21 0.6.3: the feeder without its skirt; tubes no longer twist
    The feeder's sloped skirt is removed: each compartment is a basin and a
    hood again, seven prints in all, 11 steps in the harvest booklet.
    kit3d.tube now carries its ring frames along the path by parallel
    transport. The old per-point frame flipped where the tangent crossed the
    reference axis and wrung the humidifier duct into a ribbon at its bend.
    The duct itself follows one smooth curve off the collar. Both booklets
    rebuilt.
    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
    [feeder_skirt.stl]
2026-10-21 0.7.0: the Herb Snip, the arm's tool
    One printed end effector that cuts a stem and holds what it cut in the same
    closing (MG90S, four-bar linkage, OLFA blade, printed TPU pads, D405 on the
    tool), on four LEGO pins. It replaces the adaptive gripper (gantry BOM R02 and
    master BOM G083 at 0). Booklet Rev A, print files, BOM Rev A, the driver,
    routing, Home Assistant entities, commissioning and tests.
    The body is one housing, a round collar with a band, a waist into a rounded
    housing round the servo, the regulator and the linkage, and a deck the jaws
    stand on. The collar splits at its band into the body and a camera ring that
    carries the D405: both print on a flat face without supports. Every f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
    [Maag_Gantry_BOM_RevC.xlsx, Maag_Gantry_BOM_RevD.xlsx, Maag_Herb_Snip_BOM_RevA.xlsx, robot.yaml, snip_anvil.stl, snip_body.stl, snip_camera_ring.stl, snip_crank.stl]
2026-10-24 0.7.1: the booklets, readable on GitHub
    Every page of the five assembly booklets rendered from their PDFs into
    docs/booklets/ (121 pages, full size and thumbnails), a page-by-page view per
    booklet, a gallery of every page, the cover and four pages per booklet on the
    README, and the same four pages at the top of each module's guide. All
    generated by greenhouse/booklet/make_gallery.py. Documentation only.
    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
2026-10-24 0.8.0: the interface and the controls
    docs/07-home-assistant.md written from the code: the control system (one
    path to every actuator through the safety governor, its seven checks in
    order, the three verdicts, the authority ceiling level by level, the kill
    switch, supervisor, bridge, mirror, watchdog and watering fallback), the
    Greenhouse panel section by section, what every control sends, every entity
    it reads, three ways to install it, how to check it and what is not verified.
    docs/interface/: the control system diagram and screenshots of the real card
    on its simulated data at 1320, 1280, 600 and 390 px, from
    greenhouse/ha/make_control_diagram.py and make_shots.py.
    Download and integrati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
2026-10-24 0.8.0: the chapter checked against the code
    Line-by-line review of docs/07-home-assistant.md against the governor,
    supervisor, card and packages. The governor's checks are listed in the order
    the code runs them (nine, with the defined-action and tend-grant checks); jog
    is documented as not carried out by the gantry driver yet; Photo now works at
    Auto and above; the kill switch does not block a proposal you approve; the
    approval queue is held in memory; the watchdog's real timings. Found and
    documented: after a Home Assistant restart the fallback watering rule can run
    alongside the Jetson's irrigation. The access list sample needs an entry for
    Home Assistant's own login: mosquitto-setup.md no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
2026-10-26 0.9.0: the house in 3D
    Red Tower on the dashboard as an axonometric 3D floor plan: the Blender
    pipeline from the Revit export to the GLB, the furniture from photos, the
    exterior trims selected by geometry, the Polestar in the garage with its
    charge level, and the two patches the floor3dpro card needs. The house
    model itself stays out of the repository.
    Claude-Session: https://claude.ai/code/session_01CyRvexRLzcNuatLivkDVkK
2026-10-26 house/floorplan: floor filter for the tiles, animated weather
    fx_patch.js, the third card patch: tiles tagged with variables.rt_floor hide
    while their floor is hidden in the 3D view, and the weather entity is
    animated over the model. Waiting for the OK to release as 0.10.0.
    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
2026-10-26 house/floorplan: a realistic sun glare, red floor buttons
    The sun is now a lens glare placed from sun.sun's azimuth and elevation
    relative to the camera, dimmed by passing clouds; the floor buttons take
    the dashboard's red. Waiting for the OK to release as 0.10.0.
    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
2026-10-26 house/floorplan: sunlight from outside the frame, coloured by the hour
    The sun never appears; its light comes in from the side it is on, bluish
    at dawn, yellow at midday, red at sunset. The lens flare is gone. Waiting
    for the OK to release as 0.10.0.
    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
2026-10-26 house/floorplan: sun around the frame edge, lit windows when home, sky behind the house
    The sun follows the model image: it moves around the edge of the frame
    through the day, only its glare comes in, with no horizontal streak and
    only a slight colour shift. After sunset, while someone is home, the
    windows glow warm. Stars, clouds and lightning bolts now sit on a canvas
    behind the house.
    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
2026-10-26 house/floorplan: the sun as light only, no rays
    The diffraction spikes, the faint ring and the ghosts are gone. The sun
    sits a little further outside the frame and only its glow comes in.
    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
2026-10-26 0.10.0: the house in its weather
    The 3D floor plan lives in the real sky: animated weather, the sun's
    light coming in from where the sun is, stars and clouds behind the house,
    windows lit after dark while someone is home, and a floor filter for the
    dashboard tiles. Changelog, versions, guide and a new figure.
    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
2026-10-26 house/floorplan: floor buttons as dashboard tiles on a transparent strip
    The floor buttons take the dashboard's own tile style: square dark tiles
    with a thin border, an icon over an uppercase caption, red while the
    floor is shown and grey while it is hidden, icons only on a small card.
    The black strip behind them is gone, so the weather shows between them.
    New options level_names, level_icons, level_all_name, level_all_icon.
    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
2026-10-26 0.10.1: the floor buttons in the dashboard's own style
    The floor buttons become tiles like the rest of the dashboard, on a
    transparent strip so the weather carries on between them. Changelog,
    versions, guide and a new figure.
    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
