v1proxy/RedTower/(notices)

Notices in the files:
README.md:
License: MIT
